huankechong/smart-greenhouse/README.md

# 智能花房养护站 · Smart GreenHouse（BiUH IPW Final Project）

ESP32 + 土壤湿度/光敏/DHT11 传感 → 自动浇水（继电器 + 底吸泵）→ 双色 LED 状态灯 → OLED 显示 → 巴法云 MQTT 上云 + 微信小程序远程浇水。

**这个仓库里有两样东西**：一套能烧的 Arduino 固件，和一套**能直接上机打印的 10 个结构件**（外加整机示意模型）。

---

## 一、现在到哪一步（2026-11-13 晚更新）

| 线 | 状态 |
|---|---|
| 电路 / 固件 | ✅ 主程序 **v1.6**（…→v1.5 全量审计→**v1.6 防除零+硬停机**）+ 7 个编译开关，双形态编译验证（默认 **271.7KB/21%** · 全开 **1055KB/82%**，2026-11-09 复测；余量 ≈230KB）；**2026-10-24 实机烧录验证通过**（COM6：烧录通路 + 启动日志 + 标定非法硬停机）；`RelayPumpTest` 联调固件 10/25 烧入并实机验证；**2026-11-08 五路传感器实机点亮**（光敏 raw 1421↔遮光骤降 / DHT11 29.2℃·68% / OLED 0x3C 显示「土壤:100%」/ 土壤 湿1050↔干2372） |
| **结构 / 3D** | ✅ **11 件 STL 定稿（+12 LED 座；13 盖板已删）**（10-23/24 四轮实测回填 + **11-10/11 三轮迭代**：AR35 01b 裸露版 / AR34 03 加强针 / 底盘沉槽修正），逐件 watertight/单体/落地 z=0；配合校验 `check_clearance.py` 全过（0.10/边 统一间隙） |
| 3D 展示 | ✅ 整机示意模型（glb）+ **单文件离线 HTML**（双击即开，拖拽旋转）+ 四视图 + 结构标注图 |
| 硬件 | ✅ 自购件全部到货并实拍核对（AR14）；**实验室器材 2026-11-06 全部借到**（5 个套件元件 + 面包板/杜邦线/万用表）；**11-08 传感器 5/5 点亮、土壤排针焊接一次过** |
| 打印 | ✅ **十件 STL 已定稿**（实测切片 8h37m / 338.1g）；**切片由领导在 Bambu Studio 自己做**（0.2 层高 / 3 墙 / 20% / 免支撑，brim 见 `_打印参考/上机操作卡.md`；**gcode/3mf 已于 11-08 全删，现场用 STL 重切**）；**打印清单 11 件**（原 10 + 12 LED 座，13 已删）；**11/11 全部完成**（06a 11-13 打完 AR36 直口版；06b 排水槽版 11-13 晚重打完成） |
| **开工** | ✅ **D0 = 2026-11-07（周六）4 人小组开工**，分工见 `docs/花房4人分工方案_2026-10-20.md`（v2 相对排期） |
| **实验 / 标定** | **全部定稿（11-12）**：8.1 ✅ / 8.2 ✅（32.1ml/s → WATER_MS=2000）/ 浮球常开型实测定稿 / **土壤标定 2372/1050**（11-08 实测，网上典型值 10bit×4 换算交叉吻合）→ **`EN_WATER=1` 且实机闭环已跑通（2026-11-13）**：pigtail 到货接通（首次出水 43s 视频在库）+ **全自动浇水闭环演示 86.7s 视频在库（S1-9.3）**；**48h 连续运行（整机形态）暂定 11-16（周一）启动**（11-18 结束；前置 06a/拼装/接线 11-15 前完成）｜06b 排水槽版重打中 |
| **截止 / 答辩** | 🔴 **提交截止 = 2026-11-24（周二）**（老师课件 2026-11-07 公布，课件存 `outputs/素材/素材备份_老师课件/`）。三大组成部分：**实验室动手实践 + 期末报告 + 期末展示**；展示两阶段（初评 → 晋级进阶展示，DT 系老师共评），**英语展示 = 加分项**。距截止 **11 天** |

> 结构件尺寸已按到货实物**全部实测回填**（1L 桶三径/桶高、硅胶管内外径、花盆、传感器板，2026-10-23~24 完成并全链验证）；仅**翻边高度**暂用 6mm 占位（不影响打印，见交接文档 v3.1 待补项）。

## 二、目录导航

```
<项目根>/
├── README.md            # 本文件：人类入口
├── AGENTS.md            # AI 行为准则（协作规矩 / 重建命令 / 红线）
├── docs/                # 文档层：每个主题一份权威文档
│   ├── index.md                            # ★ 文档总索引
│   ├── 花房项目_AI工作交接文档_2026-10-18.md  # 接手第一份
│   ├── 花房FinalProject方案书.md
│   ├── 花房4人分工方案_2026-10-20.md          # v2：角色卡 + S1–S4 相对排期 + 附录·任务底稿
│   ├── 操作手册/   硬件操作手册_点火接线标定.md · 花房接线规划表.md · 花房接线图_水泵.html
│   ├── 参考资料/   花房3D建模入门路线_SolidWorks.md · 花房借用与自购清单.md
│   ├── 工作日志/   上云联调记录.md（R2）· 打印日志.md（R3）
│   ├── private/                             # 内部邮件（含个人信息，.gitignore 排除，不入仓库）
│   ├── archive/                             # 已完成使命的历史文档（仅备查）
│   └── 审计报告/（AR10–AR26 + archive/AR01–AR09）
└── outputs/             # 交付物 + 生成脚本（不是文档）
    ├── 3D打印件/
    │   ├── 花房3D_P0/          # 01b 土插支架 / 03 窄版管夹（02 水泵座已作废删除）
    │   ├── 花房3D_P1P2/        # 04 OLED 支架 / 07 DHT11 座 / 08 扎线座 / 11 光敏小柱
    │   ├── 花房3D_整机底盘/    # 06a 左片 / 06b 右片 / 06c 连接块 ×2
    │   ├── 花房3D_水箱盖/      # 10 水箱替换盖（1L 桶 + P52 浮球安装）
    │   ├── 花房3D_整机装配/    # 整机示意 glb + 离线 HTML + 四视图 + 校验脚本
    │   └── _打印参考/          # 切片实测报告 + 上机操作卡（**gcode/3mf 已删，现场用 STL 重切**）
    ├── 代码/
    │   ├── 花房代码/GreenHouse_v1/   # Arduino 主固件（.ino + config.h 占位符 + 编译说明）
    │   └── 花房代码/RelayPumpTest/   # 继电器/水泵 串口测试固件（测完烧回主固件）
    └── 素材/              # 到货照片 · 素材整理（索引表）· 老师课件 · 邮件成品 · _敏感_不入库（不入库）
```

## 三、10 个打印件（现行有效：2026-10-24 起 02 水泵座作废；2026-11-08 新增 11 光敏小柱）

| 件号 | 名称 | 外形 (mm) | 耗材（切片实测） | 预计打印 | 支撑 |
|---|---|---|---|---|---|
| 01b | 土壤传感器**土插支架**（超薄版：柱 27×6 + 土里稳定鳍） | 27 × 15 × 71 | **10.1 g** | **35m** | 免（brim 5） |
| 03 | 水管末端固定夹（**土插窄版**） | 15 × 15 × 41 | **3.3 g** | **17m** | 免（brim 3） |
| 04 | OLED 45° 支架（2026-11-07 改版：加底部走线） | 36 × 34 × **39.5** | **14.7 g** | **29m 49s** | 免（brim 3） |
| 06a | 整机底盘·左片（继电器槽按实测转 90°） | 160 × 230 × 8 | **118.8 g** | **2h 30m 33s** | 免（**brim 8 必开**） |
| 06b | 整机底盘·右片（含挡水堤 + **φ107** 桶槽 + **φ82** 花盆槽） | 160 × 230 × **11** | **124.1 g** | **2h 33m** | 免（**brim 8 必开**） |
| 06c | 拼缝连接块 ×2 | 45 × 24 × 3.5 | **2.9 g**（两件合计） | **7m** | 免（brim 3） |
| 07 | DHT11 小座（2026-11-07 改版：台锥+收腰+喇叭口） | 35 × 34 × 62.8 | **11.2 g** | **34m 35s** | 免（brim 3） |
| 08 | 扎线固定座 | 30 × 16 × 14 | **3.1 g** | **9m** | 免（brim 3） |
| 10 | 水箱替换盖（1L 桶**两级台阶**口 + P52 浮球，**两级阶梯裙边**） | **φ138.4 × 10.5** | **44.6 g** | **1h 2m** | 免（brim 5，顶面朝下印） |
| 11 | 光敏电阻小柱（台锥底 + 收腰柱 + 45° 斜面托盘） | 34 × 30 × 33.85 | **4.9 g** | **18m 31s** | 免（brim 3） |

> **数据口径（2026-11-07 统一）**：本列一律取切片器实测值（含 brim / purge），与 `outputs/3D打印件/_打印参考/切片报告.md` 逐件一致，十件合计 **338.1 g**。
> 早期按 STL 实体体积估的「~19.4 / ~21.1 / ~14.9 / ~4.8 g」等值已弃用——估算与实测差 10–20%，混用会把总量算成 **354 g**。实体估算仅作设计参考，见 git 历史与各 `交付说明_*.md`，不要再用于打印备料。

**合计 8 h 37 m / 耗材 338 g**（2026-10-24 拓竹 X2D 0.4 喷嘴实测切片；2026-11-07 04 改版复切 29m49s / 14.7 g、07 改版复切 34m35s / 11.2 g）。
其中**底盘两片 5.03 h**、其余八件 3.58 h —— 比原估 19 h 少 58%（X2D 是高速机，底盘单片实测 2.5 h 而非 6 h）。
📄 逐件时间/耗材/brim 见 `outputs/3D打印件/_打印参考/切片报告.md`（切片实测记录）；打印顺序与验收见同目录 `上机操作卡.md`。

> 历史作废件已于 2026-10-20 删除（可从 git 历史找回）：`01_sensor_L_bracket` 与 `01b_..._v1`（被 01b v2 取代）、`05_led_diffuser`（无半透明耗材，取消）、`06_electronics_base`（被两片底盘取代）、`花房3D概念模型/`（早期探索，已被整机装配模型取代）。

## 四、把件打出来（三步）

1. **先打 `06c_joint_block`**（10 分钟）——用 M3 自攻试拧一下 φ2.8 引导孔，确认咬合手感，再上大件。
2. 把 `STL/*.stl` 拖进 Bambu Studio：0.2 层高 / 20% gyroid / 3 墙 / **免支撑** / 底盘开 brim 5–8mm。
3. 五金只要三样：**M3×6 盘头（圆柱头）自攻 ×8**、**φ4×16 定位销 ×2**、PH1 螺丝刀。
   - ⚠️ **必须是自攻（牙尖、牙距宽），不能是机螺丝**——底板是 φ2.8 × 5.25 深**盲孔**，没螺纹也没法上螺母，机螺丝拧不进会撑裂 PLA。
   - ⚠️ **必须是盘头（圆柱头）**，配 φ6.2 × 1.8 深的圆柱沉孔；90° 锥形沉头坐不实。
   - ⚠️ M3×8 会穿出底面 1.8mm 刮桌面，只能用 M3×6。

装配顺序（定位销必须**先**插、再放连接块）见 `outputs/3D打印件/花房3D_整机底盘/交付说明_整机底盘两片式v1.md` 第三节。

## 五、改了参数怎么重出全套

```bash
PY="C:/Users/junbo/.workbuddy/binaries/python/envs/default/Scripts/python.exe"
cd outputs/3D打印件

$PY 花房3D_P0/p0b_sensor_hook.py        # 01b 土插支架 v2
$PY 花房3D_P0/p0_models.py              # 03（02 已作废，脚本仍生成以保持文档校验）
$PY 花房3D_P1P2/p1p2_models.py          # 04 / 07 / 08 / 11
$PY 花房3D_整机底盘/base_2pc_models.py   # 06a / 06b / 06c
$PY 花房3D_水箱盖/p10_tank_lid.py       # 10 水箱替换盖（1L 桶 + P52 浮球）
$PY 花房3D_整机装配/build_assembly.py    # 整机 glb + 四视图
$PY 花房3D_整机装配/build_html.py        # 单文件离线 HTML
```

改哪个尺寸就改对应脚本顶部的 `PARAMS` / `P` 常量，**不要手改 STL**。

### 改完必须跑校验

| 脚本 | 查什么 |
|---|---|
| `outputs/3D打印件/花房3D_整机装配/check_base_fit.py` | 每个件是否坐进该坐的槽、件×底板干涉、空槽/缺槽 |
| `outputs/3D打印件/花房3D_整机装配/audit.py` | ① 12 个 STL 几何自检（含组合件多体判据）② 装配两两干涉；③ 文档数字对账**已于 2026-11-09 停用**（口径改切片实测，见脚本注释） |
| `outputs/3D打印件/花房3D_整机装配/check_wires.py` | 25 根跳线逐段穿模采样（1.2mm 步长，22 类目标） |
| `outputs/3D打印件/花房3D_整机装配/check_occlusion.py` | OLED 屏被谁挡（射线采样） |
| `outputs/3D打印件/花房3D_整机装配/verify_html.js` | 无头 Chromium 实开 HTML，查 WebGL / JS 报错 |

## 六、看效果

双击 **`outputs/3D打印件/花房3D_整机装配/花房整机示意模型.html`** —— 单文件 1.91MB（35,220 个三角面），断网也能开，拖拽旋转 / 滚轮缩放 / 右键平移，带视角预设与图例。

## 七、文档阅读顺序

0. **`docs/index.md`** —— 全部文档与交付说明的总索引（从这里找任何一份）
1. `AGENTS.md`（若你是 AI）/ `docs/花房项目_AI工作交接文档_2026-10-18.md`（若你是接手的人）
2. `docs/花房FinalProject方案书.md` —— 为什么做、怎么做、答辩怎么讲
3. `docs/花房4人分工方案_2026-10-20.md` —— 谁做哪块、S1–S4 排期 + 附录·任务底稿（原 30 天计划）
4. `docs/操作手册/花房接线规划表.md` —— 到货后照着接
5. `outputs/3D打印件/花房3D_*/交付说明_*.md` —— 每个件的设计取舍与已知限制（清单见 `docs/index.md`）
