huankechong/smart-greenhouse/docs/花房4人分工方案_2026-10-20.md

# 智能花房 · 4 人小组分工方案（v2）

> 🔄 **2026-11-06 二次修订**：器材全部借到（5 个套件元件 + 面包板/杜邦线/万用表等，D0 现场逐项核对），**D0 = 11/07（周六）开工**。10/26 的排期冻结**部分解除**：绝对死线仍不写（答辩新日期未定），本文改为**相对排期**——锚点只有两个事实日期：**D0 = 11/07 开工日、D+2 = 11/09（周一）实验室交打印**，其余一律 D+n，答辩日公布后一次映射（规则见 §七）。
>
> 定稿 2026-10-20 · 二次修订 2026-11-06 · 答辩日 D_ans 未定（大概率较原 11/16 顺延约一周）
> 配套：本文附录·任务底稿（任务定义库）《硬件操作手册_点火接线标定.md》（D0 电子实验按其流程执行）《花房接线规划表.md》《GitHub与Agent提交代码_零基础手册》

---

## 一、一句话结论

**领导（刘俊博）当系统负责人，抓固件 + 集成 + 答辩；另外三人一人一块「上云数据」、一块「结构打印」、一块「文档影像」，三块互不重叠、各自可独立验收——10/20 定的角色结构原封不动，v2 重排的只是时间轴（W1–W4 → S1–S4 相对排期）。**

| 角色 | 代号 | 主责 | 每周投入 |
|---|---|---|---|
| 系统负责人 | **R1** 领导 | 固件 / 集成 / 标定 / 答辩主答 | 4 h |
| 上云与数据 | **R2** 编程强的组员 | MQTT / 小程序 / 数据证据 / 固件副手 | 3 h |
| 结构与打印 | **R3** 会 CAD 的组员 | 机时 / 打印 / 装配（试装偏差表 2026-11-13 领导决定取消） | 3 h |
| 文档与影像 | **R4** 文笔强的组员 | 素材库 / 电路图（用现成总图导出）/ 报告 / PPT / 视频 | 3 h |

> 合计约 13 h/周。剩余工作量约 25–30 h（标定/打印/集成/写作），人力仍有冗余；组员从 D0 才开始投入，R1 此前已垫付大量基础工作（见 §五 已完成账）。

---

## 二、工具与工位（先对号，再看角色）

**11/06 更新：三人都已装 WorkBuddy 并连上 GitHub 连接器**（此前记录的"两人"已过时）。连接器路线全员畅通，设备差异只剩一条：MacBook 那位没有 Windows 本机 Git。

| 角色 | 需要本机 Git 吗 | 为什么 | 工具配置 |
|---|---|---|---|
| R1 系统负责人 | **要** | 编译固件、跑 Python 重出 STL、改参数 | WorkBuddy + 本机 Git（已就绪） |
| R2 上云与数据 | **要** | 改 `.ino` 与联调脚本、跑本地测试 | WorkBuddy + 本机 Git |
| R3 结构与打印 | **要（Windows）** | 改 `PARAMS` 重跑脚本（红线：不许手改 STL）；STL 动辄数 MB，**超连接器 1 MB 上限，必须本机 Git 推** | WorkBuddy + 本机 Git + Bambu Studio |
| R4 文档与影像 | **不必** | 只改 Markdown、图片、PPT，单文件基本 ≤1 MB | **连接器即可，Mac 也零配置** |

**对号标准（明天站会 10 分钟现场定）**：

1. 编程最强的 → **R2**；会 CAD / 有打印经验的 → **R3**；文笔强、细心的 → **R4**。
2. **唯一硬禁区：MacBook 那位不坐 R3**——不是能力问题，是 STL 文件超 1 MB 走不了连接器，他手头又没有本机 Git，硬安排等于第一天就卡交付。坐 R2 也可以，但配认证（手册 §十一）那半天要先付。
3. 能力对口优先于设备便利：若 MacBook 那位恰好编程最强，让他坐 R2 并先跑通 `gh auth login`。

**R4 走连接器守三条**（手册 §6.5）：单文件 ≤1 MB、一次一个文件一个 commit、不改别人的文件。大图/STL/视频转交 R1/R3 本机推。

---

## 三、为什么这么切（三条原则）

1. **按"交付物"切，不按"工序"切。** 每人手里都有一份能单独交出去的东西（云端数据 / 打印件 / 报告 PPT），不出现"我干了一半等别人"的悬空状态。
2. **技术主干不外放，但也不做单点。** 固件与几何脚本只有 R1 能改（参数化脚本、AR 系列审计都是他建的），但 R2 必须能接手烧录与上云联调，R3 必须会改 `PARAMS` 重跑脚本——**领导一旦请假，项目不能停**。
3. **硬件活锁定两个时段块。** ⚠️ **2026-11-09 领导明确：所有器材必须在实验室内操作，不得带回宿舍做实验**（原「D0 宿舍电子日」的假设已作废）。因此电子实验（8.1 继电器 / 8.2 量水 / 浮球极性）与打印提交都压在工作日 18:30–20:30 这一个窗口内并行：一人盯打印（R3），一人做电学（R1），2 小时刚好够。桌面准备（剥线、裁管、拍照）可在宿舍先做，不占用实验室窗口。

---

## 四、角色卡（职责 / 交付物 / 验收标准）

### R1 · 系统负责人（领导）

- **职责**：固件唯一修改人；剩余标定（土壤干湿值）与参数回填；整机集成联调；48h 测试排障；答辩技术问答主答。
- **工具**：WorkBuddy + 本机 Git（Windows）；`arduino-cli` 环境全套就绪（COM6 已验证）。
- **交付物**：`config.h` 标定值回写完成的主程序、集成联调记录、48h 运行日志、答辩小抄。
- **验收**：拔插探针能触发/停止浇水；低水位能断泵；小程序能看数能下指令。
- **工时分布**：D0 主操最重，S2 中等（偏差复核），S3 最重（集成攻坚），S4 盯测试。

### R2 · 上云与数据（编程强的组员）

- **职责**：巴法云双主题复核、小程序绑定、MQTT 上行与远程浇水下行联调、局域网保底页、**所有云端数据证据的导出与归档**。
- **工具**：WorkBuddy + 本机 Git（Windows 或 Mac 都行；**若坐 Mac，先按手册 §十一解决认证**）。
- **交付物**：小程序实时面板截图、远程浇水录屏、首批历史曲线、48h 曲线图、局域网页面截图。
- **验收**：手机点按钮 → 水泵出水（视频为证）；历史数据在免费保留期内当天导出。
- **关键提醒**：巴法云免费版历史数据保留期有限，**上云成功当天就导**，不许拖到后期补抓。

### R3 · 结构与打印（会 CAD 的组员）

- **职责**：机时预约、打印提交与盯机、取件去支撑、装配（**试装偏差表已取消，2026-11-13 领导定**：配合间隙已在建模侧用 check_clearance.py 逐件算过，实物装不进再说，不再逐件出表）、补打清单执行。
- **工具**：WorkBuddy + 本机 Git（**Windows**）+ Bambu Studio；**切片由现场用 STL 重切**（gcode/3mf 已于 2026-11-08 全删；十件实测口径 **8h37m / 338.1g**），打印前核对打印机型号与喷嘴即可。
- **交付物**：打印日志（件号/耗时/耗材/失败重打）、**10 件实体**（02 泵座已作废；11 光敏小柱 11/08 新增）、补打件。
- **验收**：10 件全部打印完成且能互装；06c 连接块 M3 自攻咬合手感确认。
- **红线**：**不许手改 STL**。改尺寸只改脚本顶部 `PARAMS`，由 R1 复核后重跑。

### R4 · 文档与影像（文笔强的组员）

- **职责**：素材库（命名 `S{阶段}-{任务号}-{描述}`）、全程拍照录屏（**D0 电子实验的 W1 素材欠账 ≥8 张当天补齐**）、**电路图用现成总图**（`docs/操作手册/接线图导出/` PNG 版，2026-11-12 领导定，不再用 Fritzing 重画）、报告撰写与图文比控制（≥6:4）、PPT 8–10 页、兜底视频剪辑。
- **工具**：**只需 WorkBuddy + 连接器，不必装 Git**——MacBook 首选落位（连接器已通，零配置）。
- **交付物**：素材索引表、电路图 PNG、报告初稿/二稿、PPT 终稿、3 分钟兜底 mp4。
- **验收**：报告按课程模板结构齐全（背景→选型→三模块→失败排查→48h 数据→安全考量→总结）；PPT 每页一图。
- **关键提醒**：素材当场拍当场归档，**事后补拍的照片一眼假**，答辩照片的真实性是隐性评分点。

---

## 五、D0 前已完成账（R1 单干，2026-10-20 → 11-06）

> 这一节是给组员看的：**以下是共享基础，不必重做，但开工前必须看懂**——三份必读：《花房项目_AI工作交接文档》（当前状态）、《硬件操作手册_点火接线标定.md》（实验照做）、《花房接线规划表.md》（接线依据）。

| 日期 | 完成 | 对组员的意义 |
|---|---|---|
| 10/21 | ESP32 识别成功（COM6/CH340），标定固件烧录，串口 RAW 流验证 | 烧录通路已打通，D0 直接用 |
| 10/23–24 | 4 组尺寸实测回填（桶/硅胶管/花盆/传感器板），STL 定稿（现 **10 件**） | 2026-11-08 起 **gcode 全删**，改用 STL 现场切片 |
| 10/24 | 主固件实机验证（COM6，启动日志 + AR16 硬停机确认） | 固件可信，R2 联调基于 v1.6 |
| 10/25 | `RelayPumpTest` 测试固件烧入并实机验证 | **D0 第 2 件直接用，跳过烧录** |
| 10/26 | Final_Project.docx 填完 4 人名单与项目描述；全库排期冻结 | 组队已合规备案，不用再管 |
| 11/06 | 器材全部借到（套件 5 元件 + 面包板×2 + 杜邦线 + 万用表等） | D0 现场逐项核对即可，无采购环节 |

**唯一未完成的硬规矩**：`SOIL_RAW_DRY/WET` 两个标定值还没回填（传感器没插过真实土壤），**回填之前 `EN_WATER` 保持 0**——这是全项目写错代价最高的一条。

---

## 六、任务矩阵（S1–S4 相对排期）

> 锚点：**D0 = 2026-11-07（周六）**；**D+2 = 2026-11-09（周一，实验室开门）**。答辩日记作 **D_ans**（未定），S4 全部用「D_ans − n」表达。

### S1 · 开工周（D0 → D+5）

| 任务 | 责任 | 协同 | 相对死线 |
|---|---|---|---|
| **站会（首次）**：帽子对号 + 人人领任务 + 必读三文档确认 | 全员 | — | **D0 上午，10 分钟** |
| 电子实验日：8.1 继电器 → 8.2 水泵（量筒量水记 ml/s）→ 6 项传感器逐个点亮 → 浮球极性（照操作清单顺序，别打乱） | **R1 主操** | 非主操两人轮流拍照 + 记录出水量表 | D0 全天 |
| W1 素材欠账补齐（≥8 张：串口截图/吸合照片/出水视频/OLED 屏照）+ 素材库建立（命名 `S1-xxx`） | **R4** | 全员供图 | D0 晚 |
| **首日 commit**：每帽在自己目录建一个文件（如 R2 建 `docs/工作日志/上云联调记录.md`）走连接器提交，标题带 `[Rn]` 前缀——当场验证链路真通 | 全员 | — | **D0，硬要求** |
| 实验数据回填：ml/s → `WATER_MS` 折算、浮球极性 → `LEVEL_WET_CLOSED`；烧回主固件 v1.6 | **R1** | — | D+1 |
| 上云准备：巴法云注册 + 双主题建立 + 小程序绑定 + 联调脚本（纯软件，不等硬件） | **R2** | — | D+3 |
| 报告大纲 + 电路图交付（**用现成总图 PNG**，R4 只做报告内排版裁切） | **R4** | R1 校接线 | D+5 |

> **D0 收尾铁律**：借的器材清点还回（能还的）、主固件烧回板子、桌面擦干、素材传电脑备份（微信 temp 会清）。

### S2 · 打印周（D+2 → D+9）

| 任务 | 责任 | 协同 | 相对死线 |
|---|---|---|---|
| **打印提交**（gcode 已就绪）+ 现场核对打印机型号/喷嘴 + 问清取件时间 | **R3** | R1 同行 | **D+2 上午（实验室开门首日）** |
| 盯机与取件（打底盘两片约 12.2h + 七小件约 8h，按机时排队） | **R3** | R4 拍过程照 | D+2 → D+4 |
| ~~试装 + 偏差表~~ **直接装配**（偏差表已取消；装配卡住拍照报尺寸即可） | **R3** | R1 复核 | D+5 |
| 偏差回填：只改 `PARAMS` → R1 重跑脚本 → 重出 STL/gcode | R1 复核 | **R3 报实测值** | D+6 |
| 补打偏差件（**不重打全套**） | **R3** | — | D+9 |
| 土壤标定：插干土/湿土实测 `SOIL_RAW_DRY/WET` → 回填 → **`EN_WATER` 才允许置 1** | **R1** | R3 陪测 | D+6（试装后趁盆在手） |
| 并行：报告前三节（背景/选型/系统架构） | R4 | 全员供料 | D+6 |

### S3 · 集成攻坚（D+7 → D_ans − 8）

| 任务 | 责任 | 协同 | 相对死线 |
|---|---|---|---|
| 自动浇水闭环实测（防重复触发 + 低水位断泵） | **R1** | R3 看水路 | S3 中段 |
| MQTT 上行 + 远程浇水下行（校园网不通就手机 2.4G 热点） | **R2** | R1 | S3 中段 |
| 局域网保底页面 + **首批云端历史数据当天导出** | **R2** | — | 上云当天 |
| 整机装配 + 走线收纳（收纳规整度纳入评估） | R1 + R3 | R4 四角度拍 | S3 后段 |
| 报告主体（三模块实现 + 失败排查三案例）+ PPT 骨架 8–10 页 | **R4** | R1 供代码片段 | D_ans − 9 |
| 48h 测试预检：水源/电源/摆放位置/断网预案 | 全员 | — | S3 末 |

### S4 · 收口彩排（D_ans − 7 → D_ans）

| 任务 | 责任 | 协同 | 相对死线 |
|---|---|---|---|
| **启动 48h 连续运行测试** | **R1** | R2 远程盯数据 | **D_ans − 7 上午**（保证答辩前 2 天出完整曲线） |
| 导出 48h 云端曲线 + 数据整备 | **R2** | — | D_ans − 4 |
| 兜底演示视频 3 分钟 | **R4** | R1 出镜 | D_ans − 4 |
| 报告二稿 + PPT 定稿 | **R4** | 全员互查 | D_ans − 3 |
| 答辩问答小抄（10 问）+ 全流程彩排一次 | **R1** | 全员 | D_ans − 1 |

### 答辩日（D_ans）

| 位次 | 人 | 干什么 |
|---|---|---|
| 主答 | R1 | 讲选型决策、失败排查、技术细节 |
| 设备操作 | R2 | 手机端面板 / 远程浇水按钮，随时切局域网保底 |
| 实物与备件 | R3 | 递件、换泵、备用水管、工具 |
| 记录与替补 | R4 | 计时、记录评委问题、主答卡壳时接话 |

---

## 七、答辩日公布后的映射规则（一次做完）

1. **S1、S2 不用动**——它们挂在 D0/D+2 事实上，已经开跑或跑完。
2. **只换算 S3/S4**：把 `D_ans` 填进 §六两张表的「D_ans − n」，得到绝对日期；若 D_ans 距今不足 10 天，按下面第 3 条压缩。
3. **压缩顺序（从先砍到后砍）**：补打轮次 → 报告二稿轮次（一稿顶到底）→ 视频从 3 分钟减到 90 秒兜底。**永远不砍 48h 测试**——它支撑报告唯一的数据章节和答辩核心说服力。
4. 换算完同步三处：本文 §六、`README.md`、`AGENTS.md` §6.5（任务定义在本文附录，无需另改）。

---

## 八、协作机制（4 条，不多）

1. **站会：每周六上午，30 分钟**（首个 = D0 开工对号会）。每人 2 分钟：本周交付了什么 / 下周要谁配合 / 卡在哪。不写纪要，群里回一句"我卡在 X"即可。
2. **留痕**：走 Git 的 commit 前缀 `[R1]`…`[R4]`；走连接器的在 PR 标题带同样前缀；素材命名 `S{阶段}-{任务号}-{描述}`。答辩被问"这块谁做的"时能秒答。
3. **单一真相源**：文档只认 `docs/`，实物只认 `3D打印件/`、`代码/`；不许各自存"我的最终版"。
4. **谁都不能让项目停**：R1 请假 → R2 顶烧录联调；R3 请假 → R1 自己切片打印；R4 请假 → 报告最危险，其他人轮流填素材。

---

## 九、风险与缓解（v2 更新）

| 风险 | 概率 | 缓解 |
|---|---|---|
| **组员参与从零起步**（10/20 至今未上手，D0 才第一次碰真活） | 高 | S1 首日 commit 硬要求 + 必读三文档；R1 在站会逐个确认"知道自己这周交什么" |
| **答辩日期仍未定**，S4 无法排绝对日期 | 已发生 | 相对排期体系（§六/§七），公布后一次映射，S1–S3 不受影响 |
| **MacBook 那位被排进 R3** | 中 | 对号时硬避开（STL 超 1 MB 走不了连接器，他无本机 Git） |
| **连接器撞 1 MB 上限**（STL、大图、视频） | 中 | 大文件统一交 R1/R3 本机 Git 推 |
| 实验室机时排不上 / 打印排队 | 中 | D+2 交件当场问清取件时间；S2 内留 D+7→D+9 缓冲；只补打不重打 |
| 土壤标定拖到最后 → `EN_WATER` 迟迟不能开 | 中 | 标定死线定在 D+6（试装后花盆在手），不等 S3 |
| 组员对"花房已完成大半"有落差，觉得是来打杂的 | 中 | 站会讲清每人产出都是报告/PPT 里独立署名的一节；§五 已完成账明确为共享基础 |
| 上云在校园网连不上 | 中-高 | 手机 2.4 GHz 热点（ESP32 不支持 5 GHz），第一天先验证 WiFi 再调 MQTT |
| 巴法云免费版历史数据过期 | 中 | 上云当天导一次、48h 跑完立刻再导，R2 负责 |
| 四人时间凑不到同一时段 | 中-高 | 硬件活锁两个块：D0 宿舍电子日 + D+2 实验室打印日；软件活各自异步 |

---

## 十、已确认前提（10/20 确认 · 11/06 更新）

1. **课程允许 4 人共做一份**，共同答辩、按同一份成果评分（10/20 确认；组队已在 Final_Project.docx 备案：LIU Junbo / LU Peihan / ZHOU Mingxi / YIN Tianwu）。
2. **三人全部装好 WorkBuddy 并连上 GitHub 连接器**（11/06 更新），第四位连接器状态 D0 现场确认。
3. **器材全部借到**（11/06 领导确认）：套件 5 元件（DHT11/光敏/继电器/OLED/双色 LED）+ 面包板×2 + 杜邦线 + 万用表；电烙铁是否到手 D0 现场核对，借不到走 WAGO 免焊。
4. **答辩日顺延未定**（大概率较 11/16 +1 周）→ 本文用相对排期，不写绝对死线。
5. **花盆未到货不阻塞**——传感器支架是土插式，与盆壁厚度无关。
6. **周末实验室不开**——3D 打印等 D+2（周一）交，D0 只做桌面电子实验。

---

## 附录 · 任务底稿（原《花房30天执行计划》压缩并入，2026-11-06）

> **本附录是全部任务的权威定义库**：任务编号、内容、预计耗时、验收标准、素材要求都在这。原《花房30天执行计划.md》（25KB，单人视角逐日排期）已删除，git 历史可查；排期部分被本文 §六 S1–S4 相对排期取代，**本附录只保留"任务是什么"不保留"哪天做"**。D 编号是历史任务号（操作清单等文档仍按此引用），按 S1–S4 阶段就近执行即可。

### 任务编号速查

| 阶段 | 任务组 | 编号范围 |
|---|---|---|
| W1 单模块点火 | 下单/环境/逐个点亮 | 1.1–6.2（✅ 已全部完成或被超前完成，明细见 §五 已完成账） |
| W2 系统集成 | 继电器/水泵/自动浇水/电路图 | 7.1–10.2 |
| W3 上云 + 打印 | 巴法云/远程/切片/试装 | 11.1–14.3 |
| W4 装机收口 | 整机/48h 测试/报告/PPT/彩排 | 15.1–19.2 |

### W2 · 系统集成与执行闭环（对应 S1 电子实验日）

| 编号 | 任务 | 预计 | 验收标准 |
|---|---|---|---|
| 7.1 | **买花盆+绿植**：⚠️ **规格 8×8×8 直筒树脂盆**（外 φ80×高80；买成方形盆圆槽装不下，需再改一轮）；绿植选绿萝/吊兰耐折腾品种；详见《花房借用与自购清单》§2.1 | 30min | 实物到位 |
| 7.2 | ~~合并代码：三传感器读数进主程序 + OLED 轮询三行显示~~ **✅ 已超前完成**（主程序框架本就含 `EN_DHT`/`EN_OLED` 条件编译，2026-10-23 双开关组合编译 PASS） | — | 素材：OLED 三行数据照（S1-7.2） |
| 7.3 | ~~写 map 映射函数~~ **已由 v1.6 `safeMap()` 超前完成**；**依赖标定**——回填实测值前湿度%是假的 | — | 与 D+6 标定合并验收 |
| 8.1 | 继电器接入：GPIO 控制吸合/断开，串口打印状态。⚠️ 主固件无手动触发入口 → **烧 `RelayPumpTest`**（串口 `on`/`off`/`w N`/`auto`/`t`），测完烧回主固件 | 30min | 素材：吸合照片（S1-8.1） |
| 8.2 | 水泵联调（**水路远离电路，桌面垫纸巾**）：继电器→水泵→出水，记录"浇 N 秒 = 出多少 ml"（**自购量筒 25–250ml/分度 5ml**；首测 `w 5` 防溢） | 45min | 素材：出水照片/短视频（S1-8.2） |
| 9.1 | 自动浇水逻辑实测：湿度<阈值→浇3s→停30s复测→仍干再浇→连浇6轮转冷却 | 60min | 逻辑跑通（探针拔出触发、插回停止） |
| 9.2 | 双色 LED 状态联动：正常=绿、缺水/浇水=红闪（代码含课堂双色 LED 注释） | 30min | 素材：红/绿各一张（S3-9.2） |
| 9.3 | **里程碑：第一次全自动浇水成功**（⚠️ 前置：标定完成 + `EN_WATER=1`） | — | **素材：完整过程视频 1 分钟（答辩核心素材）** |
| 10.1 | ~~Fritzing 整机电路图 v1~~ **改用现成总图**：`docs/操作手册/接线图导出/花房接线图_整机总图_接线图.png`（含清单版同目录）直接作为交付与报告插图，R4 只按报告版式裁切标注 | 10min | 素材：电路图直接引用现成 PNG（2026-11-12 领导定） |
| 10.2 | 阶段收口：代码存 Git、周记、素材归档 | 30min | 素材 ≥5 张 |

### W3 · 上云与打印（对应 S2 打印周 + S3 集成）

| 编号 | 任务 | 预计 | 验收标准 |
|---|---|---|---|
| 11.1 | 巴法云控制台双主题复核（上行/下行主题名核对） | 20min | 主题就绪 |
| 11.2 | ESP32 接入 MQTT（PubSubClient，bemfa.com:9501，10 秒一条 JSON） | 90min | **素材：小程序首条数据截图（里程碑）** |
| 11.3 | 微信小程序绑定 UID，数据面板显示正常 | 20min | 素材：面板照片 |
| 12.1 | **远程浇水打通**：小程序发指令 → ESP32 触发浇水 | 60min | **素材：手机点按钮+水泵出水短视频（答辩第二核心素材）** |
| 12.2 | 局域网保底网页（`EN_WEB=1`，ESP32 起 HTTP 只读页） | 60min | 素材：局域网页面截图 |
| 12.3 | **导出/截图巴法云历史数据**（免费版保留期有限，**当天就存**） | 10min | 素材：首批历史曲线 |
| 13.1 | ~~量实体尺寸~~ **✅ 已完成**（2026-10-23~24 四轮回填闭环） | — | — |
| 13.2 | ~~建模 v1~~ **✅ 已超前完成**（10-18 参数化 STL 全产出；13.1 尺寸也已回填） | — | 素材：STL 列表截图+装配四视图（加分项） |
| 13.3 | ~~切片~~ **✅ 已完成并转为现场切片**（2026-10-24 X2D 实切口径 **8h37m/338.1g**；gcode 已于 11-08 删除） | — | 上机操作卡在 `outputs/3D打印件/_打印参考/` |
| 14.1 | ~~提交打印~~ **改 D+2 交**（现场核对打印机型号/喷嘴）；只在有偏差件时补打 | 0–1 机时 | 素材：打印过程照+成品照 |
| 14.2 | 装配：直接实装（~~试装偏差表~~ 2026-11-13 取消）→ 装不进的件量尺寸报 R1 → 改 `PARAMS` 重出 → 补打（**不重打全套**） | 30min | 整机可装 |
| 14.3 | 收口：素材归档+周记 | 20min | 素材 ≥8 张 |

### W4 · 装机、48h 测试与报告（对应 S3 后段 + S4 收口）

| 编号 | 任务 | 预计 | 验收标准 |
|---|---|---|---|
| 15.1 | **整机装配**：全器件入壳、走线整理（**收纳规整度纳入评估**）、水位/传感器固定 | 90min | 素材：整机四角度照 |
| 15.2 | **48h 连续运行测试**启动（⚠️ 前置：标定完成；断水断电即失败重跑） | 挂机 | 运行不中断（D_ans − 7 前启动） |
| 16.1 | 导出 48h 云端历史曲线（第二次数据证据留存） | 20min | **素材：48h 曲线图（答辩实证）** |
| 16.2 | **实验报告初稿**：背景→选型对比→三模块实现（每模块用总图裁切+照片+代码片段）→失败与排查（防重复触发/ADC 引脚/WiFi 频段三案例）→48h 数据→安全设计→总结；**图文比 ≥6:4** | 180min | 初稿成文 |
| 16.3 | PPT 8–10 页：封面/痛点/选型/架构/感知·执行·云三页/失败排查/数据/总结展望 | 120min | 初版 |
| 17.1 | **兜底演示视频 3 分钟**：插拔探针触发→OLED→手机面板→远程浇水全流程 | 40min | 素材：兜底视频（答辩保险） |
| 17.2 | 报告/PPT 互查：对照评分点逐项自查（实物✓分解✓可复现✓加分项✓） | 60min | 二稿 |
| 17.3 | 答辩问答预演：「为什么 ESP32/光敏/电容式」「断网怎么办」「传感器漂移」预设答案一页小抄 | 60min | 小抄一页 |
| 18.1 | 模拟答辩：5 分钟讲 + 3 分钟问答，计时 | 30min | 讲稿顺一遍 |
| 18.2 | 报告/PPT 终稿；设备满水满电；确认答辩场地网络/投屏 | 40min | 全部就绪 |
| 19.1 | 答辩前夜：全流程冒烟 + 手机热点/备用 USB 线/兜底视频三重保险装包 | 30min | 冒烟通过 |
| 19.2 | **答辩**：演示顺序 = 自动浇水（拔插探针）→ OLED → 手机面板 → 远程按钮 →（被问断网）切局域网 | — | 自信讲完 |

### 贯穿性规则（原计划的两条铁律，仍有效）

1. **任何一天实在没时间，做最小闭环**（≤30 分钟不断线）：装一个库 / 读一个传感器 / 拍一张素材照 / 写报告一节。
2. **素材命名**：`S{阶段}-{任务号}-{描述}`（R4 统一归档，答辩"这块谁做的"能秒答）。
