huankechong/smart-greenhouse/docs/花房项目_AI工作交接文档_2026-10-18.md

# 花房 Final Project · AI 助手工作交接文档

> 版本 v3.1 · 2026-10-24 更新（v1.1 原版 2026-10-18 15:25） · 交接人：小马（前任 AI）
> 用途：下一个 AI 助手读本文档后无需额外说明即可接手。**先读完再动手，遇到与本文档冲突的旧记忆以本文档为准。**
> ⚠️ **正文时效（2026-11-06 注）**：第二/三/五节的表格快照停留在 2026-10-24（v3.1 收口时点），**当前状态以头部 changelog + `README.md` §一 + `docs/花房4人分工方案_2026-10-20.md`（v2，11/06 修订）为准**——固件现为 **v1.6 实机验证版**、打印 9 件 gcode 已切好、**器材 2026-11-06 全部借到、D0 = 11/07 开工**、AR 已到 **AR33（下一个 AR34**，逐号摘要以 `AGENTS.md` §2 为准）、实测尺寸已全部回填。
> v3.2 变更（2026-10-24 08:40，**固件首次实机烧录验证通过 + AR16 防除零实机确认**）：领导插上 ESP32（COM6）后补做了 AR17 一直缺的实机验证 ——
> **① 烧录通路**：编译 269,417B(20%) → 烧录写入 269,776B → **Hash verified** → 自动复位成功；CH340 驱动正常（板卡名 Unknown 属正常）。**10/26 联调最大风险排除**。
> **② 正常启动**：串口输出 v1.6 横幅 + 7 个开关状态 + `dry=3200 wet=1300 阈值=35%` + 每 5 秒 `[数据]` 帧，全部正确。
> **③ 🔴 AR16 的「标定非法硬停机」实机验证有效**：临时改 `DRY=1300(=WET)` 烧录 → 输出三条「致命/停机」信息、**6 秒内无任何 `[数据]` 行**（确认未进 loop）、无重启循环。随后已恢复 `DRY=3200` 重烧，板上为干净正确固件。
> **④ 仍未验证**（需杜邦线/传感器，等 10/26）：EN_DHT/EN_OLED 实机显示、EN_LEVEL 浮球极性、EN_WATER 继电器（须标定后）、EN_WIFI/MQTT/WEB 联网。详见 `AR17 §八`。
> **⑤ 物料澄清**：**硅胶线（22AWG 裸线）≠ 杜邦线**。杜邦线/面包板是 **10/26 实验室借**，今天宿舍没有，所以接线类验证做不了 —— 但烧录不需要杜邦线（只需 USB 数据线），已跑通。
> v3.1 变更（2026-10-24 01:10，**四轮实测回填收口 + 打印清单降到 9 件**）：本轮把领导陆续提供的实测值全部落进模型，并依反馈做了两轮减薄，**当前所有 STL 已定稿、全链验证通过**。
> **① 管径实测**：硅胶管 **内径 8.5 / 外径 10**（原假设 φ8）→ 03 管夹孔 **10.6**、水箱盖水管孔 **φ12**（原 φ10 恰好等于管外径，加上 FDM 孔径收缩 0.2–0.4 会塞不进）。
> **② 花盆定案**：**8×8×8 直筒树脂盆**（外 φ80 / 高 80 / 壁厚 10~20 / 锥度 0）→ 底盘花盆槽 **φ62→φ82** 且槽心移到 **(-111,60)**（φ82 右缘 −70 与继电器槽 −62 只留 8mm）；因壁厚 10~20 范围太宽刚性双爪盖不住 → **弃用夹持**。
> **③ 支架改土插式 + 两轮减薄**：01b 从「盆沿双爪」改为「两腿插土」（z=0=土面），再按「要种两株薄荷」连续减薄 —— **36×12 → 30×10 → 27×6**，最终腿改为「柱体直接下潜 + **土里**稳定鳍」（鳍在土面以下就不占土面）。土面上方投影 **300 → 162mm²**，与 03 合计占土面 **32% → 13.7%**（剩 2440mm² 够两株薄荷）。03 同步缩到 **15×15**（3.4g）。
> **④ 02 水泵固定座作废**：泵自带吸盘（底脚 32×28），可直接吸桶底；吸盘本身垫高约 2~3mm，吸水口仍有间隙，**泵的 z 不用改**。少一件、省 24.7g，腾出桶底 3135mm²（原占桶内底 36%）。**打印清单 10 → 9 件**。
> **⑤ 验证（全实跑）**：`check_base_fit` 全部通过 · `check_wires` **穿模 0** · `audit` **23 项 OK 零失败** · `verify_html` **无 JS 错误**。预览图（爆炸图/高清四视图/装配三步/P0 总览）全部重出，不再有旧模型残留。
> ⏳ **仍待补测/确认**：①**翻边高度**（决定裙边能多深，暂用 6mm，**裙边高必须 ≤ 翻边高**否则装不进）②清盆**壁厚精确值**（10~20 范围决定内腔 φ60~φ40；若为 20，内腔仅 φ40，现支架放不下，需再缩）③**桶身高 127 是否含盖**（只影响装配图与浮球位置，不影响任何打印件）。
> ⚠️ **未做**：领导提到的「底盘更紧凑」**暂缓** —— 只缩板不重排件效果极小（plate_y 230→218），真紧凑需重排 4 个主槽 + **22 根走线全部重算**，深夜高风险；**建议 10/27 首版打印试装后再一起改**（那时底盘本来也要重打）。
> 📌 打印清单见 `README.md` §三（9 件）、切片与上机步骤见 `outputs/3D打印件/STL 目录（切片已删，用源模型现场重切）`（切片报告 + 上机操作卡）；打印排期规则见 `AGENTS.md` §6.5。
> v3.0 变更（2026-10-23 21:10，**AR15 补完：翻边 + 桶高 127**）：领导分两次补齐实测 —— 先「**桶口最外侧 132**」再「**桶高 127**」。
> **结构判读（三轮实测后定案）**：桶口剖面 = 内壁 φ120 │ 桶身口沿 φ124（壁厚 2）│ **加强翻边最外 φ132（外凸 4）**。→ **盖板必须压在翻边顶面、裙边套翻边外径 132**；按 124 做盖板会**浮空 6.4mm**。商品页标的 136 应是含提手座的最大外径。
> **改动**：`p10_tank_lid.py` `bucket_mouth_od` 124→**132**、`bucket_h` 120→**127**、`skirt_h` 8→**6**（必须 ≤ 翻边高，否则裙边底缘顶在翻边下台阶装不进）→ **盖外径 φ138.4**、裙边内 **φ132.8**、重 45.9g；`build_assembly.py` **新增加强翻边环几何**（φ132×高6）+ 走线 z 改为从 `LID_TOP` 派生。
> **验证**：①**射线法实测裙边内孔 132.74~132.80mm**（36 方位 × 2 高度）→ 对翻边 132.0 = **直径向隙 0.8mm** ✅；②`check_base_fit` **全部通过**（落座高度/零干涉/槽孔特征）；③`check_wires` **穿模 0 根**；④`audit` **23 项 OK 零失败**；⑤`verify_html` **无 JS 错误**（1.89MB / 35,220 三角面）。
> ⚠️ **过程中修掉一次自引入的穿模**：桶高 120→127 抬高了盖顶，硬编码旧盖顶 z 的 4 根线（线10/11 继电器→水泵、线21/22 浮球→GPIO32）直接插进盖板。**修法不是简单抬高，而是消除硬编码** —— 盖顶 z 一律从 `LID_TOP` 派生，线10/11 改为「盖板外侧爬升 → 水平走到过线孔正上方 → 垂直下穿」，桶高再变也不会穿。
> 📌 **关键认知：桶高不影响任何打印件**（盖子只取决于桶口三个直径 + 翻边高），只影响装配图与浮球位置 —— 所以 127 是含盖还是不含盖，可以等补测再定。
> ⏳ **仅剩一个待测项：翻边高度**（决定裙边能多深，暂用 6mm；若实测 ≥8 可加深到 8 更防侧滑）。
> v2.9 变更（2026-10-23 20:40，**AR15 · 打包桶实测尺寸修订 + 3D 全链重出**）：领导提供到货实测 —— **桶底直径 105 / 桶口内径 120 / 外径 124**。🔴 **商品页标的"上径 136"是错的**（实测 124，差 12mm；136 推测是含提手凸缘的最大外径，桶本体口沿外径仅 124）。原第 10 件水箱替换盖按 136 建模 → **裙边内径 136.8 套在 124 外壁上晃 12mm 环、完全咬不住**；底盘圆槽 φ108 也偏大。**已按实测全部重出**：
> - `p10_tank_lid.py` `bucket_mouth_od` 136→**124** → 裙边内 **φ124.8**、盖外 **φ130.4**（派生自动跟随）
> - `base_2pc_models.py` `tank_d` 108→**107**
> - `build_assembly.py` 桶常量实测化（`BUCKET_*`）+ 替换盖 4 处硬编码半径（71.2/68.4）改常量派生
> - `check_base_fit.py` **EXPECT 表从硬编码改为从桶实测常量推导**（保持校验独立性）+ 修正一处**假通过**检查点（水箱槽原查 @(120,32)，真实槽心 @(85,32)）
> - 两份交付说明的尺寸/重量/校验表/容量账全部同步（51g→**43.4g**，满口水深 101→**114mm**，报警剩水 683→**710ml**）
> **验证证据**：①**射线法实测裙边内孔 124.74~124.80mm**（36 方位 × 3 高度，直径向隙 0.8mm）②中心孔 φ10.5 ✅ ③完整验证链全过 —— `check_base_fit` 全部通过（落座高度/零干涉/槽孔特征）、`check_wires` 22 根穿模 0、`audit` 文档数字 13 项全 OK、`verify_html` 无 JS 错误。④**过程中我引入过 4 项 0.6mm 校验失败** —— `git stash` 跑基线确认是本次引入，根因是桶壁厚 1.4→2.0 而 EXPECT 表硬编码旧值，**已改为推导式**（详见 AR15 §4）。
> ⏳ **仍待补测**：**桶身高**（暂用 120）与**桶底厚**（暂按侧壁 2.0）—— 补测后改 `P10.bucket_h` 重跑 30 秒出新 STL。⚠️ **打印前必看**：确认桶口有无提手凸缘（若确实 136，改回 136 重跑即可，其余几何自动跟随）。
> 📌 **AGENTS.md §3 新增红线 0：实测尺寸优先于商品页标注。**
> v2.8 变更（2026-10-23 20:00，**打印窗口重排**）：领导告知**周末打不了印**（实验室拓竹 X2D 周末不开）。据此核查出**原计划两个硬缺陷**：① **打印开始日 D14 = 死线当天**（11/5 开始、11/6 才打完 → 交首版已超期 1 天，且 11/7 进 W4，**零返工窗口**）；② 10/31、11/1 两个周末不可用（11/1 是 D11 巴法云，宿舍纯软件，不受影响）。
> ✅ **已重排：打印从 11/5 提前到 10/27 + 10/29** —— 10/27、10/29 是 W2 排期里的**两个空闲工作日**（D8=10/26、D9=10/28、D10=10/30 之间的空档）。方案：**10/27 打底盘两片 06a/06b（12.2h）→ 10/29 打其余八件（8.3h）→ 10/30 取件当天即试装**（趁实验室一次做完，记偏差 → 改脚本参数 → 重出 v2）→ **11/2–11/4 补打偏差件**（只补改动件，不重打全套）→ 11/5 死线当天只做装配复检与整机走线。**净收益：首版比死线提前 5 天，多 3 天返工窗口**，正对上「首版 90% 要改尺寸」的风险提示。
> 💡 两条关键认知：① **切片（Bambu Studio）是纯软件，不占打印机** → 周末在宿舍就能做（13.3 提前），10/27 到实验室直接提交；② **打印是无人值守，占用的是机器不是人** → 与 D8/D9/D10 的实验室任务**不冲突**，只要预约到机时即可。
> ⏳ **唯一待确认**：**10/27（二）与 10/29（四）实验室能否进入/预约到打印机**（原计划实验室任务隔天排，暗示这两天可能不开）。若两天都不开 → 退回 11/2 起打（11/2–11/5 四个工作日），首版 11/5 当天交、几乎无返工窗口，**必须把 10/27 或 10/29 争取出来**。
> 文档：30 天计划新增「🖨 打印窗口重排」节（含工作日窗口盘点表 + 重排方案 + 三档应对）；D13.3/D14.1 标注已提前/只做补打；`AGENTS.md` 新增**第 6.5 节 3D 打印排期约束**（防止后续 AI 再排到 11/5）；交接文档升 **v2.8**。
> v2.7 变更（2026-10-23 19:44，**烙铁不再是卡点 + 7.2 软件已完成**）：领导确认 **10/26 实验室一次性全给**（传感器模块 + 面包板 + 杜邦线 + 继电器），**「既无烙铁又无面包板/线」的最坏档被排除**；但**电烙铁 + 焊锡丝「不确定」**。
> ✅ **关键判断：烙铁不确定 ≠ 标定做不了。** 10/26 借到的**公对母**杜邦线，**公头方针 0.64mm 可直插传感器 1.0–1.2mm 焊孔**（靠孔壁夹紧）→ 母头插 ESP32 排针，**零工具、零等待、零成本**（套件第 9 项本就是「40 公对母」，公母各半）。三档退路：**档 A 公头直插**（首选，零工具）/ **档 B 焊 1×3P 排针**（烙铁到货时，永久连接更体面）/ **档 C WAGO 221 免焊**（无公头线时，端子已到货 4 只，但需剥线最麻烦）。最坏档只剩「既无公头线又无面包板」→ 8.1/8.2 可做、仅标定顺延。
> ✅ **D7-7.2 软件部分 2026-10-23 已完成验证**：主程序 DHT/OLED 代码框架本就写好（`#if EN_DHT` / `#if EN_OLED`），本机 **DHT sensor library 1.4.7、U8g2 2.36.19、Adafruit Unified Sensor 1.1.15、PubSubClient 2.8 均已安装**；`EN_DHT=1` + `EN_OLED=1` 组合**本地编译 PASS（400,757 B / 30%）**（临时副本验证，主文件未改）。**10/26 只需接线 + 烧录，现场不调代码。**
> ⚠️ **7.3（写 map 函数）仍依赖标定** —— 未标定前只能填占位估值 `3200/1300`，必须在标定后回填，否则 OLED 显示的湿度%是假的。
> 文档：30 天计划「⏱ W2 关键路径」节按 19:44 状态重写（④⑤为新增）；借用清单第 7 项改为「⏳ 不确定」并注明不阻塞；AR14 §五/§七 同步。
> v2.6 变更（2026-10-23 19:31，**继电器时间线闭合**）：领导告知**继电器模块（套件第 16 项）10/26（周一）可从实验室借到**。**与 30 天计划 W2-D8「8.1 继电器接入 / 8.2 水泵联调」原定同一天 → 零延误**；D7（10/25 周日）全是纯软件 + 买花盆，不受影响。✅ **「买光耦隔离 MOS 管模块 3–5 元」的建议作废**（不必再花这个钱），**主程序 `EN_WATER` 逻辑一行不用改**。⚠️ **但真正的关键路径不是继电器，是「标定」**：9.3 里程碑（第一次全自动浇水）要求 `EN_WATER=1`，而它要求**标定完成**（`SOIL_RAW_DRY/WET` 回填实测值）。标定卡在**烙铁**（借用清单第 7 项，套件不含）—— **10/26 能否一并借到烙铁是唯一决定性变量**。**三档预案已写入 30 天计划「W2 关键路径」节**：①借到烙铁 → 当天「借件→焊排针→标定→8.1→8.2」（偏紧，标定约 40min）；②借不到烙铁 → 走 **WAGO 免焊方案 B**（**端子已到货 4 只**，现实物可行，当天照样标定）；③既无烙铁又无面包板/杜邦线 → 8.1/8.2 可做（继电器是带排针模块，A 型母对母直插），标定顺延 → **9.3 挪到 D10 之后，W2 收口有压力**。另：**7.3（写 map 函数）依赖标定** —— 未标定前只能填占位估值 `3200/1300`，必须在标定后回填，否则显示的湿度%是假的。文档：AR14 §五/§六/§七 同步闭合；借用清单第 3 项标注 10/26 可借；30 天计划新增「⏱ W2 关键路径」节。
> v2.5 变更（2026-10-23 19:05，**WAGO 更正**）：照片中 4 颗透明壳器件**初版误判为「继电器插座底座」**（见 v2.4）。**领导指正「是万可的连接头」+ 联网查 WAGO 官方规格（wago.com 221-413），标签 7 项特征逐条对上** —— `AWG 24-12` / `0.14/0.2-4` / `450V 32A`(IEC) / `SET 20A`(UL 486C 20A/600V) / `Cu 1.6/2`(镀锡铜条) / 透明壳+橙色拨杆 / UL 标志，**实为万可 WAGO 221 系列快接端子**。✅ 这就是 2.2 已买表里 10/19 自购的「WAGO 221-413 ×2（泵回路三通节点）」，**到货 4 只（计划 2 只）**，450V/32A、剥线 11mm。**两个连带好处**：①**泵回路接线端子实物在手**（+5V/GND 两个汇流节点够用）；②**免焊方案 B（硬芯线+WAGO 221）立刻可行** —— `docs/archive/W1无烙铁接线方案_2026-10-20.md` 方案 B 原本依赖「待到货」，现端子在手，**烙铁借不到也能走**。⚠️ **继电器模块的问题回到原点**：这 4 颗既不是继电器，**套件第 16 项继电器模块是否在袋内仍无答案**，需翻找未拍的袋子；若确无，备选是换光耦隔离 MOS 管模块（3–5 元，接口与继电器模块一致）—— **先翻找再决定，别急着下单**。**方法论教训**：认器件先查品牌再套结构；「只有某类才有的特征」这类单向排除推理最危险（通用快接端子必然标线径）；颜色不是鉴别特征（WAGO 橙色=拨杆）。AR14 报告 §三 已改写为更正记录、§3.5 保留初版原文供追溯、新增 §七更正记录。
> v2.4 变更（2026-10-23 晚，**硬件到货实拍核对**）：⚠️ **本版中「继电器」相关判断已被 v2.5 更正推翻**（实为 WAGO 快接端子），以下原文保留供追溯：实验室创乐博 A 套件元件包 + 自购件到货，5 张实拍照片经 **RapidOCR 读标签 + 8× 超放大目视复核**核对，结果写入 `docs/审计报告/AR14_GreenHouse硬件到货实拍核对_2026-10-23.md` 与 `docs/参考资料/花房借用与自购清单.md` 新增的「一.5 到货实拍核对」节。**已确认到货**：P52 浮球开关（白圆柱+M10螺纹+黄引出线）、绿联 USB 延长线、22AWG 硅胶线（黑/红各 8 米，G-13-13-3/5）、1/4W 金属膜电阻包（A-4-2-1，30 种×10）、瓷片电容包、1N4007、蜂鸣器×2、**螺母 DIY 套装 TZ234（304防松螺母，深圳佰瑞特）—— 超清单**。⚠️ **关键待核项：4 颗"继电器"经 8× 放大确认是「插座底座」不是「继电器模块」** —— 壳内无 PCB，只有金属簧片，标签印的是 `Cu 1.6/2` / `AWG 24-12 0.14/0.2-4` / `20A 300V` / `450V 32A` 这类**接线规格**（只有底座才标线径），带 UL+PSE 认证。**插座底座不能直接接 ESP32 GPIO**（线圈电流会烧 IO），必须先翻找套件里有没有带 PCB+光耦的继电器模块（套件第 16 项，48 件只拍了 4 袋）；若无则三选一：换光耦隔离 MOS 管模块（3–5 元，接口与继电器模块一致，**推荐**）/ 自搭三极管驱动（要多焊 3 点且改主程序引脚逻辑）/ 用底座+本体+驱动电路。⛔ **核实前不要接泵回路**。⚠️ **套件不含电烙铁与焊锡丝** —— 借用清单第 7 项仍需单独借；万用表（第 8 项）建议一并借。
> v2.3 变更（2026-10-21 01:19，**定案：焊接排针，等烙铁**）：领导明确**放弃免焊方案**（公头直插 / 硬芯线），改回**焊接排针**。前提是**买土壤传感器时随附了 1×3P 单排针**（只送排针，传感器本身仍需自行焊接）→ **排针不用买，只缺电烙铁**。据此：①新建 **`docs/archive/土壤传感器焊接操作卡_2026-10-21.md`** —— 焊接顺序 **GND→OUT→5V**、每点 2–3 秒锡铺小锥形不堆球、**用面包板当治具固定排针**、万用表通断档验证（GND↔OUT 响 / GND↔5V 响 / OUT↔5V 不响）、焊完用**母对母**线接三根（套件第 9 项是公对母，公头那半边弃用）、自检与标定命令全流程；②`docs/参考资料/花房借用与自购清单.md` 第 7 项电烙铁由"可选"**改回必需**，万用表第 8 项标注"焊完量通断建议一并借"，并加借料提示；③`docs/操作手册/硬件操作手册_点火接线标定.md` 步骤 1 改写为指向焊接操作卡；④`docs/archive/花房30天执行计划.md` 物料状态更新；⑤`docs/index.md` 新增导航行。**免焊文档 `docs/archive/W1无烙铁接线方案_2026-10-20.md` 保留为备选**（烙铁借不到时的公头直插/硬芯线路线；「买已焊排针模块」因排针已赠送而作废）。**当前唯一待办 = 借电烙铁 + 焊锡丝**；软件侧零欠账，板子已通（COM6）、标定固件已在跑。**⛰ 3D 打印 11/5 死线（剩 15 天）比标定更硬，等烙铁期间应排打印队列。**
> v2.2 变更（2026-10-21 01:00，**卡点已破 · 板子通了**）：**ESP32 插上电脑后被正常识别** —— `board list` → `COM6`，设备管理器 → `USB-SERIAL CH340 (COM6)` 状态 OK（VID=1A86 PID=7523）。**"枚举不到设备"的原因就是板子当时没插**，驱动与数据线均正常，原结论作废。**标定固件 `W1_SoilCalib` 已编译 + 烧录成功**（269,280 B 写入，`Hard resetting via RTS pin`），串口稳定输出 `RAW,<millis>,<raw>` CSV 10Hz。**当前唯一待办：借线 + 接上传感器** —— 未接时 raw 稳定在 **95–105**（≈0.08V），是 GPIO34 悬空特征值。**新增工具 `outputs/代码/花房代码/tools/soil_watch.py`**（接线自检 + 实时看板 + 自动判定：<200 判定未接 / >4000 判定悬空 / 几百~三千多判定通了）。**新增实拍丝印位置图**（30 脚 ESP32-DevKitC，USB 口朝下背面视角）：`3V3` 在右排**最下面**、`GND` 在右排倒数第二、`GPIO34`（丝印 `D34`）在**左排从上数第 4 个**（上面是 `VN`、`VP`，最上是 `EN`）；传感器丝印为 `GND/5V/OUT`（非 `VCC/GND/AOUT`）且**正反两面顺序相反**。所有文档端口号统一 **COM5 → COM6**。标定执行三步（接线自检 → `soil_calibrate.py --write` → 烧回主程序）已写入 `docs/archive/W1无烙铁接线方案_2026-10-20.md`。
> v2.1 变更（2026-10-20 23:50，**物料解困**）：**学校有杜邦线 + 面包板，可借 —— 不用花钱买了**。卡点从"三样全缺"收窄为**只剩一个：ESP32 板子没被电脑识别**（`board list` → `No boards found`；驱动 `CH341SER.INF` 已装 oem265.inf，判定为**数据线只供电不传数据**或**板子未插好**）。已在 `docs/archive/W1无烙铁接线方案_2026-10-20.md` 把「受阻记录」节改写为「物料状态更新」，新增**板子识别三路排查**（换线 / 换口 / 查设备管理器，含"插拔时设备管理器有无新条目闪现"的快速判定法），并把**方案 E 降级为兜底**（只保留「已焊排针土壤模块 5–8 元」一项，杜邦线与面包板从清单划掉）。`docs/参考资料/花房借用与自购清单.md` 同步：第 6 项标注"学校有已确认可借"，**电烙铁第 7 项降级为可选**（当前走杜邦线公头直插焊孔的免焊方案）。**借料时只需确认线是公对母还是母对母**（公对母最优，可直插；母对母需配已自购的 WAGO 221）。软件侧零欠账，板子一识别 + 线一借到即可当天标定。
> v2.0 变更（2026-10-20 16:55，**W1 标定受阻**）：**杜邦线与面包板也借不到**，至此标定所需三样（板子被识别 / 杜邦线 / 烙铁）同时缺失，**W1-4.1 实测标定当日无法执行**，属物料问题非技术问题 —— 工具链已就绪（标定固件编译 PASS、脚本自测 16 项过、click 级指南写好），条件一到位立刻可跑。已在 `docs/archive/W1无烙铁接线方案_2026-10-20.md` 加「受阻记录」节，列出三条恢复条件与**方案 E（一次性下单约 15–25 元：杜邦线 + 面包板 + 已焊排针土壤模块，面包板/杜邦线本就是项目必需品）**。**同期最该推进的是 3D 打印（11/5 死线，比标定更硬），而不是等线。**
> v1.9 变更（2026-10-20 16:40，硬件到货遇阻 + 自我更正）：**实验室借用工具全部未借到**（电烙铁 / 焊锡丝 / 万用表），土壤传感器是**裸板三个空焊孔**，无排针。**焊接不是标定的前置条件** —— 新增 `docs/archive/W1无烙铁接线方案_2026-10-20.md`，四条免焊路径：①**杜邦线公头直插**（公头 0.64mm 方针能直接插进 PCB 约 1.0–1.2mm 焊孔，靠孔壁夹紧，标定精度够用，标定阶段首选）②WAGO 221 快接（10/19 已自购）③换「已焊排针」同款模块 5–8 元（推荐，正式方案）④等实验室借烙铁。**⚠️ 本版更正初版的一处错误结论**：初版写"W2 的继电器模块也可能需要焊"，属未经核实的推测——已逐项核对《花房接线规划表》线序表，**DHT11 / OLED / 继电器 / 双色 LED / 光敏全部是带排针的模块，走 A 型母对母杜邦线直插；浮球开关是干接点接螺丝端子。全项目只有土壤传感器需要焊，借不借到烙铁都不阻塞 W1 和 W2。**
> v1.8 变更（2026-10-20 16:10，硬件到货）：**ESP32 + 土壤传感器已到货**，进入 W1-D3/D4 点火阶段。新增 **W1 标定工具链**（`outputs/代码/花房代码/tools/`）：①`W1_SoilCalib.ino` 标定专用固件（连续输出 `RAW,<millis>,<raw>` CSV，已编译 268,909 B / 20%）；②`soil_calibrate.py` PC 端助手（扫端口 → 干/湿两阶段采样 → 剔异常取中位数 → **回写主程序 `SOIL_RAW_DRY/WET`**）；③`test_soil_calibrate.py` 离线自测 16 项全过。配套 click 级指南 `docs/操作手册/硬件操作手册_点火接线标定.md`。**当前卡点：系统枚举不到任何 CH340/串口设备**（驱动 `CH341SER.INF` 已装 → 最可能是数据线只供电不传数据，其次是板子未插）——先按指南步骤 0 排除。
> v1.7 变更（2026-10-20 15:50，AR13）：**云端清空销账 + E 盘分桶规则补全**——①**云端资料库已彻底清空、零残留**（领导手动删除，含我误传的 README 节点）；**云端不再是本项目任何信息的来源，唯一生产源是本地 D 盘 git，E 盘为第二副本**；②AGENTS.md 第 6 节**新增「E 盘分桶对照表」**（8 行映射：仓库 `outputs/3D打印件/花房3D_*`→E 盘 `3D打印件/`、`outputs/代码/花房代码/`→`代码/`、`docs/private/`→`docs/private/`、`output/` 申请单→`邮件/` 等）——E 盘**按人类可读名分桶、不叫 `outputs/`**，此前这条规则只活在报告里没成文，正是"误判 E 盘缺 3 文件"的根因；③清理 E 盘 `邮件/` 目录下一份**改前的旧 v3 邮件模板**（md5 与 docs/private 版不同，差在"借 9 类/8 类"），已移入 `.workbuddy/recycle_bin/`；④**双端全量校验 27/27 一致**。
> v1.6 变更（2026-10-20 15:40，AR12）：**文档口径补漏**——①预算从“76–89 元”改为按《花房借用与自购清单》2.2 逐项加总的 **97–116 元**（AR07 增补浮球/水箱 28 元后从未重算，AR11 漏了这一处）；②补记 AR11 知识库全面审计与本轮 AR12；③修 AR 指针“已用到 AR06，下一个 AR07”→“已用到 AR11，下一个 AR12”；④目录地图补 AR11；⑤E 盘镜像 **23 份**关键文件 md5 复核：**22 份逐字节一致**，仅 `.ino` 行尾不同（本地 CRLF / E 盘 LF，去 CR 后 md5 同为 `4adeceff`，内容相同）。
> v1.5 变更（2026-10-20）：**全量代码审计（AR10）**——固件升 v1.5.1，修复"连浇上限保护从未生效"高危缺口（状态 2 再浇分支漏自增，6 轮上限恒不触发），水位保护改为按 waterState 判定实现三态全覆盖，MQTT 指令大小写兼容，标定防呆补齐；双配置编译 + 状态机四场景模拟验证通过。**另修正审计中发现的文档不一致：AR 编号重复（代码审计由 AR08 改号 AR10）、本项目现为 10 个打印件、固件 README 由 v1.3 整份重写至 v1.5.1、esp32 板包实际为 2.0.18-arduino.5。**
> v1.2 变更（2026-10-19）：固件 v1.2 异常保护 + v1.3 继电器上电毛刺修复；土壤传感器/ESP32/水泵按实物实测回填（AR06 + 尺寸校正两笔提交）；雨滴模块取消借用；AR05/AR06 两份新审计报告。
> v1.3 变更（2026-10-19 晚）：**低水位保护落地（AR07）**——水位检测定版 P52 浮球开关（M10/常开/110V）+ 1L 打包桶水箱 + 第 10 件水箱替换盖（STL 已出）；固件 v1.4（干接点数字读取+消抖，双配置编译 PASS）；接线规划表新增第 8 节。
> v1.4 变更（2026-10-19 深夜）：**借用清单定版**——ESP32 维持自购（午间曾拟改借用已回退）；新增借用电烙铁+焊锡丝、万用表（申请单/邮件 v3 已更新）；采购清单重排必买/已买/不买（220Ω/垫片/保险豁免）。
> v1.1 变更：3D 路线由「SolidWorks 手工建模」改为「参数化脚本交付 STL」，9 个打印件已全部产出；目录地图、工具链、风险表同步；学号/手机号/topic 改为占位符。

---

## 一、项目背景与整体目标

- **用户**：刘俊博（称呼"领导"），BiUH（海南比勒费尔德应用科学大学）DT 专业 2026 级 DT1 班新生，Windows 11，用户名 junbo。学号/手机号见 `E盘/素材/档案`（本文不落），巴法云账号同。
- **项目**：《Introduction to Project Work》课程 Final Project——**智能花房养护站**（ESP32 + 土壤湿度/光敏/DHT11 传感 → 自动浇水继电器+水泵 → 双色 LED 状态灯 → OLED 显示 → 巴法云 MQTT 上云 + 微信小程序远程浇水）
- **关键日期**：~~答辩 2026-11-16（周一）；打印件最迟 W3 周四 11/5 提交~~ → **🧊 2026-10-26 老师请假，答辩将顺延（大概率 +1 周）、新日期未定；2026-11-06 起改相对排期（D0=11/07、D+2 交打印、D_ans 待公布），见《花房4人分工方案_2026-10-20.md》v2 §七映射规则**；硬件归还 2026-12-14 前（顺延后预计同步后移，等校方通知）
- **定位**：B 档（及格线以上、不堆料），预算 150 元内（**已花约 97–116 元**，按《花房借用与自购清单》2.2 逐项加总：ESP32 14.17 + 土壤传感器 5–8 + 水泵 10–15 + 浮球/1L 桶 ≈28 + 硅胶线 ≈17.2 + 1kΩ/100nF 1–8 + 1N4007 1–2 + USB 延长线 13.91 + M3 螺丝 ≈5 + WAGO 2–5；WAGO 按 1 个计，买 2 个再 +2–5。**另待买花盆绿植 10–20 元 → 合计约 107–136 元，预算余量 14–43 元**；220Ω、硅胶垫片、MF-R110 保险均确认不买），**4 人小组共做一份（2026-10-20 确认，分工见 `docs/花房4人分工方案_2026-10-20.md`）**，8-10 页工程叙事 PPT
- **当前阶段**：~~W1 空窗期（等快递）~~ → **2026-11-06 器材全部借到，D0 = 11/07 开工（4 人小组）**；固件/3D/文档三线超前完成，进入集成攻坚阶段（相对排期 S1–S4 见分工方案 v2）

## 二、当前进展（截至 2026-10-18 15:25）

### ✅ 已完成

| 领域 | 内容 | 位置 |
|---|---|---|
| 硬件下单 | ESP32 CH340 TYPE-C（¥14.17）+ 电容土壤传感器×2 + 3W 底吸泵，BIUH 地址，预计 10/21 到；**10/19 补单：P52 浮球×2 + 1L 打包桶×5（≈28 元，AR07）** | 淘宝，已下单 |
| 借用申请 | 申请单 v4（PDF 已 pypdf 校验）+ 邮件已发 He Pu / Li Qiang 老师（10/17 13:12），**等批复中**；归还口径统一 12/14 | E盘/邮件/ |
| 开发环境 | Arduino IDE + arduino-cli 1.5.2-rc.1（项目内置 `outputs/.tools/arduino-cli/`）+ esp32:esp32@2.0.18-arduino.5 + CH341 驱动 + DHT 1.4.7/U8g2 2.36.19/PubSubClient 2.8.0 库 | 宿舍机 |
| 巴法云 | 已注册，双主题已建（上行 `cYQ9…A004` / 下行 `4QT4…M001`）；UID 私钥只在截图里，值不落文字档 | E盘/素材/巴法云配置/ |
| 主程序 | GreenHouse_v1 **v1.6**（AR16/AR17 修复版：防除零 + 标定非法硬停机 + 开关依赖编译守卫，2026-10-24 实机烧录验证；7 编译开关，一套代码 W1 用到答辩） | `outputs/代码/花房代码/GreenHouse_v1/` |
| 代码审计 | AR01：12 项问题（1高/2中/9低），修 9 记 3；v1.2 补异常保护；v1.3 修继电器上电毛刺；v1.4 水位改浮球干接点（AR07）；**v1.5/v1.5.1 全量代码审计（AR10）：修"连浇上限从未生效"高危缺口 + 水位保护三态全覆盖 + MQTT 大小写 + 标定防呆，15 发现 4 修复** | `outputs/代码/花房代码/` + `docs/审计报告/` |
| **3D 打印件** | **9 件需打印**（原 10 件，2026-10-24 起 02 水泵座作废——泵自带吸盘直吸桶底）；第 10 件=水箱替换盖（配 1L 打包桶 + P52 浮球，AR07）；**示意模型已圆桶化**（06b φ108 圆槽、桶内泵/水体/浮子/替换盖全建模，AR08），另出整机示意模型（glb + 单文件离线 HTML + 四视图 + 结构标注图）。逐件 watertight/单体/z=0，装配干涉与落座高度均用脚本核对 | `outputs/3D打印件/花房3D_P0 / _P1P2 / _整机底盘 / _水箱盖 / _整机装配` |
| 3D 审计 | AR02（装配穿模 6 处）、AR03（底板×装配一致性）、AR04（拼缝件隐蔽化 + 螺丝规格 bug）、AR05/AR06（装配优化 + 传感器支架 v2）、AR07（低水位保护落地）、AR08（示意模型圆桶化）、AR09（走线优化 0 穿模）、**AR10（全量代码审计）** | `docs/审计报告/` |
| SolidWorks | 2026 SP0.4.1 学生版**已激活**（至 2027-10）。定位已变：**只用于查看/微调 + 报告里的建模截图**，交付走 STL | `D:\Appdata\SolidWorks\` |
| 项目审计 | 文档层审计**三轮**（10/17 一轮：星期标注/归还口径；10/18 一轮：16 份文档与产物对账；**10/20 AR11 知识库全面审计 25 处 + AR12 口径补漏 + AR13 云端销账/分桶补全**） | memory 当日日志 + `docs/审计报告/` |

### ⏸️ 进行中 / 挂起

> 2026-11-06 注：①②均已完成/失效——硬件 10/23 到货（AR14 核对）、借用 11/06 全部借到（D0=11/07 开工）。以下原文留档：
1. ~~SolidWorks 安装~~ **✅ 已完成**。遗留：`D:\Appdata\SolidWorks\SOLIDWORKS 2026 SP04.1\Marketplace_latest\` 剩 32 个文件（6.4MB）被 sldBgDwld.exe 锁定，重启后手动删整个文件夹即可
2. ~~**等硬件到货**（10/21 前后）~~ **✅ 已到货并实拍核对（AR14，2026-10-23）**；实验室器材 **11/06 全部借到**
3. ~~**等老师批复借用申请**~~ **✅ 2026-11-06 器材全部借到**（套件元件 5 项 + 面包板/杜邦线/万用表，电烙铁待 D0 现场核对）

## 三、待办任务（按优先级）

| P | 任务 | 时点 | 说明 |
|---|---|---|---|
| **P0** | ~~硬件到货：接线 + 首次烧录 + 串口看数据~~ | ~~10/21±~~ | **✅ 烧录/串口 2026-10-24 已验证（COM6）**；实测标定待 D0 实验室（死线 D+6）；BOOT 键排障法在代码 README |
| **P1** | **3D 打印（10 件，02 泵座作废）**：**gcode/3mf 已于 2026-11-08 全删，现场用 STL 重切**（十件实测口径 **8h37m / 338.1g**）→ 先打连接块（~7 min）验证 φ2.8 自攻咬合手感 → 底盘两片实测单片 2.5h | 进行中：已打 **6/10**（08/10/07/11/01b/04） | 打印日志 `docs/工作日志/打印日志.md`；切片参数见 `outputs/3D打印件/_打印参考/上机操作卡.md` |
| **P1** | ~~实物到货量 6 个尺寸 → 回填参数出 v2~~ | ~~10/21±~~ | **✅ 2026-10-23~24 全部实测回填完毕并全链验证**（桶三径/桶高/管内外径/花盆/传感器板，见 AR15 与 v3.0/v3.1 changelog）；仅翻边高度暂用 6mm 占位 |
| **P1** | ~~W1-D5：接 DHT11+OLED，开 EN_DHT/EN_OLED~~ | — | **并入 D0 实验室清单**（D0 已实测完成：五传感器全亮，见 2026-11-08 memory；流程存档于硬件操作手册）；每 5s 串口打印是 W1 截图素材 |
| **P1** | AR01 第三节"行为级验证清单"7 项实测 | D0 实验室 | 逐项验证并记录 |
| **P2** | ~~W2：继电器+水泵闭环（EN_WATER=1，先空载试）~~ | — | **并入 D0 清单 8.1/8.2**（用板上现成 `RelayPumpTest`，测完烧回主固件）；注意会真实出水 |
| **P2** | W3：上云（EN_WIFI/EN_MQTT/EN_WEB，config.h 填真值） | 挂 D_ans | 填 UID/WiFi 到 config.h |
| **P3** | 学助 EDU 采购邮件（中英双版已定稿） | 可选 | Plan A 已通，此邮件降为公益推动 |
| **P3** | 答辩 PPT（8-10 页）+ 报告"已知限制"章节（AR01 第四节 + AR02–04 已知限制可直接用） | 挂 D_ans | 已知限制是加分素材 |

## 四、关键技术决策及理由

| 决策 | 理由 |
|---|---|
| **编译期功能开关**（7 个 `#define EN_x 0/1`：DHT / OLED / WATER / WIFI / MQTT / WEB / LEVEL） | 一套代码从 W1 全关用到答辩全开，每周只改开关重烧 |
| **引脚分配**：土壤 GPIO34 / 光敏 GPIO35 / DHT GPIO33 / 继电器 GPIO26 / LED 25+27 / 浮球开关 GPIO32 | 全落 ADC1（32-39），避开 WiFi 与 ADC2 冲突；34/35 只读 |
| **自动浇水状态机**：监视→浇3s→停30s复测→仍干再浇→连浇6轮转冷却10min（0/1/2/4，v1.1 加状态3=远程手动非阻塞） | 防反复触发；非阻塞保证浇水期间 MQTT/Web 照常响应；v1.5 修复了"再浇分支漏自增导致 6 轮上限永不触发"的高危缺口 |
| **凭据外置 config.h** | UID/WiFi 不进主程序，交报告前只需脱敏一个文件 |
| **3D 工具链：Onshape 概念图 → SolidWorks 手工 → 参数化脚本出 STL（现行）** | 零件尺寸会随实物变，参数化改一个数就重出全套（STL/装配/HTML）；SW 手工建模改一次要重画，且首版必改尺寸 |
| **件 5 LED 灯罩取消** | 没有半透明耗材，白色 PLA 不透光，做了等于把状态灯关掉；改裸 5mm LED（底板 φ5.2 孔） |
| **传感器改盆沿挂钩（01b）而非盆内 L 支架** | 领导要求盆内不放支架；挂钩跨盆沿 + 板斜插 8° 入土 62mm，盆里只留植物 |
| **底盘拆两片 160×230 + 齐平连接块** | 320×230 超出 X2D 床面 256×256；板厚 8mm 是为连接块齐平后仍留 4.5mm 螺纹咬合 |
| **SolidWorks 走官方学生免费版，不用破解教程** | 破解有安全+合规风险；官方免费版全功能、365 天可续 |

## 五、目录与文件地图

**生产源（唯一真相源）**：`D:\Documents\workbuddydocument\2026-10-17-08-59-13\`
**用户侧镜像**：`E:\Documents\BU\第一学期\Introduction to Project Work\花房项目\`（**每次改动必须 cp + ls 验证**——有首拷未落盘的前科）

⚠️ **E 盘按人类可读名分桶，不沿用仓库的 `outputs/` 目录名**——照仓库相对路径拼 E 盘路径必然 `[ -e ]` 假阴性（AR12 曾因此误报"缺 3 文件"，AR13 已把对照表写进 AGENTS.md 第 6 节）：

| 仓库 | E 盘 |
|---|---|
| `outputs/3D打印件/花房3D_*/` | `3D打印件/花房3D_*/` |
| `outputs/代码/花房代码/GreenHouse_v1/` | `代码/GreenHouse_v1/`（AR01 报告在 `代码/` 下） |
| ~~`docs/archive/项目模式迁移包.md`~~ | ~~`迁移指南/`~~ **已归档**（`docs/archive/`，E 盘镜像同步删除） |
| `docs/private/*` | `docs/private/*`（同名同构） |
| `output/`（申请单 docx+pdf） | `邮件/`（只放成品，不放 .md 模板） |
| `outputs/素材/_敏感_不入库/截图整理_*/` | `素材/` 下同名目录 |

**判定"文件缺失"必须做内容级校验**（md5 或去行尾后比对），不能只查存在性。

```
<项目根>/
├── README.md            # 给人类：项目是什么 / 9 个打印件 / 怎么重建成品
├── AGENTS.md            # 给 AI：协作规矩、重建命令、红线（AI 先读这个）
├── docs/                # 文档层：每个主题一份权威文档
│   ├── index.md                                     # 文档索引（从这里进）
│   ├── 花房项目_AI工作交接文档_2026-10-18.md           # 接手第一份
│   ├── 花房FinalProject方案书.md                     # 为什么做 / 答辩怎么讲
│   ├── 花房4人分工方案_2026-10-20.md                 # 分工 + S1–S4 相对排期 + 附录·任务底稿（原 30 天计划）
│   ├── 花房接线规划表.md                             # 接线与引脚红线
│   ├── 花房借用与自购清单.md                         # 借 / 购 / 免费
│   ├── 花房3D建模入门路线_SolidWorks.md               # 零件清单与设计依据
│   ├── GitHub与Agent提交代码_零基础手册_2026-10-20.md  # 组员零基础交代码（MD + HTML 排版版）
│   ├── GitHub提交提示词_Agent自装自提_2026-10-20.md    # 一句话提示词：让 Agent 自己提交到 GitHub
│   ├── private/（内部邮件，含个人信息，.gitignore 排除，不入仓库）
│   └── 审计报告/AR02 … AR13.md          # AR01 在 outputs/代码/花房代码/
├── .workbuddy/memory/   # 每日工作日志（2026-10-17 起，持续追加）
├── output/              # 借用申请单 docx/pdf（成品，勿改）
└── outputs/             # 交付物 + 生成脚本（不是文档）
    ├── 花房代码/GreenHouse_v1/   # .ino v1.6 + config.h（占位符）+ README
    ├── 花房代码/AR01_…代码审计修复报告_2026-10-17.md
    ├── 花房代码/tools/           # W1 标定工具链（2026-10-20 硬件到货新增）
    │   ├── W1_SoilCalib/W1_SoilCalib.ino   # 标定专用固件，输出 RAW CSV
    │   ├── soil_calibrate.py               # 两阶段采样 → 算标定值 → 回写主程序
    │   ├── soil_watch.py                   # 接线自检 + 实时看板（自动判定接线对错）
    │   └── test_soil_calibrate.py          # 离线自测 16 项（不依赖硬件）
    ├── 花房3D_P0/         # 01b 盆沿挂钩 / 02 水泵座 / 03 水管夹（01 已废弃）
    │                       #   p0_models.py · p0b_sensor_hook.py · 交付说明_P0三件v1.md
    ├── 花房3D_P1P2/       # 04 OLED 支架 / 07 DHT11 座 / 08 扎线座（05 取消、06 被底盘取代）
    │                       #   p1p2_models.py · 交付说明_P1P2五件v1.md
    ├── 花房3D_整机底盘/   # 06a 左片 / 06b 右片 / 06c 连接块×2
    │                       #   base_2pc_models.py · 交付说明_整机底盘两片式v1.md
    ├── 花房3D_水箱盖/     # 10 水箱替换盖（1L 桶 + P52 浮球安装）
    │                       #   p10_tank_lid.py · 交付说明_水箱替换盖v1.md
    ├── 花房3D_整机装配/   # 整机 glb / 单文件离线 HTML / preview/
    │                       #   build_assembly.py · build_html.py · annotate.py
    │                       #   audit.py · check_base_fit.py · check_occlusion.py
    │                       #   check_wires.py · verify_html.js
    └── .tools/arduino-cli/  # 项目内置 arduino-cli 1.5.2-rc.1（编译用）
```

**E 盘镜像结构**（与本地一致）：`docs/`（同 docs 全部）、`3D打印件/`（四个 3D 目录）、`代码/`、`邮件/`（docx/pdf 成品）、`素材/`（截图归档，巴法云 01 图含 UID 私钥，**该目录不可公开**），外加根上的 `README.md` / `AGENTS.md`。

## 六、已知问题与潜在风险

| 级别 | 问题 | 应对 |
|---|---|---|
| ⚠️ ~~代码-已知限制（不修）~~ | Web 页无鉴权 / MQTT 明文 9501 / String 拼接堆碎片 | AR01 第四节，写进答辩报告"已知限制"（仍有效，保留） |
| ~~⚠️ 标定值未实测~~ | **待 D0 实验室实测（死线 D+6）**：SOIL_RAW_DRY=3200/WET=1300 仍是预估值；实测回填前 `EN_WATER` 保持 0 | `soil_calibrate.py` 自动回写主程序 |
| ⚠️ **3D 尺寸——已基本闭环** | **2026-10-23~24 四轮实测回填完毕**（桶三径/桶高、管内外径、花盆、传感器板，全链验证通过）；面包板 84×55、OLED 25×27 仍为市售常见值；**仅翻边高度暂用 6mm 占位**（若实测 ≥8 可加深裙边更防侧滑） | 翻边补测后改 `p10_tank_lid.py` `skirt_h` 重跑即可 |
| ~~⚠️ 挂钩夹口 5.6mm~~ | **已随土插式改版解决（2026-10-23）**：01b 弃用夹盆沿，改两腿插土，不依赖壁厚 | 见 v3.1 changelog ③ |
| ~~⚠️ 挂钩斜臂埋土 35mm~~ | **AR06 已解决（2026-10-19）**：01b v2 去掉斜臂，双爪不入土 | 现在**先填土再挂**也行，装好可拔下重插（见 AR06） |
| ⚠️ **底盘螺丝只能是 M3×6** | M3×8 会从底面穿出 1.8mm | 采购清单已改；手上只有 M3×8 就剪短 2mm |
| ⚠️ 老师批复未到 | 10/17 已发，无回复 | 若 10/20 前无消息，建议课后当面问 |
| ⚠️ ESP32 上传排障 | "not responding / not in sync" | 按住 BOOT 键点上传，出现 Connecting 后松开 |
| ⚠️ arduino-cli 编译缓存坑 | 编译被强杀后缓存损坏→报 WiFi.h 找不到 | 用 `--build-path` 指定全新目录绕开 |
| ⚠️ 快递延误 | 预计 10/21，若延到 10/24+ 则 W1 压缩 | 30 天计划有每日最小闭环 |
| ℹ️ 版本摩擦 | SW 2026 vs 老师/同学 2025 | 原生文件只进不出；交付走 STL 无影响 |

**3D 尺寸清单（2026-11-06 注：下表"仍待实测"各项已于 2026-10-23~24 全部实测回填并全链验证，见 AR15 与 v3.0/v3.1 changelog；原文留档备查）**

已实测并回填 ✅：土壤传感器 PCB（**87 长 / 头宽 23 / 探针段 15 / 厚 1.5** → `p0b_sensor_hook.py` 板轮廓+槽 23.6×1.4）、ESP32（**51.5×28，含 Type-C 53 / 厚 1.5** → 装配竖插 51.5×11×28）、水泵（**41×39×30 方形 / 底脚 32×28 / 130L/h / 扬程 50cm** → `p0_models.py` 方形座）、1L 桶（底 φ105 / 口内 φ120 / 口沿 φ124 / 翻边最外 φ132 / 高 127）、硅胶管（内 φ8.5 / 外 φ10）、花盆（8×8×8 直筒树脂盆 φ80/高80/壁厚10~20）。尺寸图存 `E盘/素材/元件实测尺寸/`。

~~仍待实测 ⏳~~（已全部闭环）：

| 量什么 | 影响哪个参数 | 在哪 |
|---|---|---|
| 花盆底外径 / 盆沿壁厚 / 盆口外径 | `pot_d` `pot_depth` / `rim_gap`（01b 现按模型盆 5.6，实物到手改 实测壁厚+1.2；03 与 01b 到手后统一） | `base_2pc_models.py` · `p0b_sensor_hook.py` · `build_assembly.py` |
| 硅胶管外径 | `ring_inner_d`（`slot_open_w` 是 v1 旧参数名，v2 已废弃） | `p0_models.py` |
| **花盆壁厚** | 01b/03 已**弃用夹盆沿**（壁厚 10~20mm 范围太宽）→ 改**两腿/两针插土**，不依赖壁厚 | `p0b_sensor_hook.py` `p0_models.py` |
| 1L 桶口外径/内径/桶身高（官方标注 136/120/120，**偏差 >0.5 就重跑**） | `bucket_mouth_od` `bucket_mouth_id` `bucket_h`；底盘 `tank_d`/`tank_pos`；装配 `BOT_R/TOP_R/TANK_H` | `p10_tank_lid.py` · `base_2pc_models.py` · `build_assembly.py` |
| P52 浮球有效长度/法兰外径（箭头标 52，收货复测） | `float_hole_d` 及容量账 | `p10_tank_lid.py` · 接线表第 8 节 |
| OLED 模块外形 | `oled_w` `oled_h` | `p1p2_models.py` |
| ~~水位检测方式与 `LEVEL_DRY_RAW`~~ | **AR07 已解决（2026-10-19）**：定版 P52 浮球干接点，`LEVEL_DRY_RAW` 已删除，v1.4 双配置编译 PASS | `GreenHouse_v1.ino` · AR07 |

## 七、环境配置与依赖

### 开发环境（宿舍机，已就绪）

| 组件 | 版本/路径 |
|---|---|
| Arduino IDE | `D:\Appdata\arduino-ide\Arduino IDE\` |
| arduino-cli | 1.5.2-rc.1，项目内置 `outputs/.tools/arduino-cli/arduino-cli.exe`（IDE 自带副本在 `D:\Appdata\arduino-ide\Arduino IDE\resources\app\lib\backend\resources\`） |
| ESP32 板包 | esp32:esp32@**2.0.18-arduino.5**（fqbn `esp32:esp32:esp32`；2.0.17 与 2.0.18 均验证编译通过） |
| 已装库 | DHT sensor library 1.4.7(+Adafruit Unified Sensor)、U8g2 2.36.19、PubSubClient 2.8.0 |
| CH340 驱动 | CH341SER.EXE 4.0 |
| **Python（建模链）** | `C:\Users\junbo\.workbuddy\binaries\python\envs\default\Scripts\python.exe` |
| **Python 依赖** | trimesh · manifold3d · numpy · matplotlib · scipy · networkx · rtree · shapely（布尔求交必须走 `engine="manifold"`） |
| **Node（HTML 验证）** | `C:\Users\junbo\.workbuddy\binaries\node\versions\22.22.2-6\node.exe` + playwright（无头 Chromium + SwiftShader） |
| OCR 读图 | RapidOCR：`from rapidocr_onnxruntime import RapidOCR` |
| SolidWorks | 2026 SP0.4.1 学生版已激活（至 2027-10），本体 `D:\Appdata\SolidWorks\` |

### 网络与凭据（敏感，勿外发）

- 巴法云：mqtt.bemfa.com:9501，UID 私钥只在 `E盘/素材/巴法云配置/01…png`（值不落文字档）
- SW 序列号：以激活确认邮件为准，存档 `E盘/素材/SolidWorks激活/`

## 八、协作规则（下一个 AI 必读）

1. **称呼**：用户="领导"，AI="小马"；指令极简（"好/可以/a"=选定方案），收尾"可以了/完事了"后自动推进下一步
2. **先推断意图 → 给 2-4 个带利弊的方案 → 领导拍板 → 执行**，不替他定死
3. **审计修 bug 必写修复报告**：`AR序号_项目名_修复报告_日期.md`，存 `docs/审计报告/` + 同步 E 盘。**已用到 AR33，下一个是 AR34**（逐号清单以 `AGENTS.md` §2 为准；近期：AR30 本地+E盘+GitHub 全面审计 / AR31 01b 阶梯槽 / AR32 03 插土针加强（已回退） / AR33 01b 感湿窗）
4. **E 盘同步惯例**：任何改动后 cp 到 E 盘对应子目录 + `ls` 验证
5. **删除/移动文件前先问**；大文档整体重建，不逐处 find/replace
6. **3D 一律先算后看**：任何坐标/尺寸结论必须用布尔求交或截面数值验证，**禁止靠看图判断**（历史上 OLED 屏朝向、管孔坐标、板槽贯通三处错误都是"看着对"造成的）
7. **URL 必须实测**；截图读不出字符时走 RapidOCR 并注明"以实物/邮件为准"
8. memory 日志：`.workbuddy/memory/YYYY-MM-DD.md` 每日追加，接手前先读 2026-10-17 与 2026-10-18 两份

## 九、快速接手清单（第一个 30 分钟）

1. 读 `README.md` + 本文档 + `.workbuddy/memory/2026-10-18.md`
2. 读《花房4人分工方案_2026-10-20.md》（v2：S1–S4 排期 + 附录·任务底稿）+ 《花房接线规划表.md》（到货后立刻要用）
3. 想看 3D 成果：双击 `outputs/3D打印件/花房3D_整机装配/花房整机示意模型.html`（离线可开，拖拽旋转）
4. 若用户说"到货了" → 转入 P0 硬件流程（接线→烧录→标定），同时让他量 6 个 3D 尺寸
5. 若用户说"打印" → 直接拿 `STL/` 里的文件进 Bambu Studio，先打连接块试咬合

---

*交接人：小马 · 2026-10-18 · 本文档存 `docs/` 并同步 E 盘 `花房项目/docs/`*
