huankechong/smart-greenhouse/docs/硬件操作手册_点火接线标定.md

# 硬件操作手册 · ESP32 点火 + 土壤传感器接线 + 标定（2026-11-06 合并版）

> **本文档由三份文档合并而成**（W1到货点火与标定操作指南_2026-10-20 · 土壤传感器焊接操作卡_2026-10-21 · W1无烙铁接线方案_2026-10-20），原件已删，git 历史可查。
> 合并逻辑：点火烧录标定是**主流程**（所有人都走）；接线方式二选一——**焊接排针**（现行定案）或**免焊公头直插**（烙铁借不到时的备选）；三份原文中重复的接线表/坑位表/自检命令只保留一份。
> 配套：`outputs/代码/花房代码/tools/`（标定固件 + 标定脚本）、`docs/花房接线规划表.md`（全器件接线）。

---

## 流程总览（第一次点火到标定完成，约 40 分钟）

```
步骤0 确认电脑认板子 → 步骤1 接线（焊接 §二 或 免焊 §三） → 步骤1.5 接线自检
→ 步骤2 烧标定固件 → 步骤3 看串口 → 步骤4 干湿标定（自动回写） → 步骤5 烧回主程序验证
```

**当前状态基线（2026-11-06）**：烧录通路 + 启动日志 + 标定非法硬停机已于 2026-10-24 实机验证（COM6）；标定本身待 D0 实验室执行（死线 D+6）。

---

## 步骤 0：确认电脑认得板子（30 秒）✅ 已通过（2026-10-20）

> 实测：`board list` 返回 `COM6`，设备管理器显示 `USB-SERIAL CH340 (COM6)`，驱动正常（VID=1A86 PID=7523）。
> **端口号 COM6**，下文命令统一用 COM6；换电脑/换口时先重跑 `board list` 确认。

```bash
"D:/Documents/workbuddydocument/2026-10-17-08-59-13/outputs/.tools/arduino-cli/arduino-cli.exe" board list
```

| 输出 | 含义 | 下一步 |
|---|---|---|
| 出现 COM 号 | 驱动正常，继续 | 记下 COM 号 |
| COM 号 + `Unknown`/`?` | 驱动没装对 | 走下方「驱动修复」 |
| 空输出 / `No boards found` | 板子没插 / 数据线只供电 | **先换一根数据线**（最常见原因） |

**驱动修复**（Windows 11）：设备管理器 → 端口 (COM 和 LPT) → `USB-SERIAL CH340` 带黄叹号 → 卸载设备 → 拔插板子自动重装；整个「端口」分类没有 CH340 → 装 `CH341SER.EXE`（WCH 官网，本机已装过 oem265.inf）。装完拔插一次再 `board list`。

### 板型与丝印（2026-10-20 实拍核对，30 脚 ESP-32-DevKitC）

实物是 **30 脚板**（不是 38 脚）。丝印读法（**背面视角，USB 口朝下**）：

| 排 | 丝印（从上往下） |
|---|---|
| **左排** | EN · VP · VN · **D34** · D35 · D32 · D33 · D25 · D26 · D27 · D14 · D12 · D13 · GND · VIN |
| **右排** | D23 · D22 · TX0 · RX0 · D21 · D19 · D18 · D5 · D17 · D16 · D4 · D2 · D15 · GND · **3V3** |

| 要接的 | 在板子哪 | 提醒 |
|---|---|---|
| **3V3** | 右排**最下面** | 传感器 `5V` 脚接这里（丝印写 5V，但接 3V3！） |
| **GND** | 右排倒数第二 / 左排倒数第二 | 任选 |
| **GPIO34** | 左排**从上数第 4 个**（丝印 `D34`，`VN` 下面） | 传感器 `OUT` 接这里；别数到 D35（那是光敏的位置） |

---

## 一、接线表（土壤传感器，三根线）

> 传感器丝印是 **`GND` / `5V` / `OUT`**（不是 VCC/GND/AOUT），**正反两面顺序相反**——以手上那一面的丝印为准。

| 传感器针脚 | → | ESP32 | 必看 |
|---|---|---|---|
| **5V**（丝印） | → | **3V3** | 模块 v2.0 内置稳压（3.3–5.5V 均可），且输出恒为 0–3.0V——接 3V3 正好占满 ADC 量程；接 5V 反而可能超 ADC 上限 |
| **GND** | → | GND | 任一 GND；**必须共地** |
| **OUT** | → | **GPIO34** | ADC1 只读脚；GPIO34 = 左排第 4 个 |

**三个必踩的坑**（三份原文共识）：① 别接 GPIO35（光敏的位置，插了读数乱跳干扰判断）；② 一定要共地（只接 5V 和 OUT 会乱跳）；③ 丝印 5V 接 3V3（不是笔误，见上表）。

---

## 二、接线方式 A（现行定案）：焊接排针

**前提**：买传感器随附 1×3P 排针（✅ 已到）；只缺烙铁（实验室借，D0 现场核对）。

### 2.1 借用清单（三样）

| # | 借什么 | 规格 | 备注 |
|---|---|---|---|
| 1 | 电烙铁 | 60W 以内，尖嘴头 | 烙铁架、海绵一起借最好 |
| 2 | 焊锡丝 | 0.8–1.0mm 含助焊剂 | 0.8mm 更好控温 |
| 3 | 万用表 | 通断档 + 直流 0–20V | 焊完验证通断 |

### 2.2 焊接步骤（10 分钟）

1. **摆件**：PCB 元件面朝上，排针插三个焊孔，手指按住。
2. **活化烙铁**：300–350℃，烙铁头挂一层薄锡（不活化锡不沾头）。
3. **固定排针**：**面包板当治具**——排针三针插面包板中间行，PCB 架在排针上对准焊孔（没有面包板用镊子夹，原则是排针垂直不动）。
4. **焊接顺序 GND → OUT → 5V**：GND 最容易焊先拿下；5V 最后（万一失手传感器不因误接损坏）。每点手法：烙铁头带一点锡 → 斜碰**焊盘和排针根部**（不是针尖）→ 停 2–3 秒喂锡丝 → 锡铺开成**小锥形**即撤 → **不堆球**（球状易虚焊）。
5. **冷却检查**：自然冷却（别吹，会裂纹）；焊点应光亮小锥形。
6. **万用表验证**：通断档，表笔固定 GND 针，依次碰 OUT、5V → **都响**；再量 OUT↔5V → **不响**（响=短路，返工）。
7. **接线**：焊好后用**母对母**杜邦线（套件第 9 项公对母的母头半边）按 §一接线表接三根。

---

## 三、接线方式 B（备选）：免焊公头直插（烙铁借不到时）

> 原理：传感器焊孔径 1.0–1.2mm，杜邦线公头方针 0.64mm（对角约 0.9mm），**能直接插进孔靠孔壁夹紧**，标定精度够用。零工具零成本。

1. 剪三条**公对母**线（15–20cm）。
2. 公头**拔掉塑料壳**：尖嘴钳夹针杆根部，拽壳不拽针，露出 5–6mm 针杆。
3. 对丝印一个孔一根线，**插到底**（PCB 背面能看到针尖）。
4. 母头端按 §一接线表接 ESP32。
5. 只有母对母线时：剪断一端，把内部金属插针拉出半截剥线压回，即自制公头。

**免焊专属坑**：针杆露出太长插不进/歪了短路（露出 5–6mm 为宜）；一次只插一根、每插一根拍一张照（防接反烧模块）。

> 备选还有 **WAGO 221 快接**（已到货 4 只：剥线 11mm → 掀杆插线 → 压回听"咔"）：接触电阻比杜邦小、可反复插拔，但占地方，只建议标定阶段临时用。
> ~~「买已焊排针模块 5–8 元」~~ **作废**——排针已随传感器赠送，此路不再需要。

---

## 步骤 1.5：接线自检（30 秒，接完线必做）

```bash
cd "D:/Documents/workbuddydocument/2026-10-17-08-59-13"
"C:/Users/junbo/.workbuddy/binaries/python/envs/default/Scripts/python.exe" \
  "outputs/代码/花房代码/tools/soil_watch.py" --port COM6
```

| 读数表现 | 含义 | 怎么办 |
|---|---|---|
| raw ≈ 0–200 纹丝不动 | ❌ OUT 没接上/没供电/没共地 | 查 5V→3V3、GND→GND；确认 OUT 在 D34 |
| raw > 4000 纹丝不动 | ❌ OUT 悬空或短路 | 查 5V 是否漏接/接反 |
| raw 几百～三千多且会动 | ✅ 接线通了 | 进步骤 2 |
| 手指捏探针读数上跳 | ✅ 更稳（人体接地） | — |

> 未接传感器时 raw 稳定 95–105（≈0.08V）是 GPIO34 悬空特征值——接上后**必须明显变化**才算通。

---

## 步骤 2：烧录标定固件（不是主程序！）

主程序 5 秒打一次、串口格式混杂，标定需要连续采样统计，故烧专用固件 `W1_SoilCalib`：

```bash
cd "D:/Documents/workbuddydocument/2026-10-17-08-59-13"
# 编译
"outputs/.tools/arduino-cli/arduino-cli.exe" compile \
  --fqbn esp32:esp32:esp32 \
  --build-path "C:/Users/junbo/AppData/Local/Temp/calibbuild" \
  "outputs/代码/花房代码/tools/W1_SoilCalib"
# 烧录（COM6 按实际改）
"outputs/.tools/arduino-cli/arduino-cli.exe" upload \
  -p COM6 --fqbn esp32:esp32:esp32 \
  --input-dir "C:/Users/junbo/AppData/Local/Temp/calibbuild" \
  "outputs/代码/花房代码/tools/W1_SoilCalib"
```

报 `not responding / not in sync`：按住板上 **BOOT** 键 → 重跑上传 → 看到 `Connecting....` 后松开。

---

## 步骤 3：看串口确认板子活着

Arduino IDE → 选板 `ESP32 Dev Module` + 端口 COM6 → 串口监视器 → 波特率 **115200**（最容易漏，不是默认 9600）。复位后应看到：

```
#SOILCALIB,1
#READY,soil_pin=34,interval_ms=100,avg_n=10
RAW,1523,3198
RAW,1624,3201
...
```

**看到 `RAW,` 开头的行 = 板子活着、接线通、ADC 在读。** 探针悬空时 3000 上下属正常（电容式在空气中读数偏高）。

---

## 步骤 4：实测标定（5 分钟，W1-4.1 验收物）

```bash
PY="C:/Users/junbo/.workbuddy/binaries/python/envs/default/Scripts/python.exe"
"$PY" "outputs/代码/花房代码/tools/soil_calibrate.py" --port COM6 --write
```

1. **干态**：提示「探针完全离开土/水」→ 回车 → 自动采 3 秒。
2. **湿态**：提示「探针完全浸入一杯水」→ 回车 → 自动采 3 秒。
3. **结果**：打印中位数/均值/范围/标准差 + 干湿差判定，**截图存档**（`W1-4.1-标定记录.png`）。
4. **自动回写**：数据通过自检（干湿差 ≥800、方向正确）时脚本直接改主程序 `SOIL_RAW_DRY` / `SOIL_RAW_WET`；不通过会**拒写**并给排查提示——那是接线/焊接问题，**不要手动硬填常量**。

### ⛔ 硬规矩（标定前必读）

主程序当前 `SOIL_RAW_DRY=3200` / `SOIL_RAW_WET=1300` 是**通用资料估值，未在本模块实测**：

| 估偏方向 | 后果 |
|---|---|
| 估高 | 湿态算成 ~91% → 永远不判缺水 → **花一直渴着**（静默失效） |
| 估低 | 干态算成 ~21% → 一直判缺水 → 反复浇水，**水箱空、盆泡烂**（危险） |

**标定完成、实测值回填之前，`EN_WATER` 一律保持 0。**（v1.6 已加标定非法 setup 硬停机兜底，见固件 README。）

---

## 步骤 5：烧回主程序并验证

```bash
"outputs/.tools/arduino-cli/arduino-cli.exe" compile --upload -p COM6 \
  --fqbn esp32:esp32:esp32 \
  --build-path "C:/Users/junbo/AppData/Local/Temp/ghbuild8" \
  "outputs/代码/花房代码/GreenHouse_v1"
```

串口（115200）应看到：

```
===== 智能花房养护站 v1.6 启动 =====
功能开关: DHT=0 OLED=0 WATER=0 LEVEL=0 WIFI=0 MQTT=0 WEB=0
标定: dry=<实测值> wet=<实测值> 缺水阈值=35%
[数据] 土壤raw=… 湿度=…% | 光照raw=0
```

- 无 `!! [自检失败]` = 标定值合法；探针悬空湿度应显示 0% 附近，浸水跳 90%+。
- 光敏没接时 `光照raw=0` 正常。

---

## 常见问题速查（合并去重版）

| 现象 | 原因 | 怎么办 |
|---|---|---|
| `board list` 空 | 数据线只供电 | 换线（最常见） |
| `board list` 有端口但 Unknown | 驱动没装好 | 设备管理器卸载 CH340 → 拔插 → 重装 CH341SER |
| 串口没输出/乱码/每秒重连 | 波特率不是 115200 | 改 115200 |
| `not responding / not in sync` | 没进下载模式 | 按住 BOOT，`Connecting....` 后松开 |
| raw 恒为 0 | OUT 没接到 GPIO34 / 没共地 | 重查接线，量 OUT 对 GND 电压 |
| raw 恒为 4095 | OUT 悬空 / 5V 没接 / 接了 5V(VIN) | 认准丝印 3V3 |
| 干湿差 < 800 | 探针没全湿 / 模块坏 / 焊接虚焊 | 换水重测；万用表量焊点；仍不行换传感器 |
| 湿度一直 0% | 干湿填反 | 脚本会拦；真发生改两常量顺序 |
| 万用表量 OUT↔5V 响了 | 焊接短路 | 返工重焊该点 |

---

## 完成后要留的素材

| 素材 | 命名 | 位置 |
|---|---|---|
| 焊接/接线完成照 | `W1-3.1-接线.jpg` | `素材/开发环境调试/` |
| 标定输出截图 | `W1-4.1-标定记录.png` | `素材/开发环境调试/` |

> 焊接过程照尤其有价值——答辩讲"遇到裸板焊孔怎么解决"的现成素材。
