huankechong/smart-greenhouse/docs/花房FinalProject方案书.md

# Final Project 方案书：智能花房养护站（Smart GreenHouse）

> 《Introduction to Project Work》期末项目 · **4 人小组共做一份（2026-10-20 确认）** · 答辩日顺延未定（原 2026-11-16；**2026-10-26 老师请假顺延，改相对排期，见《花房4人分工方案_2026-10-20.md》v2 §七**） · 方案定稿 2026-10-17
> 分工见 `docs/花房4人分工方案_2026-10-20.md`；本文件的任务内容仍有效，只是执行者从 1 人变成 4 人。

---

## 一、选题陈述（答辩开场用）

**项目名称**：智能花房养护站 Smart GreenHouse  
**技术定位**：嵌入式物联网系统（嵌入式 MCU 开发 + 云端联动）——ESP32 是单片机（MCU），固件直接跑在硬件上，符合嵌入式系统"专用功能、软硬件一体、资源受限"的定义；这也是它与树莓派方案的本质区别（树莓派是跑 Linux 的微型计算机，ESP32 才是嵌入式 MCU）。  
**一句话介绍**：面向家庭养花"浇水靠感觉、出门没人管"的痛点，用 ESP32 构建一套"感知 — 决策 — 执行 — 上云"完整闭环的桌面智能养护系统。

**为什么选这个题**（答辩叙事主线）：

1. **真实需求**：家里自营花店、自采花材，浇水量与光照是日常真实痛点——项目源于生活，不是为做而做；
2. **问题可分解**：正好用课程教的"复杂问题分解法"，拆成感知/执行/上云三个模块逐个击破；
3. **技术选型有故事**：课上 Arduino UNO 有 WiFi → 对比 UNO/ESP32/树莓派三平台 → 选 ESP32，完整的工程决策过程；
4. **课堂知识闭环**：10/17 实验课学的双色 LED 直接用作系统状态指示灯，Fritzing 画全部电路图。

## 二、系统架构（感知 / 执行 / 上云三大模块，决策逻辑内嵌于 ESP32）

```
┌───────────────────────────────────────────────┐
│                感知层（输入）                │
│ 土壤湿度（电容式）、DHT11 温湿度、光敏电阻       │
└───────────────────────────┬───────────────────┘
                            │ 模拟 / 数字信号
                            ▼
┌───────────────────────────────────────────────┐
│            ESP32 主控（决策核心）            │
│ 阈值判断、自动浇水逻辑、OLED 本地显示           │
└───────────────────────────┬───────────────────┘
                            │ 继电器 / GPIO 控制
                            ▼
┌───────────────────────────────────────────────┐
│                执行层（输出）                │
│ 继电器 + USB 水泵（自动浇水）                 │
│ 双色 LED 状态灯（绿=正常  红=缺水）            │
└───────────────────────────┬───────────────────┘
                            │ 数据上行 / 指令下行（WiFi / MQTT）
                            ▼
┌───────────────────────────────────────────────┐
│        云端层：巴法云 bemfa.com:9501         │
│ 微信小程序：实时数据、历史曲线、远程浇水         │
│ 保底：局域网本地网页（断网兜底）                │
└───────────────────────────────────────────────┘
```

**模块化容错设计**：感知/执行/上云三块相互独立，任何一块故障均可降级演示（如断网走局域网页面、水泵故障换手动），显著降低现场演示风险。

## 三、硬件采购清单（预算上限 150 元 → 实验室 B 套餐确认后大幅缩减）

> **实验室套件（创乐博 Arduino UNO R4 B 套餐，48 件）可直接借用**：温湿度（41号）、光敏（32号）、继电器（16号）、OLED（25号）、双色LED（13号）全部在列——感知与执行层的模块近乎零成本覆盖。

### 需自购（合计约 97–116 元，2026-10-20 AR12 口径统一；早期 48–81 为 AR07 时的旧口径，已过时）

| 部件 | 用途 | 参考价 | 备注 |
| --- | ---- | --- | --- |
| ESP32 开发板（CH340/CP2102 串口版） | 主控 | 15–25 | ✅ 已下单 10/17（¥14.17），主用板；选型对比见答辩叙事 |
| 电容式土壤湿度传感器 v2.0 | 土壤感知 | 5–8（2个合计） | 套件无此件；比电阻式耐腐蚀，**买2个** ✅ 已下单 10/17 |
| USB 微型水泵（3–5V）+ 硅胶管 | 自动浇水 | 10–15（2个合计） | 套件无水泵；**买1备1** ✅ 已下单 10/17（3W 底吸泵，实测 41×39×30） |
| **P52 浮球开关 ×2 + 1L 打包桶 ×5** | 水位检测+水箱 | ≈28 | ✅ 已下单 10/19（AR07：M10/常开/110V；报警剩 700ml>单轮上限 650ml） |
| 1kΩ 1/4W 电阻 + 100nF 电容（浮球上拉+滤抖） | 低水位保护 | 1–2 | 接线表第 8 节（1/4W 功率余量 23 倍）；与下面两项同单 |
| 小花盆 + 绿植 | 演示道具 | 10–20 | **8×8×8 直筒树脂盆**（外径 φ80、高 80、壁厚 10~20）—— 底盘槽已按此改 **φ82**（2026-10-23 实测定案）；Week 2 联调前买，绿植选绿萝/吊兰；要种两株薄荷时支架已减薄到占土面 13.7% |
| 22AWG 硅胶线 | 水泵回路 | 3–5 | 与浮球/二极管同单 |
| 1N4007 ×5（续流） | 水泵回路保护 | 3–5 | 详见《花房接线规划表》第四节；**MF-R110 保险已豁免不买**（正规 2A 电源+固件冷却兜底） |
| USB 延长线（A 公-A 母） | 泵电源串继电器 | 3–5 | 剪断不伤泵本体（接线表第四·补方案 A） |
| ~~220Ω 电阻 ×5~~ | ~~LED 限流~~ | — | ❌ 不买（13 号是模块自带限流；2026-10-19 确认） |
| ~~硅胶垫片~~ | ~~垫桶底~~ | — | ❌ 不买（替换盖裙边已定位；2026-10-19 确认） |
| **自购合计** | | **约 97–116**（另待买花盆绿植 10–20 → 合计约 107–136，预算 150 内余量 14–43） | 逐项加总见《花房借用与自购清单》2.2（AR12 校准口径） |

### 实验室借用清单（0 元，2026-10-19 晚更新：新增焊接工具、取消雨滴；ESP32 维持自购）

| 套件件号 | 名称 | 项目用途 |
| --- | --- | --- |
| 41 | 温湿度传感器 | 空气温湿度感知（替代原自购 DHT11 项） |
| 32 | 光敏电阻传感器 | 光照感知 |
| 16 | 继电器模块 | 水泵开关控制 |
| 25 | OLED 显示屏 | 本地数据显示（原自购 12 元项，省） |
| 13 | 双色 LED 模块 | 状态灯（绿=正常 红=缺水；课堂实验件复用） |
| 8/9/10 | 面包板×2/杜邦线/面包板线 | 连接件 |
| — | **电烙铁（焊枪）+ 焊锡丝**（含烙铁架） | 焊接土壤传感器排针（一次性加工，用毕即还；2026-10-19 新增） |
| — | **万用表（数字式）**  | 排针通断检查 + 整机调试测电压/电阻（用毕即还；2026-10-19 新增） |
| ~~26~~ | ~~雨滴探测模块~~ | ~~可选升级~~ **2026-10-19 取消借用** |

> ~~26 号雨滴探测模块（可选升级）~~：2026-10-19 取消借用，缺水报警加分项一并取消。
> **ESP32 曾拟 10/19 午改向实验室借用，当晚已回退为自购**（10/17 已下单 ¥14.17 在途，作主用板）。
>
> 借用需遵守实验室规定：登记领用、期末归还，收纳规整度纳入评估——**每次用完清点归盒**。

**下单原则**：核心件已齐（ESP32/土壤/水泵 10/17 单 + 浮球/水箱桶 10/19 单）；剩 1kΩ+100nF、22AWG 线、1N4007/保险拼一小单，花盆道具 Week 2 前买。

## 四、30 天执行排期（10/17 → 11/16）

> 前提：每周课余 5–10h。**实验器件不可带离实验室**（老师规定），所有硬件开发统一在实验室工位完成：提前预约实验室时段，把每周的开发任务集中到 1–2 个半天块内完成；纯软件工作（巴法云注册、写代码、SolidWorks 建模、写报告/PPT）在宿舍电脑进行。**每阶段产出即报告素材，边做边拍照片/存截图。**

### Week 1（10/17–10/23）下单 + 单模块点火

- [x] **10/17**：下单核心件（✅ 已下单：ESP32 ¥14.17 + 土壤传感器×2 + 3W 底吸泵）；向老师确认①B 套餐模块可否登记外借（✅ 已发申请）②final project 具体提交要求③实验室打印机预约使用流程
- [ ] 装好 ESP32 开发环境（Arduino IDE + ESP32 板支持包），点灯验证；记录所用库清单（土壤/光照模拟读取无需额外库，DHT11、OLED、MQTT 需第三方库，装的时候顺手记进报告素材）
- [ ] **接线注意**（ESP32 特有，与课上 UNO 不同）：模拟类传感器（土壤湿度、光敏）的模拟输出必须接 **ADC1 组引脚（GPIO 32–39）**——ADC2 组在 WiFi 开启后不可用，这是高频失误点，排查过程本身就是报告素材
- [ ] 各传感器逐个读取：土壤湿度 → DHT11 → 光敏 → OLED 显示（每件约半天）
- [ ] **产出**：4 张串口/OLED 数据截图（报告素材）

### Week 2（10/24–10/30）系统集成 + 执行闭环

- [ ] 三传感器数据融合进一个主程序，OLED 轮询显示
- [ ] 继电器 + 水泵联调：土壤湿度 < 阈值 → 自动浇水 N 秒（重点：防重复触发逻辑）
- [ ] 双色 LED 状态灯接入（绿正常/红缺水，呼吸闪烁效果）
- [ ] **产出**：第一次全自动浇水成功视频；Fritzing 整机电路图 v1

### Week 3（10/31–11/6）上云 + 3D 建模打印

- [ ] 注册巴法云 → ESP32 接入 MQTT（PubSubClient 库）→ 小程序绑定看数据
- [ ] 远程浇水指令下行打通；局域网本地网页保底方案
- [ ] **并行**：~~SolidWorks 建外壳模型~~ → **10/18 已提前完成**：参数化 STL 全套（盆沿挂钩/水泵座/水管夹/OLED 支架/两片式底盘/DHT11 座/扎线座/水箱替换盖）—— 2026-10-24 起 **02 水泵座作废**（泵自带吸盘）、01b 改土插支架、03 改窄版，**现行需打 10 件**（含 11 光敏小柱）+ 整机装配示意；SW 仅用于查看微调与截图（详见《花房3D建模入门路线_SolidWorks.md》顶部说明）
- [ ] 周末实验室 3D 打印（拓竹 X2D：Bambu Studio 切片，支持局域网直连或 U 盘传输，自动调平；预留 2 次打印余量，首版大概率要改）
- [ ] **产出**：手机端数据曲线截图、远程浇水录屏、建模过程截图（建模加分点）、打印实物

### Week 4（11/7–11/13）整机装配 + 报告 + 彩排

- [ ] 整机装入 3D 打印外壳，走线收纳（收纳规整度纳入评估！）
- [ ] 连续运行 48h 稳定性测试，导出云平台历史曲线
- [ ] **实验报告**：按课程统一模板，多图少字——背景→选型对比→三模块实现（每模块：Fritzing图+实物照片+代码片段）→失败与排查记录→数据曲线→总结
- [ ] **PPT 8–10 页**：封面 / 痛点与需求 / 选型决策表 / 系统架构 / 感知·执行·云三页 / 失败排查页 / 数据展示页 / 总结展望
- [ ] 录制**兜底演示视频**（完整流程 3 分钟，防现场设备故障）
- [ ] 11/13 前找同学做一次模拟答辩彩排
- [ ] **安全合规自查**（对照实验室安全八大模块）：设备供电走绝缘规范、水路远离电子元件、演示现场不出现明火/高温源（电烙铁类）、数据不存公共云的敏感项自查——报告里写一句"安全设计考量"也是加分细节

### 答辩周（11/14–11/16）

- [ ] 11/14–15：设备满电满水、WiFi 热点备用方案就绪、PPT/报告终稿
- [ ] 11/16 答辩：live demo（浇水 + 手机看数据 + 远程控制）→ 讲解 → 提问

## 五、答辩加分点清单

1. **每件传感器都有明确职责**（评委必问"为什么用 X"）：土壤湿度 → 整个系统唯一的浇水闭环触发源，直接测量根系实际供水，是"主角传感器"；光敏电阻 → 光照是光合作用的能量来源，只看湿度是"防渴死"，加上光照才能回答"长得好不好"；温湿度 → 蒸腾作用强度与病害（高温高湿易真菌）风险。答不上"为什么用"等于承认自己只是照抄教程。
2. **自建模加分**：SolidWorks 全过程截图写进报告（课程明确说了这是加分项）
3. **问题分解法**：PPT 专设一页展示感知/执行/上云的分解逻辑，呼应课堂内容
4. **失败与排查页**：如实记录调试问题（如土壤传感器读数漂移、MQTT 连接失败排查），工程素养的直接证据
5. **选型决策表**：UNO vs ESP32 vs 树莓派对比表，展示技术决策能力
6. **数据证据**：48h 连续运行的云端历史曲线 = 系统可靠性的实证
7. **故事线**：花店家庭背景 → 真实需求 → 课堂双色 LED 复用 → 项目落地，情感与逻辑双闭环

> **加分项数据支撑提醒**：巴法云免费版历史数据保留期有限，Week 3 上云成功当天就导出/截图存档，Week 4 的 48h 曲线跑完立即再导一次——报告里的数据证据宁可多存不可临期补抓。

## 六、风险预案

| 风险 | 概率 | 预案 |
| --- | --- | --- |
| 套件/实验室只能课上用 | 中 | 提前问老师；实在不行把核心件（ESP32+传感器）全自购，宿舍面包板开发，只在实验室打印和彩排 |
| 3D 打印排队/首版不合格（尺寸偏差、支撑难去除） | 中 | Week 3 初就交打印任务，预留 2 次重打余量；外壳设计宁大勿小 |
| 答辩现场断网 | 低 | 局域网本地网页 + 手机热点 + 兜底视频三重保险 |
| 传感器读数漂移 | 中 | 电容式传感器+软件滤波（取10次均值）；此排查过程本身就是报告素材 |
| 水泵堵头/漏水 | 低 | 双份备份；水瓶水位留裕量；桌面垫纸巾演示 |
| **WiFi 频段不匹配**：ESP32 只支持 **2.4GHz**，校园网常为 5GHz 或有认证页，直连可能失败 | 中-高 | 首选**手机 2.4GHz 热点**（答辩现场同样用热点，天然规避校园网）；宿舍路由器确认开 2.4G；Week 3 上云第一天就先做"ESP32 连 WiFi"验证，别等半天才发现连不上 |
| **课程时间冲突**：每周还有 Linux 周报、英语/德语课业并行 | 高（必然存在） | 排期已按周 5–10h 冗余设计；关键路径是"10/17 下单"和"Week 3 初交打印任务"这两个硬节点，其余任务可顺延挤压 |

---
