huankechong/smart-greenhouse/docs/花房30天执行计划.md

# 智能花房 · 30 天执行计划（细化版）

> ## 🧊 排期冻结通告（2026-10-26 21:40 · 最高优先级，覆盖下文全部日期）
> **老师本周请假（10/26 起当周课程停），答辩将顺延（大概率 +1 周），新日期未定。**
> **影响**：①本文所有硬编码死线（打印 11/5、答辩 11/16、各 D 编号日历日）**暂时失效，等新答辩日公布后一次性重排**；②10/26 D8 实验室任务（8.1 继电器、8.2 水泵、6 项传感器点亮、浮球极性）**全部未做**，并入实验室恢复后第一天执行；③打印窗口 10/27–10/30 计划作废——gcode 已切好不受影响，实验室恢复首日提交即可。
> **恢复日执行顺序（已备好，见 `docs/10月26日实验室操作清单.md`，日期顺延照用）**：打印提交（8h02m 无人值守，与下述并行）→ 8.1 继电器 → 8.2 水泵 → 传感器点亮 → 浮球极性 → 收尾烧回主固件。全做完约一个下午。
> **在日期重排前，勿按下文任何日历日判断"来不及"。**
>
> ## 🔄 2026-11-06 部分解除（最新）
> **器材已全部借到（套件元件 5 项 + 面包板/杜邦线/万用表），D0 = 11/07（周六）4 人开工。**
> 排期改为**相对日期**（D0 / D+2 交打印 / D_ans 答辩），**以 `docs/花房4人分工方案_2026-10-20.md`（v2）§七映射规则为准**；本文下述 W1–W4 日历排期仅作任务内容与验收标准的历史底稿。下文进度快照（2026-10-20）中的固件版本/打印件数/等快递表述已过时，现状：固件 **v1.6 实机验证**、**9 件** gcode 已切好、实测尺寸全部回填。

> 《Introduction to Project Work》期末项目 · **4 人小组共做一份（2026-10-20 确认）** · 2026-10-17 → 11-16 答辩（**⚠️ 答辩日待顺延重定，见上方冻结通告**）
> **按人分工见 `docs/花房4人分工方案_2026-10-20.md`**——本文件保留原单人视角的任务细节与验收标准，分工方案负责"谁做哪块"。
> 配套文档：《花房FinalProject方案书.md》《花房借用与自购清单.md》《花房接线规划表.md》《花房项目_AI工作交接文档_2026-10-18.md》
> **进度（2026-10-20 更新）**：D1 三项全部完成（已下单约 34–37 元、申请邮件已发、项目文件夹就位）；D2 全部提前完成（Arduino IDE + arduino-cli + esp32:esp32@2.0.18 板包、CH340 驱动、巴法云注册与双主题、接线规划表）；D2 之外的超前项：主程序 **v1.5.1**（v1.1 审计修复 → v1.2 异常保护 → v1.3 继电器上电毛刺 → v1.4 浮球水位 → v1.5/v1.5.1 全量代码审计修复，双形态编译验证），SolidWorks 2026 学生正版已激活；**10 个 3D 打印件全部参数化出 STL，土壤传感器/ESP32/水泵已按实物实测尺寸回填建模**；固件补两条异常保护（连浇上限+冷却、低水位停泵）并经 AR10 审计修复其失效缺口；**借用更新：新增电烙铁+焊锡丝、万用表，雨滴模块取消（ESP32 维持自购，见《花房借用与自购清单》）**。当前状态：等快递（预计 10/21 前后到货），到货即进 D3 点火。
>
> **使用说明**：每个任务有编号、预计耗时、验收标准和「素材」标记（= 做完顺手拍照/截图存进报告素材文件夹，报告要求多图少字）。设备不可带离实验室，硬件任务一律在实验室时段块完成；纯软件任务（标 🖥）可在宿舍电脑做。
> **建议**：在桌面建一个 `花房项目/` 文件夹，下设 `素材/`（照片截图）、`代码/`、`报告/`、`PPT/` 四个子目录，所有素材按"W1-任务编号"命名。

---

## 总览：四周节奏

| 周 | 日期 | 主题 | 周末验收物 |
|---|---|---|---|
| W1 | 10/17–10/23 | 采购下单 + 单模块逐个点亮 | 4 类传感器全部读出数据 + 截图 |
| W2 | 10/24–10/30 | 系统集成 + 自动浇水闭环 | 全自动浇水成功视频 + 整机电路图 |
| W3 | 10/31–11/6 | 上云 + 3D 建模打印 | 手机看到数据 + 外壳打印件 |
| W4 | 11/7–11/13 | 装机 + 48h 测试 + 报告 PPT + 彩排 | 报告/PPT 终稿 + 兜底视频 |
| 答辩周 | 11/14–11/16 | 终检 + 答辩 | 现场 demo |

**两条铁律**：① W1 周日前必须完成下单（物流 3–5 天，卡死关键路径）；② 3D 打印首版最迟 W3 周四（11/5）提交（排队 + 首版返工风险，重打窗口只剩 W4 周初）。

---

## Week 1（10/17–10/23）：下单 + 单模块点火

### 🖥 D1（10/17，周六）
| 编号 | 任务 | 预计 | 验收标准 |
|---|---|---|---|
| 1.1 | **下单自购件**：ESP32 开发板 ×1、电容式土壤湿度传感器 ×2、USB 微型水泵 ×2 + 硅胶管（一家店拼单免邮；搜"ESP32 DevKit CH340""电容土壤湿度 v2.0""USB 迷你水泵 5V"） | 30min | 订单截图，预计到货 ≤10/22 |
| 1.2 | **发申请邮件**：邮件模板替换占位符 + 申请单 docx 转 PDF 附上，发给 He Pu / Li Qiang 老师 | 20min | 邮件已发出，_cc 自己一份留档 |
| 1.3 | 🖥 建项目文件夹结构（素材/代码/报告/PPT），把方案书、申请单、清单复制进"报告/" | 10min | 目录就位 |

### 🖥 D2（10/18，周日）
| 编号 | 任务 | 预计 | 验收标准 |
|---|---|---|---|
| 2.1 | 安装 Arduino IDE 2.x + ESP32 板支持包（开发板管理器搜 esp32，装最新稳定版；国内网络慢就按官方教程加镜像源） | 40min | 能在板管理器里看到 esp32 系列 |
| 2.2 | 安装 USB 串口驱动（CH340 或 CP2102，板子到货前先装好两种） | 15min | 设备管理器能识别串口（等板子到货实测） |
| 2.3 | 🖥 预习：把巴法云官网注册好（bemfa.com，微信扫码），控制台拿到私钥 UID 存进素材夹 | 15min | UID 已存档（W3 直接用） |
| 2.4 | 🖥 通读 ESP32 引脚图，把自己画的接线规划表写进素材夹（重点标 ADC1 引脚 GPIO 32–39） | 30min | 接线规划表一张 |

### D3（10/20，周二，实验室或等快递）
| 编号 | 任务 | 预计 | 验收标准 |
|---|---|---|---|
| 3.1 | 板子到货后：首次上电 → 烧录出厂测试程序 → 串口看到 "Hello" | 30min | **素材**：串口输出截图（编号 W1-3.1） |
| 3.2 | 经典 blink：板载 LED 闪烁 + 外接 LED（用套件单色 LED）闪烁 | 20min | **素材**：接线照片 + 亮灯照片（W1-3.2） |

### D4（10/21，周三，实验室）
| 编号 | 任务 | 预计 | 验收标准 |
|---|---|---|---|
| 4.1 | 土壤湿度传感器接入：AO 接 GPIO34（ADC1！），读模拟值，干湿两种状态各记录数值范围（干 ≈ 3000+，湿 ≈ 1500 上下，以实测为准） | 45min | **素材**：干/湿读数对比截图（W1-4.1）|
| 4.2 | 光敏电阻接入：AO 接 GPIO35，记录亮/暗读数范围 | 30min | **素材**：亮/暗读数截图（W1-4.2）|

### D5（10/22，周四，实验室）
| 编号 | 任务 | 预计 | 验收标准 |
|---|---|---|---|
| 5.1 | 套件温湿度传感器（41 号）接入：数字单总线，装 DHT 库，读温湿度 | 45min | **素材**：串口温湿度截图（W1-5.1）|
| 5.2 | 套件 OLED（25 号）接入：I2C（SDA/SCL），跑显示例程，把土壤湿度数字显示上去 | 60min | **素材**：OLED 显示照片（W1-5.2）|

### D6（10/23，周五，实验室，W1 收口）
| 编号 | 任务 | 预计 | 验收标准 |
|---|---|---|---|
| 6.1 | 双色 LED（13 号）接入：两路 PWM 调色，红绿渐变 | 30min | **素材**：红/绿两态照片（W1-6.1）|
| 6.2 | W1 收口检查：4 类传感器 + OLED + LED 共 6 项全部独立工作；素材夹里 W1 系列截图齐全；写 3 句话周记（写 Linux 周报时顺手统一格式） | 30min | 周记一段 + 素材 ≥8 张 |

**W1 风险提示**：快递晚到 → 先做 2.1–2.4 的纯软件项；实验室预约不上 → 当天任务顺延，周末补，但**不许挤占 W2**。

---

## Week 2（10/24–10/30）：系统集成 + 执行闭环

### D7（10/25，周日，实验室）
| 编号 | 任务 | 预计 | 验收标准 |
|---|---|---|---|
| 7.1 | **买花盆+绿植+蓄水瓶**（楼下超市/网购，绿植选绿萝/吊兰等耐折腾品种）<br>⚠️ **花盆规格：8×8×8 直筒树脂盆**（外径 φ80 × 高 80，**壁厚 ≤4.6mm**）—— 领导 10/23 实拍确认，**底盘槽与挂钩已按此改好**（槽 φ62→φ82 且中心移到 (-111,60)；挂钩 `taper` 8.1→**0**、`rim_gap`→**4.6**）。⚠️ **若买成方形盆需再改一轮**（圆槽装不下 80×80 方形）。详见 `docs/花房借用与自购清单.md` §2.1 | 30min | 实物到位 |
| 7.2 | 合并代码：三个传感器读数进同一个主程序，OLED 轮询显示三行数据 | 60min | **素材**：OLED 三行数据照片（W2-7.2）|
| 7.3 | 把传感器读数映射成 0–100% 显示（写一个 map 函数，标定干值/湿值常量） | 40min | **素材**：标定前后对比说明（W2-7.3）|
> ⚠️ **7.3 依赖标定**：若 10/26 前没实测到干/湿 raw，这里只能填**占位估值**（`3200/1300`），**必须在标定完成后回填**，否则显示的湿度%是假的 |

### D8（10/26，周一，实验室）

> 📋 **详细操作步骤见 `docs/10月26日实验室操作清单.md`** —— 含器材核对（4 组）、5 个任务的执行顺序、
> 每个传感器怎么接/怎么验、出水量记录表、收尾烧回主固件。
> ⚠️ **主固件没有手动触发继电器的入口**（`Serial.read()` 零处、`manualWaterStart()` 只被 MQTT 调用）→
> 8.1 必须烧 `outputs/花房代码/RelayPumpTest/`（串口指令 `on`/`off`/`w N`/`auto`/`t`），测完烧回主固件。
> ⚠️ **8.2 的水源文档没写** → 实验室有水龙头就用桶接，没有就自带 1 瓶 500ml–1.5L 矿泉水（3W 泵 10 秒约 200–300ml，1L 够）。

| 编号 | 任务 | 预计 | 验收标准 |
|---|---|---|---|
| 8.1 | 继电器接入：GPIO 控制继电器吸合/断开，串口打印状态 | 30min | **素材**：继电器吸合照片（W2-8.1）|
| 8.2 | 水泵联调（**水路远离电路，桌面垫纸巾**）：继电器 → 水泵 → 出水测试，记录"浇 N 秒 = 出多少水" | 45min | **素材**：出水照片/短视频（W2-8.2）|

### D9（10/28，周三，实验室）
| 编号 | 任务 | 预计 | 验收标准 |
|---|---|---|---|
| 9.1 | **自动浇水逻辑**：湿度 < 阈值 → 浇 3 秒 → 停 30 秒再测 → 仍干再浇（防重复触发 + 浇透即停）；湿度恢复 → 停止 | 60min | 逻辑跑通 |
| 9.2 | 双色 LED 状态联动：湿度正常 = 绿、缺水浇水 = 红闪；把"课上学的双色 LED"注释写进代码 | 30min | **素材**：红/绿状态各一张（W2-9.2）|
| 9.3 | **里程碑：第一次全自动浇水成功**——把探针从土里拔出触发浇水，再插回停止 | — | **素材**：完整过程视频 1 分钟（W2-9.3，这是答辩核心素材）|

### D10（10/30，周五，实验室）
| 编号 | 任务 | 预计 | 验收标准 |
|---|---|---|---|
| 10.1 | 🖥 **Fritzing 整机电路图 v1**（宿舍做：全器件接线图，导出 PNG） | 60min | **素材**：电路图 v1（W2-10.1）|
| 10.2 | W2 收口：代码存 Git/备份；周记；素材归档 | 30min | 素材 ≥5 张 |

---

## 🖨 打印窗口重排（2026-10-23 20:00 新增 · 周末打不了印）

### ⚠️ 原排期有两个硬缺陷

| 缺陷 | 说明 |
|---|---|
| **① 打印开始日 = 死线当天** | D14 定在 **11/5–11/6**，而首版死线就是 **11/5**。9 件约 19h 分两次机时 → 11/6 才打完 → **交出首版已经超期 1 天**，且 11/7 就进 W4，**零返工窗口** |
| **② 周末不可用** | 10/31（六）、11/1（日）**打不了印**。而 11/1 是 D11（巴法云，宿舍纯软件，不受影响） |

### 🗓 10/26 – 11/6 工作日窗口盘点

| 日期 | 原计划 | 打印可用性 |
|---|---|---|
| 10/26 一 | D8 继电器接入 + 水泵联调（实验室） | ✅ 人在实验室 |
| **10/27 二** | **空闲** | ⭐ **最佳起点** |
| 10/28 三 | D9 里程碑「第一次全自动浇水」（实验室） | ✅ 人在实验室 |
| **10/29 四** | **空闲** | ⭐ 第二次机时（若 10/27 一次打完则此格空出） |
| 10/30 五 | D10 W2 收口（实验室） | ✅ 拿到件当天试装 |
| 10/31 六 | — | ❌ **周末打不了** |
| 11/1 日 | D11 巴法云控制台（宿舍纯软件） | ❌ 周末打不了（但 D11 不受影响） |
| 11/2 一 | D12 远程浇水打通（实验室） | ✅ |
| 11/3 二 | D13 切片（宿舍） | ✅ |
| 11/4 三 | D13 切片（宿舍） | ✅ |
| 11/5 四 | D14 打印（**死线当天**） | ⚠️ 太晚，且当天不可能交 |
| 11/6 五 | D14 收口 | — |

### ✅ 重排方案：打印从 11/5 提前到 10/27

| 时段 | 动作 | 说明 |
|---|---|---|
| **10/24–10/25 周末（宿舍）** | **13.3 切片提前做** —— Bambu Studio 纯软件，**不需要打印机**。参数用现有 **9 个** STL（02 泵座已作废） | 免支撑、brim 5–8mm、0.2 层高、20% gyroid |
| **10/27（二）** | **机时**：底盘两片 `06a_base_left` / `06b_base_right` —— **实测各 2.5h，合计 5.0h**（原估 12.2h） | 提交后机器跑，10/28 早上取 |
| **10/29（四）** | **机时**：其余**七件** —— **实测合计 3.0h**（原估 8.3h）。若能 8.5h 连续，本行可并入 10/27 一次打完 | 10/30 取 |
| **10/30（五）D10 当天** | **拿到全部 9 件 → 立即试装** → 记偏差 → 改脚本顶部参数 → 重跑出 v2 | 趁实验室一次做完 |
| **11/2 – 11/4** | **补打偏差件**（只补改动件，**不要重打全套**） | 3 天返工窗口 |
| **11/5（四）** | 装配复检 + 整机走线 | 死线当天只做收口，不做打印 |

> 📋 **2026-10-24 实切更新**：9 件实测 **8h02m / 325g**（拓竹 X2D 0.4mm）。
> **实验室机时不确定 → 默认走方案 B**：06a **2h27m** / 06b **2h32m** / 小件七件 **3h01m**，**每批 ≤3h 怎么都不会超**。
> **第一件先打 06c 连接块（7 分钟）试机**，用 M3 自攻试拧 φ2.8 孔确认手感，再上底盘。
> 完整现场步骤（分批方案 A/B/C、上机顺序、故障处理、7 项验收）→ `outputs/切片_2026-10-24/上机操作卡.md`。

**净收益：首版比死线提前 5 天完成，多出 3 天返工窗口。** 这正对上 W3 风险提示「首版 90% 要改尺寸」—— 早打早发现，才有从容改参数补打。

> ⏳ **待确认（唯一卡点）**：**10/27（二）与 10/29（四）实验室能进吗？** 原计划实验室任务隔天排（10/25、26、28、30），暗示 10/27、10/29 可能不开。
> - **若两天下午都能进** → 按上表执行，首版 10/30 到手。
> - **若只能进一天** → 10/27 打底盘（12.2h，重的先打），10/29 打八件；或申请连续机时一次跑完 20.5h。
> - **若两天下午都不开** → 退回 11/2 起打（11/2、11/3、11/4、11/5 四个工作日），首版 11/5 当天交，**几乎无返工窗口** —— 这时必须把 10/27 或 10/29 争取出来。

> 💡 **打印是无人值守的**：提交任务后机器自己跑，人可以同时做 D8/D9/D10 的实验室任务。**占用的是打印机，不是人。** 所以只要能预约到机时，D8/D9/D10 和打印**不冲突**。

**W2 风险提示**：浇水逻辑最常见的坑是"探针一拔永远缺水、反复浇水"——防重复触发逻辑（浇完延时再测）必须做，这个调试过程就是报告的"失败与排查"素材。

> **⏱ W2 关键路径（2026-10-23 19:44 复核 · 烙铁状态更新）**：
> **① 10/26 实验室一次性全给**（传感器模块 + 面包板 + 杜邦线 + 继电器）→ **继电器零延误，且「既无烙铁又无面包板/线」的最坏档被排除**。
> **② 电烙铁 + 焊锡丝「不确定」** —— 但**不影响 10/26 当天完成标定**，因为有三条退路：
> - **档 A（首选，零工具零等待）**：借到的**公对母**杜邦线，**公头直插传感器焊孔**（方针 0.64mm 对 1.0–1.2mm 孔，靠孔壁夹紧）→ 母头插 ESP32 排针。**不需要烙铁、不需要 WAGO、不需要面包板。**
> - **档 B（烙铁到货）**：焊 1×3P 排针 → 母对母线接 → 永久连接，答辩更体面。
> - **档 C（无公头线时）**：**WAGO 221 免焊**（端子已到货 4 只）+ 硬芯线插焊孔 + 面包板 → 需剥线，最麻烦但零成本。
> **③ 最坏档（既无公头线、又无 WAGO/面包板）**：8.1/8.2 仍可做（继电器是带排针模块，A 型母对母直插），仅标定顺延 → 9.3 挪到 D10 之后。
> **④ 7.2 软件部分 2026-10-23 已完成**：`EN_DHT=1` + `EN_OLED=1` 组合**本地编译验证 PASS（400,757 B / 30%）**；所需库 DHT sensor library 1.4.7、U8g2 2.36.19、Adafruit Unified Sensor 1.1.15 **均已安装**。10/26 只需接线 + 烧录，现场不调代码。
> **⑤ 7.3（写 map 函数）仍依赖标定** —— 未标定前只能填占位估值 `3200/1300`，**必须在标定后回填**，否则 OLED 上显示的湿度%是假的。

> **⛔ W2 头号前置：标定没做完，`EN_WATER` 不许改成 1**（2026-10-20 补）。
> 主程序默认的 `SOIL_RAW_DRY=3200` / `SOIL_RAW_WET=1300` 是按通用资料**估的**，没在本模块实测。
> 估偏了两种都坏：估高→湿态算成 90%→**永远不浇、花渴着**（静默失效）；估低→干态算成 20%→**一直浇、水箱空盆泡烂**（危险）。
> **W2 第一件事就是确认 8.1 已把两个常量回填成实测值**；没回填就还开着 0，多耽误几天没关系，浇错水没法补救。

> **📦 物料状态（2026-10-23 晚更新）**：**硬件基本齐备，但有一处必须先核实。**
> ①实验室 A 套件元件包 + 自购件已到货：P52 浮球开关、22AWG 硅胶线（红/黑各 8 米）、1/4W 电阻包（30 种×10）、瓷片电容包、1N4007、蜂鸣器、绿联 USB 延长线、**304 防松螺母套装（超清单）** —— 详见 `docs/审计报告/AR14_GreenHouse硬件到货实拍核对_2026-10-23.md`；
> ②✅ **4 颗透明壳器件 = 万可 WAGO 221 快接端子**（初版误判为继电器，19:05 已更正并经官方规格 7/7 验证）—— 即 10/19 自购的泵回路三通端子，**到货 4 只**。**泵回路接线端子齐了**，且**免焊方案 B 立刻可行**（烙铁借不到也能接线）；
> ②b✅ **继电器模块（16 号）10/26（周一）可从实验室借到** —— 与 **W2-D8「8.1 继电器接入」原定同一天，零延误**；D7（10/25）全为纯软件，不受影响。**主程序 `EN_WATER` 逻辑不用改**，也不用买替代模块；

> ③**套件不含电烙铁/焊锡丝** —— 借用清单第 7 项仍需单独借；万用表建议一并借。
> ④标定仍卡在**焊排针**这一步（排针已随传感器赠送，只缺烙铁）。借到后按 `docs/土壤传感器焊接操作卡_2026-10-21.md` 走。
> ⚠️ **3D 打印 11/5 死线比标定更硬 —— 硬件已齐，10/24 周末就该把切片做完。**

---

## Week 3（10/31–11/6）：上云 + 3D 建模打印

### 🖥 D11（11/1，周日，宿舍，纯软件日）
| 编号 | 任务 | 预计 | 验收标准 |
|---|---|---|---|
| 11.1 | 巴法云控制台：创建 2 个主题（如 flower001 数据上行 / flower001cmd 指令下行），记下主题名 | 20min | 主题建好 |
| 11.2 | ESP32 代码接入 MQTT：PubSubClient 库，连 bemfa.com:9501，每 10 秒上报一条 JSON（湿度/温度/光照） | 90min | **素材**：小程序收到首条数据的截图（W3-11.2，里程碑）|
| 11.3 | 微信小程序绑定 UID，确认数据面板显示正常 | 20min | **素材**：手机端面板照片（W3-11.3）|

### D12（11/2，周一，实验室 + 宿舍）
| 编号 | 任务 | 预计 | 验收标准 |
|---|---|---|---|
| 12.1 | **远程浇水打通**：小程序发指令 → ESP32 订阅收到 → 触发浇水 | 60min | **素材**：手机点按钮 + 水泵出水的短视频（W3-12.1，答辩第二核心素材）|
| 12.2 | 局域网保底网页：ESP32 起一个简单 HTTP 页面显示当前数据 | 60min | **素材**：局域网页面截图（W3-12.2）|
| 12.3 | **导出/截图巴法云历史数据**（免费版保留期有限，当天就存！） | 10min | **素材**：首批历史曲线（W3-12.3）|

### 🖥 D13（11/3–11/4，晚上宿舍，打印准备 —— 建模已在 10/18 提前完成）
| 编号 | 任务 | 预计 | 验收标准 |
|---|---|---|---|
| 13.1 | 量好实体尺寸（ESP32 板、OLED、面包板、花盆直径、蓄水瓶），列尺寸清单 | 30min | 尺寸清单 |
| 13.2 | ~~建模 v1~~ **已提前完成（10-18）**：参数化 STL 全部产出并逐件校验（水位/装配干涉见 AR02–AR04；2026-10-24 起 **9 件**，02 泵座作废）。本时段改为：量实物 6 个尺寸 → 回填参数 → 重跑脚本出 v2 | 60min | **素材**：STL 列表截图 + 装配四视图（W3-13.2，**加分项素材**）|
| 13.3 | 拿 `outputs/花房3D_*/STL/*.stl` 进 Bambu Studio 切片：**免支撑**、brim 5–8mm、0.2 层高、20% gyroid；底盘两片各约 6h，先排机时 | 30min | 打印文件就绪 ⏰ **10/24–10/25 周末就做完**（纯软件，不需打印机），10/27 到实验室直接提交 |

### D14（11/5–11/6，实验室，**收口 + 补打**，原定打印已提前至 10/27/10/29 —— 见「🖨 打印窗口重排」节）
| 编号 | 任务 | 预计 | 验收标准 |
|---|---|---|---|
| 14.1 | ~~按预约流程提交打印~~ → ✅ **已提前至 10/27 + 10/29**（10/27 打底盘两片 12.2h，10/29 打其余八件 8.3h，10/30 取件即试装）。**此处只在有偏差件时补打** | 0–1 次机时 | **素材**：打印过程照片 + 成品照（W3-14.1）|
| 14.2 | 试装：板子/OLED/传感器挂钩/底盘逐件实装，偏差记下来 → 改脚本顶部参数 → 重跑出 v2 → 补打偏差件（**不要重打全套**） | 60min | 整机可装 |
| 14.3 | W3 收口：素材归档 + 周记 | 20min | 素材 ≥8 张 |

**W3 风险提示**：① 上云首日先验证"ESP32 连手机 2.4G 热点"再写 MQTT（WiFi 不通别硬调代码）；② 首版 90% 要改尺寸——参数化脚本改一个数就重出，改模重打的过程也是报告素材。

---

## Week 4（11/7–11/13）：装机 + 48h 测试 + 报告 + 彩排

### D15（11/7–11/8，周末，实验室）
| 编号 | 任务 | 预计 | 验收标准 |
|---|---|---|---|
| 15.1 | **整机装配**：全部器件装入外壳 v2，走线整理（收纳规整度纳入评估！），水位/传感器位置固定 | 90min | **素材**：整机四角度照片（W4-15.1）|
| 15.2 | 启动 **48h 连续运行测试**（周六上午启动 → 周一上午收） | 挂机 | 运行不中断 |

### 🖥 D16（11/9–11/10，宿舍，报告主体）
| 编号 | 任务 | 预计 | 验收标准 |
|---|---|---|---|
| 16.1 | 导出 48h 云端历史曲线（第二次保存数据证据） | 20min | **素材**：48h 曲线图（W4-16.1，答辩实证）|
| 16.2 | **实验报告初稿**：按课程统一模板——背景→选型对比表→三模块实现（每模块：Fritzing 图+照片+代码片段）→失败与排查（W2 防重复触发、ADC 引脚、WiFi 频段三个真实案例）→48h 数据→安全设计考量→总结 | 180min | 初稿成文，图文比 ≥6:4 |
| 16.3 | PPT 8–10 页：封面/痛点需求/选型决策/系统架构/感知·执行·云三页/失败排查/数据展示/总结展望 | 120min | 初版 |

### D17（11/11–11/12，实验室 + 宿舍）
| 编号 | 任务 | 预计 | 验收标准 |
|---|---|---|---|
| 17.1 | **录兜底演示视频**：完整流程 3 分钟（插拔探针触发自动浇水 → OLED 显示 → 手机看数据 → 远程浇水） | 40min | **素材**：兜底视频（W4-17.1）|
| 17.2 | 报告/PPT 互查修改：对照评分点逐项自查（实物✓ 分解✓ 可复现✓ 加分项✓） | 60min | 二稿 |
| 17.3 | 答辩问答预演：把「为什么 ESP32/光敏/电容式」「断网怎么办」「传感器漂移怎么办」等预设问题的答案写成一页小抄 | 60min | 问答小抄一页 |

### D18（11/13，周五，彩排日）
| 编号 | 任务 | 预计 | 验收标准 |
|---|---|---|---|
| 18.1 | 找同学模拟答辩一遍：5 分钟讲 + 3 分钟问答，计时 | 30min | 讲稿顺一遍 |
| 18.2 | 报告/PPT 终稿定版；设备满水满电；确认答辩场地的网络/投屏方式 | 40min | 全部就绪 |

---

## 答辩周（11/14–11/16）

| 编号 | 任务 | 预计 | 验收标准 |
|---|---|---|---|
| 19.1 | 11/14–15：设备再跑一遍全流程冒烟测试；手机热点、备用 USB 线、兜底视频三重保险装包 | 30min | 冒烟通过 |
| 19.2 | 11/16 答辩：演示顺序 = 自动浇水（拔插探针）→ OLED 数据 → 手机实时面板 → 远程浇水按钮 →（如被问断网）切局域网页面 | — | 自信讲完 |

---

## 每日最小闭环（防拖延版）

任何一天实在没时间，至少做完这一件事（合计 ≤30 分钟，不断线）：
- W1：装一个库 / 读一个传感器读数
- W2：调一版浇水逻辑 / 拍一张素材照
- W3：小程序上看一眼数据 / 建模推进一个特征
- W4：写报告一节 / PPT 一页

**统计**：全程约 18 个工作日、40+ 小时有效工作，日均 <2.5 小时——在"每周 5–10 小时"的约束内绰绰有余，且每周五留有缓冲。
