huankechong/smart-greenhouse/docs/W1到货点火与标定操作指南_2026-10-20.md

# W1 到货点火操作指南（ESP32 + 土壤传感器已到货）

> 适用日：2026-10-20 到货当天 / 10-21±
> 目标：把「板子插上 → 烧录 → 串口看到数据 → 实测标定」这一整条打通
> 配套：`outputs/花房代码/tools/W1_SoilCalib/`（标定固件）、`outputs/花房代码/tools/soil_calibrate.py`（标定脚本）
> 接线依据：`docs/花房接线规划表.md` 第 1 节

---

## 步骤 0：先确认电脑认得板子（30 秒）✅ **已通过（2026-10-20 23:5x）**

> 🎉 **实测结果**：插上板子后 `board list` 返回 `COM6 | serial | Serial Port (USB) | Unknown`，
> 设备管理器显示 **`USB-SERIAL CH340 (COM6)`**，状态 OK，VID=1A86 PID=7523。
> **驱动完全正常，之前"枚举不到设备"是因为板子当时没插。**
> ⚠️ 端口号 **COM6**（不是原指南写的 COM5）—— 下面所有命令请把 COM5 改成 **COM6**。

**插线前先看这一步**，能省掉后面一堆无谓排查。

1. 用**自带的数据线**（不是充电线）把 ESP32 插电脑 USB 口。插反了不要硬怼，USB 口是梯形的，方向不对插不进去。
2. 跑这条命令看端口：

```bash
"D:/Documents/workbuddydocument/2026-10-17-08-59-13/outputs/.tools/arduino-cli/arduino-cli.exe" board list
```

**看结果**：

| 输出 | 含义 | 下一步 |
|---|---|---|
| 出现 `COM5`（或别的 COM 号） | 驱动正常，继续步骤 1 | 记下这个 COM 号 |
| 出现 `COM5` 但后面写 `Unknown` / 一串 `?` | 驱动没装或没装对 | 走下面的「驱动修复」 |
| **空输出 / `No boards found`** | 板子没插、数据线是充电线、或驱动缺失 | 先换一根线试；还不行走「驱动修复」 |

**驱动修复**（Windows 11）：
- 插着板子，打开「设备管理器」，找「端口 (COM 和 LPT)」
- 看到 `USB-SERIAL CH340 (COMx)` 带**黄色感叹号** → 右键 →「卸载设备」→ 拔插板子 → Windows 自动装
- 整个「端口」分类里**根本没有 CH340** → 装驱动：搜索「CH341SER.EXE」（南京沁恒 / WCH 官网），或用 Arduino IDE 自带：`C:\Program Files (x86)\Arduino\drivers\arduino\CH341SER.EXE`（本机已装过 CH341SER.INF，版本可用）
- 装完**拔插一次板子**再跑 `board list`

> 本机已确认：`CH341SER.INF`（oem265.inf）已在系统里，驱动这一环基本是通的。所以**空输出最可能是数据线只供电不传数据**，先换线。

### 📌 从照片确认的 ESP32 板型与丝印（2026-10-20 实拍核对）

实物是 **ESP-32-DevKitC / ESP32-WROOM-32 30 脚板**（不是 38 脚）。丝印读法（**背面视角，USB 口朝下**）：

| 排 | 丝印（从上往下） |
|---|---|
| **左排** | EN · VP · VN · **D34** · D35 · D32 · D33 · D25 · D26 · D27 · D14 · D12 · D13 · GND · VIN |
| **右排** | D23 · D22 · TX0 · RX0 · D21 · D19 · D18 · D5 · D17 · D16 · D4 · D2 · D15 · GND · **3V3** |

**接线时按这个位置找：**

| 要接的 | 在板子哪 | 提醒 |
|---|---|---|
| **3V3** | 右排**最下面**一个 | 传感器 `5V` 脚接这里（丝印写 5V，但接 3V3！） |
| **GND** | 右排倒数第二个 / 左排倒数第二个 | 两个都行，任选一个 |
| **GPIO34** | 左排**从上数第 4 个**（丝印 `D34`，在 `VN` 下面） | 传感器 `OUT` 脚接这里 |

> 💡 **GPIO34 是左排第 4 个**，很容易数错 —— 它上面是 `VN`，`VN` 上面是 `VP`，最上面才是 `EN`。
> 传感器丝印是 `GND` / `5V` / `OUT`（**不是** `VCC/GND/AOUT`），且**正反两面顺序相反**。

---

## 步骤 1：接线（只接土壤传感器，10 分钟）

> ⚠️ **定案（2026-10-21 01:17）：采用焊接排针方案，等实验室电烙铁。**
> 土壤传感器是裸板三个空焊孔，但**买传感器时随附了 1×3P 排针** —— 所以**只缺烙铁，排针不用买**。
> 完整焊接流程（顺序、手法、万用表验证、接线、标定）见 **`docs/土壤传感器焊接操作卡_2026-10-21.md`**。
> 免焊路径（公头直插 / 硬芯线）已放弃，仅留作烙铁借不到时的备选 → `docs/W1无烙铁接线方案_2026-10-20.md`。
> 本步骤按"已接好线"来讲。

ESP32 侧看丝印，**只接三根线**：

| 传感器针脚（实物丝印） | → | ESP32 | 必看 |
|---|---|---|---|
| **5V** | → | **3V3** | ⚠️ 丝印写 5V，但**接 3V3**。模块内置稳压（3.3–5.5V 都能工作），且 v2.0 输出恒为 0–3.0V，接 3V3 正好占满 ADC 量程 |
| **GND** | → | GND | 任一 GND 即可（板子右排倒数第二个 / 左排倒数第二个） |
| **OUT** | → | **GPIO34** | ⚠️ 只能接 34/35（ADC1 组）；**GPIO34 = 左排从上数第 4 个**（丝印 `D34`） |

> ⚠️ **丝印不能猜**：本模块丝印是 `GND` / `5V` / `OUT`，**不是**通用教程里的 `VCC/GND/AOUT`。
> 且**正反两面顺序相反** —— 背面丝印面读作 `GND/5V/OUT`，元件面读作 `OUT/5V/GND`。
> 拿不准就对着光看，或者用万用表量一下。

**三处最容易踩的坑**：

1. **GPIO34 是"只进不出"脚**——没有内部上拉、不能输出，只能接传感器输出。
2. **别接 GPIO35**——那是光敏传感器的位置。两个都插也能跑，但光敏没接会读到乱跳的数，干扰你判断土壤读数。
3. **一定要共地**——传感器的 GND 必须和 ESP32 的 GND 连一起，不能只接 VCC 和 OUT。

**拍照存档**：接好线拍一张接线照片，命名 `W1-3.1-接线.jpg`，放 `素材/`。报告要图。

---

## 步骤 1.5：接线自检 —— 看数字动没动（30 秒）✅ 新增

**接完线别急着标定，先确认接线真的通了。** 跑这个新工具：

```bash
cd "D:/Documents/workbuddydocument/2026-10-17-08-59-13"
"C:/Users/junbo/.workbuddy/binaries/python/envs/default/Scripts/python.exe" \
  "outputs/花房代码/tools/soil_watch.py" --port COM6
```

它会实时打印 `raw=` 并自动判定：

| 读数表现 | 含义 | 怎么办 |
|---|---|---|
| **raw ≈ 0–200，纹丝不动** | ❌ OUT 没接上 / 模块没供电 / 没共地 | 查 `5V→3V3` 和 `GND→GND` 两根线；查 OUT 是不是插到 D34 |
| **raw > 4000，纹丝不动** | ❌ OUT 悬空或短路 | 查 5V 是不是漏接/接反了 |
| **raw 在几百～三千多，且会动** | ✅ 接线通了 | 进步骤 4 做干湿标定 |

> 💡 **当前实测（未接传感器）**：raw 稳定在 **95–105**（约 0.08V），是 GPIO34 悬空的特征值。
> 接上传感器后这个数字**必须明显变化** —— 这就是判断"接上了"最直接的标准。
> 小技巧：手指捏住探针（人身体近似接地）读数会往上跳，说明 OUT 通了。

---

## 步骤 2：烧录标定固件（不是主程序！）

**这一步烧的是专用标定固件**，不是 `GreenHouse_v1.ino`。原因：主程序 5 秒打一次、串口格式混杂，标定要连续采样并统计，肉眼看串口不可靠。

```bash
cd "D:/Documents/workbuddydocument/2026-10-17-08-59-13"

# 1) 编译
"outputs/.tools/arduino-cli/arduino-cli.exe" compile \
  --fqbn esp32:esp32:esp32 \
  --build-path "C:/Users/junbo/AppData/Local/Temp/calibbuild" \
  "outputs/花房代码/tools/W1_SoilCalib"

# 2) 烧录（把 COM6 换成你 board list 里看到的端口号）
"outputs/.tools/arduino-cli/arduino-cli.exe" upload \
  -p COM6 --fqbn esp32:esp32:esp32 \
  --input-dir "C:/Users/junbo/AppData/Local/Temp/calibbuild" \
  "outputs/花房代码/tools/W1_SoilCalib"
```

**如果报 `not responding / not in sync`**：
按住板上的 **BOOT** 键 → 重新跑上传命令 → 看到 `Connecting....` 后松开 BOOT。

**烧完先别拔线**，下一步直接看串口。

---

## 步骤 3：看串口，确认板子活着

**方式 A —— 用 Arduino IDE**（最直观）：
1. 打开 Arduino IDE → 选板子 `ESP32 Dev Module` → 选端口 `COM6`
2. 工具 → 串口监视器 → 波特率 **115200**（这步最容易漏，115200 不是默认的 9600）
3. 复位板子，应该看到：

```
#SOILCALIB,1
#READY,soil_pin=34,interval_ms=100,avg_n=10
#CMD,R=reset,M=mark,P=ping
RAW,1523,3198
RAW,1624,3201
...
```

**看到 `RAW,` 开头的行 = 板子活着、接线通、ADC 在读。** 数值在 3000 上下 = 探针在空气中，正常（电容式传感器空气里读数偏高）。

**方式 B —— 用现成脚本**（会自动统计，不用自己看）：

```bash
cd "D:/Documents/workbuddydocument/2026-10-17-08-59-13/outputs/花房代码/tools"
"C:/Users/junbo/.workbuddy/binaries/python/envs/default/Scripts/python.exe" soil_calibrate.py --list-ports
```

看到端口列出来就说明脚本和板子沟通正常。

---

## 步骤 4：实测标定（5 分钟，W1-4.1 验收物）

准备两样东西：
- **一杯水**（探针能完全浸没到根部）
- **一个干杯底**（或直接把手拿起来，探针悬空）

### 4.1 干态

```bash
"C:/Users/junbo/.workbuddy/binaries/python/envs/default/Scripts/python.exe" soil_calibrate.py --write
```

脚本会提示「把探针完全离开土/水面」→ **按回车** → 自动采 3 秒。

### 4.2 湿态

脚本接着提示「把探针完全插进一杯水里」→ **按回车** → 自动采 3 秒。

### 4.3 看结果

脚本会打印一份记录，长这样：

```
  【干态】探针离开土/水
    样本 30 个（剔除后 30）  中位数 3198  均值 3199.2  范围 3175~3220  标准差 8.4
  【湿态】探针完全浸入水中
    样本 30 个（剔除后 30）  中位数 1245  均值 1247.8  范围 1210~1290  标准差 11.2
  → 干湿差 = 1953
  → 判定：正常
```

**把这段输出截图**，命名 `W1-4.1-标定记录.png`，放 `素材/`。

### 4.4 自动回写

加了 `--write` 且数据通过自检时，脚本会**直接改主程序**：

```
  已回写 GreenHouse_v1.ino：SOIL_RAW_DRY=3198, SOIL_RAW_WET=1245
```

**回写后必须重新编译烧录主程序**，否则跑的还是旧值：

```bash
cd "D:/Documents/workbuddydocument/2026-10-17-08-59-13"
"outputs/.tools/arduino-cli/arduino-cli.exe" compile --fqbn esp32:esp32:esp32 \
  --build-path "C:/Users/junbo/AppData/Local/Temp/ghbuild" \
  "outputs/花房代码/GreenHouse_v1"
"outputs/.tools/arduino-cli/arduino-cli.exe" upload -p COM6 --fqbn esp32:esp32:esp32 \
  --input-dir "C:/Users/junbo/AppData/Local/Temp/ghbuild" \
  "outputs/花房代码/GreenHouse_v1"
```

烧主程序时，**土壤传感器可以保持接着**——主程序 v1.6 全开关为 0 的状态就是纯读传感器，正好用来看标定后的读数是否合理（空气里应该显示 0% 附近）。

---

## 步骤 5：主程序串口验证（可选但建议）

主程序跑起来后串口会打：

```
===== 智能花房养护站 v1.6 启动 =====
功能开关: DHT=0 OLED=0 WATER=0 LEVEL=0 WIFI=0 MQTT=0 WEB=0
标定: dry=3198 wet=1245 缺水阈值=35%
[数据] 土壤raw=3198 湿度=0% | 光照raw=0
```

- **没有 `!! [自检失败]`** = 标定值合法
- **土壤 raw 接近 3198 且湿度显示 0%** = 探针在空气中，标定生效
- 把探针插进水里，再看这行：湿度应该跳到 90% 以上

⚠️ 光敏传感器没接，`光照raw=0` 是正常的，别以为读错了。

---

## 常见问题速查

| 现象 | 原因 | 怎么办 |
|---|---|---|
| `board list` 空 | 数据线只供电不传数据 | 换一根线（最常见） |
| `board list` 有端口但显示 Unknown | 驱动没装好 | 设备管理器卸载 CH340 → 拔插 → 重装 CH341SER.EXE |
| 串口没输出 / 乱码 | 波特率不是 115200 | 串口监视器改 115200 |
| `not responding / not in sync` | ESP32 没进下载模式 | 按住 BOOT，出现 Connecting 后松开 |
| 串口一直重连（每秒刷一次） | 波特率错位 | 同上，改 115200 |
| raw 恒为 0 | AOUT 没接到 GPIO34 / 没共地 | 重查接线，量一下 AOUT 对 GND 有没有电压 |
| raw 恒为 4095 | AOUT 悬空 / VCC 没接 / 接了 5V | 重查 VCC 是否在 3V3 |
| 干湿差 < 800 | 探针根部没全湿，或模块坏了 | 换一杯水重测；仍不行换传感器 |
| 湿度一直显示 0% | 干点填得比湿点小（填反了） | 脚本会自己拦；真发生了改 `SOIL_RAW_DRY` / `SOIL_RAW_WET` 顺序 |

---

## 本次新增文件

| 文件 | 用途 |
|---|---|
| `outputs/花房代码/tools/W1_SoilCalib/W1_SoilCalib.ino` | 标定专用固件，连续输出 `RAW,<millis>,<raw>` CSV（已编译验证：268,909 B / 20%） |
| `outputs/花房代码/tools/soil_calibrate.py` | PC 端标定助手：扫端口 → 两阶段采样 → 剔异常 → 算中位数 → 回写主程序 |
| `outputs/花房代码/tools/test_soil_calibrate.py` | 离线自测 16 项（剔异常/统计/回写/阈值判定），不依赖真实硬件 |
