huankechong/smart-greenhouse/docs/W1无烙铁接线方案_2026-10-20.md

# W1 无烙铁接线方案（2026-10-20 实验室未借到焊接工具）· **已降级为备选**

> ⚠️ **2026-10-21 01:19 定案：本文档降级为「备选方案」。**
> 领导明确**放弃免焊路线**（公头直插 / 硬芯线），改回**焊接排针** —— 因为**买土壤传感器时随附了 1×3P 排针**，只缺烙铁、不缺排针。
> **当前主流程见 `docs/土壤传感器焊接操作卡_2026-10-21.md`。**
> 本文档保留，用于**烙铁一直借不到**时的应急：公头直插（0 元）或硬芯线 + 面包板（0 元）两条路。
> 「买已焊排针模块 5–8 元」一条**已作废** —— 排针已随传感器赠送。

> 背景：ESP32 + 土壤传感器已到货，但**实验室的电烙铁、焊锡丝、万用表都没借到**，传感器排针无法焊。
> 本文档给出**四条不依赖烙铁的路径**，按"今晚就能标定"的优先级排列。
> 传感器实测形态：**只有 3 个空焊孔，没有针**；手头只有裸传感器 + ESP32，杜邦线/面包板可能从同学处借到。
> **丝印已由到货照片确认：`GND` / `5V` / `OUT`，接线表见下方方案 A 步骤 1。**
> **📌 后续更正（10/21）**：杜邦线/面包板**学校有可借**（套件第 8/9/10 项），不用买。

---

## 结论先行

**焊接不是当前的前置条件 —— 而且全项目只有土壤传感器这一个器件需要焊。**
> ⏰ **2026-10-24 状态更新**：继电器 **10/26（周一）** 可借到；**电烙铁能否借到仍不确定**。若借不到，本文方案 B（WAGO 免焊，端子已到货 4 只）仍然可行。

已逐项核对《花房接线规划表》线序表：DHT11、OLED、继电器、双色 LED、光敏全部是带排针的模块，走 A 型母对母杜邦线直插；浮球开关是干接点接螺丝端子。**借不借到烙铁，都不阻塞 W1 和 W2。**

标定只需要让 AOUT 的模拟电压进到 GPIO34，这一步有多种免焊办法：

| 方案 | 需要什么 | 现在能成吗 | 精度 |
|---|---|---|---|
| **A. 杜邦线公头直插** | 杜邦线（母对公或公对公） | ✅ 只要借到线就能成 | 够用，标定精度无影响 |
| **B. WAGO 221 快接** | 已自购（10/19 到货） | ✅ 若已到 | 略高（接触电阻更小） |
| **C. 单排针 + 免焊压接** | 单排针 1×3P（几毛钱） | ⚠️ 明天到货 | 最好 |
| **D. 等实验室借烙铁** | 借到工具 | ❌ 时间不可控，**但不阻塞** | — |

**推荐 A 今晚做标定 → C 作为正式方案 → D 什么时候借到什么时候补，不急。**

关键原理：电容式土壤模块 PCB 上那三个孔，孔径约 1.0–1.2mm；杜邦线**公头的方针是 0.64mm 方形**（对角约 0.9mm），**能直接插进这两个孔**。接触靠孔壁夹紧，标定用的模拟量精度完全够。

---

## 方案 A：杜邦线公头直插（今晚首选）

### 需要的线

要**「公对母」杜邦线**（一端公头、一端母头）。母头直接插 ESP32 排针，公头插传感器焊孔。

> 如果借到的只有「母对母」：剪断一端，把内部**金属插针（0.64mm 方针）**从塑料壳里拉出来半截，露出约 5mm 针杆，剥线压回。母对母线里的插针和公头针杆是同一规格。

### 步骤

1. **丝印已确认（2026-10-20 到货照片）** —— 不用再猜了，三个孔从左到右是：

   | 孔位（背面丝印面，自左向右） | 接到 ESP32 |
   |---|---|
   | **GND** | 任意 GND |
   | **5V** | **3V3** ⚠️ 见下方说明 |
   | **OUT** | **GPIO34** |

   ⚠️ **两个必须注意的点**：

   - **丝印写 `5V`，但要接 `3V3`。** 这模块 v2.0 内置稳压、工作范围 3.3–5.5V；而 ESP32 的 ADC 不容忍 5V。v2.0 在 3.3–5.5V 全范围内输出恒为 0–3.0V，所以**接 3V3 不会让输出变小**，正好落在 ESP32 ADC 满量程内。
   - **正反两面的顺序是相反的。** 照片里元件面（正面）从左到右读是 `OUT / 5V / GND`，背面丝印面是 `GND / 5V / OUT` —— 同一排三个孔，**翻过来看顺序就反**。**以你手上那一面的丝印为准，别照着另一面的顺序插。**

   > 顺带确认：板子尺寸 98 × 23mm、PCB 厚约 1.6mm，与 01b 支架的建模参数（板宽 23、板厚 1.5–1.6）一致，**3D 支架不用改**。

2. **剪三条公对母线**，长度 15–20cm（够从传感器到 ESP32 排针）。
3. **每条线的公头拔掉塑料壳**：
   - 用尖嘴钳夹住针杆根部，**往外拽塑料壳**（不是拽针 —— 拽针会从另一端脱出）。
   - 露出约 **5–6mm** 针杆。露出太长插不进 PCB 的孔，太短捏不住。
4. **插进焊孔**：对丝印，一个孔一根线，**插到底**（PCB 背面能看到针尖顶出来）。
5. **另一端母头插 ESP32 排针**：
   - `5V` → **3V3**
   - `GND` → 任意 **GND**
   - `AOUT` → **GPIO34**
6. **拍照存档** → 跑 `docs/W1到货点火与标定操作指南_2026-10-20.md` 的步骤 3–4。

### 三个坑

| 坑 | 后果 | 怎么避 |
|---|---|---|
| 丝印看错，把 VCC 和 AOUT 接反 | 传感器可能烧 | 一次只插一根，每插一根拍一张照 |
| 针杆露出太长 | 插不进孔，歪了短路 | 露出 5–6mm |
| **忘了共地** | 读数乱跳或恒 0 | GND 必须接 |
| VCC 接 5V（VIN 脚） | 超出 ADC 量程 | 认准丝印 `3V3`，不是 `5V/VIN` |

---

## 方案 B：WAGO 221 快接端子（已自购）

10/19 下单的 WAGO 221 如果到了，用它比裸插更稳：

1. 打开杠杆 → 插入剥好的线头（裸线约 6–8mm，不能有绝缘皮）
2. 压回杠杆 → 听到"咔"一声
3. 好处：接触电阻比杜邦线公头小，模拟读数更稳；且**免焊、可反复插拔**

> 缺点：占地方，标定后进 3D 底盘要重新规划走线。所以只建议标定阶段用，正式装配走方案 C。

---

## 方案 C：单排针 + 压接（正式方案，1–3 元）

**这是最终应该采用的做法**，因为后面 DHT11、OLED、继电器、浮球开关都要接，总不能每次靠杜邦线公头怼 PCB。

| 买什么 | 规格 | 价格 |
|---|---|---|
| 单排针 | 2.54mm 间距，**1×3P** 排针 ×3 | 几毛钱 |
| 杜邦线 | 母对母 20cm（已有/借） | — |
| 或者直接买 | **2.54mm 预焊排针的土壤模块** | 5–8 元 |

**最快的一条路**：淘宝搜「电容式土壤湿度传感器 v2.0 **已焊排针**」，同款直接带针版 5–8 元。你现在这块是裸板，备用那块大概率也是裸板 —— 换成带针版，后面所有工序都省了。**这一条我建议直接照做。**

---

## 方案 E：一次性下单解决物料（**备用兜底，优先级已降低**）

> ⚠️ **2026-10-20 23:49 更新：学校有杜邦线和面包板，可借 → 本方案降为兜底，先不花钱。**
> 只在"借线流程比快递慢"时才启用（下表只列了真正还需要买的东西）。

| 还需要买什么 | 搜索词 | 数量 | 价格 | 什么时候真需要 |
|---|---|---|---|---|
| **电容式土壤模块（已焊排针）** | 「电容式土壤湿度传感器 v2.0 已焊排针」 | 1 | 5–8 元 | 借到的线是母对母、且 WAGO 221 操作不顺手时 |
| 单排针 1×3P（备用） | 「2.54mm 单排针 1×3P 直插」 | 几片 | <1 元 | 模块报废要换时 |

**杜邦线和面包板两项已从清单里划掉（学校可借）。**

**判断标准：借线到手 vs 模块到手，谁先到用谁。** 借线要跑教务流程可能耗几天，5–8 元的模块快递反而快 —— 这时候花这 8 块是**换时间**，不是浪费。

---

## 方案 D：等实验室借烙铁

申请单 v3 里已经列了电烙铁 + 焊锡丝（借用第 7 项）。等借到后：

1. 烙铁 300–350℃，先给烙铁头上一层薄锡（活化）
2. 排针**插正**（用镊子或面包板固定，防受热翘起/掉进板里）
3. 先焊 GND（最容易、最不重要）→ 再焊 AOUT → 最后焊 VCC
4. 每个焊点停留 **2–3 秒**，焊锡铺开成小锥形即可，**不要堆成球**
5. 焊完用**万用表通断档**量三个孔：孔与对应标签丝印之间应"响"

⚠️ 焊接注意：烙铁不能碰传感器芯片（电解电容 / 电位器怕高温）；离位断电；用毕清理焊渣。

---

## 不管走哪条方案，接线后先跑这三项验证

```bash
cd "D:/Documents/workbuddydocument/2026-10-17-08-59-13"

# 1) 板子认出来了吗
"outputs/.tools/arduino-cli/arduino-cli.exe" board list

# 2) 烧标定固件（注意：不是主程序）
"outputs/.tools/arduino-cli/arduino-cli.exe" upload -p COMx --fqbn esp32:esp32:esp32 \
  --input-dir "C:/Users/junbo/AppData/Local/Temp/calibbuild" \
  "outputs/花房代码/tools/W1_SoilCalib"

# 3) 自动标定 + 回写主程序
cd outputs/花房代码/tools
"C:/Users/junbo/.workbuddy/binaries/python/envs/default/Scripts/python.exe" soil_calibrate.py --write
```

**读数自判**（不对就是接线错，别硬往下走）：

| 现象 | 含义 |
|---|---|
| raw 恒为 **0** | OUT 没接到 GPIO34 / 没共地 |
| raw 恒为 **4095** | OUT 悬空 / 5V 没接 |
| 干湿都 3000 左右不动 | 接了 OUT 但没接 5V |
| 干 3000+ / 湿 1000–1500 且稳定 | ✅ 正常，去跑标定 |

---

## 对 30 天计划的影响（据实修正）

实验室焊接工具没借到，但**全项目只有土壤传感器这一个器件需要焊**。

依据《花房接线规划表》第「每种元件的具体线序」表逐项核对：

| 器件 | 编号 | 接线方式 | 需要焊？ |
|---|---|---|---|
| 土壤湿度传感器 | 自购 | A × 3（30cm） | **需要**（裸板三个空焊孔） |
| DHT11 温湿度 | 借·41 | A × 3 | 否（模块自带排针） |
| OLED | 借·25 | A × 4 | 否 |
| 继电器模块 | 借·16 | A × 3 | 否 |
| 双色 LED | 借·13 | A × 3 | 否 |
| 光敏电阻 | 借·32 | A × 3 | 否 |
| 浮球开关（P52） | 自购 | 22AWG 端子线 + 1kΩ | 否（干接点非金属，拧螺丝端子） |

> 修正记录：本文件初版曾写"W2 的继电器模块也可能需要焊"，属于未经核实的推测。**已核对接线规划表，继电器是带排针的模块，走 A 型母对母杜邦线直插，不需要焊接。**整个 W1–W2 需要焊接的只有土壤传感器一块。

**结论：借不借到烙铁，都不阻塞 W1 和 W2。** 焊接只影响土壤传感器的接法，走方案 A（公头直插）或 C（换带针模块）都不需要烙铁。

---

## ✅ 物料状态更新（2026-10-21 01:00）：**板子已识别，固件已烧录成功**

**卡点已破！** 领导把 ESP32 插上电脑后：

| 项 | 状态 | 实测证据 |
|---|---|---|
| **板子被电脑识别** | ✅ **通过** | `board list` → `COM6`；设备管理器 → `USB-SERIAL CH340 (COM6)`，状态 OK，VID=1A86 PID=7523 |
| **标定固件烧录** | ✅ **通过** | `W1_SoilCalib` 编译 + 烧录完成，269,280 B 写入，`Hard resetting via RTS pin` |
| **固件在跑** | ✅ **通过** | 串口稳定输出 `RAW,<millis>,<raw>` CSV，10Hz |
| 杜邦线 | ✅ 学校有，可借 | 还没接到传感器上 |
| 面包板 | ✅ 学校有，可借 | 还没用到 |
| 电烙铁 | ➖ 不需要了 | 走免焊方案 |
| **传感器接线** | ⏳ **当前唯一待办** | raw 稳定在 **95–105**（≈0.08V）= GPIO34 悬空特征值 → 传感器还没接 |

> 🎉 **之前"枚举不到设备"的结论作废** —— 驱动一直是好的，纯粹是板子当时没插。数据线也是好的（能传数据）。
>
> **现在唯一要做的就是把三根线接上**，然后：
> 1. 跑 `soil_watch.py` 看数字**动起来**（接线自检）
> 2. 跑 `soil_calibrate.py --write` 做干湿标定、自动回写常量
> 3. 烧回主程序

### 📌 从实拍照片确认的板型与丝印（30 脚 ESP32-DevKitC）

实物是 **ESP32-WROOM-32 30 脚板**（不是 38 脚）。丝印读法（**背面视角，USB 口朝下**）：

| 排 | 丝印（从上往下） |
|---|---|
| **左排** | EN · VP · VN · **D34** · D35 · D32 · D33 · D25 · D26 · D27 · D14 · D12 · D13 · GND · VIN |
| **右排** | D23 · D22 · TX0 · RX0 · D21 · D19 · D18 · D5 · D17 · D16 · D4 · D2 · D15 · GND · **3V3** |

**接线时按这个位置找：**

| 要接的 | 在板子哪 | 提醒 |
|---|---|---|
| **3V3** | 右排**最下面**一个 | 传感器 `5V` 脚接这里（丝印写 5V，但接 3V3！） |
| **GND** | 右排倒数第二个 / 左排倒数第二个 | 两个都行，任选一个 |
| **GPIO34** | 左排**从上数第 4 个**（丝印 `D34`，在 `VN` 下面） | 传感器 `OUT` 脚接这里 |

> 💡 **GPIO34 是左排第 4 个**，最容易数错 —— 它上面是 `VN`，`VN` 上面是 `VP`，最上面才是 `EN`。
> 传感器丝印是 `GND` / `5V` / `OUT`（**不是** `VCC/GND/AOUT`），且**正反两面顺序相反**。

### 🛠️ 新增工具：`soil_watch.py`（接线自检 + 实时看板）

```bash
cd "D:/Documents/workbuddydocument/2026-10-17-08-59-13"
"C:/Users/junbo/.workbuddy/binaries/python/envs/default/Scripts/python.exe" \
  "outputs/花房代码/tools/soil_watch.py" --port COM6
```

实时打印 `raw=` 并自动判定接线是否正确：

| 读数表现 | 含义 | 怎么办 |
|---|---|---|
| **raw ≈ 0–200，纹丝不动** | ❌ OUT 没接 / 模块没供电 / 没共地 | 查 `5V→3V3`、`GND→GND`；查 OUT 是不是插到 D34 |
| **raw > 4000，纹丝不动** | ❌ OUT 悬空或短路 | 查 5V 是不是漏接/接反 |
| **raw 在几百～三千多，且会动** | ✅ 接线通了 | 进步骤 4 做干湿标定 |

> 💡 **判断"接上了"最直接的标准**：接上传感器后这个数字**必须明显变化**。
> 小技巧：**手指捏住探针**读数会往上跳（人体近似接地），说明 OUT 通了。

---

## 📦 物料状态（2026-10-20 23:50 记录）

**学校有杜邦线 + 面包板，可借** —— 不用花钱买了。

| 缺什么 | 状态 | 影响 |
|---|---|---|
| 板子被电脑识别 | ✅ **已解决（10/21 01:00）** | COM6，CH340 驱动全通 |
| 杜邦线 | ✅ 学校有，可借 | 接线不再是问题 |
| 面包板 | ✅ 学校有，可借 | 无处搭接不再是问题 |
| 电烙铁 / 焊锡 | ➖ 不需要了 | 走免焊方案 |
| ~~已焊排针传感器模块~~ | ➖ 不用买了 | 有线就不必换模块 |

### 借线时只要注意一件事：要公头

土壤模块 PCB 上是**三个裸焊孔**（孔径约 1.0–1.2mm），没有针。所以：

| 借到的线 | 能不能直接用 | 说明 |
|---|---|---|
| **公对母** | ✅ **最优，直接用** | 公头方针 0.64mm（对角约 0.9mm）能直插焊孔，靠孔壁夹紧 |
| 母对母 | ⚠️ 需要处理 | 母座是 2.54mm 方形孔，塞不进 1mm 焊孔 → 走方案 B（WAGO 221 快接） |
| 公对公 | ✅ 可以 | 剪掉一端的公头当单公头用 |

> 💡 **借线时优先挑公对母**。公对母一根线搞定一根信号：公头插模块焊孔，母头直接插 ESP32 排针，中间不需要任何转接。

### 如果只借到母对母怎么办

你 10/19 已经自购了 **WAGO 221 快接端子（方案 B）** —— 这时它就派上用场了：

1. 母对母线的一端插进 WAGO 221 的孔（母座自带金属夹片，剪断也能夹）
2. 另一端从 WAGO 出来的是**裸线**，直接插模块焊孔
3. 三根线各用一个 221 端子

**注意**：WAGO 里只有**一根裸线**时，模块那一侧的 1.0–1.2mm 焊孔要塞裸线需要用小螺丝刀把裸线压紧，操作上比公头直插麻烦一点，但完全免焊。

### 🚨 时间红线：已解除（2026-10-21 01:00 更新）

原红线是按"物料 10/26 前到货"算的，随后按"板子能否被识别"算。**现两者都已解决**：

| 原卡点 | 现状 |
|---|---|
| 物料 10/26 前到货 | ✅ **作废** —— 杜邦线/面包板学校可借 |
| 板子被电脑识别 | ✅ **已解决** —— COM6，CH340 驱动全通，固件已烧录并在跑 |

**当前唯一待办：借线 + 接上传感器**（raw 95–105 = GPIO34 悬空）。

| 情况 | 能否标定 | 对项目的影响 |
|---|---|---|
| **10/21 借到线并接好** | ✅ 能 | W1 收口（10/23 周五）前搞定，最理想 |
| 10/22–10/24 借到 | ✅ 仍能 | 延后 1–2 天，**不影响 W2（10/25 起）** |

> 结论：**软件侧零欠账，工具链全部就绪。** 剩下的纯粹是"借线、接线、泡水"的手工活。

### 🔧 板子识别三路排查（✅ 已解决，存档备查）

**第 1 路：换线（最可能，10 秒）**
- 必须用**能传数据**的 USB 线。手机充电线 / 很多 USB 线只有电源没有数据芯 → 电脑看到"unknown device"或干脆什么都不出现。
- 判别法：拿这根线插手机，能传照片的就是数据线。
- 手头有第二根线就换一根试。

**第 2 路：换口（5 秒）**
- 拔掉插笔记本，插**机箱后面板**的口（直连主板，不走 hub）。
- 别插扩展坞 / USB hub / 带充电口的拓展坞。

**第 3 路：查设备管理器（30 秒，判定性最强）**
1. 插着板子，按 `Win + X` → 「设备管理器」
2. 展开「端口 (COM 和 LPT)」
3. 看有没有 `USB-SERIAL CH340 (COMx)`

| 看到什么 | 说明 | 怎么办 |
|---|---|---|
| 有 `USB-SERIAL CH340 (COMx)` | 驱动全通，**板子是好的** | 记下 COM 号，往下走 |
| 有 CH340 但**带黄色感叹号** | 驱动冲突 | 右键 →「卸载设备」→ 拔插板子 → Windows 自动重装 |
| 「端口」里**根本没有 CH340**，但「其他设备」里有 `未知设备` | 数据线问题 or 驱动没绑上 | 换线（第 1 路）后再看；仍无 → 装 `CH341SER.EXE` |
| **完全没有任何新设备出现** | 板子或线根本没通电/没进系统 | 换线 + 换口（第 1+2 路）；还不行 → 板子坏了 |

> 💡 **快速判定法**：设备管理器里插拔板子时，看「其他设备」或「端口」下有没有**新条目闪现**。有闪现 = 硬件和线都通，是驱动绑定问题；**完全没反应 = 线或板子的物理问题**。

### 板子识别后，标定三步走

一旦 `board list` 出现 COM 号，剩下全是软件（都已就绪）：

1. 烧标定固件 → `W1_SoilCalib`（已编译 PASS，268,909 B）
2. 接线：模块 `5V→3V3`、`GND→GND`、`OUT→GPIO34`
3. 跑 `soil_calibrate.py --write` → 自动回写 `SOIL_RAW_DRY/WET`

### ⛔ 在实测标定完成前，`EN_WATER` 必须保持 0

主程序当前 `SOIL_RAW_DRY = 3200` / `SOIL_RAW_WET = 1300` 是**按通用资料估的值，没在本模块上实测**。跳过标定直接开浇水开关有两种失败模式：

| 实际情况 | 未标定的后果 | 严重度 |
|---|---|---|
| 实际湿态 ≈ 1500（估 1300 偏低） | `map(1500,1300,3200,100,0)` ≈ 91% → **永远不判缺水 → 花一直渴着** | 静默失效，很难发现 |
| 实际湿态 ≈ 800 / 干态 ≈ 2800 | 干态算成 21% → **一直判缺水 → 反复浇水** | **危险**：水箱抽空、盆泡烂，且无任何报警 |

第二种尤其麻烦 —— 溢出会触发连浇 6 轮 + 冷却 10 分钟的保护，但保护是"停手"，不是"不浇"，盆照样会被泡坏。

**硬规矩：标定完成、两个常量填成实测值之前，`EN_WATER` 一律保持 0。** 软件上"不浇水"永远比"浇错水"安全 —— 缺水症状一眼看得出来（湿度%一直很低），浇水过量要等叶子烂了才发现。

> 标定完成后 `soil_calibrate.py --write` 会自动回写这两个常量，回填完再考虑开 `EN_WATER=1`。

### 恢复执行的条件（✅ 板子已通，只剩借线 + 接线）

**主路（推荐）**：借到**公对母**杜邦线 → 走方案 A，接上当天标定
**备路**：借到母对母线 → 配你已买的 WAGO 221（方案 B），同样免焊
**兜底（成本最低）**：下单"已焊排针"传感器模块（5–8 元）→ 到货即插即用，零工具

> 💡 兜底方案现在**优先级可以降了** —— 能借到线就不必花这个钱。但如果借线要等好几天的教务流程，而 5–8 元的模块能立刻寄到，那反而更快。**按"哪个先到手"选，不是按"哪个更便宜"选。**

### ✅ 标定执行三步（板子已就绪，照着走）

```bash
cd "D:/Documents/workbuddydocument/2026-10-17-08-59-13"
PY="C:/Users/junbo/.workbuddy/binaries/python/envs/default/Scripts/python.exe"

# 第 1 步：接线自检 —— 确认数字动起来了
"$PY" "outputs/花房代码/tools/soil_watch.py" --port COM6

# 第 2 步：干湿标定（会自动回写主程序常量）
"$PY" "outputs/花房代码/tools/soil_calibrate.py" --port COM6 --write

# 第 3 步：烧回主程序
"outputs/.tools/arduino-cli/arduino-cli.exe" compile --upload -p COM6 \
  --fqbn esp32:esp32:esp32 \
  --build-path "C:/Users/junbo/AppData/Local/Temp/ghbuild8" \
  "outputs/花房代码/GreenHouse_v1"
```

> ⚠️ **第 2 步跑完先看报告**：如果提示"干湿差 < 800"或"方向填反"，脚本会**拒写**并给排查提示 ——
> 那说明接线有问题（多半是 OUT 没接到 D34，或模块没供电），**不要手动改常量硬填**。

### 不受影响的并行工作（随时可做）

| 工作 | 为什么不受阻 |
|---|---|
| **3D 打印开打**（9 件 / 约 19h，02 泵座已作废） | 只需 STL + 实验室打印机，与接线无关。**最迟 11/5 交首版，10/27 前不打就压缩返工窗口** |
| 打第一个 M3×6 连接块验 φ2.8 咬合 | 一把螺丝刀 + 一个件，提前暴露尺寸问题 |
| 准备 `config.h` 三处真值 | 巴法云 UID 10/18 已注册，WiFi 名密码自己知道 |
| 背巴法云 MQTT / GPIO34 ADC1 特性 | 答辩要讲的原理部分 |
| 小花盆 + 绿植（W2 前买） | 楼下超市或网购 |

> ⚠️ **优先级提示**：3D 打印的 11/5 死线比标定更硬——标定最晚 W2 前做完即可，而打印队列一旦排满就要等。**打印窗口比等线更硬 —— 先排机时，线迟一点不影响。**

**唯一仍建议借烙铁的理由**：如果你将来要给传感器做**永久连接**（而不是插杜邦线），或者后面加装别的金属端子器件，才需要焊接。可以等 W2 结束、不着急。

---

## 需要你反馈的一件事

1. **借到的线是公对母还是母对母？** —— 决定走方案 A（直接插）还是方案 B（配 WAGO 221）。
   借线时**优先挑公对母**，能省掉所有转接。

> ✅ 丝印问题已解决：到货照片已确认背面丝印为 `GND` / `5V` / `OUT`（不是 `VCC/GND/AOUT`），**且正反两面顺序相反** —— 元件面读作 `OUT/5V/GND`。
