huankechong/smart-greenhouse/docs/土壤传感器焊接操作卡_2026-10-21.md

# 焊接接线操作卡 · 土壤传感器接 ESP32（2026-10-21 定稿）

> **决定（2026-10-21 01:17）**：采用**焊接排针**方案，等实验室电烙铁。
> 前提：**买土壤传感器时随附了排针**（1×3P 单排针），所以只需要借用烙铁 + 焊锡丝，不需要额外买排针。
> 免焊方案（公头直插 / 硬芯线）**已放弃**。

---

## 一、当前状态

| 项 | 状态 |
|---|---|
| ESP32 被电脑识别 | ✅ **COM6** / USB-SERIAL CH340，状态 OK |
| 标定固件烧录 | ✅ 269,280 B 写入，串口 10Hz 输出 `RAW,<millis>,<raw>` |
| 固件在跑（未接传感器） | ✅ raw 稳定 95–105（≈0.08V，GPIO34 悬空特征值） |
| **排针** | ✅ **买传感器时随附**（1×3P 单排针） |
| **电烙铁 + 焊锡丝** | ⏳ **等实验室借用** ← 唯一待办 |
| 杜邦线 | ✅ 学校有可借（套件第 9 项） |
| 面包板 | ✅ 学校有可借（套件第 8 项） |

**时间账**：W1 收口 10/23（周五，剩 2 天）· **3D 打印首版死线 11/5（剩 15 天）** · 答辩 11/16（剩 26 天）

> ⚠️ **3D 打印的 11/5 死线比标定更硬** —— 打印队列排满就得干等，标定最晚 W2 前做完即可。
> **等烙铁的这段时间，正好用来排打印队列。**

---

## 二、借用清单（去借这三样）

| # | 借什么 | 规格要求 | 备注 |
|---|---|---|---|
| 1 | **电烙铁（焊枪）** | 60W 以内，**烙铁头尖嘴** | 烙铁架、海绵能一起借最好 |
| 2 | **焊锡丝** | 0.8–1.0mm，含助焊剂 | 0.8mm 的更好控温 |
| 3 | 万用表（数字式） | 通断档 + 直流 0–20V 档 | **可选但强烈建议** —— 焊完验证通断 |

**借的时候说清楚用途**：给土壤湿度传感器焊三个排针，只焊三点点，20 分钟能完，用完即还。
（这也是申请单第 7 项的原始用途，**没有新增借品**，只是把"可选"改回"必需"。）

---

## 三、焊接步骤（照着做，10 分钟）

### Step 0 · 先把零件摆好

- 传感器 PCB **元件面朝上**放在桌上（有小芯片、电容那面）
- 排针对准三个焊孔插进去，用**手指按住**（下面步骤 2 会用面包板帮忙固定）

> ⚠️ **丝印方向**：背面丝印面读 `GND/5V/OUT`，元件面读 `OUT/5V/GND`。
> 排针插反了不会短路（插针是对称的三孔），但**接线时要按实际丝印对，别背下来的是一套、插的是另一套**。

### Step 1 · 烙铁活化（30 秒）

烙铁 300–350℃，在烙铁头上一层薄锡（锡先融在头上，形成亮亮的锡膜）。
这一步很关键 —— 不活化的话，烙铁头是干的，锡丝一碰就滚走不沾。

### Step 2 · 固定排针

**用面包板当治具**（比镊子稳，实验室有现成的）：
1. 面包板插上电源轨和中间行
2. 排针的三个针**插进面包板中间行**（三个针各占一排，插在同一行）
3. 传感器 PCB **架在排针上**，让三个焊孔对准三个针
4. 这样排针不会歪，焊的时候也不会翘

> 没有面包板就用镊子夹住排针。原则是**排针必须垂直、不能动**。

### Step 3 · 焊接顺序：GND → OUT → 5V

**为什么是这个顺序**：
- `GND` 最容易焊（面积大、散热好），**先拿下这个** —— 万一前面手抖焊废了，损失最小
- `OUT` 是信号，中间
- `5V` 最后 —— 万一前面出了问题，5V 还没连上，传感器不会因误接而损坏

**每个点的手法**：
1. 烙铁头**带一点锡**（别用干的烙铁去蹭）
2. 烙铁头斜着**碰到焊盘和排针的根部**（不是碰排针尖！）
3. 停留 **2–3 秒**，锡丝从另一只手喂进去
4. 看到锡**铺开成一个小锥形**就撤烙铁
5. **不要堆成球** —— 球状焊点接触电阻大且容易虚焊

### Step 4 · 冷却 + 检查

- 等焊点**自然冷却**（别吹，会产生裂纹）
- 三个焊点应该是**光亮的小锥形**，不是灰暗的球或一坨
- **有万用表就量一遍**：万用表调**通断档**，一只表笔固定在排针的 GND 针，另一只依次碰 OUT 针和 5V 针 → 应该**都响**（都是内部连通到 PCB 对应焊盘）
  - ⚠️ 顺序：**GND↔OUT 响、GND↔5V 响、OUT↔5V 不响**。如果 OUT 和 5V 也响，说明短路了，回头检查

### Step 5 · 接线（母对母线）

焊好排针后，传感器就有标准排针了 → 用**母对母**杜邦线接：

| 传感器排针 | → | ESP32 | 线 |
|---|---|---|---|
| **5V**（丝印） | → | **3V3** | 母对母 ×1 |
| **GND** | → | GND | 母对母 ×1 |
| **OUT** | → | **GPIO34** | 母对母 ×1 |

**ESP32 端位置**（背面视角，USB 口朝下）：

| 接哪根 | 板子哪个脚 | 数法 |
|---|---|---|
| **3V3** | 右排**最下面**一个 | 银色的 `3V3` 字样 |
| **GND** | 右排**倒数第二个** | 或左排倒数第二个，任选 |
| **GPIO34** | 左排**从上数第 4 个** | 丝印 `D34` |

> ⚠️ **GPIO34 数脚提示**：左排从上到下 `EN`(1) `VP`(2) `VN`(3) **`D34`(4)** `D35`(5) …
> 看到 `D34` 就停手，**别数到 `D35`**（那是留给光敏传感器的）。

> 💡 **套件第 9 项是「40 公对母杜邦线」** —— 正好是母对母那半边，**公头那半边用不上**（焊完排针就不需要插焊孔了）。
> 一包 40P 通常公母各半，借到后**翻一遍分清公母**，母头那半边用来接线。

### Step 6 · 自检（30 秒）

```bash
cd "D:/Documents/workbuddydocument/2026-10-17-08-59-13"
"C:/Users/junbo/.workbuddy/binaries/python/envs/default/Scripts/python.exe" \
  "outputs/花房代码/tools/soil_watch.py" --port COM6
```

| 看到 | 含义 | 怎么办 |
|---|---|---|
| raw **95–105 纹丝不动** | ❌ 没接上 | 三根线逐根查；先确认 OUT 真的插在 `D34` |
| raw **> 4000 纹丝不动** | ❌ 悬空/短路 | 查 5V 是不是接反或漏接；用万用表量焊点 |
| raw **几百～三千多，会动** | ✅ 通了 | 进步骤 7 |
| 手指捏探针读数上跳 | ✅ 更好 | OUT 通了，人体接地 |

### Step 7 · 干湿标定

```bash
PY="C:/Users/junbo/.workbuddy/binaries/python/envs/default/Scripts/python.exe"
"$PY" "outputs/花房代码/tools/soil_calibrate.py" --port COM6 --write
```

- 阶段 A「干」：探针完全离开土/水（拿在手里或插在干杯底）
- 阶段 B「湿」：探针**完全浸没**到标记线以上
- 脚本自动剔异常值取中位数 → **自动回写**主程序 `SOIL_RAW_DRY` / `SOIL_RAW_WET`

> ⚠️ 若提示"干湿差 < 800"或"方向反了"，脚本会**拒写**并给排查提示 —— 那是接线/焊接有问题，**不要手动硬填常量**。

### Step 8 · 烧回主程序

```bash
"outputs/.tools/arduino-cli/arduino-cli.exe" compile --upload -p COM6 \
  --fqbn esp32:esp32:esp32 \
  --build-path "C:/Users/junbo/AppData/Local/Temp/ghbuild8" \
  "outputs/花房代码/GreenHouse_v1"
```

---

## 四、三个必踩的坑

1. **别接 GPIO35（D35）** —— 那是留给光敏传感器的。两个都插也能跑，但光敏浮空会读乱跳的数，干扰判断土壤读数。

2. **一定要共地** —— 传感器 GND 必须和 ESP32 GND 连一起。只接 5V 和 OUT 不接地，数字会乱跳。

3. **丝印写 5V，接 3V3** —— 不是笔误。模块内置稳压（3.3–5.5V 均可工作），v2.0 输出恒为 0–3.0V，接 3V3 正好占满 ESP32 的 12 位 ADC 量程；接 5V 反而读数偏低、还可能超 ADC 上限。

---

## 五、⛔ 硬规矩（标定前必读）

主程序当前 `SOIL_RAW_DRY = 3200` / `SOIL_RAW_WET = 1300` 是**按通用资料估的值，没在本模块实测**。

| 估偏方向 | 后果 | 严重度 |
|---|---|---|
| 估**高** | 湿态算成 ~91% → 永远不判缺水 → **花一直渴着** | 静默失效，很难发现 |
| 估**低** | 干态算成 ~21% → 一直判缺水 → 反复浇水 | **危险**：水箱空、盆泡烂 |

**标定完成、两个常量回填实测值之前，`EN_WATER` 一律保持 0。**
软件上"不浇水"永远比"浇错水"安全 —— 缺水一眼看得出来，浇过量要等叶子烂了才发现。

---

## 六、完成后要留的素材

| 素材 | 命名 | 位置 |
|---|---|---|
| 焊接完成照 | `W1-3.1-焊接.jpg` | `素材/开发环境调试/` |
| 接线完成照 | `W1-3.2-接线.jpg` | `素材/开发环境调试/` |
| 标定输出 | `W1-4.1-标定记录.txt` | `素材/开发环境调试/` |

报告要图要表 —— 焊接过程照尤其有价值（答辩时讲"遇到裸板焊孔怎么解决"）。

---

## 七、备选：如果烙铁一直借不到

不用慌，**还有三条不需要烙铁的路**（详见 `docs/W1无烙铁接线方案_2026-10-20.md`）：

| 备选 | 说明 | 成本 |
|---|---|---|
| **公头直插** | 套件第 9 项的公对母线，公头直接插进焊孔 | 0 元 |
| **硬芯线 + 面包板** | 套件第 10 项面包板线，剥皮插焊孔 | 0 元 |
| ~~买已焊排针模块~~ | 排针已随传感器送，**此路作废** | — |

> 排针既然随传感器送了，「买已焊排针模块」的价值就下降了 —— 现在缺的只是**烙铁**，不是排针。
> 所以**优先等烙铁**（零成本），实在等不到再走公头直插。
