huankechong/smart-greenhouse/docs/操作手册/花房接线规划表.md

# 花房接线规划表（W1-3.1 到货接线用）

> 《Introduction to Project Work》Final Project · 智能花房养护站
> 配套文档：《花房4人分工方案》附录·任务底稿（原 30 天计划）· 接线完成后**先拍照存档**（报告素材 W1-?）
> 引脚丝印以实物为准，个别模块针脚序号可能有出入——插之前扫一眼模块板上的字。

---

## 一、总接线表

### 1. 电容式土壤湿度传感器（自购）

> **实物核对（2026-10-20 到货照片确认）**：丝印是 **`GND` / `5V` / `OUT`**（不是通用模块常见的 `VCC/GND/AOUT`）。
> 板子尺寸 **98 × 23mm**、PCB 厚约 **1.6mm**，与 01b 支架建模参数（板宽 23、板厚 1.5）一致。
> 丝印写 "5V" 是模块的设计供电上限，**v2.0 内置稳压、实际工作范围 3.3–5.5V**，本项目仍接 **3V3**（见下）。

| 模块针脚 | → | ESP32 引脚 | 备注 |
| --- | --- | --- | --- |
| **5V**（丝印） | → | **3V3** | ⚠️ 丝印写 5V，但**接 3V3**。见下方说明 |
| **GND** | → | GND | |
| **OUT**（丝印） | → | **GPIO34** | ADC1_CH6，模拟输入 |

**为什么丝印写 5V 却接 3V3**（两点，缺一不可）：

1. **模块侧没问题**：v2.0 内置稳压，工作电压 **3.3–5.5V**，3.3V 供电完全在规格内。
2. **ESP32 侧才有约束**：ESP32 的 ADC **不是 5V 容忍**。模块在 5V 供电时输出可达 3.3V 以上，会超出 ADC 量程；而 v2.0 在 3.3–5.5V 全范围内输出固定 **0–3.0V**，所以**接 3V3 输出也不会变小**，反而正好落在 ESP32 ADC 的满量程内（读数更充分利用 12 位分辨率）。

> ESP32 3.3V 供电下的典型值：**干 ≈ 2.9V（约 raw 3600）· 湿 ≈ 1.2V（约 raw 1500）**。
> 个体差异可达数百 mV，**必须实测标定**（W1-4.1），不要直接用文档值。

**方向性（重要，别弄反）**：电容式原理 —— 湿土介电常数高 → 电容大 → 振荡频率低 → **输出电压低**。所以是 **干=高 raw、湿=低 raw**，主程序 `map(raw, SOIL_RAW_WET, SOIL_RAW_DRY, 100, 0)` 方向正确。

### 2. 光敏电阻模块（借·32号）

| 模块针脚 | → | ESP32 引脚 | 备注 |
| --- | --- | --- | --- |
| VCC | → | 3V3 | |
| GND | → | GND | |
| AO | → | **GPIO35** | ADC1_CH7，读模拟量才有曲线数据 |
| DO | — | 不接 | 数字输出本项目不用 |

> 若实物只有 DO 没有 AO：改把 DO 接 GPIO35，代码读数字量（有光照/无光照两态）。

### 3. 温湿度传感器 DHT11（借·41号）

| 模块针脚 | → | ESP32 引脚 | 备注 |
| --- | --- | --- | --- |
| VCC | → | 3V3 | |
| GND | → | GND | |
| DATA | → | **GPIO33** | 单总线数字脚，需 DHT 库 |

> 套件模块板自带上拉电阻；若拿到的是 4 针裸件，DATA 与 VCC 间需加 4.7k–10k 上拉。

### 4. OLED 显示屏（借·25号）

| 模块针脚 | → | ESP32 引脚 | 备注 |
| --- | --- | --- | --- |
| VCC | → | 3V3 | |
| GND | → | GND | |
| SCL | → | **GPIO22** | I2C 时钟 |
| SDA | → | **GPIO21** | I2C 数据，地址通常 0x3C |

> 四针顺序各批次不同，**按模块丝印插，别按上下顺序抄**。

### 5. 继电器模块（借·16号）

| 模块针脚 | → | ESP32 引脚 | 备注 |
| --- | --- | --- | --- |
| VCC | → | VIN（5V） | 继电器线圈吃 5V 才吸得稳 |
| GND | → | GND | |
| IN | → | **GPIO26** | 控制信号；若动作相反查触发极性 |

继电器输出侧（螺丝端子）接水泵，见第四节。

### 6. 双色 LED 模块（借·13号，课上实验件）

| 模块针脚 | → | ESP32 引脚 | 备注 |
| --- | --- | --- | --- |
| GND | → | GND | |
| R（红） | → | **GPIO25** | 缺水=红，PWM 可做呼吸闪烁 |
| G（绿） | → | **GPIO27** | 正常=绿 |

> 红绿接反不是故障，代码里换过来即可。

### 7. 雨滴模块 —— ❌ 已取消（2026-10-19）

> **本节仅留档，不再接线**：雨滴探测模块不再向实验室借用。
> 缺水报警改用 **P52 浮球开关（干簧管）**，见第 8 节。

<details>
<summary>原接线方案（留档，点开查看）</summary>

| 模块针脚 | → | ESP32 引脚 | 备注 |
| --- | --- | --- | --- |
| VCC | → | 3V3 | |
| GND | → | GND | |
| AO | → | **GPIO32** | ADC1_CH4；水位检测输入（`EN_LEVEL=1` 时才读） |

> W1 不接，W2 联调完主线后再加，别让它挤占主线时间。
>
> ⚠️ **这个模块是电阻式的（板面裸露铜箔），隔着塑料瓶壁大概率测不到水位。** 接线前先实测：把模块贴在满水瓶外壁看 raw 有没有变化，没有就改用下面三种之一——
> ① 换 2 元浮球开关（最稳，输出高低电平，接 GPIO32 直接读）；
> ② 雨滴板浸在瓶内水里（能测，但长期电解腐蚀，只适合答辩演示）；
> ③ 把电极从瓶口伸进水里。
>
> 代码侧（**已作废**）：`EN_LEVEL=1` 后，raw 高于 `LEVEL_DRY_RAW`（默认 2500）判"没水"，会自动停泵并拒绝手动浇水。
> ⚠️ **该阈值参数已在 v1.4 删除**——浮球是干接点数字输入，改为 `LEVEL_WET_CLOSED` 极性宏 + 消抖，无模拟量阈值。本节代码描述仅作历史留档，实际接线与固件以第 8 节为准。

</details>

### 8. 浮球开关（自购·P52 干簧管式，2026-10-19 补）

**购物信息**：P52 型，M10 螺纹，常开型（有水闭合），0~110V 档，¥7.43/个 ×2。
水位探测点距桶底 **52mm**（1L 桶内高约 101mm，报警时桶内剩约 700ml）。

**这是什么**：密封干簧管，浮子里的磁铁随水面升降吸合/断开触点，输出一路无源干接点——
比电阻式雨滴板可靠：不电解、不受瓶壁影响、**断线默认判"没水"**（fail-safe，安全方向）。

**接线（就 2 根线 + 1 个电阻 + 1 个电容，不分正负）**：

| 浮球引线 | → | 接到 | 备注 |
| --- | --- | --- | --- |
| 线 1 | → | **GPIO32** | 数字输入，固件 `EN_LEVEL=1` 时读 |
| 线 2 | → | **GND 蓝轨** | 开关本体接在 GPIO32 与 GND 之间，两根线可互换 |

**1kΩ 上拉电阻（必须外接，不能用内部上拉凑合）**：

```
3V3 ──[1kΩ]──┬── GPIO32 ── 浮球开关 ── GND
             │
        [100nF 电容到 GND]
```

- **为什么是 1kΩ 不是 10kΩ**：干簧管触点需要 1–10mA"湿电流"击穿表面氧化膜，长期微电流下触点氧化后会时通时断。1kΩ @ 3.3V = 3.3mA，落在可靠区间（内部 45kΩ 只有 0.07mA，10kΩ 只有 0.33mA，都不够）。
- **功率选 1/4W 就够（算过）**：闭合时 U²/R = 3.3²/1000 = **10.9mW**，1/4W = 250mW，余量 23 倍；断开时 0mW。1/2W 也行但没必要；**1W/2W 不要买**——引脚 0.7–0.8mm 粗，插面包板会把簧片撑松，体积也大，无任何收益。
- **为什么常开型（电平账，和固件宏一一对应）**：
  - **有水** → 浮子上浮 → 触点**闭合** → GPIO32 被拉到 GND → 固件读 **LOW** → 判"水位正常"；
  - **没水** → 触点**断开** → GPIO32 被 1kΩ 上拉 → 固件读 **HIGH** → 判"水位低"；
  - **线断了/接触不良** → 同样是 HIGH → 也判"水位低" → 停泵保护。**坏掉的方向是停水而不是淹水**，这就是 fail-safe。
  - 固件宏 `LEVEL_WET_CLOSED=true` 对应本接法。万用表实测若方向相反（买成常闭型），改宏为 `false` 即可，接线不动。
- **并联 100nF 电容（GPIO32 ↔ GND）**：硬件滤抖，配合固件 100ms 节流 + 连续 3 次一致判定，双保险。

**安装（第 10 件替换盖配套，免打孔）**：

1. 浮球 M10 螺纹从替换盖中心 φ10.5 孔**从上往下**穿入；
2. 随货螺母在盖下方单侧锁紧（盖厚 4mm，螺纹咬合足够，**不需要额外垫片**——3D 盖已打印 0.8mm 环形凸台定位）；
3. 浮子自然下垂指向桶底，杆末端距桶底约 5–10mm 即可，别顶死。

**验收三步（万用表蜂鸣档，1 分钟）**：

| 步骤 | 操作 | 正常结果 |
| --- | --- | --- |
| ① | 浮子拉到下端（模拟没水） | 听不到蜂鸣（断开） |
| ② | 浮子推到上端（模拟有水） | 蜂鸣响（闭合） |
| ③ | ①② 反复 3 次都一致 | 极性确认，固件 `LEVEL_WET_CLOSED=true`（常开型）不动 |

> 若 ①② 结果相反（比如买成常闭型），改固件宏 `LEVEL_WET_CLOSED=false` 即可，接线不变。

**故障速查**：

| 现象 | 先查什么 |
| --- | --- |
| 有水/没水读数永远不变 | 1kΩ 上拉是不是真接在 3V3 和 GPIO32 之间；浮球另一根线是否真接到 GND |
| 读数随机跳 | 100nF 电容没插；水面晃动属正常，固件消抖会滤掉 |
| 串口一直报"水位低" | 浮球线断了/没插稳 → 上拉拉高按 fail-safe 判没水，这是**设计行为**；先查线再怀疑开关 |

---

## 二、三条红线（接错最先出事的就这三个）

1. **模拟线必须在 GPIO32–39（ADC1 组）**：土壤 34 / 光敏 35。ESP32 的 ADC2 组在 WiFi 开启后直接失效——这是和课上 UNO 最大的差异，也是最高频翻车点。（GPIO32 原规划给雨滴模块，现改配浮球开关数字输入，见第 8 节。）
2. **GPIO34 / 35 是"只进不出"引脚**：没有内部上拉、不能输出，只能接传感器输出；绝不能接 LED 或继电器。
3. **必须共地**：所有模块 GND 汇到面包板 GND 轨，再单点接到 ESP32 GND。共地断了会出各种灵异读数。

---

## 三、面包板布局（2026-11-12 定稿：单板直插）

- **ESP32 直插单块 BB400**（2026-11-12 实测：跨距正好 a↔i，脚刚好插 a1–a15 / i1–i15）：左排针 EN–VIN → **a1–a15**、右排针 3V3–D23 → **i1–i15**，**USB 朝 1 位端**，占位 1–15 位；信号/供电一律**针顶夹持**（母头套 PCB 上方露出针头 ~5mm）。**第二块板不接线，留桌面调试备板。**（原"两板拼大板"案头建议作废——实测单板够跨。）
- **模块全部直插**（位号即孔位）：浮球 RC 区 16–18（R1: a16↔a18，节点=位 18）→ 土壤 a19–21 → 光敏 a22–25 → DHT a26–29 → 30 备用。
- **信号侧另一头插同位号空孔**：D34→b21、D35→b25、D33→b27、D32→e18——直插后 OUT/AO/DATA 针已进 a 孔，杜邦母端套 ESP32 针顶、公端插同位号 b/e 列空孔（5 孔条内连通）。
- **模块取电 = 公对公跳线 ×6**（b19/b20/b23/b24/b26/b29 → 红/蓝轨）：直插后模块针插孔不露针，母头无处可套。
- **电源轨中点断成 2×25 两段**（25|26 断口）：红 25↔26、蓝 25↔26 各加一根**轨桥**（公对公），缺桥则第 2 段轨（DHT 区）全部无电。
- 电源轨：红轨走 3V3（i1 针顶引入）、蓝轨走 GND（i2 针顶引入，**单点共地**）；VIN 5V 只喂继电器一个。
- **水泵线走板外**，pigtail 免剪方案（见第四节），别在面包板上绕。

> 详细逐线接法以《花房接线图_整机总图.html》（v5.4b 单板直插版）为准。

---

## 三·补、每根线用什么线材（2026-10-19 补）

前面只说"A 接到 B"，没说"用哪种线"。这一节补上，接线当天照着剪/拿就行。

### 四种线，别混用

| 代号 | 线材 | 用在哪 | 数量 |
| --- | --- | --- | --- |
| **A** | 套件 40P **杜邦线**（母对母，约 20cm，线序彩色） | 两端都套针顶：ESP32 针顶 → OLED/LED/继电器针 | **6 根**（#20/21/24/25/27/29） |
| **A2** | 套件 40P **杜邦线**（**公对母**，约 20cm） | 母端套 ESP32 针顶、公端插孔：针顶 → 轨孔 / b·e 列孔（#1/2/7/10/13/19/22/23/26/28） | **10 根** |
| **B** | **面包板硬芯跳线**（公对公，套件配的那种） | 轨桥 ×2（#3/#4）、R1 取电（#14）、直插模块取电 ×6（#5/6/8/9/11/12） | **9 根** |
| **C** | **22AWG 硅胶线 / 端子线**（能过 1A，软、耐折） | ⚠️ **2026-11-11 起降为备用（两轮变更）**：先因「剪延长线」方案降备用（11-08），后剪线方案整体废弃、改 **pigtail 双线定稿**（见第四节 · 方案 A'，11-10 已下单）；硅胶线留着做浮球线加长 / 底盘走线 / 断线应急 | 备用 |
| **D** | **φ8.5×φ10 硅胶软管**（内径 8.5 / 外径 10，2026-10-23 实测；这是水路，不是电线，别混） | 水泵出水嘴 → 盆内水管夹 | 约 1.2m |

**C 的完整采购参数（2026-10-19 定）**：

| 参数 | 值 | 说明 |
|---|---|---|
| 线规 | **22AWG**（≈0.30mm²） | 泵 600mA / 峰值 1.8A 下 30cm 压降仅 ~29mV |
| 导体 | 60 股 × 0.08mm **镀锡铜** | 多股软线，耐反复弯折；镀锡防氧化好上锡 |
| 外径 | 约 **1.6mm**（绝缘厚 ~0.4mm） | 能穿 φ10 过线孔、塞进继电器端子 |
| 绝缘 | **硅橡胶** | −60~200℃，烙铁烫不化（PVC 一碰就缩） |
| 额定 | 300V / 约 3A | 余量充足 |
| 长度/颜色 | **红 ×2 + 黑 ×1，每根 30cm** | 红=5V 正（两段：电源→COM、NO→泵）；黑=泵负→电源负 |

> 淘宝搜「22AWG 硅胶线 30cm」或「22AWG 硅胶线 按米」；买 1 米自己剪更便宜（¥1–2）。切勿买 PVC 单芯硬线（弯两次就断、不耐泵振动）；**PVC 多股也不行**（耐温仅 80℃，烙铁一烫就缩皮，泵长期振动下易裂）。
>
> **识别虚标（已踩）**：22AWG 真身是 **0.33mm²**，按 0.1mm 单丝算要约 **41 股**；商品写「17 股 × 0.1mm」实际只有 **0.13mm² ≈ AWG26**，写「11 股 × 0.1」只有 0.086mm² ≈ AWG28。**看股数：≥40×0.1 或 60×0.08 才是真 22AWG**；标 300V/3A 不代表线径够。
>
> **下限放宽（2026-10-19 定）**：`40×0.08`（≈0.20mm²）的硅胶线**也够用**——30cm 走 600mA 压降仅 ~15mV、峰值 1.8A ~46mV，损耗 <0.1W。低于 0.15mm² 才需要否定。
>
> **「杜邦硅胶线」能不能用？** 分场景：**信号线（浮球/传感器/OLED）可以**——硅胶软、耐折，杜邦头 2.54mm 正好插面包板；**水泵回路不行**——瓶颈不在线皮而在**杜邦端子**：额定约 1A、接触电阻 20–50mΩ，泵启动 1.2–1.8A 会发热；且继电器侧是**螺丝端子**，杜邦母头压不进去。泵线要**裸线**（端头剥皮镀锡/压冷压端子）。

> 40P 杜邦线是"母对母 + 公对母各半"（具体以套件实物为准）。**直插定稿（2026-11-12）后线种分工**：两端都套针顶的用母对母（A）；母端套针顶 + 公端插孔的用公对母（A2）；两端都插孔（轨桥 / 模块取电）用硬芯跳线（B）。
>
> 📌 **借料提醒（2026-10-20，2026-11-12 更新数量）**：学校有杜邦线可借，借的时候**公对母和公对公都要**——**公对母 10 根**（A2）+ **公对公硬芯跳线 9 根**（B，轨桥 2 + R1 取电 1 + 模块取电 6）。电容式土壤模块 PCB 是三个裸焊孔（1.0–1.2mm），公头方针 0.64mm 可**直接插入**免焊接。

### 每种元件的具体线序

| 元件 | 针脚 → 接到 | 线 | 建议色 |
| --- | --- | --- | --- |
| **土壤湿度**（直插 a19–21） | 取电：**b19→蓝轨 / b20→红轨**（跳线 B × 2）；信号：**D34 针顶 → b21**（A2） | B × 2 + A2 × 1 | 黑 / 红 / 黄 |
| **光敏**（直插 a22–25） | 取电：**b23→蓝轨 / b24→红轨**（B × 2）；信号：**D35 针顶 → b25**（A2）；DO 悬空 | B × 2 + A2 × 1 | 黑 / 红 / 紫 |
| **DHT11**（直插 a26–29） | 取电：**b26→红轨 / b29→蓝轨**（B × 2，第2段轨需轨桥在位）；信号：**D33 针顶 → b27**（A2） | B × 2 + A2 × 1 | 红 / 黑 / 白 |
| **浮球 RC**（位 16–18） | R1: a16↔a18；C1: c18↔蓝轨；红轨→b16（B）；浮球1→b18、浮球2→蓝轨（裸线直插）；**D32 针顶 → e18**（A2） | B × 1 + A2 × 1 + 元件 | — |
| **OLED**（板外·屏架） | VCC→红轨 / GND→蓝轨（A2 × 2）；**D21 针顶→SDA / D22 针顶→SCL**（A × 2） | A × 2 + A2 × 2 | 红/黑/绿/白 |
| **双色 LED**（板外·底盘） | R→**D25 针顶** / G→**D27 针顶**（A × 2）；−→蓝轨（A2） | A × 2 + A2 × 1 | 红 / 绿 / 黑 |
| **继电器**（板外·悬放） | **VIN 针顶→DC+**（A）/ D26 针顶→IN（A）/ DC−→蓝轨（A2）；跳帽 H 档 | A × 2 + A2 × 1 | 红 / 蓝 / 黑 |
| **电源轨** | 3V3 针顶→红轨（A2）、GND 针顶→蓝轨（A2，**单点**）；**轨桥红/蓝 25↔26（B × 2）** | A2 × 2 + B × 2 | 红 / 黑 |
| **雨滴**（已取消） | ~~VCC → 3V3 / GND → 蓝轨 / AO → GPIO32~~ | — | 不再借用，此行留档 |
| **水泵回路** | pigtail 免剪（公头线红→COM；NO→母头线红；两黑经 WAGO-A 直连。**二极管跳过 2026-11-13**） | pigtail × 2 + 万可 | 见第四节 |

合计：**杜邦 16 根**（母对母 A × 6 + 公对母 A2 × 10）+ **公对公跳线 9 根**（B）+ 元件 2 个（R1/C1）+ pigtail × 2 + 万可 × 1。（~~1N4007 × 1~~ 2026-11-13 跳过，备用）

### 三个容易踩的点

1. **水泵不许用杜邦线**。3W 泵约 600mA，杜邦线的压接端接触电阻大，长时间通流会发热、压降会让泵转速掉一半。第三节那句"水泵线用杜邦线"本次已改成 22AWG 端子线。
   - 也别用淘宝那种「5/0.8 双头镀锡短线」（5 股 × 0.1mm，截面仅约 0.039mm² ≈ AWG31）：标称 500mA 都算乐观，泵启动 1.2–1.8A 会直接发热发烫，且 50mm 长度根本不够 30cm 走线。**只作信号短线（浮球/传感器）可用，泵回路不行。**
2. **双色 LED 到底是什么形态，到货才能定**：
   - 若是**模块**（3 针 GND/R/G）→ 板上自带限流电阻，按上表直连即可；
   - 若是**裸 5mm 灯珠**（4 针脚或 2 长脚 + 2 短脚）→ **必须串 220Ω 限流电阻**（3.3V 下约 6mA），直连会超过 GPIO 40mA 上限，烧灯或烧脚。这一项文档之前没写，属缺口。
3. **共地只有一处**。所有模块 GND 先汇到蓝轨，蓝轨用**一根**线回 ESP32 GND。多点接 GND 会形成地环路，模拟读数会抖。

---

## 三·补二、水泵实物规格（2026-10-19 实测）

| 项 | 值 |
|---|---|
| 型号 | 3W USB 底吸泵（USB 供电，无开关） |
| 泵体 | **41 × 39 × 30 mm**（含出水嘴高 37） |
| 底脚（吸盘） | 32 × 28 mm |
| 功率 / 流量 / 扬程 | 3W · 130 L/h · 50 cm |

> ⚠️ **它没有开关**：只要供电就一直转。所以"插上电一直转"通常是**正常现象**——说明它现在直接吃着电，
> 没经过继电器断开。要么是直插了 USB 电源，要么继电器接在 **NC（常闭）**，要么继电器模块是低电平触发
> 而代码当成高电平用。三种情况的判别见第六节故障速查。

## 四、水泵怎么供电（免焊）

一句话原则：**泵吃独立 5V，继电器只当开关，ESP32 只出信号。** 泵电流一点不经过 ESP32 板。

### 三种供电方案

| 方案 | 怎么接 | 优点 | 代价 | 推荐度 |
| --- | --- | --- | --- | --- |
| **A 独立 5V/2A 充电头**（+ ESP32 另用电脑 USB） | 泵 → 继电器 → 充电头 | 泵启动冲击完全不干扰 ESP32，模拟读数最稳 | 要占两个插座 | **★★★ 答辩现场首选** |
| **B 一个 5V/3A 头 + USB 分线** | 一路给 ESP32 USB，一路经免焊端子给继电器 COM | 一个插头搞定，天然共地 | 分线器质量差会掉压，泵启动瞬间可能把 ESP32 拉到重启 | ★★ |
| **C 充电宝** | 同 A 或 B | 无线、便携 | **充电宝低电流会自动断电**（ESP32 待机才 100mA 级、泵又是间歇工作），演示到一半黑屏 | ★ 不推荐 |

### 电流账（选电源的依据）

| 项 | 数值 |
| --- | --- |
| 泵稳态 | **600mA**（3W ÷ 5V） |
| 泵启动瞬间 | **1.2–1.8A**（直流电机启动 2–3 倍，持续 <100ms） |
| ESP32 WiFi 发射峰值 | ~250mA |
| **电源下限** | **≥2A**（方案 A）；**≥3A**（方案 B，两个负载共用一个头） |

### 接法

```
5V 电源 +  ──────► 继电器 COM
                    继电器 NO ──────► 泵 红线 (+)
泵 黑线 (−) ──────► 5V 电源 −

继电器 VCC 仍由 ESP32 的 VIN(5V) 供，IN → GPIO26
线圈侧与触点侧天然隔离，所以泵电源不需要和 ESP32 共地
```

- **必须接 COM + NO（常开）**：断电、复位、程序跑飞时泵自动停。接成 NC 就变成"一上电就抽水"，蓄水瓶抽干都停不下来。
### USB 款泵的电源到底插哪儿（2026-10-19 补 · 2026-11-11 改 pigtail 免剪定稿）

**结论：插独立 5V 电源（现定充电宝·小电流模式），中间串继电器；绝对不要插 ESP32 板上那个 USB 口。**

```
      充电宝 5V（开小电流模式）
              │
      ┌─────┴─────┐
      │ 公头线 30cm │（USB-A 公头 → 2P 端子，SKU1，不剪任何线）
      └─────┬─────┘
     红线 +5V ── COM ─(继电器)─ NO ──┐
                                    │ （二极管跳过 2026-11-13，不接）
     黑线 GND ── 万可 221-413 孔1    │
                                    │
      ┌─────────────────────────────┘
      │ 母头线 30cm（USB-A 母座 → 2P 端子，SKU2）
      │ 红线 ← NO（含二极管同孔）；黑线 → 万可孔3
      └─ 母座 ← 泵自带 USB 公头直插（二极管无环端 → 万可孔2）
```

**三种接法（2026-11-11 起方案 A' 定稿，原"剪延长线"方案作废）**：

| 方案 | 怎么做 | 代价 | 推荐 |
|---|---|---|---|
| **A'. pigtail 双线 + 万可**（**定稿，11/10 已下单**） | 公头线 30cm（SKU1）+ 母头线 30cm（SKU2），端子螺丝压线；两黑线+二极管无环端进万可 221-413 三孔；泵公头直插母座 | ≤¥4，**全程零剪线零焊接** | ★★★ |
| ~~A. 剪一根 USB 延长线~~ | ~~A 公-A 母线剪断~~ | — | ✗ **2026-11-09 领导拍板废弃（不剪任何线）** |
| B. USB 免焊端子（母座转螺丝） | 充电头插母座，端子螺丝引出红/黑 → COM/NO | 5 元，线材稍乱 | △ 被 A' 覆盖 |
| C. 直接剪泵的线 | 剪断泵线接到继电器 | 泵报废风险、无保修 | ✗ 不建议 |

**供电口径（2026-11-11 定）**：充电宝（有小电流模式，插泵前双击开启，防轻载自动断电）；兜底 = 5V USB-A 充电头 + 插座（48h 无人值守测试更稳，不存在充电宝自身没电）。

**为什么不能插 ESP32 的 USB 口**：

1. 那个口是给板子供电/烧录的，泵启动瞬间 1.2–1.8A 会把它拉垮，轻则板子重启、重则烧 USB 保护器件；
2. 插上去就等于**绕过继电器**——泵会一直转，正是你现在看到的现象；
3. 电脑 USB 口只保证 500mA，泵一启动就触发限流断电。

**如果只有一个插座**：用 5V/3A 充电头 + USB 分线器，一路给 ESP32、一路给泵；**泵那一路仍然要串继电器**，两路共地（同一个头出来天然共地）。

> 续流二极管 1N4007 仍然要并联在**泵的两根线**上（不是 USB 线的红黑，是泵本体出线或母座后的红黑），阴极朝 +5V。

### 两个加固（二极管必做；保险已豁免）

1. **续流二极管 1N4007**：反并联在泵两端——**阴极（有色环那端）接 +5V，阳极接泵 −**。直流电机是感性负载，断电瞬间的反电动势会打火花烧继电器触点（触点寿命从十万次掉到几千次），也会窜进模拟通道让土壤读数乱跳。一块钱的事。
2. ~~**1A 自恢复保险**（如 MF-R110）串在 COM 前~~ —— **2026-10-19 领导决定豁免，不装**。前提：① 用**正规 5V/2A 以上充电头**（手机原装级，自带过流/短路保护）；② 固件已有"连浇 6 轮上限 + 冷却 10 分钟"软保护，泵单次通电 ≤18s。**若改用杂牌充电头/充电宝演示，建议补装**（PTC 1.1A 保持/2.2A 触发，串 COM 前）。

### 加固怎么做（免焊，10 分钟）

**材料**：1N4007 ×1（买 5 只备用，一只 1 毛）、小十字螺丝刀、剥线钳。（MF-R110 已豁免，此处不再列出）

**接线位置**（在上一节那张图的基础上多一个元件）：

```
5V 电源 + ──► 继电器 COM
                继电器 NO ──► 泵 红线 (+)
泵 黑线 (−) ──► 5V 电源 −

                  ┌──── 1N4007（色环端朝上）────┐
泵 (+) ───────────┤                            ├─────────── 泵 (−)
                  └──── 阳极（无色环，朝下）──────┘
       即：二极管与泵并联，阴极接 +，阳极接 −
```

**⛔ 2026-11-13 领导拍板：负载侧二极管跳过，不接。**
依据：泵 0.6A 仅占触点额定 10A/30VDC 的 6%，裕量巨大；项目周期内开关次数（48h 测试+答辩）远不足以让感性尖峰造成可感知的触点损耗。线圈侧续流二极管模块板载已有（保护 ESP32 侧），负载侧这只的实际收益只剩 EMI 抑制，权衡后省略。二极管留在元件盒做备用。

~~**四步做完**~~（历史方案存档，未执行）：

1. **断电**，泵从电源上完全断开（不是只关继电器，要把 5V 拔掉）。
2. **二极管整形**：两根引脚各向外弯 90°，跨距调到正好够到泵的两个接线端（约 15–20mm）。
3. ~~**压接**（2026-11-11 起**只用万可一种**，免焊端子/端子排方案随剪线方案一并作废）~~：
   - **万可两孔版（221-222）→ 现行口径（二极管跳过后再简化）**：**只用 WAGO-A 一只**——
     - WAGO-A：孔1 = 公头线黑；孔2 = 母头线黑（主回路负极直连，完事）
     - ~~WAGO-B（二极管桥接）~~ 随二极管一并跳过；WAGO-B 留作备用
     ① 孔1 `公头线黑（电源负）`；
     ② 孔2 `二极管无环端（阳极）`；
     ③ 孔3 `母头线黑（泵负）`。
     二极管**色环端（阴极）不进万可**——与母头线红线**同孔压进 NO 螺丝**。
     剥线 **11mm**，扳起橙色杠杆插到底、压回即可，可反复拆装。
4. **通电前必须验极性**（这一步不能省，装反等于**把电源直接短路**）：

   | 万用表档位 | 红表笔 | 黑表笔 | 正常读数 |
   | --- | --- | --- | --- |
   | 二极管档（→\|—） | **泵 −** | **泵 +** | **0.5–0.7 V**（正向导通） |
   | 同上，反过来 | 泵 + | 泵 − | **OL / 显示 1**（不导通） |

   第一行读 0.5–0.7V 才算装对。**如果两行都通（都读到接近 0）→ 说明二极管已经击穿或装错，立刻拆掉**，否则上电瞬间 5V 电源被二极管短路，轻则电源保护重启、重则烧线冒烟。

**为什么反着接**：正常工作时二极管反向截止，等于不存在；泵断电那一瞬间电机线圈产生反向电压，二极管正向导通把它泄放掉，把火花消灭在线圈内部，不让它跑到继电器触点和模拟通道上去。

> 保险（已豁免）若日后补装，位置串在 **COM 之前**（电源侧），这样保险坏了自己断，泵和线都保住了；串在 NO 之后只保护泵、不保护线。

### 首次通电（空载，别先接水管）

1. 泵不进水、水管不接花盆，只通电听继电器
2. **有"咔嗒" + 泵转** → 继电器和信号都对，可以接水路
3. **有"咔嗒"但泵不转** → 查泵回路：COM/NO 接反了？5V 电源没输出？线没压紧？
4. **没有"咔嗒"** → 查 GPIO26 信号和触发极性（`config.h` 里的 `RELAY_ACTIVE_HIGH`，模块是低电平触发就改成 0）

---

## 五、通电前 60 秒自查

- [ ] 所有 VCC / GND 没有接反（反接烧板，一秒的事）
- [ ] 三条模拟线分别落在 GPIO34 / 35 /（32）
- [ ] **浮球开关**：线 1 → GPIO32、线 2 → GND、1kΩ 上拉 3V3↔GPIO32、100nF 并联 GPIO32↔GND（接才查，W2 末再接）
- [ ] 面包板 GND 轨已连回 ESP32 GND（共地）
- [ ] 继电器 IN 在 GPIO26，没插到 34/35 这类只读脚上
- [ ] OLED 四线按丝印序（VCC GND SCL SDA）
- [ ] 水泵回路与 ESP32 供电分离，触点接在 COM/NO
- [ ] **续流二极管极性已验**：断电、红笔泵 −、黑笔泵 +，读 0.5–0.7V；读 0 或两向都通立刻拆
- [ ] **5V 电源是正规 2A 以上充电头**（保险已豁免，靠电源自身过流保护 + 固件冷却兜底）

---

## 六、常见故障速查（排查过程 = 报告"失败与排查"素材）

| 现象 | 先查什么 |
| --- | --- |
| 模拟读数一直是 0 或 4095 | 线是不是误插了 ADC2 组引脚（GPIO4/12/13/14 等）；共地断没断 |
| WiFi 一开模拟读数全乱 | 模拟线在 ADC2 脚上，换回 32–39 |
| OLED 不亮 | 跑一遍 I2C 扫描看地址（通常 0x3C）；SCL/SDA 是否插反 |
| 继电器不吸合 / 动作相反 | 触发极性（高电平/低电平触发），代码取反即可 |
| 双色 LED 颜色反了 | R/G 对调，改代码或换线，不算故障 |
| DHT11 读出 nan | 等模块上电稳定 2 秒再读；DATA 线插稳 |
| 水泵不转 | 先听继电器咔嗒声：有咔嗒=查水泵回路；无咔嗒=查 GPIO26 信号与触发极性 |
| **水泵一通电就一直转** | ① 泵是不是直接插了 USB 电源（绕过继电器）；② 触点是不是接在 **NC**（应接 COM+NO）；③ 继电器模块是**低电平触发**却把 `RELAY_ACTIVE_HIGH` 设成 1 → 代码写 LOW 反而吸合，改成 0 |
| 上电瞬间泵"咔"一下才停 | 继电器上电毛刺，固件 v1.3 已改为"先锁断电平再开输出"；仍出现则模块本身无上拉，见下 |
| **泵一停/一启动，土壤或光敏读数就跳一下** | **没装续流二极管，或装反了**（见第四节加固）；其次查泵电源与信号线是否并排走太近 |
| 泵转但继电器触点很快发黑/粘连 | 同上——感性负载打火，必须加 1N4007 |
| 一上电泵就转、程序管不住 | 触点接到了 **NC**（常闭），改接 COM+NO |
| 串口一直"水位低"、接水也低 | 浮球线断/没接 GND（fail-safe 判没水）；查 1kΩ 上拉是否虚插 |
| 水位读数乱跳、时有时无 | 干簧管湿电流不够（上拉用了 10kΩ/内部上拉）→ 换 1kΩ；100nF 电容没插 |

---

*接线当天拍 2 类照片：①整机俯拍（线序清晰）②每模块特写——报告"三模块实现"章节直接用。*
