huankechong/smart-greenhouse/docs/审计报告/AR33_GreenHouse_01b感湿窗_2026-11-10.md

> ⚠️ **本文结论已被推翻（2026-11-10 19:45 领导定版「裸露版」open_window=True，见 AR35）**——
> 本文化录的是 18:48 前的「开窗被否」中间态；最终 01b = 裸露版 14.5g（感湿窗 17×37 尖顶），已打印。

# AR33 · 01b 加「感湿窗 + 接线端开口」· 2026-11-10

> 触发：领导指出两点——① 接线端没有走线空间；② 「只留一点点测量区能测准吗」。
> 结论：**② 是真的设计缺陷**——板被 3.6mm 的 PLA 包在板槽里，电容场几乎探不到土。已开窗解决。

## 一、问题（量化）

| 项 | 原设计 | 后果 |
|---|---|---|
| 板槽两侧壁 | 柱深 9 − 槽 1.8 → **每面 3.6mm PLA** | 电容式测的是极板周围介电常数；3.6mm PLA（ε≈3）+ 内部空气隙把土壤信号挡掉大半 → 量程可能达不到固件要求的 ≥800 |
| 接线端 | 3.1 厚塞在 3.4 槽里（单边 0.15） | 杜邦头/线没有横向空间，只能从顶上直拔，一弯就顶槽壁 |

## 二、改法

| 项 | 内容 |
|---|---|
| **感湿窗** | 板槽两侧壁在土面以下开掉，窗口 **17 宽 × 37 高**（床坐标 z 2~40，即土面下 33 到土面上 5）；**窗顶做 ≈43° 尖顶**，免支撑、不形成桥 |
| **接线端开口** | +Y 侧壁在接线端处开 17 × 16（床坐标 z 53~69），杜邦头可朝盆外弯出；背面保留承力 |
| 质量 | 22.8 → **17.3 g** |
| 外形 | 27×18×71（不变） |

## 三、验证

- 感湿窗：板槽侧壁 (0,±4,20) 均空 ✓；侧轨 (±12,0,20) 均实 ✓
- 接线端：+Y 侧 (0,4,60) 空 ✓、背面 (0,-4,60) 实 ✓、柱顶 (0,0,70) 实 ✓
- 严格水平悬空面 254mm²（改前 243，仅 +11，来自接线端开口的小天花）→ 无新增桥
- 水密单体；`check_base_fit` 全过；25 根线 0 穿模；`audit` 零 `!!`

## 四、结论：开窗被否，改回封闭槽（2026-11-10）

领导看过 2×2 效果图后要求**把两个开口都删掉** → `open_window: False`。

- 恢复：柱深 9 + 阶梯槽（下段 1.8 / 上段 3.4），**板面不外露**
- 质量：17.3 → **22.8 g**
- 代价（已知并接受）：板的两面各隔 3.6mm PLA，电容场衰减；接线端只有 0.15 单边，线从顶上直出
- **对策**：① 装之前在板背面（非传感面）薄涂指甲油/硅胶防潮；② 标定时按实际状态测，若 `DRY−WET < 800` 再考虑重新开窗（开关还在，改一个参数即可）

## 五、现在（封闭槽）的配合

> 配图：`docs/操作手册/01b_装盆效果图.png`（2×2：正视图看感湿窗 / 侧剖面看埋深 / 正视剖面看高度 / 横截面看接线端开口）

- 板感湿区 66.3 长，其中 **51mm 在土里**（板底到土面）
- 这 51mm 中 **49mm 双面完全暴露**（窗口 17 宽 + 柱底以下 16mm 全裸）
- 剩余 15.3mm 在土面以上（本来就不参与测量）

---

*小马 · 2026-11-10 · 下一个 AR 编号 **AR34***
