huankechong/smart-greenhouse/docs/审计报告/AR34_GreenHouse_03插土针加强_2026-11-10.md

---

## 五、后续：V 形斜撑已按领导要求去掉（2026-11-10 19:00）

- 开关：`p["brace"]` 默认 **False**，斜撑代码保留（改一个参数即可恢复）
- 现状：**pin_t 3.2**（比原来 2.0 粗 60%）+ **无斜撑** → 3.4 → **3.9 g**
- 验证：探针 (0,0,21) 为空（原斜撑位置）✓、针 (5.5,0,10) 为实 ✓、bodies=1、watertight
- **代价（须知道）**：针又回到"3.2×6、25mm 悬臂"，取下时根部仍是最脆弱处

**推荐的打印朝向随之改变**：不打斜撑时，建议**倒过来打**（管环块 15×15 贴床、针朝上）——
底面是大平面，不用撬针根；代价是 25mm 高的细针会晃，需降低外墙速度、开足风扇。
