huankechong/smart-greenhouse/docs/审计报告/AR31_GreenHouse_01b阶梯槽_2026-11-10.md

# AR31 · 01b 板槽改「阶梯槽」（接线端 3.1 厚）· 2026-11-10

> 触发：领导实测「传感器最厚 3.1mm 在接线端，感湿区长 66.3mm」——原 1.8 直槽塞不进。
> 结论：改成**阶梯槽**（上段 3.4 / 下段 1.8），柱子由 6 加深到 9 保证侧壁；01b 质量 16.5 → 22.8 g。

## 一、尺寸依据

| 项 | 值 | 来源 |
|---|---|---|
| 板总长 | 87 | 实测 10-19 |
| 感湿区长度 | **66.3** | 实测 2026-11-10 |
| 感湿区厚度 | 1.5~1.6 | 实测 |
| **接线端厚度** | **3.1** | 实测 2026-11-10 |
| 接线端长度 | 87 − 66.3 ≈ **20.7 → 取 21** | 推算 |

## 二、改法

| 项 | 改前 | 改后 |
|---|---|---|
| `col_d`（柱深） | 6 | **9**（上段槽 3.4 → 两侧壁各 2.8） |
| 槽 | 1.8 直通 | **阶梯**：上段（距柱顶 0~21）= **3.4**；下段 = 1.8 |
| `term_t` / `term_clear` | — | **3.1 / 0.3**（接线端单边 0.15） |
| 质量 | 16.5 g | **22.8 g** |
| 外形 | 27×15×71 | **27×18×71** |

**关键**：加宽段全部在土面以上（土面在床坐标 z=35，加宽段 z 50~71），接线端不会埋进土里。

## 三、验证（探针实测）

| 位置 | 槽宽 |
|---|---|
| z=60（接线端区） | **3.68**（设计 3.4 + 探针 0.2 偏置） |
| z=45（感湿区上段） | **1.76**（设计 1.8） |
| z=10（感湿区下段） | **1.76** |
| 侧壁厚度 | **2.66**（柱深 9 → 设计 2.8） |

水密单体、1 体；`check_base_fit` 全过；25 根线 0 穿模；`audit` 零 `!!`。

## 四、装配提示

- 板子从柱顶插入：**接线端朝上**（3.1 那端对上 3.4 的宽槽，插错方向会卡在台阶处）
- 板顶与柱顶齐平时到位（此时感湿区底 = 土面下 51mm）

---

*小马 · 2026-11-10 · 下一个 AR 编号 **AR32***
