huankechong/smart-greenhouse/docs/审计报告/AR32_GreenHouse_03插土针加强_2026-11-10.md

# AR32 · 03 管夹插土针加强（从根部折断）· 2026-11-10

> ⛔ **已回退，勿按本文重出 STL**（2026-11-10 18:30 领导决定）。
> `p0_models.py` 已 `git checkout` 回 HEAD：`pin_t` 回到 **2.0**、V 形斜撑代码块删除 → 03 恢复 **15×15×41 / 2778mm³ / 3.4g / 1 体水密**（与 `交付说明_P0三件v1.md` 原值一致，无需改文档）。
> 本文参数与失效分析**留存备查**；防断改走 §四的**取件工艺**（等床温 <35℃ / 铲刀斜插 / 或翻转 180° 打印），不再加粗针体。
>
> 触发：领导反馈「03 的腿太不坚固，从打印机上拿下来就断了」。
> 结论：**根部弯矩过大**（2×6 截面、25mm 悬臂 + 热床粘附）→ 针加厚 2.0→3.2（+60% 截面），并在两针之间加 **V 形斜撑**把根部闭合成三角。

## 一、失效分析

- 两条针：**2.0(X) × 6(Y) × 25(深)**，从热床上剥离时力作用在针尖
- 根部弯矩 = 剥离力 × 25mm，截面仅 12 mm² → 应力集中，PLA 脆性 → 根部断
- 断点在"针与柱交界"（z=25 处），与用户描述一致

## 二、改法

| 项 | 改前 | 改后 |
|---|---|---|
| `pin_t`（针厚 X） | 2.0 | **3.2**（3.2×6 = 19.2 mm²，+60%） |
| 根部 | 两根独立悬臂 | **V 形斜撑**（z −7~0，跨 ±5.99，45° 自支撑）把根部闭合成三角 |
| 质量 | 3.4 g | **4.0 g** |
| 外形 | 15×15×41 | 15×15×41（不变） |

斜撑斜面 61°（距竖直 29°）→ 免支撑可打；内侧伸进针里 0.5mm，避免共面导致 bodies=2。

## 三、验证

- bodies=1、watertight；探针：针区 (5.5,0,5)=1、斜撑中心 (0,0,21)=1、斜撑下方 (0,0,17)=0 ✓
- `check_base_fit` 全过；25 根线 0 穿模；`audit` 零 `!!`

## 四、取件建议（同样的坑别再踩）

1. **等床温降到 35℃ 以下再取**——PLA 会自己松开，几乎不用撬
2. 用**铲刀从底部斜插**，不要捏住零件左右掰
3. 实在还断：把 03 **翻转 180° 打印**（管环柱坐床、针朝上），剥离力作用在 15×15 的大平面上

---

*小马 · 2026-11-10 · 下一个 AR 编号 **AR33***
