huankechong/smart-greenhouse/docs/审计报告/AR28_GreenHouse_01b板槽修复_2026-11-09.md

# AR28 · 01b 土壤传感器架「板槽」修复 · 2026-11-09

> 触发：领导打印时发现「中间没留空隙，板插不进去」。
> 结论：**两个真 bug**——① 板槽只开在柱子上半段（下半 30mm 是实心）；② 槽宽 1.4 比板（1.6）还窄，0.4 喷嘴也打不出缝；③ 附带的 8° 斜槽在 6mm 厚柱子里上下偏 ±4.9mm，早就偏出柱面。全部已修。

---

## 一、问题定位（探针实测）

| # | 现象 | 成因 | 证据 |
|---|---|---|---|
| B1 | 下半段没槽 | `slot_len` 46 但柱子 71 高，且槽心按 `col_h/2 = 18` 而不是柱子的实际中点（0.5）→ 槽只覆盖 z 30~41（落床后） | 沿 z 扫 (x=0,y=−2)：z=2/10/20 全是实体 |
| B2 | 槽比板窄 | `groove_gap` 1.4，板厚 1.6 → **单边 −0.1 过盈**；0.4 喷嘴的缝宽下限约 1.6，1.4 会被打合 | 参数表 1.4 vs 板 1.6 |
| B3 | 槽是斜的、偏出柱面 | `tilt = 8°`，柱深只有 6mm；8° 在 ±35mm 高度上横移 ±4.9mm，槽直接穿出侧壁 | 截面 z=50 的槽边 y −2.7~−1.3（中心 −2.0，偏移 2mm 到柱边） |

## 二、修复

| 项 | 改前 | 改后 |
|---|---|---|
| `tilt` | 8° | **0°**（板竖直插，与柱子平行） |
| `slot_len` | 46 | **81**（柱高 71 + 上下各 5 余量） |
| 槽心 zc | `col_h/2 = 18` | **`(col_h − leg_depth)/2 = 0.5`**（柱子实际中点） |
| `groove_gap` | 1.4（过盈 0.1） | **1.8**（板 1.6，单边 0.1 —— 与测试块标定值一致） |

## 三、验证

- 沿 z 扫 (x=0, y=−2)：**z = 2 / 10 / 20 / 35 / 50 / 65 / 69 全部为空** → 通槽 ✓
- 槽壁 (y=−3.0 / −1.0) 均为实体 ✓
- 水密单体、1 体；质量 19.4 → **16.5 g**（槽贯通后少了 2.9g）
- `check_base_fit` 全过、`check_wires` 25 根 0 穿模

## 四、教训

**"槽贯穿全长"这种话不能只写在注释里**——`slot_len` 和槽心必须从零件几何反算（柱子的真实上下界），不能拍 `col_h/2`。
另外**过盈 0.1 在 FDM 上不成立**：1.4 的缝打不出来，装配间隙下限就是标定的单边 0.10（总 0.2），再小只会打成死缝。

---

*小马 · 2026-11-09 · 下一个 AR 编号 **AR29***
