huankechong/smart-greenhouse/docs/审计报告/AR27_GreenHouse_浮空面修复_2026-11-09.md

# AR27 · "浮空区域"导致的炒面：根因定位与修复 · 2026-11-09

> 触发：领导反馈「昨天这三个打印时也是弹出这个提示，**打印到浮空区域时就开始炒面**」。
> 结论：**真凶是 04 屏架的裙墙内腔天花（656mm²、14mm 跨度）+ 两只 1.2mm 弹性爪（150mm²、悬空 1mm）**，不是 07 的走线口（那个只有 23mm²）。三处已改；07 的走线口按领导要求挪到侧边。

---

## 一、量化定位（只看接近水平的朝下面，`nz < -0.7`）

| 件 | 浮空/悬空面积 | 位置 | 判定 |
|---|---|---|---|
| **04 屏架** | **656 mm²** | z=10，裙墙内腔天花（4 个 70 + 2 个 196） | 🔴 **14mm 跨度桥，首层就悬空** |
| **04 屏架** | **150 mm²** | z=34~36，两只 1.2mm 弹性爪 + 过线口上唇 | 🔴 爪下留 1mm 空腔，打印必起球 |
| 11 光敏 | 270 mm² | z=17~19（托盘下缘）、z=31~32（过线槽底） | 🟠 分散小块，未改 |
| 01b | 243 mm² | z=2，四条稳定鳍下表面 | ✅ 5.5mm 悬臂，可桥 |
| 03 管夹 | 119 mm² | z=25，管环柱底面 | ✅ 已知（翻转打） |
| 07 DHT | 23 mm² | z=58，原背面走线口的地台 | 🟠 1.5mm 地台，只下垂不起球 |

## 二、修复

| 项 | 处理 |
|---|---|
| 04 的两只弹性爪 | **删除**（它们悬在槽底上方 1mm，单边固定 → 打印时必卷边）。屏幕改由 0.10 配合 + 重力定位 |
| 04 裙墙内腔 | 加两道内筋（x=±6.8，内壁 5.3 让开 10.2 宽的杜邦头）→ 中央桥 **14 → 10.6mm**；浮空面积 656 → 577mm²，且跨度降到 Bambu 能稳桥的范围 |
| 07 走线口 | 按领导要求从**背面**挪到**侧边**（+X 侧壁，12×5.6×4.8），3 根线沿侧壁出去再绕到柱子背面 |
| 04 质量 | 27.7 → **28.9 g**（去爪 −1.2、加筋 +2.4） |

## 三、验证

- 04 / 07 水密单体；`check_base_fit` 全过（屏幕干涉 2.6 → **0**）；`check_wires` 25 根 0 穿模
- 合板重建 125.5×34×62.8 / 60.6g；桌面 04、07、合板已更新

## 四、留给后面

- **11 的 270mm²**：托盘下缘 + 过线槽底，属"短桥"，先按现状打；若实打出问题，把托盘加厚 0.5 或过线槽改侧开
- **切片的底线**：这三件**不要开支撑**（开了会塞进爪子/托盘下面，拆的时候掰断）

---

*小马 · 2026-11-09 · 下一个 AR 编号 **AR28***
