huankechong/smart-greenhouse/docs/审计报告/AR25_GreenHouse_底盘小件嵌槽_2026-11-08.md

# AR25 · 底盘小件嵌槽（完全嵌平）· 2026-11-08

> 触发：领导要求「根据每个零件的大小在底座开槽，让它们能直接放进去或嵌进去」，并选**完全嵌平**（槽深 = 零件底座高度）。
> 前提：06a / 06b **都还没打印**，可自由改。
> 结论：06a 新增 5 个嵌槽 + 删 2 处旧特征；06b 完全不动；总重 277.1 → **258.8 g**。

---

## 〇、v2 修正（领导指出锥形底问题后）

07 / 11 的底座是**倒四棱柱**（28→34 / 24→30），第一版用**直壁槽** → 口上留 1.2mm 环缝，缝底下是 3.6mm 宽的空腔，且"锥面自定心"的说法是**错的**（0.6 间隙下锥面根本碰不到槽壁）。

**v2 改法**：
- **07 / 11 改锥形槽**（与零件同角度：33.7° / 36.9°，单边 0.15）→ 口上缝 1.2 → **0.3**，缝里不再有腔体，零件仍坐在槽底
- **04 / 08 / LED 保持直壁**（它们本身就是直壁/平板），间隙由 0.6 收紧到 **0.25**（口上缝 0.6）
- 为什么其余三件不做成锥形底：04 是 10mm 空心裙墙（做锥度会把 3mm 壁削到 1.7），08 是 2mm 平板，LED 是买的成品 PCB 改不了

**v2 实测**（逐点探针）：07 表面槽宽 34.1 / 底 28.3；11 表面 30.1 / 底 24.3；06a 质量 261.3 g。

## 〇之二、v3 定版（加槽口倒角 + 08/11 微调）

- **槽口 0.6×45° 导入倒角**：给 04 / LED 两个直壁槽加了（07/11 锥形槽自带 33.7°/36.9° 导入，08 两侧墙只剩 1.4mm，不加）
- **08 从 (−75,8)→(−77,8) 且不转角**：转角 8° 时槽角会切进继电器槽 1.8mm；改成 0° 后左右各留 1.4mm 墙
- **LED 从 (−16,12.5)→(−14,12.5)**：原位置与 04 槽只隔 0.4，倒角会相交 → 留 1.0mm 墙
- 06a 定版 **261.1 g**（20% 填充 86.2 g），watertight / bodies=1

**踩坑记录**：① 倒角最初做成 1.6mm 高、顶面在 z=9，导致与相邻槽合并成非流形（3 条边）→ 定位到 08 槽角与 11 槽相切；② `continue` 写进字符串时被转义成 `/n`，脚本直接语法错误。

## 一、五个嵌槽（v2）

| 件 | 位置 | 槽尺寸（含 0.6 间隙） | 槽深 | 槽底 z | 依据 |
|---|---|---|---|---|---|
| 04 屏架 | (−45, 38) | **36.2 × 34.2** | **3.0** | 5.0 | ⚠️ 裙墙 10 高，8mm 板放不下 → 取极限 3；单边 **0.10** |
| 07 DHT 座 | (−45, −67) | **锥形 34.2→28.2** | **4.5** | 3.5 | 同锥度 33.7°，单边 **0.10** |
| 11 光敏座 | (−110, −5) | **锥形 30.2→24.2** | **4.0** | 4.0 | 同锥度 36.9°，单边 **0.10** |
| 08 扎线座 | (−77, 8)，不转角 | **30.2 × 16.2**（+0.6 倒角） | **2.0** | 6.0 | 底板 30×16；此前误按 33×20（大 4mm） |
| LED 模块 | (−14, 12.5) | **19.0 × 13.7** + 0.6 倒角 | **1.6** | 6.4 | 模块 1.6 厚，齐平；离 04 槽 1.0 |

**只有 04 不能真"齐平"**：它的底座是 10mm 裙墙 + 3mm 板，8mm 底板无法容纳 → 沉 3mm（约 1/4），视觉上"陷进去一块"，不是完全齐平。若一定要齐平，得把 04 的裙墙从 10 改到 6（线腔变小，需要复核走线）——**未做**。

## 二、顺带删掉的两处

1. **LED φ5.2 通孔 (−22,18)**：改用模块嵌槽后无意义，且会跟槽穿通 → 删除。
2. **扎带槽 (−70,0)**：正好在 08 底座嵌槽范围内，留着会被槽穿通 → 删除（还剩 3 个：−140/−85、−140/0、−70/−85）。

## 三、验证（全部实跑）

| 项 | 结果 |
|---|---|
| 槽底高度 | 逐槽探针：04 槽底 5.0 / 07 3.5 / 11 4.0 / 08 6.0 / LED 6.4，**下方全实、上方全空** |
| 槽间墙厚 | 04↔08 之间 1.0mm、08↔11 之间 ≥1、07↔继电器槽 4.1、11↔面包板 ≥2、LED↔04 **1.0mm** |
| 06a 质量 | 277.1 → **258.8 g**（实体），20% 填充约 85.4 g |
| 落座 | `check_base_fit` 全过（五件 z_min：5.0 / 3.5 / 6.0 / 4.0 / 6.4） |
| 干涉 | 五件 × 底板全部 **0.0 mm³** |
| 走线 | 25 根 **0 穿模**（OLED 4 根末端 −3、DHT −1.5、光敏 3 根 −4、LED 2 根改落模块 −X 边） |
| 06b | STL / 质量不变（293.1 g） |

## 四、代价

- **06a 必须重打**（2h30m33s 那版作废）；06b 不用动。
- 装配里五件整体下沉，屏幕中心降 3mm、DHT 托盘降 4.5mm、光敏托盘降 4mm；**功能不受影响**（都是独立件）。
- 07/11/08/LED 的四周边墙只剩 0.6mm 间隙；08 槽角与继电器槽最近 1.2mm，装件时对正再压，不要斜着敲。

---

*小马 · 2026-11-08 · 下一个 AR 编号 **AR26***

## 六、配合公差：先打测试块再定 06a（待测）

**问题**：为做"无缝"，嵌槽收到单边 0.15（07/11）/ 0.25（04/08/LED）。FDM 实测公差通常 ±0.15~0.25 → **0.15 有装不进的风险**。

**做了测试块** `STL/测试块_配合公差_v1.stl`（105×30×5，11.2g 实体，约 10 分钟）：
- 按 08 扎线座底板（30×16）开三个槽，**从左到右 = 单边 0.10 / 0.20 / 0.30** → **实测选最紧的 0.10**
- 槽深 2、槽口 0.6×45° 倒角，与真底板一致
- 打完后用 08 实物试插：能进且不晃的那一档，就是 06a 五个槽要用的间隙
- ⚠️ 必须用 **0.4 喷嘴 / 0.2 层高 / 不开支撑**，否则结果不可比

**待领导反馈**：报"左/中/右哪一档合适"，我再把 06a 的五个槽（含两个锥形槽）统一到那个值。
