huankechong/smart-greenhouse/docs/审计报告/AR26_GreenHouse_模型脚本代码审计_2026-11-08.md

# AR26 · 模型脚本全面审计（逻辑 / 参数 / 边界 / 一致性）· 2026-11-08

> 触发：领导要求「全面检查构建的模型是否存在错误或疏漏，重点核查逻辑正确性、输入输出、参数与配置一致性、边界条件与异常情况」。
> 范围：`base_2pc_models.py`、`p1p2_models.py`、`p0_models.py`、`p10_tank_lid.py`、`build_assembly.py`、`check_wires.py`、`check_base_fit.py`、`audit.py`、`build_html.py`。
> 结论：**修掉 3 个真 bug（1 个影响 4 个槽深、1 个间隙口径错、1 个尺寸输错），另有 5 项系统性隐患列入建议。**

---

## 一、已修的真 bug

### 🔴 B1 四个老槽的槽深全部多 1mm（切刀中心少加 1）

- **位置**：`base_2pc_models.py` 的 pot / breadboard / relay / tank 四处 `holes.append(C/B(...))`
- **成因**：切刀中心写成 `pt - depth/2`、高度 `depth+2` → 实际切到 `pt - depth - 1`，比设计深 1mm
- **实测证据**：花盆槽底 **0.95**（设计 2）、面包板 **3.45**（4.5）、继电器 **3.45**（4.5）、水箱 **1.95**（3）
- **影响**：四个大件比装配图低 1mm；**花盆槽底只剩 1mm 厚**（上坐 2~4kg 湿土，长期有下挠/开裂风险）
- **修复**：中心改 `pt + 1.0 - depth/2`，槽底 = `pt - depth`；修后实测 1.95 / 4.45 / 4.45 / 2.95 ✓
- **副作用**：06a 261.1 → **275.6 g**、06b 293.1 → **304.2 g**（料多了，但槽深对了）

### 🟠 B2 直壁嵌槽的间隙口径重复计算

- **位置**：`fits` 表 + 切刀 `fw + p["pocket_clear"]`
- **成因**：表里 04/LED 的 `fw` 已经写成了"零件+0.5"，切刀又加 0.6 → 实际 **0.55/边**；而 08 的 `fw` 写的是原始 30.0 → 0.3/边。**同一张表里两种口径**
- **影响**：04/LED 槽比文档（0.25/边）宽一倍，件会晃；文档与实物不符
- **修复**：新增 `fit_clear = 0.6`（单边 0.3），`fits` 一律存**零件真实尺寸** → 三个槽统一 0.3/边

### 🟠 B3 08 扎线座的槽按错误尺寸开（33×20，实为 30×16）

- **位置**：`fits` 表 `("08 扎线", ..., 33.5, 20.5, ...)`
- **成因**：凭记忆写了"30×16 + 3/4 余量"，把余量当成了外廓
- **影响**：槽比件大 4mm，件放进去来回晃，且会与继电器槽角相碰（曾触发非流形）
- **修复**：改回 30.0×16.0 + `fit_clear`

---

## 二、系统性隐患（未改代码，建议）

| # | 隐患 | 具体 | 建议 |
|---|---|---|---|
| S1 | **同一组数字抄了三份** | 槽位/槽深同时出现在 `base_2pc_models.py` 的 `fits`、`build_assembly.py` 的 `OLED/DHT/LDR/LED` 坐标、`check_base_fit.py` 的 `EXPECT` | 抽一个 `model_config.py` 存槽位表，三处 import；或让 assembly/check 从 base 的 `P["fits"]` 反算 |
| S2 | **校验脚本用常量断言** | `check_base_fit.py` 的 `EXPECT` 手写 5.0/3.5/6.0/4.0/6.4 | 从 `fits` 的深度反算期望值，模型改了自动跟着变 |
| S3 | **文档里的质量靠人工抄** | `audit.py` 靠"文档里出现 `275.6 g` 字符串"判定一致 | 改为脚本生成表格片段，或文档只写"见 STL" |
| S4 | **10 水箱盖的 STL 是建模朝向** | 模型裙边朝下，实际要"顶面朝下"打印 | 导出时另存一份翻转后的 STL（打印朝向），避免忘翻 |
| S5 | **03 管夹柱底悬空 119mm²** | 两根 2×6 插土针撑起 15×15 的柱底（z=25） | 翻转 180° 打 / 加 2mm 连接筋（已在 AR24 给方案，未改模型） |

---

## 三、边界与异常情况检查

| 检查项 | 结果 |
|---|---|
| 布尔失败 | 全部 `engine="manifold"`；本次 3 次非流形均由"两槽相切/相交"引起，定位到具体坐标后修掉 |
| 槽底最小剩余厚度 | 花盆 2.0（修后）、面包板/继电器 4.45、04 4.95、07 3.45、08 5.95、水箱 2.95 → 均 ≥2mm |
| 槽间最小墙厚 | LED↔04 1.0、08↔继电器 1.4、08↔11 1.4、07↔继电器 4.1 |
| 嵌槽间隙 | 直壁 0.3/边、锥形 0.15/边（**待测试块定**） |
| 装配干涉 | 五件 × 底板 0.0 mm³；屏 × 屏架 2.6mm³（爪压量，设计意图） |
| 走线 | 25 根 0 穿模 |
| 文件缺失/异常 | `audit.py` 已排除 `切片_*` 目录；gcode 已按新规不再产出 |

---

## 四、待领导决定

1. **嵌槽间隙**：等测试块（三档 0.10/0.20/0.30）结果，再统一 06a 五个槽。
2. **S1/S2 重构**：要不要做"槽位表单一来源"？约 40 分钟，之后改槽不会再出现三处不同步。
3. **S4**：要不要我直接导一份"打印朝向"的 10 号盖 STL？

---

*小马 · 2026-11-08 · 下一个 AR 编号 **AR27***

---

## 五、测试块标定结果（2026-11-09）

领导在 C311 打测试块后用 08 实物试插：**最紧的一格（单边 0.10 / 总 0.20）最合适**。

→ 06a 全部嵌槽已收窄到**单边 0.10**：直壁 `fit_clear 0.6→0.2`、锥形 `0.15→0.10`；
实测槽宽 04 36.3 / 08 30.3 / LED 19.1 / 07 顶 34.1 / 11 顶 30.1（目标 ±0.1 内）；
06a 质量 275.6 → **275.8 g**；落座/干涉/走线复检全过。

**结论（本项目机器的实测公差）**：PLA · 0.4 喷嘴 · 0.2 层高下，**配合间隙取单边 0.10 最合适**（0.20 总间隙可轻松插入且不晃）。以后所有嵌槽/卡扣按这个值。
