huankechong/smart-greenhouse/docs/审计报告/AR20_GreenHouse_OLED支架走线位修复_2026-11-07.md

# AR20 · OLED 支架走线位修复报告（2026-11-07）

> 触发：领导指出「屏幕和传感器支架的建模都没有预留线的位置」。
> 结论：**04 OLED 支架是真缺陷（已修）；01b 传感器支架不是（顶部通槽本来就开，不改）**。
> 影响面：只改 04 一件；gcode 已单独复切；其它 8 件与切片不动。

---

## 一、核查：两条指控，一对一错

### 1.1 04 OLED 支架 —— 成立，且比"没留孔"更严重

| 证据 | 实测 |
|---|---|
| 板槽深度 | 2.4 mm（参数 `pocket_depth`，射线实测 2.4~2.6） |
| 板背余量 | 2.4 − PCB 1.6 = **0.8 mm** |
| 排针+杜邦头需要 | 排针塑壳 2.5 + 杜邦母头 2.5 = **5 mm 起**（沿板背法线） |
| `open_ext=4` 的方向 | 加长的是"沿斜面向下"，**不是向板背后**——设计说明写的"给排针让位"不成立 |
| 通向外部的孔/槽 | 沿槽底法线打射线：2.4 mm 后全是实心，**全件无任何走线通道** |
| 装配图与实体 | 装配里"OLED 排针"盒 23.0 mm³ 与支架交 **23.04（100%）**、"OLED FPC 排线"56.0 交 **56.00（100%）**——等于把排针和排线画进了塑料内部 |

**为什么一直没被发现**：`check_wires.py` 只检查 22 根跳线；排针/排线是按"装饰件"用 `add()` 加进去的，不在检查目标里，所以模型自检全绿也照样有洞。

### 1.2 01b 土壤传感器支架 —— 不成立

- 板槽是**贯通到顶面**的：顶面 23.6 × 1.4 整条开口；柱顶上方 0.5 / 1.5 / 3 / 6 mm 各 29 点探针采样，**实体点 0 个** → 线可以直接从顶上出。
- 装配里 3 根信号线终点在 z=118~120，板顶 z=115 —— **正好停在排针位置**，不是悬空。
- 唯一小毛病：槽顶会蹭排针焊点（约 0.55 mm 级）。插板时留 2 mm 不到底即可，**不值得为此重打一件**。

---

## 二、修复方案（领导选定：A 加脚/裙墙 + 底部出线）

### 2.1 设计

| 项 | 做法 | 理由 |
|---|---|---|
| 模块位置 | 斜面 24 → **26.5**（投影），模块不上移 | 原斜面放不下"27.3 模块 + 下沿挡边"，加长后下沿留 ~5 mm 挡边 |
| 板槽 | 保持 2.4 深；下端 `open_ext` 4.0 → **0.6** 挡边 | 原下端开口 4 mm，板会往下滑；改挡边后板被上下夹住 |
| 排针过线 | 排针段局部加深 **11 mm**（13 宽 × 5.5 长） | 排针 2.5 + 杜邦头 2.5 + 槽深 2.4 ≈ 7.4，11 有余量 |
| 底座竖槽 | **13 × 9** 通透 | 让杜邦头从底座落到裙墙内腔 |
| 底座抬升 | **周边裙墙 + 两条内筋**，高 10 | 见 §3.1：四条腿会让底面变成悬空天花 |
| 背面过线口 | 裙墙背面 **13 × 7** | 4 根杜邦线从底座下往后出，正面看不见 |
| 板背元件让位 | 板下缘往上 **9.5 × 14**，局部深 **4.0** | 覆盖 1 mm 级元件/焊点（0.96" 模块背面常有） |

### 2.2 装配侧同步

- 屏心重算：`(-45, 36.30, 33.44)`（原 `(-45, 38.11, 22.75)`，且原值沿法向偏浅 0.8 mm）
- "OLED 排针"→ 10.2 × 2.54 × 2.5 旋转件 `(-45, 43.60, 23.23)`
- 新增"OLED 杜邦头" 10.2 × 2.54 × 2.54 `(-45, 41.84, 21.47)`（落在底座竖槽里）
- "OLED 驱动 IC" → 9 × 7 × 1.0 `(-45, 42.20, 25.69)`（落在元件让位里）
- 4 根 OLED 跳线重排：从 ESP32 出 → **y<21 处越过 x=-63..-55**（避开左前裙墙）→ 沿 x≈-50 到排针下方 → 从背面过线口进内腔 → 接杜邦头

---

## 三、过程中发现并修掉的三个次生问题

### 3.1 四条腿 = 36×34 的悬空天花（换裙墙）
第一版按"4 条腿"做，trimesh 全绿，但切片器报 `floating regions`：底板底面（z=10）是一整片 36×34 的水平天花，只靠四角支撑，免支撑打印会垮。
→ 改成 **周边 3 mm 裙墙 + 两条内筋**，把底面天花切成 ≤15 mm 的小格（全是垂直壁 + 短桥），免支撑可打。

### 3.2 斜面 24 不够长（改 26.5）
模块 27.3 + 下沿挡边 ≈ 36 > 斜面长 33.9（24/24 的斜长）。若强行上移，模块顶端会探出楔块顶面 2.1 mm、爪悬空。→ 斜面加到 26.5（斜长 37.5）。

### 3.3 屏心/排针/IC 在原装配里位置不对
原装配把屏心放在"面后 0.8"（应为 1.6 = 2.4−0.8），把排针放在 y=22.4（在支架实体里），IC 放在斜面**外面**。→ 全部按"斜面中点 + 下坡距离 + 法向深度"重算，见 §2.2。

---

## 四、验证证据（全部实跑）

| 检查 | 结果 |
|---|---|
| 几何自检 | watertight=True · bodies=**1** · bbox **36×34×39.5** · z_min=0 · 实体 **27.4 g** |
| 板背净空 | 板下缘沿法线向内 0.5→10 mm 逐点 **全空**（需 7.5） |
| 底座竖槽 | y=4/5.5/7/8.5/10 各列 z=2…18 探针，**全透** |
| 背面过线口 | y=-15.5，z=1/3/5/6.5 **空**；z=8/10 实（口高 7 正确） |
| 裙墙/内筋 | z=5 顶视 18×18 采样：周边与 x=±8.5 两筋为实，格内为空 |
| 装配干涉 | 屏 **3.50 mm³**（=顶端两只弹性爪 0.2 压量，设计如此）；排针 / 杜邦头 / 驱动 IC **0.00 mm³** |
| `check_wires.py` | 22 根，穿模 **0** |
| `check_base_fit.py` | 落座高度 / 零干涉 / 槽孔特征 **全部通过**（OLED 支架 z_min=8.0） |
| `audit.py` | 文档数字对账通过（04 估重期望 21.1 → **27.4**） |
| 复切 | **29m49s / 14.7 g / 1610 KB**（原 17m9s / 9.1 g / 648 KB） |

---

## 五、已知限制

1. **屏面比斜面低 0.8 mm**（板槽 2.4 − PCB 1.6）——原设计就如此，属"浅槽内嵌"，不是本次引入。
2. **切片器仍报 `floating regions`**：源于顶端 1.2 mm 厚弹性爪（悬在槽内，跨距 1.5 mm），**原版同样报**；不是裙墙天花，可正常打印。若实打发现爪子塌，把 `claw_over` 1.5 → 1.2 重跑即可。
3. **板背元件按 ≤1.0 mm 假设**：11/08 电子实验时用卡尺量 25 号 OLED 背面最高元件；若 >1.2 mm，把 `ic_depth` 4.0 再加深重跑（1 分钟），不影响已定的其它尺寸。
4. **排针塑壳按 2.5 mm、杜邦头按 2.5 mm** 设计；若实物是"弯针/排母"另议，槽位有 1.7 mm 余量可吸收。

---

## 六、文档同步

- `outputs/3D打印件/花房3D_P1P2/p1p2_models.py`：新增 9 个参数（leg_h/leg_w/lift/wire_*/base_slot_*/ic_*），`build_oled_stand` 重写
- `outputs/3D打印件/花房3D_P1P2/交付说明_P1P2五件v1.md`：04 外形 36×34×27 → **39.5**、估重 21.1 → **27.4 g**、设计说明重写
- `README.md` §三：04 行外形/耗材/时间；合计 325.3 → **330.9 g**、8h02m → **8h15m**
- `outputs/3D打印件/_打印参考/切片报告.md`：加 11-07 复切说明 + 04 行与合计
- `outputs/3D打印件/花房3D_整机装配/audit.py`：04 估重期望 21.1 → 27.4
- `outputs/3D打印件/（已删，切片由领导现场做）/04_oled_stand/`：3mf + gcode + result.json 已刷新

---

*小马 · 2026-11-07 · 下一个 AR 编号 **AR21***
