huankechong/smart-greenhouse/docs/审计报告/AR11_GreenHouse知识库全面审计_2026-10-20.md

# AR11 · 知识库全面审计与文档一致性修复报告

> 日期：2026-10-20 · 审计人：AI（小马）· 触发：领导指示"全面审计"（@delivery-no-pseudoblock + @neat-freak）
> 范围：项目内全部 Markdown 文档（22 份）、固件源码、3D 生成与校验脚本、E 盘镜像、git 状态
> 方法：机械枚举 → 与代码/产物/编译实跑数据逐条对账 → 修不一致 → 双端同步校验 → 提交
> 分级：🔴 破坏性（会导致误操作/返工）· 🟡 事实错误（数字/版本对不上）· 🟢 表述冗余

---

## 一、总览

| 维度 | 发现 | 已修 | 说明 |
|---|---|---|---|
| 🔴 编号冲突 | 1 | 1 | **AR08 被两个报告同时占用**（示意模型圆桶化 / 代码全面审计） |
| 🟡 事实错误（版本号） | 9 | 9 | 固件 v1.3 / 板包 2.0.17 / arduino-cli 1.5.1 等散落 5 份文档 |
| 🟡 事实错误（件数/数字） | 8 | 8 | 9 件 vs 10 件、18h vs 20.5h、11 个 STL vs 10 个、1.72MB/30,492 面 vs 实测 |
| 🟡 路径失效 | 4 | 4 | README 校验脚本表路径缺 `outputs/` 前缀；重建命令缺水箱盖脚本 |
| 🟢 表述冗余/失效引用 | 3 | 3 | 雨滴节残留已删除参数、邮件借用类数、旧迁移包状态值 |
| **合计** | **25** | **25** | 全部已修并双端校验 |

**最重要结论：AR 编号出现重复（AR08 两个文件同名不同主题）。** 按项目"序号项目内递增"红线，这会直接导致下一个报告编号错乱、审计链断档。已把代码审计报告改号为 **AR10**（AR08 圆桶化 / AR09 走线 / AR10 代码审计），下一个编号是 **AR11**（本报告）。

---

## 二、🔴 破坏性问题

### H1 · AR08 编号被两个报告重复占用

- **位置**：`docs/审计报告/AR08_GreenHouse示意模型圆桶化_2026-10-20.md` 与原 `AR08_GreenHouse项目代码全面审计_2026-10-20.md`
- **成因**：AR08（圆桶化，10-20 凌晨）与 AR09（走线优化，10-20 午后）之间插入代码审计时，误用了已被占用的 AR08。`docs/index.md` 表格因此出现**两行都写 AR08**，AGENTS.md 里"下一个 AR10"与"AR08 代码全面审计"并存——两处都自相矛盾。
- **影响**：
  - 审计链断档：AR01→AR10 实际有 10 份报告，索引上却显示 9 个编号；
  - 下一个报告若按"下一个 AR10"填号，会与代码审计报告再次撞号；
  - 云端映射表已登记"AR08 代码全面审计"，若照旧号补传，与"AR08 圆桶化"同名，云端将无法区分。
- **修复**：`git mv` 改号为 `AR10_GreenHouse项目代码全面审计_2026-10-20.md`（保留 git 历史），报告内两处自指 "AR08" 一并改为 "AR10"；`docs/index.md` 表格重排；AGENTS.md 红线注明"AR08 指圆桶化、AR10 指代码审计，勿混用"；下一个编号统一为 **AR11**。
- **验证**：E 盘镜像中同名的旧 AR08 代码审计文件已删除，两端编号序列一致（AR02–AR10 各 1 份，无重复）。

---

## 三、🟡 事实错误（逐条）

### 1. 固件版本全线停留在 v1.3

| 文件 | 原值 | 改为 |
|---|---|---|
| `AGENTS.md` §4 | 固件版本 **v1.3** | **v1.5.1** |
| `AGENTS.md` §7 当前状态 | 固件 v1.5（AR08 修复） | 固件 v1.5.1（AR10 修复） |
| `README.md` 状态表 | 主程序 **v1.3** | **v1.5.1**（补全 v1.1→v1.5.1 版本链） |
| `docs/index.md` 烧固件行 | 固件现版本 v1.5 | **v1.5.1**（AR10 修复版） |
| `docs/花房30天执行计划.md` 进度快照 | 主程序 v1.3 | **v1.5.1**（补全版本链） |
| `docs/花房项目_AI工作交接文档` 进展表 | GreenHouse_v1 **v1.1** | **v1.5.1**（AR10 全量代码审计修复版） |

**根因**：v1.4/v1.5.1 两轮固件改动只更新了固件 README 与审计报告，**没有回头更新任何一份"项目级状态文档"**——这是本项目文档链最典型的漏洞形态（局部更新、全局滞后）。

### 2. 固件 README 整份停留在 v1.3（最严重的一处）

`outputs/代码/花房代码/GreenHouse_v1/README.md` 是**烧录时手边唯一的手册**，却停在两个版本之前：

- 头注写 v1.3、编译数 901,717 B（v1.5.1 实测 902,181 B）；
- **完全没写 v1.4 的浮球改造**——仍让读者以为水位是"读模拟量比 `LEVEL_DRY_RAW` 阈值"、雨滴模块是备选方案，而实际早已定版 P52 干接点、`LEVEL_DRY_RAW` 参数已删除；
- 参数表仍列 `LEVEL_DRY_RAW`、缺 `LEVEL_WET_CLOSED` / `LEVEL_STABLE_N`；
- 状态机图缺"再浇轮数 +1"与冷却可达性说明（正是 AR10 修掉的高危缺口）；
- 库表只有库名、无版本号（AR10 的 M5 建议）。

**修复**：整份重写为 v1.5.1（保留原有结构：编译验证 / 库表 / 使用节奏 / 浇水逻辑四档 / 参数表 / 状态灯 / 排障 / 巴法云），并：库表补版本列 + 加锁版本命令；水位保护单列为第四档并标注三态全覆盖；补 v1.5 修掉"连浇上限从未生效"的显式警示；新增「已知限制」节（明文 MQTT 无认证、局域网无鉴权，均为答辩可讲的风险权衡）；删除已作废的雨滴备选方案。

### 3. 开发环境版本全错

| 项 | 文档原值 | 实测值（本次核对） |
|---|---|---|
| esp32 板包 | 2.0.17 | **2.0.18-arduino.5**（`arduino-cli core list` 实查） |
| arduino-cli | 1.5.1 | **1.5.2-rc.1**（项目内置 `outputs/.tools/`） |
| 已装库版本 | 仅列库名 | DHT 1.4.7 / U8g2 2.36.19 / PubSubClient 2.8.0 |

`docs/花房项目_AI工作交接文档` 第七节原文写着"esp32:esp32@**2.0.17**（不是 IDE 自带的 arduino:esp32 2.0.18）"——**这条结论本身是错的**：本机装的就是 2.0.18-arduino.5。

**修复**：交接文档环境表、AGENTS.md §4、30 天计划进度快照、固件 README 四处统一为实测值，并注明"2.0.17 与 2.0.18 均验证编译通过"。

### 4. 打印件数量：9 件 vs 10 件

第 10 件（水箱替换盖）在 AR07 落地后，多份文档仍写 9 件：

- `README.md` 开篇"9 个结构件"、状态表"9 个打印件全部出 STL"；
- `AGENTS.md` §7"9 个打印件 STL 已交付"；
- `docs/参考资料/花房3D建模入门路线_SolidWorks.md` 顶部"9 个打印件"；
- `docs/花房FinalProject方案书.md` 并行项"9 件参数化 STL"；
- `docs/花房30天执行计划.md` 13.2/14.1 两个任务行"9 件"+"合计约 18 小时"；
- `docs/花房项目_AI工作交接文档` 目录地图"9 个打印件"。

**修复**：全部改为 10 件。打印工时按 README 逐件表重算：**10 件合计约 20.5 小时**（两片底盘 12.2h，其余八件约 8.3h），替换原"18 小时"。

### 5. 校验脚本数量与 HTML 产物数字

- `README.md` 校验表写"11 个 STL 几何自检"——实跑 `audit.py` 为 **10 个**（已用 `grep -c` 实测）；
- `README.md` 写 HTML"1.72MB（30,492 个三角面）"——实测文件 **1,958,389 B = 1.87MB**、HTML 数据层 `"tris": 34734`。该数字在 AR09 走线优化重出后已变，README 未跟；
- `outputs/3D打印件/花房3D_整机装配/交付说明_整机示意模型.md` 细节层段仍写"1.33 → 1.72 MB（30,492 渲染面）"。

**修复**：三处按实测值改齐（1.87MB / 34,734 面 / 10 个 STL），并在 README 校验表补上此前漏写的 `check_wires.py`（22 根跳线穿模校验）。

### 6. README 路径基准混用

`README.md` 第五节"改了参数怎么重出全套"写 `cd outputs` 后用 `花房3D_P0/p0_models.py`（相对 `outputs/`），而"改完必须跑校验"表却写 `花房3D_整机装配/audit.py`（相对项目根）——**同一份文档两套基准**。且重建命令**漏了第 10 件的 `p10_tank_lid.py`**。

**修复**：校验表路径统一加 `outputs/` 前缀；重建命令补 `花房3D_水箱盖/p10_tank_lid.py`。

### 7. 邮件借用类数错

`docs/private/硬件申请邮件模板_v3.md` 检查清单写"附件使用更新版申请单 PDF（借 9 类、无雨滴）"，而 `docs/参考资料/花房借用与自购清单.md` 实际列 **8 类**（41 温湿度 / 32 光敏 / 16 继电器 / 25 OLED / 13 LED / 8+9+10 面包板线材 / 电烙铁+焊锡丝 / 万用表）。同时 `docs/index.md` 采购行写"借 7 类 / 购 4 项 / 免费 4 项"。

**修复**：v3 邮件改 8 类；index 改"借 8 类 / 自购已下单 10 项 + 待买 1 项 / 免买 3 项"（与清单逐行核对）。

### 8. 接线表残留已删除的固件参数

`docs/操作手册/花房接线规划表.md` 第 7 节（雨滴模块，已取消、仅留档）末尾仍写"代码侧：`EN_LEVEL=1` 后，raw 高于 `LEVEL_DRY_RAW`（默认 2500）判没水"——该参数 v1.4 已从固件删除，读者若照此接线会直接踩空。

**修复**：标为**已作废**，并指明浮球方案用 `LEVEL_WET_CLOSED` 极性宏 + 消抖，无模拟量阈值，实际以第 8 节为准。

### 9. 迁移包状态值冻结在 4 天前

`outputs/项目模式迁移包.md` 里的"全局指令"文本是贴进 WorkBuddy 项目设置的模板，硬编码了"已到 AR04，下一个 AR05""固件 v1.1""9 个打印件"。

**修复**：三处更新为 AR10/AR11、v1.5.1、10 个打印件（AR 指针同步改为 AR02-10）。

---

## 四、🟢 表述冗余与失效引用

1. **相对时间**：全量 grep `今天|昨天|刚刚|最近|上周|today|yesterday`，docs/ + README + AGENTS + 固件 README **零命中** ✅
2. **失效文件引用**：脚本化提取全部 Markdown 内的反引号文件路径并逐个 os.path.exists 校验，67 条"疑似失效"逐条人工判读——全部为**上下文裸文件名**（如审计报告里提到 `audit.py` 未带目录）或**明确标注的历史留档**（已删除的 v1 STL、占位模板 `AR序号_…md`），**无真实断链**。已修正的 4 处真实路径问题见 §三·6。
3. **AR 指针覆盖**：docs/index.md 的 AR 表补齐 AR08/AR09/AR10 三行；交接文档"3D 审计"行补 AR08/AR09/AR10；AGENTS.md 云端映射表把"AR08 代码全面审计"改为"AR10 代码全面审计"，并注明 AR08/AR09/AR10 三份在补传前**仍在本地**（此前只写"AR01–AR07 已上云"，未说明 08 之后的缺口）——四份报告已于同日补传上云，见第六节第 1 条。

---

## 五、验证证据

| 验证项 | 方法 | 结果 |
|---|---|---|
| 固件全关编译 | `arduino-cli compile --fqbn esp32:esp32:esp32` | **269,517 B (20%) / RAM 21,592 B (6%) PASS** ✅ |
| 固件全开编译 | 同上（7 开关全 1） | **902,181 B (68%) / RAM 47,016 B (14%) PASS** ✅ |
| 固件出厂状态 | 编译后改回全部开关 = 0，与 HEAD 比对 md5 | **4adeceff… 完全一致** ✅ |
| 3D 几何审计 | `audit.py` | 10 个 STL 几何自检全 OK；装配干涉 5 处均为设计内配合（土壤×板 941.9 等）；文档数字对账 13 项全 OK ✅ |
| 装配落座校验 | `check_base_fit.py` | 落座高度 / 零干涉 / 槽孔特征 **全部通过** ✅ |
| 走线穿模校验 | `check_wires.py` | 22 根跳线 **穿模 0 根 PASS** ✅ |
| 文档数字实取 | `grep -o 'tris":[0-9]*'` / `ls -l` | 34,734 面 / 1,958,389 B ✅ |
| 板包版本实查 | `arduino-cli core list` | esp32 = 2.0.18-arduino.5 ✅ |
| E 盘双端一致 | 14 份文件逐个 md5 比对 | **14/14 一致** ✅ |
| 文档内路径有效 | 脚本提取 + os.path.exists + 人工判读 | 无真实断链 ✅ |
| 相对时间残留 | 全量 grep | 0 命中 ✅ |

---

## 六、已知限制与未处理

1. ~~**AR08/AR09/AR10 三份报告尚未补传云端资料库**~~ —— **已于同日补传完成**，nodeId 曾回填 AGENTS.md 第 8 节映射表：AR08 `FPTRDpWRSl4SsiDKDMtZcu` / AR09 `oSn3m0bkpunWAq1790WG6A` / AR10 `nQayAKJjse8vIBMPytgzXt` / AR11 `IkIT5C4dvTcEONFoiSXLwC`，并经 library_search 读回验证标题与内容无误。**（2026-10-20 后续：云端资料库已整体停用并清空，见第 7 条，这些 nodeId 均已失效）**
2. ~~**云端主空间「花房」文档仍是旧版**~~ —— **已由领导手动删除云端全部花房文档，改为"不同步"**。原始问题留档：云端存在**两个 spaceId**——`Hy2wV7oRfX7RRRIJcFEXYU`（空间名「花房」，装 README / AGENTS / index / 30 天计划 / 接线表 / 方案书 / 交接文档等主文档）与 `TESQXngJ4tIC1hKd2ccd9p`（AR 报告区）；此前 AGENTS.md 只记了后者属记录不完整（已修）。主空间那批文档停留在 10-18/19 的旧版（v1.1、9 个打印件、AR02–AR04），与本地脱节，而 `create_doc.py` 未暴露 `--node-block-id/--confirm-overwrite`，整篇覆盖需逐块 delete + insert（实测单节点读回 8 分钟未返回）——维护成本高于收益，故裁定停用云端、以本地 git 为唯一生产源。
3. **AR 编号方案的历史遗留**：AR01 仍单独放在 `outputs/代码/花房代码/` 而非 `docs/审计报告/`——这是"报告跟着被审对象放"的有意设计（AR01 审的是代码），保持现状不迁移，但已在 index.md 注明。
4. **AR06 报告内出现的 `01b_sensor_rim_hook_v1.stl` 引用**为已被 v2 取代的历史件名，属正常历史留档，未改。
5. **未做推送**：本次变更已 `git commit`，按项目惯例**未 push**（等领导指令）。
6. **云端曾残留一个作废节点**（`yxhN44PI5L0rUYkuP8R4BW`，标题带【作废勿用-内容实为AR06】）无删除 API——随云端整体清空一并消失。
7. **云端资料库停用（2026-10-20 领导裁定）**：云端花房文档已由领导手动删除，AR 报告空间内容亦作废；**不再维护云端副本**。AGENTS.md 第 8 节原 19 个 nodeId 映射表已整表删除（节点均已不存在，留着是误导），改为"以本地 git 为唯一生产源"的说明。**唯一例外**：领导发出"不同步"指令前，我已在 AR 报告空间误上传了一份 README.md（nodeId `BUqqrRK4Roi6B84K0gkC04`）——领导于同日手动删除，**云端已彻底清空、零残留**（15:35 复核：`library_search` 搜"花房 / GreenHouse / 智能花房 / README / 打印件"等 6 组关键词全部零命中，而同期搜无关空间"资料库的100种用法"正常返回，通道可用 → 属内容确已清空而非检索故障）。

---

## 七、版本演进（本项目文档/审计链）

| 编号 | 日期 | 主题 |
|---|---|---|
| AR01 | 10-17 | 固件四维度审计，v1.0 → v1.1 |
| AR02–AR06 | 10-18 ~ 10-19 | 3D 模型 / 底板 / 拼缝 / 装配优化 / 传感器支架 v2 |
| AR07 | 10-19 | 低水位保护落地：P52 浮球 + 固件 v1.4 + 第 10 件水箱替换盖 |
| AR08 | 10-20 | 示意模型圆桶化：1L 桶 + 替换盖 + 浮球；06b 改 φ108 圆槽 |
| AR09 | 10-20 | 走线优化：盖顶过线孔改 −Y45，全件穿模校验 0 穿模 |
| **AR10** | **10-20** | **全部代码五维审计：固件 v1.4→v1.5.1，15 发现 4 修复** |
| **AR11** | **10-20** | **知识库全面审计与文档一致性修复：25 处不一致全部修正** |
