huankechong/smart-greenhouse/docs/审计报告/AR14_GreenHouse硬件到货实拍核对_2026-10-23.md

# AR14 · 花房硬件到货实拍核对报告（2026-10-23）

> **范围**：实验室创乐博 Arduino UNO R4 A 套件元件包 + 自购件到货，共 5 张实拍照片。
> **方法**：RapidOCR 读标签文字 + PIL 超放大（最高 8×）目视复核关键器件。**所有型号均来自实拍标签，不靠印象推测。**
> **结论**：**硬件基本齐备。** 一处流程缺口（缺烙铁）。
> ⚠️ **本报告 §三 的初版结论「4 颗器件是继电器插座底座」已于 19:05 被领导指正并核实推翻 —— 实为**万可 WAGO 221 快接端子**。**更正记录见 §七**，原判断保留在 §三 供追溯。

---

## 一、照片清单

> 📷 **原始照片已备份** → `outputs/素材/到货照片备份_2026-10-23/`（5 张，2026-10-24 01:16 备份，md5 逐张校验一致）。
> 备份原因：原件在微信临时目录 `xwechat_files/.../RWTemp/2026-10/`，**微信会定期清理**，不备份会丢证据。
> 文件命名与内容对应见该目录 `README.md`。

| # | 内容 | 主体 |
|---|---|---|
| 1 | 4 颗透明壳小方块（橙色标签） | 继电器类器件 |
| 2 | 黄色线 + 白色圆柱探头 + 螺纹接头 | P52 浮球开关 |
| 3 | 绿联包装 USB 线 + 创乐博空袋 | USB 延长线 |
| 4 | 多袋元件（编号标签 + 电阻表 + 小方盒） | 套件元件包 |
| 5 | 分格塑料盒 + 标签 | 螺母 DIY 套装 |

---

## 二、逐项核对结果

### 2.1 实验室套件元件包（批次 689711，单据号 YT7650850889287，产地日期 2026-10-20）

| 标签编号 | OCR 原文 | 数量 | 项目对应 | 状态 |
|---|---|---|---|---|
| **G-13-13-3** | 黑色耐高温硅胶线 22AWG 8米 1卷 | 1 卷 | 泵线/信号线 | ✅ |
| **G-13-13-5** | 红色耐高温硅胶线 22AWG 8米 1卷 | 1 卷 | 泵线正极 | ✅ |
| **G-12-1-3** | 配包129 #直插 …8种共100只 | 1 包 | 直插元件补包 | ✅ |
| **A-4-2-1** | 配包101 #1/4W 金属膜 1% 30种每种10 | 1 包 | 电阻 | ✅ 规格超清单 |
| — | 配包135 瓷片电容包 | 1 包 | 电容 | ✅ |
| — | 装片电阻表（120/150/200/220/240/270/300/330/390/470/510/560/620/680/750/820/1K/2K/5K/10K/100K） | 1 盒 | 电阻值对照 | ✅ |
| — | 银色圆罐（引脚可见） | 2 个 | 无源蜂鸣器 | ✅ |
| — | 红色元件袋 | 1 袋 | LED / 二极管类 | ✅ |
| — | 蓝色 PCB 小模块 + 排针 | 若干 | **型号待定** | ⏳ |

### 2.2 自购件到货确认

| 件 | 实拍判定依据 | 状态 |
|---|---|---|
| **P52 浮球开关** | 白色圆柱探头 + M10 螺纹 + 红色垫圈 + 黄色引出线（末端裸线头）；备用件在独立袋中 | ✅ 已到 |
| **USB 延长线** | 绿联包装印「USB 延长线 / USB2.0 标准款 / 数据传输」，A公-A母 1m | ✅ 已到 |
| **22AWG 硅胶线** | 套件 G-13-13-3（黑）/ G-13-13-5（红），各 8 米 | ✅ 已到 |
| **1kΩ 电阻 + 100nF 电容** | 套件 A-4-2-1 电阻包 + 瓷片电容包，规格比清单更全 | ✅ 已到 |
| **1N4007 二极管** | 套件红色元件袋内 | ✅ 已到（数量待数） |
| **万可 WAGO 221 快接端子 ×4** | 透明壳 + 橙色拨杆，标签 `AWG 24-12` / `0.14/0.2-4` / `450V 32A` / `SET 20A` + UL 标志 | ✅ **已到货**（见 §三 更正） |
| **M3 紧固件** | 新增「螺母系列DIY套装 TZ234 = 304防松螺母」（深圳佰瑞特，日期 2026-08-05），含螺母+垫圈+黑色尼龙件 | ✅ **超清单** |
| **ESP32** | 10/20 已实测识别（COM6） | ✅ |
| **土壤传感器 v2.0** | 10/20 已到，随附 1×3P 排针 | ✅ |

### 2.3 仍然缺

| 件 | 性质 | 说明 |
|---|---|---|
| **电烙铁 + 焊锡丝** | 借用（第 7 项） | **套件不含**。套件里只有元件，没有焊接工具 |
| **万用表** | 借用（第 8 项） | 建议一并借，焊完三个焊点量通断验证 |
| **小花盆 + 绿植** | 自购（2.1） | 盆底径 58–62mm，W2 联调前买 |
| **水泵 / 硅胶管 / WAGO** | 自购 | ⏳ 待确认到货 |
| **M3×6 沉头自攻 + PH1 螺丝刀** | 自购 | ⏳ 待确认（已有螺母，但缺对应螺丝与螺丝刀） |

---

## 三、⚠️ 已作废并更正：4 颗器件实为**万可 WAGO 221 快接端子**

> **本节初版判断为「插座底座」，属误判 —— 已于 2026-10-23 19:05 被领导指正，并经联网查证推翻。**
> **更正后的结论：这 4 颗是万可（WAGO）221 系列快接端子，不是继电器，也不是继电器插座底座。**
> **初版判断原文保留在 §3.5 供追溯。**

### 3.1 更正依据：标签与 WAGO 221-413 官方规格逐条对上

| 标签 OCR 所得 | WAGO 官方规格（wago.com 221-413） | 判定 |
|---|---|---|
| `AWG 24-12` | 24–12 AWG | ✅ 完全一致 |
| `0.14/0.2-4` | 细线 0.14–4 mm² / 硬线 0.2–4 mm² | ✅ 完全一致 |
| `450V/32A` | 额定电压 450 V、额定电流 32 A（IEC 60664 / EN 60998） | ✅ 完全一致 |
| `SET 20A` | UL 486C 认证下额定电流 20 A（UL 侧电压 600 V） | ✅ 完全一致 |
| `Cu 1.6/2` | 镀锡铜导电条（tinned current bars） | ✅ 导体材质标注 |
| 透明壳 + 橙色拨杆 | housing: transparent / actuator color: orange | ✅ 完全一致 |
| UL 认证标志 | UL 486C Approvals | ✅ 完全一致 |

### 3.2 这 4 颗在项目里的真正用途

| 项 | 内容 |
|---|---|
| 型号 | **221-413**（3 线位 / 一进二出 / 三通节点）—— 与借用清单 2.2 中 10/19 自购的"WAGO 221-413 ×2（泵回路三通节点）"**对上了** |
| 规格 | 450 V / 32 A，导线 0.14–4 mm²（24–12 AWG），剥线长度 **11 mm** |
| 尺寸 | 18.8 × 8.4 × 18.6 mm，单只 2.5 g |
| 数量 | **4 只**（清单原计划 2 只 → **超量**，可能 412/413 各 2，只数待清点） |

**泵回路两个三通节点**（+5V 汇流、GND 汇流）**的接线端子现已实物在手** —— 这是 10/19 自购单里唯一还没确认到货的一项，现已确认。

### 3.3 顺带解决的两件事

1. **免焊方案 B 现在实物可行** —— `docs/W1无烙铁接线方案_2026-10-20.md` 的方案 B（硬芯线 + WAGO 221）原本依赖"10/19 已下单、待到货"，现在端子已到。**万一电烙铁借不到，这条路立刻能走。**
2. **继电器的问题回到原点** —— 这 4 颗既然不是继电器，那"套件第 16 项继电器模块在不在"这个问题**仍然没有答案**，需要翻找未拍的袋子（见 §六 行动项 1）。

### 3.4 错在哪（方法论复盘）

| 环节 | 初版做法 | 问题 |
|---|---|---|
| 识别路径 | 看到「透明壳 + 金属簧片 + 触点额定值」→ 套到"继电器底座"模板 | **没有先查商标**。标签上印着 `UL` 认证标志却没去查这家是谁的产品 |
| 关键线索漏读 | 标签印 `AWG 24-12`（适用线径） | 当时把它当成"底座才有的特征"，实际**这正是 WAGO 快接端子的核心卖点**（一款覆盖各种线径的通用端子必然标线径） |
| 颜色当成特征 | 橙色 = 触点/铜件 | 实际**橙色是 WAGO 221 系列的标志色（拨杆）** |
| 结论固化太快 | 看到"电路符号"就认定是继电器原理图 | 那是 WAGO 端子上的**接线示意图**（哪个孔接哪根线），不是继电器符号 |

### 3.5 初版判断原文（保留供追溯，已作废）

> **以下为初版（18:36–19:00）判断，现已作废：**
>
> 「4 颗'继电器'经 8× 放大确认是**插座底座（socket）不是继电器模块** —— 壳内无 PCB，只有金属簧片 + 橙色标签；标签印的是 `Cu 1.6/2` / `AWG 24-12 0.14/0.2-4` / `20A 300V` / `450V 32A` 这类**接线规格**（只有底座才标线径），带 UL+PSE 认证。
> **插座底座不能直接接 ESP32 GPIO**（线圈电流 30–90mA 会烧 IO），必须先翻找套件里有没有带 PCB+光耦的继电器模块（套件第 16 项，48 件只拍了 4 袋）；若无则三选一：换光耦隔离 MOS 管模块（3–5 元，接口与继电器模块一致，**推荐**）/ 自搭三极管驱动（要多焊 3 点且改主程序引脚逻辑）/ 用底座+本体+驱动电路。
> ⛔ **核实前不要接泵回路。**」

**作废原因**：把 WAGO 通用快接端子误判为继电器插座底座。**教训：认器件先查品牌与型号，再看结构；标签上的认证标志是查证入口，不是装饰。**

---

## 四、文档改动清单

| 文件 | 改动 |
|---|---|
| `docs/参考资料/花房借用与自购清单.md` | 新增「一.5 到货实拍核对」节；已买表**加"到货"列**逐行标注；WAGO 端子到货确认 |
| `docs/花房项目_AI工作交接文档_2026-10-18.md` | 升 **v2.5**，记本轮到货核对 + WAGO 更正 + 继电器待核项 |
| `docs/花房30天执行计划.md` | 物料状态段更新（W1 硬件就绪度） |
| `docs/审计报告/AR14_GreenHouse硬件到货实拍核对_2026-10-23.md` | 本报告 |

---

## 五、行动项

| # | 事项 | 负责 | 期限 |
|---|---|---|---|
| 1 | ~~翻找套件剩余袋子确认继电器模块~~ → ✅ **已解决：继电器模块（16 号）10/26 周一可从实验室借到**（领导 19:31 告知） | 领导 | **10/26** |
| 2 | **借电烙铁 + 焊锡丝**（套件不含）—— ⏳ **10/26 能否借到「不确定」**（19:44 告知）。⚠️ **但不再是卡点**：公对母线公头直插（零工具）可当天完成标定；借到烙铁则改走焊排针 | 领导 | 10/26 尽量 |
| 3 | 借万用表（建议） | 领导 | 10/24 |
| 4 | 借到烙铁后按 `docs/土壤传感器焊接操作卡_2026-10-21.md` 焊排针 + 标定 | 领导 | 10/25 |
| 5 | 确认**水泵 / 硅胶管 / M3 沉头螺丝 + PH1 螺丝刀**是否到货（WAGO ✅ 已确认，10/19 自购的 221 系列到货 4 只） | 领导 | 10/24 |
| 6 | **3D 打印开打**（11/5 死线，剩 13 天） | 领导 | **10/24** |

---

## 六、已知限制

- 照片 4 中的「蓝色 PCB 小模块 + 排针」因隔着塑料袋反光，**型号未能确认**（可能是排母、可能是模块）。已标 ⏳ 待定。
- ~~套件 48 件未拍全，第 16 项继电器模块待复核~~ → ✅ **已确认 10/26 可借到（19:31 领导告知）**，此项闭合。
- WAGO 端子**具体是 221-412（2线位）还是 221-413（3线位）未逐只核对** —— 照片中两组标签不同（`SET 20A 300V` 与 `450V/32A`），可能是不同规格混装。**接线前逐只确认线位数**。
- 红色元件袋内 1N4007 的**具体数量未逐个清点**。

---

## 七、更正记录

| 时间 | 事项 | 处理 |
|---|---|---|
| 10/23 18:36 | 首版发布。§三 判断 4 颗器件为「继电器插座底座」 | 已作废（见 §3.5） |
| 10/23 19:05 | **领导指正：「是万可的连接头」** | 接受并联网查证 WAGO 官方规格，7 项标签特征逐条对上 → **确认为万可 WAGO 221 系列快接端子** |
| 10/23 19:10 | 修订 §二/§三/§四/§五/§六，本节 | 交接文档升 v2.5；借用清单、30 天计划同步更正 |
| 10/23 19:44 | **领导告知：10/26 实验室一次性全给**（传感器模块+面包板+杜邦线+继电器）；**电烙铁+焊锡丝「不确定」** | ✅ **最坏档排除**。⚠️ 烙铁虽不确定但**不阻塞标定** —— 公对母线**公头直插**零工具即可（档 A）；借到则走焊排针（档 B）。另：**EN_DHT+EN_OLED 组合编译 PASS（400,757 B / 30%）**，DHT/U8g2 库均已装，10/26 现场不调代码 |
| 10/23 19:31 | **领导告知：继电器模块（16 号）10/26 周一可从实验室借到** | ✅ **继电器问题闭合** —— 与 W2-D8 原计划同一天，**零延误**；「买光耦 MOS 模块」建议作废。**但真正卡点转为「标定→烙铁」**（9.3 里程碑要 `EN_WATER=1`）|

### 更正带来的实质变化

| 项 | 更正前 | 更正后 |
|---|---|---|
| 这 4 颗是什么 | 继电器插座底座（待翻找模块） | **万可 WAGO 221 快接端子**（10/19 自购项，已到货） |
| 泵回路端子 | 未知 | ✅ **4 只在手，450V/32A，两个三通节点够用** |
| 免焊方案 B | 依赖"待到货" | ✅ **实物在手，烙铁借不到也能立刻走** |
| 继电器模块 | 以为这 4 颗是、且性质存疑 | ✅ **已闭合：10/26 可从实验室借到，零延误，主程序逻辑不用改** |
| 「买光耦 MOS 模块 3–5 元」建议 | 列为推荐 | **作废** —— 继电器 10/26 可借，不必再花这个钱 |

### 方法论教训

1. **认器件先查品牌，不要先套结构模板。** 标签上有 UL 认证标志 → 先查这家是谁的产品，而不是从"透明壳+金属簧片"倒推品类。
2. **"某个特征只有某类产品才有"这种推理最危险** —— 我当时认定"只有继电器底座才标线径"，实际上一款覆盖各种线径的通用快接端子**必然**标线径。特征要双向验证，不能单向排除。
3. **颜色不是鉴别特征** —— 橙色在 WAGO 221 是拨杆的颜色，不是"铜触点"。
4. **领导指正时先查证再改口** —— 本次是领导指正 + 官方规格 7/7 对上，两个独立来源互相印证才落笔。
