huankechong/smart-greenhouse/docs/参考资料/花房3D建模入门路线_SolidWorks.md

# 花房 3D 建模路线与模型清单（SolidWorks 学生正版）

> 配套《Introduction to Project Work》花房 Final Project · 产出目标：实验室拓竹 X2D 可直接打印的外壳/支架  
> 版本 **v3.0** · 2026-10-18 · 小马（v1 Onshape 版已废弃；v2.0 转 SW；v3.0 交付路线变更（本章顶部有说明））  
> 原则：**不为学软件而学软件**——每个练习都直接产出花房要用的零件，学完即交付  
> 状态：**SW 2026 已装好并激活**（2026-10-18，本体 D:\Appdata\SolidWorks\，365 天至 2027-10）

> ## ⚠️ 先看这条：本文档现在不是交付路径
>
> **10 个打印件已经全部用参数化脚本出好 STL 并按实物实测定稿**（含 2026-11-08 新增的 11 光敏小柱）（02 水泵座 2026-10-24 作废；见 `outputs/3D打印件/花房3D_P0/`、`outputs/3D打印件/花房3D_P1P2/`、`outputs/3D打印件/花房3D_整机底盘/`、`outputs/3D打印件/花房3D_水箱盖/`），
> 你**不需要照着下面的 Day1–Day4 再画一遍**。这些零件尺寸会随实物变，手工画的模型改一次要重画，
> 参数化脚本改一个数字就能重出 STL / 装配 / HTML 全套。
>
> 本文档现在的三个用途：
> 1. **零件清单与设计依据**（下面「一·补」，已按现行状态校正）
> 2. **SW 查看/微调教程**（Day1–Day4 仍可当学习路径，但要改的零件请改脚本，不要在 SW 里重画）
> 3. **报告素材**：课程明说「自建模」是加分项 → 交**参数化脚本 + 装配体 + 工程图截图**同样成立；
>    更硬的讲法是「改一个参数重出全套，8 处装配干涉验证为 0」
>
> 打印/装配/五金请看 `outputs/3D打印件/花房3D_整机底盘/交付说明_整机底盘两片式v1.md`。

## 一、4 天核心技能路线（每天 30–60 分钟）

> SolidWorks 自带官方教程：菜单 **帮助 → SOLIDWORKS 指导教程**（中文，跟完前 3 课 ≈ 覆盖 Day 1 全部内容），配合下表练习效果最好。

### Day 1｜草图 + 拉伸凸台：传感器支架（60 分钟）

**学**：草图（矩形/圆/智能尺寸/完全定义）→ 拉伸凸台/基体 → 圆角  
**练**：土壤传感器 L 型支架（托住传感器板 + 两个 M3 螺丝孔）

| 步骤 | 操作 | 要点 |
| -- | --- | --- |
| 1  | 新建 → 零件 | 界面：前视/上视/右视三个基准面 |
| 2  | 前视基准面 → 草图 → 画 L 形轮廓 | L 臂长按传感器板实测（到货后量） |
| 3  | 智能尺寸（S 快捷键）标注 | 每条边被尺寸/几何关系锁死，状态栏显示"完全定义"才算合格（不能有蓝色欠定义线） |
| 4  | 特征 → 拉伸凸台，厚度 3mm | 打印件壁厚 ≥2mm |
| 5  | 特征 → 圆角 R2 | 去锐边，打印更稳 |

**验收**：草图完全定义 + 零件另存为 STL（文件 → 另存为 → 类型选 .stl → 选项 → 分辨率选"精细"）

### Day 2｜旋转 + 圆周阵列 + 抽壳：蓄水瓶盖（60 分钟）

**学**：旋转凸台（Revolve）→ 圆周阵列 → 抽壳  
**练**：水泵出水口对接盖（圆盘 + 中心孔 + 环形加强筋）

- 旋转 = 画一半截面 + 中心线，绕轴转一圈 → 圆形件标准做法
- 抽壳 2mm 做盆/盖类
- 阵列 4 根辐条练 Circular Pattern（特征阵列）

**验收**：一个带中心孔的圆盖 STL

### Day 3｜参考基准面 + 异型孔向导：双色 LED 灯座（45 分钟）

**学**：新建参考基准面 → 异型孔向导（Hole Wizard）→ 打印件孔不用攻螺纹（自攻）  
**练**：LED 灯座（圆柱凹槽嵌 5mm LED + 两孔走线）

**验收**：灯座 STL + 能说清"为什么要建参考平面而不是直接在面上画"

### Day 4｜装配体 + 打印前检查（45 分钟）

**学**：装配体（Assembly）基础 → 插入零件 + 同心/重合配合 → 干涉检查（评估 → Interference Detection）→ STL 打印性自查

| 打印自查项 | 标准 |
| ----- | --- |
| 壁厚 | ≥2mm |
| 悬垂 | <45° 或加支撑 |
| 孔径 | M3 过孔打 3.2mm（FDM 热胀缩孔） |
| 底面 | 平整、面积够大（首层粘床） |
| 尺寸 | 对照实物再核一遍 |

**验收**：支架+瓶盖+灯座插入装配体 → 干涉检查零干涉 → 3 份 STL 拷 U 盘

## 一·补、模型清单（画什么——按答辩演示倒推）

### P0 必打：核心功能件（缺了演示不成立）

| # | 模型 | 作用 | 关键尺寸依赖 | 建模日 |
| - | --- | --- | --- | ----- |
| 1 | **土壤传感器盆沿挂钩**（现行 01b） | 领导要求盆里不放支架：∩ 形夹爪跨盆沿 + 斜臂带板斜插入土（8°，入土 62mm）。**晃动会改变介电常数读数，破坏标定值** | 盆沿壁厚（夹口 5.6 待实测 → 壁厚+0.6）、PCB 宽×厚 | 已出 STL |
| 2 | **水泵固定座** | 底吸泵卡在水箱底：防倒、防震动移位、出水管定向 | 泵体底径×高（实物为准） | Day 2 |
| 3 | **水管末端固定夹** | 夹花盆沿，出水口定在土面上方固定点——浇在哪、浇多深可复现，答辩讲"浇一段停一停复测"时的证据链 | 水管外径（约 8mm，实测） | Day 2 |

### P1 强烈建议：演示专业感件（答辩加分）

| # | 模型 | 作用 | 备注 | 建模日 |
| - | --- | --- | --- | ----- |
| 4 | **OLED 45° 斜面支架** | 屏幕斜朝观众，评委隔桌看清实时数据 | OLED 外形尺寸（套件 25 号件） | Day 3 |
| ~~5~~ | ~~状态灯扩散灯罩~~ | **已取消（10-18）**：没有半透明耗材，白色 PLA 不透光；状态灯改为裸 LED 直接露出 | — | — |
| 6 | **整机底盘（两片式）**（现行 06a/06b/06c） | 320×230 超 X2D 床面 256×256，拆成 2×160×230 + 齐平连接块；答辩一次端走整机 | 花盆底径、水瓶外形、面包板孔距 | 已出 STL |

### P2 可选：时间富余再做

| # | 模型 | 说明 |
| - | --- | --- |
| 7 | DHT11 小座 | 探头悬植株上方，测叶面环境而非桌温 |
| 8 | 扎线固定座 ×3–4 | 走线整齐，报告照片好看 |
| 9 | 全包外壳 | ⚠️ **这次不做**——包容结构容错低、首版返工率高，W3 赌不起；答辩讲"外壳作为量产化方向"是留白加分 |

### 容器外购清单（10-18 更新，对齐 DeepSeek 整机装配模型尺寸）

模型基准：花盆 = 上口内径 74/外径 82、下底 58、高 85mm 锥形陶盆；水箱 = 118×90×60mm 剖壁敞口盒。

| 物品 | 搜索词 | 规格 | 预算 | 说明 |
|---|---|---|---|---|
| **花盆** | 淘宝"红陶多肉盆 8cm 无孔" | **口径 8 / 外径 9.5 / 高 8cm，无孔** | ¥3–9 | 与模型 1:1（潮州通货规格）；无孔=桌面不渗水；红陶盆沿圆度好，传感器挂钩式支架（挂 R37–41 盆沿）贴合更稳。备选：土立方园艺清仓款 ¥8.9；义乌购元裕 ¥3.25（10 个起批，可拼单） |
| **水箱** | 京东"保鲜盒 长方形 透明 14x9x6" | **14×9×6cm 平盖简款**（不带分隔/卡扣锁） | ¥7–15 | 常见规格 12×8×5 / 12.5×8.5×5.5 / 14×9×6 均可；透明可见水位；平盖好走泵线和水管；搬运盖盖防洒、演示掀盖 |

水箱差几毫米无妨——底座两片式（06a/06b）安装位有 ±3mm 调整余地，真正卡尺寸的整流罩类件设计中没有。原"FDM 层线渗水 + 水箱占机时 20–30h 不打印"的 make-vs-buy 决策不变，写进答辩叙事。

> **下单时点：等 10/21 硬件到货摆完再买**——ESP32/水泵/管路实际占位可能让水箱改选更紧凑的 12×8×5。

### 五金采购（10-18 更新，按 DeepSeek 底盘 BOM）

套件 A 套餐第 12 项"五金包"到货当天先盘点，但按"没有 M3 自攻"做准备。P0/P1P2 多为免螺丝结构（过盈槽/重力自锁/卡扣），总需求很小：

| 五金件 | 规格 | 数量 | 说明 |
|---|---|---|---|
| **自攻螺丝** | **M3×6 沉头自攻**（⚠️ 底盘 v1.2 改版后现行规格：头沉进 1.8mm 窝内与板面齐平；M3×8 会穿出底面 1.8mm 刮桌面，M3×10 穿 3.8mm——**只买 M3×6**） | 8（连块固定）+ 备用 | 拧进 φ2.8 引导孔，**不需要螺母** |
| 定位销 | φ4×16 | 2 | **不用买**——4mm 钻头柄/光轴/剪断钉子 DIY |
| 扎带 | 3mm 宽尼龙 | 若干 | 电子底板 10 个 3×10 过孔走线用，可选 |
| 螺丝刀 | PH1 十字 | 1 | 家里有就跳过 |

**一包解决**：淘宝/京东搜「M3 自攻螺丝 6mm 沉头」（50–100 颗装 ¥5 左右，选送 PH1 螺丝刀的店），同店凑「3×100 尼龙扎带」¥3。**与容器同单下单**（10/21 硬件到货盘点五金包后一次买齐，省运费）。

### 打印策略

- **一批打完**：全是小件，X2D 256×256 底盘一版排下，P0+P1 六件+备用件一次提交
- **双色分配**：~~白主体 + 半透明灯罩~~ **已于 10-18 取消**（无半透明耗材），全部单色白 PLA
- **公差预留**：孔 +0.3mm、卡扣间隙 0.3mm——首版就是拿来试错的
- **每件 ×2**：料钱忽略不计，坏一件不误事

## 二、跟练资源

| 资源 | 用途 |
| --- | --- |
| 软件内置"帮助 → SOLIDWORKS 指导教程" | 官方中文，Day 1 前置  |
| B 站搜"SolidWorks 入门 草图 完全定义"  | Day 1 加深 |
| B 站搜"SolidWorks 手机支架 建模" | 综合练手（结构与你支架同构） |
| B 站搜"SolidWorks 导出 STL 3D打印" | Day 4 导出设置 |
| 拓竹 X2D / Bambu Studio 切片入门 | Day 4 后衔接打印 |

> 到货前先把 Day 1 的传感器尺寸留空，**实物到手量完再填**——花房项目"实测标定"的思路在建模里同样适用。

## 三、排进 30 天计划的位置

不新增负担，插空做（均在宿舍 🖥）：

| 时间 | 动作 |
| --- | --- |
| 本周空窗期（等快递，10/18–10/21） | ✅ SEK 申请+安装+激活已完成 → 指导教程前 3 课 + Day 1 画 P0-1 支架（尺寸占位） |
| W1-D5（10/22 前后，传感器到货）  | **卡尺实测全部尺寸 → 回填 P0 三件**（半小时）+ Day 2 画 P0-2/3 |
| W2 周末 | Day 3 + Day 4 画 P1 三件 + 装配体干涉检查 + 全部导 STL |
| **W3 周二（11/3）前** | 提交打印（留 2 天缓冲到 11/5 死线） |
| W3 周末试装 | 不合的改，W4 周初重打（唯一返工窗口） |

## 四、红线与提醒

- **不用老师发的网盘破解版**：管理员运行来路不明 exe + 断网防验证 = 恶意软件重灾区；且盗版在高校项目里有合规风险。官方学生版免费且更省事，没有理由冒险
- 每个零件**先量后画**：3D 打印"差 1mm 就废"的返工比代码 bug 更贵
- 学生版文档若用于报告截图，序列号（9020 开头）**打码**——凭据不入报告
- X2D 是双喷头机，可打双色（外壳白 + 状态灯窗口红）——Day 4 后可探索，答辩加分项
- 万一官方申请卡在邮箱验证（个别高校邮箱收不到）：先用 30 天试用版顶上，同时等老师 SDK-ID 回复，两条路总有一条通

---

*存放：`docs/` + E 盘 `花房项目/docs/` 同步一份*
