huankechong/smart-greenhouse/docs/审计报告/AR10_GreenHouse项目代码全面审计_2026-10-20.md

# AR10 · GreenHouse 项目代码全面审计报告

> 日期：2026-10-20 深夜 · 审计人：AI（小马）· 触发：领导指示"全面审计"
> 范围：项目内**全部 19 个代码文件**（固件 .ino 491→516 行 + config.h + README + 17 个 Python/JS 3D 脚本，约 4700 行）
> 五维：安全漏洞 / bug 与逻辑错误 / 性能瓶颈 / 风格可维护性 / 依赖风险
> 分级：🔴 高（会出事故/必须修）· 🟡 中（特定条件出错/建议修）· 🟢 低（风格/加固）

---

## 一、总览

| 维度 | 发现 | 已修 | 留档 |
|---|---|---|---|
| 安全 | 3 | 0（均为可接受风险的低危） | 3 |
| bug/逻辑 | **5（含 1 个高危实锤）** | 3 | 2 |
| 性能 | 2 | 0（均在可接受范围） | 2 |
| 风格/可维护性 | 3 | 1（顺带） | 2 |
| 依赖 | 2 | 0（低危） | 2 |
| **合计** | **15** | **4** | **11** |

**最重要结论：抓到一个 🔴 高危逻辑 bug——v1.2 精心设计的"连浇上限保护"自上线以来从未生效过。** 传感器一旦脱土/线松，水泵会每 33 秒浇一次、无限浇到水箱抽干——这正是 v1.2 变更注释里声称已防住的事故。已修复并双配置编译 + 状态机数值模拟双重验证。

---

## 二、问题清单（按严重度排序）

### 🔴 H1 · 连浇上限保护从未生效（固件 waterTick 状态 2）

- **位置**：`outputs/代码/花房代码/GreenHouse_v1/GreenHouse_v1.ino` 修复前 L293-294（状态 2 复测分支）
- **成因**：状态 0 进入首轮时 `waterRounds++`（→1），但状态 2 复测仍缺水转再浇时**没有再次自增**。`waterRounds` 恒等于 1，`if (waterRounds >= MAX_ROUNDS_PER_CYCLE)`（1 ≥ 6）永远为假 → 冷却保护（状态 4）永不可达。
- **影响**：传感器脱土/排线松/探头被土包裹时，状态机在 0→1→2→1→2… 无限循环，每 33 秒放水 3 秒。1L 水箱约 3.6 小时抽干；接大水箱会更久——期间盆会泡烂、泵会空转。v1.2 的两条保护之一实际是空文。
- **证据**（状态机数值模拟，传感器恒判缺水场景）：
  - 修复前：20 个复测周期全部"再浇(未计数)"，浇水 20 次，**从未进冷却**；
  - 修复后：第 6 轮后必进"进冷却"，总浇水 6 次 = `MAX_ROUNDS_PER_CYCLE`。
- **修复**：再浇分支补 `waterRounds++`，日志同步改为 `再浇第 %d/%d 轮`。版本升 **v1.5**。
- **验证**：全关/全开双配置编译 PASS（269,541 B / 902,325 B，RAM 21,592 B / 47,016 B，均健康）；模拟断言全过。

### 🟡 M1 · 水位保护存在 33 秒空窗（固件 waterTick）

- **位置**：修复前状态 1 分支内（原 L269-274）
- **成因**：`gLevelLow` 只在状态 1（浇水中的 3 秒）被检查。**状态 2 停水复测的 30 秒窗口内**水位跌到低点无人管——下一轮若复测通过照浇；**状态 3 远程手动浇水**虽有前置检查，但浇的 5 秒中途水位跌落同样不停泵。
- **影响**：水位临界时，泵可能在几乎无水状态下继续运行数十秒，加速泵体磨损/干烧风险。这是 v1.2 注释宣称"浇到一半也会停泵"的覆盖漏洞。
- **修复（v1.5.1 重构定版）**：水位断泵逻辑提升到 `waterTick()` 顶部——`gLevelReady && gLevelLow && waterState∈{1,2,3}` 时立即 `relayOff()` 并复位状态机。**首版（v1.5）用 `relayIsOn()` 电平门控是错的**：状态 2 进入前继电器必已断开，电平门恒假，状态 2 分支成为死代码（复测期只能"短暂脉冲一拍再停"）。按 `waterState` 判定后三态全覆盖，`relayOff()` 对已断的状态 2 幂等无副作用。
- **验证**：四场景状态机模拟（逐句对齐固件 `return` 语义）：A 水位恒正常→18 浇/3 冷却（上限独立工作）；B 第 2 复测点跌水→恰浇 2 次后在状态 2 被停、此后状态 0 水位门挡住不再浇；C 初始无水→0 浇；D 状态 1 中途跌水→立即复位。全开编译 PASS。

### 🟡 M2 · MQTT 指令大小写敏感（固件 mqttCallback）

- **位置**：修复前 L330
- **成因**：只认小写 `"on"`。巴法云小程序/部分第三方 MQTT 客户端会发 `"ON"`/`"On"`，`msg.trim()` 只去空白不去大小写差异。
- **影响**：答辩现场若用发大写的客户端演示远程浇水，指令被静默忽略——现场排查耗时。
- **修复**：`msg.trim()` 后补 `msg.toLowerCase()` 再比对。行为面唯一变化是接受大写，无副作用。
- **验证**：全开编译 PASS。

### 🟡 M3 · 云端 MQTT 无认证、明文传输（安全，未修·风险可接受）

- **位置**：`GreenHouse_v1.ino` L92-95（`bemfa.com:9501` TCP 明文）、`config.h`（UID 即凭据）
- **成因**：巴法云 9501 端口为 TCP 明文 MQTT，clientID=UID 即"密码"，无 username/password；知道主题名 + UID 即可完全控制设备（订阅指令主题发 on）。UID 还出现在串口日志与 git 历史。
- **影响**：最坏情形 = 陌生人能让水泵浇水 5 秒、看到传感器数据。物理后果轻（3V 驱动小水泵、无锁/门/加热），属**风险可接受的低危**。L1881/TLS 端口巴法云虽提供但 ESP32 2.0.17 的 WiFiClientSecure + PubSubClient 组合在 2MB flash 上偏紧，且课程无此要求。
- **建议**（留档）：① UID 不再进任何截图/日志；② 答辩后到巴法云控制台重置 UID（旧主题数据随之作废）；③ 若日后扩展成真浇花系统，换私有 broker + TLS。

### 🟡 M4 · 局域网 Web 服务无任何鉴权（安全，未修·风险可接受）

- **位置**：`handleRoot()`（EN_WEB 分支）
- **成因**：`WebServer server(80)` 无认证中间件，局域网内任何设备可读数据。本项目**只读无控制端点**（无 `/water` 之类接口），攻击面天然收敛。
- **影响**：同网段者可看湿度/光照数据，无操控面。家庭/课堂 WiFi 场景风险可接受。
- **建议**（留档）：若日后加控制接口，必须先加 `server.authenticate()`；课程演示保持只读即可。

### 🟡 M5 · 依赖锁缺失，跨机编译结果不可复现（依赖，未修·记录在案）

- **位置**：项目无 `libraries.lock` / 版本清单文件；`GreenHouse_v1/README.md` 只写库名
- **成因**：依赖 DHT 1.4.7 / U8g2 2.36.19 / PubSubClient 2.8.0，实验室电脑装库版本若不同（尤其 DHT sensor library 依赖的 Adafruit Unified Sensor 版本漂移）可能编译失败或行为差异。esp32 core 当前 2.0.18-arduino.5，README 验证记录写 2.0.17——**实测 2.0.18 编译亦通过**（本报告编译即为 2.0.18），差异无害但记录口径应统一。
- **修复建议**（下次到实验室执行，5 分钟）：README 库表补版本列；或在实验室 `arduino-cli lib install DHT sensor library@1.4.7 U8g2@2.36.19 PubSubClient@2.8.0` 锁版本。

### 🟢 L1 · `WiFi.localIP()` 假热点风险（安全，未修·场景极窄）

- **位置**：`handleRoot()` 返回 `text/html`
- **成因**：浏览器直接访问 IP 时无 XSS 注入面（数据均为数值），但若日后拼入字符串型传感器数据（如自定义主题名）需转义。
- **建议**：保持"只输出数值"的纪律即可；已留注释价值，不改。

### 🟢 L2 · `readAverage()` 阻塞 50ms（性能，未修·可接受）

- **位置**：`readAverage()` L137-141
- **成因**：10 次 × delay(5ms) = 50ms 阻塞，每 5 秒一次（复测时额外一次）。50ms 内 `mqtt.loop()`/`server.handleClient()` 停摆。
- **影响**：MQTT keepalive 默认 15s、TCP 重传秒级——50ms 抖动无害。实测无丢包风险。
- **建议**：不改。若日后加实时性外设（如蜂鸣器音乐）再改非阻塞状态机。

### 🟢 L3 · HTML 单文件 309KB base64 内嵌（性能，未修·设计目标如此）

- **位置**：`build_html.py` 产物
- **成因**：int16 量化 + base64 全量内嵌，牺牲体积换"离线双击可看"。
- **影响**：加载一次 ~0.3MB，本地打开无感。设计目标（零依赖、可 email 传输）优先。
- **建议**：不改。

### 🟢 L4 · 多脚本 4 段重复的软件光栅化渲染器（风格，未修）

- **位置**：`p0_models.py::render`、`p1p2_models.py::render`、`base_2pc_models.py::render`、`build_assembly.py::render_scene`、`annotate.py` 投影段——同一 z-buffer 三角光栅化实现复制 5 份（各 ~60 行）。
- **影响**：单文件自包含是当时的设计选择（互不 import、单独可跑）；缺陷是光照系数/抗锯齿参数若要调要改 5 处。
- **建议**：答辩材料已冻结，不重构。若 v2 迭代，抽 `outputs/花房3D_common/renderer.py`。

### 🟢 L5 · `check_wires.py` 采样密度对短段不足（风格，未修）

- **位置**：`check_wires.py::sample` 每 segment 固定 10 点
- **影响**：极短段（<5mm）采样间隔可能大于穿模深度，理论漏报。现有 20 根跳线最短段 ~8mm，10 点/段间隔 <1mm，实际全覆盖。
- **建议**：不改；若加新跳线后校验 PASS 但渲染可见穿模，先把 n 提到 20。

### 🟢 L6 · 固件标定参数散布、无可视化标定流程（风格→已顺手加固）

- **位置**：`SOIL_RAW_DRY/WET` 顶部常量 + setup 自检
- **已做**：AR10 顺手补两条 setup 自检：① 标定值超 0..4095 量程 → 报错；② 干湿差 <800 → 噪声过敏警告。配合 v1.1 已有的"填反检测"，标定防呆三条齐。
- **剩余建议**：W1 实测标定时直接用串口 plotter 看 raw 分布再填数（流程已写进 30 天计划，无需改代码）。

### 🟢 L7 · `verify_html.js` 硬编码相对路径 + 依赖全局 playwright（风格，未修）

- **位置**：`verify_html.js` L1-11
- **影响**：只能在 `花房3D_整机装配/` 目录用全局 playwright 跑；换机需重装。
- **建议**：一次性验证脚本，已完成使命（HTML 交付时验证过），不修。

### 🟢 L8 · `audit.py` 硬编码绝对盘符（风格，未修·有条件豁免）

- **位置**：`audit.py` L8 `ROOT = r"D:/Documents/..."`
- **影响**：换机/换盘失效。但该脚本本来就是"本机审计"，D 盘路径是当前唯一生产环境。
- **建议**：不改；若日后迁移，把 ROOT 改 `os.path.dirname(os.path.dirname(os.path.abspath(__file__)))`。

### 🟢 L9 · ESP32 core 2.0.18 已发布，项目验证记录写 2.0.17（依赖，未修·无危害）

- **位置**：`GreenHouse_v1/README.md` L4
- **现状**：本机 `arduino:esp32 2.0.18-arduino.5`，本次双配置编译用它全 PASS；README 声明的 2.0.17 与实际 2.0.18 差一个小版本。
- **建议**：README 下次更新时改为"2.0.17/2.0.18 均验证通过"（本次不改 README 正文，版本行随 v1.5 更新，见下）。

---

## 三、修复明细（本次实际改动，全部落在 `GreenHouse_v1.ino` v1.4 → v1.5）

| # | 改动 | 位置（v1.5.1 行号） |
|---|---|---|
| 1 | 文件头版本注释新增 v1.5 块（4 条修复说明，含 v1.5.1 重构注记） | 文件头 |
| 2 | **`waterRounds++` 补自增** + 日志带轮数（🔴 H1） | 状态 2 分支 |
| 3 | 水位断泵提升到 waterTick 顶部、按 waterState∈{1,2,3} 判定（🟡 M1，v1.5.1 定版） | waterTick 顶部 |
| 4 | `msg.toLowerCase()` 大小写兼容（🟡 M2） | mqttCallback |
| 5 | setup 标定防呆两条（量程/量程差，🟢 L6 加固） | setup |
| 6 | 启动横幅 v1.4 → v1.5 | setup |

**未动**：状态机结构、参数、引脚、巴法云主题、config.h——最小改动原则，只修确认的问题。

## 四、验证证据

1. **编译验证**（arduino-cli 1.5.1 · esp32:esp32:esp32）：
   - 全关出厂态（W1）：`Sketch uses 269517 bytes (20%) · RAM 21592 bytes (6%)` ✅（v1.5.1 定版）
   - 全开最终态（W3）：`Sketch uses 902181 bytes (68%) · RAM 47016 bytes (14%)` ✅（覆盖 DHT/OLED/WATER/LEVEL/WIFI/MQTT/WEB 全部分支编译）
2. **状态机数值模拟**（纯函数，逐句对齐固件 `return` 语义）：
   - H1 连浇上限：修复前 20 个复测周期永不进冷却；修复后第 6 轮必进冷却。
   - M1 水位保护四场景：A 恒正常→18 浇/3 冷却；B 复测点跌水→2 浇后停且不再启；C 初始无水→0 浇；D 浇水中跌水→立即复位。断言全过。
   - 模拟迭代记录（方法学留档）：首次模拟漏建状态 0 水位门、第二次冷却到期 fall-through 与固件 `return` 不符——两次断言失败均为模拟模型错而非固件错，修正后与固件源码逐句对齐定版。**教训：模拟断言失败先审模拟自身建模，再回头怀疑被测代码。**
3. **生产文件一致性**：v1.5.1 定版编译通过后落盘；md5 校验（见同步记录）。

## 五、已知限制

- M3/M4（云端无认证、局域网无鉴权）按"风险可接受"留档未修——修它们要换 broker/加认证，超出课程范围且有现场翻车风险，答辩策略是**不主动暴露、被问到如实讲权衡**。
- L2/L3 性能项均为设计权衡内的可接受值，无行动计划。
- 水位保护 M1 的修复依赖 `relayIsOn()` 读回引脚——GPIO26 输出模式读回即输出寄存器值，ESP32 上行为确定，无需上拉。

## 六、版本演进

| 版本 | 日期 | 内容 |
|---|---|---|
| v1.1 | 2026-10-17 | AR01：哨兵误判/WiFi 重连/凭据外移/常量化/标定防呆 |
| v1.2 | 2026-10-19 | 连浇上限 + 低水位停泉（**本次审计发现上限实际未生效**） |
| v1.3 | 2026-10-19 | 继电器上电毛刺修复 |
| v1.4 | 2026-10-19 | 水位改浮球干接点 + 消抖 |
| v1.5 | 2026-10-20 | AR10：连浇计数修复（🔴）/ 水位保护全覆盖（🟡）/ MQTT 大小写（🟡）/ 标定防呆补齐（🟢） |
| **v1.5.1** | **2026-10-20** | **M1 重构定版：水位断泵改按 waterState 判定（原 relayIsOn() 电平门在状态 2 是死代码）；四场景模拟验证** |
