huankechong/smart-greenhouse/docs/审计报告/AR15_GreenHouse打包桶实测尺寸修订与3D重出_2026-10-23.md

# AR15 · 花房 1L 打包桶实测尺寸修订与 3D 模型重出（2026-10-23）

> **触发**：领导提供到货实测数据 —— 桶底直径 **105mm** / 桶口内径 **120mm** / 外径 **124mm**。
> **结论**：**商品页标注的"上径 136"是错的**（实测 124，差 12mm）。原第 10 件水箱替换盖与整机底盘的圆槽**全部按 136/106 建模**，若照原样打印，盖子套不住桶、底盘槽对不上。**已按实测重出全部相关模型并通过完整验证链。**

---

## 一、问题：实测 vs 建模假设

> ⚠️ **实测分三轮陆续到齐**（领导分次补充）：先「内径 120 / 外径 124」→ 再「**最外侧 132**」→ 再「**桶高 127**」。
> 每补一个数都要重判一次结构，最终结论见下表。

| 参数 | 商品页（原假设） | **实测** | 结构判读 | 后果 |
|---|---|---|---|---|
| 桶口内径 | 120 | **120.0** | 桶口内壁 | ✅ 与标注一致 |
| 桶身口沿外径 | 136 | **124.0** | 桶身口沿（壁厚 = (124−120)/2 = **2.0**） | 🟡 侧壁厚由 1.4 变 2.0，桶内底/泵座/水泵全上移 0.6mm |
| **桶口最外侧** | — | **132.0** | 🔴 **加强翻边外缘**（从 124 再外凸 4mm） | 🔴 **致命** —— 盖必须压在翻边顶面、裙边套 132；按 124 做盖板**浮空 6.4mm** |
| 桶底直径 | 106 | **105.0** | 桶底外径 | 🟡 底盘圆槽 φ108 → φ107（径向余量 2mm） |
| 桶身高 | 120（推算） | **127.0** | 桶身高 | 🟢 桶口沿 z 123→130、盖顶 127→134、浮球杆尖 179→186（**不影响任何打印件**） |
| **翻边高度** | — | **未实测** | 决定裙边能有多深 | ⏳ 暂用 6mm（裙边高必须 ≤ 翻边高） |

**偏差根因**：商品页标的 136 与实测最外侧 132 接近 → 136 应是**含提手座的最大外径**；桶本体口沿外径 124、最外翻边 132。桶口剖面 = 内壁 φ120 │ 桶身口沿 φ124（壁厚2）│ 加强翻边 φ132（外凸4）。

---

## 二、修改范围（三处脚本 + 两份交付说明）

| 文件 | 改动 |
|---|---|
| `outputs/3D打印件/花房3D_水箱盖/p10_tank_lid.py` | `bucket_mouth_od` 136→**124→132**（最终按最外侧翻边）；`bucket_h` 120→**127**；`skirt_h` 8→**6**（必须 ≤ 翻边高）；docstring 与参数注释同步说明"136 是含提手凸缘的最大外径"；裙边内径 136.8→**124.8**、盖外径 142.4→**130.4**（由参数自动派生） |
| `outputs/3D打印件/花房3D_整机底盘/base_2pc_models.py` | `tank_d` 108→**107**（= 桶底 105 + 2 径向余量） |
| `outputs/3D打印件/花房3D_整机装配/build_assembly.py` | 桶常量改为**实测推导**（`BUCKET_*`）；**新增加强翻边环几何**（φ132 × 高6）；**走线 z 改为从 `LID_TOP` 派生**；`BOT_R` 53→52.5、`TOP_R` 68→62、`TANK_T` 1.4→2.0；替换盖的硬编码半径 71.2/68.4 改为常量 `LID_FLANGE_R`/`LID_SKIRT_IR` |
| `outputs/3D打印件/花房3D_整机装配/check_base_fit.py` | **EXPECT 表从硬编码改为从桶实测常量推导**；顺带修正一处**假通过检查点**（水箱槽检查点原写 `@(120,32)`，真实槽心是 `@(85,32)` —— 旧值恰好落在槽内所以一直"通过"，是历史遗留的假通过） |
| 两份 `交付说明_*.md` | 桶尺寸表、盖板/裙边直径、重量 51g→43.4g、几何校验表、浮球杆尖账、容量账（满口水深 101→**114mm**，报警剩水 683→**710ml**）全部同步 |

> 💡 **设计改进**：把 `build_assembly.py` / `check_base_fit.py` 里散落的硬编码半径改为**从桶实测常量派生** —— 今后若再测得新尺寸，改一处常量即可，两侧自动一致，不会再漏改。

---

## 三、验证证据（全部实跑，非目测）

### 3.1 水箱盖重建
```
bbox_mm        : [138.4, 138.4, 10.0]     ← 盖外径 138.4（最初 142.4 → 中途 130.4 → 最终 138.4）
watertight     : true      bodies: 1      z_min: 0.0
volume_mm3     : 35034.9   surface_mm2: 33405.2   triangles: 1860
est_mass_g_PLA : 45.9      （原 51g → 中途 43.4 → 最终 45.9）
geometry_checks: {"水管孔缘-凸台间隙": 7.0, "浮球杆尖-泵顶间隙": 141.5, "errors": []}
```
✅ 几何校验零错误。

### 3.2 **射线法实测裙边内孔直径**（决定能否套住桶的关键尺寸）

沿 36 个方位、多个高度从中心向外发射射线，取首交点半径：

**最终版（按最外侧 132）**：

| 高度 | 内孔直径范围 |
|---|---|
| z=6 | **132.74 ~ 132.80 mm** |
| z=8 | **132.74 ~ 132.80 mm** |

**桶口翻边外径 132.0 → 直径向隙 0.8mm**（FDM 常规配合）✅ 两高度一致，无锥度。
（中间迭代版按 124 时测得 124.74~124.80，同样 0.8mm 间隙 —— 间隙逻辑自洽，只是基准直径不同。）

中心孔首交点半径 5.24~5.25 → **φ10.5** ✅（M10 + 0.5）

### 3.3 整机底盘重建
```
06a_base_left   bbox [160, 230, 8]   watertight OK   单体
06b_base_right  bbox [160, 230, 11]  watertight OK   单体
06c_joint_block bbox [45, 24, 3.5]    watertight OK   单体
```

### 3.4 完整验证链（按 AGENTS.md §3 红线 7 顺序）

| 步骤 | 结果 |
|---|---|
| `p10_tank_lid.py` | ✅ OK，errors 为空 |
| `base_2pc_models.py` | ✅ 三件全部 watertight 单体 z0 |
| `build_assembly.py` | ✅ glb 0.57 MB / 89 几何体（AO 重烘焙 6m23s） |
| `check_base_fit.py` | ✅ **全部通过：落座高度、零干涉、槽孔特征一致** |
| `check_wires.py` | ✅ 22 根跳线，**穿模 0 根** |
| `check_occlusion.py` | ✅ 推荐位置 (-55, 75) |
| `audit.py` | ✅ ③ 文档数字 vs 实际文件 **13 项全 OK** |
| `build_html.py` | ✅ HTML 1.87 MB / 34,694 三角面 |
| `verify_html.js` | ✅ canvas 1230×815 / WebGL 可用 / **无 JS 错误** |

---

## 四、曾经的失败与修正（留痕）

### 4.1 我引入的 4 项校验失败 —— 根因是桶壁厚变化

改完第一版跑 `check_base_fit.py`，报 4 项落座高度偏差 **0.6mm**：
```
!! 水体 底面 z=5.00, 应为 4.4
!! 水泵固定座 底面 z=5.00, 应为 4.4
!! 水泵 底面 z=8.00, 应为 7.4
!! 水泵进水格栅 底面 z=6.80, 应为 6.2
```

**处置**：`git stash` 跑基线对比 —— 基线是「全部通过」，证明是本次改动引入的，**不是历史遗留**。

**根因**：0.6mm 恰好等于侧壁厚变化（1.4 → 2.0）。**不是模型算错，是 `check_base_fit.py` 的 EXPECT 表硬编码了旧壁厚推算值**（`"水体": (4.4, "桶内底 3+壁厚1.4")`）。

**修正**：把 EXPECT 表改为从桶实测常量推导，而非跟着模型输出改数字（保持校验的独立性 —— 桶尺寸是外部实测输入，不是模型输出）。

### 4.2 `build_assembly.py` 里 4 处硬编码半径漏改

`71.2`（盖板半径）×2、`68.4`（裙边内孔）×1、`±71.2`（指位缺口）×2 —— 这些是从旧值 142.4/136.8 手算的常量，**改参数不会自动跟随**。若不改，装配示意里的盖子会比实际 STL 大 12mm。已全部改为常量派生。

### 4.3 桶高 120→127 引起 **4 根跳线穿模**（已修）

桶口沿 z 从 123 抬到 130、盖顶从 127 抬到 134 后，`check_wires.py` 报 **4 根穿模**（线10/11 继电器→水泵、线21/22 浮球→GPIO32）——
原因是走线里**硬编码了旧的盖顶 z**（128/132/131/136），线段直接插进了抬高的盖板里。

**修法（不是简单抬高，而是消除硬编码）**：盖顶相关的 z 一律改为从 `LID_TOP` 派生，
并把线10/11 的路径从「(84,−28,132) 斜穿盖板」改为「在盖板**外侧**爬到 `LID_TOP+2` 再水平走到过线孔正上方，最后垂直下穿」——
后者即使桶高再变也不会穿盖。

复验：**穿模 0 根，PASS** ✅

### 4.4 一处**假通过**的历史遗留

`check_base_fit.py` 的水箱槽检查点写的是 `@(120,32)`，而底盘真实槽心是 `tank_pos=(85,32)`。因为 φ108 的槽范围是 x∈[31,139]，x=120 恰好也在槽内 → 检查一直是"通过"的，但**根本没在检查真实槽心**。已改为 `@(85,32)`。

---

## 五、已知限制与待办

| 项 | 状态 |
|---|---|
| **桶身高** | ⏳ **仍未实测** —— 暂用 120（商品页推算）。影响：桶口沿 z（当前 123）、浮球杆尖位置、浮子跟随高度。**补测后改 `P10.bucket_h` 重跑即可（30 秒）** |
| **桶底厚度** | ⏳ 未实测 —— 暂按侧壁厚 2.0 建模。影响：桶内底 z（当前 5.0）、泵座高度 |
| **提手凸缘** | ⚠️ 未验证是否真的存在。若实物凸缘外径确实是 136，把 `P10.bucket_mouth_od` 改回 136 重跑即可，其余几何自动跟随 |
| audit 报出的 3 项小干涉 | 传感器盆沿挂钩×土壤板 57.2mm³ / OLED 支架×OLED 屏 16.8mm³ / 水管×末端夹 1.2mm³ —— **均为夹持类设计意图干涉**（钩扣板、架夹屏、夹夹管），位置不在桶区域（桶在 x=+85，传感器在 x=−125），**与本次改动无关** |

---

## 六、行动项

| # | 事项 | 期限 |
|---|---|---|
| 1 | **补测桶身高**（卡尺量桶身垂直高度，含盖/不含盖各量一次） | 10/26 借件当天顺手 |
| 2 | 补测后改 `P10.bucket_h` → 重跑 `p10_tank_lid.py` → 同步 STL | 10/27 打印前 |
| 3 | **10/27 打印前必看**：确认桶口有没有提手凸缘 | 10/27 |
| 4 | 打印件试装时重点验：**盖能否套紧桶口**（0.8 径向隙手压到位不晃） | 10/30 试装 |

---

## 七、文档改动清单

| 文件 | 改动 |
|---|---|
| `outputs/3D打印件/花房3D_水箱盖/p10_tank_lid.py` | 参数 + 注释 |
| `outputs/3D打印件/花房3D_整机底盘/base_2pc_models.py` | `tank_d` + 注释 |
| `outputs/3D打印件/花房3D_整机装配/build_assembly.py` | 桶常量实测化 + 盖子半径常量化 |
| `outputs/3D打印件/花房3D_整机装配/check_base_fit.py` | EXPECT 表改为推导式 + 修正假通过检查点 |
| `outputs/3D打印件/花房3D_水箱盖/交付说明_水箱替换盖v1.md` | 尺寸表/结构表/重量/校验表/容量账/到货事项 |
| `outputs/3D打印件/花房3D_整机装配/交付说明_整机示意模型.md` | 桶参数/盖子参数/落座高度/桶半径 |
| `docs/审计报告/AR15_*.md` | 本报告 |
| `AGENTS.md` | 第 3 节红线补一条：**实测尺寸优先于商品页标注** |
