huankechong/smart-greenhouse/docs/审计报告/AR24_GreenHouse_全模型可打印性审计_2026-11-08.md

# AR24 · 全模型可打印性审计（十件逐个）· 2026-11-08

> 触发：领导要求「逐一检查所有已创建模型：尺寸/比例/摆放/干涉/打印范围/壁厚/悬空与支撑/拉丝炒面风险」。
> 方法：STL 几何量测（截面、射线壁厚、法线悬垂聚类）+ 装配干涉（audit.py）+ 各件实测切片记录。
> 结论：**07 已修（v2）；11 有两个硬缺陷（0.4mm 薄壁 + 45° 托盘底面）；03 有一个隐蔽悬空（柱底悬在 25mm 高）；04 的大面积桥接是已知风险；LED 模块与屏架干涉 24.7mm³。**

---

## 0. 判定口径

| 指标 | 判定线 | 说明 |
|---|---|---|
| 悬垂 | 朝下面与竖直夹角 **>45°** 需支撑 | 贴床面（z<z0+0.35）不算 |
| 壁厚 | **<1.2mm** 偏薄（3 道 0.4 挤出线 ≈1.2） | 射线法：面心沿 -法线打射线，首个命中距 |
| 桥接 | 水平朝下天花，按跨度判 | ≤15mm 可接受，>20mm 有塌陷风险 |
| 高宽比 | >2.5 需重点看附着 | 高/最小底边 |
| 床面 | 256×256（X2D），含 brim | 06a/06b 160×230 + brim8 = 176×246 ✅ |

---

## 1. 逐件结果

### 01b 土壤传感器土插支架 ✅ 可打（低风险）
- 27×15×71，19.4g，水密单体；高宽比 4.7（最高的一件）
- 悬垂：**244mm²**，全部集中在 **z=2.0**（四块，每块 61mm²）—— 就是两条土里稳定鳍的下表面，离床 2mm、从柱子侧面悬出 **5.5mm**
- 壁厚：最小 0.68（槽内角），<1.2mm 仅 387mm²（5.8%）
- **风险**：5.5mm 悬臂可以桥过去；高宽比 4.7 → **必须 brim 5 + 单独打**，否则容易被喷嘴推倒
- 建议：不改模型；切片 brim 5、外壁 60%

### 03 水管末端夹 ⚠️ **有隐蔽悬空，建议改打向**
- 15×15×41，3.4g，水密单体
- 悬垂：**119mm² @ z=25** —— 位置正是 **管环柱的整个底面**（15×15 减去 φ10.6 孔）
- 原因：两条插土针（2×6×25）从床面长到 z=25，管环柱从 z=25 才开始 → **柱底是一整块 119mm² 的水平天花，只靠两根 2mm 细针撑着**
- 壁厚：最小 0.52（C 形开口唇口）
- **风险：高**。切片时会把它当 11mm 跨度的桥来打，中间大概率下垂；这也是"打印到一半开始乱丝"的典型位置
- 建议（三选一）：
  1. **翻转 180° 打**（管环柱坐床、两根针朝天）——零改模型，最省事；针 2×6×25 竖着立，注意慢速
  2. 两根针从 2mm 加厚到 **3mm**，并在 z=20~25 之间加一道 **2mm 宽的连接筋**（把悬空切成两段短桥）
  3. 保持原样，但切片时给 z=25 那一层**开支撑**（只这一处，支撑好拆）

### 04 OLED 屏架 ⚠️ 大面积桥接（已按图纸打过，需观察）
- 36×34×39.5，27.7g，水密单体
- 悬垂：**734mm²**，其中 **672mm² @ z=10~15** = **裙墙内腔的天花**（我特意用两条内筋把它切成 ≤15mm 的格子），另有 39mm² @ z=7（前唇下沿）、23mm² @ z=35~40（顶部过线口内沿）
- 壁厚：最小 **1.12**（<1.2mm 只有 38mm²）——裙墙 3mm、板槽壁 4mm、爪 1.2mm
- **风险：中**。15mm 桥在 0.2 层高下能打，但会轻微下垂；切片器已报 `floating regions`（就是这 672mm²）
- 建议：已打就先看底面平整度；**要重打**的话把内筋从 2 条加到 **4 条**（格子 15→7.5mm），10 分钟改脚本

### 06a 底盘左片 ✅ 可打（两个隐患）
- 160×230×8，277.1g，水密单体；悬垂 0，桥接 0
- 槽底实测：面包板/继电器槽 **3.5mm 底** ✅；**花盆槽底只有 1.0mm**（设计文档写 2mm，实际切到 z=1）
- **隐患 1**：花盆槽 φ82 的底是 **1mm 薄板**，上面坐 8×8×8 盆 + 湿土（约 2~4kg）。PLA 1mm 跨 82mm 会下挠，长期有蠕变开裂风险
  → 补救（不改件）：盆底垫一片 1mm 硬塑料/硬纸板分散压力；或打印时该槽加 2 层实心
- **隐患 2**：盆实际落座 z=1（不是文档写的 2）→ 装配图里盆比实际高 1mm，无视
- 建议：不重打，垫片解决

### 06b 底盘右片 ✅ 可打
- 160×230×11，293.1g；悬垂 0；槽底 5mm（φ107 桶槽）
- 壁厚 <1.2mm 仅 46mm²（槽口棱边）
- 建议：brim 8、单独打

### 06c 连接块 ✅ 可打
- 45×24×3.5，4.2g；悬垂 0；最小壁 0.62（沉孔边）
- 建议：一板两件，brim 3

### 07 DHT 小座 **v2** ✅ 已修好
- 35×34×62.8，23.7g；悬垂从 45° 版的 **812mm² 降到 23mm²**（只剩 z 55~60 的槽口台阶）
- 壁厚最小 **1.97**；高宽比 1.85
- **v1 的失败原因**：喇叭口侧面 44.5°（贴 45° 临界）+ brim 仅 3mm + 高 63mm，外壁翘起后被喷嘴刮倒
- v2：喇叭口 11.25→**14mm 高，倾角 37°**
- 建议：**单独打**，brim **8mm**，外壁 60%

### 08 扎线固定座 ✅ 可打
- 30×16×14，4.8g；悬垂 23mm² @ z=12.3（线槽顶部收口，桥 3.4mm）
- 壁厚最小 **1.68**
- 建议：brim 3

### 10 水箱替换盖 ✅ 可打（按顶面朝下）
- φ138.4×10.5，实体 79.2g / 切片 44.6g
- 按建模朝向（裙边朝下）量：**悬垂 0、桥接 0** —— 说明内腔是斜面/竖壁，没有水平天花
- **必须顶面朝下打印**（裙边朝上）：这样整块平顶坐床，裙边变成竖墙
- 壁厚 <1.2mm 仅 18mm²（棱边）
- 建议：brim 5；若裙边塌，层高降 0.16

### 11 光敏电阻小柱 ❌ **两个硬缺陷，建议改**
- 34×30×33.85，7.7g
- **缺陷 1：托盘侧壁只有 0.4mm**（托盘 34 宽 − 板槽 33.2 宽 = 0.8，两侧各 0.4）
  - 位置：x=±17、z 24.5~28.7，两条 77mm² 的 0.32mm 薄片
  - 后果：装模块时一撑就裂；FDM 上 0.4mm 也只有 2 条挤出线
  - 根因：板宽按 32 估，实测 **31.3**；且托盘只留了 0.6 间隙
- **缺陷 2：托盘底面 45°**，悬垂 **555mm² @ z 20~32**（占全件 11.9%），和 07 v1 同一个临界角
- 其他薄区：196mm² @ 0.26~0.92（过线槽两侧）
- **修复方案（待领导定）**：
  - 板槽改 **32.5×15.3**（按实测 31.3×14.1 单边 0.6）
  - 托盘加宽到 **36**（侧壁 1.75）、加厚到 4.6
  - 托盘倾角 **45°→52°**（底面悬垂降到 38°）
  - 或托盘底面加一道 45° 加强筋（不改变外观）

---

## 2. 装配与摆放（非打印，但影响装不装得上）

| 检查 | 结果 |
|---|---|
| 十件外廓 vs 床面 256×256 | 全部通过（最大 06a/06b 160×230，加 brim8 = 176×246） |
| 件 × 底盘落座 | `check_base_fit` 全过：花盆 z=1（文档 2，差 1mm）、面包板/继电器 z=4.5、LED 模块 z=8、屏架/DHT/光敏/扎线 z=8 |
| 件 × 件 干涉 | **LED 模块 × 04 屏架 = 24.7 mm³**（LED 在 (−22,18)，18.8×13.5 的角伸进屏架底座 x −31.4~−27 / y 21~24.75） |
| 其余干涉 | 均为设计意图：花盆×土壤 17123、土壤×01b 11340、水箱×盖 4827（示意桶简化）、土壤×03 1272、土壤×板 1023、泵嘴×水管 167、01b×板 139（0.1 过盈）、屏架×屏 2.6（爪压量）、光敏座×模块 1.2 |
| 件间净距 | 06a/06b 拼缝 φ4 定位销 ×2 + 06c ×2 + M3×6 ×8，装配图零干涉 |

**LED 模块要挪**：现在的位置和屏架底座角重叠，实物放不进去。建议挪到 **(−17, 14)**（离屏架 4mm、离 LED 孔 24mm，线照样短）。

---

## 3. 汇总：按"要不要改/重打"分级

| 级别 | 件 | 问题 | 处理 |
|---|---|---|---|
| 🔴 必须改 | **11** | 托盘侧壁 0.4mm + 底面 45° | 改板槽/托盘宽/倾角，重出 STL（未打就赚了） |
| 🔴 必须改 | **03** | 柱底 119mm² 悬在 25mm | 翻转打 / 加筋 / 该层开支撑 |
| 🟠 建议改 | **04**（若重打） | 672mm² 15mm 桥 | 内筋 2→4 条 |
| 🟠 应用层 | **07 v2** | 已修 | 单独打 + brim 8 |
| 🟡 装配调整 | **LED 模块** | 与屏架干涉 24.7mm³ | 挪到 (−17,14) |
| 🟡 补救 | **06a** | 花盆槽底仅 1mm | 盆底垫片，不重打 |
| ✅ 通过 | 01b / 06b / 06c / 08 / 10 | — | 按 brim 建议打 |

---

## 4. 拉丝/炒面风险清单（按件）

| 件 | 拉丝风险 | 炒面/坍塌风险 | 关键对策 |
|---|---|---|---|
| 01b | 低（细长，回抽够就行） | **中**（高宽比 4.7） | brim 5、外壁 60%、单独打 |
| 03 | 中（C 形开口窄缝挂丝） | **高**（25mm 高悬空柱底） | 翻转打或加筋 |
| 04 | 中（槽内腔） | 中（672mm² 桥） | 内筋加密 / 慢速桥接 |
| 06a/06b | 低 | 低（大平面，注意翘边） | brim 8、洗板 |
| 06c | 低 | 低 | brim 3 |
| 07 v2 | 低 | 低（37°） | brim 8、单独打 |
| 08 | 低 | 低 | brim 3 |
| 10 | 中（裙边与浮球座之间） | 低（平顶坐床） | brim 5 |
| 11 | 中（板槽窄缝） | **高**（45° 托盘 + 0.4 薄壁） | 改模型 |

---

*小马 · 2026-11-08 · 下一个 AR 编号 **AR25***

---

## 5. 修复执行（同日 21:00 收口）

| 项 | 结果 |
|---|---|
| **07 v2** | 喇叭口 11.25→14（44.5°→37°）；悬垂 812→**23mm²**；实体 23.1→23.7g；已发桌面 |
| **11 v2** | 板槽 33.2×15.2→**32.5×15.3**（按实测 31.3×14.1）、托盘 34→**36**（侧墙 0.4→1.75）、倾角 45°→**52°**（底面悬垂 45°→38°）；悬垂 555→**270mm²**、占 11.9%→5.9%；实体 7.7→8.1g；已发桌面 |
| **LED 挪位** | (−22,18) → **(−17,14)**；与 04 屏架的 24.7mm³ 干涉 **归零**；25 根跳线 0 穿模 |
| **04 加筋** | **未改**——量过内腔：4 根线束占 9.8mm 宽，筋只能放在 x=±7.0（内壁 5.5），14mm 桥最多压到 11mm，收益 <10%；更有效的是**桥接降速到 30mm/s**。若确要改，改 `p1p2_models.py` 的 fins 循环加两条即可 |
| **03** | 保持模型不变，改用**翻转 180° 打印**（管环柱坐床、两根针朝天）；若不想翻，切片时给 z=25 那层开支撑 |
| **06a 盆槽底 1mm** | 不改件；盆底垫 1mm 硬片分散压力 |

命名说明：07/11 返修后**文件名仍沿用 `_v1`**（脚本按 `_v1` 输出）；桌面另存的 `07_dht11_holder_v2.stl` / `11_ldr_stand_v2.stl` 与仓库 `_v1` 是同一份（md5 已核对）。
