huankechong/smart-greenhouse/docs/审计报告/AR21_GreenHouse_DHT11小座造型重做_2026-11-07.md

# AR21 · DHT11 小座造型重做报告（2026-11-07）

> 触发：领导指出「装温湿传感器的模型太丑了」。
> 结论：重做 07 造型，高度/模块槽/装配坐标不变；顺带修掉两处装配错位与一处走线穿模。

---

## 一、原造型的问题（不止"丑"）

| 问题 | 具体 |
|---|---|
| 比例失衡 | 10×10 细方杆顶一块 35×18 平板，像路牌 |
| 头底悬空 | 头比柱宽 25，**单边悬空 12.5mm**——免支撑打印必塌边（靠一根三角撑只补了前侧） |
| 语言不统一 | 三角撑是唯一一处"斜撑"，和屏架/底盘的"斜面 + 倒角"语言不搭 |
| 装配错位（顺带发现） | ① 头部相对底座偏后 8mm；② "DHT11 格栅"画在 y=-45.4，离模块正面 **8.6mm 悬空**；③ 浮球 2 根线从 DHT 柱身穿过 |

---

## 二、新造型

**台锥底座 → 16→12.5 收腰柱 → 45° 喇叭口 → 托盘**（领导选 A 方案）

| 段 | 尺寸 | 角度/说明 |
|---|---|---|
| 底座 | 28×28 → 34×34，高 4.5 | 33.7° 斜面，免支撑 |
| 柱身 | 16×16 → 12.5×12.5，z 4.2→47.5 | 2.4° 收腰（视觉上"站得住"） |
| 喇叭口 | 12.5×12.5 → 35×18，高 11.25 | **x 向 44.4°**（<45，自支撑）、y 向 13.4° |
| 托盘 | 35×18×4.3，槽 30.9×13.9×2.5 | 背面 12×5.2 过线口切穿背壁 |
| 总高 | **62.8**（与旧版一致） | 装配不用重摆 |

**关键收益**：托盘底下不再是平板悬空，而是 44.4° 斜裙 → **全件无悬空**。重切时切片器警告为空（旧版也没有警告，但旧版头底是实打实的 12.5mm 悬臂）。

---

## 三、连带修正

1. **头部居中**：旧版头相对底座偏后 8mm → 新版居中；装配里 DHT 模块从 `y-8` 改到居中（`DHT[1]`）。
2. **格栅归位**：从 `y=-45.4`（悬空 8.6）移到模块正面 `y=-53.7`，3 条改为等距贴在 z 69.4~73.2。
3. **浮球 2 根线改道**：新柱身变粗（16 vs 10）挡住原路径 → 绕到 x=-45 处 y=-48/-47（柱前 4mm 以上间隙），`check_wires` 22 根复检 **0 穿模**。

---

## 四、验证

| 检查 | 结果 |
|---|---|
| 几何 | watertight · bodies=**1** · bbox **35×34×62.8** · z_min=0 · 实体 **23.1 g** |
| 截面 | z=1/3/5/20/46/50/55/58.6/61/62.5 逐层量：29.3→34、15.9→12.6、→35×18，全部居中对称 |
| `check_base_fit` | DHT11 座 z_min=8.0、与底板干涉 0.0 → **全部通过** |
| `check_wires` | 22 根，**穿模 0** |
| 复切 | **34m 35s / 11.2 g / 853 KB**（原 34m22s / 8.9 g）· **无 floating 警告** |
| 九件合计 | 333.2 g / 8h15m |

---

## 五、已知限制

1. 实体质量 23.1g（原 14.9g）——台锥+喇叭口用料更多，但切片实测只多 2.3g（11.2 vs 8.9）。
2. 柱身收腰 2.4°、喇叭口 y 向 13.4°，都远小于 45°，打印无需支撑；**x 向 44.4° 是贴着 45° 极限**，若实打出现轻微塌边，把 `head_w` 35→34 或 `post_t` 12.5→13 即可（两者差 ÷2 = 喇叭高）。
3. 模块槽仍按 30×13 设计，实物卡尺若差 >0.5 改 `mod_w/mod_h` 重跑。

---

*小马 · 2026-11-07 · 下一个 AR 编号 **AR22***
