huankechong/smart-greenhouse/docs/审计报告/AR23_GreenHouse_按实测返修04屏架_2026-11-08.md

# AR23 · 按实物实测返修（04 屏架为主）· 2026-11-08

> 触发：领导发来 8 张实物照片 + 手写尺寸草图（屏幕/光敏/继电器/面包板/小灯/温湿度）。
> 结论：**04 屏架按实测返修（排针在上缘、模块 26.9×28.5）**；继电器槽与 LED 有两处口径不符，记录待办；其余件对得上。

---

## 一、8 个件的实测 vs 模型

| 件 | 实测（mm） | 模型 | 判定 |
|---|---|---|---|
| 屏幕 | **26.9 × 28.5**，4 针在**上缘** | 槽 28.2 × 28.8，过线口在下缘 | ❌ **返修** |
| 光敏模块 | 31.3 × 14.1 | 11 号件槽 33.2 × 15.2 | ✅ 放得下（单边 0.95 / 0.55） |
| 温湿度 | 28 × 13.1 | 07 号件槽 30.9 × 13.9 | ✅ 放得下 |
| 继电器 | **26.2 × 50** | 底盘槽 34 × 25 | ⚠️ **槽装不下**，只能平放板面（槽空置） |
| 面包板 | 55.4 × 82.5 | 槽 84.6 × 55.6 | ✅ 放得下（长边余 2.1） |
| 小灯 | **18.8 × 13.5**（三针模块） | 按裸 5mm LED 做的 φ5.2 孔 | ⚠️ 实物是模块，孔用不上 |

---

## 二、04 屏架返修

| 项 | 旧（11-07 版） | 新（11-08 版） |
|---|---|---|
| 板槽 | 28.2 × 28.8（按 27.3 方板） | **27.9 × 29.5**（按 26.9 × 28.5，单边 0.5） |
| 过线口 | 下缘 13 × 5.5，深 11 + 底座竖槽 | **上缘 13 × 5.5，深 14**（打穿托背，排针+杜邦头从托背上方穿出） |
| 卡爪 | x = ±7.5 | **x = ±10.5**（让开中间 13 宽过线口） |
| 板背元件让位 | 9.5 × 14 × 4.0 | 取消（实测背面是 FPC，无独立 IC） |
| 质量 | 27.4 g | **27.9 g** |

**过线口位置验证**（探针盒布尔）：背板 y=21 在 z=34~41 处开透；排针 (26.17, 40.67)、杜邦头 (24.40, 38.90)、线端 (22.74, 37.24) 三点实体占比均为 **0.00**。

**装配同步**：屏盒 26.9×28.5、屏心 (−45, 36.80, 32.94)；排针/杜邦头移到托背上缘；"驱动 IC" 装饰件删除；4 根跳线改为沿屏背后上行、从背板开口折入。屏×支架干涉 **2.58 mm³**（= 卡爪 0.2 压量，设计如此）。

---

## 三、代价与验证

| 项 | 结果 |
|---|---|
| STL | watertight · **bodies=1** · 36×34×39.5 · z_min=0 · 27.9 g |
| `check_wires` | 25 根，**0 穿模** |
| 复切 | **29m18s / 14.7 g**（原 29m49s） |
| 十件合计 | 8h34m / 338.1 g（04 时间微降，总量不变） |
| `check_base_fit` / `audit` | 全过 / 零 `!!` |

---

## 四、继电器槽改法（领导定：改槽，当晚重切）

实物 26.2 × 50，原槽 34 × 25 装不下。**横向放大放不进去**——51 宽距面包板槽只剩 0.2mm 壁。最终方案：

- **转 90°**：槽改 **27.2 × 51.2**（26.2+1 / 50+1），仍在 (−45, −20)，深 3.5
- 只动 **06a 左片**（槽全在 x<0），06b 的 STL / gcode 完全不变
- 连带：07 DHT 座在装配里后移 **7mm**（−60 → −67），让开槽的 y −45.5 与走线间隙；**07 本体不重打**
- 06a 复切：**2h30m33s / 118.8g**（原 2h27m28s / 119.2g）
- 装配同步：继电器盒 26.2×50×16、端子排移到 −Y 端 4 位、继电器 IN/泵线重排（25 根 0 穿模）

## 五、小灯（领导定：平放板面）

实物是 **18.8 × 13.5 的三针模块**（板载 5mm LED），不是裸灯珠。**不做托架、零打印**：模块平放板面，底盘上的 φ5.2 孔空着（不影响结构）。装配改为"LED 模块 + 板上灯珠"，`check_base_fit` 已登记（座面 8.0 / 灯珠 9.6）。
⏳ 待明天看模块丝印确认三针定义（若是单通道 GND/VCC/S，双色只能亮一种，固件 25/27 的接法要相应简化）。

---

*小马 · 2026-11-08 · 下一个 AR 编号 **AR24***
