huankechong/smart-greenhouse/docs/审计报告/AR09_GreenHouse走线优化_2026-10-20.md

# AR09 · 走线优化：盖顶过线孔改侧 + 全件穿模校验收紧（0 穿模）

> 项目：智能花房养护站（IPW Final Project）
> 日期：2026-10-20 · 执行：小马 · 触发：领导「再优化一下线路，不要穿模」
> 产物：`10_tank_lid_v1.stl`（孔位改侧，51.1 g 不变）· 装配 glb/HTML/四视图全链重出 · `check_wires.py` 收紧

---

## 一、旧校验为什么没抓全

原 `check_wires.py` 有两个口径漏洞：

| 项 | 旧 | 后果 |
|---|---|---|
| 采样密度 | 每段固定 10 点 | 短段（<10mm）实际只采到 1–2 点，薄壁穿刺漏检 |
| 检测目标 | 14 类结构件 | **水管、浮球杆/本体/法兰、水箱盖、OLED 屏、传感器板**都没查 |

按旧口径跑出来是"22 根 1 根插入"，实际按新口径（步长 1.2mm、22 类目标）是 **4 根真穿模**。

## 二、查出的 4 处（都是真相交，不是插入）

| # | 线 | 位置 | 穿进什么 | 根因 |
|---|---|---|---|---|
| 1–2 | 泵电缆 ×2 | (77,−38,117~123) | **水箱盖**（裙边 r68.4~71.2，z115~123） | 抬升点在桶心半径 70.5，正好切进盖沿 |
| 3–4 | 浮球线 ×2 | (85,32,147) 起 | **浮球本体**（φ8，z130~148） | 线起点定在本体轴心上，从体内穿出 |

另修 1 处"贴边"：DHT 线端头原在座壁内 0.4mm，退到壁外。

## 三、改法

### 1. 盖顶过线孔从 +Y30 移到 −Y45（与水管同侧）

| 项 | 旧 | 新 |
|---|---|---|
| 过线孔位（盖局部） | (0, +30) | **(0, −45)** |
| 与水管孔间隙 | — | **13.0**（孔缘间） |
| 与凸台间隙 | 20.75 | **35.0** |
| STL | — | 重出，仍 watertight/单体/z0，**51.1 g 不变** |

效果：电缆不再横跨盖顶（原来要从 −Y 侧爬过整个盖面到 +Y 孔），与水管、浮球本体、凸台都不再交汇；泵线、浮球线全部走桶 **−Y 侧**（面向电控区那面）。

`p10_tank_lid.py` 几何校验同步加一条：**水管孔与过线孔间隙 ≥ 6mm**。

### 2. 走向重排（桶外 y≈−47，桶半径 68）

```
泵电缆：泵顶 → 桶内偏 +X 上行（避开浮球杆轴 22）→ 穿 φ8 孔(85,−13)
        → 盖沿外 r=76 处上翻出盖 → 沿 y≈−47 竖直下行 → 贴底板回继电器
浮球线：本体侧面 (95,32,144) 出线（不再从轴心穿出）→ 绕盖沿外侧
        → 沿 y≈−52 下行 → 回面包板 GPIO32
```

泵线在桶内那一段刻意偏 +X（x≈92），与竖直水管（x=85,10）保持 ≥12mm、与浮球杆轴保持 ≥22mm。

## 四、验证

| 检查 | 结果 |
|---|---|
| `check_wires.py`（新口径：1.2mm 步长 / 22 类目标 / 3%–97%） | **22 根，0 穿模 → PASS** |
| `check_base_fit.py` | 全部通过（落座、零干涉、槽孔特征） |
| `audit.py` | **0 个 `!!`** |
| glb | 89 几何体，0.58 MB |
| 离线 HTML | **34,734 面 / 1.87 MB**，无头 Chromium 无 JS 错误 |
| 盖板 STL | watertight / 单体 / z0 / 51.1 g，几何校验 6 条全过 |

## 五、影响与待办

- **盖 STL 已变**（孔位），但尚未打印 → 零成本；README/P0 交付说明里的孔位描述已同步。
- AR07 里"φ8 过线 +Y30"已标注改为 −Y45 并指向本报告。
- 装配交付说明、示意图走线段落同步更新。

## 六、已知限制

1. 电缆沿桶外壁下垂为示意路径，真实长度以接线表为准（多留 10cm 余量）。
2. 泵线在桶内穿水段无法避免（泵在水下），穿"水"不计入穿模（水体为流体）。
3. 浮子为活动件，与水的相对位置随水位变化，模型固定画在满水浸没态。
