huankechong/smart-greenhouse/outputs/3D打印件/花房3D_整机底盘/交付说明_整机底盘两片式v1.md

# 整机底盘（两片式）· v1.2 交付说明

> 生成日期 2026-10-18 · **替代** `outputs/3D打印件/花房3D_P1P2/` 里的 P1-6「整合底板(电控托盘)」
> 脚本 `base_2pc_models.py` · 三件全部 `watertight / bodies=1 / z_min=0`

> **v1.1**：① 删除 ESP32 槽（一直是空槽，ESP32 实际插在面包板上）；② 新增裸 LED 的 φ5.2 通孔。
>
> **v1.2 改动（2026-10-18 15:1x，领导要求「连接件不显眼」）**：
> ① **板厚 6 → 8mm**（连接块要齐平，沉槽吃掉 3.5mm 后仍需 4.5mm 螺纹咬合，6mm 板做不到）；
> ② **连接块沉槽加深到 3.5mm = 块厚，块顶与板面绝对齐平**（原来露 3mm，形成一道台阶）；
> ③ **螺丝从 M3×8 改 M3×6**——旧规格是错的，M3×8 在旧结构里会穿出底面 1mm（见第七节注）；
> ④ 各功能槽同步加深，**槽底绝对高度全部不变**，所以装配模型里的件一个都不用挪。
> 左片实体 **275.8 g**（2026-11-08 继电器槽转 90° + 五个小件嵌槽 + 四个老槽槽深修正）/ 右片 **304.2 g**（v1.5 改 φ82 大花盆槽，槽变大料变少）；连接块 3.5 厚、4.2 g。

---

## 一、为什么拆两片

原计划一整块 **320×230** 整机底盘，但**拓竹 X2D 床面只有 256×256**，一整块打不下。

拆法：沿中心线切成 2 × **160×230**，每片都小于床面，且留足 brim 空间。

---

## 二、拼接方案（你选的：M3 螺丝 + 定位销）

> 核心原则：**两片全是垂直壁，零悬垂、免支撑**——所有带水平悬臂的方案（半搭接、燕尾、底部夹板凸台）薄板上都会产生大跨度悬空，首版必废。

**三层保险：**

| 层 | 元件 | 作用 |
|---|---|---|
| 定位 | 2 × **φ4 水平定位销**（跨缝，y = ±70，z = 底板中层） | 拆装后可重复对准，不靠手感 |
| 粗定位 | 底板顶面 **45.6×24.6×3.5 沉槽** | 连接块掉进去就位，不用扶；**槽深 = 块厚，装上后与板面齐平** |
| 夹紧 | 2 × **连接块**（45×24×**3.5**），每块 4 颗 **M3×6 盘头（圆柱头）自攻** | 直接拧进 φ2.8 引导孔，**不需要螺母**；沉头窝深 1.8，**头面与板面齐平** |

**为什么用自攻而不是螺母**：螺母得在底面开六角沉孔，底板就只能架在 4 个脚上，整机放在桌上会晃。自攻 M3 拧进 PLA 的 φ2.8 孔，**4.3mm 咬合**足够承受搬运。

**为什么板要做到 8mm**：连接块要与板面齐平，沉槽就得吃掉 3.5mm；板厚 6 时槽下只剩 2.5mm，M3 只能咬 2.5mm 且螺丝尖离底面不足 0.5mm。8mm 板留 4.5mm 材料，咬合 4.3mm、尖头停在高 0.2mm 处。

---

## 三、装配步骤（click 级）

1. 两片**平放在桌面**，接缝面推到一起，目视接缝平齐。
2. 取 2 根 **φ4×16 定位销**（4mm 钻头柄 / 剪断的钉子 / 一段 1.75mm 耗材×3 不行，必须 φ4）：**销孔是水平的（沿 X，y = ±70，z = 4）** → 先把两根销插进 **06a** 的孔里（从接缝面插入，露出约 6mm），再把 **06b 顺着销推上去**，不要「从上方插」——上方是实心的。
   - 此时两片应该推不动、转不动。
3. 把 2 块**连接块**放进两个沉槽，块跨在接缝上，四面靠槽壁自动对中。
4. 每块 4 颗 **M3×6 盘头（圆柱头）自攻螺丝**，对角顺序（左上→右下→右上→左下）逐步拧紧，**不要一次拧到底**——先全部拧到手紧，再对角补力。拧到底时螺丝头正好坐进 **φ6.2 × 1.8 深的圆柱沉孔**里，头面与板面齐平，**摸上去是平的**（⚠️ 是**圆柱沉孔配盘头**，不是 90° 锥形沉头——沉头螺丝坐不实）。
5. 手指沿接缝摸一遍：块顶与板面应在同一平面（差 0）；如果摸到台阶，说明块没压到底，退出来清一下槽里的碎屑。
6. ⚠️ **不要用 M3×8**：这个结构里 M3×8 的尖会从底面穿出 1.8mm，刮桌面。

**拆装**：拧下 8 颗螺丝 → 拔销 → 分开。重复组装精度由销孔保证。

---

## 四、交付清单

| 件 | STL | 外形 (mm) | 实体估重 | 20% 填充实际 |
|---|---|---|---|---|
| 底盘·左片 | `STL/06a_base_left_v1.stl` | 160 × 230 × **8** | **275.8 g** | **~91.0 g** |
| 底盘·右片 | `STL/06b_base_right_v1.stl` | 160 × 230 × **11**（AR05 漏水防护加高） | **293.1 g** | **~96.7 g** |
| 连接块 ×2 | `STL/06c_joint_block_v1.stl` | 45 × 24 × **3.5** | 4.2 g/个 | ~1.4 g/个 |

> 打印两片各约 **6 h**（0.2 层高、20% 填充；v1.1 的 6mm 是 4–5 h，加厚 2mm 多约 1 h/片），是这个项目里最耗时的两件，建议提前排进实验室机时。

---

## 五、布局（320×230，X 右为正，Y 前为正）

### 左片（x −160…0）：花盆 + 电控

| 区域 | 位置 | 槽 | 尺寸/深度 |
|---|---|---|---|
| 花盆 | (−105, 60) | φ62 圆形凹槽 | 深 4 |
| 面包板 | (−105, −55) | 84.6 × 55.6 | 深 1.5 |
| 继电器 | (−45, −20) | **27.2 × 51.2**（实测 26.2×50，转 90°） | 深 3.5 |
| 04 屏架 | (−45, 38) | **36.2 × 34.2**（单边 0.10） | 深 **3.0**（裙墙 10 高，8mm 板只能沉 3） |
| 07 DHT 座 | (−45, −67) | **锥形 34.2→28.2**（锥度 33.7°） | 深 **4.5**，单边 0.10 |
| 11 光敏座 | (−110, −5) | **锥形 30.2→24.2**（锥度 36.9°） | 深 **4.0**，单边 0.10 |
| 08 扎线座 | (−77, 8)，不转角 | **30.2 × 16.2**（底板 30×16） | 深 **2.0**（与板面齐平） |
| LED 模块 | (−14, 12.5) | 19.0 × 13.7 + 0.6 倒角 | 深 **1.6**（与板面齐平） |
| 状态灯 LED | (−22, 18) | **φ5.2 通孔** | 全穿 |
| 扎带槽 | x=−140/−70，y=−85/0 | 10 × 3 通孔 | — |

### 右片（x 0…160）：水箱

| 区域 | 位置 | 槽 | 尺寸/深度 |
|---|---|---|---|
| 水箱（1L 圆桶） | (85, 32) | **φ108 圆槽** | 深 5（槽底 z=3） |
| 扎带槽 | x=45/125，y=−80/75 | 10 × 3 通孔 | — |

### 拼接硬件（两片对称，y = ±70）

| 项 | 参数 |
|---|---|
| 沉槽 | 45.6 × 24.6 × 1（跨缝，两侧各半个） |
| M3 引导孔 | φ2.8 × 5.25 深，x = ±14，y = ±7 |
| 定位销孔 | φ4.1 × 9 深（沿 X 从接缝面向内），孔心 x = ±4，z = 3 |

---

## 六、采购清单（五金件）

| 件 | 规格 | 数量 | 用途 |
|---|---|---|---|
| 自攻螺丝 | **M3 × 6**（盘头，头高 1.8） | 8 | 连接块固定 |
| 定位销 | **φ4 × 16**（4mm 钻头柄 / 光轴 / 剪断钉子） | 2 | 跨缝定位 |
| 螺丝刀 | PH1 | 1 | — |

> ⚠️ **只买 M3×6**。M3×8 会从底面穿出 1.8mm；M3×10 穿出 3.8mm。
> 如果手上只有 M3×8，把尖头用钳子剪掉 2mm 再用（剪完用锉刀修一下螺纹口）。

---

## 七、打印参数

| 项 | 值 |
|---|---|
| 材料 | PLA 白 |
| 层高 | 0.2 mm |
| 板厚 | 8 mm（v1.2；v1.1 为 6） |
| 墙数 | 3 |
| 填充 | 20% gyroid |
| 支撑 | **不需要**（全垂直壁） |
| 附着 | **brim 5–8 mm**（160×230 大平面，不开 brim 必翘边） |
| 朝向 | 按 STL 原样，Z↑ |

---

> **v1.3（2026-10-19 AR05，落实第八节限制 7「漏水会流到电控区」）**：
> - **槽底排水孔** φ5 @(120, 52) 通板 —— 水箱漏的水穿板直落桌面，不横向流进电控区
> - **挡水堤 ×2**：沿 φ108 圆槽 -Y/-X 切点外侧，3mm 宽 × 3mm 高，右片
> - 影响：06b bbox z 8 → **11mm**（多 3mm 高）；v1.4 改圆槽后实体 291.8 g，20% 填充约 96.3 g；**v1.5 改 φ82 大花盆槽后 → 293.1 g / 96.7 g**
>
> **v1.4（2026-10-20 AR08，1L 圆桶落地）**：水箱定版市售 1L 打包桶（底 φ106 / 口 φ136），
> 原矩形槽 120.6×92.6 在 **Y 向装不进去**（106 > 92.6），故改 **φ108 圆槽**、槽心 (85,32)（+Y 移 12
> 让开挡水堤），挡水堤随之改为沿圆槽切线方向；排水孔仍在槽内 (120,52)。

## 八、已知限制

1. ~~连接块露出底板 3mm~~ → **v1.2 已齐平**：块顶与板面差 0.0mm，螺丝头沉在 1.8mm 窝里。走线不必再垫。
2. **尺寸仍是占位值**：花盆 φ62、水箱 120×92、面包板 84×55、ESP32 55×28、继电器 34×25 原是市售估值（2026-11-08 实测 26.2×50，已改 27.2×51.2）。到货实测后改 `P` 里的数字重跑。**改 `plate_x/plate_y` 只会加/减边缘余量，槽位不随动**——要挪槽就直接改各 `*_pos`。
3. **底盘没做减重**：8mm 实心板，两片约 190g 实际耗材。**不能再降板厚**——沉槽 3.5 + 咬合 4.5 已经把 8mm 吃满；想省料只能在底面开减重袋（会破坏“整块端走”的刚性，不推荐）。
4. **接缝是直缝**，靠 8 颗螺丝 + 2 销承力。搬运时**托底、别单手提一端**——单端提起会让接缝受弯。
5. **ESP32 没有独立槽位**（v1.1 删除）：它插在 400 孔面包板上，靠排针定位，比躺在 1.5mm 浅槽里稳。若以后想把 ESP32 独立出来，把 `build_half()` 里加回一条 pocket 即可。
6. **裸 LED 的孔是 φ5.2 通孔**：5mm LED 的座圈（φ5.9）坐在板面上，灯体在板上，两根引脚（间距 2.54）从孔里穿到底面接线。孔比灯体大 0.2，**点一滴热熔胶固定**，不要指望过盈。
   > ⚠️ **待实物确认**：`花房接线规划表` 写的是「双色 LED **模块**（借·13 号，3 针 GND/R/G）」。若实物是 3 针小 PCB 而不是裸灯珠，这个 φ5.2 孔就闲置（可当走线孔用），模块直接坐板面或粘双面胶即可——**孔留着不会有坏处，先不改**。
7. 底盘不防水。水箱区只有 3mm 沉槽，**不是密封槽**，漏水会顺着底板流到电控区。演示时水瓶下面垫纸巾，这个原方案书里已经写了。

---

## 九、和旧版的区别

| | 旧 06（`花房3D_P1P2/06_electronics_base`） | 新 06a/06b/06c |
|---|---|---|
| 尺寸 | 170 × 120 | 320 × 230 |
| 托什么 | 只有面包板+ESP32+继电器 | 花盆 + 水箱 + 全部电控 |
| 片数 | 1 | 2 + 连接块 |
| 答辩搬整机 | 花盆水瓶还得单独端 | 一次端走 |

> 旧文件已于 **2026-10-20 删除**（连同 01/01b v1、05 等全部作废件，见 README），需要时从 git 历史找回。

---

## 十、文件清单

```
outputs/3D打印件/花房3D_整机底盘/
├── base_2pc_models.py
├── check_report.json
├── STL/
│   ├── 06a_base_left_v1.stl
│   ├── 06b_base_right_v1.stl
│   └── 06c_joint_block_v1.stl      (打印 2 个)
└── preview/
    ├── 00_底盘装配总览.png
    ├── 06a_base_left.png
    ├── 06b_base_right.png
    └── 06c_joint_block.png
```

## 七、配合自检（2026-11-10 新增）

`花房3D_整机装配/check_clearance.py` —— 逐件量「槽开口 vs 零件底座」与「槽底 vs 落座」，不用靠肉眼：

```
件        槽开口(X×Y)      件底座(X×Y)     单边间隙   槽底/落座
04 屏架    36.2 × 34.2     36.0 × 34.0     +0.10     5.0 / 5.0
07 DHT     28.4（顶 34.2） 28.0（顶 34.0）  +0.10     3.5 / 3.5
11 光敏    24.2（顶 30.2） 24.0（顶 30.0）  +0.10     4.0 / 4.0
08 扎线    30.2 × 16.2     30.0 × 16.0     +0.10     6.0 / 6.0
LED 模块    19.0 × 13.7     18.8 × 13.5     +0.10     6.4 / 6.4
花盆        φ82            φ80             +1.00     2.0 / 2.0
面包板      84.6 × 55.6     84 × 55         +0.30     4.5 / 4.5
继电器      27.2 × 51.2     26.2 × 50       +0.50     4.5 / 4.5
水箱        φ107           φ105            +1.00     3.0 / 3.0
```

**结论**：五个小件统一 0.10/边（与测试块标定一致）；四个大件 0.3~1.0/边（重物好放，靠自重定位）；**全部槽底 = 落座高度，零干涉**。
