huankechong/smart-greenhouse/outputs/3D打印件/花房3D_P0/交付说明_P0三件v1.md

# 花房 P0 三件 · v1 占位版交付说明

> ⚠️ **2026-10-19 更新（v2）：件 1b 已重做为 `STL/01b_sensor_rim_hook_v2.stl`**——
> 对齐 AR05 新管夹的盆沿双爪结构，去掉 46mm 长斜臂（原来埋土 35mm），改为「双爪 + 顶桥 + 夹板柱」，
> 板从上方插入、装完土也能插拔。`01b_..._v1.stl` 与 `01_sensor_L_bracket` 均为历史版本，**不要打印**。
>
> **2026-10-19 v2.1：拿到实物尺寸后已按真值重算**——PCB 总长 **87**（原按 98）、头宽 **23**、探针段 **15**、厚 **1.5**；
> 板槽相应改为 **23.6 × 1.4**（0.1 过盈）。插入后**入土 51mm、露出盆沿 27mm**，板顶与夹板柱顶面齐平即到位。

> 生成日期 2026-10-18 · 对应《花房3D建模入门路线与模型清单》P0 必打三件
> 建模方式：Python 参数化 CSG（trimesh + manifold3d 布尔内核），**非 AI 生成网格**
> 三件全部通过 `watertight=True / bodies=1 / z_min=0` 校验，可直接丢进 Bambu Studio 切片

---

> 📌 **01b 现行口径（2026-11-10 19:45 定版）：裸露版 14.5g** —— 感湿窗 17 宽 × 37 高（尖顶），土面以下两侧壁全开（`open_window=True`）；已打印。
> 演进链：AR28 板槽贯通 → AR31 阶梯槽 → AR33 开窗被否 → **AR35 定版裸露**。详见 `docs/审计报告/AR35_*`。

## 一、必须先看清的一句话

**v1 是"几何占位版"，不是最终可打印版。**

三件的外形、接口逻辑、装配关系已经定死，但有一组尺寸必须等实物到货（10/22 前后）用卡尺实测回填。下表用三种标记区分尺寸来源：

| 标记 | 含义 | 到货后要做什么 |
|---|---|---|
| `[实测]` | 市售常见规格估算 | **必须卡尺复测并回填** |
| `[设计]` | 我自己定的结构尺寸 | 可按实装手感微调 |
| `[公差]` | 打印补偿量 | 首件打出来试装后再调 |

---

## 二、三件交付清单

| # | 件 | STL | 外形 (mm) | 体积 | PLA 估重 |
|---|---|---|---|---|---|
| ~~1~~ | ~~土壤传感器 L 型支架~~（**已被取代，勿打印**） | ~~`STL/01_sensor_L_bracket_v1.stl`~~ | 30 × 46 × 52 | 18853 mm³ | ~23.4 g |
| ~~1b~~ | ~~土壤传感器盆沿挂钩 v1~~（已被 v2 取代） | ~~`STL/01b_sensor_rim_hook_v1.stl`~~ | 30 × 32.64 × 49.14 | 19420 mm³ | ~24.1 g |
| **1b-v5** | **土壤传感器土插支架（超薄版）**（2026-10-24 三次减薄：柱 30×10→**27×6**，腿改「柱下潜+土里鳍」） | `STL/01b_sensor_rim_hook_v2.stl` | 27 × 15 × 71 | 15640 mm³ | **~19.4 g** |
| 2 | 水泵固定座（**v2 方形**，按实测泵体） | `STL/02_pump_mount_v1.stl` | 57 × 55 × 25 | 19891 mm³ | **~24.7 g** |

> ⛔ **2026-10-24 作废，勿打印**：水泵自带吸盘（底脚 32×28），可直接吸在桶底；吸盘本身把泵垫高约 2~3mm，
> 吸水口仍有间隙 —— **固定座多余**。省 24.7g + 一次机时，且腾出桶底 3135mm²（原占桶内底 36%）。
| 3 | 水管末端固定夹（**土插式·窄版**，2026-10-24 从 30×16 缩到 15×15 给薄荷让土面） | `STL/03_tube_clip_v1.stl` | 15 × 15 × 41 | 2778 mm³ | **~3.4 g** |
| | **合计（现行 01b-v2 + 02-v2 + 03-v2）** | | | | **~50.1 g** |

预览图在 `preview/`：`00_P0_三件总览.png` + 每件三视图（ISO / TOP / FRONT）。

---

## 三、每件的设计逻辑（答辩能直接讲）

### 件 1 · 土壤传感器 L 型支架

**核心问题**：电容式土壤传感器是裸板，**板上没有安装孔**，只能用"卡槽"夹持，不能用螺丝穿过板子。
槽做成**恒定 1.5mm 过盈槽**：板厚 1.6mm，槽宽 1.5mm，板子压进去靠 PLA 弹性夹住，**任意深度都能固定**，不需要螺丝。

> v1.1 修正（2026-10-18）：原设计是锥形槽 2.4→1.8 + 槽底封在 z=8。实测逻辑两个问题——①1.8 的窄口仍比 1.6 的板宽，永远夹不住；②槽底封闭导致板子顶住下不去，传感器头根本进不了土。已改为**恒 1.5 过盈 + 槽贯通底板**。

| 尺寸 | 值 | 来源 |
|---|---|---|
| 板槽 X 净宽 | 23.6 = 板宽 23 + 0.6 | `[实测]` 板宽 |
| 板槽 Y 间隙 | 1.5（板厚 1.6 → 0.1 过盈） | `[实测]` 板厚 |
| 板槽贯通 | 上到底板顶、下穿底板（板子可入土） | `[设计]` |
| 插入深度 | 可调，靠过盈摩擦锁定 | `[设计]` |
| 底板让位槽 | 24 × 4，穿过底板让板子入土 | `[设计]` |
| 底板 M3 过孔 | 2 × ⌀3.2，间距 20 | `[公差]` |

槽两侧壁厚 3.2mm，立臂 3mm，底板 3mm —— 全部 ≥2mm 打印下限。

### 件 2 · 水泵固定座

> **v2 重做（2026-10-19，按实物实测）**：泵实测是**方形 41×39×30**（含顶部出水嘴 37 高）而非 v1 假设的 φ38 圆柱。整套改为方形腔体：内腔 41.8×39.8、四面 3.5 壁（高 22）、3mm 底板开 **34×30** 让底吸口触水，外形 **57 × 55 × 25 / ~24.7g**（原 ⌀58×28 / 21.1g）。角部斜筋试过会破坏单体，已去掉（3.5 壁 + 3mm 底板已够）。下方 v1 参数表仅留档。

**核心问题（v1 留档）**：底吸泵的进水口在泵底，座子不能做成密封杯，否则泵吸不到水。
→ 底板中心开 ⌀34 大孔，泵底吸口直接触水；四周用三角斜撑撑住 25mm 高的座筒防倾倒。

| 尺寸 | 值 | 来源 |
|---|---|---|
| 座筒内径 | 38.8（泵径 38 + 单边 0.4） | `[实测]` 泵体直径 |
| 座筒高 | 25（约泵体 2/3 高） | `[设计]` |
| 出水嘴让位口 | 12 宽 × 14 高，开口朝 +Y | `[实测]` 出水嘴直径与高度 |
| 底板 | ⌀58 圆形（**不做方形**，圆盘才塞得进瓶口） | `[设计]` |
| 安装孔 | 4 × ⌀3.2，分布半径 25.5（落在筒壁外侧，否则被壁堵死——v1 踩过这个坑） | `[公差]` |

### 件 3 · 水管末端固定夹

> **v3 重设计（2026-10-23，方案 B 土插式，现行）**：实盆为 8×8×8 直筒树脂盆，**壁厚 10~20mm 范围太宽**，刚性双爪无法同时覆盖（按 10 设计则壁 20 撑不开、按 20 设计则壁 10 合不拢，两种都会废件）→ **弃用夹持，改两腿插土**。完全不依赖壁厚，且保留「先立架子再填土、板深可调」的能力。**重量 10.9 → 9.3 → 3.4g，外形 30×16 → 15×15（针深 25mm）**。
> **2026-10-24 二次减薄**：领导要种两株薄荷，两件合计原占土面 32%（912mm²）→ 01b 柱 36×12→30×10、03 缩到 15×15，合计降到 **17.5%（496mm²）**，剩给薄荷 2331mm²。
> **2026-10-24 三次减薄（领导要求再薄）**：01b 柱 30×10 → **27×6**（土面上方投影 **162mm²**，实测截面确认），腿改为「柱子直接向下延伸进土 + 土里两侧稳定鳍（27×5.5×高20，只在土面以下展开）」。**两件合计降到 162+225 = 387mm² = 13.7%**，剩给薄荷 **2440mm²**。
> 📌 关键思路：**鳍放在土面以下就不占土面** —— 抗倾覆靠土里的力臂，土面上方只留 27×6 的柱身。
> ⚠️ 曾尝试把管环合并进 01b，但 **φ10.6 的管孔需要 Y 深 ≥14.6**，30×10 的柱放不下（孔会把凸台劈成两半，bodies=2）→ 放弃，保持两件。

**核心问题（v1 留档）**：要同时干两件事——夹在花盆沿上、把 ⌀8 水管固定在土面上方某高度。而且**不许用螺丝**（螺丝穿过夹爪会把夹爪切断，v1 踩过这个坑）。

→ 下段是**锥形楔紧夹口**（下口 7.5 → 顶口 4.5），盆沿越插越紧；上段是**C 型弹性开口管夹**，开口 6.2 < 孔径 8.6，水管压进去后不会自己掉出来。

| 尺寸（v1 留档） | 值 | 来源 |
|---|---|---|
| 管孔内径 | **10.6 = 管外径 10 + 0.6** | `[实测 2026-10-23]` 硅胶管外径 10mm / 内径 8.5mm |
| C 型开口宽 | 6.2（必须 < 8.6 才能夹住） | `[公差]` |
| 盆沿夹口 | 下口 7.5 → 顶口 4.5，深 18 | `[实测]` 花盆沿厚度 |
| 夹爪板 | 5mm 厚（3mm 会被孔切断） | `[设计]` |

平台下方加了两条三角斜撑，把悬空跨距压缩到 7mm，**不用支撑也能桥接打印**。

---

## 四、打印参数（拓竹 X2D / Bambu Studio）

| 项 | 建议值 | 说明 |
|---|---|---|
| 材料 | PLA 白色（灯罩另说） | 三件都不接触高温 |
| 层高 | 0.2 mm | |
| 墙数 | 3 层（≈1.2mm） | 结构件按强度优先 |
| 填充 | 20% gyroid | |
| 支撑 | **不开** | 三件悬垂都 <45° 或可桥接 |
| 摆放 | 按 STL 原朝向（Z↑） | 建模朝向即打印朝向，已确认 z_min=0 |
| 时长 | 三件合计约 3–4 h | 一批打完 |

**公差提示**：所有孔 ⌀3.2 是按"FDM 热缩 +0.2"给的。首件打出来如果 M3 塞不进，用 3.2 铰刀过一下，或把脚本里 `m3_d` 改成 3.4 重跑。

---

## 五、到货后的回填清单（10/22 前后，半小时）

拿卡尺量这 6 个数，填进 `p0_models.py` 的 `PARAMS`，重跑脚本即得 v2：

| # | 量什么 | 对应参数 | 影响 |
|---|---|---|---|
| 1 | 土壤传感器 PCB 宽 / 厚 | `sensor.board_w` / `board_t`（并同步改 `groove_x`） | 板插不进 or 晃动 |
| 2 | 水泵泵体直径 | `pump.pump_d` | 泵塞不进 or 太松 |
| 3 | 水泵出水嘴离底高度 / 口径 | `pump.outlet_notch_h` / `_w` | 出水嘴顶到座壁 |
| 4 | 硅胶管外径 | `clip.ring_inner_d`（= 外径 + 0.6） | 管夹不紧 or 塞不进 |
| 5 | 花盆沿厚度 | `clip.rim_mouth` / `rim_top` | 夹不住 or 卡不进 |
| 6 | 蓄水瓶口径 | `pump.base_d` | ⌀58 底板能否放进去 |

改完运行：

```bash
cd outputs/3D打印件/花房3D_P0
C:/Users/junbo/.workbuddy/binaries/python/envs/default/Scripts/python.exe p0_models.py
```

STL 和预览图会原地覆盖为 v2；`check_report.json` 里能看到每件的 watertight / 体积 / 估重。

---

> **v2 重设计（2026-10-19 AR05）**：原「立板跨盆壁 + 锥形楔紧槽」在锥形盆上必然咬入（审计实测 花盆×夹 12.3mm³、土壤×夹 381mm³、水管×夹 471mm³）。改为复刻 01b 已验证的**盆沿双爪**夹持（01b 与花盆干涉 = 0）：
> - 内外双爪随盆壁锥度 8.5° 下探 **7mm**（土面在盆沿下 8mm，不入土），夹口 6.2mm
> - 管环柱立于顶桥之上，管孔中心内移 11mm 避开内爪，孔径 Ø8.6
> - 管子从柱顶**正上方竖直下穿**，弯头全在管环外 → 水管×夹 471 → 1.2mm³
> - 落床归一化 z_min=0，`metadata["rim_top_z"]` 供装配补偿
> - 重量 6.9 → 11.8g（多出的料=双爪+管环柱，换掉 381mm³ 埋土）

## 六、v1 已知限制（别在答辩里被问倒）

1. **尺寸是占位值**——上面的 `[实测]` 项没复测前不要直接打印，容易白打。
2. ~~挂钩的斜臂埋进土里 35mm~~ → **v2 已解决**：去掉长斜臂，爪只下探 7mm（土面在盆沿下 8mm），
   挂钩×土壤干涉 **11522 → 0 mm³**。现在可以**先填土再挂**，装好也能取下来重插。
   代价：板在夹板柱下方约 70mm 无支撑，靠土壤扶正；移动整机时板会晃（v1 的斜臂是撑住的）。
3. **夹口 5.6mm 是照模型盆给的**（盆壁 4~4.35）。实物花盆到手必须改成 `实测壁厚 + 0.6`，否则要么夹不住、要么套不进。
4. **水泵座只防倾倒、不防水泵自身转动**——出水嘴被让位口卡住其实已经限制了角度，但泵体是圆的，理论可转。够用，不必再加。
5. **C 型管夹靠 PLA 弹性**——反复插拔几十次后会松，属于耗材件，建议一次打 2 个备着。
6. **装配干涉已核对**（整机装配里 `audit.py`）：挂钩×花盆 0、传感器板×花盆 0、土×花盆 0；只剩第 2 条的挂钩埋土属设计必然。

---

## 七、文件清单

```
outputs/3D打印件/花房3D_P0/
├── p0_models.py                    # 参数化建模脚本（唯一源文件，改这里）
├── check_report.json               # 三件校验数据
├── STL/                            # 可直接切片的 STL（单位 mm）
│   ├── 01_sensor_L_bracket_v1.stl
│   ├── 02_pump_mount_v1.stl
│   └── 03_tube_clip_v1.stl
└── preview/
    ├── 00_P0_三件总览.png
    ├── 01_sensor_L_bracket.png
    ├── 02_pump_mount.png
    └── 03_tube_clip.png
```

> 建模过程截图建议：报告里放"参数表 + 三视图 + 打印实物"三张即可，课程加分项要的是"你懂几何"，不是软件截图堆量。
