huankechong/smart-greenhouse/outputs/3D打印件/花房3D_P1P2/交付说明_P1P2五件v1.md

# 花房 P1 + P2 五件 · v1 占位版交付说明

> ⚠️ **件 6「整合底板(电控托盘)」已于 2026-10-18 被 `outputs/3D打印件/花房3D_整机底盘/` 取代**（改为 320×230 两片式整机底盘）。
> ⚠️ **件 5「双色 LED 灯罩」已取消**（2026-10-18）：没有半透明耗材，白色 PLA 打出来不透光，做了等于白件。状态灯改为裸 5mm LED 直接露出。
> 本文档里件 5、件 6 的内容仅作历史记录，**不要打印**。其余三件（04/07/08）仍然有效。

> 生成日期 2026-10-18 · 接 P0 三件批次（`outputs/3D打印件/花房3D_P0/`）
> 建模方式：Python 参数化 CSG（trimesh + manifold3d 布尔内核），脚本 `p1p2_models.py`
> 五件全部通过 `watertight=True / bodies=1 / z_min=0` 校验

---

## 一、这一批是什么

| 批次 | 件 | 定位 |
|---|---|---|
| P1-4 | OLED 45° 斜面支架 | 屏幕斜朝观众，评委隔桌能看清实时数据 |
| ~~P1-5~~ | ~~双色 LED 灯罩~~ | **已取消（2026-10-18）**：无半透明耗材；状态灯改裸 LED |
| P1-6 | 整合底板（电控托盘） | 面包板 + ESP32 + 继电器卡住，答辩搬整机不散 |
| P2-7 | DHT11 小座 | 探头抬到叶面以上，测的是植株环境不是桌温差 |
| P2-8 | 扎线固定座 | 走线整齐，报告照片好看 |

**全包外壳按你原计划的决定不做**——包容结构容错低、W3 赌不起，答辩讲"外壳作为量产化方向"是留白加分。

---

## 二、交付清单

| # | 件 | STL | 外形 (mm) | PLA 估重 |
|---|---|---|---|---|
| 4 | OLED 45° 斜面支架（2026-11-09 去爪+加筋） | `STL/04_oled_stand_v1.stl` | 36 × 34 × 39.5 | ~28.9 g |
| ~~5~~ | ~~双色 LED 灯罩~~（**已取消**） | ~~`STL/05_led_diffuser_v1.stl`~~ | ⌀12 × 9 | ~0.6 g |
| 6 | 整合底板 | `STL/06_electronics_base_v1.stl` | 170 × 120 × 4 | ~77.4 g |
| 7 | DHT11 小座（2026-11-08 返修版） | `STL/07_dht11_holder_v1.stl` | 35 × 34 × 62.8 | ~22.6 g |
| 8 | 扎线固定座 | `STL/08_cable_clip_v1.stl` | 30 × 16 × 14 | ~4.8 g |
| 11 | 光敏电阻小柱（2026-11-08 返修版） | `STL/11_ldr_stand_v1.stl` | 36 × 30 × 34.51 | ~8.1 g |
| | ~~合计（含已取消/已取代件）~~ | | | ~~118.8 g~~ |
| | **合计（现行有效：04+07+08+11）** | | | **~65.5 g** |

加上 P0 两件（01b ~19.4 g + 03 ~3.4 g），现行六件实体约 **85.8 g PLA**（实体体积估算；切片实测 10 件合计 338.1 g，见切片报告）。

---

## 三、每件的设计逻辑

### 件 4 · OLED 45° 斜面支架

**约束**：OLED 模块是裸板，4 针排针在板子**下端**；排针塑壳 2.5 + 杜邦母头 2.5，沿板背法线共需 **~7.5mm** 空间。

> ⚠️ **2026-11-07 改版（原设计有硬缺陷）**：原版板槽只深 2.4，板背只剩 0.8mm，排针+杜邦头**塞不进去**，全件也没有任何走线通道；装配图里"OLED 排针/排线"两个盒与支架实体 100% 相交（等于埋在塑料里）。本版按「加脚/裙墙 + 底部出线」重做，详见 `docs/审计报告/AR20_…2026-11-07.md`。

- 斜面由楔块按 45° 切出，**斜面加长到 26.5**（原 24），下沿留 ~5mm 挡边
- 板槽仍深 2.4（板面比斜面低 0.8），下端做 0.6 挡边，**板不会往下滑**
- **排针过线改到上缘**（2026-11-08 实测：4 针在模块上缘）→ 上缘挡边 + 13×5.5 缺口打穿到托背，排针+杜邦头从托背上方穿出
- 底座抬升 10mm：**周边裙墙 + 两条内筋**（把底面天花分成 ≤15mm 小格，免支撑可打；四条腿会让 36×34 底面变成悬空天花，打不出来）
- 4 根杜邦线沿屏背后往下走，正面看不见（底部裙墙的 13×7 过线口保留给其它用途，当前空置）
- 板背元件让位：板下缘往上 9.5mm × 14 宽，局部深 4.0（覆盖 1mm 级元件/焊点）
- 三面围住 + 顶端两只弹性爪，**不用螺丝**

| 尺寸 | 值 | 来源 |
|---|---|---|
| 板槽 X 净宽 | 28.2 = 27.3 + 0.9 | `[实测]` 模块宽 |
| 板槽深 | 2.4 | `[实测]` PCB 厚 + `[公差]` |
| 排针过线口 | 13 × 5.5，深 11 | `[设计]` 排针 2.5 + 杜邦头 2.5 + 余量 |
| 底座 | 36 × 34 × 3 + 10 裙墙 | `[设计]` 免支撑可打 |
| 外形 | 36 × 34 × 39.5 | 切片实测 |

### 件 5 · 双色 LED 灯罩（**已取消，仅存档**）

**约束**：罩壁要薄才透光，所以这件**故意打破 2mm 壁厚下限**（1.6mm）——它是光学件不是结构件。

- 底环 3mm 高，中间留 ⌀6.3 灯孔（按 5mm LED 底部法兰 5.9 + 0.4 间隙）
- 上半球罩 r6 / 内腔 r4.4，壁厚 1.6
- 灯从底部插进灯孔，5mm 镜片顶端进入内腔，光在球罩里二次扩散

| 尺寸 | 值 | 来源 |
|---|---|---|
| 灯孔直径 | 6.3 | `[实测]` LED 法兰外径 |
| 灯孔深 | 6.0 | `[实测]` LED 镜片高度 |
| 球罩半径 / 壁厚 | 6.0 / 1.6 | `[设计]` |

> ⚠️ **这一件最需要确认**：方案书写的是"套件 13 号双色 LED **模块**"。如果它是一块小 PCB（不是裸 5mm LED），这个球罩就套不上，得改成方形罩。到货先看一眼实物，是模块就告诉我，我改一版。

### 件 6 · 整合底板（电控托盘）

**约束**：答辩搬整机，散件一碰就散 = 现场事故。

- 170 × 120 × 4 实心盘，三个沉槽各留 0.6 间隙做**定位**（不包围，方便插拔）
- 四角 M3 孔可固定；板边 10 个 3×10 扎带过孔；右侧留 14×12 走线缺口
- **为什么是 170 而不是 320**：拓竹 X2D 床面 256×256，320×230 的"整机底盘"打不下，必须拆两片对接。当前这个是**电控托盘**（托住面包板/ESP32/继电器），花盆和水瓶单独落地。
  - 如果你要的是"花盆+水箱+电控全托"的整机底盘，那就得改成两片式，说一声我改。

| 尺寸 | 值 | 来源 |
|---|---|---|
| 面包板槽 | 84.6 × 55.6（400 孔板） | `[实测]` 套件面包板尺寸 |
| ESP32 槽 | 55.6 × 28.6 | `[实测]` 38Pin DevKit |
| 继电器槽 | 34.6 × 25.6 | `[实测]` 1 路模块 |

### 件 7 · DHT11 小座

> **2026-11-07 改版（领导：原造型太丑）**：原版 = 10×10 细方杆 + 35×18 平板头 + 三角撑，头底还有 **12.5mm 悬空**（免支撑打不好）。新版改为**台锥底座 → 16→12.5 收腰柱 → 45° 喇叭口 → 托盘**，把悬空变成斜裙，造型与屏架的斜面语言一致。

- 底座 28→34 台锥（4.5 高，33.7° 斜面）；柱身 16→12.5 收腰（2.4°）
- 喇叭口由 12.5×12.5 展开到 35×18，x 向 44.4°、y 向 13.4°——**全件无悬空、免支撑**
- 托盘 35×18×4.3，槽深 2.5（模块 1.6 厚），背面 12×5.2 过线口切穿背壁
- 总高 62.8（与旧版一致，装配坐标不用变）

### 件 11 · 光敏电阻小柱（2026-11-08 新增）

**约束**：光敏模块是 4P 板（VCC/GND/AO/DO，DO 不接），**板上无安装孔** → 用托盘 + 上缘过线槽。

- 台锥底 24→30（4），收腰柱 11→10（4~26），**45° 斜面托盘** 34×18×4.2 —— 与屏架同语言，托底 45° 自支撑
- 板槽 33.2×15.2、深 2.6；**上缘 12×4.5 过线槽**让 4P 排针+杜邦头从托盘背面穿出（落在托盘后上方空中）
- 总高 34.51，实体 8.1 g；v2：板槽 32.5×15.3（按实测 31.3×14.1）、托盘 36 宽（侧墙 1.75）、倾角 52°
- 位置：底盘 (-110,-5) 花盆前脚边，到 ESP32 约 50mm、离双色 LED 90mm、上方无遮挡
- ⚠️ 切片器提示 `floating cantilever`：托盘下缘比柱前脸多出 **1.4mm** 悬挑（45° 斜面上的一个小台阶），免支撑可打；若实打发现塌边，把 `post_t` 10→12 即可

### 件 8 · 扎线固定座

- 三槽并列，槽距 9，线孔 ⌀5.5
- 顶部收口 3.4 < 5.5 → 线束压进去卡住不脱
- 槽间壁厚 3.5mm，下端留 7.5mm 实心

---

## 四、打印参数

| 件 | 材料 | 特殊要求 |
|---|---|---|
| 04 OLED 支架 | PLA 白 | 常规 |
| ~~05 灯罩~~ | ~~半透明 PLA~~ | **取消**：无半透明耗材 |
| 06 整合底板 | PLA 白 | 大平面，**开 brim 5mm 防翘边**；77g 约 2.5–3h |
| 07 DHT11 座 | PLA 白 | 细高件，降速 60%，关风扇前 3 层 |
| 08 扎线座 | PLA 白 | 常规 |

通用：3 层墙、20% gyroid、不打支撑（05 除外）。

---

## 五、到货回填清单（在 P0 的 6 个数之外，再加这 5 个）

| # | 量什么 | 对应参数 | 影响 |
|---|---|---|---|
| 7 | OLED 模块外形 + 排针位置 | `oled.oled_w` / `oled_h` | 板塞不进 or 晃 |
| 8 | LED 是裸灯珠还是模块板 | 决定件 5 整体方案 | 罩子套不上 |
| 9 | 面包板实际尺寸 | `base.bb_w` / `bb_h` | 定位槽对不上 |
| 10 | ESP32 板宽 / 继电器模块尺寸 | `base.esp_w` / `relay_w` | 同上 |
| 11 | DHT11 模块板尺寸 | `dht.mod_w` / `mod_h` | 托盘装不进 |
| 12 | 常用线束直径 | `clip3.wire_d` | 卡不住 or 塞不进 |

改完重跑：

```bash
cd outputs/3D打印件/花房3D_P1P2
C:/Users/junbo/.workbuddy/binaries/python/envs/default/Scripts/python.exe p1p2_models.py
```

---

## 六、已知限制

> **v2（2026-10-19 AR05）**：OLED 支架槽上坡端加两只 1.2mm 厚弹性卡爪（向槽内悬伸 1.5mm，0.6 过盈压住板上缘），落实本文件「已知限制 3：碰倒屏幕脱出」。三角面 44→92，重量 21.1g 不变。

1. **尺寸仍是占位值**，`[实测]` 项没复测前别批量打。
2. **件 5 灯罩的形态押在"裸 5mm LED"上**，是模块板就得重做——这是本批最大的不确定项。
3. **OLED 板槽靠重力 + 摩擦固定**，整机被碰倒时屏幕可能脱出。要更稳的话 v2 可在槽上沿加两个小卡爪。
4. **整合底板是实心 4mm**，77g 偏重。想省料可把 `plate_t` 降到 3（≈58g），或加底部减重网格。
5. **件 7/8 属于 P2 可选件**，答辩不加分也不扣分，时间紧可以先跳过。
6. 五件之间**互不装配**（各自独立放桌面），没做整机装配干涉检查。

---

## 七、文件清单

```
outputs/3D打印件/花房3D_P1P2/
├── p1p2_models.py                 # 五件参数化脚本（唯一源文件）
├── check_report.json
├── STL/
│   ├── 04_oled_stand_v1.stl
│   ├── 05_led_diffuser_v1.stl
│   ├── 06_electronics_base_v1.stl
│   ├── 07_dht11_holder_v1.stl
│   └── 08_cable_clip_v1.stl
└── preview/
    ├── 00_P1P2_总览.png
    └── 04~08 各一件三视图
```
