huankechong/smart-greenhouse/outputs/3D打印件/_打印参考/上机操作卡.md

# 打印上机操作卡 · 拓竹 X2D（10 件 · 2026-11-08 版）

> ⚠️ **口径说明（2026-11-09 补）**：本文件内 **337.7 g / 8h 35m 42s** 是 2026-10-24 首次切片的原始记录。
> 04 于 11-07 改版（14.7 g / 29m49s）、07 于 11-07 改版（11.2 g / 34m35s）后，**现行十件口径为 8h37m / 338.1 g**。
> 现场排期以 **338.1 g** 为准；本文件不回溯改数，保留历史记录。

> **用途**：到实验室照着做，不用回来问。
> **前提**：桌面上只给 **STL**（`STL_源模型/` 里 10 件 + 根目录 `04_07_11_combo.stl` 合并件），**切片自己在 Bambu Studio 里做**。
> 📐 **切片参数**：0.20mm 层高 · 3 墙 · 20% gyroid · **不开支撑** · brim：06a/06b **8mm**、10 **5mm**、01b **5mm**、其余 **3mm**。
> ⏱ 下面的时长是这套参数下的实测值，用来排期。
> **总耗时 8h 35m 42s / 耗材 337.7 g**（切片器实测，非估算）。

---

## 第 0 步：现场先问一句

> **「这台机器能不能连续跑 5 小时？能不能过夜挂机？」**

按答案选方案，**STL 不用改**，只是决定分几趟。

---

## 一、分批方案（按实验室限制选）

| 方案 | 单次限制 | 批次数 | 各批内容与时长 |
|---|---|---|---|
| **A（默认）** | 3~5 h | 3 批 | ① 08+合板+01b+03 **2h05m** ② 10+06c **1h08m** ③ 底盘两片 **5h03m** |
| **B** | 1.5 h 左右 | 4 批 | ① 08+合板 **1h12m** ② 01b+03+06c **59m** ③ 10 **1h02m** ④ 底盘两片 **5h03m** |
| **C** | 只能过夜挂机 | 2 批 | ① 小件八件 **3h32m**（今晚挂）② 底盘两片 **5h03m**（明天挂） |

> 💡 **今晚先打小件**：领导定的顺序，底座和连接块放最后（时间不够就留到明天）。

---

## 二、上机顺序（**小件优先，底座最后**）

| 顺序 | 文件 | 件 | 时长 | 耗材 | 累计 |
|---|---|---|---|---|---|
| 1 | `08_cable_clip.stl` | 扎线固定座（**试机件**） | 9m0s | 3.1 g | 9m |
| 2 | `04_07_11_combo.stl` | **07+04+11 三件同板** | 1h03m12s | 30.8 g | 1h12m |
| 3 | `01b_sensor_holder.stl` | 土壤传感器支架 | 35m26s | 10.1 g | 1h48m |
| 4 | `03_tube_clip.stl` | 水管末端夹 | 17m13s | 3.3 g | 2h05m |
| 5 | `10_tank_lid.stl` | 水箱替换盖（**顶面朝下印**） | 1h01m58s | 44.6 g | 3h07m |
| 6 | `06c_joint_block.stl` | 拼缝连接块 ×2 | 6m33s | 2.9 g | 3h14m |
| 7 | `06a_base_left.stl` | 底盘·左片（brim 8 必开） | 2h30m34s | 118.8 g | 5h44m |
| 8 | `06b_base_right.stl` | 底盘·右片（brim 8 必开） | 2h32m40s | 124.1 g | 8h17m |

> **同板说明**：`04_07_11_combo` 是 07(35×34) + 04(36×34) + 11(34×30) 排成一排、间距 9~10mm 的合并 STL（三个独立壳体）—— 三件共 **124.5×34mm**，远小于 256 床面。
> 合板比分开打省 **约 19 分钟**（1h03m vs 1h22m），且只启动一次。
> ⚠️ 代价：**一块板出问题三件一起报废**。想稳就分开打（三个单件 STL 也在 `STL_源模型/` 里）。

> **按累计时间切**：只够 1h → 打到 1 号；2h → 打到 4 号；3.2h → 打到 6 号。
> **第 1 件用 08 试机**（原来用 06c）：9 分钟 / 3.1g，失败只亏 3 克；通过标准 = 首层平整、brim 不翘、8 根细柱不断。

### 底盘的注意点（最后打）

- 160×230 大平面：**切片时 brim 必须设 8mm**（默认 3 会翘边）
- 打完**等托盘冷却到 40℃ 以下再取**（热撕会翘边）
- 两片打完先对拼（φ4×16 定位销 + 06c），确认拼缝齐平

## 三、每批开工前 30 秒检查

- [ ] **打印板干净**（无残留、无指纹油）—— PLA 用**纹理 PEI 板**
- [ ] **耗材够**：卷上余量 ≥ 本批需求 ×1.2
- [ ] **料盘转动顺畅**（无卡料、无打结）
- [ ] **喷嘴无残料**（镊子清，别用手）
- [ ] **选文件后看预览**：brim 在、没误开支撑、件没超床

| 批次 | 耗材 |
|---|---|
| 06a | 118.8 g |
| 06b | 124.1 g |
| 小件八件合计 | 94.8 g（10:44.6 / 04:14.7 / 07:11.2 / 01b:10.1 / 11:4.9 / 03:3.3 / 08:3.1 / 06c:2.9） |
| **总计** | **337.7 g** |

---

## 四、可能出问题的地方（按概率排）

| 现象 | 原因 | 处理 |
|---|---|---|
| **底盘四角翘边** | brim 不够 / 板不干净 / 冷却太快 | 重打该片，brim 加到 10mm，板用温水+洗洁精洗一遍擦干 |
| **首层不粘** | 板脏 / 调平偏 / 首层太快 | 别硬打，重跑自动调平 + 洗板 |
| **10 水箱盖裙边塌** | 裙边高、壁薄 | 若塌，降到 0.16 层高重切 |
| **06c 螺纹滑丝** | 流量偏大 / 孔径偏大 | 别打底盘，先排查流量标定 |
| **04 托盘上缘缺口处毛边** | 13mm 宽缺口是悬空边 | 正常现象，砂纸轻磨即可 |
| **11 托盘下缘有 1.4mm 小台阶** | 切片器报 floating cantilever | 免支撑可打，塌了再改 `post_t` 12 重跑 |
| **中途断料** | 卷上不足 | 记层号，用剩余料补打 |

---

## 五、打完的验收清单

- [ ] **10 件齐全**（02 泵座**本来就不打**，别找）—— 今晚先打完前 8 件也算达标，底盘明天补
- [ ] 06a + 06b 能拼上，拼缝齐平，φ4×16 定位销能插进
- [ ] 06c 连接块 M3 自攻咬合正常
- [ ] **10 水箱盖能套进桶口**：上段 φ124.8 有阻力、再往下压到翻边 φ132.8 —— "两段都有阻力、到位不晃"
- [ ] 01b 两腿能插土，板槽能插进传感器板（略紧正常，过盈 0.1）
- [ ] 03 管夹 C 形孔能压进 φ10 硅胶管（不掉）
- [ ] **04 屏能推进槽**（27.9×29.5，排针从上缘过线口出来）
- [ ] **06a 继电器槽**：26.2×50 模块竖着放进 27.2×51.2 槽（长边沿 Y）
- [ ] 07 / 08 / 11 就位无误

---

## 六、现场发现要改模型

**别在实验室改**。记偏差（卡尺 + 拍照），回来改脚本顶部参数重跑：**30 秒出新 STL、1 分钟重切单件**。

```
改 outputs/花房3D_*/ 里的脚本顶部参数 → 重出 STL（30 秒）→ 自己在 Bambu Studio 切片
```

---

> 📌 **一句话**：**08 试机（9 分钟）→ 合板三件（1h03m）→ 01b+03（52m）→ 10+06c（1h08m）→ 底盘两片（5h，明天也行）**。
