huankechong/smart-greenhouse/outputs/3D打印件/_打印参考/切片报告.md

# 切片报告 · 2026-10-24（拓竹 X2D / 0.4 喷嘴 / PLA Basic）

> 📌 **2026-11-08 新规**：交付物**只给 STL**，本目录下的 gcode / 3mf 已全部删除（可从 git 历史 `f2bdb78` 找回）。
> 本报告保留下来仅作**切片实测记录**（时长/耗材用于排期），不再有可打印文件。

> ⚠️ **口径说明（2026-11-09 补）**：本报告数字为 2026-10-24 首切原始记录（**337.7 g**）；04/07 于 11-07 改版复切后，**现行十件口径为 8h37m / 338.1 g**（排期以 338.1 为准，本报告不改历史数字）。
>
> ⚠️ **2026-11-07 更新**：04 OLED 支架因走线位缺陷改版（29m49s / 14.7 g），07 DHT11 小座因造型重做（34m35s / 11.2 g），均单独复切，其余 7 件不变。十件合计 **8h37m / 337.7 g**。04 原因见 AR20，07 见 AR21。

> **机器**：拓竹 **X2D**（官方规格：主喷嘴单喷嘴 **256×256×260mm**，标配 **0.4mm** 喷嘴，支持 PLA）
> **预设**：`Bambu Lab X2D 0.4 nozzle` / `0.20mm Standard @BBL X2D` / `Bambu PLA Basic @BBL X2D 0.4 nozzle`
> **覆盖参数**：`--wall-loops 3`（预设默认 2 墙，按项目要求加到 3）、`--brim-type outer_only` + 每件 brim 宽度
> **切片耗时**：**7.2 秒**（9 件合计，全部成功）
> **产物**：每件一个目录，内含 `.3mf`（工程）+ `.gcode`（可直接上机）+ `result.json`

## 一、逐件结果

| 件 | 尺寸需求 | brim | 墙数 | 填充 | **打印时间** | **耗材** | gcode |
|---|---|---|---|---|---|---|---|
| 01b 传感器土插支架 | 27×15 | 5mm | 3 | 20% | **35m 25s** | 10.1 g | 982 KB |
| 03 水管管夹（窄版） | 15×15 | 3mm | 3 | 20% | **17m 13s** | 3.3 g | 1357 KB |
| 04 OLED 45° 支架 | 36×34 | 3mm | 3 | 20% | **29m 49s** | 14.7 g | 1610 KB |
| **06a 底盘·左片** | **160×230** | 8mm | 3 | 20% | **2h 30m 33s** | 118.8 g | — |
| **06b 底盘·右片** | **160×230** | 8mm | 3 | 20% | **2h 32m 39s** | 124.1 g | 2271 KB |
| 06c 拼缝连接块 ×2 | 45×24 | 3mm | 3 | 20% | **6m 32s** | 2.9 g | 488 KB |
| 07 DHT11 小座 | 35×34 | 3mm | 3 | 20% | **34m 35s** | 11.2 g | 853 KB |
| 08 扎线固定座 | 30×16 | 3mm | 3 | 20% | **8m 59s** | 3.1 g | 324 KB |
| 10 水箱替换盖 | 135.9×138.4 | 5mm | 3 | 20% | **1h 1m 57s** | 44.6 g | 1978 KB |
| 11 光敏电阻小柱 | 34×30 | 3mm | 3 | 20% | **18m 31s** | 4.9 g | — |

## 二、合计（**本次最大的收获**）

| 分组 | 实测 | 原文档估算 | 差异 |
|---|---|---|---|
| 底盘两片（06a+06b） | **5.00 h** | 12.2 h | **只有 41%** |
| 其余七件 | **3.03 h** | 8.3 h | **只有 37%** |
| **总计 10 件** | **8 h 37 m**（04/07/06a 复切 + 11 新增） | 19 h | **只有 45%** |
| **耗材** | **337.7 g** | — | 1kg 卷材够用（用掉 1/3） |

> **为什么差这么多**：原文档的 20.5h 是早期按通用/慢速机估的。**拓竹 X2D 是高速机**（工具头最大移动 1000mm/s、流量 40mm³/s），实测底盘单片只要 **2.5 小时**，不是 6 小时。

> 📋 **现场怎么做 → 见同目录 `上机操作卡.md`**（含三种分批方案 A/B/C、上机顺序、每批检查项、故障处理、验收清单）。

## 三、排期影响

**原计划（两次机时）**：10/27 底盘两片 12.2h → 10/29 其余七件 8.3h → 10/30 取件

**新方案（一次机时即可）**：

| 方案 | 条件 | 说明 |
|---|---|---|
| **A（推荐）** | 实验室能给 **8.5–9 h 连续机时** | **10/27 一次打完 9 件**，10/28 就能取件试装 → **多出 2 天返工缓冲** |
| B | 只能给 4h/次 | 底盘两片（5h）拆成两次：先 06a 后 06b；其余七件 3h 一次 |
| C | 只能给短时 | 先打小件（3h 那批），底盘找整天 |

> ⚠️ 实际时间以机器为准，切片器估算通常有 ±10~20% 偏差（尤其首层与换料）。**按 9–10h 预留更保险。**

## 四、床面校验结论

| 件 | 最大占床 | X2D 床面 256×256 | 判定 |
|---|---|---|---|
| 06a/06b | **160×230** | 256×256 | ✅ 余量 96×26mm |
| 10 水箱盖 | 135.9×138.4 | | ✅ |
| 其余 | ≤71 | | ✅ |

**全部 9 件均可按原尺寸直打，无需拆分。**（原担心的"A1 mini 180×180 装不下 230"不成立 —— X2D 是 256×256）

## 五、⚠️ 上机前检查

1. **耗材**：1kg PLA 一卷够（用 325g），但**建议确认卷上余量 ≥ 400g**（含 purge 与失败重试）
2. **打印板**：X2D 支持纹理 PEI / 光面 PEI 等；PLA 用纹理 PEI 附着力好、好脱模
3. **底盘必开 brim 8mm**（160×230 大平面 + 20% 填充，边角易翘）
4. **免支撑**：9 件全部已按"免支撑"几何设计（顶面朝下贴床 / 全垂直壁），切片预设未启用支撑
5. **层高 0.2 / 3 墙 / 20% gyroid** 已固化在 gcode 里，上机直接选文件即可

## 六、复现命令与踩坑

```bash
# 已封装在 .workbuddy/batch_slice.py，核心调用：
bambu-studio.exe --export-3mf <名>.3mf --slice 1 --outputdir <输出目录> \
  --load-settings "…\machine\Bambu Lab X2D 0.4 nozzle.json;…\process\0.20mm Standard @BBL X2D.json" \
  --load-filaments "…\filament\Bambu PLA Basic @BBL X2D 0.4 nozzle.json" \
  --wall-loops 3 --brim-type outer_only --brim-width <3|5|8> \
  <输入.stl>
```

> 📌 **踩坑记录（值得记）**：`--export-3mf` 后面**必须跟输出文件名**（不是布尔开关）。
> 写成裸开关会报 `"The input files to the slicer are not found."` 且 exit=-3 ——
> 这个错误信息**完全不指向真实原因**，我为此排查了 20 分钟（还试了中文路径、代理变量、PowerShell/CMD 各种调用方式）。
