huankechong/smart-greenhouse/outputs/3D打印件/花房3D_水箱盖/交付说明_水箱替换盖v1.md

# 交付说明 · 第 10 件：水箱替换盖 v1（1L 打包桶 + P52 浮球）

> 2026-10-19 首版 · **2026-10-23 按到货实测重出 v2 尺寸** · 参数化脚本 `p10_tank_lid.py` · 产物 `STL/10_tank_lid_v1.stl`
> ⚠️ **2026-10-23 尺寸修订（三次实测迭代）**：
> 1. 首次实测「桶口内径 120 / 外径 124」→ 判定 124 是桶身口沿外径，盖外径改 φ130.4。
> 2. 复测「**桶口最外侧 132**」→ 判定桶口有**加强翻边**（从 124 再外凸 4mm 到 132）。
>    **盖板必须压在翻边顶面、裙边套翻边外径 132** —— 按 124 做盖板会浮空 6.4mm。
>    最终：盖外径 **φ138.4**、裙边内 **φ132.8 × 高 6**。
> 3. 商品页标的 136 与实测 132 接近 → 136 应是含提手座的最大外径。
> 定版背景见《花房项目_AI工作交接文档》与 `.workbuddy/memory/2026-10-19.md`（水箱/浮球选型全程）

## 一、这件是什么

水箱从"118×90 方盒（原 v1 装配占位）"改为**市售 1L PP 打包桶**（淘宝官方标注尺寸，
¥1.55/个 ×5 + 运费）。浮球开关 **P52**（M10 螺纹 / 常开 / 0~110V，**2026-11-09 换 85mm 杆版，原样使用（免切割）**；原 50mm 杆版已退货）要垂直
装在桶顶，原装盖没有孔——本件**替换原装盖**，桶本体不打孔（商品无损、可逆）。

| 桶尺寸 | 值 | 来源 |
|---|---|---|
| **桶口最外侧**（加强翻边外缘） | **132.0** | ✅ **2026-10-23 到货实测** ← **盖按这个尺寸做** |
| 桶身口沿外径（翻边根部） | 124.0 | ✅ **2026-10-23 到货实测** |
| 桶口内径 | 120.0 | ✅ **2026-10-23 到货实测** |
| **桶底直径** | **105.0** | ✅ **2026-10-23 到货实测** |
| **桶身高** | **127.0** | ✅ **2026-10-23 到货实测** |
| **翻边高度** | 暂用 6 | ⏳ **仍未实测** —— 决定裙边能有多深 |
| 满口容量 | 1200 ml | 商品页标注 |
| 侧壁厚 | 2.0 | 由实测反算：(124 − 120) / 2 |
| ~~上径 136~~ | ~~商品页标注~~ | ❌ 实测最外侧是 **132**；136 应是含提手座的最大外径 |
| 满口容量 | 1200 ml | 商品页标注 |
| 侧壁厚 | 2.0 | 由实测反算：(124 − 120) / 2 |
| ~~上径 136~~ | ~~商品页标注~~ | ❌ **实测只有 124**；136 是含提手凸缘的最大外径，不是桶口 |

## 二、结构（打印朝向 = 盖顶面朝下贴床，凸台/裙边朝上）

| 特征 | 尺寸 | 作用 |
|---|---|---|
| 盖板圆盘 | **φ138.4** × **3.5 厚**（2026-10-24: 4→3.5 减重，螺纹咬合 3.5+0.8=4.3mm） | 主板。板厚定 4 是给 M10 螺母留咬合（螺纹长 6，板 4 + 凸台 0.8 → 螺母在桶内侧拧入 4.8mm，够锁紧） |
| 螺母凸台 | φ20 × 0.8 环形，盖板下面（桶内侧） | **替代垫片**（2026-10-19 定版免垫片方案）：M10 六角螺母对角 19.6 < 20，整个坐在凸台环面上承力 |
| 中心孔 | φ10.5 贯穿 | P52 浮球开关杆（M10 + 0.5） |
| 水管孔 | **φ12** @ 距中心 22（泵侧 −Y） | 硅胶管 **外径 10**（实测 2026-10-23）穿盖入桶接泵 |
| 过线孔 | φ8 @ 距中心 **45（−Y，与水管同侧）** | 水泵 USB 线穿盖出桶；2026-10-20 由 +Y30 外移改侧，避开盖顶横跨 |
| 裙边 **（两级阶梯）** | **上段内 φ124.8 × 高 5**（套桶口上段 φ124）+ **下段内 φ132.8 × 高 2**（套凸出环），壁 2.8 | 套住桶口**加强翻边外径 132**（直径向隙 0.8），盖不侧滑。**裙边高必须 ≤ 翻边高**，否则底缘顶在翻边下的台阶上装不进 |
| 指位缺口 | 2 × φ26 半圆（±X 板缘） | 开盖抠手 |

打印参数建议：PLA，0.2mm 层高，壁 3 圈，顶底 4 层，**首层整圆无支撑**（唯一悬空是
凸台/裙边朝上竖印，天然免撑）。**约 79.2g**（2026-10-24 修正后真实重量；旧 45.8g 是凸台被挖没、盖板中心残缺的假值）。

## 二·补 2026-10-24 重要更正：桶口其实是【两级台阶】

领导手绘图 + 实拍特写确认，此前对桶口的理解是错的：

| 段 | 高度 | 外径 | 说明 |
|---|---|---|---|
| **上段** | **5 mm** | **φ124** | 桶口最上面那圈 |
| **下段（凸出环）** | **2 mm** | φ124~132（**待实测**，暂取 132） | 向外凸出的一块 |

**旧版单级裙边（φ132.8 × 高6）的实际咬合**：
- 0–5mm 段桶壁是 φ124，裙边 132.8 → **悬空 4.4mm/边**
- 5–6mm 段才碰到凸出环 → 只咬 1mm
- **合计咬合 ≈ 0** —— 盖子只是"搁"在桶口上，一碰就偏

**已改为两级阶梯裙边**：
- 上段孔 **φ124.8 × 高 5** → 套 φ124，径向隙 0.4mm/边 **紧配**
- 下段孔 **φ132.8 × 高 2** → 套凸出环，径向隙 0.4mm/边 **紧配**
- 总高 7mm = 5 + 2，**套满两级台阶**

**同时修掉一个隐藏缺陷**：旧代码裙边孔 `z ∈ [2,12]` 从盖板内部开始挖，
把 **盖板中心 φ132.8 挖掉 2mm**、并把 **M10 螺母凸台 φ20×0.8 整个挖没** —— 
即螺母原本没有承力面。`check_geometry` 只校验"19.6 < 凸台外径 20"这个参数关系、
没校验凸台是否被切掉，所以 15 轮审计都没发现。现已修正（凸台保留、盖板实心）。

**重量随之从 45.8g（残缺）变为 79.2g（真实）**。盖板选 3.5mm 而非 4mm，为省料省时。

## 三、几何校验（`check_geometry()` 参数反算，非目测）

| 检查项 | 数值 | 判定 |
|---|---|---|
| 螺母对角 19.6 < 凸台 φ20 | 0.4 余量 | ✓ |
| 水管孔缘 ↔ 凸台 | 11.75 | ✓ |
| 水管孔 ↔ 过线孔（间隙） | 13.0 | ✓ |
| 过线孔缘 ↔ 凸台 | 35.0 | ✓ |
| 两孔最远缘 ↔ 裙边内壁 | 29.4 / 17.4 | ✓（裙边内壁半径 66.4） |
| **浮球杆尖 ↔ 泵顶垂直间隙** | **141.5**（桶高 127 实测后；泵在桶内 −Y 12，与浮球环 XY 不重叠） | ✓ |
| watertight / 单体 / z_min=0 | — | ✓（check_report.json） |

浮球安装后杆尖（使用态）= 槽底 3 + 桶身 **127** + 板 4 + 有效长 52 → 距桶内底 186；
泵顶 = 3 + 桶底厚 2.0 + 座 3 + 泵 30 + 嘴 7 = 45.0。**杆尖远在泵上方**，浮球环下沿
(z≈151) 也高于泵顶 106mm，全程不干涉。（脚本内几何校验实测余量 **134.5mm**）

## 四、报警点容量账（2026-11-09 定版：**85mm 杆，原样使用，不用切**）

> **变更**：领导 2026-11-09 退掉两只 50mm 杆浮球；市面上只有 **85mm 杆 P52** 一档可选（M10 螺纹，盖子 φ10.5 孔通用，**不用改件**）。

### 4.1 85mm 刚好落在安全区间

桶内垂直占用（`build_assembly.py` 实测口径）：泵体 z=8~38（吸盘垫高 3）、**泵出水嘴顶 40.5**。

| 螺纹段长度 | 伸入桶内 | 杆尖 z | 距泵顶间隙 | 报警水位 | 可用水量（上限 1200ml） |
|---|---|---|---|---|---|
| 8mm | 77mm | 50 | **+9.5** | 50mm | **742ml** |
| 10mm（最常见） | 75mm | 52 | **+11.5** | 52mm | **723ml** |
| 12mm | 73mm | 54 | **+13.5** | 54mm | **703ml** |

**三种螺纹长度全部安全**（间隙 ≥9.5mm），可用水量 703–742ml，**均 > 单轮连浇上限 650ml**（固件 `waterRounds` 6 轮 × 3s × ~36ml/s）。

### 4.2 为什么 100mm 不行、85mm 行

| 杆长 | 杆尖 z | 距泵顶 | 可用 | 判定 |
|---|---|---|---|---|
| 50mm（已退货） | 87 | +46 | **371ml** | 🔴 < 650ml → 连浇中途断水 |
| **85mm（现用）** | **52** | **+11.5** | **723ml** | ✅ 免切割、不断水 |
| 100mm | 37 | **−3.5** | 866ml | 🔴 杆尖插进泵体（泵体顶 38），装不进 |

> 泵在桶心 (85,32)、浮球杆同轴 → 100mm 无法靠挪泵规避：桶底半径 52.5、泵对角 28.3 → 泵最大偏移 24.2mm，而浮子半径 14mm，中心 ±14 区间必然干涉。

### 4.3 到货验收（三步，5 分钟）

1. **量杆总长**（螺纹头顶 → 杆尖）：应为 85 ± 2mm
2. **量螺纹段**：≥ 8mm（穿盖 4.3mm 后还要留 ≥3.7mm 给螺母咬合）
3. **装桶灌水实测报警水位**：应在 **50–54mm**（≈ 桶内剩 0.45L 时报警）；偏差 >10mm 说明浮子被毛刺/异物卡住

## 五、到货后要做的三件事

1. ✅ **已复测桶口**（2026-10-23）：最外侧 **132** / 桶身口沿 **124** / 口内径 **120** / 桶底 **105**，已回写 `P10` 并重出 STL。
   ✅ **桶身高 127 已实测**。⏳ **仍需补测：翻边高度**（决定 `skirt_h` 能设多大，暂用 6mm；若实测 ≥8 可把裙边加深到 8 更防侧滑）。
2. **复测浮球**：万用表蜂鸣档按《花房接线规划表》第 8 节验收三步确认常开极性。
3. **试装**：盖扣桶口（0.8 径向隙应手压到位不晃）、浮球穿中心孔上螺母、水管/USB 线
   过孔——都是免胶免工具装配。
4. ⏳ **补测翻边高度**（卡尺量翻边顶面到桶身口沿的垂直高度）—— 决定 `skirt_h` 能设多大。暂用 6mm。
5. ⚠️ **若实测最外侧与 132 差 >0.5**：改 `P10` 的 `bucket_mouth_od` 重跑即可（其余几何自动跟随）。

## 六、连带影响（装配模型 v3 待做，见 AR07）

装配脚本 `build_assembly.py` 的水箱仍是 118×90 方盒占位 + 管路"越壁高 76"。换 1L 圆桶后：

- 水箱体 → **桶身 φ124→φ105 锥台 × 高 127 + 口沿加强翻边 φ132 × 高 6**（前壁剖开渲染保留）；
- 桶口沿 z 从 123 抬到 **130**（槽底 3 + 桶高 127）；盖顶 z = 134；浮球杆尖 z = 186。
- 水管越壁点高度 76 → 约 128（盖顶 127 + 管孔位）；
- `check_base_fit.py` 的水箱落座期望（槽底 z=3）不变，但"水体"几何随圆桶重算 —— **2026-10-23 已同步**：该脚本的期望高度改为**从桶实测常量推导**（不再硬编码），改桶尺寸两处自动一致；
- 接线表浮球节（已完成）与固件注释（已完成）无需再动。
