huankechong/smart-greenhouse/outputs/3D打印件/花房3D_P0/STL/⛔02_作废勿打印_泵自带吸盘直吸桶底.md

# ⛔ 02_pump_mount_v1.stl 已作废（2026-10-24）

泵自带吸盘直吸桶底，不需要固定座。本 STL 仅留档，**勿打印**。
打印清单见 `README.md` §三。
