huankechong/smart-greenhouse/outputs/素材/到货照片备份_2026-10-23/README.md

# 硬件到货照片 · 2026-10-23

> **备份原因**：原始照片在微信临时目录（`xwechat_files/.../RWTemp/2026-10/`），**微信会定期清理**，不备份会丢。
> **备份时间**：2026-10-24 01:16 · **校验**：逐张 md5 与原件一致。
> **用途**：AR14 到货核对的原始证据。核对结论见 `docs/审计报告/AR14_GreenHouse硬件到货实拍核对_2026-10-23.md`。

## 隐私核查（2026-10-24，逐张 OCR）

`.gitignore` 的政策是「含淘宝订单页/地址等个人信息的图绝不入库」（规则 `outputs/素材/_敏感_不入库/截图备份_*/`）。
本目录命名为「到货照片备份」，**不匹配该规则**，故已单独逐张核查：

| 图 | 是否含个人信息 | 实际内容 |
|---|---|---|
| 01 WAGO 端子 | ❌ 无 | 端子本体 + 型号印字 |
| 02 P52 浮球 | ❌ 无 | 浮球本体 + 线材 |
| 03 USB 延长线 | ❌ 无 | 产品包装 |
| 04 套件元件袋 | ❌ 无 | 器件袋标签（器件名/规格/采购月份/供应商**公司名**/认证编号），无姓名电话地址订单号 |
| 05 螺母套装 | ❌ 无 | 分格盒 + 型号标贴 |
| 06 手绘图 | ❌ 无 | 纯手绘几何草图 |
| 07 桶口特写 | ❌ 无 | 透明桶口实拍 |

**结论：可公开入库。** 其中 04 含供应商公司名与认证编号（属可追溯采购信息，非个人隐私）。
若日后更保守，可整目录移到 `docs/private/`（已被 gitignore）。

## 清单

| # | 文件 | 原件大小 | 内容 | 核对结论 |
|---|---|---|---|---|
| 01 | `01_WAGO快接端子_8c5fbada.jpg` | 3.67 MB | 4 颗透明壳 + 橙色拨杆器件 | ✅ **万可 WAGO 221 快接端子**（初版误判为继电器，19:05 已更正）→ 标签 7 项与 wago.com 官方规格逐条对上 |
| 02 | `02_P52浮球开关_7c81535b.jpg` | 3.64 MB | 黄色引出线 + 白色圆柱探头 + M10 螺纹 + 红色垫圈 | ✅ **P52 浮球开关**（10/19 自购，已到货） |
| 03 | `03_USB延长线_7080a41b.jpg` | 189 KB | 绿联包装 + 创乐博空袋 | ✅ **绿联 USB2.0 延长线 1m**（A 公-A 母，10/19 自购） |
| 04 | `04_套件元件袋_c7101277.jpg` | 165 KB | 编号袋 + 装片电阻表 + 独立小盒 | ✅ 套件元件包：G-13-13-3/5 硅胶线、A-4-2-1 电阻包、配包135 瓷片电容、蜂鸣器×2 等（批次 689711） |
| 05 | `05_螺母套装_5ff19be9.jpg` | 192 KB | 分格塑料盒 + 标贴 | ✅ **螺母系列 DIY 套装 TZ234 = 304 防松螺母**（深圳佰瑞特，超清单） |

## 命名规则

`序号_内容摘要_原文件名前8位.jpg`

- 序号便于阅读顺序（与当时的沟通顺序一致）
- 保留原件 hash 前 8 位 → 可回溯到微信原文件
- 原件全 hash 见下表

| # | 原件全名 |
|---|---|
| 01 | `8c5fbada4b208cac5156935eec2524fe.jpg` |
| 02 | `7c81535b462c3c7016011b4ba30f90f5.jpg` |
| 03 | `7080a41b525d853bfd2127e4a48c192b.jpg` |
| 04 | `c7101277fa2200528d630c310429a200.jpg` |
| 05 | `5ff19be9dcbdd170e088329f4f5ff834.jpg` |

> 📌 后续若再收到同批照片，按同一规则追加编号，不要覆盖已有文件。
