huankechong/smart-greenhouse/docs/index.md

# docs/ — 项目文档索引

> **文档层**：每个主题一份权威文档。详细取舍在各自的交付说明里，这里只做导航，不重复内容。
> **路径约定：本目录所有文档里的路径一律以「项目根」为基准**（`outputs/…`、`docs/…`、`README.md`），不写 `../`。
> 原则来自 `AGENTS.md` 第 6 节：同一事实只在一处详写，别处放指针。
> 🗂️ 已完成使命的历史文档在 `docs/archive/`（含归档说明 README），仅备查不维护。

## 一、按用途找

| 我想… | 看这份 | 内容 |
|---|---|---|
| **接手这个项目** | `docs/花房项目_AI工作交接文档_2026-10-18.md` | 背景/进展/待办/决策/风险/环境（头部 changelog 记录全过程） |
| 知道**为什么做、答辩怎么讲** | `docs/花房FinalProject方案书.md` | 选题/架构/预算/甘特/答辩加分点/风险预案 |
| 知道**4 个人怎么分工、哪天做什么** | `docs/花房4人分工方案_2026-10-20.md` | **v2（11/06）**：4 张角色卡 + S1–S4 相对排期（D0=11/07 开工、D+2 交打印）+ D0 前已完成账 + 映射规则 + **附录·任务底稿**（原 30 天计划的任务定义库：编号/耗时/验收标准/素材要求） |
| **D0 开工日怎么讲** | （不入库，仅本地）`（已删除；D0 讲解已完成）` | 领导专用讲稿（组员不看，已从仓库移除只留本地/E盘）：开场→原理（整机模型讲解）→进度→仓库导览→分任务→练提交（含可粘贴提示词）→测元件细化，附"万一被问"应答 |
| **组员要往仓库交东西** | `docs/GitHub与Agent提交代码_零基础手册_2026-10-20.md`（唯一版本，v1.1） | 先选路线（Git / 连接器）→ 注册 → 装 Git → 建库拉人 → 克隆授权 → 日常五步 → Agent 提交 → 红线 → 9 种报错 → 一页速查 → macOS 专章（GCM / gh / PAT 三选一） |
| **接线** | `docs/操作手册/花房接线规划表.md` | 8 器件分表（含浮球开关） + 引脚红线 + 面包板布局 + 60s 自查 |
| **整机接线总图（端口级）** | `docs/操作手册/花房接线图_整机总图.html` | 单文件可打印：**面包板行/列级孔位**（两板并排 + ESP32 骑缝 + 左模拟右数字分区）+ 29 根逐线清单（含孔位号）+ ESP32 端口占用表（对照固件 L55–61）+ 强电区定位 + 上电核对；引脚与丝印按 11/06–11/08 实拍校准 |
| **8.1+8.2 继电器水泵接线图** | `docs/操作手册/花房接线图_水泵.html` | 单文件图（可打印）：四色线走向 + 继电器串正极/万可并负极 + 现场顺序；**v3 按 11/08 实测继电器改**——JQC-3FF 输入端 **DC+/DC−/IN 全螺丝端子**（必带小十字螺丝刀），强电侧 NC 不接，排障先拨 High/Low 跳帽再改 RELAY_ACTIVE_HIGH |
| **点火 / 接线 / 标定（合并版）** | `docs/操作手册/硬件操作手册_点火接线标定.md` | 烧录通路 → 接线（焊接排针定案 / 免焊直插备选）→ 自检 → 标定固件 → 干湿标定自动回写 → 烧回主程序；含板子丝印图与排错速查（三份 W1 文档合并） |
| **烧固件** | `outputs/代码/花房代码/GreenHouse_v1/README.md` | 编译开关/烧录节奏/BOOT 键排障；固件现版本 **v1.6**（AR16/AR17 修复版） |
| **打印结构件** | `docs/参考资料/花房3D建模入门路线_SolidWorks.md` → 各 `交付说明` | 模型清单/采购/排期；打印参数与装配步骤在交付说明 |
| 采购 | `docs/参考资料/花房借用与自购清单.md` | 借 8 类（**11/06 已全部借到**）/ 自购已下单 10 项 + 待买 1 项 / 免买 3 项 |

## 二、结构件交付说明（设计取舍 + 已知限制）

| 件组 | 交付说明 |
|---|---|
| P0：01b 土壤传感器**土插支架** / ~~02 水泵座~~（**作废勿打印**，泵吸盘直吸桶底）/ 03 水管夹 | `outputs/3D打印件/花房3D_P0/交付说明_P0三件v1.md` |
| P1+P2 现行三件：04 OLED 支架 / 07 DHT11 座 / 08 扎线座 | `outputs/3D打印件/花房3D_P1P2/交付说明_P1P2五件v1.md`（文中含已取消的 05、已被取代的 06，已标勿打印） |
| 整机底盘 v1.2：06a 左片 / 06b 右片 / 06c 连接块 ×2 | `outputs/3D打印件/花房3D_整机底盘/交付说明_整机底盘两片式v1.md` |
| 水箱替换盖 v1：10（1L 桶 + P52 浮球安装） | `outputs/3D打印件/花房3D_水箱盖/交付说明_水箱替换盖v1.md` |
| 整机示意模型（glb / 离线 HTML / 四视图） | `outputs/3D打印件/花房3D_整机装配/交付说明_整机示意模型.md` |

## 三、审计报告（AR 系列，项目内序号递增）

> 现行依据 = **AR10–AR36**（在 `docs/审计报告/`）；早期报告 **AR01–AR09 已归档**至 `docs/审计报告/archive/`（内容原样保留）。详细结论看各报告本身，这里只留一行摘要。

| 报告 | 一句话主题 | 位置 |
|---|---|---|
| AR01 | 固件四维度审计，v1.0 → v1.1（已归档） | `docs/审计报告/archive/` |
| AR02 | 3D 模型几何审计：6 处装配穿模 + OLED 屏朝向错（已归档） | 同上 |
| AR03 | 底板 × 装配一致性：ESP32 空槽、LED 无安装位（已归档） | 同上 |
| AR04 | 拼缝连接件隐蔽化（M3×8→M3×6 的由来，已归档） | 同上 |
| AR05 | 按示意模型优化 4 件（已归档） | 同上 |
| AR06 | 土壤传感器支架 v2：盆沿双爪版（已归档；后续再改土插式，见 AR15/交接文档） | 同上 |
| AR07 | 低水位保护落地：P52 浮球 + 固件 v1.4 + 水箱替换盖（已归档，定案仍有效） | 同上 |
| AR08 | 示意模型圆桶化（已归档） | 同上 |
| AR09 | 走线优化：0 穿模（已归档） | 同上 |
| AR10 | **全部代码五维审计**：固件 v1.4→v1.5.1，修"连浇上限失效"高危缺口 | `docs/审计报告/AR10_GreenHouse项目代码全面审计_2026-10-20.md` |
| AR11 | 知识库全面审计：25 处文档-代码不一致 | `docs/审计报告/AR11_GreenHouse知识库全面审计_2026-10-20.md` |
| AR12 | 文档口径补漏：预算统一 97–116、E 盘 md5 复核 | `docs/审计报告/AR12_GreenHouse文档口径补漏_2026-10-20.md` |
| AR13 | 云端清空销账 + E 盘分桶对照表 | `docs/审计报告/AR13_GreenHouse云端清空销账与E盘分桶补全_2026-10-20.md` |
| AR14 | 硬件到货实拍核对（WAGO 误判更正记录） | `docs/审计报告/AR14_GreenHouse硬件到货实拍核对_2026-10-23.md` |
| AR15 | **1L 桶实测修订与 3D 重出**：桶口三径 120/124/132、盖 φ138.4、槽 φ107（现行模型依据） | `docs/审计报告/AR15_GreenHouse打包桶实测尺寸修订与3D重出_2026-10-23.md` |
| AR16 | **全量技术审计**：修除零 P0、补依赖清单（v1.6 依据之一） | `docs/审计报告/AR16_GreenHouse全量技术审计_2026-10-24.md` |
| AR17 | **修复后全量重审**：v1.6 实测编译数据来源（269,417/902,077 B） | `docs/审计报告/AR17_GreenHouse修复后全量重审_2026-10-24.md` |
| AR18 | 全仓过时内容清理：13 处文档-代码不一致修复（2026-11-06） | `docs/审计报告/AR18_GreenHouse全仓过时内容清理_2026-11-06.md` |
| AR19 | **文档体系重组**：四板块合并（操作三合一/30天计划入分工方案/历史类归档/手册去HTML）+ AGENTS 纯规则化，docs 主层 17→11 份（2026-11-06） | `docs/审计报告/AR19_GreenHouse文档体系重组_2026-11-06.md` |
| AR20 | **OLED 支架走线位修复**：原板背只留 0.8mm、排针+杜邦头装不进；改裙墙+底部出线，36×34×39.5 / 27.4g（2026-11-07） | `docs/审计报告/AR20_GreenHouse_OLED支架走线位修复_2026-11-07.md` |
| AR21 | **DHT11 小座造型重做**：细方杆+平板+三角撑 → 台锥+收腰+45°喇叭口，35×34×62.8 / 23.1g；顺带修格栅悬空 8.6mm 与浮球线穿柱（2026-11-07） | `docs/审计报告/AR21_GreenHouse_DHT11小座造型重做_2026-11-07.md` |
| AR22 | **光敏电阻定位**：固件一直读 GPIO35 但模型/接线都没位置 → 新增第 10 件 11 光敏小柱（34×30×33.85 / 7.7g），装花盆脚边 (-110,-5)；跳线 22→25（2026-11-08） | `docs/审计报告/AR22_GreenHouse_光敏电阻定位与模型_2026-11-08.md` |
| AR23 | **按实物实测返修**：屏 26.9×28.5 且排针在**上缘** → 04 过线口改上缘；继电器实测 26.2×50 → 06a 槽转 90° 成 27.2×51.2；小灯实为三针模块 → 平放板面（2026-11-08） | `docs/审计报告/AR23_GreenHouse_按实测返修04屏架_2026-11-08.md` |
| AR24 | **全模型可打印性审计（十件逐个）**：11 托盘 0.4mm 薄壁 + 45° 底面；03 柱底 119mm² 悬在 25mm；04 672mm² 桥；06a 盆槽底仅 1mm；LED×屏架干涉 24.7mm³（2026-11-08） | `docs/审计报告/AR24_GreenHouse_全模型可打印性审计_2026-11-08.md` |
| AR25 | **底盘小件嵌槽（完全嵌平）**：06a 新增 04/07/11/08/LED 五个嵌槽，删 LED 通孔与 (−70,0) 扎带槽；06a 258.8g；06b 不动（2026-11-08） | `docs/审计报告/AR25_GreenHouse_底盘小件嵌槽_2026-11-08.md` |
| AR26 | **模型脚本全面审计**：9 个脚本查逻辑/参数/边界，修 3 个真 bug（槽深影响 4 槽、间隙口径、尺寸输错）（2026-11-08） | `docs/审计报告/AR26_GreenHouse_模型脚本代码审计_2026-11-08.md` |
| AR27 | **"浮空区域"炒面根因**：04 裙墙内腔天花 656mm² + 弹性爪 150mm² 是元凶（不是 07 走线口 23mm²）；07 走线口挪侧边（2026-11-09） | `docs/审计报告/AR27_GreenHouse_浮空面修复_2026-11-09.md` |
| AR28 | **01b 板槽三个真 bug**：槽只开在柱子上半段、槽宽 1.4 窄于板 1.6、8° 斜槽偏出柱面（2026-11-09） | `docs/审计报告/AR28_GreenHouse_01b板槽修复_2026-11-09.md` |
| AR29 | **04 屏槽宽高互换**：26.9×28.5 写反 → 装不进且会滑；11 号支撑策略同步（2026-11-09） | `docs/审计报告/AR29_GreenHouse_04屏槽换算_2026-11-09.md` |
| AR30 | **本地 + E 盘 + GitHub 全面审计**：无高危安全漏洞；2 高（1 建模 / 1 文档口径）+ 7 中 + 4 低，已全部修复（2026-11-09） | `docs/审计报告/AR30_GreenHouse_本地与远程全面审计_2026-11-09.md` |
| AR31 | **01b 板槽改阶梯槽**：接线端实测 3.1 厚，上段 3.4 / 下段 1.8，柱深 6→9；16.5 → 22.8 g（2026-11-10） | `docs/审计报告/AR31_GreenHouse_01b阶梯槽_2026-11-10.md` |
| AR32 | **03 插土针加强（⛔ 已回退）**：针 2.0→3.2 + V 撑查出断因是取件弯矩，领导决定回退，改走取件工艺（2026-11-10） | `docs/审计报告/AR32_GreenHouse_03插土针加强_2026-11-10.md` |
| AR33 | **01b 感湿窗（开窗被否）**：试开 17×37 感湿窗 + 接线端开口（17.3 g），领导看效果图后要求恢复封装槽 22.8 g（2026-11-10） | `docs/审计报告/AR33_GreenHouse_01b感湿窗_2026-11-10.md` |
| AR34 | **03 插土针加强**：pin_t 2.0→4.0、去 V 形斜撑（2026-11-10） | `docs/审计报告/AR34_GreenHouse_03插土针加强_2026-11-10.md` |
| AR35 | **01b 定版裸露**（现行口径）：感湿窗 17×37，14.5 g；推翻 AR33「开窗被否」（2026-11-10） | `docs/审计报告/AR35_GreenHouse_01b感湿窗定版裸露_2026-11-10.md` |
| AR36 | **底盘槽口 bug + 布局重排**：嵌槽口 X/Y 共用变量致方口 → 直口定稿；06c 沉槽深 1mm 修正（2026-11-12） | `docs/审计报告/AR36_GreenHouse_底盘槽口bug与布局重排_2026-11-12.md` |

> **下一个编号是 AR34。**

## 四、内部邮件（不在仓库内）

内部沟通邮件含真实姓名与学号，**已于 2026-10-19 移出公开仓库**，只保留在本地：

| 文档 | 位置 | 说明 |
|---|---|---|
| 硬件借用申请邮件模板 v1 | `docs/private/硬件申请邮件模板_v3.md` | 10/17 已发版本，**已作废勿再发**，仅留档 |
| 硬件借用申请邮件 v3 | `docs/private/硬件申请邮件模板_v3.md` | **现行版（待发）**：加焊枪+焊锡丝+万用表，取消雨滴；ESP32 不提（维持自购） |
| DT 学助 SolidWorks 采购咨询邮件 | `docs/private/DT学助_SolidWorks教育版采购咨询邮件.md` | 中英双版定稿，可选发送 |

**邮件签名规则**：英文邮件用 `Liu Junbo（刘俊博）/ Student ID / Class / Phone / Email` 那套；中文邮件用 `刘俊博（Junbo LIU）/ 学号 / 班级 / 联系电话 / 邮箱` 那套。一封邮件只放与正文语言对应的一个签名块，不并列双语。

`docs/private/` 已加入 `.gitignore`，不会再进入版本库。E 盘镜像的对应目录同样只做本地归档。

## 五、镜像与生产源

- **生产源**：本工作区（`D:\Documents\workbuddydocument\2026-10-17-08-59-13\`）
- **用户侧镜像**：`E:\Documents\BU\第一学期\Introduction to Project Work\花房项目\`
- 镜像结构与本地一致：`docs/`、`3D打印件/`、`代码/`、`素材/`、`邮件/`（成品 docx/pdf）
- 改动后必须 `cp` 到 E 盘并 `ls` 验证（有首拷未落盘的前科）
