huankechong/smart-greenhouse/docs/上云联调记录.md

# 上云联调记录（R2）

> 角色 **R2 · 上云与数据** ｜ 分支 `r2-cloud` ｜ 起点 **D0 = 2026-11-07** ｜ 状态：**记录骨架，边做边填**
> 交付物对应任务底稿 11.1–12.3（见 `docs/花房4人分工方案_2026-10-20.md` 附录）。
> 本文只记"做了什么 + 结果 + 证据在哪"，不重复固件代码与接线细节（那是 `outputs/代码/花房代码/GreenHouse_v1/` 与 `docs/花房接线规划表.md` 的事）。

---

## 一、一分钟结论（每次更新先改这里）

| 任务 | 内容 | 状态 | 证据 |
|---|---|---|---|
| 11.1 | 巴法云双主题复核（上行 004 / 下行 001） | ⏳ 待做 | — |
| 11.2 | ESP32 接 MQTT，上行 10s 一条（巴法云 004 格式 `字段#值\|字段#值`，非 JSON） | ⏳ 待做 | — |
| 11.3 | 微信小程序绑定 UID，面板出数 | ⏳ 待做 | — |
| 12.1 | 远程浇水下行（手机点按钮 → 泵出水） | ⏳ 待做 | — |
| 12.2 | 局域网保底网页（`EN_WEB=1`） | ⏳ 待做 | — |
| 12.3 | 巴法云历史数据导出归档 | ⏳ 待做 | — |

> 状态只用三档：⏳ 待做 / 🔧 进行中 / ✅ 通过（带证据）。**没有证据不算通过。**

## 二、红线（动手前先看，踩了要返工）

1. **UID 私钥、WiFi 名与密码不落本文**——只写进 `outputs/代码/花房代码/GreenHouse_v1/config.h`（该文件交报告前要改回 `<...>` 占位符）。
2. **截图必须打码**：控制台首页的 UID、手机状态栏 WiFi 名、小程序里的账号信息。打码前不传群、不提交仓库。
3. **ESP32 只支持 2.4GHz**：校园网多为 5GHz 或带认证页 → 首选**手机 2.4GHz 热点**，答辩现场同样用热点。
4. **免费版历史数据保留期有限**：上云成功**当天**导一次，48h 测试跑完立刻再导一次，不许拖。
5. 本文件不写绝对日期，一律 D0 / D+n（答辩日 D_ans 未定）。

## 三、联调前检查（做一项勾一项）

- [ ] 固件三个开关改 `EN_WIFI 1` / `EN_MQTT 1` / `EN_WEB 1`（`EN_MQTT`/`EN_WEB` 依赖 `EN_WIFI`，v1.6 已加编译期守卫，写错直接编译报错）
- [ ] `config.h` 三项已填真值：`WIFI_SSID` / `WIFI_PASS` / `MQTT_UID`
- [ ] 手机热点已开 **2.4GHz**、可见、非"仅 5GHz"模式；电脑已连同一热点（方便对照）
- [ ] 串口 115200 打开，能看到 `v1.6 启动` 横幅与 7 个开关状态
- [ ] 主题名与固件一致（上行 `TOPIC_DATA` / 下行 `TOPIC_CMD`，以代码为准，不在本文抄录）

## 四、逐项联调记录

### 4.1 MQTT 上行（11.2）

| 项 | 内容 |
|---|---|
| 预期 | 串口出现 `[WiFi] 已连接 IP=…`，随后 `[MQTT] 连接巴法云...成功`，每 10s 一条 `[MQTT] 上行: …` |
| 实际 | 待填 |
| 上行报文样例 | 待填（应为 `土壤#…|光照#…|温度#…|气湿#…|状态#…|水位#…` 形式） |
| 耗时 | 待填 |
| 结论 | 待填 |

### 4.2 小程序绑定（11.3）

| 项 | 内容 |
|---|---|
| 预期 | 绑定 UID 后，面板出现土壤/光照/温度/气湿四路数据，10s 刷新 |
| 实际 | 待填 |
| 证据 | 待填（面板截图，`S3-11.3-小程序面板.png`） |

### 4.3 远程浇水下行（12.1）★ 答辩第二核心素材

| 项 | 内容 |
|---|---|
| 预期 | 小程序发 `on` → 串口打印 `[MQTT] 收到 …: on` + `[远程] 手动浇水开始` → 泵出水约 5s → `[远程] 手动浇水完成` |
| 实际 | 待填 |
| 关键校验 | ① 水位低时应**拒绝**（`[远程] 拒绝：水位过低`）；② 浇水期间 OLED/MQTT 不卡死（非阻塞状态 3） |
| 证据 | 待填（手机点按钮 + 出水的同框短视频，`S3-12.1-远程浇水.mp4`） |

### 4.4 局域网保底页（12.2）

| 项 | 内容 |
|---|---|
| 预期 | 手机连同一热点，浏览器访问串口打印的 IP → 显示土壤湿度 / 光照 / 温度气湿 / 水位 |
| 实际 | 待填 |
| 证据 | 待填（`S3-12.2-局域网页.png`） |

### 4.5 历史数据导出（12.3）

| 项 | 内容 |
|---|---|
| 首次导出时间 | 待填（**上云成功当天**） |
| 归档路径 | 待填（建议 `outputs/素材备份_日期/`，微信 temp 会清） |
| 48h 曲线 | 待填（S4 阶段第二次导出） |

## 五、已知会踩的坑（先看，别重复试错）

| 现象 | 先查什么 | 出处 |
|---|---|---|
| WiFi 连不上、一直打点 | 热点是不是 5GHz；校园网是否要认证页 → 换手机 2.4G 热点 | 方案书 §六 风险表 |
| `[MQTT] 失败(rc=2)` | 巴法云要求 **clientID = UID**，`config.h` 里 UID 是否复制全（含首尾空格） | 固件 `mqttConnect()` |
| 连上了但面板没数 | 主题名对不对；巴法云控制台是否把该主题设成了"开关/插座"类型 | 11.1 |
| 发 `on` 没反应 | 服务端残留旧消息 → 固件收到后会**回写 `off`** 防重复触发；先看串口有没有 `[MQTT] 收到` | 固件 `mqttCallback()` |
| 面板数据忽有忽无 | 免费版连接数/消息数限额；热点断流 | 巴法云控制台 |
| 远程浇了但水泵不动 | 大概率不是上云问题：查 `EN_WATER` 是否 1、继电器极性、标定是否已回填 | `docs/花房接线规划表.md` §六 |

> 真实踩坑**当场**补进这张表（现象 → 根因 → 处置 → 证据）；报告"失败与排查"章节直接取用，事后回忆写不真。

## 六、素材清单（命名 `S{阶段}-{任务号}-{描述}`）

| 文件名 | 内容 | 状态 |
|---|---|---|
| `S3-11.2-串口上行日志.png` | 连续 3 条 `[MQTT] 上行` | ⏳ |
| `S3-11.3-小程序面板.png` | 四路数据在线 | ⏳ |
| `S3-12.1-远程浇水.mp4` | 点按钮 + 出水同框 | ⏳ |
| `S3-12.2-局域网页.png` | 浏览器访问 ESP32 IP | ⏳ |
| `S4-12.3-48h曲线.png` | 48h 历史曲线 | ⏳ |

---

*维护人：R2 ｜ 每次联调结束当场填表，不留隔夜账。*
