huankechong/smart-greenhouse/outputs/项目模式迁移包.md

# WorkBuddy 项目模式迁移包

> ⚠️ **2026-11-06 时效标注（AR18）**：本包写于 2026-10-20，①~④中的状态快照（固件 v1.5.1、10 个打印件、答辩 2026-11-16、等硬件到货、AR13/AR14 指针）**均已过时**。若真要迁入新项目空间，全局指令请以 `AGENTS.md` 现行版为准刷新，不要照抄下文。协作规则条目本身仍有效。
> 用途：把花房项目从"普通对话 workspace"迁入 WorkBuddy「项目 BETA」空间。  
> 组成：①全局指令（贴进项目设置）②知识库上传清单 ③开场白（项目里第一句话）④迁移后双轨注意事项。

---

## ① 全局指令（复制下面整段，贴到项目的"全局指令/项目描述"设置里）

```text
这是"智能花房养护站"项目（BiUH《Introduction to Project Work》Final Project，答辩日期待顺延公布）。
ESP32 + 土壤/光照/DHT11 传感 → 自动浇水 → OLED + 双色LED → 巴法云 MQTT 上云。

协作规则：
1. 称呼用户"领导"，自称"小马"；中文为主，术语保留英文。指令极简（"好/可以/a"=选定方案），确认后自动推进，不重复问。
2. 结论先行；不编数据、不猜图（读不出图用 OCR 并注明"以实物为准"）。
3. 改动前给 2-4 个方案带利弊让领导拍板，不替他定死。
4. 审计修 bug 必写报告：AR序号_项目名_修复报告_日期.md（编号以 AGENTS.md 为准，下一个 AR18）。
5. 删除/移动文件先问；改完必须验证（读回/跑校验），未验证不算完成。
6. 一切 3D 几何由参数化脚本生成，禁止手改 STL；布尔运算用 engine="manifold"。
7. 敏感信息（手机号/密码/UID）不落文档，凭据走占位符。

代码与文档权威源：GitHub 私有仓 huankechong/smart-greenhouse（本地 clone 或 E 盘镜像）。
当前状态（2026-11-06）：固件 v1.6 实机验证✅、9 个打印件 STL+gcode 已切✅、实测尺寸全部回填✅、器材已借到、D0=11/07 开工、答辩日期待公布。
```

## ② 知识库上传清单（**仅当迁入新项目空间时**用；日常不做云端同步）

> 2026-10-20 起，本项目**不再维护云端资料库副本**（云端花房文档已清空停用，以本地 git 为唯一生产源）。本清单保留为"将来真要迁入新项目空间"时的取材范围，不是当下的同步待办。

按优先级排序，全部在 `D:\Documents\workbuddydocument\2026-10-17-08-59-13\`：

| 优先  | 文件 | 为什么 |
| --- | --- | --- |
| ⭐⭐⭐ | `README.md` | 项目总览 + 9 打印件表 + 脚本链 |
| ⭐⭐⭐ | `AGENTS.md` | AI 协作规则全文 |
| ⭐⭐⭐ | `docs/花房项目_AI工作交接文档_2026-10-18.md` | 背景/进展/待办/决策/风险全图 |
| ⭐⭐  | `docs/花房30天执行计划.md` | 到天任务 + 进度快照 |
| ⭐⭐  | `docs/花房接线规划表.md` | 到货接线就用它 |
| ⭐⭐  | `docs/花房FinalProject方案书.md` | 答辩叙事素材 |
| ⭐⭐  | `docs/花房3D建模入门路线_SolidWorks.md` | 模型清单 + 容器/五金采购 |
| ⭐ | `docs/index.md` + `docs/审计报告/`（AR02-17） | 导航 + 质量记录 |
| ⭐ | `outputs/花房代码/GreenHouse_v1/`（.ino/config.h/README） | 固件本体 |

**不要上传**：`.workbuddy/`（memory 私档）、`output/`（申请单含学号）、巴法云截图（含 UID 私钥）、`outputs/截图整理_*/`（含第三方卖家昵称）。

## ③ 开场白（项目里对 AI 说的第一句话）

```text
读知识库里的《花房项目_AI工作交接文档》，然后汇报：当前项目状态一句话 + 最近三件待办。之后所有工作在本项目空间进行。
```

## ④ 双轨注意事项（迁移后）

1. **GitHub 是唯一协作真相源**：项目空间里产出的文档/代码改动，最终要由你或项目 AI push 到 `huankechong/smart-greenhouse`，避免双头维护
2. **本 workspace（对话模式）保留做实验场**：3D 参数化脚本、编译验证这类依赖本地环境（Python trimesh/arduino-cli）的活，项目空间如果跑不了脚本就回到这里做，产物 push GitHub
3. **memory 不迁移**：项目空间有自己的持续记忆；本对话的 memory 日志留档备查
4. E 盘镜像同步习惯不变（老师/同学生效的那份）

---

*生成 2026-10-19 09:05 · 小马*
