huankechong/smart-greenhouse/docs/审计报告/AR29_GreenHouse_04屏槽换算_2026-11-09.md

# AR29 · 04 屏架板槽宽高互换 + 11 号支撑策略 · 2026-11-09

> 触发：领导反馈「04 太窄了而且有点长，屏幕放不进去」。
> 结论：屏幕的**宽/高被写反了**（按 26.9 宽 × 28.5 高开的槽，实际是 28.5 宽 × 26.9 高），两个症状（装不进 + 会滑）都能对上。

## 一、症状 → 成因

| 症状 | 原参数 | 实际 |
|---|---|---|
| 槽太窄，屏塞不进 | `oled_w 26.9` → 槽 27.4 宽 | 屏宽 **28.5** → 差 1.1 |
| 槽太长，屏在里面滑 | `oled_h 28.5` → 槽 29.5 长 | 屏高 **26.9** → 长 2.6 |

## 二、修复

| 参数 | 改前 | 改后 |
|---|---|---|
| `oled_w` | 26.9 | **28.5** |
| `oled_h` | 28.5 | **26.9** |
| 槽（含 0.5 间隙 + 0.5 挡边） | 27.4 × 29.5 | **29.0 × 27.9** |
| 质量 | 28.9 g | 28.8 g |

托盘 35 宽 → 槽两侧壁各 3.0mm；斜面 37.5 长 → 槽上下各留 4.8/4.8，挡边仍在。

## 三、11 号的支撑策略

11 的托盘底面是 52° 斜面（悬垂 38°），属"短悬垂"，**可以不打支撑**；若要打，只允许**树状支撑 + 仅从热床生成**：

- 支撑类型：树状（自动）
- 生成位置：**仅热床**（否则会塞进托盘与柱子的夹角）
- 支撑/模型 XY 间隙 0.25、Z 间隙 0.2
- 打完后用尖嘴钳从根部剪，别硬掰（托盘壁 1.75 薄）

## 四、第二次修正（领导卡尺复测）

屏幕实测 **宽 23.3 × 长 25.3**（此前按 26.9×28.5、28.5×26.9 都不对）→ 槽改 **23.8 × 26.3**（单边 0.25）。04 质量 28.8 → **29.3 g**（槽变小、料变多）；托盘 35 宽 → 两侧壁各 5.6。

## 五、第三次修改：整件缩窄 + 槽深 2.9

领导要求：① 槽再凹一点 → **2.4 → 2.9**（屏面低 1.3）；② 整件缩窄 → **楔块 36 → 31、斜面板 35 → 30**。

- **底座保持 36×34×13**（关键：不动 06a 的 36.2 嵌槽，避免再重打底盘）
- 楔块独立参数 `wedge_x = 31`；斜面板 `head_w = 30`（屏 23.3 + 两侧各 3.1）
- 04 质量 28.9 → **26.1 g**；截面积：z=2/8 → 36 宽，z=20/35 → 31 宽（台阶在底座顶面 z=13，水平面、无悬空）
- `check_base_fit` 全过、干涉 0；合板 04_11 重建 34.2g

## 六、第四次修改：背面镂空减重（2026-11-10，**已按领导要求改回**）

领导要求「提速 + 多镂空」。做法：**从背面切一个三角腔**——

- 腔顶与 45° 斜面平行（仍自支撑），到底面/两侧各留 **3mm**，到斜面按"3 + 槽深 2.9"沿法线让开
- 直接切穿背面 → 看得见的三角镂空
- 质量 **26.1 → 20.7 g（−21%）**；严格水平悬空面 618mm²（改前 577，基本不变，没有新增悬空）
- 45° 腔顶面积 718mm²（自支撑）
- 水密单体；`check_base_fit` 全过

**打印时间**：切片器按质量估 ~29 → **25 分钟左右**；要更快得靠切片参数（0.24 层高 / 2 墙 / 12~15% 填充）。

**结论：领导看过后要求改回实心**（`lighten: False`，2026-11-10 14:51）。原因：省的时间有限（约 4 分钟），但背面开腔影响外观与手感。参数开关保留在 `PARAMS["oled"]["lighten"]`，将来要轻量化可一键打开。

改回后：04 质量 **26.1 g**，md5 `d1a96e22…`（与镂空前完全一致，说明构建是确定性的）；合板 34.2 g。

## 七、待确认

屏幕的宽/高方向以**实物为准**：把屏竖放、丝印能正读、4 针在上边时，横向 = 28.5、纵向 = 26.9。若实测相反，把 `oled_w/oled_h` 换回来即可（1 分钟）。

---

*小马 · 2026-11-09 · 下一个 AR 编号 **AR30***

---

## 七、最终尺寸（2026-11-10 20:15，领导第三次纠正后定稿）

领导原话：「依旧过长、不够宽」→ 说明宽高还是反的。

| 项 | 之前（错） | 现在（对） |
|---|---|---|
| 模块宽（横向） | 23.3 | **25.3** |
| 模块高（沿斜面） | 25.3 | **23.3** |
| 屏槽 | 23.8 宽 × 26.3 长 | **25.8 宽 × 24.3 长 × 2.9 深** |
| 斜面板宽 | 30 | 30（槽两侧各 2.1） |
| 质量 | 26.1 g | **26.1 g** |

md5 `7fcd80d4…`。**教训**：`oled_w/oled_h` 这对参数已被改错两次（26.9/28.5 → 23.3/25.3 → 25.3/23.3），
以后改屏尺寸必须同时确认"横向/沿斜面"两个方向，并在图上标注宽高，不要只报两个数字。

## 八、槽口导入倒角（2026-11-10 20:25，方案 A）

领导问「要不要大一点点」→ 判断**余量不缺**（0.25/边 = 标定值 2.5 倍），缺的是**导入角**。

- 槽口加 **0.6 × 45° 喇叭口**：从斜面下 0.6 处向外扩到斜面上 0.05，四周一圈
- 质量 27.72 g（倒角削掉约 20 mm³）
- 验证：水密、1 体、190 三角面；俯视图槽口可见"双线"= 倒角外沿
- **踩坑**：第一版把放样写成 z −0.05→+0.6（整个落在槽的既有空腔里，没切到料，还破坏水密）；
  正确的是 z −ch→+0.05（从材料内部向外扩）
