huankechong/smart-greenhouse/docs/审计报告/AR35_GreenHouse_01b感湿窗定版裸露_2026-11-10.md

---

## 六、最终定版：裸露版（2026-11-10 19:45）

领导确认要「裸露的」→ `open_window: True`。

| 项 | 值 |
|---|---|
| 感湿窗 | 17 宽 × 37 高（尖顶），土面以下两侧壁全开 |
| 接线端开口 | +Y 侧 17×16 |
| 质量 | **17.3 g**（封闭版 22.8 g） |
| md5 | `7a487a65…`（与先前开窗版一致，构建确定性） |
| 验证 | 窗两侧 (0,±4,20) 均空 ✓ / 侧轨 (±12,0,20) 均实 ✓ / +Y (0,4,60) 空、背面实 ✓ / bodies=1 |
| 配图 | `docs/操作手册/01b_装盆效果图.png`（三剖面，直接取自 STL） |

**装配注意**：板面直接接触湿土 → 装之前在**板背面（非传感面）**薄涂指甲油或硅胶防潮；正面两条感应铜箔不要去涂。
