huankechong/smart-greenhouse/docs/审计报告/AR30_GreenHouse_本地与远程全面审计_2026-11-09.md

# AR30 · 本地工作区 + E 盘镜像 + GitHub 仓库 全面审计

> 审计时间：2026-11-09 23:18–23:55（小马执行）
> 触发：领导指令「对本地 E 盘工作区及指定 GitHub 仓库开展全面审计」
> 结论：**无高危安全/代码 bug；发现 2 项高风险（1 建模、1 文档口径）+ 7 项中 + 4 项低**，全部可执行修复。

---

## 一、审计范围界定

### 1.1 目标仓库与目录

| 项 | 值 |
|---|---|
| 仓库 | `https://github.com/huankechong/smart-greenhouse.git`（**PUBLIC**） |
| 分支 | `main`（本地 1 条 / 远程 1 条，无残留功能分支） |
| 版本 | `cec6d8f`（HEAD = origin/main，工作区干净） |
| commit 数 | 146 |
| 跟踪文件 | **182 个** |
| 本地工作区 | `D:\Documents\workbuddydocument\2026-10-17-08-59-13` |
| E 盘镜像 | `E:\Documents\BU\第一学期\Introduction to Project Work\花房项目` |

### 1.2 文件类型分布

| 类型 | 数量 | 说明 |
|---|---|---|
| `.md` | 60 | 文档 + 交付说明 + AR 报告 |
| `.png` | 51 | 渲染预览 / 校验图 / 接线图 |
| `.py` | 20 | 参数化建模 + 校验脚本 |
| `.jpg` | 15 | 实物照片（到货 / 素材） |
| `.stl` | 12 | 打印件（含 2 个测试块 / 1 个组合件） |
| `.html` | 5 | 整机示意 / 接线图 / 任务卡 |
| `.json` `.ino` `.txt` `.pdf` `.npz` | 4 / 3 / 1 / 1 / 1 | 校验报告 / 固件 / 依赖 / 申请单 / AO 缓存 |

### 1.3 范围边界

**包含**：全部 182 个跟踪文件；固件源码；建模脚本与 STL；E 盘镜像同名文件；git 全历史（146 commit，用于凭据泄露回溯）。

**排除（且已单独核验）**：

| 排除项 | 位置 | 核验结果 |
|---|---|---|
| Agent 记忆 | `.workbuddy/memory/` | 不入库（`.gitignore`），本次仅作上下文参考 |
| 敏感截图 | `outputs/素材/_敏感_不入库/` | `git ls-files` 命中 **0** ✓ |
| 邮件模板 | `docs/private/` | 命中 **0** ✓（含个人信息，本地留存） |
| 工具二进制 | `outputs/.tools/arduino-cli/` | 不入库 |
| 参考归档 | `docs/archive/`、`docs/审计报告/archive/` | 历史文档，**只查链接不断代，不要求内容现行** |

---

## 二、总体结论

| 维度 | 判定 | 依据 |
|---|---|---|
| **敏感信息 / 凭据泄露** | ✅ **零问题** | `config.h` 三值全为 `<...>` 占位符；`git log -p` 回溯全历史，`MQTT_UID` 只出现过占位符，真值从未入库；`docs/private/`（含电话/学号）与 `_敏感_不入库/`（含巴法云私钥截图）均零入库 |
| **代码 bug / 逻辑错误** | ✅ **未发现** | 固件两种形态编译全过（默认 271.7KB/21%，全开 **1055KB/82%**）；无语法错误、无 `#if` 组合冲突 |
| **内容完整性 / 一致性** | 🟡 **1 项高风险口径** | 固件体积文档写 902KB/68%，实测 1055KB/**82%**（详见 H2） |
| **重复 / 过时信息** | 🟡 **31 处过时表述** | 集中在旧件数口径（9 件/8h02m/325g/337.7g）与旧体积 |
| **命名与目录结构** | ✅ **合格** | 0 个含空格的文本文件；`outputs/` 三分法 + `docs/` 五核心+三分组一致；旧 `output/`（单数）已清除 |
| **内部链接有效性** | 🟡 **2 处断链** | 24 份活文档中 2 处（详见 M7） |
| **外部链接有效性** | ✅ **合格** | 6 个 URL：1 个实测 200、1 个仓库主页（代理直连失败但 `gh` 查证存在）、2 个教学占位符、1 个正则误抓、1 个 gh 域名 |
| **E 盘镜像一致性** | 🟡 **7 处内容不同 + 8 处缺失 + 25 个不在规则内** | 见 M1–M3 |
| **建模错误（可打印性）** | 🟡 **1 项高风险** | 04 支架 z=10 处 577mm² 朝下面（详见 H1） |

---

## 三、问题清单

### 🔴 高严重度（2 项）

#### H1 · 04 OLED 支架存在 577mm² 免支撑悬空面，明天就要打

| 项 | 内容 |
|---|---|
| **位置** | STL：`outputs/3D打印件/花房3D_P1P2/STL/04_oled_stand_v1.stl`<br>生成逻辑：`outputs/3D打印件/花房3D_P1P2/p1p2_models.py:198-220`（裙墙 + 内筋） |
| **现象** | z=10.0 处有 **9 片朝下近水平面**（148.4×2 + 70.0×5 + 小片），合计 ≈ **577 mm²**；用 1mm 探针在每片下方 1.5mm 处采样，**实体体积 0.00 mm³** → 下方是空腔，无支撑 |
| **性质** | AR27 已识别并"加两道内筋把中央桥 14 → 10.6mm"，报告明确写「浮空面积 656 → 577mm²，**跨度降到 Bambu 能稳桥的范围**」。即：**这是设计取舍，不是回归 bug** |
| **风险** | 领导已实测过「打印到浮空区域时开始炒面」（AR27 触发原因）。577mm² 分散成 ≤10.6mm 跨度理论上可桥接，但**取决于层间冷却与桥接速度**，实测存在失败先例 |
| **触发条件** | 免支撑切片 + 切片器按"桥接"处理（不生成支撑）→ 桥接层下垂或拉丝；若切片器仍判为"悬空"并跳层 → 直接炒面 |
| **修复建议** | ① **明天切 04 时先看 Bambu 预览的悬空染色**：红色区域若落在底座内腔，**给 04 单独开支撑**（支撑只在腔体内，拆起来 30 秒），成本远低于炒面重打<br>② 根治方案（可选，不阻塞）：把内筋从 2 道加到 3–4 道，把单格跨度压到 ≤6mm；或把底座内腔改为**开侧窗**（腔体不再封闭，彻底消除天花）<br>③ 若本次仍炒面：直接改②，重新生成 STL（脚本改 `fin_x` 循环即可） |

#### H2 · 固件体积口径与实测差 14 个百分点（可能误导后续功能取舍）

| 项 | 内容 |
|---|---|
| **位置** | `AGENTS.md:50`、`README.md:13`（间接引用） |
| **文档写** | 「固件版本：**v1.6**，双形态编译已验证（默认 269KB/20%，**全开关 902KB/68%**）」 |
| **实测（本次重新编译）** | 默认形态 `278260 B = 271.7 KB / 21%`；**全开关形态 `1080420 B = 1055.1 KB / 82%`** |
| **差异** | 全开关：**902KB → 1055KB（+153KB）**，占比 **68% → 82%（+14pp）** |
| **成因** | AR16/AR17 之后固件继续增补（水位保护、手动浇水状态机、Web 页、MQTT 重连），体积增长但 AGENTS 的数字未同步 |
| **风险** | ① 误判"还有 32% 余量"（实际只剩 **18% ≈ 230KB**）→ 后续加功能（更大 Web 页 / 第 6 个传感器 / OTA）时可能撞 1.25MB 上限才发现<br>② 报告/答辩若引用 68%，与实测不符 |
| **修复建议** | 把 `AGENTS.md:50` 改为「默认 271.7KB/21%，全开关 **1055KB/82%**（余量 ≈230KB，加功能前先估算）」，并在 AR 报告里记一次复测口径 |

---

### 🟡 中严重度（7 项）

#### M1 · E 盘镜像 7 个文件内容已过期（md5 不一致）

路径按 AGENTS §6 分桶表反算比对，仓库 154 个可镜像文件中 **139 个 md5 一致**：

| 文件 | 说明 |
|---|---|
| `AGENTS.md` | 今晚多处修改（焊锡/切片/排期）未同步 |
| `docs/index.md` | 同上 |
| `docs/archive/花房30天执行计划.md` | 11-08 路径替换后未同步 |
| `docs/审计报告/AR20_GreenHouse_OLED支架走线位修复_2026-11-07.md` | 同上 |
| `docs/工作日志/上云联调记录.md` | PR#5/PR#6 合并后未同步 |
| `outputs/3D打印件/花房3D_P0/p0b_sensor_hook.py` | AR28 修复（tilt/gap/slot）未同步 |
| `outputs/3D打印件/花房3D_整机装配/audit.py` | 今晚三处修复（ROOT/③停用/组合件判据）未同步 |

**修复**：`cp` 这 7 个到 E 盘同名位置（已在本次审计后待执行）。

#### M2 · E 盘镜像缺失 8 个文件

| 缺失文件 | 后果 |
|---|---|
| `docs/操作手册/花房接线图_整机总图.html` | E 盘打开无图 |
| `docs/操作手册/花房接线图_水泵.html` | 同上 |
| `outputs/3D打印件/_打印参考/上机操作卡.md` | 打印现场无参数卡 |
| `outputs/3D打印件/_打印参考/切片报告.md` | 无耗时/耗材口径 |
| `outputs/3D打印件/组合件/04_11_combo.stl` | 明天要用的合并件不在镜像 |
| `outputs/3D打印件/花房3D_整机装配/preview/08_合板三件说明.png` | — |
| `outputs/素材/…/S2-10.1-接线图打印稿现场对照.jpg` | 素材缺 |
| `outputs/素材/…/S2-13.1-10水箱盖与11光敏柱成品.jpg` | **成品照缺（唯一的两件同框照）** |

**修复**：按路径 `cp`，其中 2 个在 `docs/操作手册/` 下（html）。

#### M3 · E 盘分桶规则有缺口：`outputs/接线图生成器/` 25 个文件从未镜像

**位置**：`AGENTS.md:82-95`（E 盘分桶对照表）

**现象**：分桶表只定义了 `outputs/3D打印件|代码|素材` 与 `docs/**`，**未覆盖 `outputs/接线图生成器/`**（PR#5 新增，含 2 张交付 PNG + 16 张调试用 `_lead_*.png` + 3 个 py）。

**影响**：① 该目录 25 个文件在 E 盘完全不存在 → 若只交 E 盘，接线图交付物缺失；② 目录内混有 16 张 `_lead_*.png`（中间调试图，非交付物），直接镜像会把垃圾带过去。

**修复建议**（二选一）：
- **A（推荐）**：把交付物规整进既有分桶 —— `导出PNG/2 张图` 移到 `outputs/素材/`（或 `docs/操作手册/`），脚本移到 `outputs/代码/`；删除 16 张 `_lead_*.png` 与 2 张 `_v5_preview_*.png`
- **B**：在分桶表新增一行 `outputs/接线图生成器/ → 接线图生成器/`，并先瘦身（删调试图）

#### M4 · 打印日志同一文件内三种口径并存

**位置**：`docs/工作日志/打印日志.md`

| 行 | 内容 | 口径 |
|---|---|---|
| 27 | 「十件相加 **337.7**」 | 旧十件（04/07 复切前） |
| 101-102 | 「总耗时 **8h02m** / 总耗材 **325g**」 | **九件旧口径** |
| 21 附近 | 「合计基线 **8h37m / 338.1g**」 | ✅ 现行 |

**修复**：101-102 行改为 `8h37m / 338.1g`；27 行 `337.7` → `338.1`。

#### M5 · AGENTS.md:102 仍写「9 件打印 STL」

现行为 **10 件**（01b/03/04/06a/06b/06c/07/08/10/11，02 作废）。同段后面还写「9 件…」，与 §7 标题「现行 10 件」自相矛盾。

**修复**：`AGENTS.md:102` 改「10 件」，并补 `11` 到件号列表。

#### M6 · 分工方案 3 处旧口径（8h02m/325g、9 件、gcode 已切）

**位置**：`docs/花房4人分工方案_2026-10-20.md:75 / 97 / 255`

| 行 | 问题 |
|---|---|
| 75 | 「切片文件已删」表述 OK，但同句夹带旧耗时 |
| 97 | 「9 件 STL + gcode 全部切好」→ 现 10 件、gcode 已全删 |
| 255 | 「X2D 实切 8h02m/325g，gco…」→ 旧口径 |

**修复**：三处统一为「10 件 / 8h37m / 338.1g / gcode 已于 11-08 删除」。

#### M7 · 2 处内部断链

| 位置 | 断链目标 | 原因 | 修复 |
|---|---|---|---|
| `outputs/3D打印件/花房3D_整机装配/交付说明_整机示意模型.md` | `docs/审计报告/AR02_GreenHouse3D模型审计修复报告_2026-10-18.md` | AR02 已归档进 `docs/审计报告/archive/` | 改路径为 `docs/审计报告/archive/AR02_…` |
| 同上 | `outputs/花房3D概念模型/` | 该目录已被整机装配取代并删除 | 改为「（已删除，被 `花房3D_整机装配/` 取代）」 |

---

### 🟢 低严重度（4 项）

#### L1 · 11 光敏小柱有 83mm² 单格悬空面（z=19.4）

探针验证：下方 1.5mm 无实体。但单格 83mm²、跨度小，**今天已实际打印成功**（11 号成品在手），属可接受。**无需动作**，仅记录。

#### L2 · 同名文件 4 组（不影响功能，易混淆）

`README.md` ×4（根 / docs/archive / 固件 / 到货照片备份）、`check_report.json` ×4（各 3D 目录）。均为各自目录内的本地说明/校验输出，**符合习惯，不要求改名**。

#### L3 · 素材覆盖缺口：4 件已打，成品照仅 1 张

| 件 | 已打 | 成品照 |
|---|---|---|
| 08 | ✅ 11-08 | ❌ |
| 10 | ✅ 11-09 | ✅（与 11 同框） |
| 11 | ✅ 11-09 | ✅（同框） |
| 07 | ✅ 11-09 | ❌ |

**修复**：补拍 08 / 07 / 10 单件照（10 已有同框，建议补单件），按 11-09 新立的「一件一张」规矩。

#### L4 · `audit.py` 的 ③ 段已停用，需在文档标注

今晚我把 ③「文档数字对账」停用并写了原因注释（口径从 `volume×1.24` 估算改为切片实测）。但 `README.md` §五「改完必须跑校验」仍把 `audit.py` 描述为「10 个 STL 自检 + 两两干涉 + **文档数字对账**」。

**修复**：README 该行删掉「+ 文档数字对账」，或在 audit.py 三字后加「（①几何 ②干涉；③对账已停用）」。

---

## 四、优先处理事项

### P0（明天 11/10 之前）

| # | 事项 | 影响 |
|---|---|---|
| 1 | **切 04 时看 Bambu 悬空预览；红色落在底座内腔就单独开支撑** | 防炒面重打，明天就打这 4 件 |

### P1（今晚 / 明天顺手，10 分钟内可完成）

| # | 事项 | 动作 |
|---|---|---|
| 2 | 修 AGENTS 体积口径（H2） | 902KB/68% → 1055KB/82% |
| 3 | 修打印日志 3 处旧口径（M4） | 337.7→338.1、8h02m/325g→8h37m/338.1g |
| 4 | 修 AGENTS「9 件」→「10 件」（M5） | 1 行 |
| 5 | 修 2 处断链（M7） | 2 行 |
| 6 | 补 E 盘 7 个过期 + 8 个缺失（M1/M2） | `cp` 批量 |

### P2（本周内，不阻塞打印）

| # | 事项 | 动作 |
|---|---|---|
| 7 | `outputs/接线图生成器/` 瘦身 + 归位（M3） | 删 18 张调试图，交付物并入素材/操作手册；或补进分桶表 |
| 8 | 分工方案 3 处旧口径（M6） | 统一为 10 件/8h37m/338.1g |
| 9 | README 补 audit.py 的新口径（L4） | 1 行 |
| 10 | 补拍 08/07/10 单件成品照（L3） | 现场 1 分钟 |
| 11 | 04 内腔根治（H1 方案②，可选） | 内筋 2→3-4 道，或开侧窗；改脚本重出 |

---

## 五、修复记录（2026-11-09 23:30–23:45 执行，领导指令「都修了」）

| 项 | 处理 | 验证 |
|---|---|---|
| **H2** 固件体积口径 | `AGENTS.md:50` 与 `README.md:13` 改为「默认 271.7KB/21%，全开关 **1055KB/82%**（余量 ≈230KB）」 | 复扫 `902KB\|269KB` → 0 |
| **M1** E 盘 7 个过期 | 全量镜像脚本覆盖 | md5 复比 → **0 差异** |
| **M2** E 盘 8 个缺失 | 同上（含 2 个接线图 HTML、组合件 STL、2 张素材照） | md5 复比 → **0 缺失** |
| **M3** 接线图生成器 25 文件不在规则内 | ① 2 张交付 PNG 归位 `docs/操作手册/接线图导出/`；② `AGENTS.md` 分桶表新增一行「不镜像（脚本 + 调试中间图，可再生）」；③ **不删任何文件**（调试图保留原处，等领导明确） | 分桶表已含该目录 |
| **M4** 打印日志三种口径 | 337.7→**338.1**、8h02m→**8h37m**、325g→**338.1g** | 复扫旧口径 → 0 |
| **M5** AGENTS「9 件」 | 改「**10 件**」并补件号 `11` | — |
| **M6** 分工方案 3 处 | 75/97/255 行统一为 10 件 / 8h37m·338.1g / gcode 已删 | — |
| **M7** 2 处断链 | AR02 路径补 `archive/`；「已删目录」表述改为不引路径 | 链接扫描 → 0 |
| **L4** README 的 audit 描述 | 改为「① 12 STL 自检（含组合件多体判据）② 两两干涉；③ 对账 2026-11-09 停用」 | — |
| **补充** 交接文档 P1 行、`_打印参考` 两文件 | 交接文档改为 10 件/8h37m·338.1g；**`_打印参考` 两文件不改历史数字**，改为在头部加「口径说明」——它们是 10-24 首切的原始记录，回溯改数会破坏记录真实性 | 复扫排除 `_打印参考` 后 → 0 |

**未修（有意保留）**：

| 项 | 原因 |
|---|---|
| **H1** 04 支架悬空面 | 明天就要打 04，此刻改模型 = 重新全链验证 = 引入新风险。**按 P0 处置**：切片时看 Bambu 悬空染色，落在底座内腔就单独开支撑（拆 30 秒）。根治方案（内筋 2→3-4 道 / 开侧窗）留到首件试打后再评估 |
| **L3** 素材 4 件仅 1 张成品照 | 需现场拍（08/07/10），agent 无法代拍 |
| **L1/L2** | L1 已实打成功无需动作；L2 同名文件合规，不要求改名 |

**终验结果**：

```
E 盘镜像：一致 155 ｜ 内容不同 0 ｜ 缺失 0
活文档过时表述：0 处（排除 _打印参考 历史记录后）
内部断链：0 处
```

## 五、审计方法与可复现性

| 检查 | 方法 | 说明 |
|---|---|---|
| 敏感信息 | `grep` 密钥模式 + `git log -p` 全历史回溯 + `git ls-files` 核对排除目录 | 不用"看一遍"，用内容扫描 |
| 固件 bug | 两种形态实编译（默认 / 全 7 开关） | 编译通过 + 体积实读，非估算 |
| 建模悬空 | 面法线 `nz<-0.7` 筛朝下面 → 按面积排序 → **1mm 探针盒布尔求交**验下方支撑 | 未用 `mesh.contains()`（AGENTS 红线） |
| E 盘一致性 | 逐文件 **md5** 比对（含反向：E 盘独有文件） | 非 `[ -e ]` 存在性判断（AR12 教训） |
| 链接 | 正则抓 `outputs/…` `docs/…` 反引号引用 → `os.path.exists` | 排除省略号/通配符/占位符写法 |
| 外链 | `curl -w %{http_code}` + `gh repo view` 交叉验证 | 区分"代理不通"与"真失效" |

---

*小马 · 2026-11-09 · 下一个 AR 编号 **AR31***
