huankechong/smart-greenhouse/docs/审计报告/AR12_GreenHouse文档口径补漏_2026-10-20.md

# AR12 · 文档口径补漏与 E 盘镜像复核报告

> 日期：2026-10-20 · 审计人：AI（小马）· 触发：领导"阅读项目文档"后裁定"把五做了"
> 范围：`docs/花房项目_AI工作交接文档_2026-10-18.md`、`docs/参考资料/花房借用与自购清单.md`、`docs/index.md`、`AGENTS.md`、`outputs/项目模式迁移包.md` + E 盘镜像 23 份关键文件
> 分级：🔴 破坏性 · 🟡 事实错误（数字对不上）· 🟢 表述滞后 · 🔵 误判澄清

---

## 一、总览

| # | 问题 | 分级 | 原值 | 改为 |
|---|---|---|---|---|
| 1 | 交接文档预算口径停留在 AR07 之前 | 🟡 | 已花约 **76–89 元** | 已花约 **97–116 元**（含待买合计 107–136，余量 14–43） |
| 2 | 交接文档 AR 指针停在 8 个版本前 | 🟡 | 已用到 **AR06**，下一个 AR07 | 已用到 **AR12**，下一个 **AR13** |
| 3 | 交接文档版本头未记 AR11 | 🟢 | 版本 v1.5（只到 AR10） | 版本 **v1.6**，补 v1.6 变更行 |
| 4 | 项目审计行只写"两轮" | 🟢 | 文档层审计两轮（10/17、10/18） | **三轮**（补 10/20 AR11 + AR12） |
| 5 | 目录地图 AR 清单缺 AR11/AR12 | 🟢 | `AR02 · … · AR10.md` | `AR02 … AR12.md` |
| 6 | 清单预算估算与逐项加总不符 | 🟡 | 已花约 95–115 元 | **97–116 元**（附加总明细与余量） |
| 7 | **E 盘"缺 3 文件"是误判** | 🔵 | 报"实缺 .gitignore + 2 份说明" | **镜像完整**：23 份比对，22 份逐字节一致 + 1 份仅行尾差异 |

**一句话结论：AR11 宣称"25 处不一致全部修正"，但项目级口径仍有 6 处滞后（预算、AR 指针、版本头、审计轮次、目录地图、清单估算）；同时我在上一轮汇报里把 E 盘镜像误判为"缺 3 个文件"，实测推翻，已在第四节完整留档。**

---

## 二、问题逐条

### 1. 🟡 交接文档预算口径：76–89 → 97–116 元

- **位置**：`docs/花房项目_AI工作交接文档_2026-10-18.md` §一 定位行（原 L18）
- **成因**：AR07（10/19）一次性增补了 P52 浮球 + 1L 打包桶 ≈28 元、22AWG 硅胶线 ≈17.2 元、1N4007、USB 延长线、M3 螺丝、WAGO 端子等 6 项已买件，**但当时只更新了《借用与自购清单》，没回头重算交接文档的"已花"总额**。AR11 扫了版本号与件数，没扫金额。
- **影响**：答辩/汇报时按 76–89 元报预算，与清单对不上；"余量"被高估约 20–30 元，若答辩前再补买东西容易超预算而不自知。
- **修复**：改为按清单 2.2 逐项加总的区间，并把加总明细写进括号，便于现场复核：

| 项 | 金额（元） |
|---|---|
| ESP32（10/17 实付） | 14.17 |
| 电容土壤传感器 v2.0 ×2 | 5–8 |
| USB 微型水泵 + 硅胶管 ×2 | 10–15 |
| P52 浮球 ×2 + 1L 桶 ×5 | ≈28 |
| 22AWG 硅胶线 | ≈17.2 |
| 1kΩ + 100nF | 1–8 |
| 1N4007 ×5 | 1–2 |
| USB 延长线（实付） | 13.91 |
| M3×6 自攻 + PH1 | ≈5 |
| WAGO 221 端子 | 2–5（按 1 个计） |
| **已花合计** | **97.28–116.28 → 约 97–116** |
| 待买：花盆 + 绿植 | 10–20 |
| **总计** | **约 107–136**，预算 150 元 **余量 14–43** |

- **验证**：上下限分别手算两遍（见上表），清单第 46 行与交接文档第 19 行文字完全一致。

### 2. 🟡 交接文档 AR 指针：已用到 AR06 / 下一个 AR07

- **位置**：§八 协作规则第 3 条（原 L170）
- **成因**：AR07–AR11 五轮审计都只更新 `index.md` 与 `AGENTS.md` 的编号，**交接文档这条"给人看的规则行"从未同步**。这是本项目文档链反复出现的同一形态：权威文档改了，交接文档滞后。
- **影响**：下一个 AI 接手第一份就读这份文档，会按"下一个是 AR07"编号 → 直接和已有 AR07 撞号，重演 AR11 修掉的编号冲突问题。
- **修复**：`**已用到 AR12，下一个是 AR13**（AR11 知识库审计 / AR12 口径补漏）`，并顺手把两轮审计主题写进括号，防混用。

### 3. 🟢 版本头停在 v1.5

- **位置**：文件头注（原 L3）
- **成因**：AR11 是"知识库审计"，属于对文档层的改动，但交接文档自己的版本号没跟着升。
- **修复**：升 **v1.6** 并插入 v1.6 变更行，把本轮 5 项改动与 E 盘复核结论一次写清；v1.5 及更早变更行**原样保留**（历史不改写）。

### 4. 🟢/🟡 其余三处小滞后

| 位置 | 原值 | 改为 |
|---|---|---|
| §二 项目审计行（L37） | 文档层审计**两轮**（10/17、10/18） | **三轮**（补 10/20 AR11 25 处 + AR12） |
| §五 目录地图（L91） | `AR02 · AR03 … AR10.md` | `AR02 … AR12.md` |
| 清单 §2.2 末（L46） | 已花约 95–115 元，余量 35–55 | 97–116 元，余量 34–53；含待买合计 107–136，余量 14–43 |

---

## 三、修复明细（脚本化，逐条断言）

改动全部由一个脚本 `.workbuddy/tmp/ar12_fix.py` 完成，**每条替换断言命中次数 = 1**，任一条不匹配即整体退出、不写盘：

| # | 文件 | 替换内容 | 命中 |
|---|---|---|---|
| 1 | 交接文档 | `版本 v1.5` → `版本 v1.6` | 1 |
| 2 | 交接文档 | 插入 v1.6 变更行（5 项） | 1 |
| 3 | 交接文档 | 预算 76–89 → 97–116 + 加总明细 + 余量 | 1 |
| 4 | 交接文档 | 文档层审计两轮 → 三轮 | 1 |
| 5 | 交接文档 | 目录地图 AR 清单 → `AR02 … AR12.md` | 1 |
| 6 | 交接文档 | AR 指针 AR06/AR07 → AR12/AR13 | 1 |
| 7 | 借用清单 | 95–115 → 97–116 + 待买合计与余量 | 1 |
| 8 | `docs/index.md` | AR 表新增 AR12 行 | 1 |
| 9 | `docs/index.md` | AR02–AR11 → AR02–AR12，下一个 AR13 | 1 |
| 10 | `AGENTS.md` | 已到 AR11/AR12 → 已到 AR12/AR13 + AR12 主题 | 1 |
| 11 | 迁移包 | 已到 AR11 → 已到 AR12 | 1 |

**未采用逐处 find/replace**：按 `AGENTS.md` §2"大文档整份重建"的教训，改为脚本一次性替换 + 命中数断言，避免中文路径/换行符导致的错位。脚本读写均用 `newline=""` 保留原换行符（交接文档为 LF）。

---

## 四、🔵 误判澄清：E 盘"缺 3 个文件"不成立

上一轮汇报（15:35）我写"E 盘镜像实缺 3 个文件：`.gitignore`、`outputs/3D打印件/花房3D_整机装配/交付说明_整机示意模型.md`、`outputs/代码/花房代码/GreenHouse_v1/README.md`"，**这个结论是错的**。

- **错因**：E 盘镜像**不沿用 `outputs/` 目录名**，而是按人类可读名分桶——`3D打印件/`、`代码/`、`docs/`、`素材/`、`邮件/`。我拿仓库相对路径 `outputs/...` 去 E 盘拼接，必然 `[ -e ]` 为假，于是三个文件全被判"缺失"。**这是路径假设错，不是文件缺失。**
- **实测复核**（22 份关键文件逐个 `md5sum` 本地 vs E 盘）：

| 组 | 文件数 | 结果 |
|---|---|---|
| 3D 整机装配交付说明 | 1 | md5 一致 ✅ |
| 固件 `GreenHouse_v1`（.ino / README / config.h） | 3 | README、config.h 一致 ✅；**`.ino` 行尾不同**（见下） |
| 根文档（README.md / AGENTS.md） | 2 | 一致 ✅ |
| `docs/` 七份主题文档 | 7 | 一致 ✅ |
| `docs/审计报告/` AR02–AR11 | 10 | 一致 ✅ |
| **合计** | **23**（含 .ino） | **22 一致 + 1 行尾差异** |

- **`.ino` 行尾差异**：本地 24,773 B（CRLF）、E 盘 24,258 B（LF），差 515 字节；`tr -d '\r'` 后两边 md5 **同为 `4adeceffc0a4ddbcea549603798b5ea9`**，即**内容逐字节相同，仅行尾风格不同**。这与 AR11 记录的"归一化后 md5 4adeceff"完全吻合——E 盘那份是归一化（LF）产物，本地是编辑器保存的 CRLF 版。**无需处理**：Arduino 编译器两者等价，git 也按 LF 存储（`git hash-object` = `f75b7b84…`）。
- **`.gitignore`**：E 盘镜像不是 git 仓库，本就不需要该文件，**不算缺失**（不补）。

**教训（已写进本报告，供下次自查）**：核对镜像不得默认目录名与仓库一致——**先 `ls` 目标根目录确认真实分桶名，再拼路径**；判断"缺失/不一致"前必须做 md5 或去行尾比对的**内容级校验**，不能只靠 `[ -e ]`。

---

## 五、验证证据

| 验证项 | 方法 | 结果 |
|---|---|---|
| 11 条替换命中 | 脚本逐条 `text.count(old) == 1` | 11/11 OK ✅ |
| 预算上下限 | 手算两遍（下限 97.28 / 上限 116.28） | 与写入值一致 ✅ |
| 交接文档读回 | `sed -n '1,12p'` + grep 关键行 | v1.6 头注、预算行、审计行、目录地图、AR 指针全部就位 ✅ |
| AR 指针一致性 | grep `已到 AR12` 于 AGENTS / 迁移包 / 交接文档 | 三处均为 AR12 → AR13 ✅ |
| 旧口径残留 | grep `76–89|已用到 AR06|95–115|下一个编号是 AR12` | 仅剩 2 处**引述性**文本（v1.6 变更行、index AR12 行本身），非错误 ✅ |
| E 盘镜像 | 23 份 `md5sum` 双端比对 | 22 一致 + 1 行尾差异（去 CR 同 md5）✅ |
| 固件内容等价 | `tr -d '\r'` 后 md5 比对 | 双端 `4adeceff` ✅ |
| 换行符保全 | 脚本 `newline=""` 读写 | 未引入 CRLF/LF 混用 ✅ |
| 提交撞车核查 | `git log --stat efaf431` + `git ls-remote origin` | AR12 的 7 个文件被并行提交 `efaf431` 夹带；本地 HEAD = origin/main = `efaf431` ✅（详见 §六 第 5 条） |
| 零宽字符 | 扫 U+200B/C/D/FEFF | 报告内 1 处 U+200B 已清，三份文件复扫 `OK` ✅ |

---

## 六、已知限制与建议

1. **预算区间不是精确值**：清单里 6 项写的是"参考价区间"（如 5–8 元），实际以订单为准。**建议**：答辩前把淘宝订单实付逐笔填进清单 2.2，把区间收成单一数字，报告里就能写"实付 XX 元"。
2. **WAGO 端子数量未定**：按 1 个计（±2–5 元）。若按接线表需要 412 二线位 + 413 三线位各 1 个，应改为 2 个，届时上限 +5 元。
3. **金额口径没有单一真相源**：清单 2.2 是加总依据，交接文档只是引用。**再改采购必须改清单、再同步引用**——这条已写进 §一 的括号里，减少下次漏改。
4. **E 盘镜像没有自动校验脚本**：本次是手工 md5。**建议**（可选）：把 `ar12_fix.py` 同目录放一个 `check_mirror.py`，一键比对本地↔E 盘全部 md，省得每次靠记忆拼路径。本次未做，等领导裁定。
5. **★ 提交撞车留档（重要）**：本轮改动落盘并读回验证后，**被并行流程的 `efaf431`（提交信息为"云端清空状态确认：销账最后一条残留"）一并提交并推送**——该提交信息只描述云端清空与 AR11 第 7 条补记，实际 diff 里夹带了本轮 AR12 的全部 7 个文件（AGENTS.md / index.md / AR11 / AR12 新报告 / 借用清单 / 交接文档 / 迁移包，+164/−10）。**提交信息与实际内容不符**，日后追溯 AR12 会找不到对应 commit message。
   - 处置：不擅自改写他人已 push 的历史（不 rebase / 不 amend）；改为在本报告留档说明，**AR12 的实际落盘凭据 = `efaf431` 这笔提交**。
   - 二次修正（22/23 统计口径统一、U+200B 零宽字符清理）在本报告写下时仍在工作区未提交，**等领导裁定后单独补一笔**，提交信息会写明 AR12 追加修正。
   - 教训：**多会话并行时，任何 `git add -A` / `git commit -a` 都会把别人的半成品一起卷进去**。以后提交前必须先 `git status` 核对文件清单，只 `git add <精确路径>`。

---

## 七、版本演进

| 编号 | 日期 | 主题 |
|---|---|---|
| AR10 | 10-20 | 全部代码五维审计：固件 v1.4→v1.5.1，15 发现 4 修复 |
| AR11 | 10-20 | 知识库全面审计：AR 编号重复修正 + 25 处文档-代码不一致 |
| **AR12** | **10-20** | **文档口径补漏（预算/AR 指针/版本头/审计轮次）+ E 盘镜像 23 份 md5 复核，含 1 处误判澄清** |
