huankechong/smart-greenhouse/docs/审计报告/AR18_GreenHouse全仓过时内容清理_2026-11-06.md

# AR18 · GreenHouse 全仓过时内容清理（GitHub 同步审计）

> 审计日期：2026-11-06 · 审计人：小马（WorkBuddy）
> 触发：领导指令"全面整理并同步 GitHub 仓库中的所有文件，重点检查过时内容"。
> 范围：仓库全部 git 跟踪文件（156 个）——根目录 5 个配置/文档 + docs/ 36 份 + outputs/ 全目录 + .gitignore；**不含** .workbuddy/、docs/private/、output/（不入库目录）。
> 方法：git status/log 对账远程 → 逐文件通读 → 对照项目当前已知状态（固件 v1.6 实机验证、9 件 gcode 已切、AR15 实测回填闭环、11/06 器材借到、D0=11/07、答辩顺延未定）→ grep 全仓扫旧口径残留（v1.5.1 / 10 个打印件 / 34,734 / 48–81 元 / AR13 指针等）。

---

## 一、总账

| 维度 | 结论 |
|---|---|
| git 同步状态 | ✅ 无问题：工作区干净，本地 = origin/main（`f8b560f`），无未推送提交 |
| 代码本体 | ✅ 无过时：`.ino` v1.6、建模脚本、校验脚本与文档描述一致 |
| **文档层** | 🔴🟡 **13 处过时**（本轮全部修复），🟢 6 处轻微滞后（挂账 D_ans 公布后统一处理） |
| 依赖声明 | 🔴 2 处（package.json 依赖错配 + requirements.txt 注释失实，本轮修复） |
| 隐私红线 | ✅ 复查通过：.gitignore 覆盖完整，无凭据/个人信息新增泄露 |

## 二、问题清单与修复明细

### 🔴 高危（误导复现/执行，4+1 项）

| # | 文件 | 问题 | 成因 | 修复 |
|---|---|---|---|---|
| 1 | `README.md` §一 | 状态表停在 2026-10-20："等快递(10/21)""打印未开打、底盘各约 6h"，缺 11/06 器材借到/D0 信息 | 10/20 后只在 AGENTS/交接文档 changelog 更新，README 门户未刷 | §一整节重写为 2026-11-06 现状（含 D0/D+2 相对排期） |
| 2 | `README.md` L5 | 开头"10 个结构件"与 §三"9 个打印件（02 作废）"自相矛盾 | 10/24 02 作废时只改了 §三 | L5 改 9 个，与 §三一致 |
| 3 | `outputs/代码/花房代码/GreenHouse_v1/README.md` | 头部/编译表停在 v1.5.1（2026-10-20），实际固件 v1.6 且 10/24 已实机验证 | v1.6 升级时 AR16/AR17 只写了报告，入口 README 漏更 | 头部+编译表按 AR17 实测数字重写（269,417 B / 902,077 B），补 v1.6 三项修复说明与实机验证记录 |
| 4 | `package.json` | 依赖写 `puppeteer`，但 `verify_html.js` 实际 `require('playwright')`；且 script 从根目录跑时路径解析必失败（脚本按"装配目录内执行"设计） | AR16 建档时按印象写了依赖，未对照脚本 import | 依赖改 `playwright`；script 改 `cd outputs/3D打印件/花房3D_整机装配 && node verify_html.js` |
| 5 | 根目录 `result.json` | Bambu Studio 在仓库根目录的残留切片输出（layer_height=0.0 空数据），随 `b8f1ddb` 误入库 | 切片当天在根目录开过 Bambu CLI | `git rm --cached` + `.gitignore` 加 `/result.json`（本地文件保留） |

### 🟡 中危（口径不一致/数字过时，9 项）

| # | 文件 | 问题 | 修复 |
|---|---|---|---|
| 6 | `docs/花房项目_AI工作交接文档_2026-10-18.md` | 正文多处停在 v3.1 时点：主程序 v1.5.1、AR13 指针、"3D 十件/各~6h"、"等硬件到货/等批复"、尺寸"仍待实测"（AR15 已闭环）、memory 日志范围止于 10-20 | 头部加"正文时效"声明（指向 changelog/README/分工方案 v2）；§二主程序行改 v1.6；§二.挂起三项划线收口；§三待办表逐行划线+改挂 D_ans；§六尺寸清单标注已闭环；AR 指针改 AR17/AR18；日志范围改"持续追加" |
| 7 | `docs/花房FinalProject方案书.md` | 自购合计 48–81 元（AR07 旧口径）与交接文档 97–116 元（AR12 口径）打架 | 两处改 97–116（含花盆 107–136、余量 14–43），标注 AR12 校准来源 |
| 8 | `docs/花房30天执行计划.md` | 冻结通告停在 10-26，11/06 D0 定案未体现；L12 进度快照仍写 v1.5.1/10 件/等快递 | 头部通告下追加"2026-11-06 部分解除"节（D0=11/07、相对排期以分工方案 v2 为准、快照已过时的三项现状） |
| 9 | `docs/参考资料/花房借用与自购清单.md` | "⏳ 10/26 可借到""待翻找"等日期口径失效；11/06 全部借到未回填 | 头部加 2026-11-06 收口注（借到清单明细 + 历史口径声明） |
| 10 | `docs/参考资料/花房3D建模入门路线_SolidWorks.md` L10 | "10 个打印件已出 STL" | 改"9 个 + 按实物实测定稿（02 作废）" |
| 11 | `outputs/项目模式迁移包.md` | 整份停在 10-20：全局指令含"答辩 11-16""固件 v1.5.1""10 个打印件""等硬件到货""AR13/AR14" | 头部加时效警示（以 AGENTS.md 现行版为准）；指令模板内 5 处旧值改现行值；上传清单 10 件→9 件、AR02-11→AR02-17 |
| 12 | `README.md` L109 + `outputs/3D打印件/花房3D_整机装配/交付说明_整机示意模型.md` | HTML"1.87MB / 34,734 面"（AR09 版），实际 1.91MB / 35,220 面（AR15 重出后） | 按 ls 实测与 AR15 记录回填，交付说明补版本演进注 |
| 13 | `docs/index.md` §二/§一 | P0 行写"01b 盆沿挂钩"（现行土插支架）且 02 未标作废；采购行未体现 11/06 借到 | P0 行改名+02 标"作废勿打印"；采购行加"11/06 已全部借到" |
| — | `requirements.txt` | shapely 注释称"audit、截面校验用"但全仓脚本 grep 无一处 import | 注释改"传递依赖（trimesh 2D 后端）"；补 scipy/networkx/rtree（AGENTS §4 所列，注明无直接引用，为环境一致性保留） |

## 三、验证证据

1. **git 对账**：`git rev-parse HEAD origin/main` 双双 `f8b560f`；`git status` 干净（修复前基线）。
2. **依赖语法**：`pip install -r requirements.txt --dry-run` 退出码 0，无解析错误。
3. **旧口径残留扫描**（修复后全仓 grep，均为 0 处未划线残留）：`v1.5.1`（仅存于 changelog 历史记录与 AR 报告——属正确留档）、`10 个打印件/10 个结构件/3D 十件`、`34,734`、`48–81`、`已用到 AR13`。
4. **数字来源**：v1.6 编译数据取自 AR17 §实测表（269,417/902,077 B）；HTML 1.91MB 取自 `ls -la` 实测（1,910,341 B）；35,220 面取自交接文档 v3.0 changelog（AR15 重出验证记录）。

## 四、已知限制 / 挂账

- **🟢 6 处低危未改**（方案 A 领导已批留给 D_ans 公布后统一处理）：AGENTS.md §6.5 冻结通告与 §7 状态指针、10月26日操作清单头部 D0 注记、index.md L25 细化、交接文档 §五 E 盘结构注、`platformio.ini` src_dir 疑点（未实测 `pio run`，暂不动）。
- package.json 的 `playwright` 版本号 `^1.40.0` 为合理下限写法，本机实际用全局 `NODE_PATH` 模块（AGENTS §4 命令），未在本仓 `npm install` 验证——**仓库从未装过 node_modules，维持"按 AGENTS.md 命令跑"的现行用法**，此处声明依赖只为元数据正确。
- 交接文档正文采用"头部时效声明 + 逐行划线"而非整节重写：changelog 是该文档的结构特征（v1.1→v3.2 均如此），整节重写会破坏历史可追溯性。

## 五、结论

修复后，仓库文档层与代码/实物现状的 13 处不一致全部闭合，"烧固件/打印/接手"三个入口（固件 README、根 README、交接文档）均指向 v1.6 / 9 件 / D0=11/07 的同一口径。下一个编号 **AR19**。

---

*AR18 · 小马 · 2026-11-06 · 本报告同步 E 盘 `docs/审计报告/`*
