huankechong/smart-greenhouse/docs/审计报告/AR19_GreenHouse文档体系重组_2026-11-06.md

# AR19 · GreenHouse 文档体系重组（四板块合并 + 归档分层）

> 审计日期：2026-11-06 · 审计人：小马（WorkBuddy）
> 触发：领导指令"全面审计本地和 GitHub 的全部文档，精简并整理全部文档"，经 grill-me 十问定案为 **C 档激进重组（四板块合并）**。
> 方法：neat-freak 常规同步流程（尺寸体检 → 引用关系全扫描 → 合并/归档 → 指针同步 → 断链验证）+ grill-me 逐分支决策（10 项决策全部由领导拍板）。

---

## 一、决策记录（grill-me 定案）

| # | 分支 | 领导拍板 |
|---|---|---|
| 1 | 精简尺度 | C 激进重组（四板块合并），非逐文档压缩 |
| 2 | D0 讲稿替换（领导手动 HTML→MD） | 放着不动，不碰不提交 |
| 3 | 交接文档 | 不单独压缩内容，靠整体整理 |
| 4 | 操作类三合一 | 真合并删旧文件 |
| 5 | 30 天计划 | 压成任务底稿并入分工方案 v2 |
| 6 | 历史类 + AR01–09 | 归档不删（docs/archive/ + 审计报告/archive/） |
| 7 | GitHub 手册双版本 | 只留 MD，删 HTML |
| 8 | AGENTS §6.5 | 改纯规则（去历史叙事） |
| 9 | E 盘镜像 | 同步镜像（删旧 + cp 新 + md5 验证） |
| 10 | 收尾 | AR19 + E 盘 + push |

## 二、执行明细

### 板块① · 操作类三合一 →《硬件操作手册_点火接线标定.md》（新）

- **合并源**（3 份 → docs/archive/）：`W1到货点火与标定操作指南_2026-10-20.md`（主流程）+ `土壤传感器焊接操作卡_2026-10-21.md`（接线定案）+ `W1无烙铁接线方案_2026-10-20.md`（备选）
- **合并逻辑**：点火/烧录/标定为主干（步骤 0–5 保留全部实测记录）；接线分两式——焊接排针（§二 定案）与免焊直插（§三 备选）；三份重复的接线表/坑位/自检命令去重为一份；「买已焊排针模块」作废项保留标注。
- **指针改动**：`docs/index.md` 导航行（原 2 行→1 行）、`docs/参考资料/花房借用与自购清单.md` 3 处、README 目录树。

### 板块② · 30 天计划压底稿并入分工方案 v2

- 原 282 行/25KB 删除（→ docs/archive/），压缩为**附录·任务底稿**（约 70 行）追加到 `docs/花房4人分工方案_2026-10-20.md`（211→280 行）。
- **保留**：W2–W4 全部任务编号（7.1–19.2）、内容、耗时、验收标准、素材要求——操作清单等文档按 D 编号引用不断链；已超前完成任务划线注明。
- **删除**：逐日日程叙事、工作日窗口盘点表、W2 关键路径烙铁三档预案（已被 11/06 器材借到收口）、物料状态段（并入借用清单头部注）。
- **指针改动**：AGENTS §6（"日程看分工方案 v2"）、README 目录树 + 阅读顺序、index.md、方案书头部、接线规划表头部、分工方案自身 2 处（§七映射同步处 4→3）。

### 板块③ · 历史类归档

- 新建 `docs/archive/`（含 README 归档说明）：迁移包（outputs/ 移入）、GitHub 提交提示词、GitHub 手册 HTML、板块①②的 5 份合并源。
- 新建 `docs/审计报告/archive/`：AR01（从 outputs/代码/花房代码/ 移入）+ AR02–AR09，共 9 份，**内容原样保留**。
- **现行层保留 AR10–AR18**（AR10 代码审计 / AR15 桶径实测 / AR16–17 v1.6 依据，仍是现行依据）。
- **指针改动**：AGENTS E 盘分桶对照表（删迁移包行、AR01 行改归档路径）、index.md AR 表压缩为一行摘要制、交接文档 §五地图。

### 板块④ · GitHub 手册双版本二选一

- 删 HTML 排版版（→ docs/archive/），MD 升 v1.1：头部改"唯一版本"声明 + 打印指引。

### AGENTS.md 净化（neat-freak 红线执行）

- §6.5 删除"🧊 2026-10-26 冻结更新"历史叙事 block 与已失效的 11/5 死线叙事，改写为**纯规则**（周末不打印 / 9–10h 机时 / 开始日≠死线 / 只补打不重打 / 现行排期指针到分工方案 §六）。
- §7 状态指针更新到 11/06（器材借到 / D0=11/07 / 相对排期）。
- §4.1 GitHub 提示词指针改指零基础手册。
- 净变化：AGENTS.md 124 → 116 行（**净减 8 行**，符合"减优于加"）。

## 三、验证证据

1. **断链扫描零残留**：全仓 grep 八类旧路径（三份 W1 文档 / 30 天计划 / GitHub 提示词 / 手册 HTML / 迁移包 / outputs AR01），现行层引用仅剩 2 处合法位置——交接文档头部 changelog（历史记录，当时文件名属实，不改写历史）。
2. **新文档被引用**：硬件操作手册在 index/借用清单/README 共 6 处正向引用。
3. **docs 主层 17 → 11 份 MD**（+1 新手册，-3 合并源，-1 30天计划，-1 提示词；归档 7 份入 archive/）。
4. **分工方案附录表格完整性**：117 行表格行含附录全部任务行，无列数错位（编写时逐行对齐）。

## 四、已知限制 / 挂账

- 交接文档头部 61 行 changelog 中旧文件名引用保留原样（changelog 是"当时发生了什么"的历史记录，改写反而失真；归档件可从 docs/archive/ 找到）。
- E 盘 `迁移指南/` 目录删除后为空目录，保留空壳不删（避免误删领导自行放置的其他文件）。
- AR18 挂账的 6 处低危项中：AGENTS §6.5/§7 已在本轮顺带完成，其余 4 处（操作清单头部 D0 注记、index L25、交接文档 §五注、platformio.ini src_dir）仍挂 D_ans 公布后处理。
- 归档件（含 AR01–09）内容不再维护；若答辩材料需要引用早期 AR 结论，以 AR15 及之后报告的最新口径为准。

## 五、结论

docs 主层从 17 份收敛到 11 份（-35%），"接手/干活/交代码"三条入口路径全部无断链；规则手册（AGENTS.md）回归纯规则。下一个编号 **AR20**。

---

*AR19 · 小马 · 2026-11-06 · 本报告同步 E 盘 `docs/审计报告/`*
