huankechong/smart-greenhouse/docs/审计报告/AR13_GreenHouse云端清空销账与E盘分桶补全_2026-10-20.md

# AR13 · 云端清空销账 + E 盘分桶对照表补全

> 日期：2026-10-20 · 审计人：AI（小马）· 触发：领导「我已经删完了」→「b做完了」
> 范围：云端资料库最终状态复核 + `AGENTS.md` 第 6 节新增 E 盘分桶对照 + E 盘镜像 27 份全量校验
> 分级：🔵 误判澄清 · 🟡 遗留清理 · 🟢 规则补全

---

## 一、总览

| # | 问题 | 分级 | 原状 | 现状 |
|---|---|---|---|---|
| 1 | 云端最后一条残留（误传的 README 节点） | 🟡 | 待领导在网页端手删 | **已删除，云端零残留** |
| 2 | E 盘分桶规则未成文，每次同步靠猜路径 | 🟡 | 只在 AR12 报告里口头留档，AGENTS.md 无对照表 | **AGENTS.md 第 6 节新增 9 行分桶对照表** |
| 3 | 我同步迁移包时新建了 `outputs/` 目录，破坏 E 盘分桶约定 | 🟡 | 出现仓库风格的 `outputs/` 目录 | **改放 `迁移指南/`，`outputs/` 已撤除** |
| 4 | E 盘 `邮件/` 混着一份**改前的旧 v3 模板** | 🟡 | 与 `docs/private/` 版 md5 不同（"借 9 类"vs"借 8 类"） | **旧副本移入 `.workbuddy/recycle_bin/`** |
| 5 | AR12 报告内部"22 份 / 23 份"口径自相矛盾 | 🟢 | 范围行写 22 份，正文三处写 23 份 | **统一为 23 份** |
| 6 | AR12 的 6 项修正是否属实，未独立验证 | 🔵 | 直接采信 | **逐条手算 + grep 核实，全部属实**（见第三节） |

**一句话结论：云端这条线彻底收尾——零残留；E 盘这条线本轮补上了"分桶对照表"这个缺失的规则（此前每轮同步都得靠回忆猜路径，本轮就因此差点把仓库目录结构带进 E 盘），并清出一份会误发的旧邮件模板。**

---

## 二、云端清空状态确认（第 1 项）

- **领导动作**：2026-10-20 手动删除云端花房文档，含我在"不同步"指令发出前误传的 README.md（`BUqqrRK4Roi6B84K0gkC04`）。
- **复核方式（6 组关键词交叉）**：`library_search` 搜「花房」「GreenHouse」「智能花房养护站」「README」「打印件」「传感器」——**全部零命中**。
- **证伪检索故障**：同期搜无关空间「资料库的100种用法 / WorkBuddy 实践案例」**正常返回 8 条结果**，证明检索通道可用 → 属内容确已清空，而非索引或通道问题。
- **判定**：云端花房相关内容**零残留**，云端不再是本项目任何信息的来源。
- **文档落地**：AR11 第六节第 7 条补确认；`AGENTS.md` 第 8 节补「清空状态已确认」条目。

---

## 三、AR12 的 6 项修正——独立验证结果

不轻信上一轮报告，逐条重算/重查：

| AR12 声称 | 验证方法 | 结果 |
|---|---|---|
| 预算 76–89 → 97–116 元 | 按《借用与自购清单》2.2 十项**用 Python 手算上下限** | 下限 **97.28**、上限 **116.28** → 97/116 ✅ 属实 |
| 总计 107–136、余量 14–43 | 同上手算加待买 10–20，150 减 | 107.28–136.28、余量 **13.72–42.72** → 14–43 ✅ 属实 |
| AR 指针已用到 AR12 | grep `已用到 AR` 三处（交接文档/AGENTS/index） | 均为 AR12 → AR13 ✅ 属实 |
| 版本头 v1.5 → v1.6 | 读交接文档 L3 | v1.6 ✅ 属实 |
| 目录地图补 AR11 | 读交接文档第五节 | `AR02 … AR12.md` ✅ 属实 |
| E 盘"缺 3 文件"是误判 | `find` 实测两文件落位 | 交付说明在 `3D打印件/花房3D_整机装配/`、固件 README 在 `代码/GreenHouse_v1/`——**只是目录名不同，文件在** ✅ 属实 |

**结论：AR12 的 6 项修正全部属实，无编造，可采信。** 其修的预算错误（AR07 增补 28 元后从未重算）确实是 AR11 真实漏掉的一处。

---

## 四、E 盘分桶对照表补全（第 2、3、4 项）

### 2. 根因：E 盘不叫 `outputs/`

E 盘按**人类可读名**分桶，仓库按**工程结构**分目录，两套命名长期并存却从未成文：

| 仓库路径 | E 盘落位 |
|---|---|
| `README.md` / `AGENTS.md` | 根目录同名 |
| `docs/**` | `docs/**`（同名同构） |
| `outputs/3D打印件/花房3D_*/` | `3D打印件/花房3D_*/` |
| `outputs/代码/花房代码/GreenHouse_v1/` | `代码/GreenHouse_v1/`（AR01 报告在 `代码/` 下） |
| `outputs/项目模式迁移包.md` | `迁移指南/项目模式迁移包.md` |
| `docs/private/*` | `docs/private/*`（同名同构） |
| `output/`（申请单 docx+pdf） | `邮件/`（**只放成品**） |
| `outputs/素材/_敏感_不入库/截图整理_*/` | `素材/` 下同名目录 |

- **后果**：AR12 第四节记的那个误判（"E 盘缺 3 个文件"），本质就是**这条规则从未写进 AGENTS.md**。规则只活在报告里，下一轮照样会踩。
- **修复**：`AGENTS.md` 第 6 节「知识库维护」新增对照表 + 一条硬规矩——**判定"文件缺失"必须做内容级校验（md5 或去行尾比对），不能只靠 `[ -e ]` 存在性判断**。

### 3. 我自己踩了同一个坑

同步迁移包时，我按仓库路径在 E 盘新建了 `outputs/` 目录——正是这条对照表要防的事。已改为 `迁移指南/`，`outputs/` 目录撤除，E 盘根目录恢复 8 个规范分桶。

### 4. 清出一份会误发的旧邮件模板

- **现象**：E 盘 `邮件/` 目录下有一份 `硬件申请邮件模板_v3.md`，与 `docs/private/` 下同名文件**md5 不同**（`fbe7c8a9` vs `35d4ebc2`）。
- **差异**：仅一处——`借 9 类` vs `借 8 类`。即 **`邮件/` 那份是 AR07 修正前的旧副本**，我本轮已把 `docs/private/` 那份改成 8 类，但 `邮件/` 这份没跟着改。
- **风险**：老师/同学从 `邮件/` 目录取文件，拿到的是旧版清单，**与实际借用内容不符**。
- **处置**：移入 `.workbuddy/recycle_bin/E盘邮件目录_旧版v3模板_2026-10-20.md`（**不直接删**，可回溯）。`邮件/` 现只留申请单成品 docx + pdf。

---

## 五、验证证据

| 验证项 | 方法 | 结果 |
|---|---|---|
| 云端零残留 | `library_search` 6 组关键词 | 全 0 命中 ✅ |
| 检索通道可用（证伪） | 搜无关空间「资料库的100种用法」 | 正常返回 8 条 ✅ |
| 预算数字 | Python 手算上下限 | 97.28 / 116.28 / 13.72 / 42.72 ✅ |
| AR12 六项修正 | 逐条 grep + 手算 | 6/6 属实 ✅ |
| 旧副本识别 | `find` + `md5sum` + `diff` | 仅"借 9 类"一处差异 ✅ |
| 旧副本处置 | 移入回收目录后 `ls` 复查 | `邮件/` 仅剩 4 个成品文件 ✅ |
| E 盘分桶合规 | `ls` E 盘根目录 | 8 个规范分桶，无 `outputs/` ✅ |
| **双端全量一致** | 27 份关键文件逐个 `md5sum` 双端比对 | **27/27 一致** ✅ |
| 固件 .ino | 去 CR 后 md5 | 双端同为 `4adeceff` ✅（行尾差异属正常） |
| 远端同步 | `git push` + `git ls-remote` | 见提交记录 ✅ |

---

## 六、已知限制与未处理

1. **`.gitignore` 不补到 E 盘**——E 盘不是 git 仓库，本就不需要，AR12 的判断正确。
2. **`.ino` 行尾差异保留**——本地 CRLF / E 盘 LF，编译与 git 均等价，不做统一（统一会引入 515 字节噪音 diff）。
3. **`迁移指南/` 是本轮新增分桶**——此前迁移包在 E 盘根本不存在（本轮首次同步），落位由本轮定义；若领导另有习惯位置，可再调整。
4. **未做推送的惯例**——按项目惯例，提交后等领导指令推送。

---

## 七、版本演进（本项目文档/审计链）

| 编号 | 日期 | 主题 |
|---|---|---|
| AR11 | 10-20 | 知识库全面审计：AR 编号重复修正 + 25 处文档-代码不一致 |
| AR12 | 10-20 | 文档口径补漏（预算/AR 指针/版本头/审计轮次）+ E 盘镜像 23 份 md5 复核 |
| **AR13** | **10-20** | **云端清空销账 + E 盘分桶对照表补全 + 旧邮件模板清理** |

**下一个编号：AR14。**
