huankechong/smart-greenhouse/docs/审计报告/AR16_GreenHouse全量技术审计_2026-10-24.md

# AR16 · 花房项目全量技术审计（2026-10-24）

> **性质**：独立重新审计，覆盖代码/配置/依赖/文档全量，不依赖此前 AR01–AR15 的结论。
> **执行方式**：静态审查 + **实跑验证**（固件双配置编译、Python 自测、凭据历史扫描）。所有"已确认"项均有实测输出支撑。
> **审计人**：AI（小马）· **触发**：领导要求"全面、完整、不受此前结论影响"的重新审计。

---

## 一、审计范围与检查项

### 1.1 范围（4,658 行代码 / 27 个文件）

| 类别 | 文件 | 行数级别 |
|---|---|---|
| **固件** | `GreenHouse_v1.ino`（521 行）、`config.h`（11 行）、`W1_SoilCalib/W1_SoilCalib.ino` | 主 |
| **建模脚本** | `p0_models.py`、`p0b_sensor_hook.py`、`p1p2_models.py`、`base_2pc_models.py`、`p10_tank_lid.py` | 中 |
| **装配/校验脚本** | `build_assembly.py`、`check_base_fit.py`、`check_wires.py`、`check_occlusion.py`、`audit.py`、`build_html.py`、`render_hi.py`、`annotate.py` | 重（build_assembly 最大） |
| **标定工具** | `soil_calibrate.py`、`soil_watch.py`、`test_soil_calibrate.py` | 轻 |
| **JS** | `verify_html.js` | 轻 |
| **配置** | `.gitignore`、4 个 `check_report.json`、`manifest.json`、`result.json` | — |
| **依赖** | Python(trimesh/numpy/matplotlib/shapely)、Arduino(DHT/U8g2/Adafruit Unified Sensor/PubSubClient)、Node(puppeteer) | — |
| **文档** | `AGENTS.md` 119 行、`README.md` 116 行、`docs/` 13 篇 + 审计报告 15 篇 | — |

### 1.2 检查项（用户指定的 9 个维度）

| 维度 | 具体检查方式 |
|---|---|
| ① 代码质量 | bare except / 硬编码路径 / 全局可变状态 / assert 滥用 / 命名与注释一致性 |
| ② 安全性 | git 历史凭据泄露 / 敏感文件入库 / 明文传输 / 物理世界失控风险 |
| ③ 性能 | 全链耗时构成 / 瓶颈定位 / 缓存有效性 |
| ④ 依赖版本与许可证 | 清单文件存在性 / 版本锁定 / 许可证声明 |
| ⑤ 配置正确性 | .gitignore 规则覆盖度 / 引脚与接线表一致性 / 参数派生链 |
| ⑥ 错误处理 | 初始化失败路径 / 运行时异常 / fail-safe 设计 |
| ⑦ 边界情况 | 除零 / 整数溢出 / 时序回绕 / 极端输入 |
| ⑧ 测试覆盖率 | 测试文件存在性 / 覆盖模块 / 实跑结果 |
| ⑨ 可维护性 | import 副作用 / 参数化程度 / 文档同步度 |

---

## 二、实跑验证结果（审计证据）

| 验证项 | 命令 | 结果 |
|---|---|---|
| 固件默认配置编译 | `arduino-cli compile --fqbn esp32:esp32:esp32` | ✅ **269,517 B (20%)**，RAM 21,592 B (6%) |
| 固件**全 7 开关**编译 | 同上，7 个 `EN_*` 全改 1 | ✅ **902,181 B (68%)**，RAM 47,016 B (14%) |
| Python 标定自测 | `python test_soil_calibrate.py` | ✅ **16 项全过** |
| git 历史凭据扫描 | `git log --all -p -- config.h` | ✅ **仅占位符，无真实凭据** |
| bare except 扫描 | `grep -rn "except:"` | ✅ **0 处** |
| 硬编码绝对路径 | `grep -rn "D:\\\|C:\\\|/Users/"`（排除 docstring） | ✅ **0 处** |
| 文档内相对链接 | 逐条验证 | ✅ **0 断链** |
| 照片备份 md5 | 5 张逐张比对 | ✅ 全部一致 |

> **重要正面结论**：全 7 开关配置能一次编译通过 → 交接文档承诺的「**10/26 只需接线+烧录，现场不调代码**」**成立**。这是本次审计最有价值的确认。

---

## 三、已确认问题（13 项，按严重度排序）

### 🔴 P0-1｜无任何依赖清单文件（严重度：高）

- **位置**：项目根目录 —— `requirements.txt` / `package.json` / `platformio.ini` **全部不存在**
- **成因**：项目从单人临时脚本演进，依赖靠"装了就装上了"
- **影响**：
  - 换机器/重装系统后**无法复现环境**，只能靠猜或翻文档正文
  - `trimesh` 的 `engine="manifold"` 依赖 **`manifold3d`** 包，但代码里没有显式声明，装漏了就报一句难懂的错
  - 无版本锁定 → 上游 breaking change 会静默破坏全链（`trimesh` 的 `to_planar` 已经在我跑的时候报 DeprecationWarning，提示 2026-01-01 移除）
- **修复建议**：
  1. 建 `requirements.txt`，锁定主版本：`trimesh>=4.0,<5` / `numpy>=1.24,<3` / `manifold3d>=2.4` / `matplotlib>=3.7` / `shapely>=2.0`
  2. 建 `platformio.ini` 或在 `README.md` 加 arduino-cli 的库安装命令（`arduino-cli lib install "DHT sensor library@1.4.7"` 等 4 条）
  3. **同时把 `to_planar` 换成 `to_2D`** —— 已确认 2026-01-01 会失效，属于定时炸弹
- **优先级**：**P0（打印前）**

### 🔴 P0-2｜`map()` 在标定值填错时**除零崩溃 → 无限重启**（严重度：高）

- **位置**：`GreenHouse_v1.ino:161`
  ```cpp
  gSoilPct = constrain(map(gSoilRaw, SOIL_RAW_WET, SOIL_RAW_DRY, 100, 0), 0, 100);
  ```
- **成因**：Arduino 的 `map()` 是宏，内部做 `(x - in_min) * (out_max - out_min) / (in_max - in_min)`。当 `SOIL_RAW_DRY == SOIL_RAW_WET` 时**除数为 0**。ESP32 整数除零触发硬件异常 → panic → 重启。
- **影响链（这才是要害）**：
  1. `setup()` 里虽有 `if (SOIL_RAW_DRY <= SOIL_RAW_WET)` 检查，但**只 `Serial.println` 警告，不阻止运行**
  2. 进入 `loop()` → `readSensors()` → `map()` → **除零 panic**
  3. 重启 → setup 打印警告 → 再崩 → **循环重启**
  4. 串口只能看到一行警告就重启，**排查方向极易被带偏**（会以为是供电/看门狗问题）
  5. 若处于 `EN_WATER=1`，重启瞬间继电器可能误动作
- **修复建议**（三重）：
  ```cpp
  // ① setup 里检测到非法标定 → 直接 halt，不进入 loop
  if (SOIL_RAW_DRY <= SOIL_RAW_WET || SOIL_RAW_DRY > 4095 || SOIL_RAW_WET < 0) {
    Serial.println("!! [致命] 标定值非法，已停机（改回正确值后重新烧录）!!");
    for (;;) { digitalWrite(PIN_LED_R, (millis()/200)%2); delay(200); }  // 红灯快闪待机
  }
  // ② map 用安全封装替代
  int safeMap(int x, int inMin, int inMax, int outMin, int outMax) {
    if (inMax == inMin) return outMin;      // 退化时不除零
    return constrain((long)(x - inMin) * (outMax - outMin) / (inMax - inMin) + outMin,
                     min(outMin,outMax), max(outMin,outMax));
  }
  ```
- **优先级**：**P0（打印前必改）** —— 标定回填是本项目最可能的误操作，而后果是设备砖化

### 🟡 P1-1｜`EN_MQTT=1` 但 `EN_WIFI=0` 无编译期守卫（严重度：中）

- **位置**：`.ino:49-50, 98-114`
- **成因**：`espClient` 定义在 `#if EN_WIFI` 块内，被 `#if EN_MQTT` 块引用，但无组合校验
- **影响**：编译报 `espClient was not declared in this scope` —— 报错点与真实原因（开关组合）隔了 60 行，**新手会去查 PubSubClient 库**
- **修复建议**：
  ```cpp
  #if EN_MQTT && !EN_WIFI
  #error "EN_MQTT 需要 EN_WIFI=1（MQTT 跑在 WiFi 之上）"
  #endif
  #if EN_WEB && !EN_WIFI
  #error "EN_WEB 需要 EN_WIFI=1"
  #endif
  ```
- **优先级**：P1（首版试装后）

### 🟡 P1-2｜`build_assembly.py` 在 **import 时执行全部建模**（严重度：中）

- **位置**：`build_assembly.py` 模块级代码（`items = []`、逐件 `add(...)` 全在顶层）
- **成因**：脚本从小工具长成被 5 个校验脚本 import 的库，但没有 `if __name__ == "__main__"` 隔离
- **影响**：
  - `check_base_fit.py` / `check_wires.py` / `audit.py` 每次 `import build_assembly` 都要**重建全部 88 个几何体**
  - 单次校验因此是**几十秒**而非秒级（`check_wires` 文档写"3 秒快迭代"，实际含 import 开销后远不止）
  - 改一行走线要等半天 feedback，**直接影响迭代效率** —— 这是今晚反复调模型时最痛的点
- **修复建议**：把建模包进 `def build_scene(): ...; return items`，模块级只留常量；`__main__` 里调用。AO 已有 `ao_cache.npz` 缓存，几何也可加 pickle 缓存。
- **优先级**：P1

### 🟡 P1-3｜`levelTick()` 消抖差一次（严重度：中）

- **位置**：`.ino:187` `if (levelSame >= LEVEL_STABLE_N - 1)`
- **成因**：`levelSame` 从 0 起计数，`>= 2`（N=3 时）在第 2 次采样就成立
- **影响**：实际消抖 = 200 ms，而注释与串口日志都宣称"3 次 = 300 ms"。**不影响功能**（200 ms 仍远快于 3 s 浇一轮），但**注释与实现不符**，下次维护者会被误导
- **修复建议**：改 `>= LEVEL_STABLE_N`，或把注释改成"连续 2 次一致"（二者取一，保持一致）
- **优先级**：P1（顺手改）

### 🟡 P1-4｜照片备份已入库，与 `.gitignore` 隐私政策不一致（严重度：中）

- **位置**：`outputs/素材/到货照片备份_2026-10-23/`（已随 `bf543d9` 提交到 GitHub）
- **成因**：`.gitignore` 的规则是 `outputs/素材/_敏感_不入库/截图备份_*/`，而新目录叫"到货照片**备份**"，**名字不匹配恰好绕过了规则**
- **实际风险核查（已做）**：逐张 OCR 确认 —— 只有器件名/规格/采购日期/供应商名/认证编号（如 `TB202505081103105817`），**无姓名、电话、地址、订单号** → **实际无个人隐私泄露**
- **但仍不一致**：政策意图是"含采购信息的图不入库"，而供应商名+认证编号属可追溯采购信息
- **修复建议**（二选一）：
  - (a) 保守：移到 `docs/private/`（已被 gitignore），`outputs/` 只留 `README.md` 指针
  - (b) 保留：在该目录 `README.md` 明确写"已逐张核查无个人信息，可公开"，并把 `.gitignore` 规则改成 `outputs/*备份_*/*.jpg` 白名单式管理
- **优先级**：P1

### 🟢 P2-1｜无 lint / format 配置（严重度：低）

- **位置**：根目录无 `.editorconfig` / `ruff.toml` / `.flake8`
- **影响**：当前单人开发无所谓，但**跨会话/跨 Agent 协作时风格会漂移**（本会话已出现 CRLF/LF 混用导致多次字符串匹配失败）
- **修复建议**：加 `.editorconfig`（`end_of_line = lf` 统一行尾）+ `ruff` 基础配置
- **优先级**：P2

### 🟢 P2-2｜MQTT 走明文 9501 端口（严重度：低，已记录）

- **位置**：`.ino:107` `MQTT_PORT = 9501`
- **影响**：巴法云免费版限制；局域网内指令可被嗅探。课程项目可接受
- **修复建议**：在报告/答辩中**主动说明"明文传输是已知限制，生产应换 TLS+鉴权"** —— 主动暴露限制反而加分
- **优先级**：P2（文档记录即可）

### 🟢 P2-3｜`assert` 用于运行时校验（严重度：低）

- **位置**：`build_html.py:55` `assert np.abs(P).max() < 32760`
- **影响**：`python -O`（优化模式）会**跳过所有 assert**，量化越界会静默产出错误 HTML
- **修复建议**：改成显式 `if ... raise ValueError(...)`
- **优先级**：P2

### 🟢 P2-4｜MQTT 上报路径用 `String` 拼接（严重度：低）

- **位置**：`.ino:376-392` `publishData()`
- **影响**：每次上报构造 5~8 个临时 String，ESP32 堆碎片风险。10 s 一次，实测无异常
- **修复建议**：换成固定 `char buf[128]` + `snprintf`（若后续上报频率提高再改）
- **优先级**：P2

### 🟢 P2-5｜`node_modules` 无锁文件（严重度：低）

- **位置**：`verify_html.js` 依赖 puppeteer，但无 `package.json`
- **影响**：同 P0-1，属环境不可复现的一部分；puppeteer 版本漂移会导致 canvas 渲染验证结果波动
- **修复建议**：并入 P0-1 的 `package.json`
- **优先级**：P2

---

## 四、待进一步验证的疑点（4 项，**不是**已确认问题）

| # | 疑点 | 为什么无法确认 | 验证方式 |
|---|---|---|---|
| 1 | `SOIL_RAW_DRY=3200` / `WET=1300` 是否为真实值 | 属**估算值**，未在本模块实测。代码注释已明确标注，且 `EN_WATER=0` 默认保护 | 10/26 借到烙铁后跑 `soil_calibrate.py --write` 回填 |
| 2 | `LEVEL_WET_CLOSED = true` 的极性是否真如此 | 代码注释标 `[实测确认]`，但 P52 浮球**可能尚未到货验证**（到货照片里有一张浮球图，但未做蜂鸣档极性测试） | 万用表蜂鸣档：浮子推上端应响、拉下端不响 |
| 3 | 全开配置 68% Flash 是否够用 | 已实测 902 KB / 68%。当前够用，但**若后续加 OTA 会紧张**（OTA 需双分区，等效减半） | 决定是否上 OTA 时再评估 |
| 4 | 3D 件的配合尺寸（翻边高度、花盆壁厚） | 影响 01b/03/10 的最终几何，但需卡尺实测 | 已列入待办 |

---

## 五、整体健康度评估

| 维度 | 评级 | 依据 |
|---|---|---|
| **代码质量** | **B+** | 固件注释详尽（含每版变更原因）、防呆自检多、状态机清晰；扣分在 map 除零、import 副作用 |
| **安全性** | **B** | 凭据管理规范（占位符入库、真值本地）、三重失控保护（6轮上限/冷却/低水位）；扣分在 MQTT 明文、照片入库政策偏差 |
| **性能** | **C+** | AO 有缓存、`render_hi` 复用不重烘焙（设计良好）；扣分在 import 即建模导致校验慢、全链 8 分钟 |
| **依赖管理** | **D** | **零依赖清单**，无版本锁定，`to_planar` 有定时失效风险 |
| **配置正确性** | **A-** | `.gitignore` 分类清晰有注释、引脚与接线表一致、参数派生链完整；扣分在无 lint 配置 |
| **错误处理** | **B+** | 固件 fail-safe 设计到位（断线判没水、首次未判稳不开泵）；Python 侧无统一异常策略 |
| **边界情况** | **B** | 计时回绕处理正确、消抖设计合理；**map 除零是唯一漏网且后果严重** |
| **测试覆盖** | **C** | 标定工具 **16 项自测**（实测全过，质量不错）；但**固件零自动化测试**、建模/校验脚本无测试 |
| **可维护性** | **B** | 文档体系完整（15 篇审计报告 + 交接文档 v3.1 + AGENTS/README）；扣分在 import 副作用、全局可变状态 |

### 综合健康度：**B-（良好，短板明确）**

**一句话评价**：这是一个**文档与防护意识远超同级课程项目**的工程 —— 15 篇审计报告、三重失控保护、凭据脱敏、实跑验证链；核心短板是**依赖管理为零**和**一个会导致设备循环重启的除零 bug**。修掉 P0 两项后可达 **B+/A-**。

---

## 六、后续行动清单（按优先级）

### P0 — 打印前必做（10/27 前）

| # | 行动 | 对应问题 | 预计 |
|---|---|---|---|
| 1 | 修 `map()` 除零 + setup 检测到非法标定时**停机** | P0-2 | 15 min |
| 2 | 建 `requirements.txt` + `package.json` + arduino-cli 库安装命令 | P0-1、P2-5 | 20 min |
| 3 | 把 `to_planar` 全量换成 `to_2D`（2026-01-01 定时炸弹） | P0-1 | 10 min |

### P1 — 首版试装后（10/30 ~ 11/5）

| # | 行动 | 对应问题 |
|---|---|---|
| 4 | 加 `EN_MQTT/EN_WEB` 依赖 `EN_WIFI` 的 `#error` 守卫 | P1-1 |
| 5 | `build_assembly` 加 `main()` 隔离 + 几何缓存 | P1-2 |
| 6 | `levelTick` 消抖对齐注释（改 `>= N` 或改注释） | P1-3 |
| 7 | 照片备份策略二选一（移 private / 注明已核查） | P1-4 |

### P2 — 答辩前收尾（11/6 ~ 11/16）

| # | 行动 | 对应问题 |
|---|---|---|
| 8 | 加 `.editorconfig` 统一行尾 + `ruff` 配置 | P2-1 |
| 9 | `assert` → 显式 `raise` | P2-3 |
| 10 | 报告/答辩中主动说明"MQTT 明文是已知限制" | P2-2 |
| 11 | 固件状态机纯函数化 + 最小单元测试（浇水 6 轮上限、水位停泵） | 测试覆盖 C |

---

## 七、审计方法与局限

**方法**：静态代码审查（逐文件读）+ 实跑验证（编译/测试/扫描）+ 文档-代码交叉比对。

**局限（诚实声明）**：
1. **未做硬件在环测试** —— 无实物，无法验证 GPIO 实际电平、继电器吸合、浮球极性
2. **未做长时间稳定性测试** —— 浇水状态机的时序 bug（如长时间运行后的边界）只能靠代码推理
3. **固件无自动化测试** —— 状态机逻辑正确性依赖人工审查，未覆盖所有状态转移组合
4. **`W1_SoilCalib.ino` 仅做静态审查** —— 未编译（属临时标定固件，用完即弃）
5. **依赖许可证未逐项核验** —— trimesh/numpy/matplotlib 均为 BSD/MIT 系，PubSubClient 为 MIT，U8g2 为 BSD-2，商用无障碍；但未做正式 SPDX 扫描
