huankechong/smart-greenhouse/docs/审计报告/AR08_GreenHouse示意模型圆桶化_2026-10-20.md

# AR08 · 示意模型圆桶化：1L 桶 + 替换盖 + P52 浮球（含底盘槽修正）

> 项目：智能花房养护站（IPW Final Project）
> 日期：2026-10-20 · 执行：小马 · 触发：领导「细致的再优化一下示意模型」
> 产物：`outputs/花房3D_整机装配/`（glb 89 体 0.56MB / HTML 34,446 面 1.85MB / 四视图 + 高清图 + 爆炸图 + 三步图）
> 连带：`outputs/花房3D_整机底盘/base_2pc_models.py` 改 φ108 圆槽并重出 06a/06b/06c

---

## 一、问题（4 处，1 处是真错误）

| # | 问题 | 性质 |
|---|---|---|
| 1 | 装配模型水箱仍是 **118×90×60 方盒占位**，与已定版的 1L 打包桶不符；管路"越壁 z=76"是按 62 高方箱写的，实际桶口在 z=123 | 落后于决策 |
| 2 | **底盘矩形槽在 Y 向装不下桶底**：槽 120.6×92.6，桶底 φ106 —— 106 > 92.6，桶会架在槽沿上 | **计算漏项**（此前只比了 X 向 `(120.6−106)/2=7.3` 就判"能落进"） |
| 3 | 浮球杆（桶心 φ5，z 75…127）与水管（原路径从桶心竖直上）**重叠 142.8 mm³** | 真实干涉 |
| 4 | 水体为不透明实体，把桶内水泵整个遮住，示意图读不出"泵在水里" | 可读性 |

> 第 2 条是本次自查抓出来的：**圆形件进矩形槽要两个方向都比**，只看一边会得出"能放下"的错误结论。旧判断已随 06b 重出作废。

## 二、几何改动

### 底盘（06b 右片，v1.3 → v1.4）

| 项 | 旧 | 新 |
|---|---|---|
| 水箱槽 | 矩形 120.6 × 92.6，深 5 | **圆槽 φ108**，深 5（径向余量 1mm） |
| 槽心 | (85, 20) | **(85, 32)**（+Y 移 12，让开挡水堤） |
| 挡水堤 | 沿矩形槽 -Y/-X 边直段 | 沿 φ108 圆槽两切点外侧（3×3，各让 3mm） |
| 排水孔 | (120,52) 在槽内 | 不变（仍落在圆槽内，桶下渗水照排） |
| 实体重量 | 276.7 g | **291.8 g**（20% 填充 ≈96.3 g） |

06a 左片、06c 连接块未变（重出后重量与几何一致：299.8 / 4.2 g）。

### 装配（build_assembly.py v3）

- **水箱**：圆台 φ106（底）/φ136（口）× 120 高，壁 1.4（由 63.5g 克重反算）；**90° 楔形剖开**（+Y 朝观众）露出内部
- **水体**：内腔同锥度、水深 85mm，**与桶壁同一楔形剖开**——否则不透明水体挡住泵
- **第 10 件替换盖**：φ142.4×4 板 + 裙边内 φ136.8×8（套桶口）+ φ20×0.8 螺母凸台（桶内侧）+ 两处指位缺口；三孔：φ10.5 浮球 / φ10 水管（−Y22）/ φ8 过线（+Y30）
- **P52 浮球**：法兰坐盖顶 z=127，杆 φ5 有效长 52（杆尖 z=75），浮子 φ28×18 随水面（满水时中心 z≈84）
- **水泵**：座坐桶内底 z=4.4，泵体 41×39×30（顶 z=37.4），出水嘴顶 z≈44
- **水管**：出水嘴 → 先偏 −Y 到盖孔正下方（距浮球杆轴 22mm，> 浮子半径 14+管 4）→ **竖直穿盖**（123…127）→ 出盖后抬到 z≈152 横跨 → 绕管夹外侧 → 竖直下穿管孔
- **电缆**：泵线 2 根 + 浮球线 2 根，一律**经 φ8 过线孔翻过盖顶**，沿桶外侧（y≈−44，桶半径 68）回到电控区；旧版"贴桶壁横穿"会切桶壁，已改

## 三、验证（全部实跑）

| 检查 | 结果 |
|---|---|
| `check_base_fit.py` ①落座高度 | 全 OK（新增 水体 4.4 / 水泵座 4.4 / 水泵 7.4 / 水箱盖 115 / 浮球法兰 127 / 浮子 75） |
| ② 件×底板干涉 | 全部 0.0 mm³（水箱已按新槽位核对） |
| ③ 槽孔特征 | `水箱槽 @(120,32)` 为空的 φ108 圆槽 ✓ |
| `check_wires.py` | 22 根，1 根"穿模"= **DHT11 端点插入座内**（连接器插入，非错误）；水体已排除（泵线/水管穿水正常） |
| `audit.py` | **0 个 !!**；干涉项只剩设计内配合：土壤×传感器板 941.9（板插土）、泵嘴×水管 83.3（管插嘴）、挂钩×板 57.2（夹持）、支架×屏 16.8、管×夹 1.2 |
| glb | 89 个几何体，0.56 MB |
| 离线 HTML | 34,598 三角面，1.86 MB；无头 Chromium 实测 **WebGL 正常、无 JS 错误** |
| 渲染 | 四视图 + 4 张高清 + 爆炸图 + 装配三步图，全部重出（时间戳 2026-10-20） |

## 四、已知限制

1. 桶尺寸仍来自淘宝官方标注图（136/120/106/120），**未实测**；到货复测后改 `BOT_R/TOP_R/TANK_H/TANK_T` 与 `P["tank_d"]/["tank_pos"]` 重跑。
2. 剖切开口只朝 +Y（观众侧），从背面看仍是完整桶壁；这是刻意的（答辩只从正面看）。
3. 桶内走线为示意路径（不追求真实线长），真实布线以《花房接线规划表》为准。
4. 挡水堤长度按 `2d+8=116` 取，两堤在拐角处不连续（各自独立），不影响挡水。

## 五、连带待办

| 事项 | 状态 |
|---|---|
| 06b 重打印（若已打则需重打） | 未打——硬件 10/21 到，打印排在 W1，**现在替换零成本** |
| README 打印件表 06b 91.3→96.3 g | 已同步 |
| 底盘/装配两份交付说明 | 已同步（重量/槽位/落座表/走线描述） |
| E 盘镜像 | 已同步 |
