huankechong/smart-greenhouse/outputs/素材/素材整理_2026-11-07/素材索引表.md

# 素材索引表 · 智能花房养护站

> **角色**：R4 文档与影像 ｜ **建表日期**：2026-11-07（D0 开工日）
> **命名规范**：`S{阶段}-{任务号}-{描述}`（见 `docs/花房4人分工方案_2026-10-20.md` §八 协作机制）
> **用途**：答辩被问"这块谁做的"能秒答；素材当场拍当场归档，事后补拍的照片一眼假。

---

## 一、素材总表

| 编号 | 阶段 | 任务号 | 描述 | 类型 | 拍摄/采集人 | 采集日期 | 对应报告章节 | 状态 |
|---|---|---|---|---|---|---|---|---|
| S1-8.1 | S1 开工周 | 8.1 | 继电器吸合验证 | 记录 | 领导 | 2026-11-10 | 三模块实现·执行层 | ✅ **以串口验证记录代替照片**（on/off/t 三连全过、吸合断开计时正确，2026-11-10 实测；领导 2026-11-12 决定不补拍） |
| S1-8.2 | S1 开工周 | 8.2 | 水泵出水照片 | 照片 | 领导 | 2026-11-10 | 三模块实现·执行层 | ✅ **由 S1-8.2v 视频豁免**（16.9s 量水实录同框覆盖；领导 2026-11-12 决定不单拍） |
| S1-8.2v | S1 开工周 | 8.2 | 水泵出水短视频 | 视频 | 领导 | 2026-11-10 | 三模块实现·执行层 | ✅ 已到手（`素材整理_2026-11-10/S1-8.2-水泵量水实测.mp4`，16.9s/720p/922KB，量水过程实录） |
| S1-7.2 | S1 开工周 | 7.2 | OLED 三行数据显示照 | 照片 | 领导 | 2026-11-08 | 三模块实现·感知层 | ✅ 已到手（原件_2026-11-08_打印与测试/测试照_2.jpg，屏显「土壤:100%」） |
| S1-6.x | S1 开工周 | 6.x | 6 项传感器逐个点亮照片 | 照片 | 领导 | 2026-11-08 | 三模块实现·感知层 | 🟡 部分（光敏/DHT11/LED/OLED 已拍：测试照_1~6；土壤湿度与继电器待周一补） |
| S1-4.1 | S1 开工周 | 4.1 | 串口土壤湿度读数截图 | 截图 | — | — | 失败与排查 | ⬜ 待补 |
| S1-9.3 | S1 开工周 | 9.3 | 首次全自动浇水完整过程视频（1 分钟） | 视频 | 领导 | 2026-11-13 | 闭环控制实证 | ✅ **已到手**（`素材整理_2026-11-13/S1-9.3-自动浇水闭环演示.mp4`，86.7s / 1280×720 / 15.6MB，桌面全景：ESP32 + 继电器 + 充电宝 + 透明水箱 + 花盆整套实机运行，继电器指示灯亮） |
| S2-8.1 | S2 打印周 | 8.1 | pigtail 回路首次出水视频 | 视频 | 领导 | 2026-11-13 | 三模块实现·执行层 | ✅ **已到手**（`素材整理_2026-11-13/S2-8.1-pigtail回路首次出水.mp4`，43.2s / 720×1280 竖屏 / 1.9MB，USB 母转 2P 端子 pigtail 接线 + 继电器 + 底吸泵首次出水实况） |
| S1-15.1 | S1 开工周 | 15.1 | 整机四角度照 | 照片 | — | — | 整机装配 | ⬜ 待补 |
| S2-11.2 | S2 打印周 | 11.2 | 小程序首条数据面板截图 | 截图 | — | — | 三模块实现·云端 | ⬜ 待补 |
| S2-12.1 | S2 打印周 | 12.1 | 手机点按钮 + 水泵出水短视频 | 视频 | — | — | 三模块实现·云端 | ⬜ 待补 |
| S2-12.2 | S2 打印周 | 12.2 | 局域网保底网页截图 | 截图 | — | — | 断网兜底 | ⬜ 待补 |
| S2-16.1 | S2 打印周 | 16.1 | 48h 连续运行云端曲线图 | 图 | — | — | 实验数据（核心章节） | ⬜ 待补 |
| S2-10.1 | S2 打印周 | 10.1 | 整机接线电路图（拟物版·孔位级） | 图 | yinyinyin666 | 2026-11-09 | 系统架构 | ✅ 已出 |
| S2-13.1 | S2 打印周 | 13.1 | 打印件成品照（每件一张） | 照片 | yinyinyin666 / 领导 | 2026-11-12 | 结构实现 | 🟡 **已打 9/10**（+ 03 加强针版 / 06c×2 于 11-11，+ 06a 沉槽修正版于 11-12）；成品照 **12 张**（10+11 同框 / 11 单件 / 06a 单件 / 06a 打印现场 / 10 单件 / 06a 俯视 / 03 / 04×2 / 07 / 11×2），**08 / 01b 待补**；剩余 06b 待打 |

---

### 本批新增（2026-11-08 实拍，已入仓）

目录：`outputs/素材/素材整理_2026-11-07/原件_2026-11-08_打印与测试/`

| 文件 | 内容 | 对应索引 |
|---|---|---|
| 测试照_1.jpg | 双色 LED 绿灯亮（面包板+ESP32 供电） | S1-6.x |
| 测试照_2.jpg | **OLED 屏显示「土壤: 100%」+ ESP32 工作态** | **S1-7.2 ✅** |
| 测试照_3.jpg | OLED 背面 V1.2（I2C 0x3C 已实测确认） | S1-7.2 佐证 |
| 测试照_4.jpg | DHT11 模块接线（OUT→D33 工作态） | S1-6.x |
| 测试照_5.jpg | 双色 LED 绿灯 + 白盘（对照背景） | S1-6.x |
| 测试照_6.jpg | 双色 LED 模块特写（绿灯） | S1-6.x |
| 视频 5.2s / 720p | 元件测试过程（LED/供电） | S1-6.x 佐证 |

> 📅 **11/09（周一）现场补拍**（领导 2026-11-08 确认）：① 08 扎线座成品照 ② 继电器吸合照（8.1）③ 水泵出水照片+短视频（8.2）④ 土壤湿度读数与浮球照。拍完直接改本表状态列。

### 本批新增（2026-11-09 实验室实拍，已入仓）

目录：`outputs/素材/素材整理_2026-11-07/原件_2026-11-08_打印与测试/`

| 文件 | 内容 | 对应索引 |
|---|---|---|
| S2-13.1-10水箱盖与11光敏柱成品.jpg | **10 号水箱替换盖（白盘）+ 11 号光敏电阻小柱（黑件）同框成品照** | S2-13.1 |
| （待补）S2-13.1-08扎线座成品 | 08 扎线座（绿件）；11-08 已打但未拍 | S2-13.1 |
| （待补）S2-13.1-07温度传感器架成品 | 07 DHT11 座；11-09 已打但未拍 | S2-13.1 |

### 本批新增（2026-11-12 实验室实拍，已入仓）

目录：`outputs/素材/素材整理_2026-11-12/`

| 文件 | 内容 | 对应索引 |
|---|---|---|
| S2-13.1-11光敏电阻小柱成品.jpg | **11 号光敏电阻小柱（黑件）单件成品照**：底板 + 斜柱 + 顶部双缺口托槽 | S2-13.1 ✅ |
| S2-13.1-06a底盘左片成品.jpg | **06a 整机底盘·左片（白件）单件成品照**：φ62 花盆槽 + 面包板/继电器/屏架/DHT 座/光敏座/扎线座多槽布局，接缝面两处连接块沉槽半槽（各含 2 个 φ2.8 引导孔） | S2-13.1 ✅ |
| S2-13.1-06a底盘与11光敏柱同框.jpg | 06a 底盘 + 11 光敏柱同框（补充，非单件照） | S2-13.1 佐证 |
| S2-13.1-06a底盘打印完成_拓竹X2D.jpg | **06a 打印完成实况**：拓竹 X2D 打印床上的成品件（φ62 花盆槽成型、8mm 板厚断面可见） | S2-13.1 佐证 |

> ✅ **件号判定依据（不靠肉眼猜）**：06a 左片含 φ62 花盆槽 + 7 处元件槽 + 2 处连接块沉槽半槽（每槽 2 个 φ2.8 引导孔）；06b 右片只有 1 个 φ108 水箱槽、其余平整。照片中「一个大圆坑 + 多个矩形凹槽 + 带孔凸台」的组合 → 判定为 **06a 左片**，与 `06a_base_left` 俯视图逐项吻合。
> ⚠️ **06a 尚未与 06b 实测拼接**，接缝齐平度与 φ4×16 定位销配合仍待验证（06b 未打）。

### 本批新增（2026-11-13 实验室实拍，已入仓）

目录：`outputs/素材/素材整理_2026-11-13/`

| 文件 | 内容 | 对应索引 |
|---|---|---|
| S1-9.3-自动浇水闭环演示.mp4 | **首次全自动浇水完整过程**（86.7s / 1280×720 / 15.6MB）：桌面全景，ESP32 + 继电器 + 充电宝 + 透明水箱 + 花盆整套实机运行，继电器指示灯亮 | **S1-9.3 ✅** |
| S2-8.1-pigtail回路首次出水.mp4 | **pigtail 回路首次出水**（43.2s / 720×1280 竖屏 / 1.9MB）：USB 母转 2P 端子 pigtail 接线 + 继电器 + 底吸泵出水实况 | **S2-8.1 ✅** |
| S2-13.1-10水箱替换盖成品.jpg | 10 号水箱盖单件（圆盘 + 2 圆孔 + 腰形过线槽 + 对称指位缺口） | S2-13.1 ✅ |
| S2-13.1-06a底盘左片成品_俯视.jpg | 06a 底盘左片单件俯视（φ62 花盆槽 + 多槽布局） | S2-13.1 ✅ |
| S2-13.1-03水管末端固定夹成品.jpg | 03 水管末端固定夹（加强针版，方座 + 双竖柱 + U 形槽） | S2-13.1 ✅ |
| S2-13.1-04OLED45度支架成品.jpg | 04 OLED 45° 支架（裙墙 + 两条内筋 + 背面过线口） | S2-13.1 ✅ |
| S2-13.1-04OLED45度支架成品_侧视.jpg | 04 OLED 支架侧视（45° 斜面槽 + 阶梯缺口） | S2-13.1 ✅ |
| S2-13.1-07DHT11小座成品.jpg | 07 DHT11 小座（锥形柱 + 顶部托槽） | S2-13.1 ✅ |
| S2-13.1-11光敏电阻小柱成品_深色.jpg | 11 号光敏小柱（深色件，底板 + 斜柱 + 顶部双缺口托槽） | S2-13.1 ✅ |
| S2-13.1-11光敏电阻小柱成品_侧视.jpg | 11 号光敏小柱另一视角（灰色件） | S2-13.1 ✅ |

> ✅ **件号判定依据（对照 `p1p2_models.py` 建模参数与 preview 逐项核实，不靠肉眼猜）**
> - **04 OLED 支架** vs **08 扎线座**：08 的特征是**三条平行长槽**（`n=3` 线孔 + 顶部收口槽）；04 的特征是**裙墙 + 两条内筋**（`fin_x` 两条）+ 背面 13×7 过线口。本批长条件放大后可见**两条平行长槽 + 端部阶梯缺口** → 判定 **04**，非 08。
> - **03 水管夹**：方座上方两根竖直细长柱夹持面 + 中间 U 形槽 → 加强针版（`pin_t 4.0`）。
> - **07 DHT11 座**：锥形柱身（33.7° 锥度）+ 顶部托槽，与 11 号光敏柱的方形斜柱+双缺口托槽形态不同。
> - **06a 底盘**：φ62 花盆槽 + 七处元件嵌槽 + 2 处连接块沉槽半槽（各含 2 个 φ2.8 引导孔）。
> - **10 水箱盖**：中心 2 圆孔 + 1 腰形过线槽 + 2 对称 φ26 指位缺口。
>
> 🔒 **隐私核查**：两段视频逐帧抽查（5s / 25s / 40s / 70s），画面中无姓名、学号、手机号、订单号、条形码、UID 私钥等个人信息；笔记本屏幕内容为代码与终端输出，不含个人标识。符合 `AGENTS.md` §5。

> 📷 **拍照规矩（2026-11-09 定，起因：R4 发现「说好是水桶盖的照片里其实有两个件」）**
> 1. **一件一张**：每件单独占画面，镜头里只放一个件；多件同框只能作「全家福」补充，不能替代单件照
> 2. **背面/正面各一张**：有槽、有孔、有台阶的件必须拍到特征面（否则无法证明"板槽通不通"）
> 3. **同框照必须逐个点名**：文件名写清「X与Y」，不许只写其中一个（R4 这张就该叫「10水箱盖与11光敏柱」而不是「水桶盖」）
> 4. 拍完当场改本表对应行，不隔夜补
| S2-10.1-接线图打印稿现场对照.jpg | 整机接线总图（拟物版）打印稿，实验室现场对照用 | S2-10.1 佐证 |

> **核对结论（对照模型 preview 逐项验）**：
> - 白盘 = 10 号水箱盖：圆形、2 个圆孔 + 1 个腰形过线槽、2 个对称 φ26 指位缺口 —— 与 `10_tank_lid.png` 俯视图逐项吻合。
>   照片中孔位左右与模型俯视图**镜像** → 照片是**底面视角**，印证模型"顶面朝下打印"的要求正确。
> - 黑件 = 11 号光敏电阻小柱：底板 + 斜柱 + 顶部双缺口托槽 —— 与 `11_ldr_stand.png` 吻合。
> - 两件均为 **D+2（11-09）实验室打印成功**，已回填 `docs/工作日志/打印日志.md`。

## 二、命名规则

```
S{阶段}-{任务号}-{描述}.{扩展名}

阶段：S1 开工周 / S2 打印周 / S3 集成攻坚 / S4 收口彩排
任务号：沿用《花房4人分工方案》附录·任务底稿的编号（4.x–19.x），不另起新号
描述  ：简明中文，不含空格，用连字符分词
```

**示例**：`S1-8.2-水泵出水照片.png`

---

## 三、素材来源三分（谁拍、图从哪来）

| 来源 | 说明 | 归档责任 |
|---|---|---|
| R1 领导 | 固件串口截图、电路实物照 | R4 统一归档命名 |
| R2 上云 | 小程序面板、历史曲线截图 | R4 统一归档命名 |
| R3 结构 | 打印过程照、成品照、试装照 | R4 统一归档命名 |
| R4 影像 | 接线电路图、录屏、兜底视频 | R4 自行归档 |

> 拍摄规矩：**当场拍当场归档**，不事后补拍。素材真实性是答辩隐性评分点。

---

## 四、D0 素材欠账（今日必补 ≥8 张）

D0 电子实验日需当场产出、当晚补齐入库：

- [ ] 继电器吸合照（8.1）
- [ ] 水泵出水照 + 短视频（8.2）
- [ ] 出水量记录表填毕照（8.2，ml/s 数据是 9.3 折算 `WATER_MS` 的依据）
- [ ] OLED 屏三行显示照（7.2）
- [ ] 6 项传感器逐个点亮照（6.x）
- [ ] 串口土壤湿度读数截图（4.1）
- [ ] 浮球极性判断照（万用表档位）
- [ ] 首次全自动浇水过程视频（9.3，答辩核心素材）

---

## 五、隐私红线（素材入库前必查）

| 检查项 | 规则 |
|---|---|
| 淘宝/京东订单页、收货地址 | ❌ 绝不入库（含个人信息） |
| 巴法云 UID 私钥截图 | ❌ 绝不入库，只存本地 E 盘私档 |
| 学号 / 手机号 / 真实姓名 | ❌ 文档与素材中一律不落，只写指针 |
| WAGO / 继电器标签铭牌 | ✅ 可入（设备规格，非个人信息） |

> 对应 `.gitignore` 规则：`outputs/素材/_敏感_不入库/截图备份_*/`、`outputs/素材/_敏感_不入库/截图整理_*/` 已排除。

---

## 六、待补说明

1. 本表为**建表初版**，目录结构与规范已定，各素材行按实际进度回填。
2. D0 实验后由 R4 回填实际拍摄人、日期与文件路径。
3. 素材原文件存放位置：本地 E 盘 `素材/` 目录 → 仓库镜像 `outputs/素材/`。
4. 巴法云免费版历史数据保留期有限，**上云当天即导出**，R2 负责，导出件按 `S2-16.1` 归档。

### S2-10.1 交付说明（2026-11-09 完成）

| 项 | 内容 |
|---|---|
| 交付物 | `outputs/接线图生成器/导出PNG/花房接线图_整机总图_接线图.png`（3900×2880，报告正文插图）<br>`outputs/接线图生成器/导出PNG/花房接线图_整机总图_接线图_附清单.png`（2600×6270，含逐线清单+端口表+核对表，报告附录） |
| 图源 | `docs/操作手册/花房接线图_整机总图.html` 内联 SVG（R1 出，2026-11-09） |
| 导出脚本 | `outputs/接线图生成器/export_wiring_png.py`（Edge headless 渲染 + 自动裁白，零外部依赖） |
| 为什么不用 Fritzing | Fritzing 画元件外观图，评委看不出线接哪个孔；本图画**真实 400 孔板孔阵**（a–j × 1–30 行），每根线标具体孔位，答辩可指孔作答 |
| 图内已含 | 四条铁律提示 + 面包板拟物总图 + 逐线清单（杜邦 21+跳线 6+元件 2）+ ESP32 端口占用总表 + 通电前 60 秒核对表 |
| 与固件口径 | 引脚逐一核对 `GreenHouse_v1.ino` 第 55–61 行；器件丝印按 11/06–11/08 实拍 OCR |

> 重新导出：`python outputs/接线图生成器/export_wiring_png.py`（默认 3x，可传 `4x` 提高分辨率）

---

*建表：R4 ｜ 2026-11-07 ｜ 依据 `AGENTS.md` §8 + `docs/花房4人分工方案_2026-10-20.md` §十、附录·任务底稿*
