huankechong/smart-greenhouse/docs/审计报告/archive/AR04_GreenHouse拼缝连接件隐蔽化_2026-10-18.md

# AR04 · GreenHouse 拼缝连接件隐蔽化改造 + 螺丝规格 bug

> 日期 2026-10-18 · 触发：领导「能不能把链接件设计的不显眼一些」
> 范围：`花房3D_整机底盘/`（06a/06b/06c）· 装配模型仅跟随板顶变化
> 前一版：AR03（底板 × 装配一致性，同日）

---

## 一、问题

| # | 问题 | 类型 |
|---|---|---|
| 1 | 两块连接块高出板面 3mm，8 颗螺丝头全露在表面，整机俯视图上是一道明显的台阶 + 8 个亮点 | 外观 |
| 2 | **采购清单写的是 M3×8，实际会穿出底板底面 1mm** | 🔴 真 bug |
| 3 | 板厚改 8mm 后，自攻导向孔仍按旧公式定位，孔底留下 2.25mm 实心，M3 拧不进 | 🔴 真 bug（改造中引入） |

第 2 条是按旧结构精确算出来的：槽深 1 → 块占 z 5–9，沉头窝 2mm → 头座面 z=7.0；M3×8 尖落在 **z = −1.0**，即穿出底面 1mm。而旧文档写的是「用 M3×8 刚好，M3×10 会穿出 0.8mm」——两个数都错。

---

## 二、方案选择

要做到「不显眼」，只有三条路，差别全在打印代价：

| 方案 | 齐平 | 螺纹咬合 | 打印时间 | 结论 |
|---|---|---|---|---|
| A 板 6mm + 块齐平 + 螺丝从底面拧 | ✓ | 2.5 mm | 不变 | 咬合偏弱，拆装要翻面 |
| **B 板 8mm + 块齐平 + 沉头从上面拧** | ✓ | **4.3 mm** | +1 h/片 | **采用**（领导选定） |
| C 6mm + 定位销 + AB 胶粘死 | ✓（最干净） | — | 不变 | 永久固定，不可拆 |

> 关键约束：块要与板面齐平，沉槽就必然吃掉「块厚」那么多材料。6mm 板槽下只剩 2.5mm，M3 只能咬 2.5mm，且螺丝尖离底面不足 0.5mm——这才是 B 要把板加到 8mm 的唯一原因。

---

## 三、改动明细

### 几何（`base_2pc_models.py`）

| 项 | v1.1 | v1.2 | 影响 |
|---|---|---|---|
| `plate_t` | 6.0 | **8.0** | 两片各 +1 h 打印、+22 g |
| `recess_d` | 1.0 | **3.5** | 与块厚相等 → 齐平 |
| `block_t` | 4.0 | **3.5** | 露出量 3mm → **0.0mm** |
| `c_bore_t` | 2.0 | **1.8** | = M3 盘头头高 → 头面与板面齐平 |
| `pot_depth` | 4.0 | **6.0** | **槽底仍 z=2**（板顶 8 − 6） |
| `pocket_depth` | 1.5 | **3.5** | 槽底仍 z=4.5 |
| `tank_depth` | 3.0 | **5.0** | 槽底仍 z=3 |
| 自攻导向孔 | 固定 `pt/2+0.5` | `(0.6 + mat)/2`，深 `mat−0.6` | 从槽底打到距板底 0.6 处 |

**关键设计：所有槽都是「从板顶往下加深」，而不是「把槽底往下挪」。** 所以花盆、水箱、面包板、继电器、连接块的**底面绝对高度一个都没变**——装配模型不用重摆，只有坐板面的四件（OLED 支架、DHT11 座、扎线座、LED）随板顶从 6 抬到 8。

### 螺丝链条（以 M3×6 盘头为例）

```
块顶/板面    z = 8.00
头座面       z = 6.20   （沉窝 1.8）
槽底         z = 4.50
螺丝尖       z = 0.20   （6.20 − 6.00）
导向孔底     z = 0.60   ← 尖头扎进最后 0.4mm，留 0.2mm 皮，不穿底
咬合长度     4.50 − 0.20 = 4.30 mm
```

### 配色

模型里连接块原先用比底盘深一档的灰，但图例早已把「底盘（两片 + 2 块连接块）」合并成一项——**颜色和图例对不上，等于在图上故意标出它**。现实里两者是同一卷白色 PLA，已统一为 `base` 色，块在俯视图里只剩一条发丝缝 + 4 个沉孔阴影。

---

## 四、验证证据

`check_base_fit.py`（同步把 `PT` 改 8、连接块期望改 4.5 后重跑）：

```
① 落座高度 15 项全 OK（连接块 4.50 / 花盆 2.00 / 水箱 3.00 / 面包板·继电器 4.50 / 板面件 8.00）
② 件 × 底板 干涉 9 件全部 0.0 mm³
③ 底板特征 7 项全 OK（LED 孔通、ESP32 空槽已删、四个功能槽仍在）
```

齐平度实测：

```
底板 z 0.0 ~ 8.0      连接块 z 4.50 ~ 8.00
块顶 − 板顶 = 0.0000 mm
跨缝顶面探针（z=7.6，x −25…20）：全部实心，无台阶
```

其他：

- 三件仍 `watertight / bodies=1 / z_min=0`；左片 299.8 g、右片 274.3 g、连接块 4.2 g
- 屏幕遮挡复算：90°/30°、60°/30°、42°/26°、90°/45° **全部 0%**（板顶抬高 2mm 不影响视线）
- HTML 重建（24,608 面）实开验证：WebGL 正常、零 JS 报错、图例 15 项
- `audit.py` 基准值同步（左片 299.8 / 右片 274.3 / 块 4.2），全量复跑无 `!!`

---

## 五、代价与限制

1. **打印时间 4–5 h → 6 h/片**，两片多约 2 h；耗材 +22 g/片。
2. **螺丝只能买 M3×6**：M3×8 穿出 1.8mm，M3×10 穿出 3.8mm。手上只有 M3×8 的话，钳子剪短 2mm + 锉刀修口。
3. 块与沉槽留 0.6mm 单边间隙（`recess_clear`），拆装时块会微动 ±0.3 —— 螺丝是松的，装的时候按对角逐步拧，块会自己归位。
4. 齐平之后接缝只剩一条发丝缝，**没有台阶可抓**；拆的时候得先用螺丝刀把块顶出来（块上有 4 个沉孔可以下钩子）。

---

## 六、版本演进

| 版本 | 时间 | 改动 |
|---|---|---|
| v1 | 10-18 上午 | 320×230 拆两片，M3×8 + 定位销，块露 3mm |
| v1.1 | 10-18 15:00 | 删 ESP32 空槽、加 LED φ5.2 孔 |
| **v1.2** | 10-18 15:15 | 板 8mm、块齐平、M3×6、导向孔重算、块配色并入底盘 |
