huankechong/smart-greenhouse/docs/archive/README.md

# docs/archive/ — 已归档文档

> **本目录文档已完成历史使命，仅备查，内容不再维护**（引用请一律指向现行层文档）。
> 归档时间：2026-11-06（AR19 文档整理）。

| 归档件 | 原状态 | 现行替代 |
|---|---|---|
| `W1到货点火与标定操作指南_2026-10-20.md` | 主流程已执行完毕（烧录/串口 2026-10-24 验证） | 与另两份合并 → `docs/操作手册/硬件操作手册_点火接线标定.md` |
| `土壤传感器焊接操作卡_2026-10-21.md` | 接线定案文档 | 同上合并 |
| `W1无烙铁接线方案_2026-10-20.md` | 已降级备选 | 同上合并（其内容成手册 §三） |
| `花房30天执行计划.md` | 已被相对排期取代（冻结通告 + S1–S4） | 压成任务底稿 → `docs/花房4人分工方案_2026-10-20.md` 附录 |
| `GitHub提交提示词_Agent自装自提_2026-10-20.md` | 场景已由 AGENTS.md §4.1 完整覆盖 | `AGENTS.md` §4.1 |
| `GitHub与Agent提交代码_零基础手册_2026-10-20.html` | MD 版的排版镜像，双源维护易分叉 | 只留 MD 版（`docs/GitHub与Agent提交代码_零基础手册_2026-10-20.md`） |
| `项目模式迁移包.md` | WorkBuddy「项目 BETA」迁移模板，写于 10-20，状态快照已过时 | 无继任（云端已停用，AGENTS.md 为唯一规则源） |

> AR01–AR09 审计报告归档在 `docs/审计报告/archive/`（内容原样保留，仅移出主层）。
