huankechong/smart-greenhouse/docs/操作手册/01b_装盆效果图.png

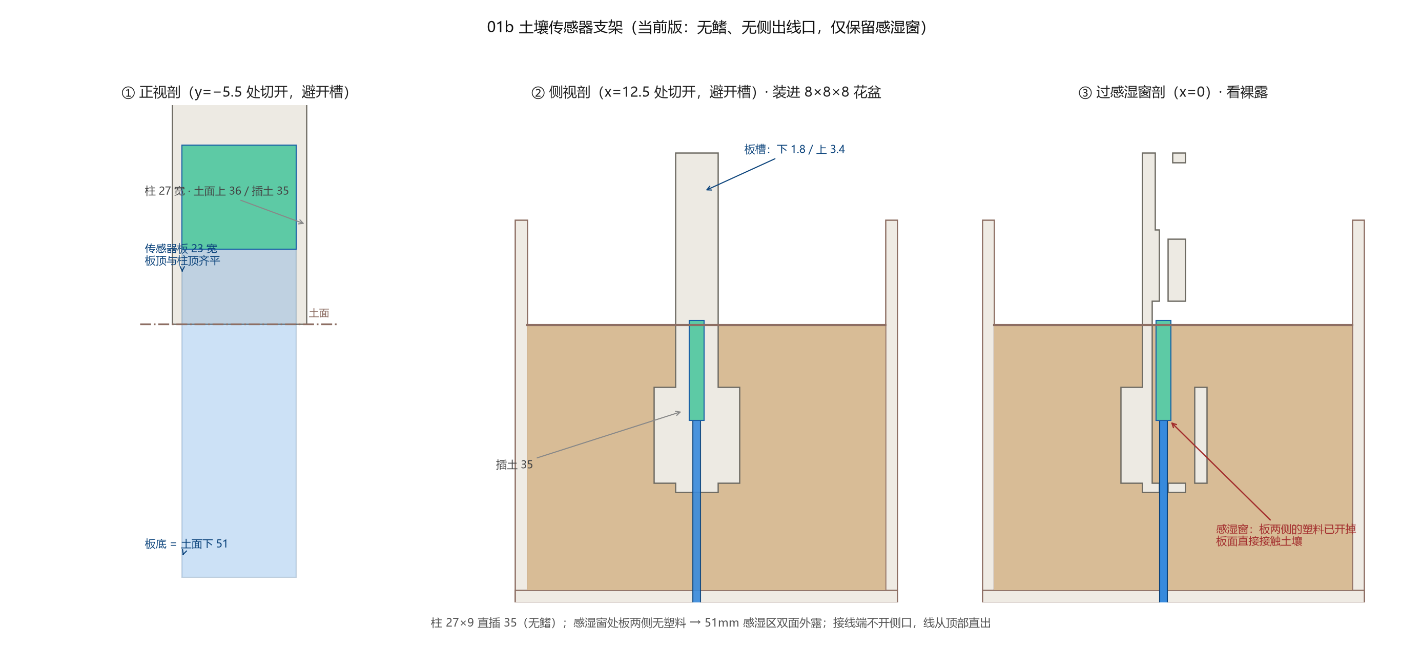
docs/操作手册/01b_装盆效果图.png
