huankechong/smart-greenhouse/docs/操作手册/04_各部位叫什么.png

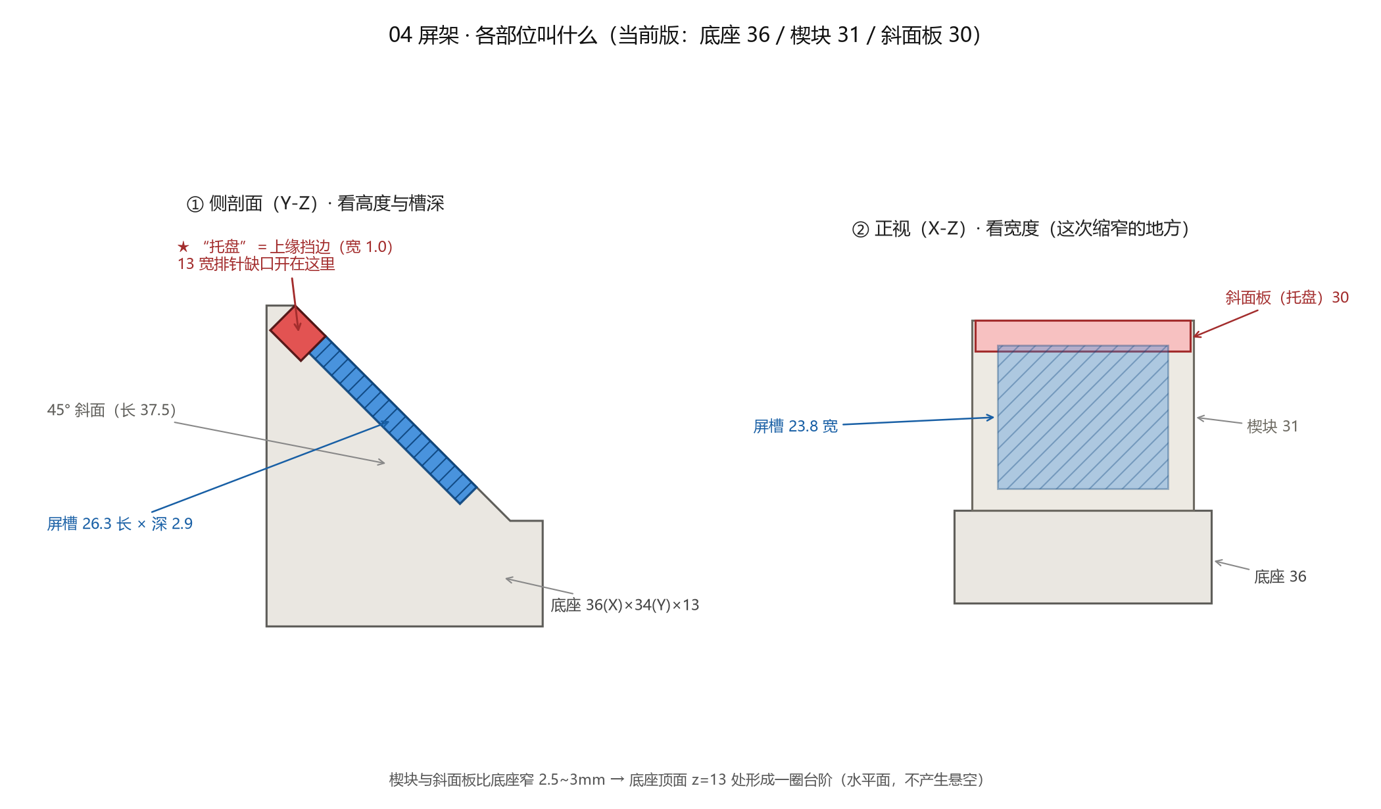
docs/操作手册/04_各部位叫什么.png
