huankechong/smart-greenhouse/outputs/3D打印件/花房3D_P0/preview/00_P0_2件总览.png

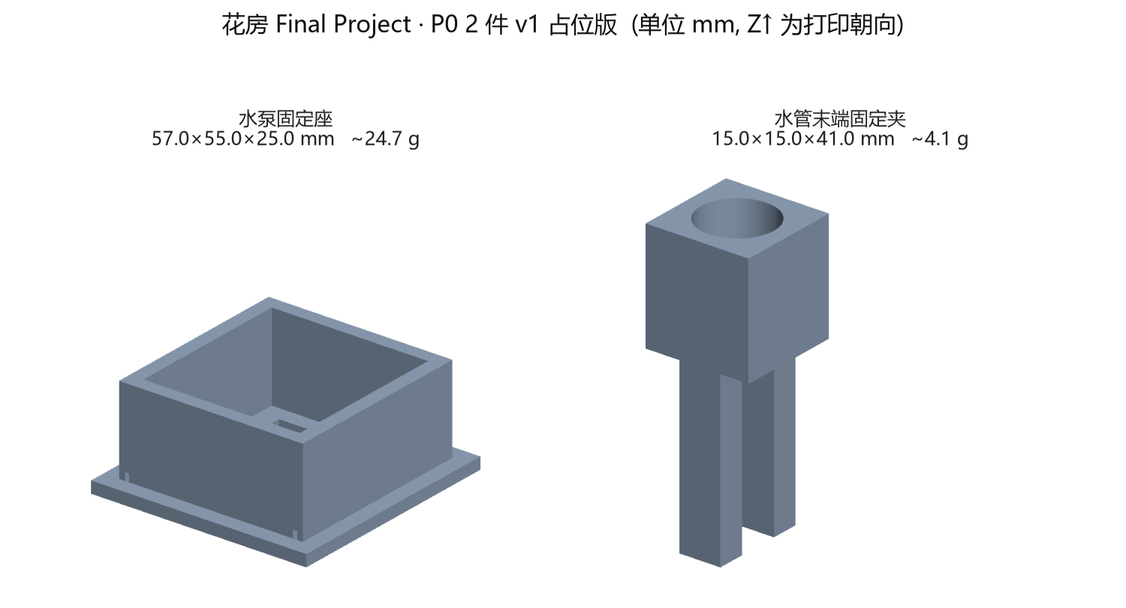
outputs/3D打印件/花房3D_P0/preview/00_P0_2件总览.png
