huankechong/smart-greenhouse/outputs/3D打印件/花房3D_P0/preview/02_pump_mount.png

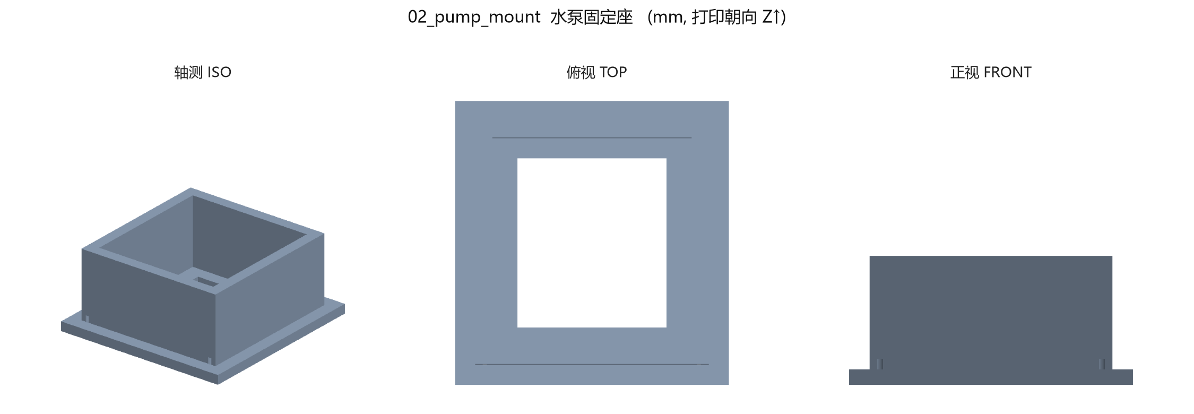
outputs/3D打印件/花房3D_P0/preview/02_pump_mount.png
