huankechong/smart-greenhouse/outputs/3D打印件/花房3D_P0/preview/03_tube_clip.png

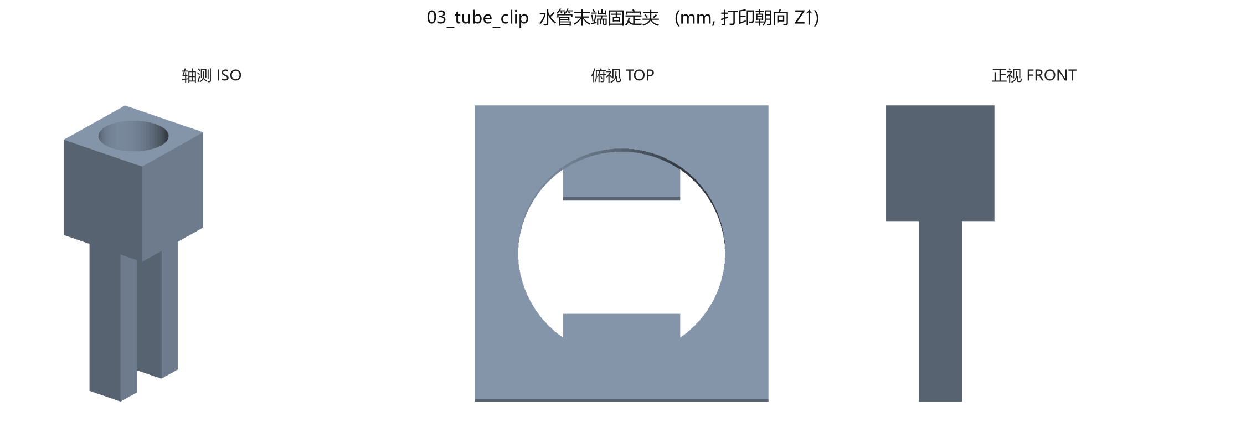
outputs/3D打印件/花房3D_P0/preview/03_tube_clip.png
