huankechong/smart-greenhouse/outputs/3D打印件/花房3D_P1P2/preview/00_P1P2_总览.png

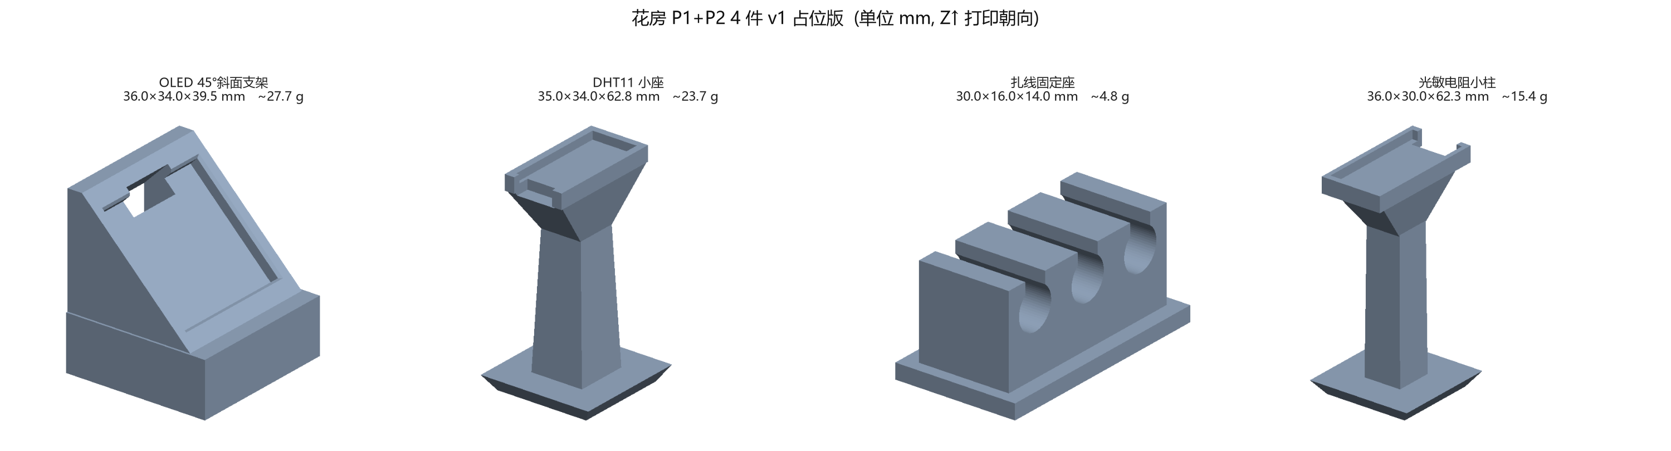
outputs/3D打印件/花房3D_P1P2/preview/00_P1P2_总览.png
