huankechong/smart-greenhouse/outputs/3D打印件/花房3D_P1P2/preview/11_ldr_stand.png

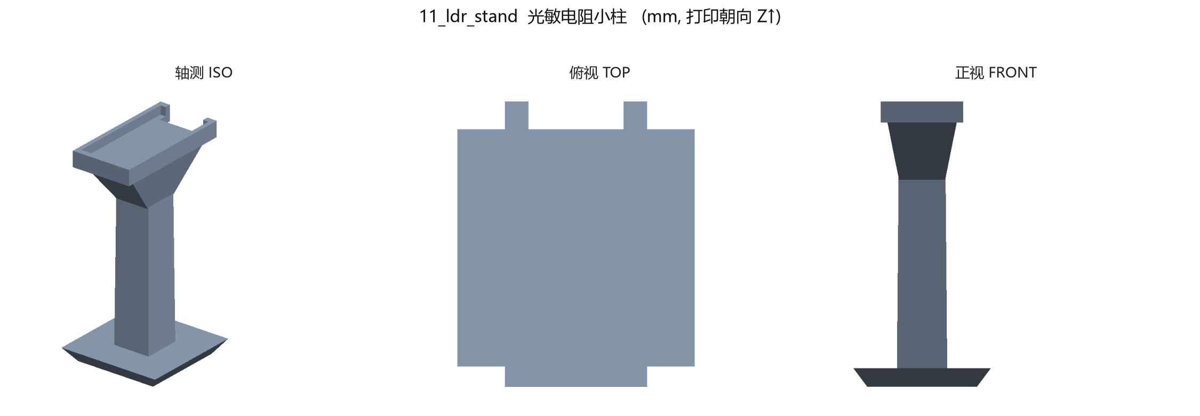
outputs/3D打印件/花房3D_P1P2/preview/11_ldr_stand.png
