huankechong/smart-greenhouse/outputs/3D打印件/花房3D_整机底盘/06b_效果图.png

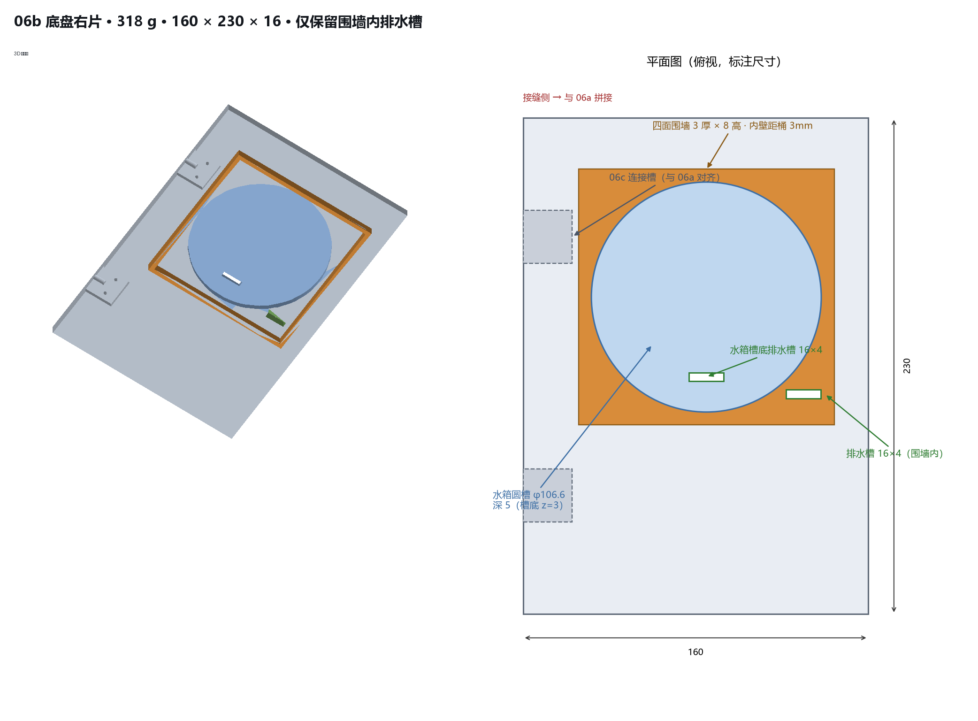
outputs/3D打印件/花房3D_整机底盘/06b_效果图.png
