huankechong/smart-greenhouse/outputs/3D打印件/花房3D_整机底盘/preview/06a_base_left.png

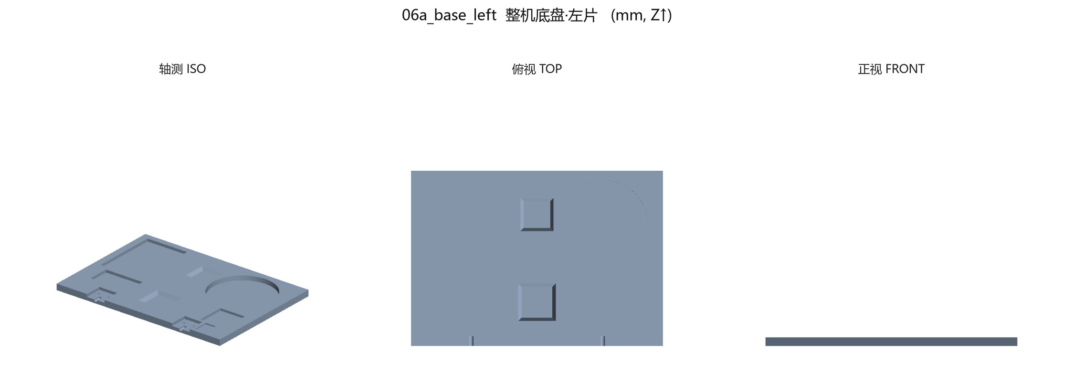
outputs/3D打印件/花房3D_整机底盘/preview/06a_base_left.png
