huankechong/smart-greenhouse/outputs/3D打印件/花房3D_水箱盖/preview/10_tank_lid.png

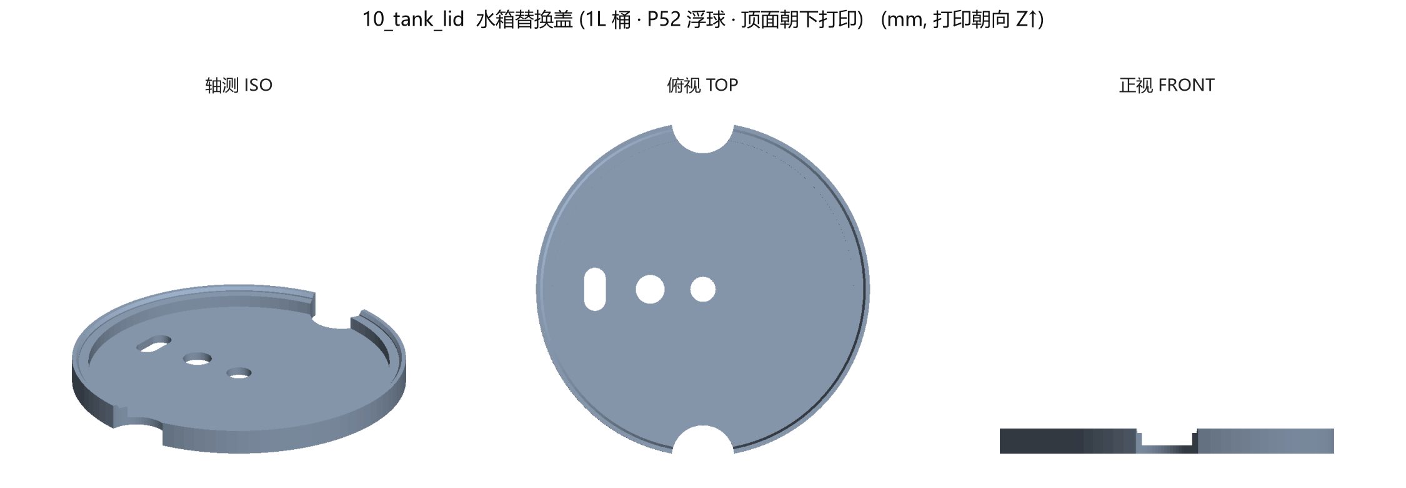
outputs/3D打印件/花房3D_水箱盖/preview/10_tank_lid.png
