huankechong/smart-greenhouse/outputs/接线图生成器/花房接线图_整机总图_接线图.png

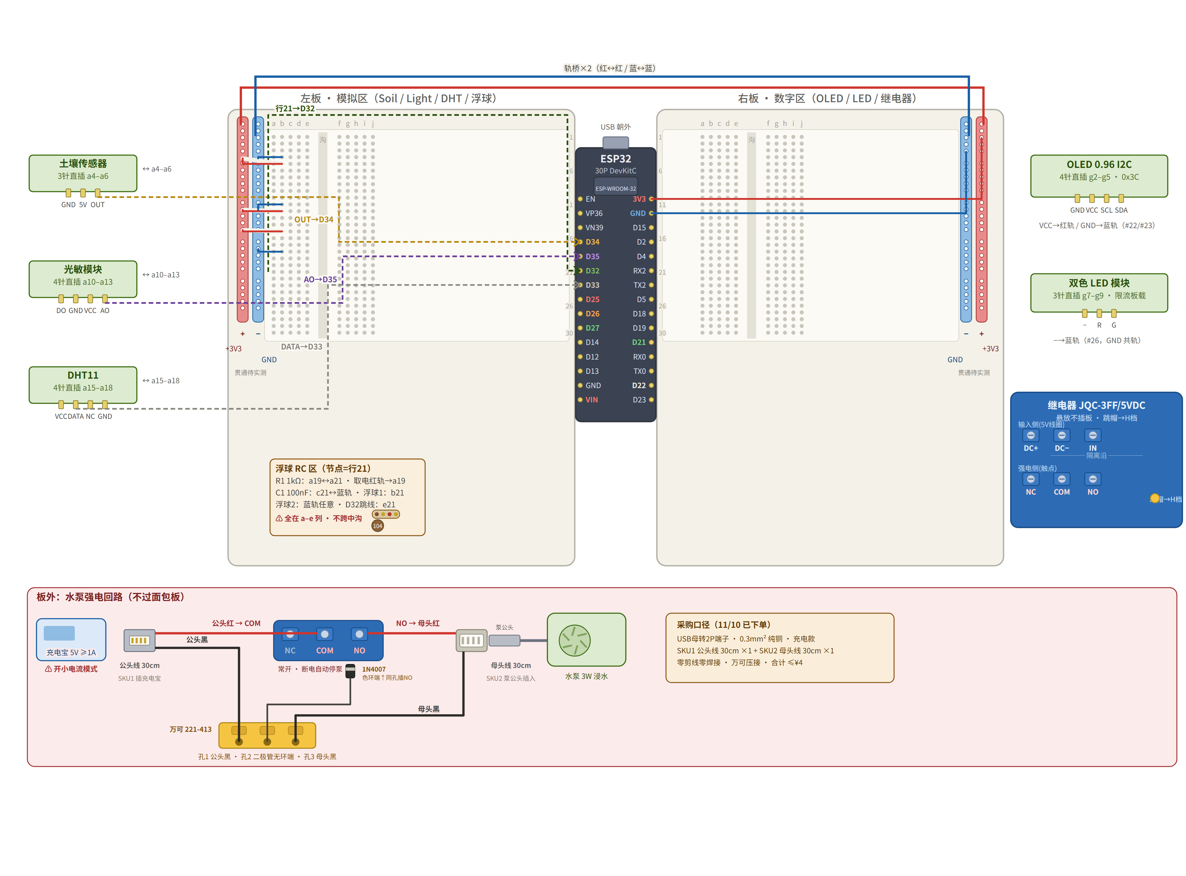
outputs/接线图生成器/花房接线图_整机总图_接线图.png
