huankechong/smart-greenhouse/outputs/素材/到货照片备份_2026-10-23/01_WAGO快接端子_8c5fbada.jpg

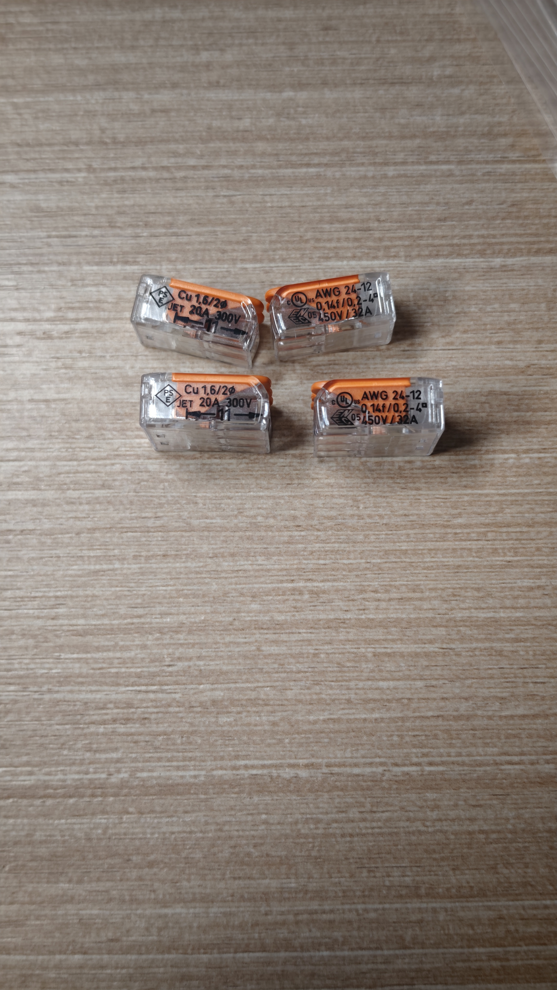
outputs/素材/到货照片备份_2026-10-23/01_WAGO快接端子_8c5fbada.jpg
