huankechong/smart-greenhouse/outputs/素材/到货照片备份_2026-10-23/02_P52浮球开关_7c81535b.jpg

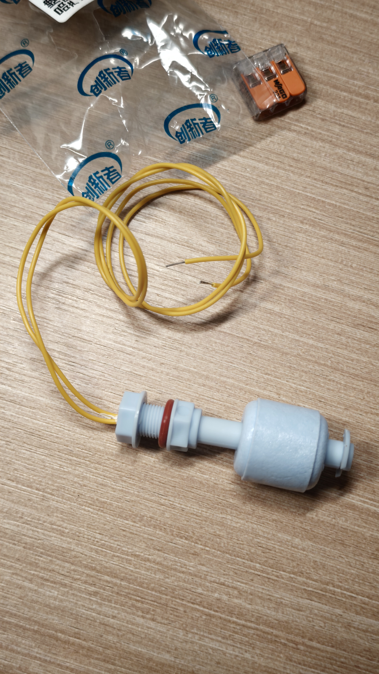
outputs/素材/到货照片备份_2026-10-23/02_P52浮球开关_7c81535b.jpg
