huankechong/smart-greenhouse/outputs/素材/到货照片备份_2026-10-23/03_USB延长线_7080a41b.jpg

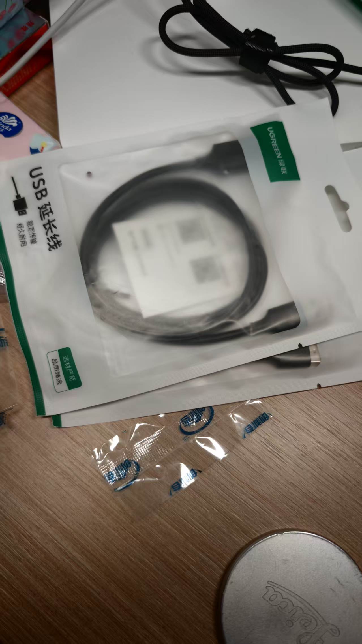
outputs/素材/到货照片备份_2026-10-23/03_USB延长线_7080a41b.jpg
