huankechong/smart-greenhouse/outputs/素材/到货照片备份_2026-10-23/04_套件元件袋_c7101277.jpg

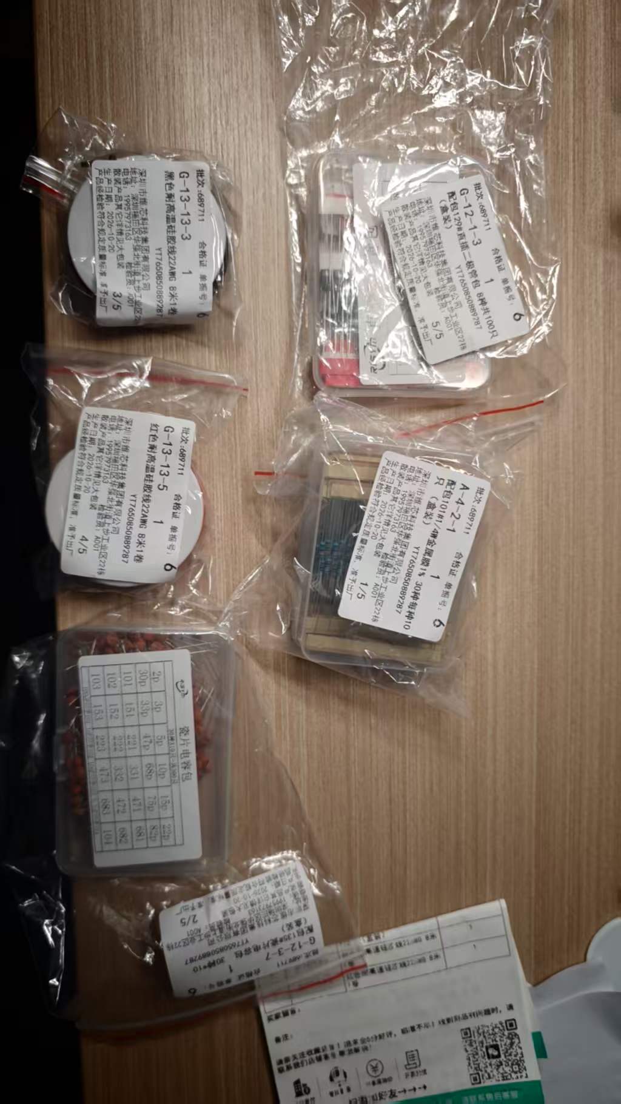
outputs/素材/到货照片备份_2026-10-23/04_套件元件袋_c7101277.jpg
