huankechong/smart-greenhouse/outputs/素材/到货照片备份_2026-10-23/05_螺母套装_5ff19be9.jpg

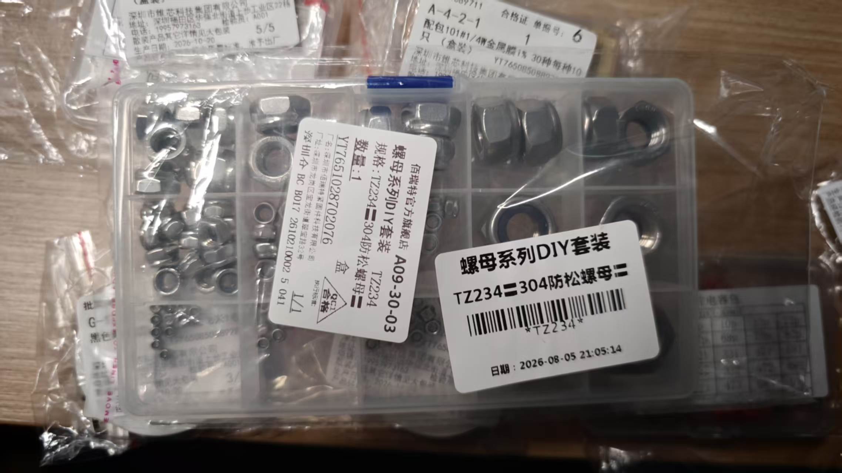
outputs/素材/到货照片备份_2026-10-23/05_螺母套装_5ff19be9.jpg
