huankechong/smart-greenhouse/outputs/素材/到货照片备份_2026-10-23/06_桶口翻边手绘图_clipboard_ec56.jpg

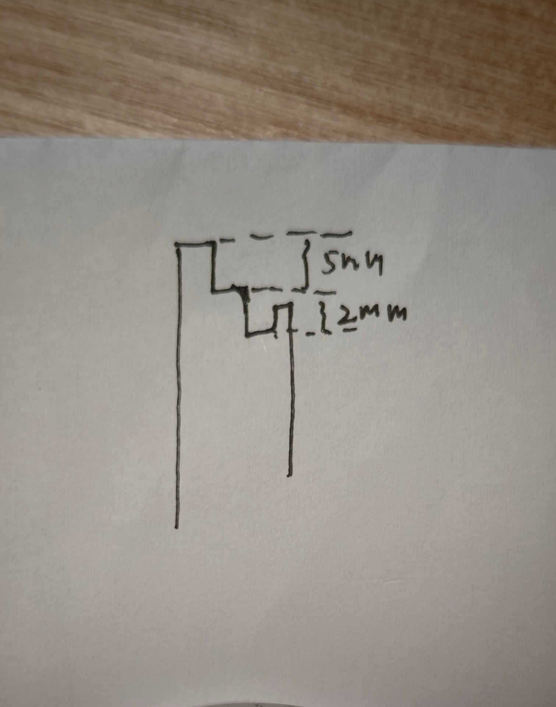
outputs/素材/到货照片备份_2026-10-23/06_桶口翻边手绘图_clipboard_ec56.jpg
