huankechong/smart-greenhouse/outputs/素材/到货照片备份_2026-10-23/07_桶口侧面特写_20e7b21e_原图.jpg

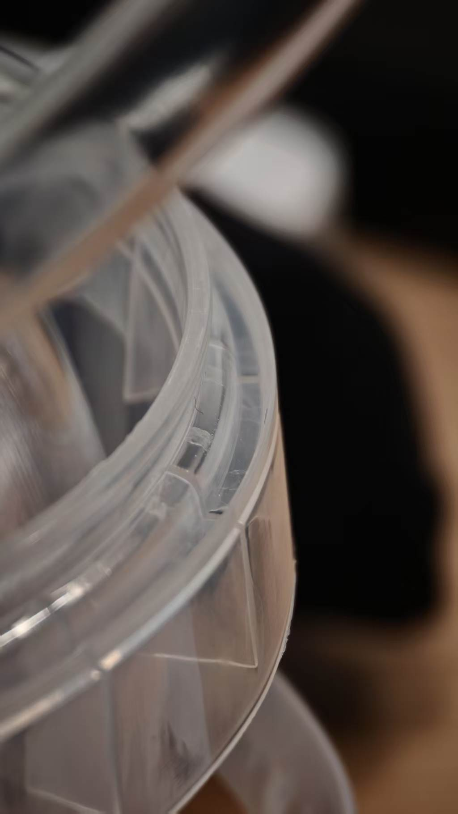
outputs/素材/到货照片备份_2026-10-23/07_桶口侧面特写_20e7b21e_原图.jpg
