huankechong/smart-greenhouse/outputs/素材/素材整理_2026-11-07/原件_2026-11-08_打印与测试/S2-10.1-接线图打印稿现场对照.jpg

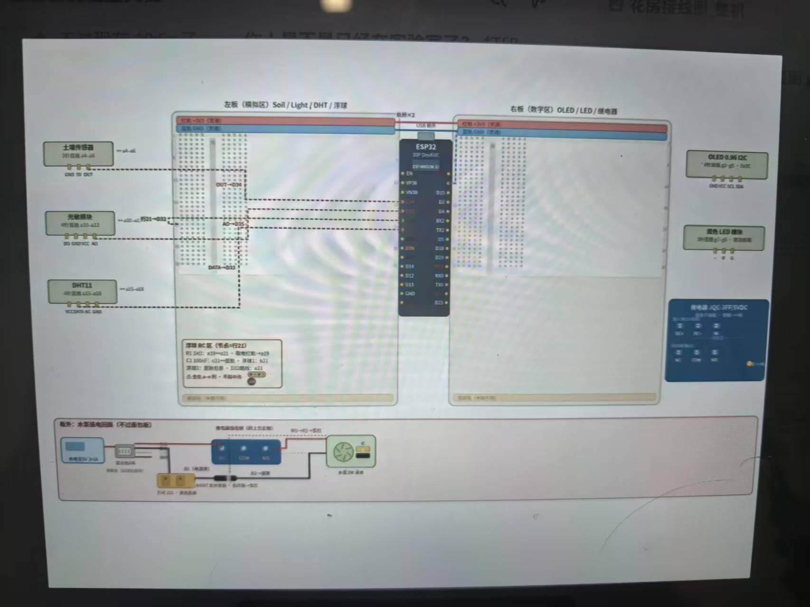
outputs/素材/素材整理_2026-11-07/原件_2026-11-08_打印与测试/S2-10.1-接线图打印稿现场对照.jpg
