huankechong/smart-greenhouse/outputs/素材/素材整理_2026-11-07/原件_2026-11-08_打印与测试/测试照_1.jpg

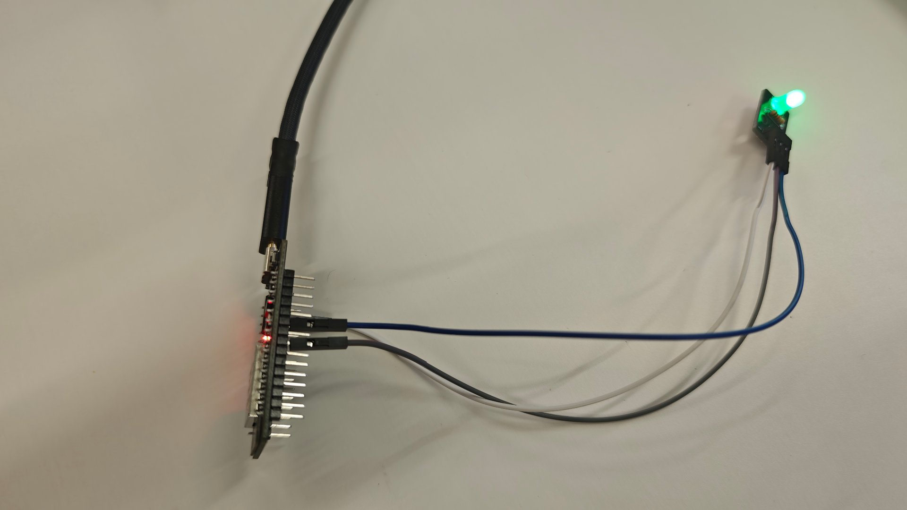
outputs/素材/素材整理_2026-11-07/原件_2026-11-08_打印与测试/测试照_1.jpg
