huankechong/smart-greenhouse/outputs/素材/素材整理_2026-11-10/S3-11.1-控制台双主题.png

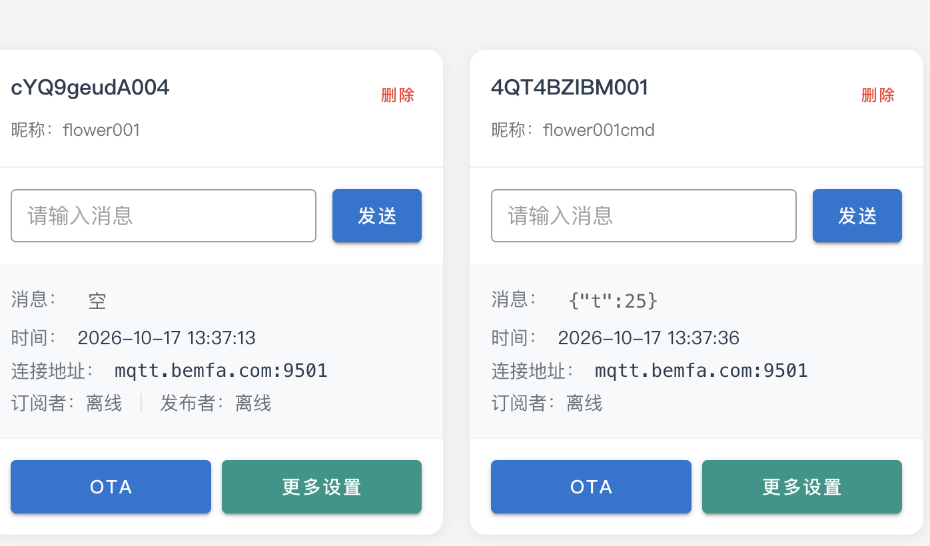
outputs/素材/素材整理_2026-11-10/S3-11.1-控制台双主题.png
