huankechong/smart-greenhouse/outputs/素材/素材整理_2026-11-10/S3-11.3-小程序未接通_控制台TCP页空.png

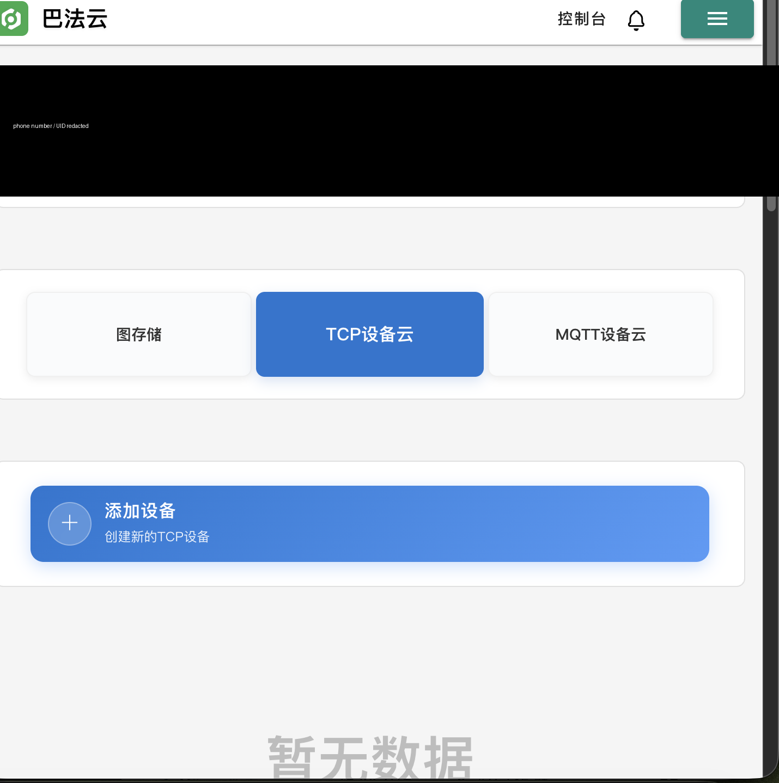
outputs/素材/素材整理_2026-11-10/S3-11.3-小程序未接通_控制台TCP页空.png
