huankechong/smart-greenhouse/outputs/素材/素材整理_2026-11-12/S2-13.1-06a底盘与11光敏柱同框.jpg

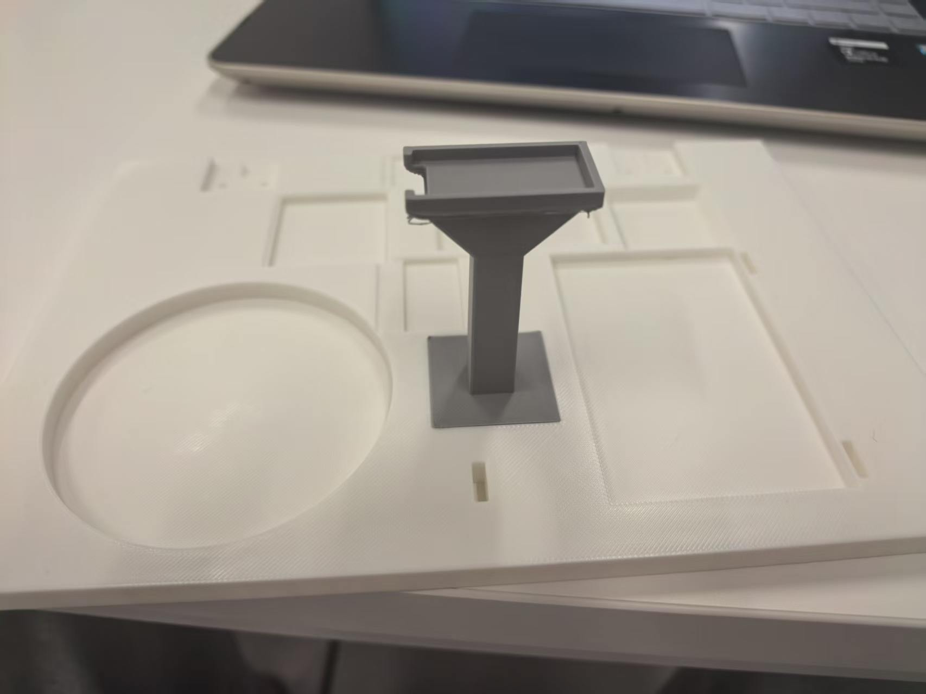
outputs/素材/素材整理_2026-11-12/S2-13.1-06a底盘与11光敏柱同框.jpg
