huankechong/smart-greenhouse/outputs/素材/素材整理_2026-11-12/S2-13.1-11光敏电阻小柱成品.jpg

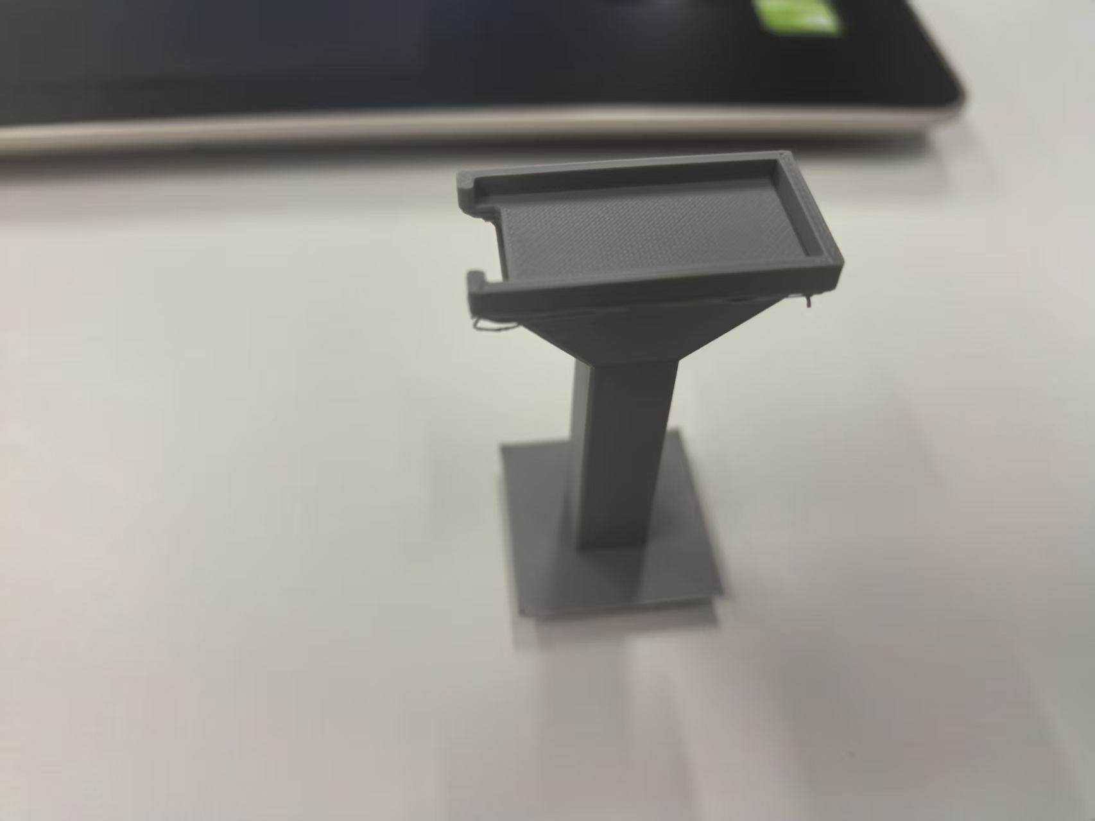
outputs/素材/素材整理_2026-11-12/S2-13.1-11光敏电阻小柱成品.jpg
