huankechong/smart-greenhouse/outputs/素材/素材整理_2026-11-12/S3-11.3-小程序面板.png

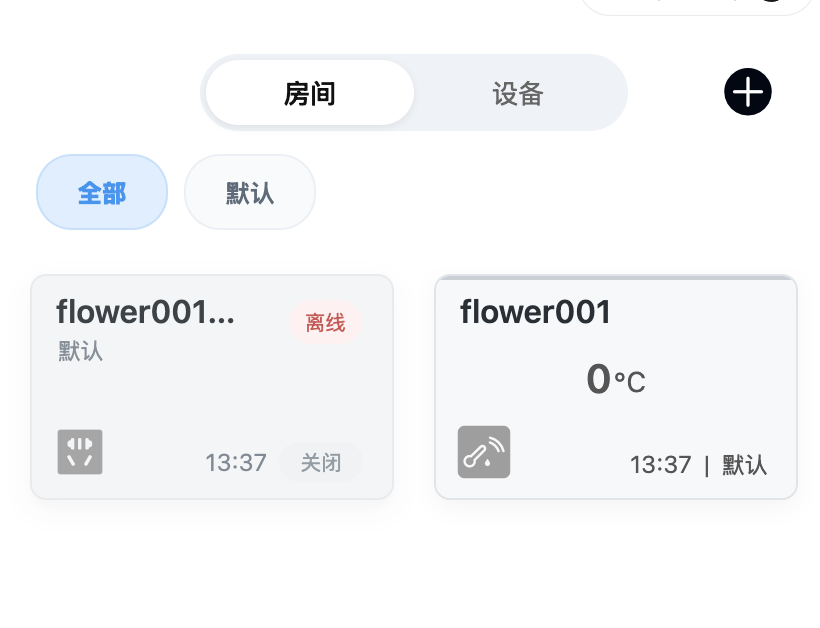
outputs/素材/素材整理_2026-11-12/S3-11.3-小程序面板.png
