huankechong/smart-greenhouse/outputs/素材/素材整理_2026-11-13/S2-13.1-04OLED45度支架成品.jpg

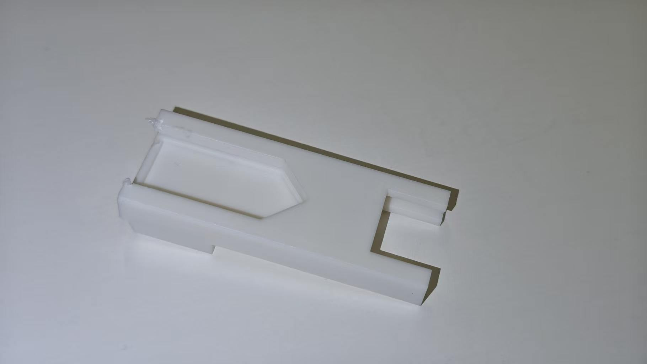
outputs/素材/素材整理_2026-11-13/S2-13.1-04OLED45度支架成品.jpg
