huankechong/smart-greenhouse/outputs/素材/素材整理_2026-11-13/S2-13.1-06a底盘左片成品_俯视.jpg

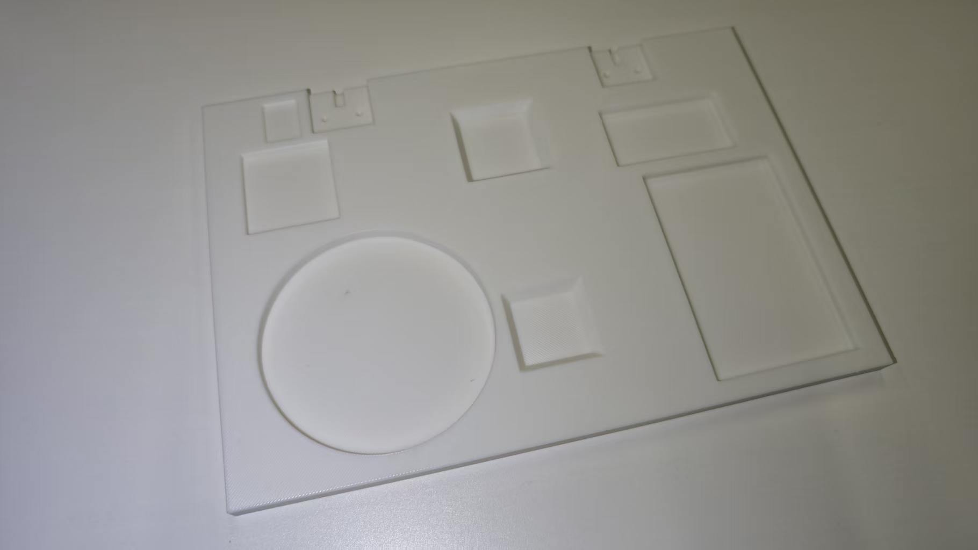
outputs/素材/素材整理_2026-11-13/S2-13.1-06a底盘左片成品_俯视.jpg
