huankechong/smart-greenhouse/outputs/素材/素材整理_2026-11-13/S2-13.1-07DHT11小座成品.jpg

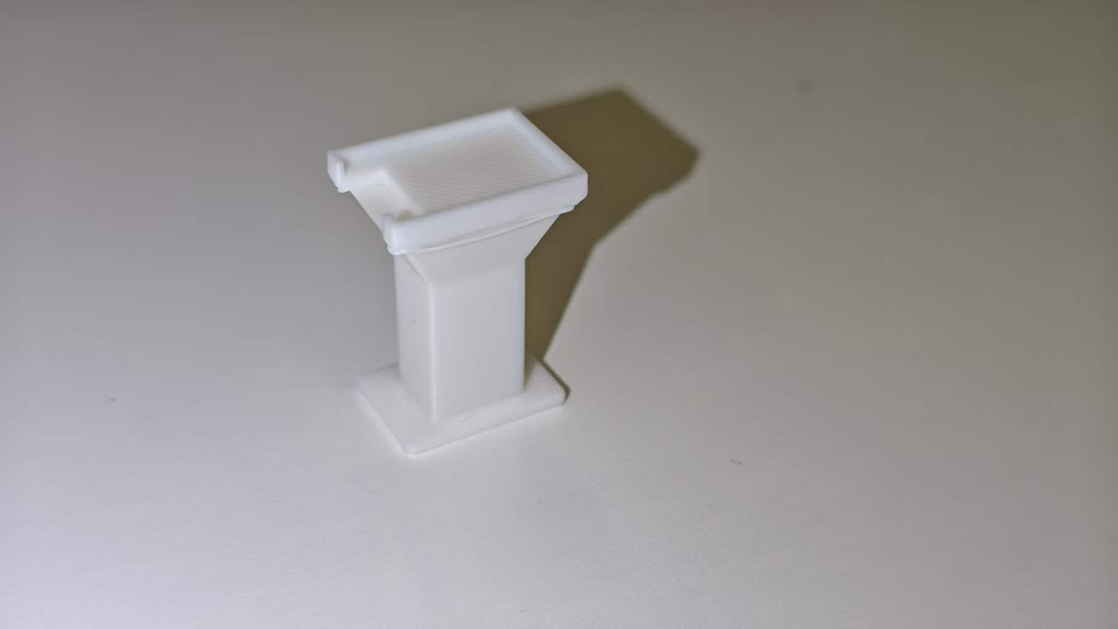
outputs/素材/素材整理_2026-11-13/S2-13.1-07DHT11小座成品.jpg
