huankechong/smart-greenhouse/outputs/素材/素材整理_2026-11-13/S2-13.1-11光敏电阻小柱成品_深色.jpg

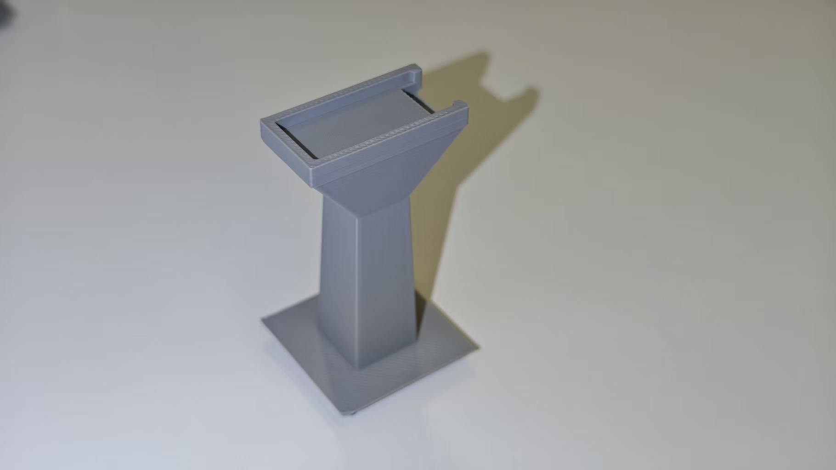
outputs/素材/素材整理_2026-11-13/S2-13.1-11光敏电阻小柱成品_深色.jpg
