huankechong/smart-greenhouse/docs/10月26日实验室操作清单.md

# 2026-10-26（周一）实验室操作清单

> 🧊 **2026-10-26 21:40 状态更新**：老师本周请假，**当天没上课、没去实验室，本清单全部任务未执行**。清单内容全部有效——**实验室恢复第一天照本清单原样执行**（顺序/验收/固件三连烧都不变）。打印提交（gcode 已切好）加在同一天上午。
> 🧊 答辩将顺延（大概率 +1 周），新日期未定；所有死线冻结待重排。

> **目标**：一天内完成 ① 继电器接入 ② 水泵联调 ③ 补做 W1 的 6 项传感器点亮 ④ 浮球极性  
> **预计**：3.5–4.5 小时（含接线试错）  
> **回宿舍后**：照第 6 节把主固件烧回去

---

## 一、带什么（3 组，按组清点）

### A. 向实验室借 / 领（**8 项，不用自己带**）

**A-1 套件内元件（41/32/16/25/13 号，实验室 A 套件，10/26 现场领）**

- [ ] **DHT11 温湿度**（41 号袋）
- [ ] **光敏电阻传感器**（32 号袋）
- [ ] **继电器模块**（16 号袋）
- [ ] **OLED 128×64**（25 号袋）
- [ ] **双色 LED 模块**（13 号袋，板上自带限流电阻）

**A-2 通用器材**

- [ ] **面包板 ×2**
- [ ] **40P 杜邦线（公对母）+ 面包板线**
- [ ] **电烙铁 + 焊锡丝**（含架/海绵）← 清单第 7 项标「不确定」，借不到就走公头直插
- [ ] **万用表**（数字式，通断/电阻/直流 20V 档）← **务必借，浮球极性靠它**

> ⚠️ **现场先确认这 5 个套件元件齐不齐** —— 若缺 OLED，第 4 项任务跳过（10/28 D9 还有时间补）；  
> 若缺 DHT11/光敏，先做能做的，缺的记下来回宿舍告诉我，我调整后续排期。  
> 💡 套件元件是**借的，不是送的** → 用完清点还回，别装进自己袋子带走。

### B. 自己带（自购/私人物品，**只有这些**）

- [ ] **笔记本电脑 + 充电器**（自带电脑 = 编译环境全套就绪：arduino-cli/ESP32核心/4个库/COM6 已验证 —— **不依赖实验室电脑**）
- [ ] **ESP32 + USB 数据线**（数据线！不是充电线）
- [ ] **电容式土壤湿度传感器 v2.0 ×2**（1 备，**随附 1×3P 排针**）
- [ ] **浮球开关 P52**（测极性用）
- [ ] **水泵 3W ×2**（1 备）+ **硅胶管**（内 8.5 / 外 φ10）
- [ ] **1L 打包桶**（8.2 装水）
- [ ] **WAGO 221 ×4**（免焊备用）
- [ ] **硅胶线 红/黑 各 8m**（泵线延长，**裸线不是跳线**）
- [ ] **USB 延长线**（绿联 1m，**10/26 要剪它转接水泵**，见第 3 件）
- [ ] **绝缘胶带 1 卷**（包延长线剪断后的白绿数据线，防短路）
- [ ] **U 盘**（拷固件应急包 —— 自带电脑正常用不到，纯备份）
- [ ] **剪刀或指甲刀**（剥线用）

### C. 辅助（最容易忘，全部自己带）

- [ ] **纸巾/抹布**（8.2 要求"水路远离电路、桌面垫纸巾"）
- [ ] **手机**（要拍继电器吸合照片、出水视频 —— 这是验收素材）
- [ ] **纸笔或手机备忘录**（记"浇 N 秒 = 多少 ml"）
- [ ] **水** → 见下方「⚠️ 水的两个预案」

#### ⚠️ 泵的电源是什么（第 3 件的前置）

USB 泵要 **5V/1A 以上**的 USB 电源。三选一：

| 电源 | 说明 |
| --- | --- |
| **充电宝**（推荐）  | 有输出口就行；**注意带输出口的，不是只有输入口** |
| USB 充电头 + 排插 | 实验室通常有排插 |
| **电脑 USB 口** | ⚠️ **不推荐** —— 泵启动瞬间电流可能让 USB 口过流保护断开，且继电器接线错误时有烧口风险 |

> 没带充电宝就用实验室排插 + USB 充电头。

#### ⚠️ 水的两个预案

文档里没写 8.2 的水从哪来，按现场情况二选一：

| 情况 | 做法 |
| --- | --- |
| 实验室**有水龙头/饮水机** | 用 1L 桶接半桶即可（约 500ml 够测 5 次 10 秒）  |
| **没有水源** | 自带 **1 瓶 500ml–1.5L 矿泉水**（宿舍灌好带去） |

> ⚠️ **量筒必带**（2026-11-06 自购：25–250ml/分度 5ml）；矿泉水瓶仍带（当水源备用 + 量筒打碎时的备用量具）。

> 💡 8.2 用不了多少水：3W 泵浇 10 秒大约 200–300ml，**带 1L 绝对够**。

---

## 二、到实验室的顺序（别打乱）

### 第 1 件：先确认板子和工具能用（5 分钟）

1. ESP32 插电脑 → 看有没有新串口出来（设备管理器或 `arduino-cli board list`）
2. 万用表打到**通断档**，两支表笔碰一下 → **应该响**（证明表好用）
3. 电烙铁插上预热（如果借到了）

> 如果板子认不出来：换 USB 口/换数据线；实在不行先跳过烧录，做接线准备。

### 第 2 件：8.1 继电器接入（30 分钟）

**接线**（面包板）：

```
ESP32 GPIO26  →  继电器 IN
ESP32 3V3     →  继电器 VCC（多数模块 3.3V 可用；若模块标 5V 就接 5V/5V 脚）
ESP32 GND     →  继电器 GND
```

**烧测试固件**（不是主固件 —— 主固件没有手动触发入口；板子上现在已是这个固件，**可跳过烧录直接测**）：

```bash
arduino-cli upload -p <端口> --fqbn esp32:esp32:esp32 outputs/代码/花房代码/RelayPumpTest
```

**串口 115200，发指令测**：

```
h          → 看帮助
on         → 继电器应"咔"一声吸合，模块 LED 亮
t          → 看状态（应显示"吸合(泵转)"）
off        → "咔"一声断开
w 3        → 3 秒后自动断开（提前验证定时功能）
```

**验收**：

- [ ] 串口打 `on/off` 时能听到继电器"咔哒"
- [ ] 继电器模块上的指示灯同步亮灭
- [ ] 串口状态打印正确（吸合/断开 + 累计时长）
- [ ] **拍照**（素材 W2-8.1）

> ⚠️ 如果 `on` 没反应但串口正常 → 先改 `RELAY_ACTIVE_HIGH` 为 0 重烧（极性反了）。

### 第 3 件：8.2 水泵联调（45 分钟）

**接线**（⚠️ 水路远离电路！桌面垫纸巾）

> 🔧 **原理**：继电器是个「电控开关」，**只串在水泵电源的正极回路上**；  
> 水泵另一根线直连电源负极、**不经过继电器**。  
> 不是"两根线各接一个脚"，而是**串在正极中间**。

**接线图**

```
     USB 5V 电源
      │        │
   正极(红)  负极(黑)
      │       │
  ┌───┴───┐    │
  │ 继电器 │   │
  │ COM NO│   │
  └─┬───┬─┘    │
    │   └──────┼──→ 水泵红线
    └──────────┼──→ （COM ← 电源正极）
              └──→ 水泵黑线（直连负极）
```

**3 步接法**

| 步 | 动作 |
| ----- | --- |
| **1** | **USB 5V 正极** → 继电器 **COM** |
| **2** | 继电器 **NO** → **水泵红线** |
| **3** | **水泵黑线** → **USB 5V 负极（GND）** ← **直连，不过继电器** |

- 继电器吸合 → COM 与 NO 接通 → 正极通到水泵 → **泵转**
- 继电器断开 → COM/NO 断开 → 水泵断电 → **泵停**

**用 USB 延长线接（**&#x4E0D;剪水&#x6CF5;**）**

清单里有 **绿联 USB2.0 延长线 1m（A 公 - A 母，¥13.91 已到货）** —— 它是最省事的转接件：

> **核心思路：剪【延长线】，不剪【水泵】。**  
> 水泵原装线保持完整（保保修、不缩短）；延长线是消耗品，剪了就剪了。

**做法（4 步）**

| 步 | 动作 |
| ----- | --- |
| **1** | **从中间剪断 USB 延长线**（不要剪两端插头），得两段：**A 公侧**（插电源那头）和 **A 母侧**（插水泵那头） |
| **2** | 两段各剥出**红 / 黑**（**白、绿是数据线，不接** → 用绝缘胶带包住，防碰到红黑短路） |
| **3** | **A 公侧的红** → 继电器 **COM**；**继电器 NO** → **A 母侧的红**（裸线直接压进模块的螺丝端子） |
| **4** | **A 公侧的黑 ↔ A 母侧的黑** 直连（用 **1 个 WAGO 221** 对接；没有 WAGO 就剪一段短铜线绞接 + 胶带） |

**接完的样子**

```
 [充电宝/5V适配器]
        │ USB-A 公
 ┌──────┴──────┐
 │ 延长线 A 公侧 │
 └──┬───────┬──┘
   红R1     黑B1
    │        │
 [继电器]     │
 COM   NO     │
  │     │     │
  │     └─────┼──→ 红R2 ─┐
  │           │          │
  └───────────┼──────────┘（R1 接 COM，NO 接 R2）
              │
           WAGO 对接 B1↔B2
              │
 ┌────────────┴─┐
 │ 延长线 A 母侧 │
 └──────┬───────┘
        │ USB-A 母
      [水泵 USB 公头]
```

**WAGO 只用到 1 个**（黑线对接）；两根红线直接压进继电器的 COM / NO 螺丝端子。

**为什么不用剪水泵线（这条路废弃）**

| 方案 | 后果 |
| --- | --- |
| ~~剪水泵 USB 头~~ | 水泵线变短、失去保修、剪坏就没了（泵是贵的那件） |
| **剪延长线（推荐）**  | 泵无损；延长线 ¥13.91 剪了不心疼；两端还各带标准 USB 头，插电源/水泵都是即插 |

> 💡 剥线没专用钳就用剪刀**转圈划外皮**再拉掉，别一刀切到底（会切断铜丝）。剥 8–10mm 够。

**⚠️ 发 `on` 但继电器不吸合 —— 按这两条查**

| 现象 | 原因 | 处理 |
| --- | --- | --- |
| 串口打"吸合"，但模块没"咔哒"、灯不亮 | **模块 VCC 供电不足**：多数模块要 **5V**，接 3V3 带不动 | 模块 VCC 改接 ESP32 的 **5V / VIN 脚**（USB 供电时该脚有 5V） |
| VCC 已 5V 仍不吸合 | **3.3V 逻辑触发不了 5V 模块**（高电平阈值不够） | ① 把 `RELAY_ACTIVE_HIGH` 改 **0** 重烧试低电平触发 ② 换 3.3V 兼容模块 |

> 📌 模块 VCC 接 5V 时，**IN 仍接 GPIO26（3.3V）**，绝不能把 5V 灌进 GPIO。

**测试**：

1. 水泵进水口浸在 1L 桶（半桶水），**出水管对准量筒口**
2. **首次发 `w 5`**（防超 250ml 量程）→ 记读数；后续按 ml/s 推算安全时长再测 `w 10`
3. 量出水量、记下来
4. 重复 3 次（10 秒 / 5 秒 / 3 秒），填下面记录表

**量出水量用什么（2026-11-06 更新：已自购量筒）**：

- **量筒**：最小刻度 25ml / 最大 250ml / 分度值 5ml —— 直接读数，误差 ±2.5ml，**比目测瓶线法（±15%）准一个量级**
- 用法：泵出水管对准量筒口 → 发 `w 10` → **等液面静置 2 秒再读**（贴壁挂珠会让读数偏高 1–2ml）
- ⚠️ **250ml 上限注意**：3W 泵典型 20–40 ml/s → `w 10` 可能出 300–400ml **超量筒容量**
  → **首次测试用 `w 5`**（约 100–200ml，稳在量程内），算出 ml/s 后再推算 `w 10` 的量
- 记录表建议加一列「实测秒数对应的 ml」，现场直接算 ml/s

> 💡 矿泉水瓶画线法降为备用（量筒打碎/忘带时）。

**记录表**（填完拍照留档）：

| 次数 | 吸合时长 | 出水量 (ml) | 折算 ml/s | 备注 |
| -- | --- | --- | --- | -- |
| 1  | **5 s**（首测防溢） | | | |
| 2  | 5 s | | | |
| 3  | 3 s | | | |
| 4  | 10 s（重复验） | | | |

**算一个关键数**：`ml/s` 的平均值 → 后面固件里 `WATER_MS = 3000` 就是靠它折算"浇 3 秒出多少水"，答辩要讲。

**验收**：

- [ ] 泵能起停，无异响
- [ ] 出水正常（不是滴）
- [ ] 停水后管路不滴漏
- [ ] **拍出水视频**（素材 W2-8.2）

### 第 4 件：6 项传感器逐个点亮（1.5–2 小时，**从没做过实机**）

> ⚠️ 这一步是 W1 的欠账（之前没杜邦线做不了）。**每一项都要单独验证**，不要一次全接。

| # | 传感器 | 怎么接 | 怎么验 | 通过标准 |
| - | --- | --- | --- | --- |
| 1 | **DHT11**  | DATA→GPIO33，VCC→3V3，GND→GND | **烧传感器版固件**（EN_DHT=1+EN_OLED=1，见下方「固件三连烧」） | 串口出现 `温度=xx.xC 气湿=xx%`，读数合理（室温 25–32℃） |
| 2 | **光敏电阻** | AO→GPIO35，VCC→3V3，GND→GND | 主固件默认就读 | `光照raw=xxx`；**手遮住读数明显变小** |
| 3 | **土壤传感器**  | AO→GPIO34，VCC→3V3，GND→GND | 主固件默认就读 | `土壤raw=xxxx`；**插土里 raw 变小、空气里 raw 变大** |
| 4 | **OLED** | SDA→GPIO21，SCL→GPIO22，VCC→3V3，GND→GND | 传感器版固件（同上，**注意 I2C 地址可能是 0x3C/0x3C 两款，代码默认 0x3C**；不亮先查接线再查地址） | 屏幕显示 4 行中文（土壤/光照/温度/气湿） |
| 5 | **双色 LED** | 红→GPIO25，绿→GPIO27（或按模块丝印） | 主固件默认驱动 | 土壤湿→**绿灯亮**；土壤干→**红灯亮** |
| 6 | **继电器** | 见第 2 件 | 测试固件 | 已验 |

**每项通过后：手机拍一张串口截图或屏幕照片**（实验报告素材，W1 系列要求 ≥8 张）。

> 💡 **土壤传感器要先焊排针**（如果借到烙铁）。焊接顺序 **GND→OUT→5V**，每点 2–3 秒，焊完用万用表通断档验：GND↔OUT 响、GND↔5V 响、**OUT↔5V 不响**（响就短路了）。

### 第 5 件：浮球开关极性（10 分钟，趁万用表在手）

1. 万用表打**蜂鸣档**（两表笔碰一下确认响）
2. 两表笔分别接浮球**两根引出线**
3. **竖直拿，杆尖朝下**（= 装进桶里的姿态，浮子滑到杆尖 = 模拟"没水"）→ 记「响/不响」
4. **倒过来，杆尖朝上**（浮子滑到另一端 = 模拟"有水"）→ 记「响/不响」

**判断**：

| 杆尖朝下（没水） | 杆尖朝上（有水） | 结论 | 参数 |
| --- | --- | --- | --- |
| 不响 | **响** | 有水闭合（常开型） | `LEVEL_WET_CLOSED = true` ← **当前默认，不用改** |
| **响** | 不响 | 没水闭合（常闭型） | 改成 `false` |
| 都响 / 都不响 | | 开关坏了 | 换一个 |

> 浮子有时候要推到**端点**才动作，拿在手里不响就用手指把浮子硬推到杆的最顶端再试。

---

## 三、做不完怎么办（优先级）

如果实验室只开半天，**按这个顺序做，到点就收**：

1. **8.1 继电器 + 8.2 水泵** ← 必做（有明确验收 + 阻塞 W2）
2. **DHT11 + 光照 + 土壤 + LED** ← 强建议（W1 欠账，且没做过实机）
3. 浮球极性 ← 顺手，有万用表就做
4. **OLED** ← 可以先跳过（10/28 D9 还有时间）
5. 土壤焊接 + 标定 ← 没烙铁/没土就留到 D9

---

## 三·五、固件切换总览（10/26 当天要烧 3 次固件，别烧错）

| 时机 | 烧什么 | 来源 |
| --- | --- | --- |
| 到场 | **继电器泵测试版**（板子上已是，可跳过） | `outputs/代码/花房代码/RelayPumpTest/` |
| 第 4 件（传感器点亮） | **传感器版**（EN_DHT=1 + EN_OLED=1） | 应急包 `1_传感器版_DHT_OLED/`，或临时改主固件两个开关重编译 |
| **收尾（必做）** | **主固件 v1.6**（全 0） | `outputs/代码/花房代码/GreenHouse_v1/` |

> 💻 **自带笔记本 = 首选路径**（环境全套就绪，COM6 已验证；注意 USB 口插的位置不同串口号可能变，用 `arduino-cli board list` 现查）。  
> 🆘 备份路径：笔记本万一出问题，用 U 盘里的**固件应急包**（`outputs/代码/固件应急包_2026-10-25/`）——  
> 三个 .bin 都编译好了，在任何 Windows 电脑上用 flash_download_tool（免安装）选 bin、地址 **0x10000** 直接刷。详见包内 README。

---

## 四、收尾（离实验室前）

- [ ] **把主固件烧回板子**（别把测试固件留在板上！）
  ```bash
  arduino-cli upload -p <端口> --fqbn esp32:esp32:esp32 outputs/代码/花房代码/GreenHouse_v1
  ```
- [ ] 串口确认打的是 `v1.6 启动` + `dry=3200 wet=1300`（不是 `RelayPumpTest`）
- [ ] 主固件状态下再插一次各传感器，`[数据]` 行读数正常（没带走的传感器跳过）
- [ ] **桌面擦干、地面检查有没有滴水**（8.2 用过水）
- [ ] 所有借的器材清点还回（面包板/杜邦线/继电器/电烙铁/万用表）
- [ ] 传感器装回袋子，别压坏
- [ ] 照片/视频传到手机
- [ ] 出水量记录表拍照

---

## 五、测试固件指令速查（抄在手边）

| 指令 | 作用 |
| --- | --- |
| `h` | 显示帮助 |
| `on` | 继电器吸合（泵转） |
| `off`  | 继电器断开（泵停） |
| `w 10` | 吸合 10 秒后自动断开（**8.2 用这个**） |
| `auto` | 自动循环：吸合 3 秒 / 停 10 秒 |
| `stop` | 退出自动 + 断开 |
| `t` | 看当前状态与累计吸合时长 |

> 安全上限：单次吸合最长 **120 秒**（超过自动按 120 秒执行，防止误输入 `w 999` 把泵干烧）。

> ✅ **本固件已于 2026-10-25 22:55 实机验证通过**（COM6，ESP32 DevKit）：  
> `on`/`off`/`t` 正常 · `w 3` **精确 3.0 秒断开** · `auto` 进入即吸合、3.0 秒后断、循环正确 ·  
> `w 999` 被正确限到 **120 秒上限** · 非法输入 `w abc`/`w 0`/`xyz` 均正确报错。  
> 编译占用 268,173 B (20%) / RAM 21,424 B (6%)。

---

## 六、回宿舍后要补的记录

1. 出水量数据 → 回填到 `docs/花房接线规划表.md` 或直接告诉我，我更新固件的 `WATER_MS` 说明
2. 浮球极性结论 → 若需要改 `LEVEL_WET_CLOSED`，告诉我，我改固件重编译
3. 传感器点亮的照片/截图 → 存 `outputs/素材备份_日期/`（**微信 temp 会清，必须备份**）
4. 任何接线踩的坑 → 告诉我，我记进文档（下次不重踩）
