huankechong/smart-greenhouse/docs/花房借用与自购清单.md

# 智能花房 · 借用 / 自购清单

> 🔄 **2026-11-06 收口**：**实验室器材已全部借到**（套件元件 5 项：DHT11(41)/光敏(32)/继电器(16)/OLED(25)/双色LED(13) + 面包板×2 + 40P 杜邦线 + 面包板线 + 万用表；电烙铁是否借到 D0 现场核对，借不到走 WAGO 免焊）。下文"⏳ 10/26 可借到""待翻找"等日期口径均为历史记录，状态以本注为准。
> 依据：实验室创乐博 Arduino UNO R4 B 套餐（48 件）对照方案书逐项核对 · 2026-10-17
> **更新（2026-10-19 晚·AR07）**：①ESP32 维持自购（10/17 已下单在途）；②雨滴探测模块取消借用（可选加分项取消），**水位检测改自购 P52 浮球开关 + 1L 打包桶水箱（✅ 已下单）**；③新增借用：电烙铁（焊枪）+ 焊锡丝；④~~220Ω 电阻~~、~~硅胶垫片~~ 经领导确认**不再购买**（2026-10-19 22:40）。
> **更新（2026-10-20 23:50）**：⑤确认**学校有杜邦线 + 面包板，可借** → 第 6 项落实，**无需购买**；⑥电烙铁（第 7 项）**降级为可选** —— 土壤模块用**杜邦线公头直插焊孔**即可免焊接（孔径 1.0–1.2mm，公头方针 0.64mm 可直插），烙铁只在做永久连接时才需要。
> **更新（2026-10-21 01:17）**：⑦**领导定案：改回焊接排针方案，等实验室电烙铁** —— 买土壤传感器时**随附了排针**（1×3P 单排针），所以只缺烙铁、不缺排针，第 7 项由"可选"**改回必需**；免焊路线（公头直插/硬芯线）**已放弃**，仅留作烙铁借不到时的备选。焊接/免焊完整流程见 **`docs/硬件操作手册_点火接线标定.md`**（2026-11-06 由焊接操作卡+无烙铁方案+点火指南三份合并而成）。
> **更新（2026-10-23 晚·到货核对）**：⑧**实验室 A 套件元件包到货**（创乐博原厂包装，批次 689711，产地日期 2026-10-20）。实拍 OCR 核对结果见下方「一.5 到货实拍核对」。**注意：套件里没有电烙铁** —— 第 7 项仍需单独借。
> **更新（2026-10-23 19:31）**：⑩**继电器模块（16 号）确认 10/26（周一）可从实验室借到** —— 与 30 天计划 W2-D8「8.1 继电器接入」**原定同一天，零延误**；D7（10/25）全是纯软件不受影响。**⚠️ 但真正的关键路径是「标定」不是继电器** —— 9.3 里程碑（第一次全自动浇水）要求 `EN_WATER=1`，而它要求标定先完成（常量回填实测值）。**标定卡在烙铁（10/26 能否一并借到？）**；若借不到，**WAGO 免焊方案（方案 B）现已有实物可走**（见 `docs/硬件操作手册_点火接线标定.md` §三）。
> **更正（2026-10-23 19:05）**：⑨ 照片中 4 颗透明壳器件**初版误判为「继电器插座底座」** —— 领导指正 + WAGO 官方规格 7 项逐条对上，**实为万可 WAGO 221 快接端子**（即 2.2 表中 10/19 自购的泵回路三通端子，已到货 4 只）。继电器模块是否在套件内**仍待翻找**。详见 `docs/审计报告/AR14_GreenHouse硬件到货实拍核对_2026-10-23.md` §三/§七。

## 一、找实验室借（0 元，登记领用、期末归还）

> 📌 **来源三分（2026-10-25 领导澄清）**：
> - **① 实验室 A 套件（41/32/16/25/13 号）** = **向实验室借/领**，10/26 现场拿，**不是自购、也不会发到个人手上**；用完清点还回
> - **② 通用器材（第 6/7/8 项：面包板/杜邦线/电烙铁/万用表）** = 向实验室借
> - **③ 自购（土壤传感器/浮球/水泵/硅胶管/桶/WAGO/硅胶线/ESP32）** = 自己的，带去

| # | 件号 | 名称 | 数量 | 项目用途 |
|---|---|---|---|---|
| 1 | 41 | 温湿度传感器 | 1 | 空气温湿度感知 · **实验室 A 套件，10/26 现场领**（不是自购） |
| 2 | 32 | 光敏电阻传感器 | 1 | 光照感知 · **实验室 A 套件，10/26 现场领** |
| 3 | 16 | 继电器模块 | 1 | 控制水泵开关 ⏳ **10/26（周一）可借到** —— 与 W2-D8 原计划同一天，零延误 |
| 4 | 25 | OLED 显示屏 | 1 | 本地数据显示（现场脱机演示）· **实验室 A 套件，10/26 现场领** |
| 5 | 13 | 双色 LED 模块 | 1 | 状态灯：绿=正常 / 红=缺水 · **实验室 A 套件，10/26 现场领** |
| 6 | 8 + 9 + 10 | 面包板×2 + 40P 杜邦线 + 面包板线 | 各1 | 电路连接 ✅ **学校有，已确认可借（10/20）** |
| 7 | — | **电烙铁（焊枪）+ 焊锡丝**（含烙铁架、海绵） | 1 套 | ⏳ **10/26 能否一并借到「不确定」（10/23 19:44 领导告知）**。⚠️ **不确定也不阻塞 10/26 标定** —— 公对母线公头直插（档 A）零工具即可；借到烙铁则改走焊排针（档 B，更永久）|
| 8 | — | **万用表（数字式）** | 1 台 | 整机调试测电压/电阻（直流 0–20V、通断档、电阻档即可；用毕即还）**焊完三个焊点后量通断验证，建议一并借** |

> 📌 **借料提示（10/21 更新）**：
> - **排针不用买** —— 买土壤传感器时随附 1×3P 单排针，只要把排针焊到 PCB 的三个焊孔上。
> - **杜邦线公母要分清** —— 焊完排针后传感器是标准排针，用**母对母**那一半接线（套件第 9 项是「40 公对母」，一包公母各半）。
> - 焊接顺序 **GND → OUT → 5V**，每点 2–3 秒，锡铺成小锥形不堆球；焊完用万用表通断档验证。
> - 完整流程见 **`docs/硬件操作手册_点火接线标定.md`**。

**借用注意**：①先问老师能否带出实验室（决定能否回宿舍开发）②每次用完清点归盒（收纳规整度纳入评估）③焊接在指定工位进行、离位断电、用毕清理焊渣 ④期末全部归还。

### 一.5 到货实拍核对（2026-10-23，RapidOCR 读标签，非猜测）

实验室 A 套件元件包到货，全部为**创乐博原厂包装**（批次 689711 / 单据号 YT7650850889287 / 产地日期 2026-10-20）。逐袋 OCR 结果：

| 照片 | 标签编号 | 内容（OCR 原文） | 数量 | 对应项目 |
|---|---|---|---|---|
| 元件袋 | **G-13-13-3** | 「黑色耐高温硅胶线 22AWG 8米 1卷」 | 1 卷 | 泵线/信号线 ✅ |
| 元件袋 | **G-13-13-5** | 「红色耐高温硅胶线 22AWG 8米 1卷」 | 1 卷 | 泵线正极 ✅ |
| 元件袋 | **G-12-1-3** | 「配包129 #直插 …8种共100只」 | 1 包 | 直插元件补包 |
| 元件袋 | **A-4-2-1** | 「配包101 #1/4W金属膜 1% 30种每种10」 | 1 包 | **1/4W 金属膜电阻 30 种 ×10** ✅（比清单里的 1kΩ×5 划算） |
| 元件袋 | 表格标签 | 电阻值表：120/150/200/220/240/270/300/330/390/470/510/560/620/680/750/820/1K/2K/5K/10K/100K | — | ✅ 电阻种类比清单更全 |
| 元件袋 | 瓷片电容包 | 「配包135 瓷片电容包」 | 1 包 | ✅ 104/其他容值 |
| 元件袋 | 圆罐 ×2 | 银色金属圆罐 | 2 个 | 无源蜂鸣器（引脚可见） |
| 元件袋 | 红色件 | 红色贴片/轴向元件袋 | 1 袋 | LED / 二极管类 |
| 独立小盒 | — | 蓝色 PCB 小模块 + 排针 | 若干 | 待单独核对型号 |
| 电阻包 | 白色表格标签 | 「装片电阻表」：120/150/200/220/240/270/300/330/390/470/510/560/620/680/750/820/1K/2K/5K/10K/100K | 1 盒 | ✅ 轴向金属膜电阻 |

**另三件单独确认**：

| 实物 | 判定依据（实拍） | 对应清单 |
|---|---|---|
| **P52 浮球开关 ×1**（+ 备用 ×1 装袋） | 白色圆柱探头 + M10 螺纹 + 红色垫圈 + **黄色引出线**（末端裸线头） | ✅ 10/19 自购，**已到货** |
| **USB 延长线**（绿联 USB2.0 标准款，A公-A母，1m） | 包装印「USB 延长线 / 绿联 USB2.0 标准款 / 数据传输」 | ✅ 10/19 自购，**已到货** |
| **万可 WAGO 221 快接端子 ×4** | 透明壳 + 橙色拨杆，标签 `AWG 24-12` / `0.14/0.2-4` / `450V 32A` / `SET 20A` + UL 标志 | ✅ **已到货**（见下方确认节） |

### ✅ 万可 WAGO 221 快接端子到货确认（初版误判为继电器，已更正）

**2026-10-23 19:05 领导指正 + WAGO 官方规格查证** —— 这 4 颗是**万可（WAGO）221 系列快接端子**，不是继电器、也不是继电器插座底座。

标签 OCR 所得与 WAGO 221-413 官方规格（wago.com）**逐条对上**：

| 标签 OCR | WAGO 官方规格 | 判定 |
|---|---|---|
| `AWG 24-12` | 24–12 AWG | ✅ |
| `0.14/0.2-4` | 细线 0.14–4 / 硬线 0.2–4 mm² | ✅ |
| `450V/32A` | 450 V / 32 A（IEC） | ✅ |
| `SET 20A` | UL 486C 认证 20 A / 600 V | ✅ |
| `Cu 1.6/2` | 镀锡铜导电条 | ✅ |
| 透明壳 + 橙色拨杆 | housing transparent / actuator orange | ✅ |
| UL 标志 | UL 486C Approvals | ✅ |

**项目用途（与 10/19 自购单对上了）**：型号 **221-413**（3 线位 / 一进二出 / 三通节点），450V/32A，剥线 11mm —— 就是清单 2.2 里为**泵回路两个三通节点**买的那个。**到货 4 只（计划 2 只），超量。**

> 📌 **连带两个好处**：
> ① **泵回路接线端子实物在手** —— +5V 汇流、GND 汇流两个节点够用。
> ② **免焊方案 B 立刻可行** —— `docs/硬件操作手册_点火接线标定.md` §三（硬芯线 + WAGO 221）原本依赖"待到货"，现在端子在手。**万一电烙铁借不到，这条路马上能走。**

> ✅ **继电器模块的问题已闭合（19:31）**：**第 16 项继电器模块 10/26（周一）可从实验室借到** —— 与 W2-D8 原计划同一天，**零延误，主程序 `EN_WATER` 逻辑不用改**。
> 因此**「买光耦隔离 MOS 管模块 3–5 元」的建议作废** —— 不必再花这个钱。

> ⚠️ **仍然缺**：**电烙铁 + 焊锡丝**（第 7 项，套件不含）+ **万用表**（第 8 项，建议借）。
> 焊锡丝 10/19 曾列入"电子耗材"素材但**清单里没有这一笔** —— 现在要么借用，要么自购 8–15 元。

## 二、自己买

### 2.1 必买（尚未下单）

| # | 部件 | 规格 | 数量 | 预算 |
|---|---|---|---|---|
| 1 | **小花盆 + 绿植** | **8×8×8 直筒树脂盆**（外径 φ80 × 高 80，壁厚约 3）—— 底盘槽已按此改 | 1 套 | 10–20 元 |

> 唯一剩余项，W2 联调前线下买（自动浇水测试需要真实土壤）。答辩展示植株可答辩前一周再换更好的。

#### 🌸 花盆规格：8×8×8 直筒树脂盆（2026-10-23 定案，模型已按此改好）

领导实拍确认用 **8×8×8 直筒树脂盆**（外径 φ80 × 高 80，壁厚约 3mm）。
原底盘 φ62 的凹槽装不下（底径 80 > 62），**已改模型适配**，不需要改买什么。

**模型侧改动（4 个脚本）**：

| 文件 | 参数 | 原值 | 新值 | 原因 |
|---|---|---|---|---|
| `base_2pc_models.py` | `pot_d` | 62 | **82** | 容 φ80 盆 + 2mm 径向余量 |
| `base_2pc_models.py` | `pot_pos` | (-105, 60) | **(-111, 60)** | φ82 槽右缘 −70，与继电器槽(−62)留 **8mm**；原位置只剩 2mm 太薄 |
| `p0b_sensor_hook.py` | `taper` | 8.1 | **0** | 直筒盆锥度 0 → 爪垂直下探，**永不咬进盆壁** |
| `p0b_sensor_hook.py` | `rim_gap` | 5.6 | **4.6** | 夹口 = 壁厚 3 + 1.6 余量 |
| `p0b_sensor_hook.py` | `wall_mid_y` | −0.5 | **0** | 直筒盆壁中线即局部原点 |
| `p0_models.py`（03 管夹） | `taper` / `rim_gap` | 8.5 / 6.2 | **0 / 4.6** | 同上，管夹也夹盆沿 |
| `build_assembly.py` | 盆几何 | 底φ29→口φ41×高85 | **φ80 恒定 × 高 80** | 装配示意同步 |

**买盆时注意（唯一还需要的确认）**：
- **壁厚 ≤ 4.6mm** —— 太厚夹不进（挂钩 01b 与管夹 03 都靠这个尺寸）
- 若是**方形**盆（8×8×8 长方体）而非圆盆，圆形 φ82 槽装不下（对角 113 > 82），需改成方形槽 → 告诉我我再来一轮

**搜索词**：`树脂花盆 8cm 直筒 圆` · 绿植选**绿萝/吊兰**（耐折腾）

> 📌 **直筒盆反而是最优解**：锥度 0，挂钩双爪往下探时只会**离开**盆壁，永远不会咬进去 —— 这正是原锥形盆方案的老毛病（AR05 踩过：花盆×夹 12.3mm³）。

### 2.2 已买（按订单）+ 到货状态

| 下单日 | 部件 | 规格 / 说明 | 实际价 | 到货 |
|---|---|---|---|---|
| 10/17 | ESP32 开发板 | CH340，DevKitC 规格，主用板 | ¥14.17 | ✅ **10/20 已到**（COM6 实测通） |
| 10/17 | 电容式土壤湿度传感器 | v2.0 ×2（1 备），**随附 1×3P 排针** | 5–8 元 | ✅ **10/20 已到** |
| 10/17 | USB 微型水泵 + 硅胶管 | 3W 底吸泵 ×2（1 备），实测 41×39×30 | 10–15 元 | ⏳ 待确认 |
| 10/19 | **P52 浮球开关 + 1L 打包桶** | M10/常开/0~110V ×2；桶 ×5（满口 1.2L） | ≈28 元 | ✅ **10/23 实拍确认到货**（白色圆柱探头 + M10 螺纹 + 红垫圈 + 黄线） |
| 10/19 | **1kΩ 电阻 + 100nF 电容** | 1/4W ×5 + 104/50V ×5 | 1–8 元 | ✅ **10/23 到货**（套件 A-4-2-1 电阻包 + 瓷片电容包，规格更全） |
| 10/19 | **22AWG 硅胶线** | 40×0.08 ≈0.2mm²，硅橡胶 200℃，红/黑各 1 卷 | ≈17.2 元 | ✅ **10/23 到货**（G-13-13-3 黑 / G-13-13-5 红，各 8 米） |
| 10/19 | **1N4007 二极管** | 1A/1000V，DO-41，5 只（泵续流） | 1–2 元 | ✅ **10/23 到货**（套件红色元件袋内） |
| 10/19 | **USB 延长线** | 绿联 USB2.0 标准款 1m（A 公-A 母） | ¥13.91 | ✅ **10/23 实拍确认到货** |
| 10/19 | **M3×6 沉头自攻 + PH1** | 一包 50–100 颗 + 螺丝刀（底盘连接块） | ≈5 元 | ⏳ 螺丝待确认；**10/23 到货一套 TZ234 304 防松螺母 + 垫圈 + 黑色尼龙件（螺母系列DIY套装，深圳佰瑞特，日期 2026-08-05）** |
| 10/19 | **万可 WAGO 221 快接端子** | 杠杆式 0.14–4mm²，32A/450V；泵回路三通节点（412 二线位 / 413 三线位） | ¥2–5/个 | ✅ **10/23 实拍确认到货 4 只**（透明壳+橙色拨杆，标签 AWG 24-12 / 450V 32A + UL） |

**已花约 97–116 元**（按本表 2.2 逐项加总；WAGO 按 1 个计，买 2 个则 +2–5 元）。预算上限 150 元，**余量 34–53 元**；**加上待买花盆绿植 10–20 元 → 合计约 107–136 元，余量 14–43 元**。

> 📌 **10/23 到货小结**：实验室 A 套件元件包 + 自购的浮球开关/硅胶线/电阻电容/二极管/USB 线**基本齐了**，
> 外加**万可 WAGO 221 快接端子 ×4（450V/32A，UL 认证）** —— 即 10/19 自购的泵回路三通端子，**接线端子已齐**。
> **唯一还缺的关键件是电烙铁 + 焊锡丝**（套件不含），以及 **万用表**（建议借）。

### 2.3 不买（已确认豁免）

| 部件 | 豁免理由 |
|---|---|
| ~~220Ω 电阻 ×5~~ | 13 号双色 LED 是**模块**，板上自带限流电阻 |
| ~~硅胶垫片~~ | 替换盖裙边（径向隙 0.8）已把桶定位住，不需要垫 |
| ~~MF-R110 自恢复保险 ×2~~ | 正规 5V/2A 充电头自带过流保护 + 固件"连浇 6 轮上限/冷却 10min"兜底；**换杂牌电源或充电宝时再补** |

## 三、不用花钱的

| 资源 | 用途 |
|---|---|
| 实验室拓竹 X2D 3D 打印机 + PLA 耗材 | 打印外壳（预约使用） |
| 巴法云 IoT 平台（bemfa.com） | 数据上云 + 微信小程序控制，免费 |
| Fritzing（免费软件） | 画电路图，报告配图 |
| Arduino IDE + 巴法云小程序 | 开发环境与手机端，免费 |
