huankechong/smart-greenhouse/docs/操作手册/接线图导出/花房接线图_整机总图_接线图_附清单.png

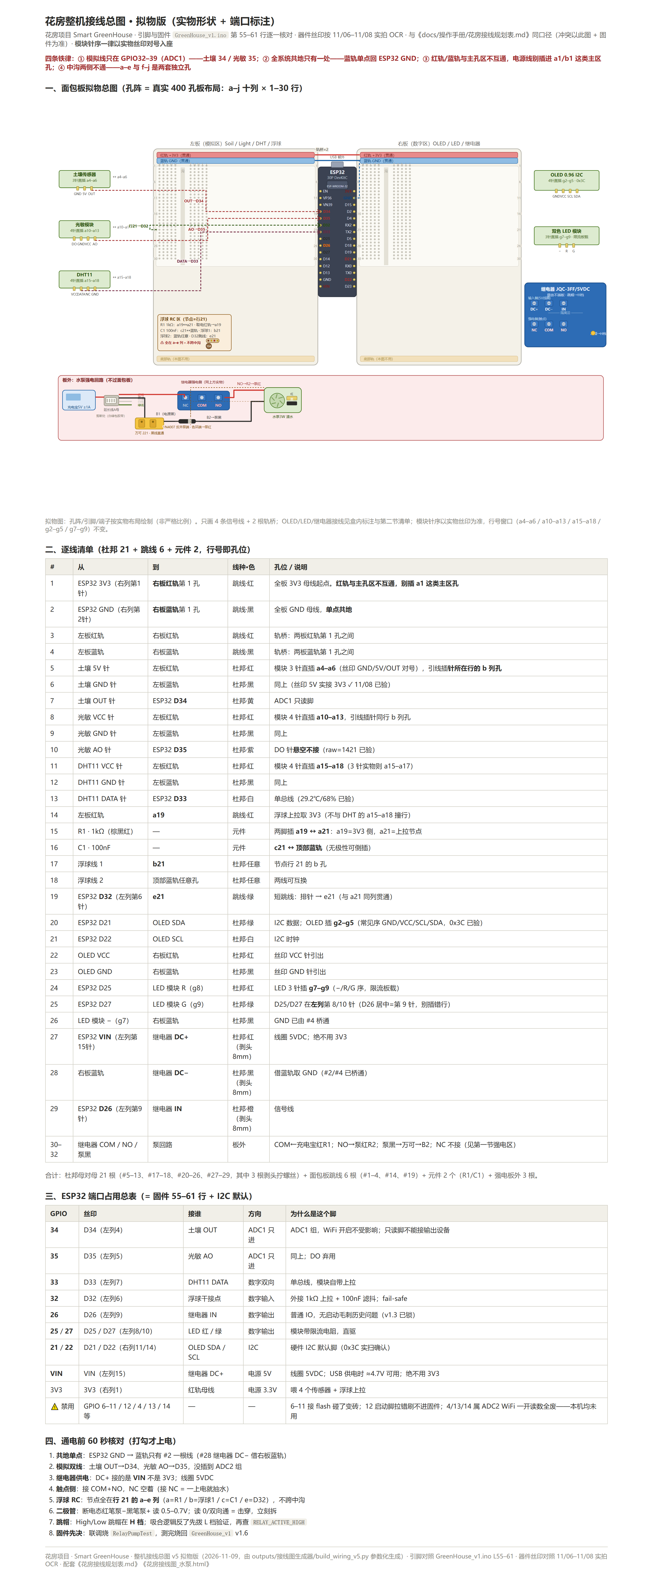
docs/操作手册/接线图导出/花房接线图_整机总图_接线图_附清单.png
