huankechong/smart-greenhouse/outputs/3D打印件/花房3D_P0/STL/03_tube_clip_v1.stl

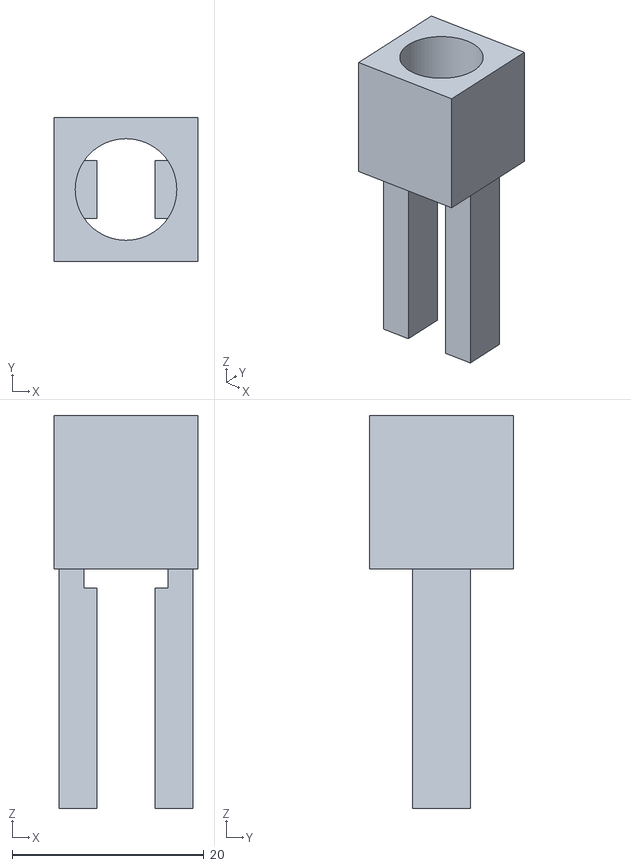
[picture p54: CAD file, 2026-11-10]
outputs/3D打印件/花房3D_P0/STL/03_tube_clip_v1.stl
15.0 x 15.0 x 41.0
