huankechong/smart-greenhouse/outputs/3D打印件/花房3D_P1P2/STL/11_ldr_stand_v1.stl

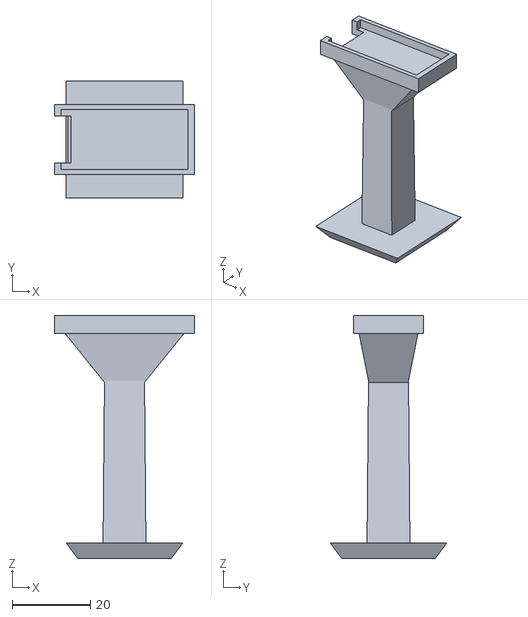
[picture p55: CAD file, 2026-11-12]
outputs/3D打印件/花房3D_P1P2/STL/11_ldr_stand_v1.stl
36.0 x 30.0 x 62.3
