huankechong/smart-greenhouse/outputs/3D打印件/花房3D_整机底盘/STL/06b_base_right_v1.stl

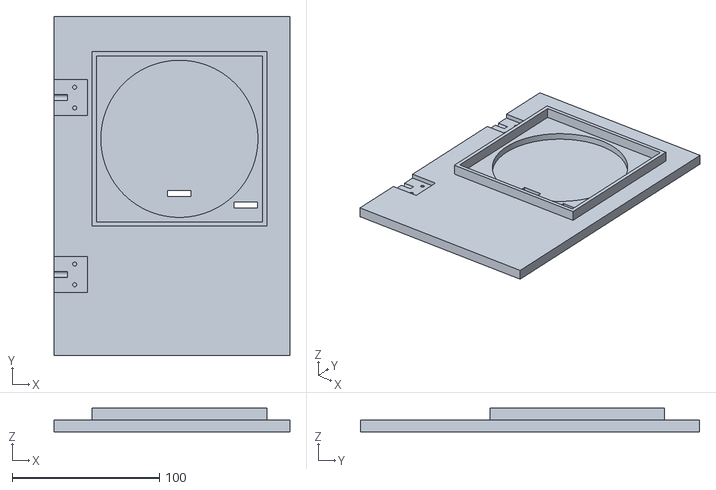
[picture p56: CAD file, 2026-11-13]
outputs/3D打印件/花房3D_整机底盘/STL/06b_base_right_v1.stl
160.0 x 230.0 x 16.0
