huankechong/smart-greenhouse/outputs/3D打印件/花房3D_水箱盖/STL/10_tank_lid_v1.stl

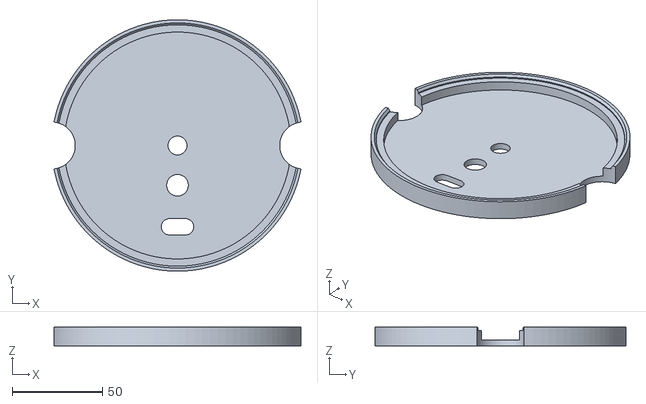
[picture p57: CAD file, 2026-11-09]
outputs/3D打印件/花房3D_水箱盖/STL/10_tank_lid_v1.stl
136.7 x 139.2 x 10.5
