huankechong/smart-greenhouse/outputs/3D打印件/花房3D_追加件/STL/12_led_stand_v1.stl

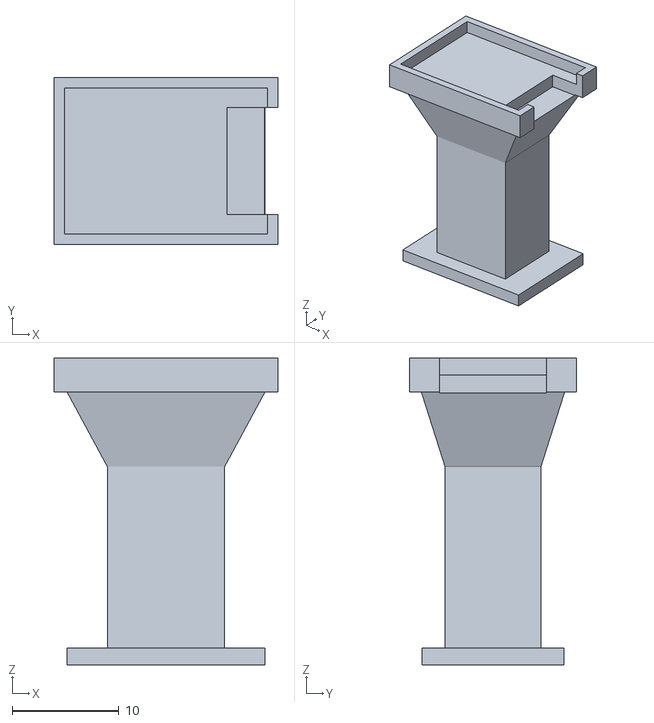
[picture p58: CAD file, 2026-11-12]
outputs/3D打印件/花房3D_追加件/STL/12_led_stand_v1.stl
21.0 x 15.7 x 28.8
