huankechong/smart-greenhouse/outputs/3D打印件/花房3D_P0/STL/01b_sensor_rim_hook_v2.stl

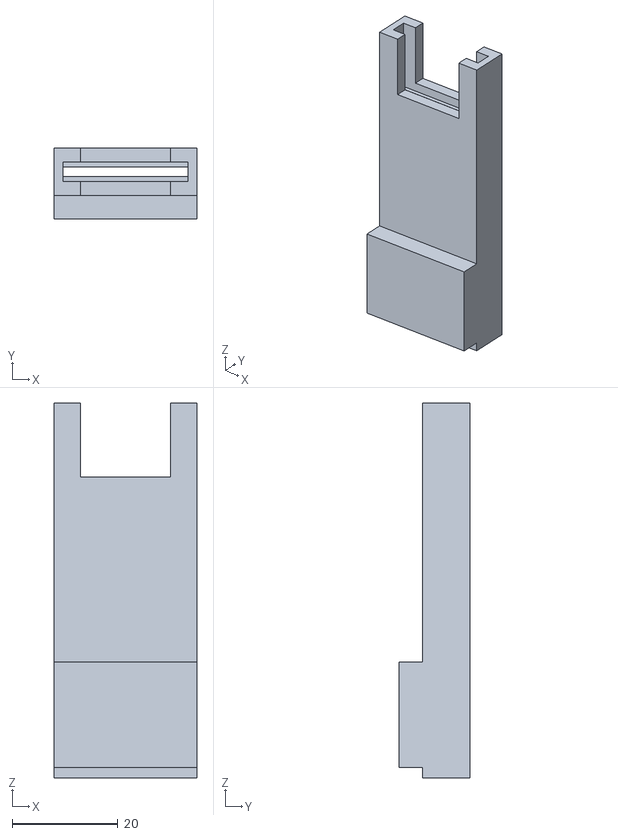
[picture p59: CAD file, 2026-11-10]
outputs/3D打印件/花房3D_P0/STL/01b_sensor_rim_hook_v2.stl
27.0 x 13.5 x 71.0
