huankechong/smart-greenhouse/outputs/3D打印件/花房3D_P1P2/STL/04_oled_stand_v1.stl

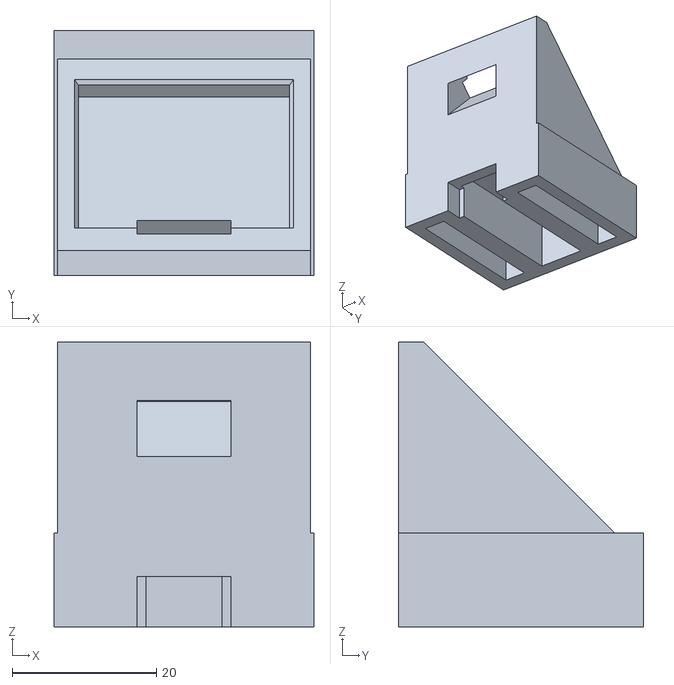
[picture p60: CAD file, 2026-11-10]
outputs/3D打印件/花房3D_P1P2/STL/04_oled_stand_v1.stl
36.0 x 34.0 x 39.5
