huankechong/smart-greenhouse/outputs/3D打印件/花房3D_整机底盘/STL/06a_base_left_v1.stl

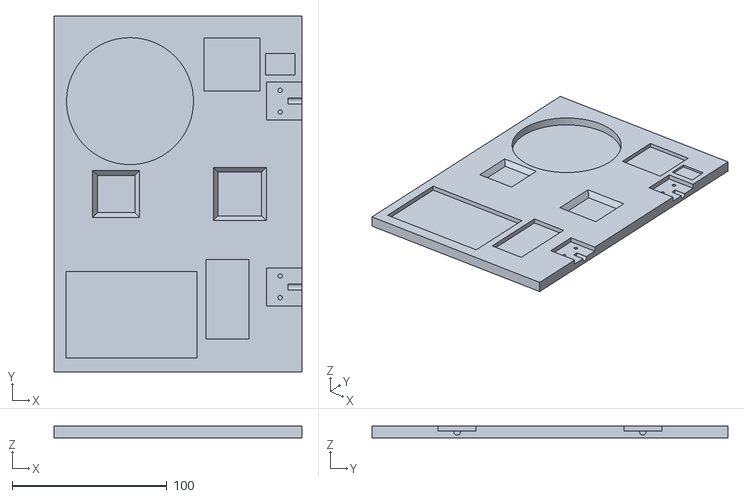
[picture p61: CAD file, 2026-11-12]
outputs/3D打印件/花房3D_整机底盘/STL/06a_base_left_v1.stl
160.0 x 230.0 x 8.00
