huankechong/smart-greenhouse/outputs/3D打印件/花房3D_P1P2/STL/07_dht11_holder_v1.stl

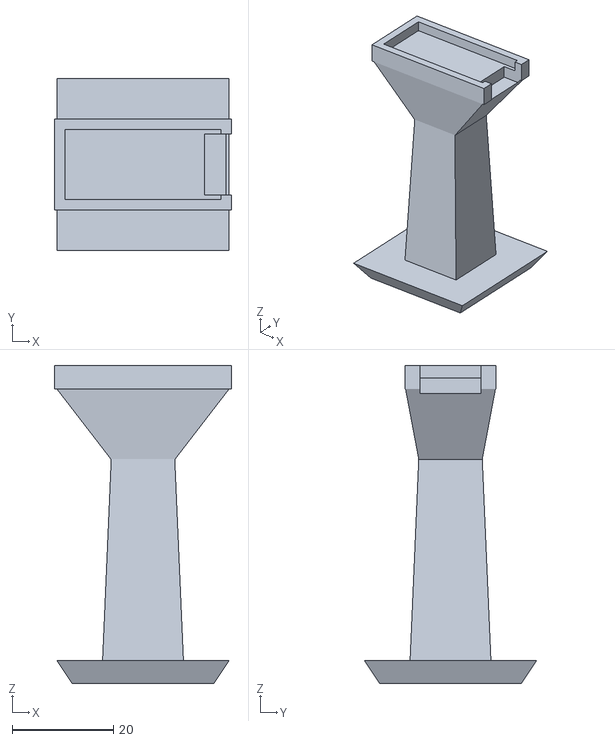
[picture p62: CAD file, 2026-11-09]
outputs/3D打印件/花房3D_P1P2/STL/07_dht11_holder_v1.stl
35.0 x 34.0 x 62.8
