huankechong/smart-greenhouse/outputs/3D打印件/花房3D_整机底盘/STL/测试块_配合公差_v1.stl

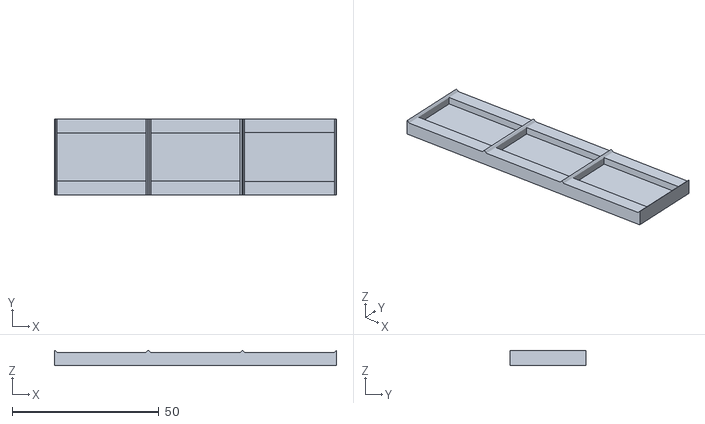
[picture p63: CAD file, 2026-11-08]
outputs/3D打印件/花房3D_整机底盘/STL/测试块_配合公差_v1.stl
96.0 x 26.0 x 5.00
