huankechong/smart-greenhouse/outputs/3D打印件/花房3D_P1P2/STL/08_cable_clip_v1.stl

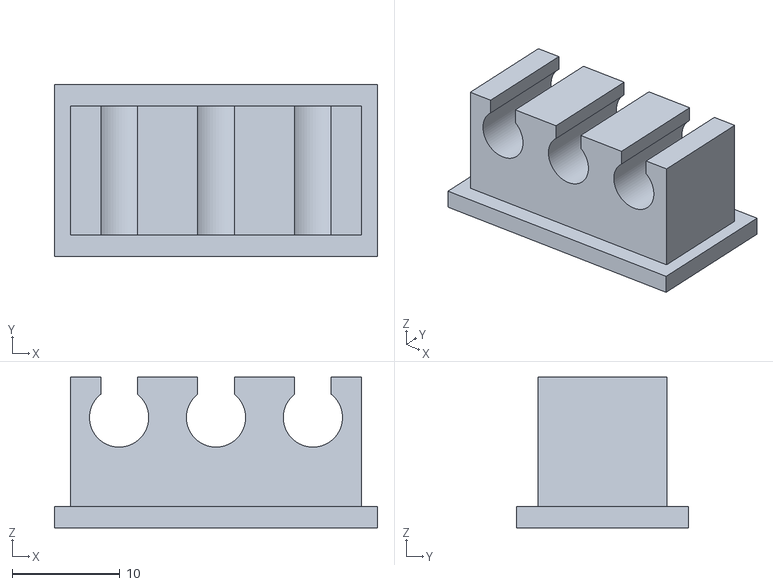
[picture p64: CAD file, 2026-10-18]
outputs/3D打印件/花房3D_P1P2/STL/08_cable_clip_v1.stl
30.0 x 16.0 x 14.0
