huankechong/smart-greenhouse/outputs/3D打印件/花房3D_整机底盘/STL/06c_joint_block_v1.stl

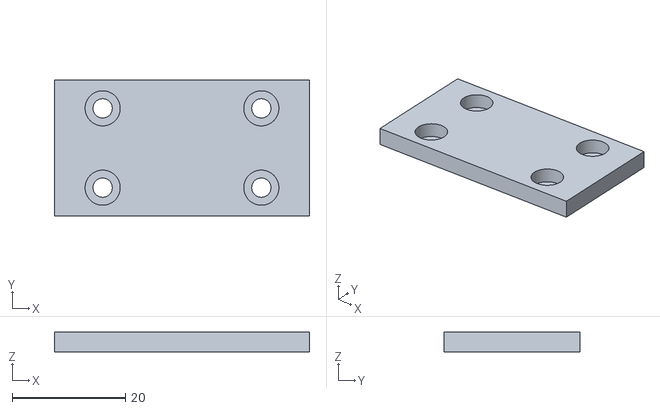
[picture p65: CAD file, 2026-10-18]
outputs/3D打印件/花房3D_整机底盘/STL/06c_joint_block_v1.stl
45.0 x 24.0 x 3.50
