huankechong/smart-greenhouse/docs/审计报告/AR05_GreenHouse打印件装配优化_2026-10-19.md

# AR05 · 花房 3D 打印件按整机示意模型优化

- **触发**：2026-10-19 领导指示「根据示意模型，优化需要打印的模型」
- **方法**：以 `build_assembly.py` 装配模型为基准，跑 `audit.py` 两两布尔求交做基线，逐项定位真实干涉，改参数化脚本（不改 STL），全链验证
- **结论**：4 项优化全部落地；打印件与花盆/土壤干涉清零，水管穿夹从 471 → 1.2 mm³；12 个 STL 自检全 OK；HTML 无 JS 错误

---

## 一、基线审计（改动前）

| 干涉对 | 体积 | 判定 |
|---|---|---|
| 花盆 × 水管末端夹 | **12.3 mm³** | 🔴 真问题：夹体按盆沿外径竖直放置，但花盆是锥体（下 29 → 上 41），低处半径仅 38.5，夹身嵌入盆壁 |
| 土壤 × 水管末端夹 | **381 mm³** | 🔴 同根因连带：夹身下半截（z 69–79）埋进土里 |
| 水管 × 水管末端夹 | **471 mm³** | 🔴 真问题：水管从夹孔斜穿出时蹭夹壁 |
| 传感器挂钩 × 传感器板 | 109 mm³ | 🟢 设计如此（1.5 槽夹 1.6 板，0.1 过盈弹性夹持） |
| 土壤 × 挂钩 | 11522 mm³ | 🟢 已知限制（斜臂入土，交付说明第 2 条） |

## 二、优化项与实施

### 1. 管夹 03 重设计（v1 → v2，盆沿双爪式）

**为什么推翻原设计**：原「立板跨盆壁 + 锥形楔紧槽」依赖盆壁为直壁，锥形盆上必然咬入。01b 传感器挂钩已证明「双爪随锥度下探」在锥形盆上干涉为 0，直接复刻该原理。

| 项 | v1 | v2 |
|---|---|---|
| 夹持方式 | 单板 + 锥形楔紧槽（下 7.5 → 上 4.5） | 内外双爪，随盆壁锥度 8.5° 下探 |
| 爪入土 | 18mm 深，埋土 381 mm³ | **7mm（土面在盆沿下 8mm），不入土** |
| 管孔位置 | 平台上方，管斜穿出 | 桥面上方独立管环柱，孔中心内移 11mm（避开内爪同域） |
| 落床 | z_min=0 | 归一化 z_min=0，`metadata["rim_top_z"]` 供装配补偿 |
| 体积/重量 | 6.9 g | 11.8 g（多出的料是双爪 + 管环柱，换掉 381 mm³ 埋土） |

**参数改动**（`p0_models.py` → `PARAMS["clip"]`）：`rim_gap 5.6→6.2`、`ring_y_local -6→-11`、`taper 8.5`、`jaw_down 7.0`、`col_h 20`。

### 2. 装配水管路径重排

孔轴改为垂直贯穿后，管路径改为**高空绕行 → 柱顶正上方 → 竖直下穿**，弯头全部在管环以外：
`泵顶 (85,8,39) → (85,8,58) → (58,8,70) → (15,14,76) → (-30,35,92) → (-58,50,118) → (-58,55,126) → (孔轴,126) → (孔轴,81)`
出水口悬停土面 2mm（土面 z=79）。

### 3. OLED 支架 04 加防脱卡爪（落实 P1P2 限制 3）

槽上坡端两只 1.2mm 厚、4mm 宽弹性爪，向槽内悬伸 1.5mm 压住板上缘（0.6 过盈，PLA 弹性扣入）。三角面 44 → 92，重量 21.1 g 不变。

### 4. 底盘 06a/06b 漏水防护（落实底盘限制 7）

| 改动 | 几何 | 作用 |
|---|---|---|
| 槽底排水孔 | φ5 @(120, 52)，通板 | 水箱漏的水穿板直落桌面，不进电控区 |
| 挡水堤 ×2 | 3×3mm 堤：水箱槽 -Y 边（120 长）+ 接缝侧 -X 边（98 长），右片 | 拦住横向漫流 |
| 影响 | 06b bbox z 8 → **11mm**（堤高），实体 274.3 → 276.7 g | 打印高度 +3mm，料几乎不变 |

## 三、验证证据（改动后）

### 装配干涉（audit.py ②）

| 干涉对 | 前 | 后 | 状态 |
|---|---|---|---|
| 花盆 × 水管末端夹 | 12.3 | **0** | ✅ 清零 |
| 土壤 × 水管末端夹 | 381 | **0** | ✅ 清零 |
| 水管 × 水管末端夹 | 471 | **1.2** | ✅ 余量级（管 Ø8 / 孔 Ø8.6，残差为折线离散） |
| 花盆 × 水管（连带） | 8.0 | **0** | ✅ 清零 |
| OLED 支架 × 屏 | — | 16.8 | 🟢 设计如此（卡爪 0.6 过盈夹持） |

### 全链验证

| 环节 | 结果 |
|---|---|
| `p0_models.py` / `p1p2_models.py` / `base_2pc_models.py` | 12 件全部 watertight / 单体 / z_min=0 |
| `build_assembly.py` | glb 0.54MB，83 几何体 |
| `audit.py` ① 自检 | 12/12 OK（管夹修复落床后由 `!!` 转 OK） |
| `audit.py` ③ 文档对账 | 重量与文档一致 |
| `check_base_fit.py` | 落座 15/15 OK、件×底板干涉全 0、7 项底板特征 OK；**修补脚本**：明细件（M3×6 螺丝/跳线/孔阵等）不应参与落座核对，已加跳过前缀 |
| `build_html.py` | HTML 1.78MB，33,146 三角面 |
| `verify_html.js` | WebGL 正常，**无 JS 错误** |

## 四、备份与回滚

改动前四个脚本已留 `.bak`：`p0_models.py.bak`、`p1p2_models.py.bak`、`base_2pc_models.py.bak`、`build_assembly.py.bak`。

## 五、仍未做（有意为之）

1. **挂钩×板 109 mm³ / 挂钩×土壤 11522 mm³**：过盈夹持与斜臂入土均为原设计特性，交付说明已有答辩口径
2. **底盘减重**：8mm 板不能再降（沉槽 3.5 + 咬合 4.5 已吃满），底面开袋破坏刚性
3. **尺寸仍是占位值**：到货实测后改 `PARAMS`/`P` 重跑，本次只动结构与配合，不碰实测项

---
*2026-10-19 · 小马 · 文件：docs/审计报告/AR05_GreenHouse打印件装配优化_2026-10-19.md*
