huankechong/smart-greenhouse/outputs/3D打印件/花房3D_整机装配/花房整机示意模型.html

# 智能花房养护站 Smart GreenHouse

整机示意模型 · 3D 打印件按 1:1 实体装配

轴测 正视 俯视 左后 自动旋转

拖拽旋转 · 滚轮缩放 · 右键/Shift 拖拽平移

## 图例

## 模型信息

单位 mm · 底板 z=0 为桌面 · 生成于 2026-10-18
