huankechong/smart-greenhouse/outputs/3D打印件/花房3D_P0/preview/01b_装配_花盆剖面.png

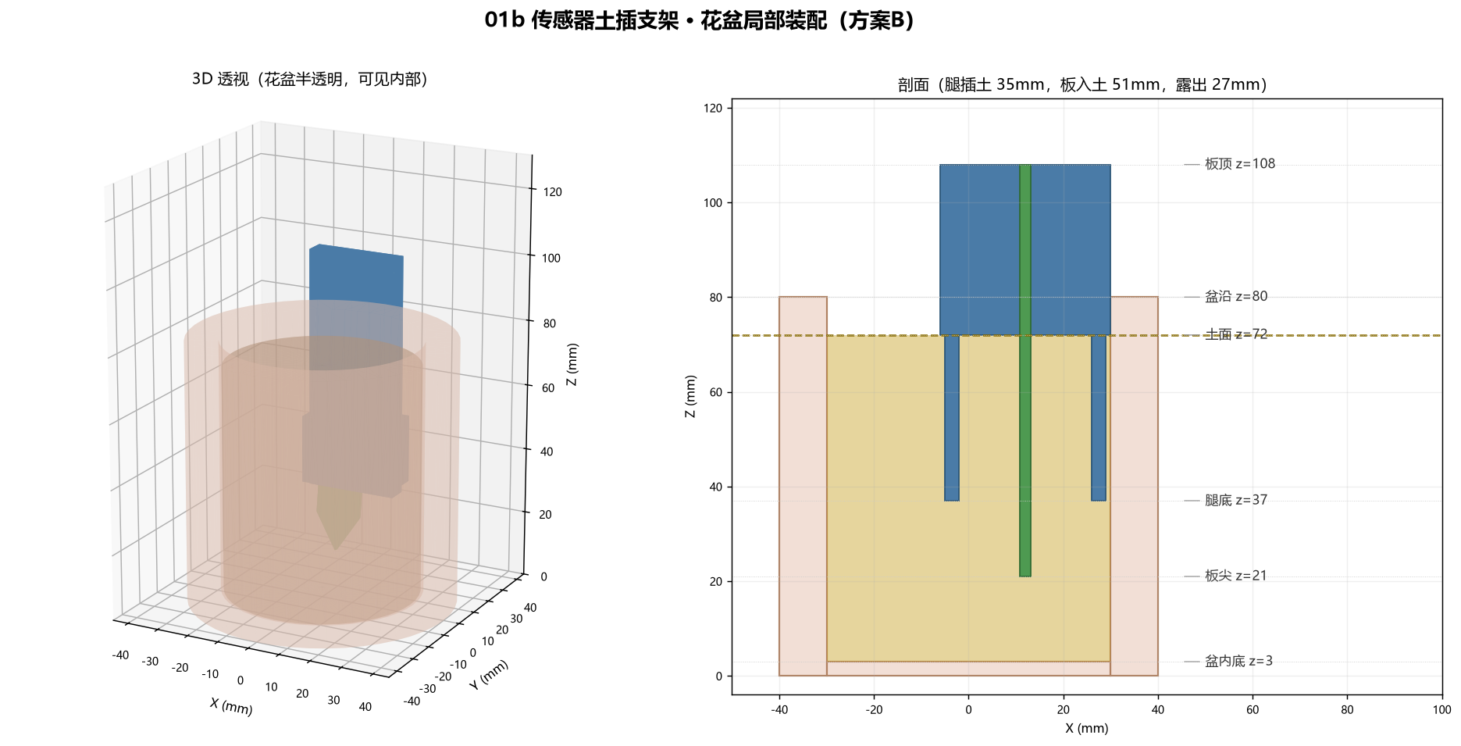
outputs/3D打印件/花房3D_P0/preview/01b_装配_花盆剖面.png
