huankechong/smart-greenhouse/outputs/3D打印件/花房3D_整机底盘/preview/00_底盘装配总览.png

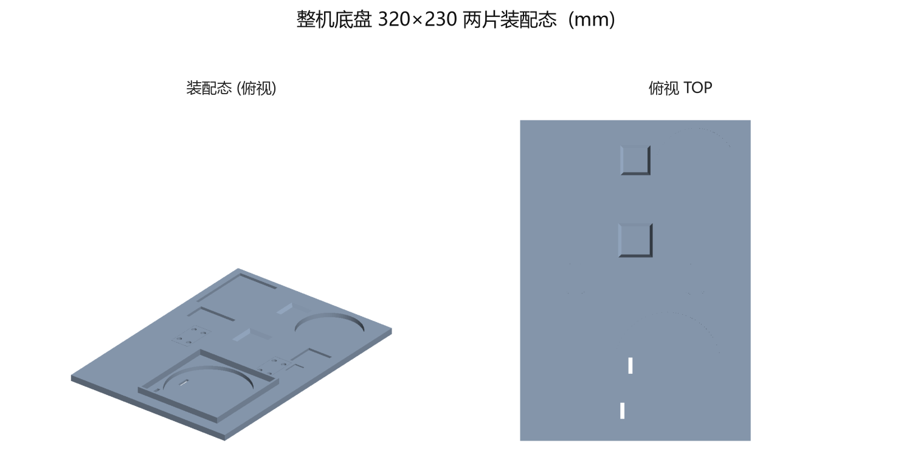
outputs/3D打印件/花房3D_整机底盘/preview/00_底盘装配总览.png
