huankechong/smart-greenhouse/outputs/3D打印件/花房3D_整机装配/preview/00_HTML验证_俯视.png

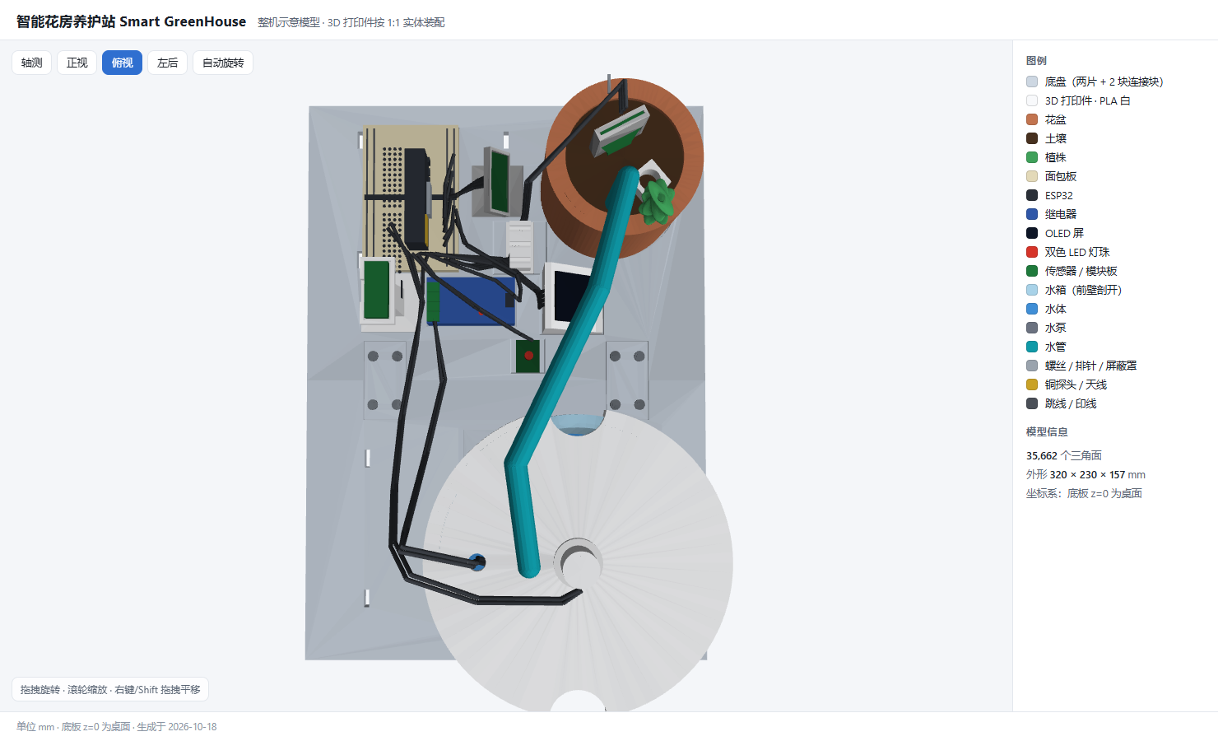
outputs/3D打印件/花房3D_整机装配/preview/00_HTML验证_俯视.png
