huankechong/smart-greenhouse/outputs/3D打印件/花房3D_整机装配/preview/00_整机四视图.png

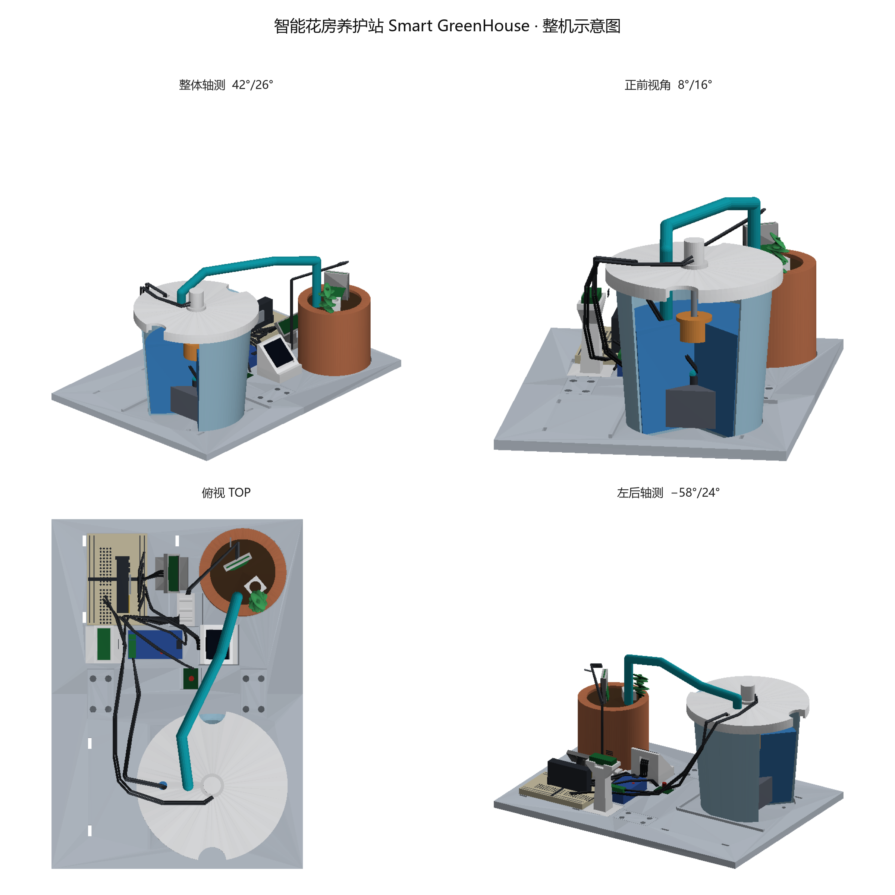
outputs/3D打印件/花房3D_整机装配/preview/00_整机四视图.png
