huankechong/smart-greenhouse/outputs/3D打印件/花房3D_整机装配/preview/01_花盆周边结构标注.png

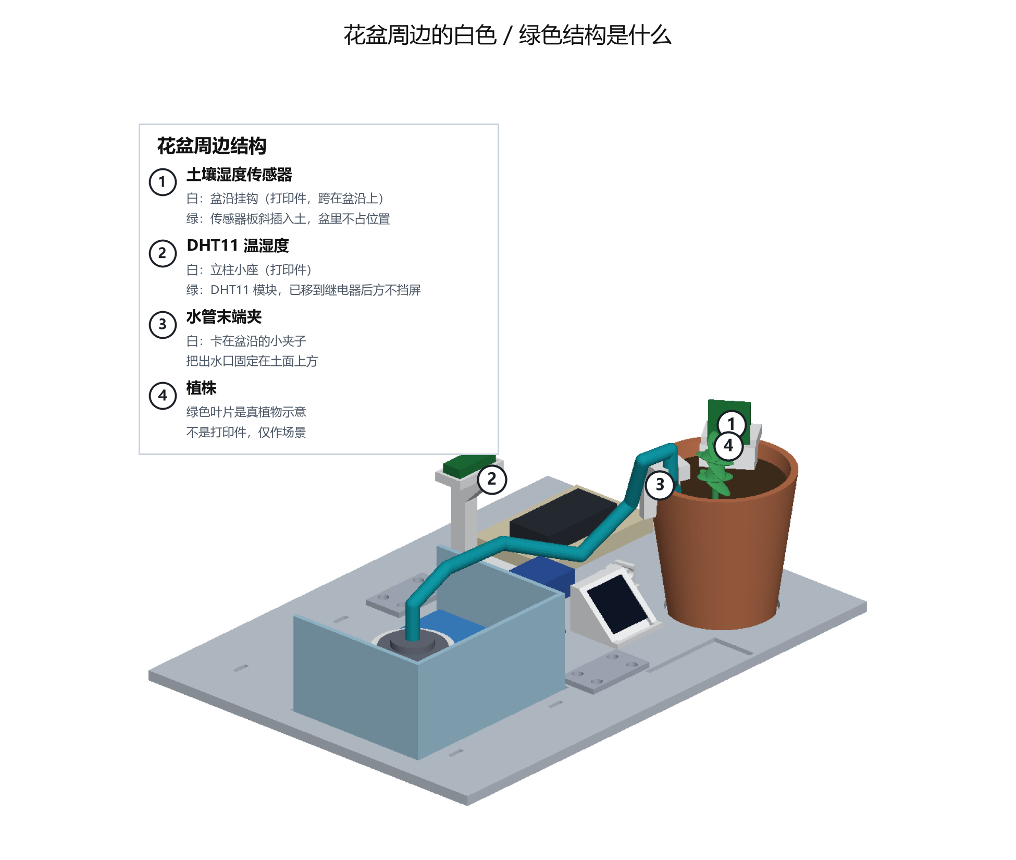
outputs/3D打印件/花房3D_整机装配/preview/01_花盆周边结构标注.png
