huankechong/smart-greenhouse/outputs/3D打印件/花房3D_整机装配/preview/04_高清_左后.png

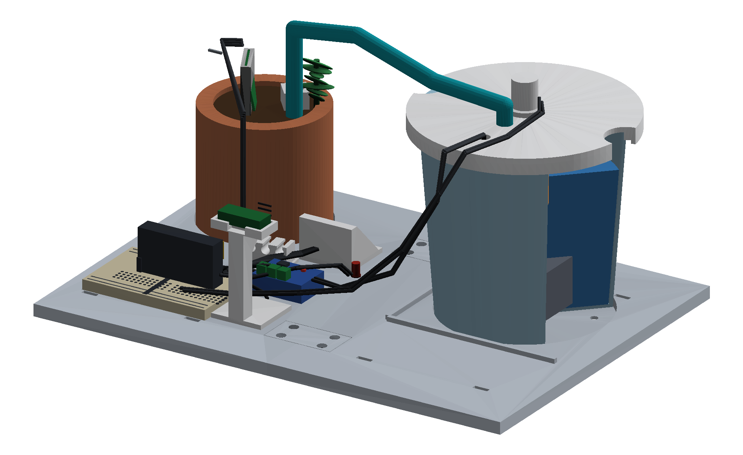
outputs/3D打印件/花房3D_整机装配/preview/04_高清_左后.png
