huankechong/smart-greenhouse/outputs/3D打印件/花房3D_整机装配/preview/06_装配三步.png

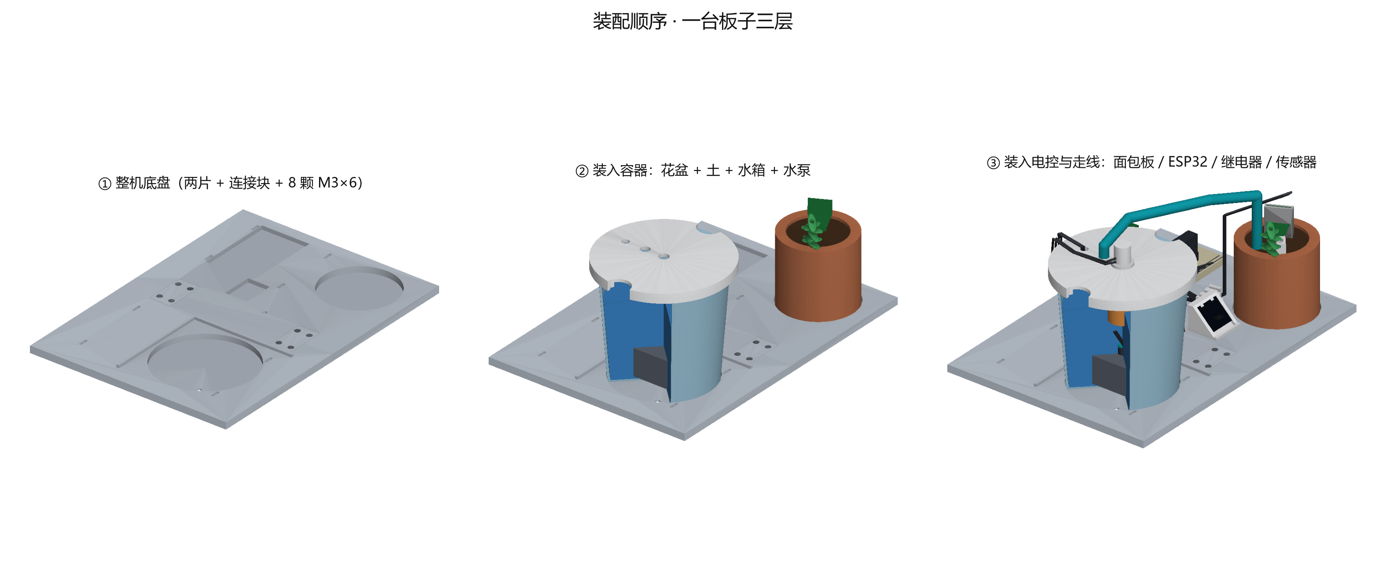
outputs/3D打印件/花房3D_整机装配/preview/06_装配三步.png
