huankechong/smart-greenhouse/outputs/3D打印件/花房3D_整机装配/preview/07_底盘摆放图.png

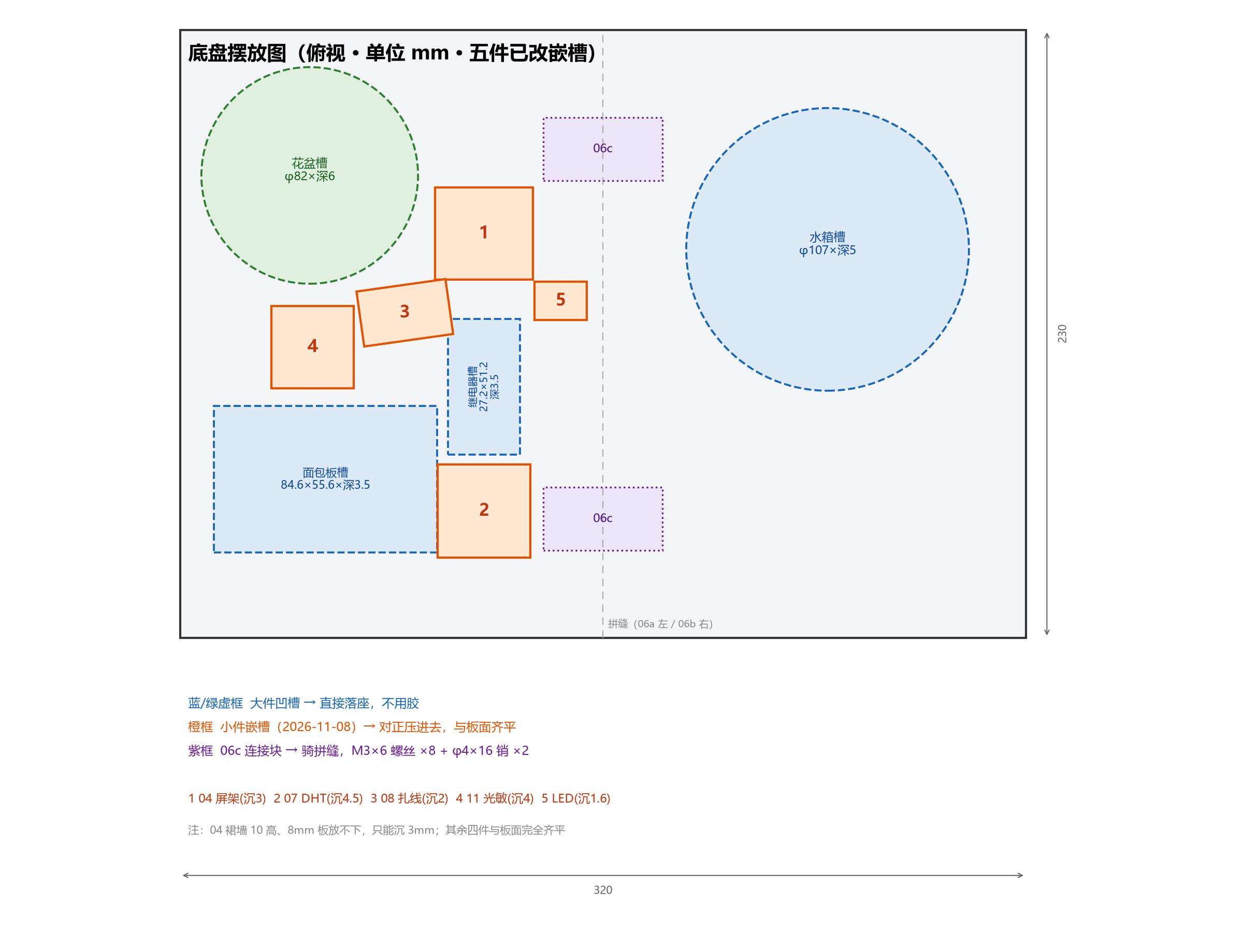
outputs/3D打印件/花房3D_整机装配/preview/07_底盘摆放图.png
