huankechong/smart-greenhouse/outputs/3D打印件/花房3D_整机装配/preview/08_合板三件说明.png

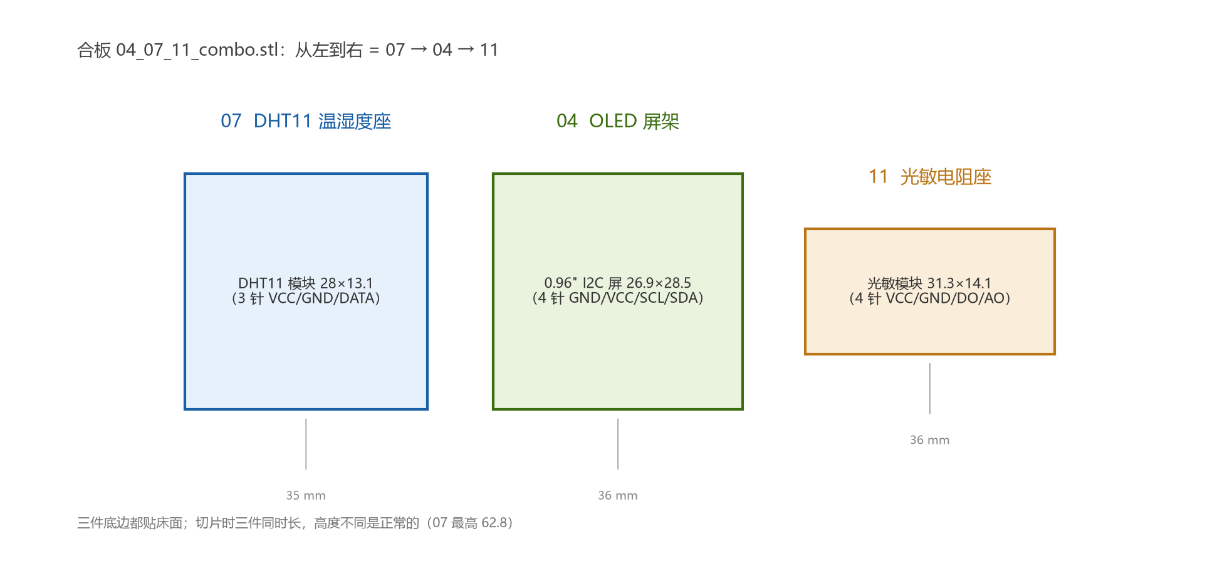
outputs/3D打印件/花房3D_整机装配/preview/08_合板三件说明.png
