huankechong/smart-greenhouse/outputs/3D打印件/花房3D_整机装配/preview/view_az+8_el+16.png

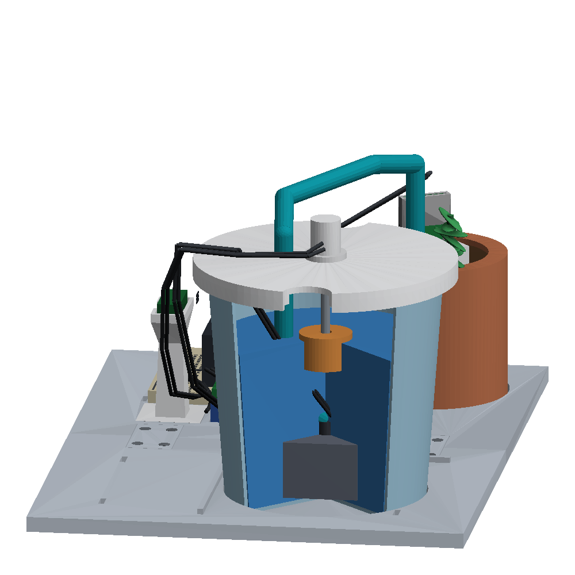
outputs/3D打印件/花房3D_整机装配/preview/view_az+8_el+16.png
