huankechong/smart-greenhouse/outputs/3D打印件/花房3D_整机装配/preview/view_az-58_el+24.png

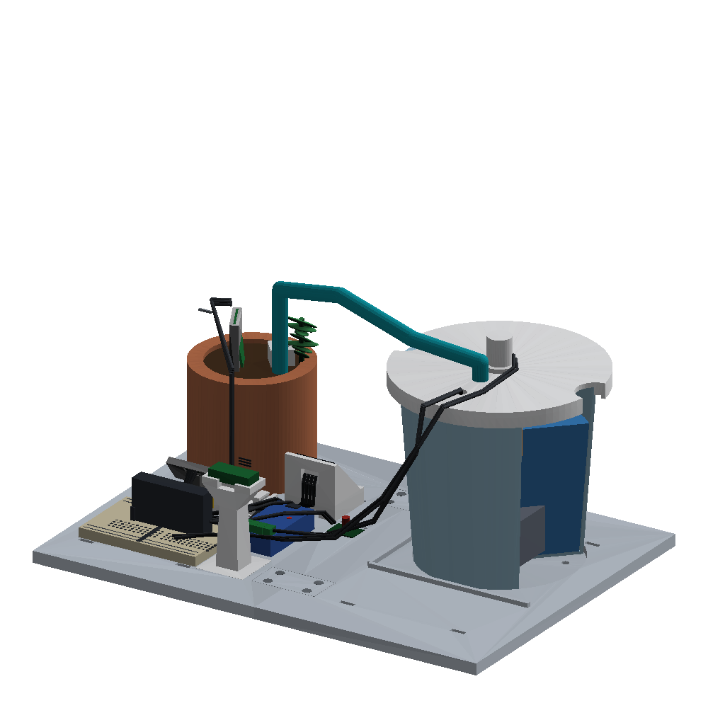
outputs/3D打印件/花房3D_整机装配/preview/view_az-58_el+24.png
