huankechong/smart-greenhouse/docs/审计报告/AR36_GreenHouse_底盘槽口bug与布局重排_2026-11-12.md

# AR36 · 06a 底盘槽口 bug 修复 + 布局重排

日期：2026-11-12
涉及：`outputs/3D打印件/花房3D_整机底盘/base_2pc_models.py`、`花房3D_整机装配/build_assembly.py`、`check_base_fit.py`

## 一、修复的真实缺陷

### 1. 小件嵌槽槽口被切成正方形（严重）

`base_2pc_models.py` 的槽口导入斜口用了同一变量：

```python
h0 = (fw + fit_clear) / 2.0                # 只算宽度的一半
v = [[-h0, -h0, ...], [h0, h0, ...]]       # X、Y 都用了 h0
```

后果（逐层实测）：

| 槽 | 槽本体 | 槽口（错误） |
|---|---|---|
| 08 理线 | 30.2 × 16.2 | **31.2 × 31.2 方形** |
| LED | 19.0 × 13.6 | **20.0 × 20.0 方形** |

→ 任何矩形件都盖不满，出现"方口 + 大台阶"。

**修复**：`hx`/`hy` 分别按宽、深计算；后来按领导决定直接改成**直口**（`mouth_chamfer: 0`），彻底取消槽口斜口。

### 2. 06c 沉槽深 1mm（严重）

切槽盒 `recess_d + 2` 以 `pt − recess_d/2` 为中心 → 槽深 4.5（应 3.5），连接块沉下去 1mm 不齐平。
修复：高度改 `recess_d + 1`、中心上抬 0.5 → 实测槽深 **3.50**、块顶与板面差 **0.00**。

### 3. 07 DHT 与面包板槽几乎穿通（0.6mm）

顺带拉开到 10.6mm。

### 4. LED 参数是死代码

`led_d: 5.2` / `led_pos` 定义了但从未使用 → 底盘上**没有** φ5.2 灯孔。LED 只能走 18.8×13.5 的模块槽，已按此做了 12 号座。

## 二、按领导要求做的删减

| 项 | 处理 |
|---|---|
| 08 理线器槽 | **取消**（理线器判定无用） |
| 4 个扎带过孔（10×2.8） | **全部取消** |
| 槽口斜口 | **全改直口** |
| 花盆/面包板/继电器槽 | 保持原尺寸（领导：不要缩小） |

## 三、布局重排（按领导手绘 3×3 九宫格）

以「接缝在左、花盆在下」为参照：

| 区 | 位置 | 件 |
|---|---|---|
| 上（前）· 左 | (0, ±60) 之外 | 06c 沉槽 |
| 上 · 中 | (−48, −68) | 继电器 |
| 上 · 右 | (−110, −78) | 面包板 |
| 中 · 中 | (−40, 0) | 07 温度 |
| 中 · 右 | (−120, 0) | 11 光敏 |
| 下（后）· 左 | (−14, 83.8) | 12 灯 |
| 下 · 中 | (−45, 83.8) | 04 oled |
| 下 · 右 | (−111, 60) | 花盆（不动） |

**花盆切线对齐**：半径 40.9、圆心 y=60 → 下侧切线 y=100.9；oled 高 34.2，中心放在 83.8 → 其下边缘正好落在切线上 ✓

**06c 连接槽 y：±70 → ±60**（随花盆/oled 同排要求；定位销、8 颗 M3 引导孔随之移动）

## 四、验证

| 检查 | 结果 |
|---|---|
| 槽尺寸逐层实测 | 花盆 φ81.8 / 面包板 84.4×55.4 / 继电器 27.8×51.4 / 04 36.2×34.2 / LED 19.0×13.6 |
| 06c 沉槽 | 深 3.50、块顶与板面差 0.00 |
| `check_base_fit` | **全部通过**（落座高度、零干涉、槽孔特征） |
| 件间最小间隙 | oled↔灯 3.4 / 花盆↔光敏 4.0 / 面包板↔继电器 5.8 / 花盆↔oled 7.5 |
| 质量 | 06a **279.7 g**、06b 305.9 g、06c 4.2 g |

## 五、遗留

1. `check_wires` 仍有 **2 根**跳线轻微擦到继电器（仅影响示意模型，不影响实物接线），待下一步重排走线时一并处理。
2. `build_assembly` 的件位常量已同步，但整机 HTML/glb **尚未重新烘焙**（最后一次是 11-09 10:12）。
