huankechong/smart-greenhouse/docs/工作日志/打印日志.md

# 打印日志（R3）

> 角色 **R3 · 结构与打印** ｜ 分支 `r3-print-1107` ｜ 起点 **D0 = 2026-11-07** ｜ 状态：**记录骨架，边打边填**
> 交付物对应任务底稿 13.1–14.3（见 `docs/花房4人分工方案_2026-10-20.md` 附录）。
> 本文只记"**实际打了什么 + 结果 + 偏差 + 证据在哪**"，不重复切片参数与装配步骤——那是
> `outputs/3D打印件/_打印参考/切片报告.md`、`outputs/3D打印件/_打印参考/上机操作卡.md` 与各 `交付说明_*.md` 的事。

---

## 一、一分钟结论（每次更新先改这里）

| 件号 | 名称 | 切片预估 | 状态 |
|---|---|---|---|
| 01b | 土壤传感器土插支架（**裸露版 14.5g**，感湿窗 17×37） | 35m / 14.5g | ✅ **已完成（2026-11-10）** |
| 03 | 水管末端固定夹（加强针版 4.1g） | 17m / 4.1g | ✅ **已完成（2026-11-11）** |
| 04 | OLED 45° 支架（实心版 27.7g，槽 29.3×28.0×2.9+倒角） | 30m / 27.7g | ✅ **已完成（2026-11-10）** |
| 06a | 整机底盘·左片（AR36 直口版） | 2h30m / 118.8g | ✅ **已完成（2026-11-12 晚开打 → 11-13 打完）** | 免支撑 / **brim 8** | 成品照已入库（S2-13.1-06a 俯视，领导实物确认） | 与 06b 排水槽版拼接后验证 φ4 定位销 |
| 06b | 整机底盘·右片 | 2h33m / 124.1g | ✅ **已完成（2026-11-12）** |
| 06c | 拼缝连接块 ×2 | 7m / 2.9g | ✅ **已完成（2026-11-11）** |
| 07 | DHT11 小座 | 34m35s / 11.2g | ✅ **已完成（2026-11-09）** |
| 08 | 扎线固定座 | 9m / 3.1g | ✅ **已完成（2026-11-08）** |
| 10 | 水箱替换盖 | 1h02m / 44.6g | ✅ **已完成（2026-11-09）** |
| 11 | 光敏电阻小柱 | 18m31s / 4.9g | ✅ **已完成（2026-11-09）** |
| ~~02~~ | ~~水泵固定座~~ | — | ⛔ **作废勿打**（泵自带吸盘直吸桶底，2026-10-24 定） |

> 合计基线：**8h37m / 338.1g**（10 件，拓竹 X2D 0.4 喷嘴实测切片，含 04/07/11 复切；非估算）。
> 件重一律取 `outputs/3D打印件/_打印参考/切片报告.md` 的**切片实测值**（十件相加 **338.1g**，与本行基线一致）；`README.md` §三 另有一列"实体预估"（19.4/21.1/14.9/4.8g…），两列口径不同，混用会把总量算成 354g。
> 状态只用四档：⏳ 待打 / 🔧 打印中 / ✅ 完成 / ♻️ 重打。**没有实物照片不算完成。**

## 二、红线（动手前先看，踩了要返工）

1. **不许手改 STL。** 尺寸不对 → 改对应脚本顶部 `PARAMS` / `P` 常量，由 R1 复核后重跑脚本重出（这是 `AGENTS.md` §3 红线 1）。
2. **周末可以打印（2026-11-07 老师课件确认：周末实验室 9:00–20:30 开放）。** 打印本身无人值守，占机器不占人；提交前仍需确认拓竹 X2D 在 C312/C313/C314 哪间、当值老师是否放行。
3. **切片是纯软件、不占打印机**，但**已切好的 gcode 不要重切**——切片基线是 2026-10-24 实测的，现场只核对打印机型号与喷嘴（0.4mm）。
4. **套件元件与工具是借的**，用完清点归盒，别带走。
5. 本文件不写绝对日期，一律 D0 / D+n（答辩日 D_ans 未定）。
6. **试装偏差必须当场量、当场记**，隔天回忆的数字不可信——这是补打件的唯一依据。

## 三、打印前检查（做一项勾一项）

- [ ] 打印机型号确认为 **拓竹 X2D**，喷嘴 **0.4mm**（与切片基线一致；不一致则全部作废重切）
- [ ] 耗材：PLA，余量 ≥ 380g（10 件 338g + 试错余量）
- [ ] 底板清洁、调平正常；**底盘两片 brim 8mm 必开**（大平面翘边唯一防线）
- [ ] 先打 **06c 连接块**（7 分钟）：用 M3 自攻试拧 φ2.8 引导孔，确认咬合手感，再上大件
- [ ] 五金备齐：**M3×6 盘头自攻 ×8**、**φ4×16 定位销 ×2**、PH1 螺丝刀
      ⚠️ **M3×8 会穿出底面 1.8mm**，别拿长的凑
- [ ] 手机存储留空间（每件打完拍一张成品照 + 一张上机状态照）

## 四、逐件打印记录

| 件号 | 上机（D+n） | 实际耗时 | 实际耗材 | 支撑/brim | 结果 | 备注 |
|---|---|---|---|---|---|---|
| 06c | **D+4（2026-11-11）** | 待补（预估 7m） | 待补（2.9g×2） | 免支撑 / brim 3 | ✅ **成功** | 试拧顺延：**M3×6 首购买错已退（2026-11-12）；重购版规格正确、在途**；到货后先试拧验咬合再拼装 |
| 06a | 2026-11-12 晚开打 → 11-13 打完 | 2h30m | 118.8g | 免支撑 / **brim 8** | ✅ **已完成** | AR36 直口版；成品照 S2-13.1-06a 俯视（领导实物确认 06a） |
| 06b | **D+5（2026-11-12）** | 待补 | 待补 | 免支撑 / **brim 8** | 🔧 **重打中（2026-11-13 晚）** | 22:27 报「还剩 2h35m」→ 约 01:00 完（**排水槽版 16×4×2**）；11-12 打的无槽版作废待处置 |
| 10 | **D+2（2026-11-09）** | 待补（切片预估 1h02m） | 待补（切片预估 44.6g） | 免支撑 / brim 5，**顶面朝下** | ✅ **成功** | 白盘件；实物照片见 `S2-13.1-10水箱盖与11光敏柱成品.jpg`（与 11 号同框）；孔位与缺口与模型俯视图镜像一致 → 确认是底面视角 |
| 11 | **D+2（2026-11-09）** | 待补（切片预估 18m31s） | 待补（切片预估 4.9g） | 免支撑 / brim 3 | ✅ **成功** | 黑件（底板+斜柱+托槽）；实物照片同上 |
| 04 | | | | 免支撑 / brim 3 | | |
| 07 | **D+2（2026-11-09）** | 待补（切片预估 34m35s） | 待补（切片预估 11.2g） | 免支撑 / brim 3 | ✅ **成功** | 台锥+收腰+喇叭口版；成品未单独拍照（与 10/11 同场打印） |
| 01b | | | | 免支撑 / brim 5 | | |
| 03 | **D+4（2026-11-11）** | 待补（预估 17m） | 待补（加强针版 4.1g） | 免支撑 / brim 3 | ✅ **成功** | 加强针版（pin_t 4.0，AR34）；成品照待补 |
| 08 | **D+1（2026-11-08）** | 待补（切片预估 9m） | 待补（切片预估 3.1g） | 免支撑 / brim 3 | ✅ **成功** | **首件实体打印件**；成品照 11/09 现场补拍 |

> 📌 **进度小结（2026-11-11 更新）**：已打 **8 / 10 件** —— 08（11-08）、10/07/11（11-09）、01b/04（11-10）、03/06c×2（11-11）。剩余 **06a / 06b**（注意：**沉槽深度已修正重出**，打这两件务必用最新 STL）。
> ⚠️ **2026-11-13 更正（领导口径）**：此前误记 06a 已打——实际 **06b 已打完（11-12）、06a 尚未打**。
> 剩余 **1 件：06a**（左片）——**必须用 AR36 直口版**（修复槽口方形 bug + 06c 沉槽深度；R4 照片'S2-13.1-06a底盘左片'实为 06b，待重拍更正标注）。
> 12 LED 座已打（11-12）；13 盖板已删。清单 10 → **11 件**，已打 **10/11**。
> 卡点：**螺丝刀未借到** → 8.1 继电器 / 8.2 水泵 / 浮球极性 全部顺延；且底盘拼装也需 PH1 螺丝刀 + M3×6 盘头自攻 ×8。
> 当日机时不足以打完整个 10 件批（不能过夜挂机），本次为**单件试机性质**；
> 剩余件按 2026-11-09（D+2）19:00 C311 批次计划执行。

> 建议顺序：**06c → 06a/06b（5.0h 连续）→ 10 → 04/07 → 01b/03/08（小件一把打完）**。
> 若只能约到一次连续机时，按此顺序一次打完；否则底盘/小件分两次。

## 五、试装偏差（当场量，单位 mm）

| 检查点 | 设计值 | 实测值 | 偏差 | 判定 | 处理 |
|---|---|---|---|---|---|
| 06a 与 06b 拼接缝宽 | 0（贴合） | | | | |
| 定位销 φ4 配合松紧 | 过渡配合 | | | | |
| M3×6 自攻咬合圈数 | ≥3 圈 | | | | |
| 桶槽 φ107 与 1L 桶 | 单边隙 0.5 | | | | |
| 花盆槽 φ82 与实物盆 φ80 | 单边隙 1.0 | | | | |
| 01b 板槽与传感器板厚 | 板能插入不晃 | | | | |
| 03 管夹孔 φ10.6 与管外径 10 | 压入不掉 | | | | |
| 10 裙边与桶口翻边 φ132 | 直径隙 0.8 | | | | |
| 04 OLED 支架 45° 视角 | 屏面朝人 | | | | |

> 判定只写两档：**✅ 合格 / ❌ 需改**。❌ 的进第六节补打清单，**不重打全套，只补偏差件**。

## 六、失败与重打

| D+n | 件号 | 现象 | 原因判断 | 处置 | 重打结果 |
|---|---|---|---|---|---|
| | | | | | |

> 常见三类：① 首层翘边（brim 不足/底板脏）② 支撑面粗糙（本套件全部免支撑，出现即为切片参数错）③ 孔位偏小（FDM 孔径收缩 0.2–0.4mm，属预期，用钻头过一遍即可，不算废件）。

## 七、耗材与机时汇总（收口时填）

| 项 | 计划 | 实际 | 差异 |
|---|---|---|---|
| 总耗时 | 8h37m | | |
| 总耗材 | 338.1g | | |
| 打印次数 | 1–2 次（连续机时 / 分两批） | | |
| 重打件数 | 0 | | |

## 八、素材与证据

命名口径：`S{阶段}-{任务号}-{描述}`（与 R4 素材库一致，见分工方案 §八留痕）。

- 每件成品照：`S2-13.1-{件号}成品.jpg`
- 上机状态照：`S2-13.1-{件号}上机.jpg`
- 试装照：`S2-14.1-底盘拼接.jpg`、`S2-14.1-M3咬合特写.jpg`
- 失败件照：`S2-13.2-{件号}失败原因.jpg`（失败也要留证据，报告"失败与排查"页要用）

> 素材当场拍当场归档，**事后补拍的照片一眼假**（R4 角色卡原话）。

## 九、交接（给 R1 / R4）

- 补打清单 → R1 改 `PARAMS` 重出 STL（**R3 不动脚本**）
- 试装偏差表 → R4 写进报告"结构实现"章节与答辩 PPT
- 打印日志最终版 → 报告附录（耗时/耗材是"工程可行性"的实证）
