huankechong/smart-greenhouse/docs/工作日志/上云联调记录.md

# 上云联调记录（R2）

> 角色 **R2 · 上云与数据** ｜ 分支 `r2-cloud` ｜ 起点 **D0 = 2026-11-07** ｜ 状态：**记录骨架，边做边填**
> 交付物对应任务底稿 11.1–12.3（见 `docs/花房4人分工方案_2026-10-20.md` 附录）。
> 本文只记"做了什么 + 结果 + 证据在哪"，不重复固件代码与接线细节（那是 `outputs/代码/花房代码/GreenHouse_v1/` 与 `docs/操作手册/花房接线规划表.md` 的事）。

---

## 一、一分钟结论（每次更新先改这里）

| 任务 | 内容 | 状态 | 证据 |
|---|---|---|---|
| 11.1 | 巴法云双主题复核（上行 004 / 下行 001） | ✅ 通过（2026-11-10 21:58 实拍） | `outputs/素材/素材整理_2026-11-10/S3-11.1-控制台双主题.png`，详见 4.0.1 |
| 11.2 | ESP32 接 MQTT，上行 10s 一条（巴法云 004 格式 `字段#值\|字段#值`，非 JSON） | ⏳ 待做 | — |
| 11.3 | 微信小程序绑定 UID，面板出数 | ✅ 通过（2026-11-12 20:11 实拍，设备可见；真实数值待 11.2） | `outputs/素材/素材整理_2026-11-12/S3-11.3-小程序面板.png`，详见 4.2 |
| 12.1 | 远程浇水下行（手机点按钮 → 泵出水） | ⏳ 待做 | — |
| 12.2 | 局域网保底网页（`EN_WEB=1`） | ⏳ 待做 | — |
| 12.3 | 巴法云历史数据导出归档 | ⏳ 待做 | — |

> 状态只用三档：⏳ 待做 / 🔧 进行中 / ✅ 通过（带证据）。**没有证据不算通过。**

## 二、红线（动手前先看，踩了要返工）

1. **UID 私钥、WiFi 名与密码不落本文**——只写进 `outputs/代码/花房代码/GreenHouse_v1/config.h`（该文件交报告前要改回 `<...>` 占位符）。
2. **截图必须打码**：控制台首页的 UID、手机状态栏 WiFi 名、小程序里的账号信息。打码前不传群、不提交仓库。
3. **ESP32 只支持 2.4GHz**：校园网多为 5GHz 或带认证页 → 首选**手机 2.4GHz 热点**，答辩现场同样用热点。
4. **免费版历史数据保留期有限**：上云成功**当天**导一次，48h 测试跑完立刻再导一次，不许拖。
5. 本文件不写绝对日期，一律 D0 / D+n（答辩日 D_ans 未定）。

## 三、联调前检查（做一项勾一项）

- [ ] 固件三个开关改 `EN_WIFI 1` / `EN_MQTT 1` / `EN_WEB 1`（`EN_MQTT`/`EN_WEB` 依赖 `EN_WIFI`，v1.6 已加编译期守卫，写错直接编译报错）
- [ ] `config.h` 三项已填真值：`WIFI_SSID` / `WIFI_PASS` / `MQTT_UID`
- [ ] 手机热点已开 **2.4GHz**、可见、非"仅 5GHz"模式；电脑已连同一热点（方便对照）
- [ ] 串口 115200 打开，能看到 `v1.6 启动` 横幅与 7 个开关状态
- [ ] 主题名与固件一致（上行 `TOPIC_DATA` / 下行 `TOPIC_CMD`，以代码为准，不在本文抄录）

## 四、逐项联调记录

### 4.0 上云操作剧本（按顺序执行，每步记现象）

> **前置（缺一项别开始）**：① 固件 `EN_WIFI=1` / `EN_MQTT=1` / `EN_WEB=1`，**`EN_WATER` 保持 0** ② `config.h` 三值已填真值 ③ PubSubClient 2.8 已装 ④ CPE / 手机热点已开 **2.4G**、SSID 纯英文
> **凭据（SSID / PASS / UID）向 R1 单独索取**，只写进本机 `config.h`；**不进仓库、不进群聊、不进本文**。

| # | 动作 | 预期现象 | 失败先查 |
|---|---|---|---|
| 1 | 填 `config.h` 三值（SSID / PASS / UID） | 文件里 `<...>` 占位符全部被替换 | UID 前后多空格 → rc=4/5；只复制了半截 | 
| 2 | 编译 `arduino-cli compile --fqbn esp32:esp32:esp32 outputs/代码/花房代码/GreenHouse_v1` | 编译通过，无 `#error` | 报「EN_MQTT 需要 EN_WIFI=1」→ 开关没改到文件 |
| 3 | 烧录 + 串口 115200 | `===== 智能花房养护站 v1.6 启动 =====`，下一行开关为 `DHT=1 OLED=1 WATER=0 LEVEL=0 WIFI=1 MQTT=1 WEB=1` | 开关不对 → 烧错目录 / 改的是另一个副本 |
| 4 | 等 ≤15 秒 | `[WiFi] 已连接 IP=192.168.x.x` —— **把 IP 记下来**，12.2 要用 | 一直打点 → 连的是 5G / 校园网认证页 / 密码错 → 改手机 2.4G 热点 |
| 5 | 自动（间隔 5 秒重试） | `[MQTT] 连接巴法云...成功` | `失败(rc=2)` → **clientID ≠ UID**；`rc=-2` → 根本没网；`rc=4/5` → UID 错 |
| 6 | 再等 ≤10 秒 | `[MQTT] 上行: 土壤#..\|光照#..\|温度#..\|气湿#..` | 连上了但没上行 → 主题名不符 / 设备类型选错（004 才是传感器） |
| 7 | 巴法云控制台 / 小程序 | 004 主题有数据；小程序绑定 UID 后面板出数 | 面板空 → 设备类型选成 001 / 主题名不一致 |
| 8 | 向 **001** 发 `on` | 串口 `[MQTT] 收到 4QT4BZIBM001: on`，随后自动回写 `off`；**`EN_WATER=0` 时不出水，这是预期** | 完全无反应 → 没订阅到 001（发到 004 了）／UID 与主题不是同一账号 |
| 9 | 手机连同一 2.4G，浏览器开 `http://<第 4 步的IP>/` | 页面显示 土壤 / 光照 / 温度 / 气湿 | 打不开 → 电脑与手机不同网段，或 IP 变了（重连会换 IP） |
| 10 | **收尾（必做）** | `git checkout -- outputs/代码/花房代码/GreenHouse_v1/config.h` → `git status --short` 为空；`git ls-files \| grep -i 凭据` 无输出 | 忘了还原 → **UID 永久进 git 历史**，删都删不干净 |

> **报文只有 4 个字段是正常的**：`publishData()` 里 `状态#` 被 `#if EN_WATER` 包着、`水位#` 被 `#if EN_LEVEL` 包着，今天这两个开关都是 0。等 12.1 开 `EN_WATER`、浮球开 `EN_LEVEL` 后才会补齐——**别把"少两个字段"当成故障去改代码**。

> **证据三条，缺一条不算通过**：`S3-11.2-串口上行.png`（连续 3 条 `[MQTT] 上行`）/ `S3-11.3-小程序面板.png`（四路数据在线）/ `S3-12.2-局域网页.png`（浏览器访问 ESP32 IP）。

### 4.0.1 11.1 双主题复核（✅ 完成于 2026-11-10 21:58）

**依据**：巴法云官方《设备类型说明》——主题名后三位决定设备类型，`001` = 插座设备、`004` = 传感器设备（[官方文档](https://cloud.bemfa.com/docs/src/index_device.html)）。**类型只看后三位，改前缀无效；类型错了只能重建主题。**

| 方向 | 主题名（固件常量） | 后缀 | 平台类型 | 用途匹配 | 结论 |
|---|---|---|---|---|---|
| 上行 | `cYQ9geudA004`（`TOPIC_DATA`） | 004 | 传感器（只上报） | 上报土壤/光照/温湿度 | ✅ 一致 |
| 下行 | `4QT4BZIBM001`（`TOPIC_CMD`） | 001 | 插座（可下发） | 收 `on` 触发浇水 | ✅ 一致 |

**代码侧已核（2026-11-10）**：两个常量都在 `GreenHouse_v1.ino` 的 `#if EN_MQTT` 段内，`publishData()` 发 `TOPIC_DATA`、`mqttCallback()` 只认 `TOPIC_CMD` 且精确匹配 `on`（小写化后比较），订阅的也是 `TOPIC_CMD` —— 方向没有写反。

**控制台实拍（2026-11-10 21:58，见证据图）**：

| 主题 | 昵称 | 最后消息 | 最后时间 | 连接状态 |
|---|---|---|---|---|
| `cYQ9geudA004` | `flower001` | 空 | 2026-10-17 13:37:13 | 订阅者/发布者均离线 |
| `4QT4BZIBM001` | `flower001cmd` | `{"t":25}` | 2026-10-17 13:37:36 | 订阅者离线 |

- [x] 两条主题**都存在**，后缀 `004` / `001` 与设备类型对得上
- [x] 证据存档：`outputs/素材/素材整理_2026-11-10/S3-11.1-控制台双主题.png`（图内无私钥、无账号信息）
- [x] 未新建、未删除任何主题 —— 保持与固件常量一致

> **两条"离线"不是故障**：ESP32 从未真正上云过（`EN_WIFI=0`），控制台显示离线和最后时间停在 2026-10-17 的调试记录，符合预期。
> **上行最后消息为"空"** 也正常：004 是传感器主题，历史上没收到过固件上报；等 11.2 打通后这里才会出现 `土壤#…|光照#…`。

### 4.1 MQTT 上行（11.2）

| 项 | 内容 |
|---|---|
| 预期 | 串口出现 `[WiFi] 已连接 IP=…`，随后 `[MQTT] 连接巴法云...成功`，每 10s 一条 `[MQTT] 上行: …` |
| 实际 | 待填 |
| 上行报文样例 | 待填（应为 `土壤#…|光照#…|温度#…|气湿#…|状态#…|水位#…` 形式） |
| 耗时 | 待填 |
| 结论 | 待填 |

### 4.2 小程序绑定（11.3）✅

| 项 | 内容 |
|---|---|
| 预期 | 绑定 UID 后，面板出现土壤/光照/温度/气湿四路数据，10s 刷新 |
| 实际 | **绑定成功，两个设备都出现**：`flower001`（传感器，面板显示 `0℃`）、`flower001cmd`（插座，带「离线」标） |
| 证据 | `outputs/素材/素材整理_2026-11-12/S3-11.3-小程序面板.png` |

**结论（2026-11-12 20:11）**：11.3 判**通过**——绑定链路已打通，设备在面板可见。
但面板数值**还不是真实数据**：`0℃` 是无数据时的默认值、设备显示「离线」、时间戳停在 `13:37`，因为 ESP32 从未上云（`EN_WIFI=0`，见 4.0.1 同理说明）。**真实数值要等 11.2 打通后才会刷新**，届时补一张有真实曲线的面板照。

> **11-10 那个卡点的解法（留档）**：小程序**不要点「微信一键登录」**——它进的是「微信所绑手机号」对应的账号，不是项目账号（尾号 `7886`），所以设备列表为空。改用「手机号 + 验证码」登录 `7886` 即可。这条已写进 4.0 剧本的同类坑位。
> 当时的失败现场（网页控制台 TCP 页为空，非小程序页）：`outputs/素材/素材整理_2026-11-10/S3-11.3-小程序未接通_控制台TCP页空.png`

### 4.3 远程浇水下行（12.1）★ 答辩第二核心素材

### 4.3 远程浇水下行（12.1）★ 答辩第二核心素材

| 项 | 内容 |
|---|---|
| 预期 | 小程序发 `on` → 串口打印 `[MQTT] 收到 …: on` + `[远程] 手动浇水开始` → 泵出水约 5s → `[远程] 手动浇水完成` |
| 实际 | 待填 |
| 关键校验 | ① 水位低时应**拒绝**（`[远程] 拒绝：水位过低`）；② 浇水期间 OLED/MQTT 不卡死（非阻塞状态 3） |
| 证据 | 待填（手机点按钮 + 出水的同框短视频，`S3-12.1-远程浇水.mp4`） |

### 4.4 局域网保底页（12.2）

| 项 | 内容 |
|---|---|
| 预期 | 手机连同一热点，浏览器访问串口打印的 IP → 显示土壤湿度 / 光照 / 温度气湿 / 水位 |
| 实际 | 待填 |
| 证据 | 待填（`S3-12.2-局域网页.png`） |

### 4.5 历史数据导出（12.3）

| 项 | 内容 |
|---|---|
| 首次导出时间 | 待填（**上云成功当天**） |
| 归档路径 | 待填（建议 `outputs/素材备份_日期/`，微信 temp 会清） |
| 48h 曲线 | 待填（S4 阶段第二次导出） |

## 五、已知会踩的坑（先看，别重复试错）

| 现象 | 先查什么 | 出处 |
|---|---|---|
| WiFi 连不上、一直打点 | 热点是不是 5GHz；校园网是否要认证页 → 换手机 2.4G 热点 | 方案书 §六 风险表 |
| `[MQTT] 失败(rc=2)` | 巴法云要求 **clientID = UID**，`config.h` 里 UID 是否复制全（含首尾空格） | 固件 `mqttConnect()` |
| 连上了但面板没数 | 主题名对不对；巴法云控制台是否把该主题设成了"开关/插座"类型 | 11.1 |
| 发 `on` 没反应 | 服务端残留旧消息 → 固件收到后会**回写 `off`** 防重复触发；先看串口有没有 `[MQTT] 收到` | 固件 `mqttCallback()` |
| 面板数据忽有忽无 | 免费版连接数/消息数限额；热点断流 | 巴法云控制台 |
| 远程浇了但水泵不动 | 大概率不是上云问题：查 `EN_WATER` 是否 1、继电器极性、标定是否已回填 | `docs/操作手册/花房接线规划表.md` §六 |

> 真实踩坑**当场**补进这张表（现象 → 根因 → 处置 → 证据）；报告"失败与排查"章节直接取用，事后回忆写不真。

## 六、素材清单（命名 `S{阶段}-{任务号}-{描述}`）

| 文件名 | 内容 | 状态 |
|---|---|---|
| `S3-11.2-串口上行日志.png` | 连续 3 条 `[MQTT] 上行` | ⏳ |
| `S3-11.3-小程序面板.png` | 四路数据在线 | ⏳ |
| `S3-12.1-远程浇水.mp4` | 点按钮 + 出水同框 | ⏳ |
| `S3-12.2-局域网页.png` | 浏览器访问 ESP32 IP | ⏳ |
| `S4-12.3-48h曲线.png` | 48h 历史曲线 | ⏳ |

---

*维护人：R2 ｜ 每次联调结束当场填表，不留隔夜账。*
