huankechong/smart-greenhouse/outputs/代码/花房代码/GreenHouse_v1/config.h

#pragma once
/* ============================================================
 *  config.h —— 敏感配置（WiFi / 巴法云凭据）
 *  ⚠️ 本文件含私人信息：
 *     - 交报告 / 发同学 / 传 GitHub 前，把三个值改回 <...> 占位符
 *     - 自用真值版本只保存在本机和 E 盘私档，不外发
 * ============================================================ */
const char* WIFI_SSID = "<你的WiFi名，用手机2.4GHz热点>";
const char* WIFI_PASS = "<你的WiFi密码>";
const char* MQTT_UID  = "<粘贴你的巴法云UID私钥>";  // 巴法云控制台首页可复制
