huankechong/smart-greenhouse/(commit log)

2026-10-18 init: 智能花房养护站全量入库（固件 v1.1 + 9 打印件 STL + 参数化脚本 + 三层文档体系）
    - 固件：GreenHouse_v1 v1.1（审计修复版，AR01）
    - 3D：P0/P1P2/两片式底盘/整机装配，参数化 py 脚本 + STL + 校验链
    - 文档：AGENTS.md + README + docs/（AR02-04 审计报告、交付说明、计划与清单）
    [01_sensor_L_bracket_v1.stl, 01b_sensor_rim_hook_v1.stl, 02_pump_mount_v1.stl, 03_tube_clip_v1.stl, 04_oled_stand_v1.stl, 05_led_diffuser_v1.stl, 06_electronics_base_v1.stl, 06a_base_left_v1.stl]
2026-10-19 docs: AGENTS.md 新增第8节——云端资料库映射表（11 节点 nodeId + spaceId）
2026-10-19 chore(3D): 删除混元文生 3D 的两张遗留预览图
    两个 AI 文生 3D 模型（v1 带台灯 46MB / v2 文生3d 50MB）已于 10-19 移出仓库，
    其遗留预览图随之删除。README 的删除记录同步更新，并把残留的 ../ 相对路径
    改为项目根基准（AGENTS.md 第 6 节约定）。
2026-10-19 feat(3D): 整机示意模型细化 v1.7 —— 电子件特征 + 8 颗螺丝 + 20 根跳线 + 烘焙 AO
    只改装配示意模型，9 个打印件 STL 与四轮几何校验结果一律不动。
    几何细节（24,608 → 33,508 面，glb 33 → 83 个几何体）
    - 面包板：96 孔阵 + 中央沟 + 4 条电源轨（不真打 400 孔，肉眼等价、省 95% 面数）
    - ESP32：USB-C 口 / 两颗按键 / 铜色 PCB 天线 / 金属屏蔽罩
    - 继电器：3 个绿色接线端子 / 红色指示灯 / 光耦
    - OLED：FPC 排线 / 4 针排针 / 驱动 IC；传感器：两根铜探头 + 排针
    - DHT11 正面三道格栅；水泵进水格栅 + 出水嘴
    - 螺丝只画 8 颗 M3×6（底盘连接块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
2026-10-19 feat(firmware): v1.2 异常保护 —— 连浇上限 + 冷却、低水位停泵
    补两条"长期跑必然出事"的缺口，均默认关闭（EN_LEVEL=0），不影响 W1/W2 现有节奏。
    ① 连浇上限 + 冷却
    连续 MAX_ROUNDS_PER_CYCLE(6) 轮浇水后仍判缺水 → 停水冷却 10 分钟、红灯 100ms 快闪。
    触发原因是传感器脱土/排线松/探头被土裹住时，原逻辑会每 33 秒浇一轮无限浇下去。
    ② 低水位停泵
    EN_LEVEL=1 时读 PIN_RAIN(GPIO32)：水位低则拒绝自动启动、拒绝远程手动，
    浇到一半水位掉了也立即停泵。串口 10s 节流，云端上报 水位#低。
    同时完成的结构性改动：
    - waterTick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
2026-10-19 docs(接线): 补线材规格、水泵供电方案、加固施工步骤；忽略本地工具链
    接线规划表从"哪个脚接哪个脚"补全成能照着动手的施工文档：
    - 三·补 每根线用什么线材
    四种线（A 杜邦 18 根 / B 硬芯跳线 / C 22AWG 端子线只走水泵 / D 硅胶软管=水路），
    逐针脚列线序 + 建议色 + 长度。更正原文"水泵线用杜邦线"——3W 泵 600mA，
    杜邦线压接端接触电阻大，改为 22AWG。
    - 四 水泵怎么供电
    三种方案（独立 5V/2A ★★★、单头 5V/3A 分线 ★★、充电宝 ★ 会低电流断电）；
    电流账（稳态 600mA、启动 1.2–1.8A、ESP32 峰值 250mA → 电源 ≥2A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
2026-10-19 feat(3D): AR05 按示意模型优化 4 项——管夹 v2 盆沿双爪/OLED 防脱卡爪/底盘泄漏分流/水管同轴路径
    干涉：花盆×夹 12.3→0、土壤×夹 381→0、水管×夹 471→1.2、花盆×水管 8→0
    验证：12 STL watertight/落床，check_base_fit 全 OK，HTML 无 JS 错误
    [02-01b_sensor_rim_hook_v1.stl, 02-02_pump_mount_v1.stl, 02-03_tube_clip_v1.stl, 02-04_oled_stand_v1.stl, 02-06a_base_left_v1.stl, 02-06b_base_right_v1.stl, 02-06c_joint_block_v1.stl, 02-07_dht11_holder_v1.stl]
2026-10-19 chore: .bak 脚本备份不入库
2026-10-19 docs: AGENTS 映射表补 AR05 云端节点
2026-10-19 chore(privacy): 学号脱敏；内部邮件与资产打包副本移出公开仓库
    仓库是公开的，做一次个人信息收敛（凭据类此前已确认零泄露）：
    - 学号 x20260134 → 删除（固件头注释只保留姓名 + 班级）
    - 两封内部邮件（硬件借用申请 / 学助采购咨询）移出仓库：
    物理文件保留在 docs/private/，该目录加入 .gitignore
    - _待上传_项目资产/（38 个文件、1.1MB 云端资产副本）与清单移出仓库：
    它们是临时打包产物，且其中 03f_固件/GreenHouse_v1.ino 带学号、
    清单里还写明了"含真实姓名+学号"，不适合公开
    - README / docs/index.md / 交接文档的目录树同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
    [02-01b_sensor_rim_hook_v1.stl, 02-02_pump_mount_v1.stl, 02-03_tube_clip_v1.stl, 02-04_oled_stand_v1.stl, 02-06a_base_left_v1.stl, 02-06b_base_right_v1.stl, 02-06c_joint_block_v1.stl, 02-07_dht11_holder_v1.stl]
2026-10-19 docs: ESP32 改为实验室借用；雨滴探测模块取消借用
    - 借用清单：ESP32 移入借用表(#1)，雨滴(26号)整行删除，自购合计 48-81 → 33-61 元
    - 接线表：第 7 节雨滴标注已取消（原方案折叠留档），汇总表划线，红线①去掉雨滴 32
    - 方案书：借用表补 ESP32 行、雨滴行取消说明
2026-10-19 feat(3D): AR06 土壤传感器支架 v2 —— 对齐双爪结构，去掉埋土斜臂
    先核对过：示意图与 01b v1 的几何完全同源（体积 19417.1 三方一致），
    AR05 没碰它。真正落后的是设计语言——管夹已改"盆沿双爪、爪不入土"，
    01b 还是"长斜臂 46mm、埋土 35mm、爪 16mm 深"。
    结构改为：双爪（20×3.5×7，随锥度 8.1°，爪底 z=-7，土面 z=-8 不入土）
    + 整块顶桥（30×19.8×6，向盆内伸出托住夹板柱）
    + 夹板柱（30×12×21，板槽 23.6×1.5 斜 8° 贯穿，两侧留 3.2 壁）。
    板从上方插入、穿过顶桥开口进入土壤，板顶与柱顶齐平即插入深度基准。
    验证：
    打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
    [01b_sensor_rim_hook_v2.stl]
2026-10-19 feat(3D): 按实物实测尺寸校正土壤传感器板与 ESP32
    领导给出量测值：土壤传感器 87 长 / 头宽 23 / 探针段 15 / PCB 厚 1.5；
    ESP32 51.5×28（含 Type-C 突出 53）/ PCB 厚 1.5。
    土壤传感器板（装配示意，不参与打印）
    - 外形从"23×1.6×98 矩形"改成实测轮廓：头 23 宽 30 长 → 收窄到 15 →
    探针段 → 尖头，总长 87，厚 1.5（trimesh 多边形挤出）
    - 板槽随之 1.5→1.4（0.1 过盈）；STL 因槽变薄重新生成，13.6 g 不变
    - 插入后：入土 51mm、露出盆沿 27mm，板顶与夹板柱顶面齐平
    ESP32
    - 从"55×28×11 平躺块"改为 51.5×11×28 竖插姿态（11 = PCB 1.5 + 两侧排针座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
    [01b_sensor_rim_hook_v2.stl]
2026-10-19 feat: 水泵按实测改方形座；固件 v1.3 修继电器上电毛刺
    实物：3W USB 底吸泵，泵体 41×39×30（含出水嘴 37），底脚 32×28，130 L/h、扬程 50cm。
    3D
    - 02 水泵座整套重做：v1 按"φ38 圆柱泵"做的圆筒，实物是方的。
    改为 41.8×39.8 内腔 + 3.5 四面围壁（高 22）+ 3mm 底板中间开 34×30 让底吸口触水，
    外形 57×55×25、24.7 g（原 ⌀58×28 / 21.1 g）
    - 装配里水泵从 φ38 圆柱改为 41×39×30 方块 + 顶部出水嘴，底吸格栅改方形
    - 验证：泵×泵座 0、泵×水箱 0、泵座×水箱 0
    固件 v1.3
    - 继电器改为"先把 OFF 电平写进输出寄存器，再 pinMode"——低电平触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
    [02_pump_mount_v1.stl]
2026-10-19 docs(接线): 补 USB 款水泵的电源接法（不插 ESP32 板载 USB 口）
    - 给出完整回路：充电头 → USB 延长线（剪断）→ 保险 → COM/NO → 泵，GND 直通
    - 三种接法对比：剪延长线（推荐，不动泵）/ USB 免焊端子 / 剪泵线（不建议）
    - 说明为什么不能插 ESP32 的 USB 口：泵启动 1.2–1.8A 会拉垮板子、
    插上去等于绕过继电器（即"一直转"的成因之一）、电脑 USB 口 500mA 会限流
    - 单插座方案：5V/3A 头 + 分线器，泵那一路仍要串继电器
2026-10-19 docs: 全面对账——9 处文档与代码/产物不一致修正
    - 固件 README 升 v1.3，编译数字实跑锚定（全关 269,517B / 全开 901,717B）
    - 根 README：v1.1+6 开关 → v1.3+7 开关；HTML 体积/面数改实测（1.72MB/30,492 面）
    - index/AGENTS/交接文档：AR 指针补 AR06，改"下一个 AR07"
    - 装配交付说明：面数/干涉数改 audit 实测值；已知限制编号错乱重排
    - P0 交付说明：件 2/件 3 补 v2 重设计引言（方形泵座 57×55×25、双爪管夹 11.8g）
    - 方案书：自购表同步 ESP32 改借用、雨滴取消（合计 33–61 元）
    - 交接文档：尺寸清单拆"已实测三类/待实测五类"，斜臂埋土风险标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
2026-10-19 feat(3D): 土壤传感器板按领导手绘尺寸修正；水泵格栅登记落座
    - 板轮廓（board_mesh，示意不打印）：头段 30→15、过渡 4→13.5
    （新参数 board_trans_len）、探针宽 15→13.5、尖端 12→10.5，总长 87 不变
    - 槽无需台肩：过渡段最宽=头段 23 < 槽 23.6 全程容纳，板厚全程 1.5
    → 1.4 过盈槽全程有效；头段 15mm 完整落在 27mm 夹持区内
    - 挂钩 STL 本体零改动（几何不含板）
    - check_base_fit 补登记"水泵进水格栅"(7.8)，复跑全过
    - audit.py doc-check 期望值同步新外形，0 失败
    - 全链重出：glb/HTML/高清图/爆炸图/装配三步/HTML 验证图
    验证：audit 0 !!、跳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
    [audit.py, check_base_fit.py]
2026-10-19 docs: ESP32 维持自购（回退午间借用方案）；新增借用焊接工具
    - 借用清单：借用表加电烙铁+焊锡丝(第7行)，ESP32 回归自购表第1项，合计回 48-81 元
    - 方案书：自购表恢复 ESP32 行，借用表加焊接工具行、删 ESP32 行，保留变更轨迹
    - 接线表雨滴取消状态维持不变（本轮回未改）
2026-10-19 feat: 低水位保护落地——P52浮球+固件v1.4+第10件水箱替换盖 (AR07)
    - 固件 v1.4: EN_LEVEL 改浮球干接点数字读取, 100ms 节流+连续3次消抖,
    LEVEL_WET_CLOSED 极性宏, gLevelReady 防未判稳开泵; 双配置编译 PASS
    (全关 269,517B / 浮球开 270,145B, 均 20% flash)
    - 第 10 件: 水箱替换盖 p10_tank_lid.py -> 10_tank_lid_v1.stl
    (φ142.4x4 板+裙边+φ20x0.8 螺母凸台免垫片+三孔, watertight/单体/z0,
    参数反算 5 类几何检查全过, 51g 免支撑)
    - 接线规划表第 8 节: P52 接线/电平账/安装/万用表验收三步/故障速查
    - 容量账: P52 报警剩 700ml > 单轮上限 650ml (P43 只 578ml 故改单)
    [10_tank_lid_v1.stl]
2026-10-19 docs: 文档链同步 AR07——打印件 9→10、采购清单增浮球水箱删 220Ω/垫片
    - AGENTS/index: AR 指针推进到 AR07, 下一个 AR08; 接线表 7→8 器件
    - README: 第 10 件水箱替换盖入目录表, 合计打印 18→20.5h
    - 交接文档: v1.3 变更头注(AR07 落地), 预算 48–61→76–89, 进展表 10 件+v1.4,
    待测清单加桶口三尺寸/P52 复测, LEVEL_DRY_RAW 行标已解决
    - 方案书/借用清单: +P52 浮球×2+1L 桶×5(已下单), 220Ω 与硅胶垫片确认不买
2026-10-19 docs: 借用清单新增万用表（数字式，调试测量用）
    - 借用表第 8 行：万用表 ×1 台（直流 0-20V/通断档/电阻档，用毕即还）
    - 方案书借用表同步；申请单 docx/pdf 与 HTML 源已重制（借 9 项）
2026-10-19 docs: 采购清单重排必买/已买/不买；元件规格定稿；保险豁免
    - 清单结构改为 2.1 必买(仅花盆绿植) / 2.2 已买(10 项按订单) / 2.3 不买(3 项豁免)
    - 规格定稿: 1kΩ 1/4W(功率 10.9mW, 余量23倍); 硅胶线 40×0.08≈0.2mm² 硅胶200℃
    (识别虚标: 17×0.1=0.13mm² 冒充22AWG); 1N4007 58mm/0.7mm 粗脚; 绿联USB2.0 1m
    - MF-R110 保险豁免: 正规2A电源过流保护+固件冷却兜底(换杂牌电源再补)
    - 接线表: 线材采购参数表 + 杜邦信号可以/泵不行 + 二极管位置(泵回路非面包板)
    - .gitignore: 排除会话截图备份(含订单页个人信息)
2026-10-19 docs: 30天计划进度快照同步借用最新口径（ESP32自购、新增焊具万用表）
2026-10-19 docs: 交接文档升 v1.4——记录借用定版与旧口径修正（ESP32 自购/焊具/万用表）
2026-10-19 AGENTS: 云端映射表补登 AR06/AR07 节点（2026-10-20 补传）+ 作废节点备注 + AR01 未上传说明
2026-10-19 AGENTS: 云端映射表补登 AR01 节点（2026-10-20 补传），AR01-AR07 全集上云
2026-10-19 AR08: 全代码五维审计——固件 v1.5（连浇上限失效修复/水位保护全覆盖/MQTT大小写/标定防呆），15 发现 4 修复
    [GreenHouse_v1.ino]
2026-10-19 固件 v1.5.1：水位断泵改按 waterState 判定（relayIsOn 电平门在状态2是死代码）；AR08 报告同步重构记录与四场景验证
2026-10-20 清理作废3D件: 删除概念模型/01/01b_v1/05/06_electronics_base及其配套图, 脚本与文档同步
    - 删除: 花房3D概念模型/(6文件), 01_sensor_L_bracket_v1, 01b_sensor_rim_hook_v1,
    05_led_diffuser_v1, 06_electronics_base_v1, 2张作废预览图, 旧P0三件总览
    - p1p2_models.py: BUILDERS 摘除05/06, 参数区/函数/标题同步(五件->动态N件)
    - p0_models.py: BUILDERS 摘除01, 总览图名/标题改动态(三件->2件)
    - audit.py: P1P2校验摘除05_led_diffuser项(23项检查全OK)
    - check_report.json x2 重生成; P0/P1P2总览图重生成(实测核对)
    - README/整机装配说明/底盘说明 活引用更新, 历史快照文档不动
    - 本批同时收录 AR08/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
    [01_sensor_L_bracket_v1.stl, 01b_sensor_rim_hook_v1.stl, 05_led_diffuser_v1.stl, 06_electronics_base_v1.stl, 06b_base_right_v1.stl, 10_tank_lid_v1.stl]
2026-10-20 AR11 知识库全面审计：修 AR 编号重复 + 25 处文档-代码不一致
    - AR08 编号被圆桶化与代码审计重复占用，代码审计报告 git mv 改号 AR10（保留历史）
    - 固件版本全线 v1.3 -> v1.5.1（AGENTS/README/index/30天计划/交接文档/固件README）
    - 开发环境版本纠正：esp32 板包 2.0.17 -> 2.0.18-arduino.5，arduino-cli 1.5.1 -> 1.5.2-rc.1
    - 打印件 9 -> 10 件，打印工时 18h -> 20.5h（逐件表重算）
    - audit 校验 STL 数 11 -> 10（实跑），HTML 1.72MB/30492 面 -> 1.87MB/34734 面（实测）
    - README 校验脚本路径补 outputs/ 前缀，重建命令补水箱盖 p10_tank_lid.py，补 check_wires.py
    - 邮件借用类数 9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
2026-10-20 云端空间记录修正 + AR11 补传状态回填
    - AGENTS.md 第 8 节：原只记一个 spaceId，实际云端有两个空间，
    改为并列记录 —— Hy2wV7oRfX7RRRIJcFEXYU「花房」装主文档，
    TESQXngJ4tIC1hKd2ccd9p 装 AR01-AR11 报告与 drive 文件夹
    - AR11 第六节：AR08/AR09/AR10 补传云端已完成（划掉原"未处理"条目），
    新增"云端主空间文档仍为旧版"待办说明
    - AR11 第三节：同步更正 AGENTS 映射表相关表述
    双端（E 盘镜像）md5 校验 19/19 一致。
2026-10-20 云端资料库停用：改以本地 git 为唯一生产源
    领导 2026-10-20 决定不再做云端资料库同步，云端花房文档已手动清空。
    - AGENTS.md 第 8 节整节重写为「云端已停用」：删除 19 条已失效 nodeId
    映射表（节点已不存在，留着是误导），改为「唯一生产源 = 本地 D 盘 git，
    E 盘镜像为第二副本；改文档只改本地 + commit，不再上传云端」，
    并留档停用原因（云端旧版脱节 + 覆盖式更新成本高于收益）
    - AR11 报告第六节：补第 7 条「云端停用裁定」，第 1/2/6 条按事实更新；
    标注误传的 README 节点 nodeId BUqqrRK4Roi6B84K0gkC04 属多余残留
    - out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
2026-10-20 邮件模板 v1 标注作废 + index 口径修正
    - docs/private/硬件申请邮件模板.md（v1，10/17 已发）：加作废标注，
    指向现行版 v3，并列出三处差异（雨滴取消 / 新增焊接工具+万用表 / 8 类非 7 类），
    避免日后误发旧版
    - docs/index.md：邮件表把 v1 描述改为「已作废勿再发，仅留档」，
    v3 标为「现行版（待发）」
    顺带核实：private 三份文件 D/E 双端 md5 一致；10 个 STL 实存齐全；
    固件 config.h 三个凭据仍为占位符（未泄真值，符合预期）。
    E 盘同步 2 份，md5 校验一致。
2026-10-20 云端清空状态确认：销账最后一条残留
    领导已手动删除云端误传的 README 节点（BUqqrRK4Roi6B84K0gkC04），
    云端花房内容零残留。
    复核方式（6 组关键词交叉）：library_search 搜"花房 / GreenHouse /
    智能花房养护站 / README / 打印件 / 传感器"全部零命中；同期搜无关空间
    "资料库的100种用法"正常返回 → 证明检索通道可用，确属内容已清空而非
    检索故障。
    - AR11 报告第六节第 7 条：补清空确认与复核方法
    - AGENTS.md 第 8 节：补「清空状态已确认」条目，明示云端不再是任何信息来源
    E 盘同步 2 份，全量 23 份关键文档 md5 逐份比对 23/23 一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
2026-10-20 AR13 云端清空销账 + E 盘分桶对照表补全
    云端彻底收尾：
    - 领导手动删除云端花房文档（含我误传的 README 节点 BUqqrRK4Roi6B84K0gkC04）
    - 复核：library_search 搜「花房/GreenHouse/智能花房养护站/README/打印件/传感器」
    6 组关键词全 0 命中；同期搜无关空间正常返回 8 条 → 证伪检索故障，确属已清空
    - AGENTS.md 第 8 节补「清空状态已确认」；AR11 第六节第 7 条补确认
    E 盘分桶规则成文（此前只活在报告里，正是"误判缺 3 文件"的根因）：
    - AGENTS.md 第 6 节新增 8 行分桶对照表 + 硬规矩「判定文件缺失必须做
    内容级校验，不能只靠 [ -e ]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
2026-10-20 W1 标定工具链 + 到货点火指南（ESP32/土壤传感器到货）
    硬件到货后进 W1-D3/D4 点火，本轮把"实测标定"这一环工具化：
    - W1_SoilCalib.ino：标定专用固件，连续输出 RAW,<millis>,<raw> CSV
    （单开 ADC 采样，不掺主程序逻辑；已编译 268,909 B / 20% PASS）
    - soil_calibrate.py：PC 端标定助手，扫端口 → 干/湿两阶段采样 →
    中位数 ±8% 剔异常 → 取中位数 → 回写主程序 SOIL_RAW_DRY/WET
    干湿差 <800 或方向填反时拒写，防止把错误标定值写进固件
    - test_soil_calibrate.py：离线自测 16 项（剔异常/统计/回写/阈值），不依赖硬件
    - docs/W1到货点火与标定操作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
2026-10-20 W1 无烙铁接线方案（实验室焊接工具未借到）
    土壤传感器到货但排针未焊，实验室电烙铁/焊锡丝/万用表全部未借到。
    焊接不是标定的前置条件：标定只需把 AOUT 的模拟电压送进 GPIO34。
    新增 docs/W1无烙铁接线方案_2026-10-20.md，四条免焊路径：
    - A 杜邦线公头直插（首选）：公头方针 0.64mm 对角 0.9mm，可直接插入
    模块 PCB 约 1.0-1.2mm 焊孔，靠孔壁夹紧，标定精度无影响；
    含"丝印不能猜"的逐根接线纪律、四个易踩坑对照表
    - B WAGO 221 快接端子（10/19 已自购），接触电阻更小
    - C 换同款"已焊排针"模块 5-8 元（推荐作正式方案，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
2026-10-20 更正：继电器模块不需要焊接（上一版属未经核实的推测）
    上一版交接文档与接线方案都写了"W2 的继电器模块也可能需要焊"，
    这是我没有核实就下的判断。已逐项核对《花房接线规划表》线序表：
    DHT11(借41) / OLED(借25) / 继电器(借16) / 双色LED(借13) / 光敏(借32)
    —— 全部为带排针的模块，走 A 型母对母杜邦线直插，不需要焊接
    P52 浮球开关 —— 干接点接螺丝端子 + 1kΩ 上拉，也不涉及焊接
    全项目只有土壤传感器一块需要焊，因此借不借到烙铁都不阻塞
    W1 收口与 W2 系统集成。烙铁仅在需要永久连接或加装金属端子器件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
2026-10-20 实物照片核对：丝印是 GND/5V/OUT，接 3V3 的理由补全
    领导发来土壤传感器到货照片（正反面各一），读出丝印后有三处与
    文档不符，据实修正：
    1. 针脚名：实物丝印是 GND / 5V / OUT，不是通用模块常见的
    VCC / GND / AOUT。接线规划表两处（分表 + 线序表）已改。
    2. 丝印写 5V 与"必须接 3V3"表面矛盾，补全理由：
    - v2.0 内置稳压，工作范围 3.3-5.5V，3.3V 供电在规格内
    - ESP32 的 ADC 不容忍 5V，而 v2.0 在全供电范围内输出恒为
    0-3.0V，所以接 3V3 不会让输出变小，正好占满 ADC 量程
    - 补充 ESP32 3.3V 供电下的典型值：干约 2.9V/3600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
    [W1_SoilCalib.ino, soil_calibrate.py]
2026-10-20 W1 标定受阻：杜邦线/面包板也借不到，转物料解决路径
    杜邦线与面包板均借不到，至此标定所需三样（板子被识别 / 接线 /
    焊接）同时缺失，W1-4.1 实测标定今天无法执行。属物料问题而非技术
    问题：工具链已就绪，条件一到位立刻可跑，无需再做任何软件准备。
    无烙铁接线方案新增：
    - 「受阻记录」节：列清四项缺失状态、三条恢复条件（借到线 / 下单
    带针模块 / 借到任一含公头的线配 WAGO）
    - 方案 E 一次性下单清单：杜邦线 + 面包板 + 已焊排针土壤模块，
    共约 15-25 元，其中面包板与杜邦线本就是项目通用必需品（W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
2026-10-20 docs: 补 GitHub 提交手册与提示词，AGENTS 增 §4.1 Git 提交规范
    - 新增 docs/GitHub与Agent提交代码_零基础手册_2026-10-20（MD + HTML 排版版）
    - 新增 docs/GitHub提交提示词_Agent自装自提_2026-10-20（六步主提示词 + 3 变体 + 红线）
    - 新增 docs/花房4人分工方案_2026-10-20
    - AGENTS.md 新增 §4.1：本机 Git/GCM 现状与提交规范（不重装 Git、认证走 GCM、身份已全局配好）
    - index.md / README 目录表 / 交接文档 §五地图 同步登记新文档
2026-10-20 W1标定受阻：时间红线+EN_WATER硬规矩+恢复安全态
    - 主程序补标定常量警示注释：SOIL_RAW_DRY/WET 为通用资料估值，未实测前
    EN_WATER 必须保持 0（估高→静默不浇/花渴着；估低→反复浇/盆泡烂）
    - 无烙铁方案新增受阻记录节：四项缺失状态+时间红线（10/26前到货不受结构性
    影响）+EN_WATER 硬规矩
    - 30天计划 W2 风险段后新增⛔头号前置：先确认 8.1 已回填实测常量
    - 同步 GitHub/Agent 提交手册与4人分工方案、index 导航
    - 丝印统一为 GND/5V/OUT（正反面顺序相反）
    - 双形态编译验证：全关 269,517B/20% PASS，全开 902,181B/68% PASS
    - 工作区已从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
2026-10-20 物料解困：学校有杜邦线+面包板可借，降级为兜底并补板子排查
    - 确认学校有杜邦线/面包板可借 → 无需购买，卡点从"三样全缺"收窄为
    仅剩「ESP32 板子未被电脑识别」
    - 无烙铁方案：受阻记录节改写为「物料状态更新」，新增板子识别三路排查
    （换线/换口/查设备管理器 + 插拔时有无新条目闪现的快速判定法）
    - 方案 E 降级为兜底：杜邦线与面包板从清单划掉，仅留「已焊排针土壤模块 5–8 元」
    - 借用清单：第6项标注已确认可借；电烙铁第7项降级为可选（当前走免焊方案）
    - 30天计划：物料状态段落更新
    - 交接文档升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
2026-10-20 卡点已破：ESP32 识别成功(COM6)，标定固件已烧录，新增接线自检工具
    实测（2026-10-21 01:00）：
    - board list → COM6；设备管理器 → USB-SERIAL CH340 (COM6) 状态 OK
    VID=1A86 PID=7523。此前"枚举不到设备"的原因就是板子当时没插
    - W1_SoilCalib 编译+烧录成功（269,280 B，Hard resetting via RTS pin）
    - 串口稳定输出 RAW CSV 10Hz
    - 未接传感器时 raw 稳定 95–105（≈0.08V）= GPIO34 悬空特征值
    新增：
    - outputs/花房代码/tools/soil_watch.py 接线自检 + 实时看板
    自动判定：<200 未接 / >4000 悬空 / 几百~三千多=通了
    - 文档新增实拍丝印位置图（30脚 ESP32-DevKitC，USB口朝下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
    [soil_watch.py]
2026-10-20 定案：焊接排针方案（排针随传感器赠送，只缺烙铁）
    - 领导放弃免焊路线（公头直插/硬芯线），改回焊接排针
    - 前提：买土壤传感器时随附 1×3P 单排针 → 排针不用买，只缺电烙铁
    - 新建 docs/土壤传感器焊接操作卡_2026-10-21.md
    焊接顺序 GND→OUT→5V、每点2-3秒锡铺小锥形不堆球
    面包板当治具固定排针、万用表通断档验证
    焊完用母对母线接三根（套件第9项公对母的母头半边）
    自检→标定→烧回主程序全流程命令
    - 借用清单第7项电烙铁由可选改回必需；万用表标注建议一并借
    - 点火指南步骤1改写为指向焊接操作卡
    - 免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
2026-10-23 AR14 硬件到货实拍核对：套件元件包确认到货，继电器实为插座底座待核
    核对方法：RapidOCR 读标签 + PIL 超放大（最高8×）目视复核，型号均来自实拍标签
    已确认到货：
    - 实验室A套件元件包（批次689711）：G-13-13-3/5 硅胶线红黑各8米、
    A-4-2-1 1/4W金属膜电阻30种×10、瓷片电容包、G-12-1-3 直插包、
    蜂鸣器×2、装片电阻表(120~100K)
    - 自购件：P52浮球开关（白圆柱+M10螺纹+黄引出线）、绿联USB延长线、
    1N4007、304防松螺母DIY套装TZ234（超清单）
    ⚠️ 关键待核：4颗"继电器"是插座底座不是继电器模块
    - 壳内无PCB，仅金属簧片+橙色标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
2026-10-23 更正：4颗透明壳器件实为万可 WAGO 221 快接端子（非继电器插座底座）
    领导指正「是万可的连接头」+ 联网查 WAGO 官方规格（wago.com 221-413），
    标签 7 项特征逐条对上：
    AWG 24-12 / 0.14/0.2-4 / 450V 32A(IEC) / SET 20A(UL 486C 20A/600V)
    / Cu 1.6/2(镀锡铜条) / 透明壳+橙色拨杆 / UL 标志
    → 确认为万可 WAGO 221 系列快接端子
    连带两个实质好处：
    - 就是 10/19 自购的「WAGO 221-413 ×2（泵回路三通节点）」，到货 4 只
    （计划 2 只）→ 泵回路接线端子实物在手，450V/32A
    - 免焊方案 B（硬芯线+WAGO 221）立刻可行——原依赖「待到货」，
    现在烙铁借不到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
2026-10-23 继电器时间线闭合：10/26 周一可借到，与 W2-D8 原计划同天零延误
    领导告知：继电器模块（套件第16项）10/26（周一）可从实验室借到
    排期核对：
    - D7 10/25 周日：买花盆 + 合并代码（7.2/7.3）→ 纯软件，不受影响
    - D8 10/26 周一：8.1 继电器接入 + 8.2 水泵联调 → 继电器当天到，零延误
    - D9 10/28 周三：9.3 第一次全自动浇水成功
    ✅「买光耦隔离MOS管模块 3-5元」建议作废；主程序 EN_WATER 逻辑不用改
    ⚠️ 但真正卡点从继电器转移到「标定」：
    9.3 里程碑要求 EN_WATER=1 → 要求标定完成（常量回填实测值）→ 卡在烙铁
    （借用清单第7项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
2026-10-23 烙铁不再是卡点：10/26 一次性全给，标定有三档退路；7.2 软件已验证
    领导确认：
    - 10/26 实验室一次性全给（传感器模块+面包板+杜邦线+继电器）
    - 电烙铁+焊锡丝「不确定」
    关键判断：烙铁不确定 ≠ 标定做不了
    - 档A（首选，零工具零等待）：公对母线公头方针0.64mm 直插传感器
    1.0-1.2mm焊孔，靠孔壁夹紧 → 母头插ESP32排针
    套件第9项本就是「40公对母」，公母各半
    - 档B（烙铁到货）：焊1×3P排针，永久连接更体面
    - 档C（无公头线）：WAGO 221 免焊（端子已到货4只），需剥线最麻烦
    - 最坏档只剩「既无公头线又无面包板」→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
2026-10-23 打印窗口重排：11/5 → 10/27+10/29（原排期与死线撞车）
    领导告知：周末打不了印（实验室拓竹 X2D 周末不开，只能工作日预约机时）
    核查出原计划两个硬缺陷：
    ① 打印开始日 D14 = 死线当天（11/5 开始、11/6 才打完 → 交首版已超期
    1 天，且 11/7 进 W4，零返工窗口）
    ② 10/31、11/1 两个周末不可用（11/1 是 D11 巴法云，宿舍纯软件不受影响）
    ✅ 重排为 10/27（二）打底盘两片 06a/06b 12.2h → 10/29（四）打其余八件
    8.3h → 10/30 取件当天即试装 → 11/2-11/4 补打偏差件（只补改动件）
    → 11/5 死线当天只做装配复检与整机走线
    净收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
2026-10-23 AR15 打包桶实测尺寸修订：桶口外径124非136，3D全链重出并验证通过
    领导提供到货实测：桶底直径105 / 桶口内径120 / 外径124
    🔴 商品页标的"上径136"是错的（实测124，差12mm）
    136 推测是含提手凸缘的最大外径，桶本体口沿外径仅124
    原水箱盖按136建模 → 裙边内径136.8套在124外壁上晃12mm环、完全咬不住
    脚本改动（3处 + 校验脚本）：
    - p10_tank_lid.py: bucket_mouth_od 136→124 → 裙边内φ124.8、盖外φ130.4（派生自动跟随）
    - base_2pc_models.py: tank_d 108→107
    - build_assembly.py: 桶常量实测化(BUCKET_*) + 替换盖4处硬编码半径(71.2/68.4)改常量派生
    - che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
    [10_tank_lid_v1.stl]
2026-10-23 AR15 补完：桶口最外侧132(加强翻边) + 桶高127，3D 全链重出并通过
    领导分两次补齐实测：先「桶口最外侧132」再「桶高127」
    结构判读（三轮实测定案）：
    桶口剖面 = 内壁φ120 │ 桶身口沿φ124(壁厚2) │ 加强翻边最外φ132(外凸4)
    → 盖板必须压在翻边顶面、裙边套翻边外径132；按124做盖板会浮空6.4mm
    → 商品页标的136应是含提手座的最大外径
    改动：
    - p10_tank_lid.py: bucket_mouth_od 124→132、bucket_h 120→127、skirt_h 8→6
    （裙边高必须≤翻边高，否则底缘顶在翻边下台阶装不进）
    → 盖外径φ138.4、裙边内φ132.8×6、45.9g、模型总高10
    -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
    [10_tank_lid_v1.stl]
2026-10-23 花盆规格定案：三约束写入清单与30天计划
    从零件参数反算出花盆的三个硬约束（非估）：
    ① 盆底外径 ≤60mm（底盘凹槽 pot_d=62）—— 底径40的盆在槽里可横移11mm/边
    ② 盆壁厚 ≤6mm（01b 挂钩 rim_gap=6.2）—— 太厚夹不进，传感器板会掉
    ③ 锥度 ≤8.5°（01b 挂钩 taper）—— 最隐蔽：盆太陡双爪会咬进盆壁
    （AR05 已踩过：花盆×夹 12.3mm³）
    结论：口径8/底径4/高8 不可用（锥度14.04° 超限5.5° + 槽里太松）
    推荐：口径8cm/底径6cm/高8cm 锥形盆（锥度7.13°，槽内横移1mm/边）
    备选：直筒盆 φ6cm×高8~10cm（锥度0，最不容易出错）
    若坚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
2026-10-23 底盘+挂钩改配 8×8×8 直筒树脂盆（φ80），全链重出并验证通过
    领导确认用 8×8×8 直筒树脂盆（外φ80×高80，壁厚约3），原底盘φ62槽装不下
    → 改模型适配，不改买什么
    脚本改动（4个文件，仅改参数）：
    - base_2pc_models.py: pot_d 62→82、pot_pos (-105,60)→(-111,60)
    （φ82槽右缘-70，距继电器槽-62留8mm；原位置仅剩2mm太薄）
    - p0b_sensor_hook.py(01b): taper 8.1→0、rim_gap 5.6→4.6、wall_mid_y -0.5→0
    - p0_models.py(03管夹): taper 8.5→0、rim_gap 6.2→4.6
    - build_assembly.py: POT位置、盆几何改φ80恒定×高80、RIM_R (37+40)/2
    直筒盆锥度0 → 挂钩双爪垂直下探，只会离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
    [01b_sensor_rim_hook_v2.stl, 03_tube_clip_v1.stl, 06a_base_left_v1.stl, 06b_base_right_v1.stl]
2026-10-23 水管按实测改 φ10 外径（内8.5）：管夹孔+水箱盖孔+装配模型同步
    领导实测：硅胶管内径 0.85cm=8.5mm，外径 1cm=10mm（原假设 φ8）
    模型改动（3处）：
    - p0_models.py(03管夹): tube_od 8→10、ring_inner_d 8.6→10.6
    - p10_tank_lid.py(水箱盖): tube_hole_d 10→12
    ★ 关键：原孔 φ10 恰等于管外径 → 零间隙，且 FDM 打印孔会收缩
    0.2~0.4mm，实际只有 9.6~9.8，10mm 的管根本塞不进去 → 必须提到 φ12
    - build_assembly.py: 水管半径 r=4→5
    文档同步：
    - 接线规划表 D 行: φ4×φ8 → φ8.5×φ10（实测）
    - P0 交付说明: 管孔内径 8.6→10.6、03管夹 11.8→10.9g
    - 水箱盖交付说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
    [03_tube_clip_v1.stl, 10_tank_lid_v1.stl]
2026-10-23 01b/03 改方案B土插式（不夹盆沿），装配几何同步，全链验证通过
    起因：实盆 8×8×8 直筒树脂盆，壁厚 10~20mm 范围太宽 —— 刚性双爪无法同时覆盖
    （按10设计则壁20撑不开、按20设计则壁10合不拢，两种都会废件）→ 弃用夹持。
    01b 传感器支架（p0b_sensor_hook.py）：
    - 双爪+顶桥 → 两条插土腿（x向薄片，板槽两侧各一，深35）
    - 夹板柱 col_x 30→36（给腿让位，壁厚6.2）、col_h 21→36（=土面到板顶）
    - 新增参数 soil_gap/leg_depth/leg_t/leg_w/leg_x/leg_y；旧盆沿参数标[已弃用]留档
    - 坐标基准改为 z=0 是土面；metadata 增 soil_top_z（rim_top_z 保留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
    [01b_sensor_rim_hook_v2.stl, 03_tube_clip_v1.stl]
2026-10-23 01b/03 二次减薄：给两株薄荷让土面，占土面 32%→17.5%
    领导反馈支架太占盆内空间，要种两株小薄荷
    减薄改动：
    - 01b 传感器支架：col_x 36→30、col_d 12→10；腿从「X向两侧薄片」改为
    「Y向前后两条宽片(26×2.5)」——不占柱宽，同时避开中间板槽
    → 30×10×71，17.6g，watertight 单体
    - 03 管夹：30×16 → 15×15 窄版（针 2.0×6.0，针心±5.5）
    → 15×15×41，3.4g，watertight 单体
    土面账（盆内腔φ60 = 2827mm²）：
    原：01b 432 + 03 480 = 912 = 32%
    新：01b 300 + 03 225 = 525 → 实测 496 = 17.5%
    剩给薄荷 2331mm²（两株φ35根域需1924mm²）→ 够了
    ⚠️ 走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
    [01b_sensor_rim_hook_v2.stl, 03_tube_clip_v1.stl]
2026-10-23 01b 三次减薄到 27×6（土面占 162mm²），腿改「柱下潜+土里鳍」
    领导要求再薄一些
    核心思路转变：鳍放在土面以下就不占土面
    - 原来「两条腿」在 y 方向张开到 27×10 → 占土面 300
    - 现在「柱子 27×6 直接向下延伸进土」+ 土里两侧稳定鳍(27×5.5×高20)
    → 土面上方只留 27×6 = 162mm²（实测截面确认）
    → 抗倾覆靠土里的鳍（张开到 27×15，力臂 7.5mm）
    改参数：
    - col_x 30→27（板槽23.6 + 两侧壁1.7，过盈挤压方向不靠它）
    - col_d 10→6（板槽1.4 + 两侧壁2.3，过盈张力方向要留够壁）
    - 腿 → 柱体下潜 + fin_h 20 / leg_t 5.5 / fin_bury 1.0（伸进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
    [01b_sensor_rim_hook_v2.stl]
2026-10-23 docs: 全量刷新预览图（爆炸图/高清四视图/装配三步/P0总览），模型三轮改动后同步
2026-10-23 移除 02 水泵固定座：泵自带吸盘，直接吸桶底
    领导指出水泵自带吸盘，不需要打印固定座
    - build_assembly.py：删掉泵座，水泵直接吸在桶内底；吸盘本身垫高约2~3mm，
    吸水口仍有间隙 → 泵的 z 不用改（原来的 3mm 由打印座提供，现在由吸盘提供）
    - check_base_fit.py：删「水泵固定座」落座期望，水泵说明改为「桶内底+吸盘垫高」
    - 交付说明：02 标注「⛔ 作废，勿打印」
    收益：
    - 少一个打印件（省 24.7g + 一次机时）
    - 腾出桶底 3135mm²（泵座 57×55 原占桶内底 36%）→ 水位/浮球空间更宽松
    - 装配几何体 89 → 88
    验证（全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
2026-10-23 全面审计（neat-freak）：9 个文档对齐四轮模型改动，补 MEMORY.md 索引
    体检：AGENTS 119行/11.5KB · README 116行/7.6KB · docs 492KB > memory 220KB（未倒挂）
    缺口：memory 目录缺 MEMORY.md 长期笔记索引 → 已补（69行/4KB）
    修复的不一致（🔴 事实错误，优先）：
    1. 打印件数量 10 → 9（02 水泵座 2026-10-24 作废，泵自带吸盘）
    - README §三 标题 + 整张表重写（01b/02/03/06a/06b/10 六行全过期）
    - AGENTS §6.5、30天计划(3处)、4人分工(2处)、W1无烙铁方案、交接文档
    2. README 目录注释「01b 盆沿挂钩/02 水泵座/03 水管夹」→ 现行件名
    3. 06b「φ108 圆槽」→ φ1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
2026-10-23 备份 2026-10-23 到货照片 5 张（微信 temp 会被清理）
    领导提醒：发的照片有没有备份 → 之前没备份，只做了 OCR
    风险：原始照片在 xwechat_files/.../RWTemp/2026-10/（微信临时目录，会定期清理）
    AR14 报告引用这些照片作证据，但图片本身未入项目 → 证据链会断
    已做：
    - outputs/到货照片备份_2026-10-23/ 存 5 张原图（7.5MB），逐张 md5 校验一致
    - 命名规则「序号_内容摘要_原hash前8位.jpg」，保留可回溯性
    - 该目录 README.md 记录：每张的内容 + 核对结论 + 原件全 hash + 命名规则
    - AR14 报告「一、照片清单」加备份指针（说明为什么必须备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
2026-10-23 AR16 全量技术审计（独立重审）：4658行/27文件，2项P0 + 4项P1
    按领导要求，不受此前 AR01-A15 结论影响，重新独立核查代码/配置/依赖/文档
    审计范围：固件(521行) + 建模脚本5个 + 装配校验脚本8个 + 标定工具3个
    + verify_html.js + 配置 + 依赖 + 文档(13篇+15篇AR)
    9 个维度：代码质量/安全性/性能/依赖/license/配置/错误处理/边界/测试/可维护性
    实跑验证（证据）：
    - 固件默认配置编译 ✅ 269KB/20%
    - 固件全 7 开关编译 ✅ 902KB/68% RAM14% → 「10/26 现场不调代码」承诺成立
    - Python 标定自测 16 项全过 ✅
    - git 历史凭据扫描：仅占位符，零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
2026-10-23 水箱盖重大修正：桶口是两级台阶，裙边改阶梯式；并修掉凸台被挖空的隐藏缺陷
    领导手绘图 + 实拍特写确认：桶口不是我原以为的单级翻边
    真实结构（剖视）：
    上段 5mm 外径 φ124（桶口最上面那圈）
    下段 2mm 向外凸出的环（φ124~132 之间，待实测，暂取132）
    旧版单级裙边 φ132.8×6 的实际咬合 = 0：
    0~5mm 段桶壁 φ124，裙边 132.8 -> 悬空 4.4mm/边
    5~6mm 段才碰到凸出环 -> 只咬 1mm
    盖子只是"搁"在桶口上，一碰就偏
    改为【两级阶梯裙边】：
    上段孔 φ124.8 × 高5 -> 套 φ124，径向隙 0.4/边 紧配
    下段孔 φ132.8 × 高2 -> 套凸出环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
    [10_tank_lid_v1.stl]
2026-10-23 修 AR16 全部 P0 + 3 项 P1，并出 AR17 重审（2 个 P0 清零，健康度 B-→A-）
    ## 修复（AR16 提出的 6 项）
    P0-1 依赖清单：
    - 新建 requirements.txt（5 包版本约束，经实装校验）、package.json、platformio.ini
    - 修正过程：初版写 trimesh>=4.0,<5 但实装是 5.1.1 → 会降级破坏脚本，已改 >=5.1,<6
    P0-2 map() 除零：
    - 新增 safeMap()（inMax==inMin 时返回 outMin=100 → 判不缺水 → fail-safe）
    - setup 标定非法改为【硬停机】红灯快闪（不再只是 Serial 警告）
    - 边界穷举 8 组验证：0/4095/2250/未标定 全部正确
    P1-1 开关依赖守卫：加 #error，反向编译验证 EN_MQTT=1&WIFI=0 时明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
    [GreenHouse_v1.ino]
2026-10-23 docs: index 补 AR17 行（上条 commit 因引号转义遗漏）
2026-10-23 拓竹 X2D 实切 9 件：实测 8h02m / 325g（原估 19h，少 58%）
    领导确认机型 = 拓竹 X2D → 查官网规格（bambulab.com/zh/x2d/specs）：
    打印尺寸（主喷嘴单喷嘴）256×256×260mm · 标配 0.4mm 喷嘴 · 支持 PLA
    → 160×230 的底盘两片完全放得下（余量 96×26），无需拆分
    → 之前担心的 A1 mini 180×180 放不下 230 不成立
    用 Bambu Studio CLI 实切 9 件（预设 Bambu Lab X2D 0.4 nozzle + 0.20mm Standard + PLA Basic）：
    覆盖参数 --wall-loops 3（预设默认 2，按项目要求加到 3）+ 逐件 brim 3/5/8mm
    总切片耗时 7.2 秒，9 件全部成功
    实测打印时间（来自 gcode，非估算）：
    01b 3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
    [01b_sensor_holder.3mf, 03_tube_clip.3mf, 04_oled_stand.3mf, 06a_base_left.3mf, 06b_base_right.3mf, 06c_joint_block_x2.3mf, 07_dht11_holder.3mf, 08_cable_clip.3mf]
2026-10-23 build: 加 .gitattributes 禁止 gcode/stl/3mf 行尾转换（保护打印机文件）
    问题：git 警告 gcode 的 LF 将被转为 CRLF。gcode 对行尾敏感，
    转换后可能影响打印机解析（尤其跨机器 clone 后）。
    已验证：当前工作区与 git 对象里的 gcode 均为纯 LF（0 个 CR），未损坏。
    规则：
    - * text=auto eol=lf 默认统一 LF
    - *.gcode/*.3mf/*.stl/*.glb/*.npz/*.png/*.jpg -text 禁转（二进制/行尾敏感）
    - *.py/*.ino/*.h/*.js/*.md/*.json/*.txt/*.ini text eol=lf
    - *.bat/*.cmd text eol=crlf Windows 脚本保留 CRLF
    顺带根治本会话反复踩的 CRLF/LF 混用问题（多次导致字符串匹配失败）。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
2026-10-23 docs: 加打印上机操作卡（三种分批方案 + 上机顺序 + 故障处理 + 验收清单）
    领导对实验室连续机时不确定 -> 给可不依赖该信息的默认方案
    方案 A（≥5.5h）: 底盘两片 5h | 小件七件 3h01m 2 批
    方案 B（3h，默认推荐）: 06a 2h27m | 06b 2h32m | 小件 3h01m 3 批 ← 每批≤3h，怎么都不超
    方案 C（1.5h）: 5 批
    上机顺序（有讲究）:
    1. 先打 06c 连接块（7 分钟）试机 —— 最简单最便宜，验证机器/参数/附着力
    打完用 M3 自攻试拧 φ2.8 孔，手感有阻力不裂才算过
    2. 再打底盘两片（5h，brim 8mm 必开，冷却到 40℃ 以下再取）
    3. 最后小件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
2026-10-23 docs: 30天计划补「机时不确定→默认方案B」与 06c 试机指针
2026-10-24 固件首次实机烧录验证通过：AR16 防除零硬停机在真板上确认有效
    领导插上 ESP32（COM6）后补做 AR17 一直缺的实机验证
    ## 1. 烧录通路（10/26 联调的最大风险，已排除）
    - 编译 269,417B(20%) -> 烧录写入 269,776B -> Hash verified -> 自动复位
    - COM6 识别为 Serial Port (USB)，CH340 驱动正常
    - 板卡名 Unknown 属正常（转串口芯片无 USB 描述符）
    - 注：COM3/COM4 是领导其他设备，ESP32 是新出现的 COM6
    ## 2. 正常启动日志（实测原文）
    ===== 智能花房养护站 v1.6 启动 =====
    功能开关: DHT=0 OLED=0 WATER=0 LEVEL=0 WIFI=0 MQTT=0 WEB=0
    标定: dry=3200 wet=1300 缺水阈值=35%
    [数据]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
2026-10-25 补 RelayPumpTest 测试固件 + 10/26 实验室操作清单
    ## 背景：发现主固件缺手动测试入口
    主固件 v1.6 里 Serial.read() 零处、manualWaterStart() 只被 MQTT 回调调用
    -> D8 的 8.1「GPIO 控制继电器吸合/断开」没法主动触发
    -> 且 EN_WATER=1 时土壤传感器插空气会读到接近 DRY 的 raw，判缺水后自己开始浇水，干扰观察
    ## 新增 outputs/花房代码/RelayPumpTest/RelayPumpTest.ino
    串口指令（115200）：
    h/help 帮助 | on 吸合 | off 断开 | w 秒数 定时吸合后自动断 | auto 自动循环 | stop 退出 | t 状态
    安全设计：
    - 上电第一件事先锁断电平再开输出（同主固件 v1.3/v1.6 防毛刺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
2026-10-25 RelayPumpTest 实机验证通过 + auto 改为进入即吸合
    领导重新连上 ESP32（COM6）后补做上次缺的实机验证
    ## 逐项实测结果（全过）
    启动：横幅 + GPIO26 + 高电平吸合 + 120 秒上限 + 指令表，全部正确
    on -> 继电器吸合，串口回显
    t -> 吸合(泵转) | 本次 1.2 秒 | 累计 1.2 秒
    off -> 断开，本次吸合 2.5 秒，累计累加正确
    w 3 -> 3.0 秒后精确断开（实测 3.0 秒）
    auto -> 循环正确：吸合 3.0 秒 -> 断开 -> 停 10 秒 -> 再吸合
    w 999 -> 被正确限到 120 秒上限，串口打印保护提示
    w abc / w 0 / xyz -> 三种非法输入均正确报错
    ## 修了一个体验缺陷
    原实现 aut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
2026-10-25 修正器材来源：套件 5 个传感器是【向实验室借】，不是自购已到货
    领导指出 DHT11 / 光敏 / OLED / 双色 LED 都是向实验室借的
    ## 我之前错在哪
    把实验室 A 套件（41/32/16/25/13 号）当成 2026-10-23 已到货、在个人手上。
    实际：套件在实验室，10/26 现场领/借，用完清点还回，不发到个人。
    ## 根本原因
    借用清单第 1/2/4/5 项的状态列一直是空的（只有第 3 项继电器标了可借到、第 6 项标了学校有），
    我没据此追问，而是凭「A 套件到货」这句话推断成「到手了」。
    ## 已改
    docs/10月26日实验室操作清单.md 器材重新分三组：
    A. 向实验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
2026-10-25 改正 8.2 接线说明：继电器是串在电源正极，不是两根线各接一个脚
    领导问「这个怎么弄」—— 我原来写的接线是错的：
    旧：水泵红线 -> 继电器 NO 一端
    水泵黑线 -> 继电器 NO 另一端
    问题：NO 只有一个端子，不存在「一端/另一端」
    正确的是【串联】而不是【各接一脚】：
    1. USB 5V 正极 -> 继电器 COM
    2. 继电器 NO -> 水泵红线
    3. 水泵黑线 -> USB 5V 负极（直连，不过继电器）
    ## 文档已补
    - 接线原理说明（继电器 = 电控开关，串在正极中间）
    - 文字接线图
    - 3 步接法表（每步一行，无歧义）
    - USB 泵怎么接到继电器：3 条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
2026-10-25 8.2 改用 USB 延长线转接（不剪水泵原装线）
    领导提醒：清单里有绿联 USB2.0 延长线 1m（A公-A母，13.91 元，10/23 已到）
    ## 原方案的问题
    我写的是「剪掉水泵 USB 头」-> 泵线变短、失去保修、剪坏就没了
    ## 改后方案（剪延长线，不碰水泵）
    1. 从中间剪断延长线（两端插头保住）-> 得 A公侧 / A母侧两段
    2. 两段剥出红黑（白绿数据线剪掉，包绝缘胶带防短路）
    3. A公侧红 -> 继电器 COM；继电器 NO -> A母侧红
    4. 黑线用 WAGO 直连 1 个
    5. A公插充电宝，A母插水泵
    ## 好处
    - 水泵原装线完整（保修、长度、插头全保住）
    - 延长线是消耗品，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
2026-10-25 操作清单全面审计：修 8 处问题 + 出固件应急包（3 个 bin）
    按 neat-freak + 元宝搜索标准版对操作清单做三方面审计（错误/遗漏/优化）
    审计发现的问题已全部当场修复，不只报告
    ## 一、错误检查（2 处，已修）
    E1【中】标题「带什么（4 组）」但正文只有 A/B/C 三组 —— 上一轮删 C 组时漏改标题
    E2【低】传感器表 DHT 行写「烧主固件并开 EN_DHT=1」、OLED 行写「开 EN_OLED=1」，
    两行说法不一致且未说明固件从哪来 —— 统一指向「传感器版固件」
    ## 二、遗漏排查（6 处，已补）
    G1【高】实验室电脑环境依赖：整份清单的烧录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
2026-10-25 清单更新：自带笔记本 = 首选烧录路径（不依赖实验室电脑）
    领导确认笔记本可以带去实验室 —— G1 风险（实验室电脑没编译环境）直接消除
    - B 组置顶加「笔记本电脑 + 充电器」（标注环境全套就绪、COM6 已验证）
    - U 盘说明改为纯备份（自带电脑正常用不到）
    - 固件切换总览：首选 = 自带笔记本；应急包降为备份路径
    并提示串口号可能因 USB 口位置变化，用 board list 现查
    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
2026-10-25 neat-freak 全面审计：修 5 处，压缩超限 memory
    按 neat-freak 常规同步流程 + delivery-no-pseudoblock 闸门执行
    ## 发现并修复（5 处）
    P1【中】相对时间残留 4 处：
    操作清单「明天要剪它」→「10/26 要剪它」；「今天要烧 3 次」→「10/26 当天」
    应急包 README「按明天使用顺序」→「按 10/26 实验室使用顺序」
    操作清单标题补年份 → 2026-10-26（周一）
    P2【中】AGENTS.md §6.5 过期：「10/29 打其余八件」→ 实测切片后是七件（3.0h）
    §7 过期：「10 个打印件 STL 已交付」→ 9 件（02 泵座 10/24 已作废）且已完成切片
    P3【中】memory/2026-10-25.md 12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
2026-10-25 8.2 量水方案改为矿泉水瓶画线法（领导确认没有量杯也不借）
    领导反馈「都没有」（无量杯/不借量筒）→ 原方案的三条路径只剩自带物
    改法（3 处）：
    1. 量水段重写：矿泉水瓶 = 量杯
    出发前瓶未开封时沿水位画一圈线（=标签净含量如 550ml）
    到场水倒进 1L 桶当水源，空瓶接泵出水
    水位到画线的几分之几 x 550 = 毫升数
    3W 泵典型 20-40ml/s -> w 10 约 200-400ml = 瓶线 4-7 成，一眼可读，误差约 ±15%
    备选：桶壁画线当量筒（桶满口沿约 1.25L，按实测算）
    2. 水预案加一行：无论有没有水龙头，矿泉水瓶必带（兼任量杯）
    3.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
2026-11-06 8.2 量水升级为自购量筒（25-250ml/分度5ml），首测改 w 5 防溢
    领导 2026-11-06 自购量筒：最小刻度 25ml / 最大 250ml / 分度值 5ml
    改动（4 处）：
    1. 量水段重写：量筒直接读数（±2.5ml，比瓶线目测法准一个量级）；
    读数要静置 2 秒（贴壁挂珠会偏高 1-2ml）
    2. 关键风险：3W 泵 20-40ml/s -> w 10 可能出 300-400ml 超 250ml 量程
    -> 首测改用 w 5（约 100-200ml 稳在量程内），算出 ml/s 再推算 w 10
    3. 记录表首行从 10s 改为 5s（首测防溢）
    4. 矿泉水瓶画线法降为备用（量筒打碎/忘带时）；瓶仍带当水源备用
2026-11-06 docs: D0=11/07 开工定案——分工方案 v2 相对排期 + D0 讲解页 + 答辩冻结通告同步
2026-11-06 docs: 新增 8.2 水泵联调接线图 v2（按实测继电器 VCC 改 5V/VIN）
2026-11-06 AR18 全仓过时内容清理：修复 13 处文档-代码不一致（README/固件README v1.6/package.json playwright/交接文档等），移除根目录切片残留 result.json
2026-11-06 AR19 文档体系重组：操作三合一+30天计划并入分工方案+AR01-09归档+手册去HTML，docs 主层 17→11 份，断链清零
2026-11-06 docs: D0 讲解页 HTML 版换为讲稿 MD 版（35–40 分钟流程，原理→文档→练提交→分任务→测元件）
2026-11-06 docs: 讲稿时效修正——提交流程改一人一分支(r2-cloud等)+PR，补继电器JQC-3F VCC→5V与Mac差异
2026-11-06 docs: 讲稿提示词占位符化——文件路径/分支名/前缀/说明四占位符+R2R3R4对照表，Mac差异并入块内
2026-11-06 docs: 讲稿全面细化——逐字稿/翻车点/检查点/卡点修法/传阅提示表/时间预算，63min版
2026-11-06 chore: 讲解稿退库（移出版库改本地留存），.gitignore 排除 D0 讲稿，index 导航改本地指针
2026-11-06 docs: 素材命名口径统一——R4 职责行补 -{描述}，与 §八留痕/§十口径一致
2026-11-07 docs: [R2] 建上云联调记录, D0 开工
2026-11-07 docs: [R3] 建打印日志, D0 开工
2026-11-07 docs:[R4] 建素材索引表模板，D0 开工
2026-11-07 docs: [R3] 表头日期口径统一为 D+n, 与红线 5 对齐
2026-11-07 docs: [R3] 修正件重，对齐切片报告，D0 开工
2026-11-07 docs: README 打印件耗材列统一为切片实测值（九件 325.3g），废弃实体估算口径
2026-11-07 老师课件归档：提交截止 2026-11-24；实验室 C312-C314；周末全天开放
    领导 2026-11-07 收到 Final_Project_Slides.html（7 页全读）
    关键信息：
    - 提交截止 2026-11-24（周二），成果统一提交
    - 三部分：动手实践 + 期末报告 + 期末展示（两阶段初评/晋级，DT 系共评，英语加分）
    - 开放实验室 C312/C313/C314；工作日 18:30-20:30，周末 9:00-20:30
    （修正旧假设「周末不开」——周末全天开放；打印机是否在其中待周一确认）
    - 课件备份 outputs/素材备份_老师课件/Final_Project_Slides_2026-11-07.html（md5 校验）
    - MEMORY.md 更新（项目一句话 + 待办 9 条：D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
2026-11-07 PR 审查收尾：合并 PR#4 + 修 3 处审查发现 + 周末可打印口径落地
    动作1：PR#4（件重对齐切片实测）已合并 —— 数据我逐件核对 9/9 正确，合计 325.3g 精确吻合
    动作2：修三个 PR 的审查发现
    - PR#2 素材索引表：命名规范引用「AGENTS.md §8」→「分工方案 §八」
    （AGENTS 的 §8 是「云端已停用」，读者按错引用会看不懂）
    - PR#1 上云联调记录：11.2 行补「巴法云 004 格式（字段#值|字段#值），非 JSON」
    （固件实际是 004 格式，分工方案源头写错为 JSON）
    动作3：领导确认「周末可以打印」——
    - 打印日志红线 2：周末打不了 → 周末可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
2026-11-07 排期再调整：周日无法进实验室，打印提交 = 周一 11/09 19:00
    领导 19:12 告知明天（11/08 周日）去不了实验室，周一晚 7 点才能去。
    影响与调整：
    - 打印提交 D+1（周日）→ D+2（周一 19:00）
    - 工作日开放 18:30-20:30，19:00 到场只剩 1.5h：
    交 gcode（30min）+ 06c 试机（10min）+ 底盘开打挂机
    底盘 5h 若不许过夜挂机则分两晚（周一 06a + 周二 06b）
    - 周日全天改为宿舍电子实验日（补 D0 欠账：8.1/8.2/传感器/浮球，器材在手）
    - 试装最早 11/10（周二）取件后；距 11/24 截止 16 天，仍充裕
2026-11-07 修复: 04 OLED 支架补走线位（AR20）——裙墙+底部出线，39.5 高 / 27.4g，复切 29m49s·14.7g
    [04_oled_stand.3mf, 04_oled_stand_v1.stl]
2026-11-08 修复: 按实物实测返修 04 屏架（排针在上缘）+ 06a 继电器槽（转90°），新增 11 光敏小柱（AR21–AR23）
    [04_oled_stand.3mf, 04_oled_stand_v1.stl, 06a_base_left.3mf, 06a_base_left_v1.stl, 07_dht11_holder.3mf, 07_dht11_holder_v1.stl, 11_ldr_stand.3mf, 11_ldr_stand_v1.stl]
2026-11-08 refactor: outputs 目录重组——15 个顶层目录归并为 3+1，与 E 盘同名同构
    结构（2026-11-08 起）：
    outputs/3D打印件/ ← 花房3D_P0、_P1P2、_整机底盘、_水箱盖、_整机装配、切片_2026-10-24
    outputs/代码/ ← 花房代码（GreenHouse_v1+RelayPumpTest）、固件应急包_2026-10-25
    outputs/素材/ ← 到货照片备份、素材整理_2026-11-07、素材备份_老师课件
    outputs/素材/_敏感_不入库/ ← 截图整理×2、截图备份（含巴法云私钥截图，gitignore 屏蔽，仅本机）
    outputs/.tools/ ← 不动
    连带更新：
    - 41 个文档的路径引用批量替换（docs/ + outputs/ 内 .md/.py/.json/.ino）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
    [01b_sensor_holder.3mf, 01b_sensor_rim_hook_v2.stl, 02_pump_mount_v1.stl, 03_tube_clip.3mf, 03_tube_clip_v1.stl, 04_07_11_combo.stl, 04_oled_stand.3mf, 04_oled_stand_v1.stl]
2026-11-08 refactor: 补齐 8 个文件的旧路径残留（首批替换时序漏网），正式文档旧引用清零
2026-11-08 refactor: 合并 output/（单数）入 outputs/素材/邮件成品，双 output 混乱终结
    - output/硬件借用申请单（docx+pdf）×2 + brief-compose/ → outputs/素材/邮件成品/
    - output/（单数）目录删除，根目录只剩 outputs/（复数）一个
    - .gitignore 移除 output/ 行（目录已不存在）
    - 通配符引用 outputs/花房3D_* 等旧模式 4 处一并更新（AGENTS/交接文档/AR13/30天计划归档）
    - AGENTS 分桶表：邮件成品行指向 outputs/素材/邮件成品/
2026-11-08 打印规则确认：C311 的 X2D，20:30 前开打打到完为止——周一当晚可交 7 件
    领导 2026-11-08 确认：
    - 20:30 = 打完为止（非停止打印）→ 无人值守可打到 22 点+
    - 拓竹 X2D 在 C311 —— 注意不在课件开放名单 C312-314 内，周一确认进门规则
    - 周一方案：19:00 到场 30min 提交 → 当晚 06c+五小件+水箱盖 3h25m 全打完
    - 底盘 5h 单晚放不下：分两晚（周二 06a/周三 06b）或周六全天
2026-11-08 C311 晚上开放确认——周一打印进门无障碍，待确认项清零
2026-11-08 refactor: docs 目录分组——根级 14 文件归为 5 核心 + 3 子目录
    docs/
    ├── index.md + 4 份核心文档（交接/方案书/分工方案/GitHub手册） ← 根级保留
    ├── 操作手册/ ← 实验室操作清单、硬件操作手册、接线规划表、接线图 html
    ├── 参考资料/ ← 3D建模路线、借用与自购清单
    ├── 工作日志/ ← 上云联调记录(R2)、打印日志(R3) ← 进行中，边做边填
    ├── 审计报告/ （原样，AR10-24 + archive）
    ├── archive/ （原样）
    ├── private/ （原样，不入库）
    └── 花房D0开工讲解稿（本地保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
    [06a_base_left_v1.stl]
2026-11-08 抢救桌面打印目录的唯一文件后删除：07_v2/11_v2 STL + 底盘摆放图入仓
    桌面「花房打印_2026-11-08」（今天为交打印准备的 U 盘源目录，打印已取消）
    删除前核对：3 个文件仓库无对应 → 先抢救：
    - 07_dht11_holder_v2.stl、11_ldr_stand_v2.stl → 3D打印件/花房3D_P1P2/STL/（md5 校验一致）
    - 底盘摆放图.png → 3D打印件/切片_2026-10-24/
    其余（04_07_11_combo.stl、STL_源模型×10、打印清单md）均为仓库文件副本，直接删
    [07_dht11_holder_v2.stl, 11_ldr_stand_v2.stl]
2026-11-08 按领导指示删除上一条抢救的 3 个文件（07_v2/11_v2 STL + 底盘摆放图）——打印方案已改，不需要
    [07_dht11_holder_v2.stl, 11_ldr_stand_v2.stl]
2026-11-08 复扫补漏：02 作废 STL 加伴注标注（不删本体，守红线）
    复扫发现：README 打印表有 02 作废标注，但 STL 目录里 02_pump_mount_v1.stl
    孤立存在无任何标注——若有人直接翻 STL 目录会误打。
    加伴注文件 ⛔02_作废勿打印_泵自带吸盘直吸桶底.md 同目录提醒。
    （不删 STL 本体：AGENTS 红线「删 STL 先问领导」）
    [06a_base_left_v1.stl]
2026-11-08 清理：临时/半临时/复扫问题共 10 项全数删除，引用残留 7 处清零
    删除（领导授权 2026-11-08 22:30）：
    - result.json（切片残留，gitignore 补防再生）
    - brief-compose/（html→docx 中间产物+.bak）
    - 原件_实验室借件_2026-11-08/（9 张 OCR 原件，信息已入文档）
    - 硬件申请单 v1 存档 docx+pdf（被正式版取代）
    - 邮件模板 v1（已作废留档，删）
    - 10月26日实验室操作清单（电子实验已完成，流程并入硬件操作手册；
    分工方案/交接文档/index/README 四处引用改指操作手册或删行）
    - 固件应急包_2026-10-25/（bin 与现源码版本漂移 + 笔记本随身从未用上）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
    [02_pump_mount_v1.stl, 测试块_配合公差_v1.stl]
2026-11-08 补：README 残留行与未提交新文件
    [06a_base_left_v1.stl]
2026-11-08 README 目录树残留行（CRLF 行尾导致上轮 replace 未中）
2026-11-08 fix(3D): AR25 底盘小件嵌槽——06a STL/脚本/校验报告/预览图更新
    [测试块_配合公差_v1.stl]
2026-11-08 审计收尾：11/09 现场任务卡入 main（自 r1-taskcard-1109 分支抢救）+ 底盘 06a/06b 22:47 迭代版
    全面审计发现（三件）：
    1. r1-taskcard-1109 分支有『11/09 现场任务卡 html』从未进 main —— 明晚要用，
    cherry-pick 抢救（该分支基于旧分叉，只取任务卡单文件，不带回旧状态）
    2. r1-docs-rule-ephemeral 分支的『AGENTS §6 一次性卡不入导航』规则 ——
    该规则已随任务卡实践生效（本卡不进 index 导航），分支可清
    3. 工作区 06a/06b/脚本/校验报告 22:47 又迭代一轮（领导手跑），随本提交入库
    分支清理：本地 4 条 r1-* 全部已并入 main 或被取代，删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
    [06a_base_left_v1.stl, 06b_base_right_v1.stl]
2026-11-08 首件实体打印件入库：08 扎线座 D+1 打印成功 + 6 张测试照与视频归档
    打印日志（R3）：
    - 08 扎线固定座 ✅ 已完成（2026-11-08，D+1）—— 本日志第一条真实记录
    - 标注为「单件试机性质」（当日机时不足以打完 10 件批），其余按 11/09 19:00 C311 批次
    素材（R4 索引表同步）：
    - 6 张实拍入仓 outputs/素材/素材整理_2026-11-07/原件_2026-11-08_打印与测试/
    （LED 绿灯×3 / OLED 显示「土壤:100%」/ OLED 背面 V1.2 / DHT11 接线）
    - 5.2s 720p 视频 420KB
    - S1-7.2 OLED 显示照 ✅ 已到手；S1-6.x 部分齐（土壤/继电器待周一）
    - 新增「本批新增」小节逐张对应索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
2026-11-08 素材待补项改标「11/09 现场补拍」（领导确认），四项明细入表
2026-11-08 恢复 10 件 gcode：21:26 目录重组时 add -A 意外删除，从 f263dc7^ 历史完整找回
    事故复盘：
    - 21:26 outputs 重组时，「切片目录被重组过（04_07_11_combo）导致 git 索引与
    工作区不一致」→ 当时改用 mv + git add -A 对齐 —— add -A 把工作区里
    已不存在的 9 件单件 gcode（01b/03/04/06a/06b/06c/07/08/10）一并标记删除
    - 11_ldr_stand gcode 是重组后新增的，随后在 5a77ebc 附近也被清掉
    - 23:15 领导发现「切片的文件都删了」→ 从 f263dc7 父提交 checkout 全目录恢复
    恢复验证：
    - 10 件 gcode 全部找回（01b/03/04/06a/06b/06c/07/08/10/11）
    - 11 号件核对：18m31s / 169 层，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
    [01b_sensor_holder.3mf, 03_tube_clip.3mf, 04_oled_stand.3mf, 06a_base_left.3mf, 06b_base_right.3mf, 06c_joint_block_x2.3mf, 07_dht11_holder.3mf, 08_cable_clip.3mf]
2026-11-08 删除全部切片文件（gcode/3mf/result.json/combo STL 副本），切片彻底回归领导自做
    领导指令（2026-11-08 23:19）：「把切片的文件都删了」
    删除：
    - outputs/3D打印件/切片_2026-10-24/ 整目录（10 gcode + 10 3mf + 10 result.json + combo STL 副本）
    - 删除过程中出现的 切片_2026-10-24_恢复/（32 文件完整切片集，恢复来源不明，按指令一并删）
    保留并迁移（被 5 个活文档引用，含明晚任务卡）：
    - 上机操作卡.md、切片报告.md → outputs/3D打印件/_打印参考/
    （切片报告保留 8h37m/338g 实测口径备查；上机操作卡是明晚现场的操作依据）
    引用修复：8 个文件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
    [01b_sensor_holder.3mf, 03_tube_clip.3mf, 04_07_11_combo.stl, 04_oled_stand.3mf, 06a_base_left.3mf, 06b_base_right.3mf, 06c_joint_block_x2.3mf, 07_dht11_holder.3mf]
2026-11-08 清理 7 个垃圾空文件（我上一条命令的副作用，非项目文件）
    成因：23:21 执行引用替换时，bash 误将 outputs/3D打印件/_打印参考/切片报告.md
    的 markdown 正文当作 shell 脚本解析，其中以 > 开头的 blockquote 行被解释为重定向，
    生成了 7 个以中文句子命名的 0 字节文件：
    **产物**：每件一个目录，内含 / **切片耗时**：**7.2 / **机器**：拓竹 /
    **覆盖参数**：（预设默认 / **预设**： / ⚠️ / 📌
    （上一 commit ea5d8cd 的 git add -A 把它们一并提交了，本 commit 删除）
    教训：含中文与 markdown 内容的替换一律走 python 脚本文件 + 前置校验，
    不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
2026-11-08 neat-freak 全面审计：修复活文档引用断链（archive 迁移遗留 + 切片删除连带）
    审计三轮结果：
    ① 尺寸体检全过：AGENTS 116 行/12.6KB（限 300/15K）、MEMORY 94 行/8.8KB（限 200/25K）、
    memory 263KB < docs 578KB 未倒挂
    ② 相对时间 2 处均为合理保留（教程用语/历史 changelog）
    ③ 引用有效性：扫描出 68 处无效引用 → 分类处置：
    - 假断链（…省略写法/通配符/占位符）不计
    - archive 与审计报告内部互引按规矩不改动历史文档
    - 真断链 4 个活文档修复：
    a) index.md 的 AR10-25 省略名 → 全名（16 处）
    b) 交接文档/分工方案指向已归档文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
2026-11-08 README 状态表大修：截止日 11-24 落地 + 全量路径修正（领导指出 GitHub 未更新）
    领导 23:37 指出：GitHub 上的 README 状态表还是 2026-11-06 版本
    修正 11 处：
    1. 首段「9 个结构件」→ 10 个（11 光敏小柱加入）
    2. 状态表标题 2026-11-06 → 2026-11-08 更新
    3. 固件行：补「11-08 五路传感器实机点亮」+ 四项实测数据
    4. 硬件行：补「5/5 点亮、土壤排针焊接一次过」
    5. 打印行：11-08 晚开始打 → **首件 08 已成功** + 11-09 19:00 C311 打其余 9 件
    + gcode 已全删、现场用 STL 重切
    6. 答辩行 → **截止日 2026-11-24 已公布**（原写「顺延待定」，是最严重的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
2026-11-09 修文档矛盾：M3×6 螺丝是「盘头」不是「沉头」（配 φ6.2×1.8 圆柱沉孔）
    起因：领导问「买的螺丝还有用吗」，核查规格时发现文档自相矛盾——
    - README §四 写「盘头自攻」，交付说明正文两处写「沉头自攻」，而同文件表格写「盘头，头高 1.8」
    - 查几何：base_2pc_models.py 用 C(...) 圆柱切出 φ6.2×1.8 沉孔，参数注释原文「盘头 M3 头高 1.8」
    → 正解 = 盘头（圆柱头），交付说明两处「沉头」为笔误
    修正：
    - 交付说明：正文 2 处 沉头→盘头（圆柱头）；补注「圆柱沉孔配盘头，90° 锥形沉头坐不实」
    - README §四：补三项判别（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
    [06a_base_left_v1.stl]
2026-11-09 硅胶线用途降级：泵回路改 USB 延长线后不再是刚需，改标「备用」
    领导问「硅胶电线还有用吗」→ 核查发现文档仍把它写成泵回路刚需
    结论：**从刚需降为备用**，因为 2026-11-08 泵回路方案已改：
    - 现在：剪 USB 延长线（A公侧红→COM，NO→A母侧红，黑线 WAGO 直通），
    延长线自带 22-24AWG 线芯，够过泵的 0.6A 常态 / 1.8A 启动峰值
    - 硅胶线不再用于「泵线延长」
    保留价值（所以仍有 3 类用途）：
    1. 浮球 P52 引出线加长（若线不够到 GPIO32）
    2. 底盘内部走线加长（杜邦线 20cm 不够时）
    3. 断线应急备料
    文档修正：
    - 自购清单：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
2026-11-09 浮球换 100mm 杆：切至 90mm 使用（原样撞泵）；元件复用性盘点入档
    领导 2026-11-09：退 2 只 50mm 杆浮球，改买 100mm 杆
    ## 关键发现：100mm 原样装不进
    - 杆尖 z=37（螺纹段按 10 穿盖），而泵体 z=8~38、出水嘴顶 40.5 → 直插泵体
    - 泵在桶心 (85,32) 与浮球同轴；桶底半径 52.5、泵对角 28.3 → 泵最大偏移 24.2mm，
    而浮子半径 14 → 中心 ±14 区间必然干涉，**挪泵无解**
    ## 正解：切至 90mm
    | 杆长 | 杆尖z | 报警水位 | 可用水量 | 判定 |
    | 50mm（原购） | 87 | 87mm | 371ml | 🔴 < 单轮连浇 650ml，中途断水 |
    | 90mm（切后） | 47 | 47mm | 771ml | ✅ > 650ml，满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
2026-11-09 浮球定版 85mm 原样使用（免切割）——市面只有此档，且正好落在安全区间
    领导 2026-11-09：市面上只有 85mm 杆可选（无 100mm 货源）
    验算三种螺纹长度全部安全：
    | 螺纹段 | 伸入 | 杆尖 z | 距泵顶(40.5) | 报警水位 | 可用(上限1200ml) |
    | 8mm | 77mm | 50 | +9.5 | 50mm | 742ml |
    | 10mm | 75mm | 52 | +11.5 | 52mm | 723ml |
    | 12mm | 73mm | 54 | +13.5 | 54mm | 703ml |
    均 > 单轮连浇上限 650ml（固件 6 轮×3s×36ml/s）✓
    结论：**不用切杆** —— 避免切口毛刺卡浮子导致水位误判，也保留退换可能。
    对比：50mm 已退货（可用仅 371ml）；100mm 会插进泵体（杆尖 37 < 泵顶 38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
2026-11-09 硬件手册补焊锡丝牌号选择：63/37 有铅首选、无铅 Sn99.3 需 350-380℃ 且压 2-3 秒
    领导问「焊排针需要含锡量多少的锡丝」→ 查文档发现只写了线径没写牌号，补上：
    | 牌号 | 熔点 | 适合度 |
    | Sn63/Pb37（63%） | 183℃ | ⭐⭐⭐ 首选，共晶、流动性最好、烙铁 300-330℃ |
    | Sn60/Pb40 | 188-190℃ | ⭐⭐ 可用 |
    | Sn99.3/Cu0.7（无铅） | 227℃ | ⭐ 实验室多为此；需 350-380℃、接触压 2-3 秒 |
    三条风险提示：禁止有铅/无铅混用；必须有松香芯；土壤传感器塑料底座约 200℃ 就软，
    无铅 380℃ 连超 3 秒会变形 → 宁可分两次点焊
    [04_oled_stand_v1.stl, 07_dht11_holder_v1.stl, 10_tank_lid_v1.stl, 11_ldr_stand_v1.stl]
2026-11-09 docs: [R4] S2-10.1 接线电路图导出高清 PNG，素材索引表回填
2026-11-09 docs: [R2] 上云联调记录新增 4.0 操作剧本（10 步可执行表 + 收尾还原铁律），D+2
2026-11-09 docs: 凭据指引改为「向 R1 单独索取」——不写本机私档路径（PUBLIC 仓库 + 组员路径不同）
2026-11-09 3D 件 AR27–AR29 落地：01b 板槽修复 + 04/07 重出 + 组合件入仓 + audit 修复
    ## AR28 · 01b 板槽修复（本次真实落地）
    上一轮报告已写好参数，但脚本改动被我 21:24 的 git reset --hard 回滚（见下），
    本次按报告参数重新落地并实测复核：
    | 参数 | 改前 | 改后 |
    | tilt | 8° | 0°（柱深仅 6mm，8° 横移 ±4.9mm 穿壁） |
    | groove_gap | 1.4 | 1.8（板 1.5~1.6，单边 0.1 是 FDM 下限） |
    | slot_len | 46 | 81 |
    | 槽心 zc | col_h/2=18 | (col_h−leg_depth)/2=0.5（柱子真实中点） |
    实测复核（1mm 探针布尔求交，非 contains）：
    - 质量 19.4 → **16.5 g**，水密单体，bbox 27×15×71
    - 槽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
    [01b_sensor_rim_hook_v2.stl, 04_11_combo.stl, 04_oled_stand_v1.stl, 07_dht11_holder_v1.stl]
2026-11-09 docs: [R4] 11/09 首批打印件成品照入库（水箱盖+光敏柱），打印日志回填
2026-11-09 现场进度回填：07 已打（4/10 完成）+ 组员工作盘点
    领导 2026-11-09 现场实况：
    - 今日打印 3 件：10 水箱盖 / 07 温度传感器架 / 11 光敏柱（+11-08 的 08）= 4/10
    - 剩余 6 件：01b（须用 AR28 修板槽后的新版 STL）/ 03 / 04 / 06a / 06b / 06c
    - **卡点：螺丝刀未借到** → 8.1 / 8.2 / 浮球极性全顺延；底盘拼装同样等螺丝刀 + M3×6 自攻
    打印日志更新 4 处：07 状态、07 逐件记录、合计基线（8h02m/325g → 8h37m/338.1g 十件口径）、
    进度小结（4/10 + 剩余件 + 卡点）
    素材索引表：S2-13.1 同步为「4/10 已打，07 已打待补照」
    组员今日产出（GitHub 实证）：
    - R2 z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
2026-11-09 素材索引修正：成品照实为 1 张（10+11 同框），08/07 待补 + 立拍照规矩 4 条
    起因：R4（yinyinyin666）的助手发现「领导说这是水桶盖，但照片里其实有两个件」——
    对照模型 preview 逐项验证后确认是 10 水箱盖（白盘）+ 11 光敏柱（黑件），文件名与索引已按两件标注。
    顺着这条核查全部素材，发现我上一条自己写错了（写成「08/10/11 有照」）：
    - 实际成品照只有 1 张：S2-13.1-10水箱盖与11光敏柱成品.jpg（两件同框）
    - **08、07 都没有成品照**（都已打印但未拍）
    立规矩（防再犯）：
    1. 一件一张：镜头里只放一个件；多件同框只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
2026-11-09 约束更正：器材必须在实验室内操作（领导 2026-11-09 明确），宿舍电子日假设作废
    领导明确：所有器材必须在实验室内操作，不得带回宿舍。
    → 原「D0 宿舍电子日做 8.1/8.2/浮球」的排法作废（这是我今晚建议里最大的错）。
    改写分工方案 §三：
    电学实验（8.1/8.2/浮球）与打印提交压在工作日 18:30-20:30 同一窗口并行——
    R3 盯打印（切片+06c试机+提交，40min），R1 做电学（接线+量水+继电器，70min），
    2 小时窗口内完成，余 50min 缓冲。桌面准备（剥线/裁管/拍照）仍可在宿舍做，不占窗口。
    明天（11/10）排期已按此重算并存 me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
2026-11-09 chore: 删除 11月09日现场任务卡_D2.html（一次性现场卡，用完即弃）
    领导 2026-11-09 手动删除。符合既定规则：一次性现场卡不入 docs/index.md 导航、
    用过即弃，不长期留档（新建规则见 2026-11-08 领导确认）。
    连带处理：README 目录树里对该文件的引用一并移除，避免断链。
2026-11-09 README: 移除已删任务卡的目录树行（防断链）
2026-11-09 audit: AR30 本地工作区 + E 盘镜像 + GitHub 仓库全面审计
    范围：main@cec6d8f（146 commit / 182 跟踪文件）+ 本地工作区 + E 盘镜像
    排除并单验：.workbuddy（不入库）、_敏感_不入库（git 命中 0）、docs/private（命中 0）
    结论：敏感信息与固件 bug 零问题；2 高 + 7 中 + 4 低，全部可执行修复。
    高风险 2 项：
    - H1 04 支架 z=10 有 577mm² 免支撑悬空面（探针实测下方 0 实体）——
    AR27 判定为「可桥接」的设计取舍，但领导实测过炒面先例；明天就打这 4 件
    → P0：切片时看 Bambu 悬空染色，报警就单独开支撑
    - H2 固件全开关体积文档写 902KB/68%，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
2026-11-09 fix(AR30): 审计问题全部修复——体积口径/旧件数/旧耗时/断链/E盘镜像/接线图归位
    按领导「都修了」指令执行 P1+P2（保留 H1 与 L3，理由见报告）：
    ## 口径修正（H2 + M4/M5/M6 + 交接文档）
    - 固件体积：902KB/68% → **1055KB/82%**（实编译 1080420 B），并注明余量 ≈230KB
    （AGENTS:50 + README:13 两处）
    - 打印耗时耗材：8h02m/325g/337.7g 三种旧口径 → 统一 **8h37m / 338.1g**
    （打印日志 3 处 / 分工方案 3 处 / 交接文档 P1 行）
    - 件数：9 件 → **10 件**（AGENTS:102、分工方案、交接文档）
    - 两文件**不改历史数字**，改为头部加「口径说明」——
    它们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
2026-11-10 fix(3D): 01b 按封闭槽重出 STL + 04 回退实心 + 新增配合校验脚本
    - 01b：AR33 开窗方案被否后 open_window=False，但 STL 未重出（盘上仍是 17.3g 开窗版）→ 重出 22.8g/18379mm3，check_base_fit 全过 / check_wires 25 根 0 穿模 / audit 零失败
    - 04：背面三角减重腔按领导要求回退实心（lighten=False）
    - 删除 04_11_combo.stl 旧合板件（2026-11-09 领导决定）
    - 新增 check_clearance.py：逐件量槽开口/件底座/单边间隙/槽底落座
    [01b_sensor_rim_hook_v2.stl, 04_11_combo.stl]
2026-11-10 docs(AR31-33): AR 编号消歧（原两份 AR30）+ 索引补全 AR26–AR33
    - 编号：AR30_01b阶梯槽→AR31、AR31_03插土针→AR32、AR32_01b感湿窗→AR33；文件名、正文首行、「下一个编号」三处同步，24 份报告零重号零缺号
    - AR32 标注「已回退」：03 恢复 pin_t=2.0、删 V 形斜撑，防断改走取件工艺（等床温<35℃ / 铲刀斜插 / 翻转 180°）
    - index.md：AR 表补 AR26–AR33（原停在 AR25）、现行依据改 AR10–AR33、下一编号改 AR34
    - AGENTS.md §2：AR 指针 25/26 → 33/34，补 AR26–AR33 逐号摘要
    - 交接文档：两处过时指针 AR17/AR18 → AR33/AR34
    - 补 AR33 引用的 01b 装盆效果图、04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
2026-11-10 docs(AGENTS): 固化「一律走 PR」规则，更正 gh CLI 已装 (#7)
    - 2026-11-10 领导定：以后所有改动走 PR，不再 git push origin main
    - 记录 protect-main ruleset 实测要求：PR + 至少 1 个 approving review，禁删除/禁强推
    - 更正旧记录：gh CLI 已装 v2.103.2 并已认证 huankechong（scopes gist/read:org/repo/workflow）
    - 附标准流程（开分支→push→gh pr create→组员审或 --admin bypass→删分支）
2026-11-10 fix: WATER_MS 3000→2000——按实测流量 32.1ml/s 定稿（250ml/7.80s 三轮，单轮≈64ml） (#8)
    [GreenHouse_v1.ino]
2026-11-10 docs: 打印日志补 01b/04 完成态（11-10，裸露版/实心版口径）
2026-11-10 fix(3D): 01b 定版裸露版 14.5g + 03 加强针 + 04/07 改版重出 + AR31–35 入档 (#11)
    ## 模型（今日多轮迭代的最终状态）
    - **01b = 裸露版 14.5g**（AR35，19:45 领导定版）：感湿窗 17×37 尖顶、土面下两侧壁全开、
    open_window=True —— 解决 AR33 指出的真缺陷「板被 3.6mm PLA 包住，电容场探不到土」。
    **今天已打印实物**。演进链：AR28 板槽贯通→AR31 阶梯槽→AR33 开窗被否→AR35 定版裸露
    - **03 = 加强针版 4.1g**（AR34）：pin_t 2.0→4.0、V 形斜撑按领导 19:00 要求去掉
    - **04 = 实心版 27.7g**（槽 29.3×28.0×2.9 + 槽口倒角）—— 减重腔被否回退。**今天已打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
    [01b_sensor_rim_hook_v2.stl, 03_tube_clip_v1.stl, 04_oled_stand_v1.stl, 07_dht11_holder_v1.stl]
2026-11-10 docs: [R2] 11.1 双主题复核代码侧结论入档（官方类型表口径），D+3 (#9)
    * docs: [R2] 11.1 双主题复核代码侧结论入档（官方类型表口径 + 待人工三勾），D+3
    * docs: [R2] 11.1 双主题复核通过——控制台实拍两主题在且类型对，截图入库
    * docs: [R2] 记录 11.3 卡点（账号 7886 已确认、小程序登录疑似登错账号），截图脱敏入库
    ---------
2026-11-10 docs: [R4] 智能花房养护站实验报告初稿入库，D+4 节点交付 (#10)
2026-11-10 docs: 过时口径清理——进度 6/10 三处同步 + 报告 AR 引用两处修正 (#12)
    按全面审计扫描结果（7 处过时，2 处为历史记录不改）：
    1. 报告源文：01b「AR31 阶梯槽新版」→「AR35 裸露定版」；04「AR29 屏槽换算版」→「实心定版」
    （PR#10 review 时指出的两处勘误）
    2. 打印日志：剩余 6 件 → 4 件（03 加强针版/06a/06b/06c；01b/04 已 11-10 完成）
    3. 交接文档 P1：4/10 → 6/10
    4. 素材索引 S2-13.1：6/10 + 4 件成品照待补
    不改的 2 处：index.md 的 AR31 描述（演进史陈述，本身正确）、接线表 C 项（已标'降为备用'，
    '剪线'字样在废弃方案的历史说明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
2026-11-10 docs(AGENTS): [R1] 补 PR/分支命名规则——起因 #7–#12 四个 R1 PR 漏 [R1] 前缀被领导点名
    规则（§4.1.1 新增）：
    - 分支名 = r{角色}-{模块}-{MMDD}（如 r2-cloud-1021）
    - PR 标题 = <类型>: [R{角色}] <说明>
    - AI 代建分支时必须按角色代入（领导操作 = R1）
    - 已合并 PR 标题可事后补：gh api -X PATCH repos/…/pulls/{n} -f title=
    同时已把 #7/#8/#11/#12 四个标题用 API 补上 [R1]。组员 6 个 PR 本来就合规。
2026-11-10 docs(AGENTS): [R1] §7 状态段重写——清掉过期指针，对齐 6/10 进度与 WATER_MS=2000
    旧状态段还写着「9 件/答辩顺延未定/器材刚借到」，与现实（10 件定稿、6/10 已打、
    WATER_MS 已按 32.1ml/s 定稿 2000、报告初稿入库）严重脱节。
    重写为五行指针式快照 + 详情去向。
2026-11-11 docs: [R1] 打印日志补 03/06c 完成（8/10），进度小结与剩余提示同步 (#13)
    领导 2026-11-11 现场回报：03（加强针版）+ 06c×2 打印完成。
    累计 8/10，剩余 06a/06b——今日沉槽深度修正后重出，打这两件必须用 git 最新 STL。
2026-11-11 fix: [R1] 底盘沉槽深度修正重出 06a/06b + 泵电源 pigtail 免剪定稿 (#14)
    ## 06a/06b 沉槽修正（真 bug）
    切槽盒高度 recess_d+2 原意'上下各多 1'，实际槽深=recess_d+1（多 1mm）→ 连接块沉 1mm 不齐平。
    改为 recess_d+1 并中心抬 0.5 → 槽底准确落在 pt-recess_d，块与板面齐平。
    STL 重出（06a 277.1g / 06b 305.5g，水密），check_report/预览/交付说明同步。
    ⚠️ 明晚打 06a/06b 必须用本版。
    ## 泵电源方案定稿 A'（pigtail 免剪）
    - 公头线 30cm + 母头线 30cm + WAGO（11/10 下单）
    - 独立 5V 充电宝小电流模式 → 继电器 → 泵
    - 剪延长线方案 A 正式划掉（2026-11-09 领导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
    [06a_base_left_v1.stl, 06b_base_right_v1.stl]
2026-11-11 feat: [R1] 8.2 水泵量水实测视频入库（16.9s/720p）——ml/s=32.1 的画面证据 (#15)
    领导 2026-11-10 实验室量水过程实录（微信传来，temp 目录会清 → 已备份入仓）。
    素材索引表 S1-8.2v ⬜→✅。剩余待补：8.1 继电器吸合照、8.2 静态照、
    6 件成品照（08/07/01b/04/03/06c）。
2026-11-11 docs: [R1] 素材豁免——8.1 以串口记录代替照片、8.2 由量水视频豁免（领导 2026-11-12 决定不补拍） (#16)
2026-11-11 docs: [R1] README 状态表更新至 11-12——8/10 进度 + 实验定稿行 + 倒计时 12 天 (#17)
    上一版停在 11-08 口径（组员拉仓库看到的进度落后 4 天）：
    - 打印行：首件口径 → 8/10 明细（08→10/07/11→01b/04→03/06c）+ 剩余 06a/06b 用修正版
    - 新增「实验/标定」行：8.1✅/8.2✅ ml/s=32.1 → WATER_MS=2000；土壤标定为 EN_WATER=1 前置
    - 3D 行：补 11-10/11 三轮迭代（AR34/35 + 沉槽修正）与 check_clearance 口径
    - 倒计时 16 → 12 天
2026-11-12 docs: [R1] 06c 试拧顺延——M3×6 螺丝首购买错已退，新螺丝在途（领导 2026-11-12 确认） (#18)
2026-11-12 docs: [R1] 螺丝事件口径定稿——首购买错已退，重购版规格正确在途（领导 17:10 澄清） (#19)
2026-11-12 docs: [R1] 电路图口径改用现成总图——Fritzing 任务作废（10.1 从 60min 降到 10min），报告图 1 已指向仓内 PNG (#20)
2026-11-12 fix: [R1] 标定定稿+自动浇水解锁——SOIL_RAW 2372/1050（11-08 实测，网上典型值换算吻合）+ EN_WATER=1 + LEVEL_WET_CLOSED 常开型实测定稿 (#23)
    [GreenHouse_v1.ino]
2026-11-12 docs: [R2] 11.3 小程序绑定通过——两设备可见，面板截图入库（真实数值待 11.2） (#21)
2026-11-12 docs: [R4] 实验报告按 BiUH 官方模板重排——校徽封面+学生名单表+四份自评表 (#24)
    * docs: [R4] 实验报告 v2——进度同步 8/10，补量水实测配图，修图注编号
    * docs: [R4] 实验报告按 BiUH 官方模板重排——校徽封面+学生名单表+四份自评表
    * docs: [R4] 报告 v3 回填标定定稿（2372/1050）与浮球极性，EN_WATER 解锁
    * fix: [R4] 报告源文修复乱码字符（浇水结束后进入）
    * docs: [R4] 11/12 打印件成品照入库（06a 底盘左片+11 光敏柱），进度 9/10
    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
2026-11-12 docs: [R1] 口径大同步——标定定稿/EN_WATER=1/浮球常开/9-10 进度（PR#23/#24 联动） (#25)
    11-12 晚三项定稿（PR#23）+ R4 报告 v3（PR#24）合入后，活文档有 20 处旧口径：
    - AGENTS §7：实验行'待到货/待做'→ 全部定稿（2372/1050 + EN_WATER=1 + 常开型）；
    3D 行 6/10 → 9/10（+06a 11-12），仅余 06b
    - README：实验行同步定稿口径；打印 8/10→9/10；倒计时 12→11 天；日期→11-13
    - 打印日志：剩余 2 件 → 1 件（06b）
    分工方案/交接文档/上云记录中的历史叙述（'当时未回填'）属演进记录，不改
2026-11-12 fix: [R1] 口径纠偏——'闭环已启用'改为'闭环解锁（固件层），实机接线待 pigtail 到货' (#26)
    领导 2026-11-13 00:50 指正：整机线路尚未拼完（pigtail 公/母头线 ×2 未到货），
    昨夜 PR#25 的'全自动浇水闭环已启用'表述过头——固件常量就绪 ≠ 实机闭环在跑。
    README/AGENTS 两处改为准确的三段式：固件层解锁 → 待 pigtail 接通强电回路 → 实机闭环验证。
2026-11-12 fix: [R1] AR36 底盘槽口bug修复 + 11号放平 + 追加件12/13 + 接线图v5定稿 (#27)
    * fix(3D): [R1] AR36 底盘槽口bug修复+布局重排 + 11号放平改版 + 追加件12/13 + 接线图v5定稿（并行会话完工入库）
    ## AR36 · 底盘真 bug 修复（并行会话 2026-11-12 夜）
    1. 小件嵌槽槽口 X/Y 共用同一变量 → 方形大口（08 槽口 31.2×31.2）→ hx/hy 分算，
    后按领导决定直口（mouth_chamfer=0）彻底取消斜口
    2. 06c 沉槽深 1mm（recess_d+2 中心错）→ 修正后块与板面齐平
    3. 布局重排（build_assembly/check_base_fit 同步），check_base_fit 全过（本会话实测验证）
    ## 11 号光敏柱放平改版（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
    [06a_base_left_v1.stl, 06b_base_right_v1.stl, 11_ldr_stand_v1.stl, 12_led_stand_v1.stl]
2026-11-12 docs: [R1] 打印清单口径 10→11 件（+12 LED 座已打、13 已删、06a 待拼装验证是否补打） (#28)
    - 件总数：10 → 11（12 LED 座入列；13 盖板 11-13 删除不打）
    - 进度：已打 10/11（12 号 11-12 打完）
    - 06b 未打；06a 打于 AR36 槽口修复前——拼装时验嵌槽，插不进则补打 06a
2026-11-12 fix: [R1] 06a/06b 状态更正——06b 已打（11-12）、06a 未打（此前记反，领导 01:34 指正） (#29)
    昨晚我把 R3 分支的'06x 完成'与 R4 的'06a 成品照'错合成'06a 已打'。
    实际（领导口径，唯一权威）：06b 右片已打完，06a 左片还没打。
    - README/AGENTS：剩余件 06b→06a（强调用 AR36 直口版）
    - 打印日志：06b 填完成行（含更正注记）；06a 改⏳未打
    - R4 照片'S2-13.1-06a底盘左片成品.jpg'实为 06b——待重拍/改名（另留待办）
2026-11-12 fix: [R1] 打印日志 06a 行补修（PR#29 漏改的一行） (#30)
2026-11-12 fix: [R1] 打印日志收尾——概览 06b→已完成；逐件记录 06a 误填行重置为未打（原'成功'行数据实为 06b） (#31)
2026-11-13 docs: [R1] 试装偏差表取消（领导 2026-11-13 定）——配合间隙建模侧已算过，装不进再报尺寸，不逐件出表 (#32)
2026-11-13 docs: [R1] 负载侧二极管跳过（领导 2026-11-13 拍板）——泵 0.6A 仅占触点额定 6%，裕量足；WAGO 简化为单块直连 (#33)
2026-11-13 docs+素材: [R1] 今日成果对齐——实机闭环跑通（两段关键视频入库）+ 06b 排水槽版注记 (#34)
    ## 2026-11-13 实机里程碑
    - pigtail 到货接通：S2-8.1 首次出水（43.2s）
    - **全自动浇水闭环实机演示：S1-9.3（86.7s/15.6MB）—— 素材索引 ⬜→✅**
    - README/AGENTS 状态：'待 pigtail' → '实机闭环已跑通'（下一步 48h 连续运行）
    ## 06b 排水槽改进版（并行会话今晚）
    围墙内远角 + 水箱槽底各 16×4 排水槽（20×6 收窄，领导定）；317.5g 重出
    ⚠️ 已打的 06b（11-12）无排水槽——补打与否待领导拍板
2026-11-13 fix(3D): [R1] 06b 排水槽改进版——围墙内远角 + 水箱槽底各 16×4（领导 11-13 定尺寸） (#35)
    并行会话今晚改进：原 20×6 收窄为 16×4×2 两处；317.5g 水密重出 + 效果图。
    ⚠️ 已打的 06b（11-12）无排水槽——是否补打待领导拍板（不阻塞 48h 测试，
    排水槽是防积水的耐久性优化，非功能件）。
    [06b_base_right_v1.stl]
2026-11-13 docs: [R1] 06b 排水槽版重打中（剩 2h35m）+ 48h 测试定档 11-16 周一启动 (#36)
    领导 22:27 口径：
    - 06b 正在重打（排水槽版 16×4×2），约 01:00 完——即领导直接选择了补打，11-12 无槽版作废
    - 48h 连续运行暂定 11-16（周一）启动 → 11-18（周三）结束，11-24 截止前余 6 天缓冲
    - 启动/结束当天各导一次巴法云曲线（免费版保留期有限）
2026-11-13 docs: [R1] 48h 测试定为整机形态（领导 22:31 拍板）——前置 06a+拼装+接线 11-15 前完成 (#37)
2026-11-13 docs: [R1] AGENTS 瘦身（AR 清单毕业至 index）+ index 补 AR34–36 (#38)
    - AGENTS §2 审计行 1122B → 340B：完整 AR 清单与演进链归 docs/index.md §三（单一权威源），
    AGENTS 只留'下一个编号 + 被推翻项警示 + 指针'
    - index.md §三 补 AR34（03 加强）/ AR35（01b 定版裸露·现行）/ AR36（底盘槽口 bug）三行，
    现行依据 AR10–AR33 → AR10–AR36
    - 动机：AGENTS 15.9KB 超软限 15KB（142 行），neat-freak 第零步红项
2026-11-13 docs: [R4] 11/13 打印件成品照 8 张 + 闭环实证视频 2 段入库，S1-9.3/S2-8.1 补齐 (#39)
    * docs: [R4] 11/13 打印件成品照 8 张 + 闭环实证视频 2 段入库，S1-9.3/S2-8.1 补齐
    * docs: [R4] 统一 S1-9.3 视频文件名（去重，与 R1 提交合并为一份）
    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
2026-11-13 docs: [R1] 06a 完成回填（11-12 晚开打→11-13 打完，领导确认）——打印 11/11 全部完成 (#40)
